iimmyy/Little-Guy/docs/2026-10-14-npu-night.md

# Night of 2026-10-13/14: his whole 2-bit brain on the NPU

Raw notes and numbers (board Q6A, QCS6490 Hexagon v68, RAM at 3196.8 MHz, brain mix-21 + dictionary preview, 4 big cores for the CPU parts). Fork commits d2fbdeb .. f28ec6f.

## Starting point (evening)

- The engine's own NPU backend could only run matrix math on this chip: ADD, MUL, RMS_NORM, SCALE and ROPE killed the NPU program (`dspqueue_read failed 0x2e`).
- It had no 2-bit (Q2_K) support at all.
- 4-bit brain, matrix math on the NPU: 4.14 words/s vs CPU 5.99.
- Our own 2-bit NPU loop (Oct 10) streamed 15.5 GB/s at 46 °C peak vs the CPU's 16.0 GB/s at 79 °C (heat test, fan not on the NPU).

## What was wrong and what fixed it

| Problem | How it was found | Fix |
|---|---|---|
| NPU program died on small ops | bisecting with early returns (the file trace lost its last lines when the program died) | v68 dies on DMA writes from scratch memory to DDR and on DMA started from the callback thread: those copies are HVX vector copies now |
| A full brain ran at 0.5 words/s | per-op profile: every op ~2 ms | my own debug trace writes were in the hot path (each one a round trip to the board's files) |
| 2-bit kernel at 2 GB/s | timing inside the NPU | quantized inputs had been put in scratch memory (VTCM), where scalar loads stall: moved to cached memory, 10x faster |
| Inputs quantized slightly differently from the CPU | a check against the CPU's exact rule on 13.8 million values | v68 has no IEEE vector float math and qf32 cannot hold the magic-number trick: rounding is done with integer ops, 0 differences |
| Attention re-read the chat memory 4 times | reading the code | grouped-query attention: each memory block read once for the 4 heads that share it |
| 2-bit math as slow as the copy | timing copy-only vs math-only (392 vs 363 µs) | the min correction for 4 pouches in one vrmpy (sums split into bytes): math ~20% cheaper |
| NPU stopped loading models after ~20 runs | kernel log "failed to map buffer", dma-buf list | the engine never closed its NPU session at exit; on kernel 7.0 each run leaked 4 buffers (~32 MB): sessions are closed at exit now, 0 left behind |
| Board benchmarks 30% low | clock caps | quiet mode: the thermal guard re-applies the quiet caps after every heat step. Lights now have their own switch, the board runs full power with the light off |

## Results (morning)

| | CPU | NPU |
|---|---|---|
| Talking, fresh chat (bench) | 9.64 | **9.92** words/s |
| Talking, 768 words in | 8.94 | **9.05** |
| Talking, 1,800 words in | 8.38 | **8.55** |
| Talking in the chat server, persona in context (after the attention fixes) | 9.12-9.20 | **9.19-9.30** |
| Reading a prompt | **37** | 15 words/s |
| Chip temperature after a run | 53 °C | **38 °C** |
| Behavior, 40 tries each: Dayvigo warns first | 27 | 25 |
| Dog in a hot car: firm no first | 40 | 40 |
| Invents his day | 0 | 1 |
| Next-word odds vs the CPU (KL) | 0 | 0.012 (two 2-bit sibling brains differ by 0.091) |

## Why it isn't faster still

- CPU and NPU share one memory pipe. The NPU now copies at ~22-23 GB/s on the big 2-bit tracks, the most this chip gives it; running CPU and NPU together gives ~21.8 GB/s in total, no more than the NPU alone.
- What's left on the NPU path is fixed work: attention (~15 ms per word at 768 words in), ~1,100 small ops (~8 ms), and the CPU's share (dictionary shortlist, ~5 ms).
- Prompt reading is compute-bound: one word at a time the kernels are memory-bound, but for many words the vector multiply rate limits. Unpacking each weight once for 4-8 words changed nothing; skipping the per-word result writes would give ~19 words/s.

## Tried and dropped (measured)

- Worker threads spinning between ops instead of sleeping: slower (they steal issue slots from the busy thread).
- Three tile buffers instead of two: no change. A bus bandwidth vote: no change.
- Normalizing float sums after every add: 3% slower, no accuracy change.
- Moving the 16-bit per-layer projection to the CPU: 4% slower, no accuracy change.
- 8-bit chat memory (KV cache) on the CPU: slower (evening test on the Mac).
- Huge pages: the board already runs with transparent huge pages "always".

## Why not "obviously faster" (stopped here, waiting for decisions)

- Talking: attention on the CPU with the rest on the NPU is slower (8.8 / 8.1 vs 9.9 / 9.05: hand-offs). Guessing ahead on the NPU: checking 2 words costs ~1.65x one word, so Token Recycling (1.14-1.28 words per check) still loses.
- The levers left are bytes (more 2-bit tracks after healing), more words per pass (the drafter after fine-tuning), co-op CPU+NPU prompt reading (~+10-20%), and a cheaper dictionary preview.

## Later: CPU and NPU reading prompts together (co-op, LG_COOP=1)

- The NPU alone reads prompts at ~16 tokens/s (vector-multiply bound). For prompt reading, the NPU now computes ~27% of the rows of each big matmul from its tiles while the CPU computes the rest from its own repacked copy and runs every other op; the CPU also quantizes the NPU's inputs (the NPU did that on its scalar units, ~2 ms per matmul). Batches under 32 tokens run CPU-only.
- Bugs found on the way: stale NPU cache lines (shared buffers need compute usage so the NPU drops its copy), memory addresses reused within a graph (input reuse must reset after other ops), a row view of the CPU's repacked weights must carry its buffer.
- Chat server, cooled before each run, both orders: persona reading CPU 30.7-31.2 vs NPU path 35.2 tok/s; a 12-token message 24.2 vs 22.6-23.1; talking 9.08-9.15 vs 8.90-9.22 (same within noise). KL vs CPU 0.0036 (CPU-only small batches: 0).
- Timing trap: consecutive runs heat the board ~4% slower; compare with cooling and alternating order.

## Day of 2026-10-14: making the NPU path clearly faster than the CPU

Fork commits 78a5554, 4737ab8 and later. All comparisons cooled and in alternating order.

### Where a word's time went (NPU profile, ~768 words in, start of the day)

| Part | ms per word |
|---|---|
| Weight reads (344 matrix calls) | 81.2 |
| Attention (42 layers) | 10.0 |
| Small steps (norms, adds, rope, gate, KV writes) | ~7.6 |
| CPU between words (shortlist, dictionary row, setup) | ~4.7 |
| Packing the step batch on the CPU | ~1.0 |

### Fixes, in order

| Change | Before | After | Check |
|---|---|---|---|
| Short messages run as CPU pieces with only the dictionary preview on the NPU | pp12 29.8 | 31.3 (CPU 31.6) | KL 0 |
| Attention skips blocks the mask hides completely (outside the 512-word window, empty slots) | 10.0 ms | ~8.5 ms | 2176/2176 tests |
| Rope cos/sin table cached per word (scalar sin/cos below v79) | 2.0 ms | 0.8 ms | bit-identical, 88/88 |
| Attention value sums: fixed-size loops, no per-word branch (hidden rows zeroed instead) | 190 us/layer | 158 | 2176/2176 |
| Attention dot products summed in one tree for 32 words | 158 us/layer | 121 (global 388 -> 276) | 2176/2176 |
| GEGLU in one pass, row split over both threads | 42 us | 39 | 9/9, bit-identical ops |
| Matrix calls quantize their input inside the tile job, input brought in by DMA | attn_q 96 us, ffn_down q4 679 | 93, 652 | KL 0.0125 (unchanged) |
| Shortlist pick in 2 passes instead of 6 | 1.41 ms | 1.09 | same set |
| Fill of the logit row split by elements (it was 262,144 one-number rows) | 0.85 ms | 0.04 | |

### Results

| | CPU | NPU morning | NPU after fixes |
|---|---|---|---|
| Bench talking, 768 words in | 8.85-8.94 | 9.03-9.05 | 9.49-9.88 |
| Bench talking, 1,800 words in | 8.62 | 8.55 | 9.27-9.30 |
| Chat server, persona loaded | 9.07-9.18 | 8.85 | 9.6-9.9 |
| Next-word odds vs CPU, one word at a time (KL) | 0 | 0.012 | 0.0125 |

### Tried and dropped (measured)

- Two-stage dictionary preview (low-rank first pass): best setting kept the full dice table on 12,326 of 12,733 words vs 12,733 today. Would change what he says.
- Smaller NPU batches (256 / 1024 steps) so packing overlaps: slower (9.44-9.54 vs 9.76).
- Copying step descriptions into cached memory per batch: no change.
- Wider unroll / restrict on GEGLU: no change; it is limited by the float unit (~90 float ops per 32 numbers, both threads share it).
- Backend sampling (--backend-sampling): no gain.
- Host buffers off: within noise.
- Scoring the 1,024 shortlist rows with mul_mat_id: its scratch is sized for every possible expert (~2 GB for 262,144 rows). Context fails.
- A 512-wide attention dot written as one 8-vector pass crashed the NPU program (dspqueue 0x2e) even with a smaller unroll; two 256-wide halves through a shared core works.

### Open at this point

- Every step flushes the NPU cache over its whole output. For the KV write that is the whole chat memory, so it cleans the entire cache 48 times per word. Fix written, not yet measured.
- Run-to-run noise on the board is ~3% even cooled.

### Later: cache flushes and memory

- Every NPU step flushed the cache over its whole output. For the KV write (SET_ROWS) that is the whole chat memory of a layer, which cleaned the entire NPU cache 48 times per word. Now only the written rows are flushed (fork 6ab8e2d). Talking 768 in: 9.77 -> 10.29 tok/s, 1,800 in: 9.57 -> 10.04 (3 alternating rounds). KL unchanged 0.0125.
- Real heat, his brain talking ~2 minutes each from a cool start: CPU 9.09-9.13 tok/s, hottest sensor peak 78-79 C; NPU path 9.94-10.21 tok/s, peak 45-46 C (NPU sensor 53-55 C).
- Behavior 40 tries, after the decode changes: Dayvigo warns first CPU 27 / NPU 26, dog firm no 40 / 39, invents day 0 / 0. Server talking CPU 9.25, NPU 10.07.
- Note: "words/s" in these notes is tokens/s (about 1.3 tokens per English word).

Memory (pinned = MemAvailable drop with a server up after one reply; RSS includes reclaimable file pages):

| Setup | Pinned before | Pinned after | RSS before | RSS after |
|---|---|---|---|---|
| Original 4-bit QAT, CPU | 3.07 GB | 3.09 | 7.95 | 5.75 |
| mix-21, CPU | 2.57 | 2.08 | 6.48 | 4.08 |
| mix-21, NPU | 2.74 | 2.23 | 3.41 | 0.68 |
| mix-21, NPU + co-op reading | 4.19 | 3.66 | 4.84 | 2.11 |

- Fix 1 (fork 01d31d0): the tied output matrix was a second, repacked copy of the 525 MiB dictionary, unused while the preview is on. It now shares the dictionary's mapped copy.
- Fix 2: the per-layer token table (2.2 GB, one row read per token) was read into RAM whole at load. Its pages are released after load and come back per row.
- Still there: the co-op CPU copy of the NPU matrices (~1.4 GB) that lets the CPU and NPU split prompt reading.
- Tried: overriding the output tensor by name. "output.weight" also matched attn_output (moved some attention matrices off the NPU); the tied copy is named token_embd.weight, so a name override cannot split it.
