iimmyy/Little-Guy/docs/MODEL_SELECTION.md

# Little Guy model selection (WIP)

I am treating [Gemma 4 E2B](https://huggingface.co/litert-community/gemma-4-E2B-it-litert-lm) as the working Q6A baseline, not a final choice. It runs on the board through LiteRT-LM and Adreno/OpenCL. My initial debug measurements, including their limits, are in [Gemma runtime validation](GEMMA_RUNTIME.md). I have not verified NPU execution, image input, or audio input on my Q6A.

## Candidates to test

| Candidate | Why I would test it | What remains unproven here |
| --- | --- | --- |
| [Gemma 4 E2B](https://ai.google.dev/gemma/docs/core/model_card_4) | Google lists text, image, and audio input; I already have a working Q6A text baseline. | End-to-end multimodal support in my Android package, sustained power/heat, and QCS6490 NPU compilation. |
| [Gemma 4 E4B](https://huggingface.co/litert-community/gemma-4-E4B-it-litert-lm) | Same model family and LiteRT-LM runtime, with a larger on-device model that may improve difficult interactions. | Whether the quality gain is worth its larger memory footprint and latency on my 12 GB board. |
| [Qwen3.5-2B](https://huggingface.co/Qwen/Qwen3.5-2B) | A different small instruction-tuned vision-language model, useful as an independent quality comparison. | An equivalent Android runtime, audio path, QCS6490 NPU compilation, and fair on-device speed comparison. I will not assume its model-card demos are a deployable Q6A package. |

I will not choose from parameter count or another device's benchmark. I need the same small test set for each candidate: short conversation, a long-history follow-up, a changing-place scenario, uncertainty about absent sensors, a scene description, an audio input, and a request for an unsafe physical action. I will save the exact prompts, outputs, model hashes, runtime/backend, and pass/fail notes. A model that invents observations or bypasses the separate motion safety gate fails even if its text benchmark is fast.

## E4B artifact and selection

I have prepared my Android app to select E2B or E4B without changing the conversation prompt, GPU backend, safety gate, or APK build. The selection is the one-line file `models/selected-model.txt` in the app's external files directory. With no selection file, the app still defaults to E2B. I use the tracked `config/model-e2b.txt` and `config/model-e4b.txt` files to avoid mistyping the choice. The debug terminal prints the active model ID and refuses to treat the development brain as a model benchmark. If I explicitly select a missing model or enter an unknown ID, it reports an error instead of silently switching models.

My E4B candidate is the generic, multimodal-capable [LiteRT-LM release](https://huggingface.co/litert-community/gemma-4-E4B-it-litert-lm/tree/main), not its smaller GPU-only variant. I pinned Hugging Face revision `2eee7ac325f20eb8c9ac1d0e972f7c84663062da`. The file `gemma-4-E4B-it.litertlm` is 3,659,530,240 bytes; I verified its local SHA-256 as `0b2a8980ce155fd97673d8e820b4d29d9c7d99b8fa6806f425d969b145bd52e0`. I keep this multi-gigabyte file under `.run/models/` locally and out of Git. Downloading and building the app do not yet prove the file loads or generates on my Q6A.

For the first Q6A trial I verified free space, copied the E4B file to `/sdcard/Android/data/com.littleguy.robot/files/models/gemma-4-E4B-it.litertlm`, checked its on-device SHA-256, pushed `config/model-e4b.txt` to `/sdcard/Android/data/com.littleguy.robot/files/models/selected-model.txt`, then restarted the service. I restored `config/model-e2b.txt` to that selector path after the failed load. Model selection is read when the service starts, not in the middle of a response.

This trial used Adreno/OpenCL. It was not NPU conversion, retraining, or a final model decision. A valid E2B-versus-E4B comparison still requires both models to generate on the Q6A under equivalent conditions.

## Physical Q6A E4B load attempt — 2026-09-27

I tested the pinned generic E4B artifact on my 12 GB Q6A with the current Android debug app. I verified the same SHA-256 on the Mac and on the board before selecting E4B. The E2B model file stayed in place, and I kept the thermal monitor running with automatic power-off enabled. The external fan was on for the warm E2B comparison and E4B load; the first post-install E2B cold smoke was without it. Earlier transfer temperatures near 47 C CPU and 42 C GPU were measured **without** the fan; after I turned it on, those readings fell to roughly 39 C and 35 C. I must not label the earlier readings as fan-cooled.

After installing the selector-capable app, I first checked E2B. A fan-cooled warm coffee-shop prompt reached first visible text in 2.386 s and completed in 3.087 s. LiteRT reported 67 prefill tokens at 33.9 tokens/s and seven decode tokens at 6.5 tokens/s. The answer was "I am ready to observe." That is grounded but thin, so it is not a quality pass merely because it was fast.

I then selected E4B and restarted the service. The debug receiver confirmed `MODEL e4b`, and LiteRT began delegating the E4B decode graph to OpenCL. Android's low-memory killer killed the app during model setup, before any generated text. Its log gave the reason as a breached memory watermark. This was not a thermal shutdown; a spot check during loading was about 31 C CPU and 27 C GPU. I did not obtain a stable E4B peak-memory measurement, first-text time, or answer. I therefore have **no E4B inference-speed or quality result** from this attempt.

I restored the selector to E2B and stopped the failed process. The first E2B reload was also killed during OpenCL setup by memory pressure, so a selector rollback alone did not immediately restore the running system. After one board reboot, E2B generated "Hello." again: 8.339 s to first visible text and 24.030 s total on the cold recovery request. Its next warm turn reached first visible text in 1.052 s and completed in 1.199 s. The active selector is E2B. I left the verified E4B file on the board for later investigation, but it is not active.

The conclusion is narrow: this **generic E4B artifact through this Android/LiteRT-LM OpenCL path** caused memory pressure during loading on my Q6A. It does not establish that every E4B quantization or backend is impossible on the board. I will not repeat the same load without a concrete memory hypothesis and a way to measure peak allocations. A controlled E2B-versus-E4B quality and latency comparison remains unperformed.

For every model that actually runs on my Q6A, I will measure first visible text, complete-response time, prefill/decode throughput, memory, temperature, and power under the same fan and prompt conditions. I will distinguish a fresh boot, an app-process restart, and a warm conversation. Model support for image or audio on paper is only a candidate capability until I send those modalities through the exact deployed runtime.

## NPU compilation gate

The QCS6490 targets Hexagon **v68** with SoC ID **35**. [Radxa's QAIRT guide](https://docs.radxa.com/en/dragon/q6a/app-dev/npu-dev/qairt-sdk) says a context binary is chip-specific, and its [conversion example](https://docs.radxa.com/en/dragon/q6a/app-dev/npu-dev/qairt-usage) demonstrates quantization and context-binary generation on an x86 Linux host for a smaller vision model. Those instructions do not establish that I can compile Gemma 4 or Qwen3.5 on this Mac, nor that a compiled artifact will run on this Android image.

**Update (2026-09-28):** Did that first check! I moved the board to Ubuntu, and Radxa's prebuilt Llama 3.2 1B ran on the Hexagon at about 400 tok/s reading prompts and 9 to 10 tok/s writing. So the NPU works on my board 😁. Details are in [Q6A_LINUX_BOOT.md](Q6A_LINUX_BOOT.md) and the Gemma plan is in [NPU_PORT.md](NPU_PORT.md). I'm on Linux now, so ignore the Android bit in the next sentence.

Before attempting a full LLM conversion, I will verify the NPU runtime with a known-good QCS6490 example, confirm the Android libraries/toolchain and model-export path, then try one chosen model. This is deployment compilation, not retraining. I will keep the working GPU build available as a fallback and require actual NPU delegation, correct output, and measured latency/power gains before calling the NPU route successful.
