iimmyy/Little-Guy/hardware/little-guy-v2/pcb/head/microphone-coordinates.csv

reference | location | logical_mic | pdm_net | xvf3800_pin | acoustic_x_mm | acoustic_y_mm | acoustic_z_mm | kicad_target_x_mm | kicad_target_y_mm
MK501 | front | 0 | PDM_DATA0 | 46 | 0.0 | 29.646532920888777 | 0.0 | 0.0 | -29.646532920888777
MK502 | back | 1 | PDM_DATA1 | 50 | 0.0 | -29.512234589533094 | 0.0 | 0.0 | 29.512234589533094
MK503 | left | 2 | PDM_DATA2 | 48 | -50.0 | -0.06714916567784036 | 0.0 | -50.0 | 0.06714916567784036
MK504 | right | 3 | PDM_DATA3 | 51 | 50.0 | -0.06714916567784036 | 0.0 | 50.0 | 0.06714916567784036
