iimmyy/Little-Guy/tools/ears/read-aloud/session-01.md

# Read-aloud session 01

Sixty short lines, about five minutes of reading. Each line gives his ears an exact answer (the script),
and each effect copy gives them a known difficulty.

## Recording (one take)

1. Record at 48 kHz, mono, in FL with nothing on the mixer track and nothing on the master (no limiter, no EQ).
2. Read every line in order in one take, in your normal voice. Leave about **2 seconds of silence** between lines.
   Don't say the line numbers.
3. Flubbed a line? Pause, read it again, and keep going. Write the line number down (for example "redo: 12, 30").
4. Export the take as `s01_dry.wav`.

## Effect copies (as many as you like)

Run the same take through effects and export each version as a separate file, full length, starting at the same
point as the dry take. Name each one with the effect and how much:

- `s01_reverb-heavy.wav`
- `s01_distortion-light.wav`
- `s01_beat-medium.wav` (a beat of yours underneath; the amount = how loud the beat is)
- Chains are fine: `s01_reverb-medium+bitcrush-light.wav`

Use light / medium / heavy for the amount, or a number if you prefer (`reverb-40`). The file name is the log, so
nothing else needs writing down. Mix it up: reverb, delay, distortion, bitcrush, telephone or lowpass, chorus,
pitch shift, autotune, a beat underneath, crowd noise, whatever your plugins have.

**One rule:** nothing that changes the length or timing of the take (time-stretch, speed-up, slowing down).
Pitch shift is fine as long as the length stays the same. My tool lines every copy up with the dry take and
cuts them all in the same places.

Drop the files plus your redo note in a folder and tell me where. Your voice stays private: these recordings never
go in git or anywhere public.

## The lines

1. Play me something chill while I cook.
2. Yeah yeah, whatever, I'll do it later.
3. We were just chilling at the crib all day.
4. Pull up whenever you're ready.
5. Do you actually like this beat or not?
6. Six thick sticks sat stacked beside the shed.
7. She sliced the bread before anyone was awake.
8. Wake me up at seven thirty tomorrow.
9. He dropped a chip and the dog grabbed it.
10. She sells fresh fish at the market on Fridays.
11. That brand of sneakers costs way too much.
12. I don't care what they say about it.
13. I had a really long shift at work today.
14. That movie didn't even scare me a little bit.
15. Lemme see that real quick.
16. I bumped my head on the kitchen shelf.
17. Turn the music down a little bit.
18. Bro, that's lowkey crazy.
19. The fish flicked its fin and swam away.
20. They fought over the last slice of cake.
21. The faucet hissed and spat before the water ran clear.
22. Are you ready to leave yet or not?
23. The ship left the harbor right at dawn.
24. Pour me a glass of cold water please.
25. Nah I'm good, I'm about to head out.
26. I laid the jacket on the chair by the door.
27. What did you get up to while I was gone?
28. I'm hungry, what should I make for dinner?
29. The ice on the pond is way too thin.
30. What were we talking about yesterday?
31. I'm going to bed now, good night.
32. These pants are way too long for me.
33. What song is this one called?
34. A sharp whistle cut through the quiet street.
35. He ate the whole pizza by himself last night.
36. The steak was still rare in the middle.
37. Two bands played at the park on Saturday.
38. Keep that between you and me, okay?
39. Take a small sip, the tea is still hot.
40. I think I left my keys in the car.
41. Don't stare at the sun for too long.
42. Teach me how to care for a kitten.
43. Can I have grapefruit juice with my sleeping pill?
44. I thought about it the whole drive home.
45. Hey little guy, I'm home.
46. Go ahead and start eating without me.
47. Grab the hose and water the garden for me.
48. Can you remind me to call my mom tomorrow?
49. I'm gonna grab food, you want anything?
50. The school bans phones during class now.
51. Did you hear that noise outside just now?
52. My parents are coming over on Sunday.
53. Sorry I'm late, the bus never showed up.
54. Turn the speaker up and let it blast.
55. That track goes so hard.
56. On God, I didn't even touch it.
57. Tell me something you learned today.
58. They can't find the remote anywhere in the house.
59. The job she sought went to someone else.
60. It is what it is, you feel me?
