iimmyy/Little-Guy/hardware/little-guy-v2/layout/layout-3d.png

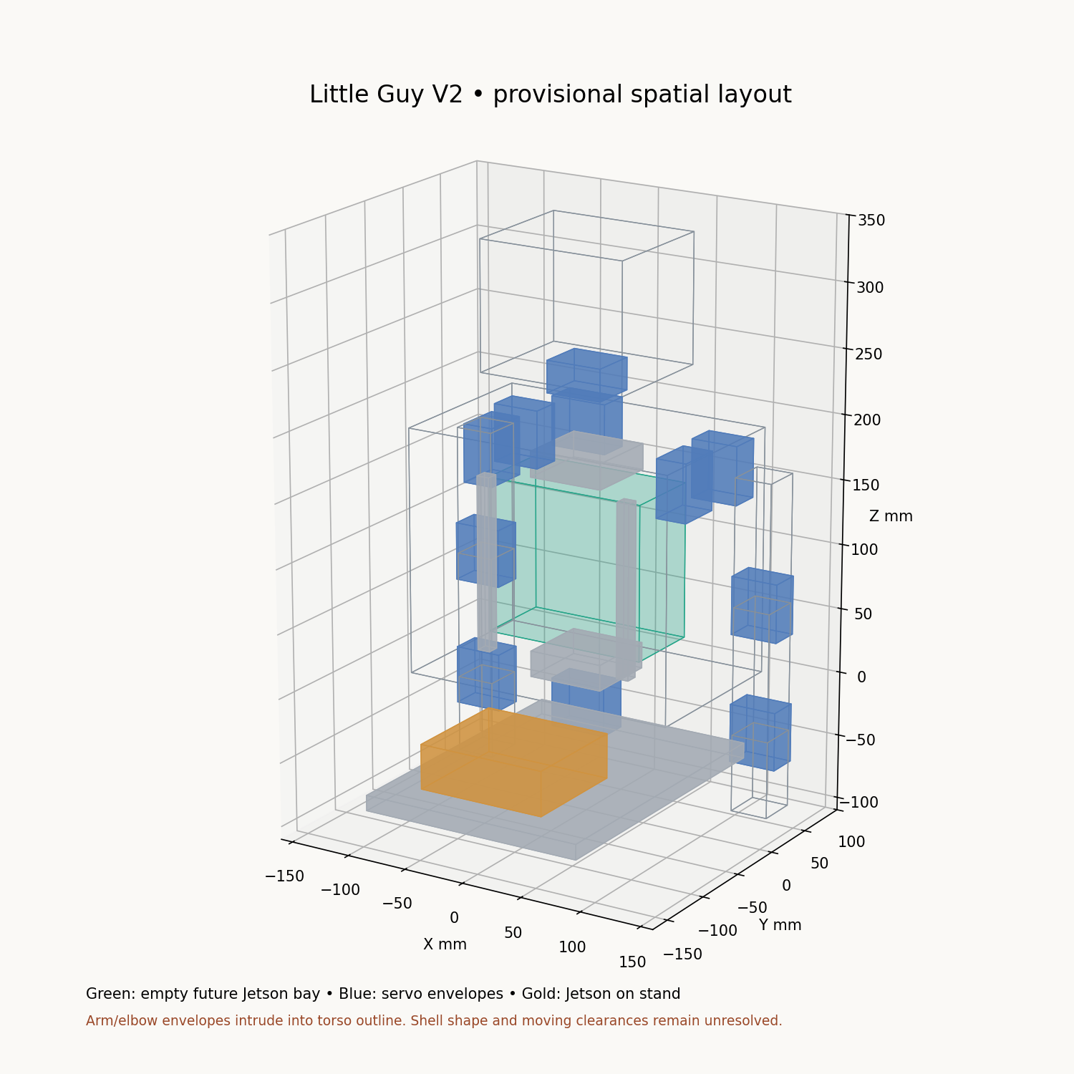
hardware/little-guy-v2/layout/layout-3d.png
