iimmyy/Little-Guy/hardware/little-guy-v2/layout/layout-review.png

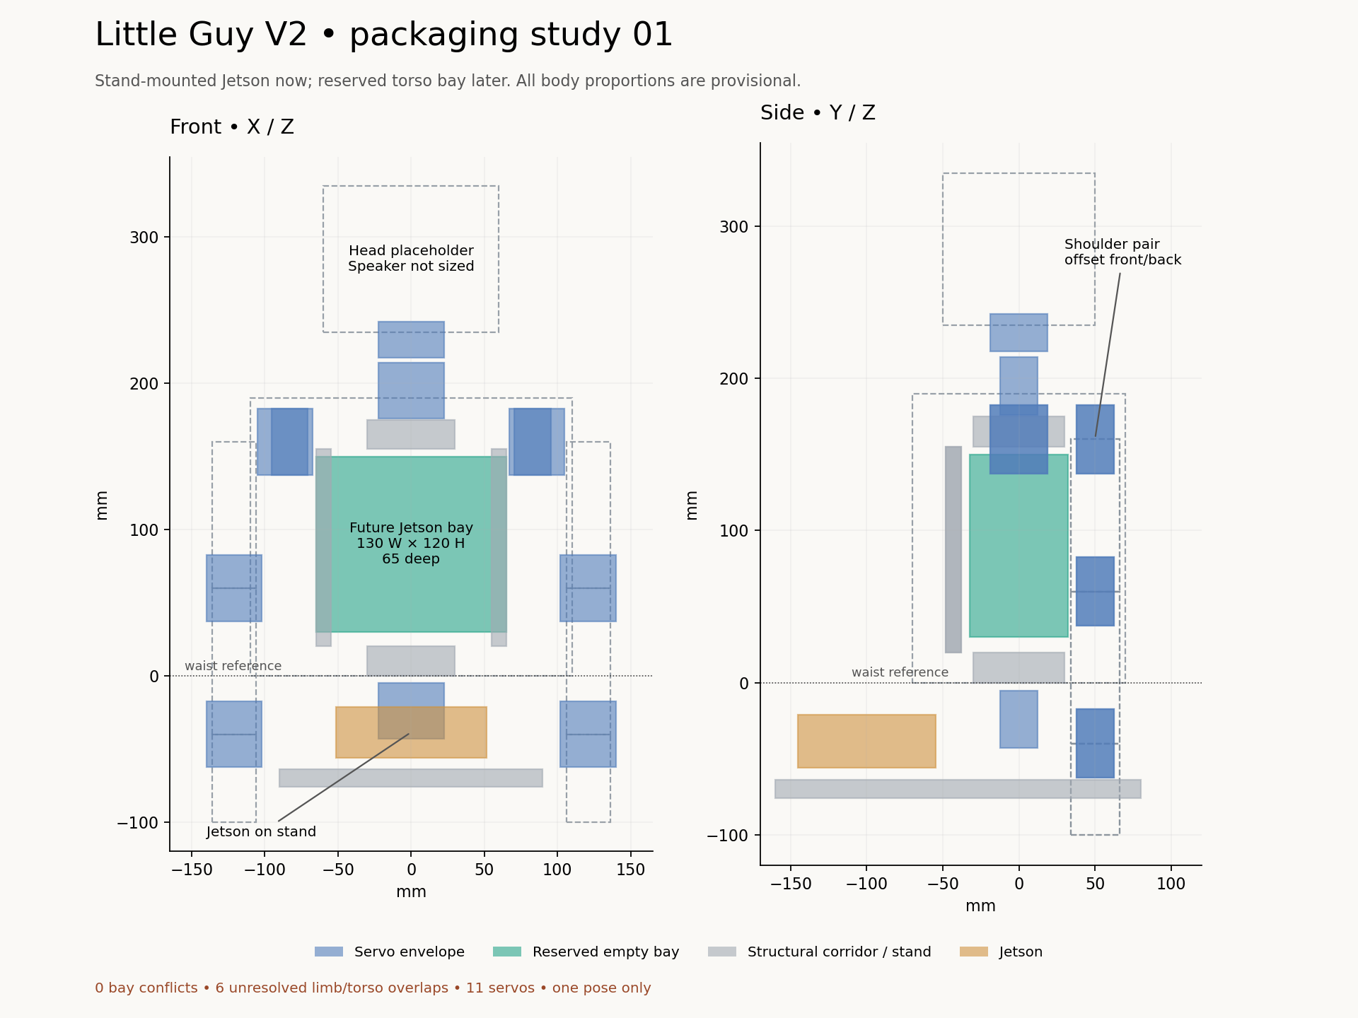
hardware/little-guy-v2/layout/layout-review.png
