iimmyy/Little-Guy/hardware/little-guy-v2/layout/shoulder/shoulder-poses.png

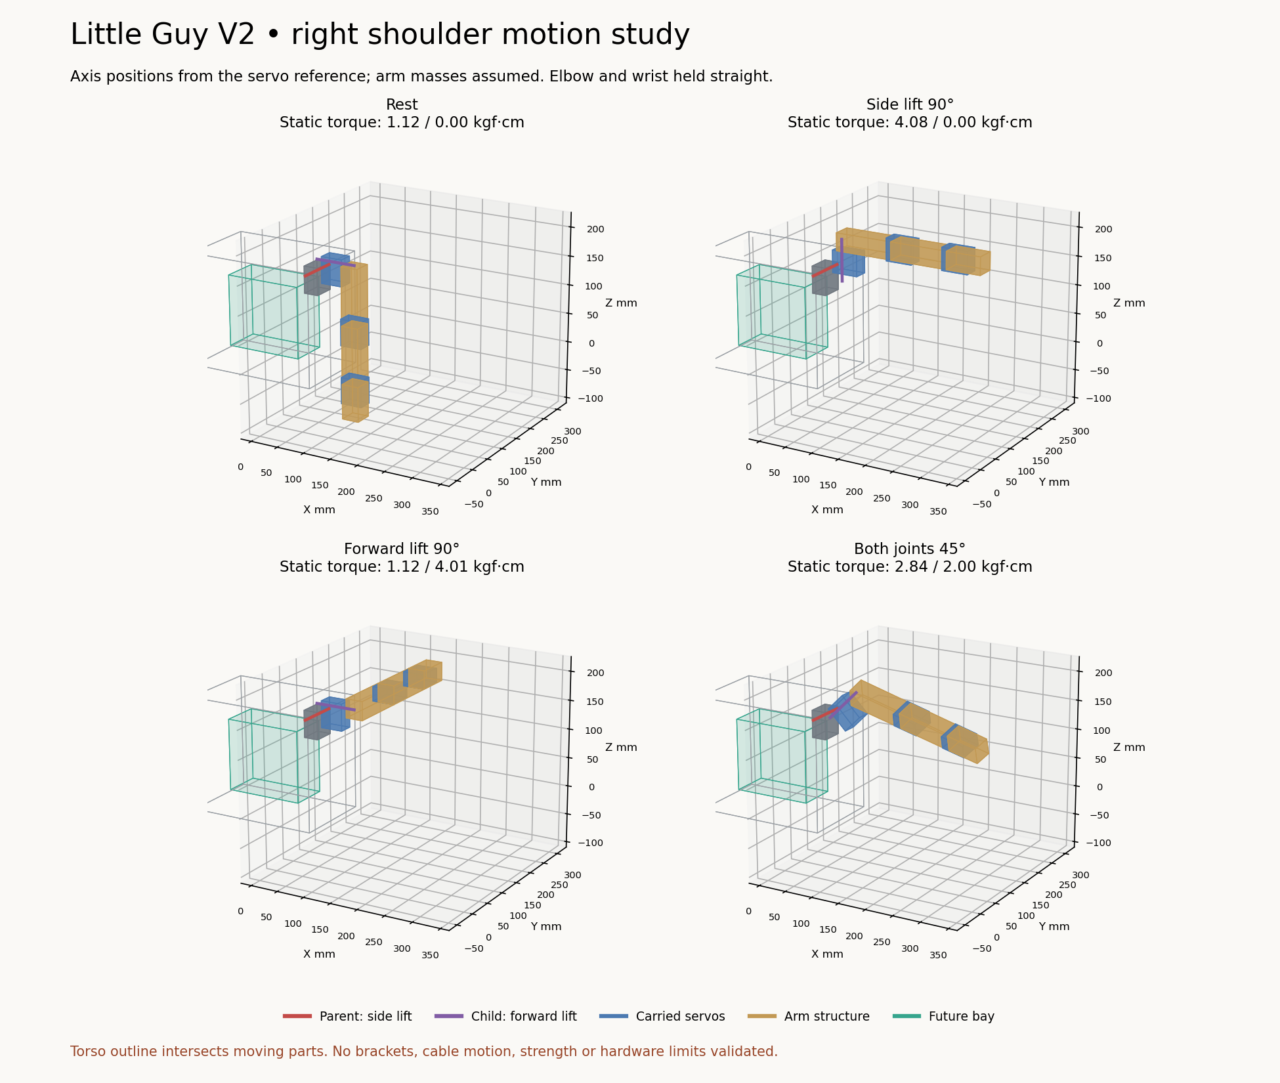
hardware/little-guy-v2/layout/shoulder/shoulder-poses.png
