iimmyy/Little-Guy/hardware/little-guy-v2/layout/stand/stand-sensitivity.png

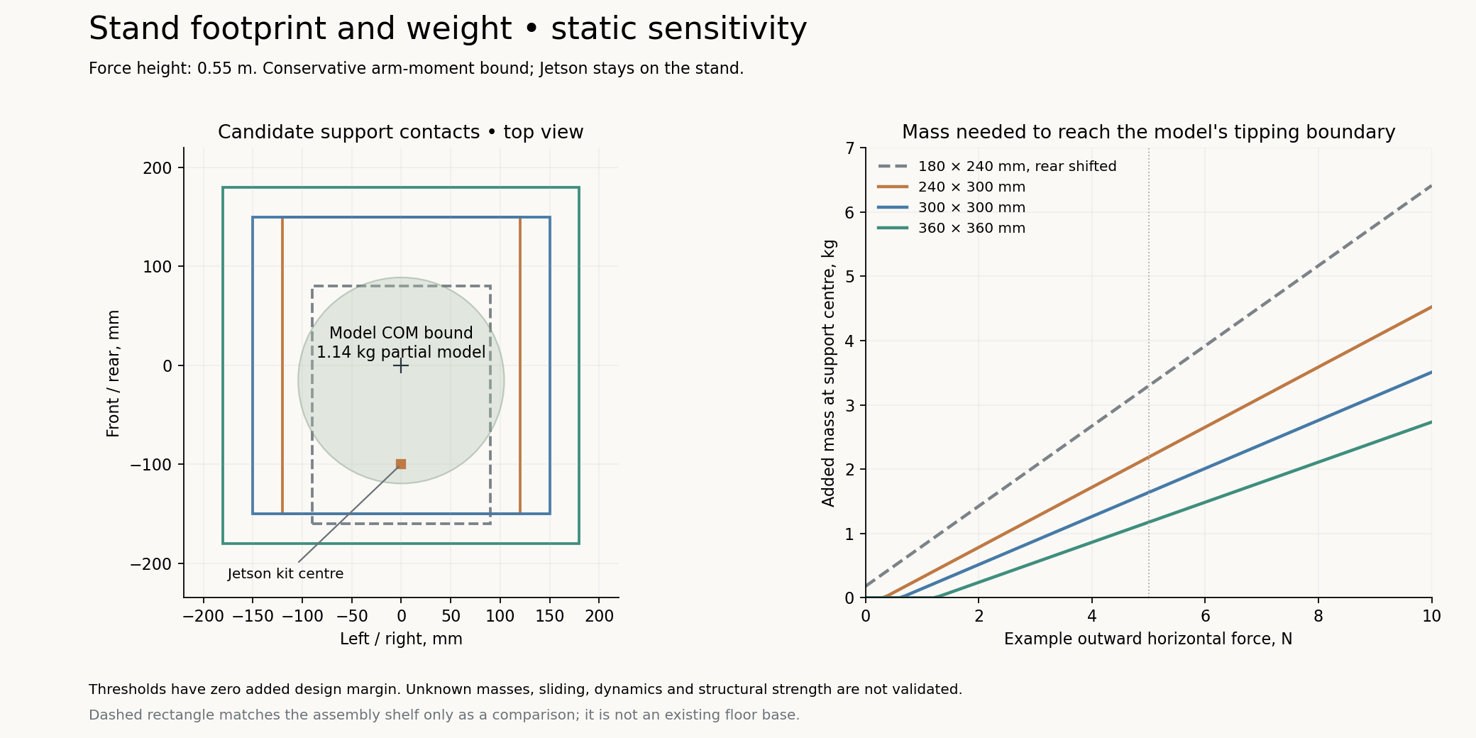
hardware/little-guy-v2/layout/stand/stand-sensitivity.png
