iimmyy/Little-Guy/hardware/little-guy-v2/power/harness-overview.png

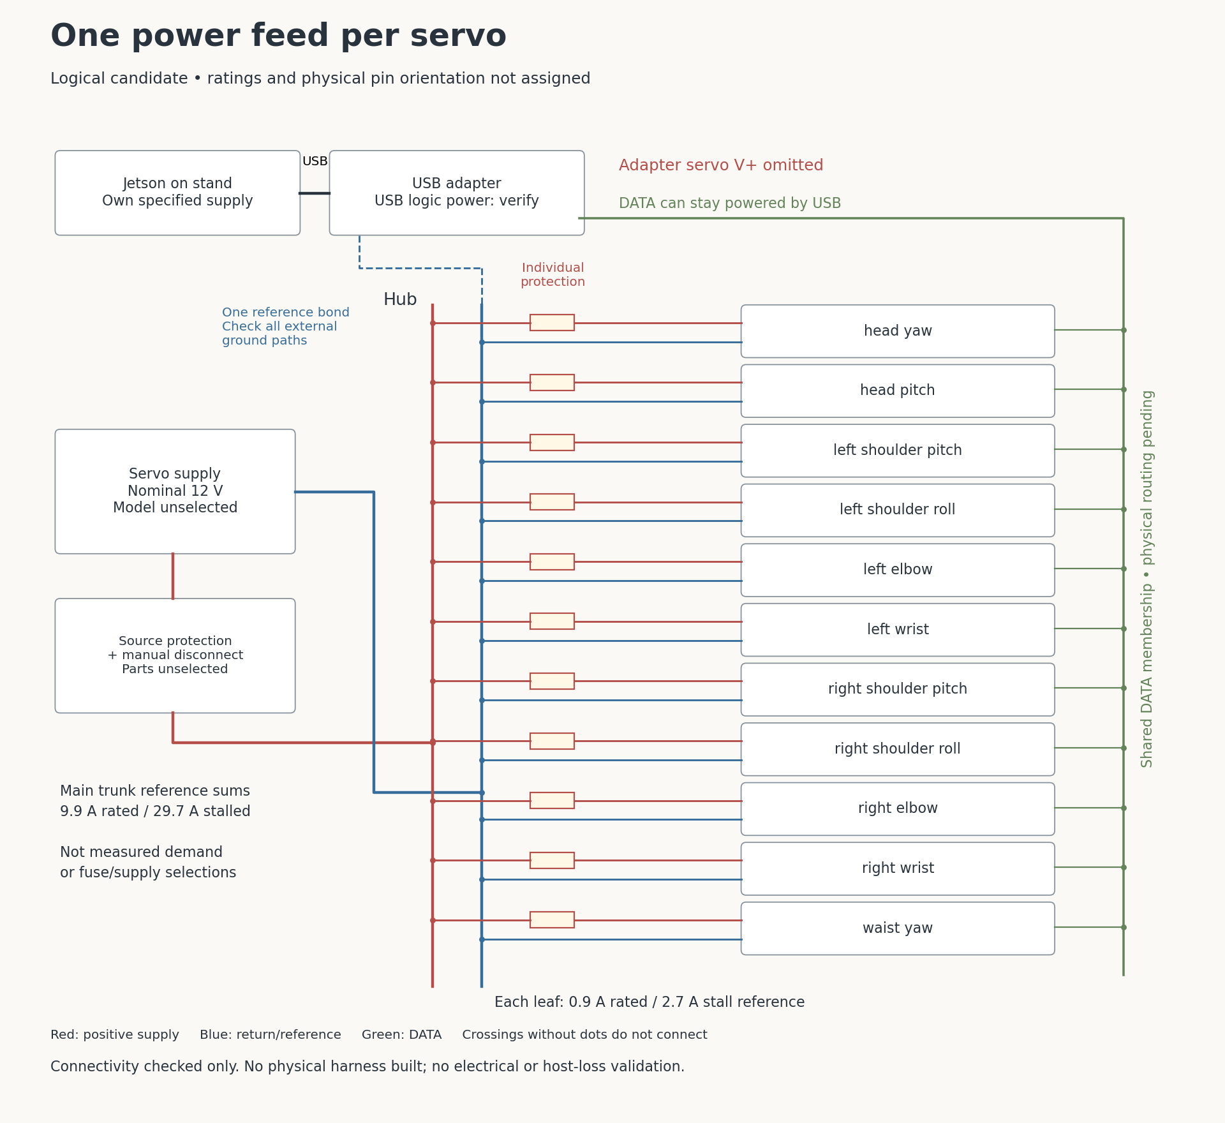
hardware/little-guy-v2/power/harness-overview.png
