iimmyy/Little-Guy/hardware/little-guy-v2/renders/v2-carry-handles.png

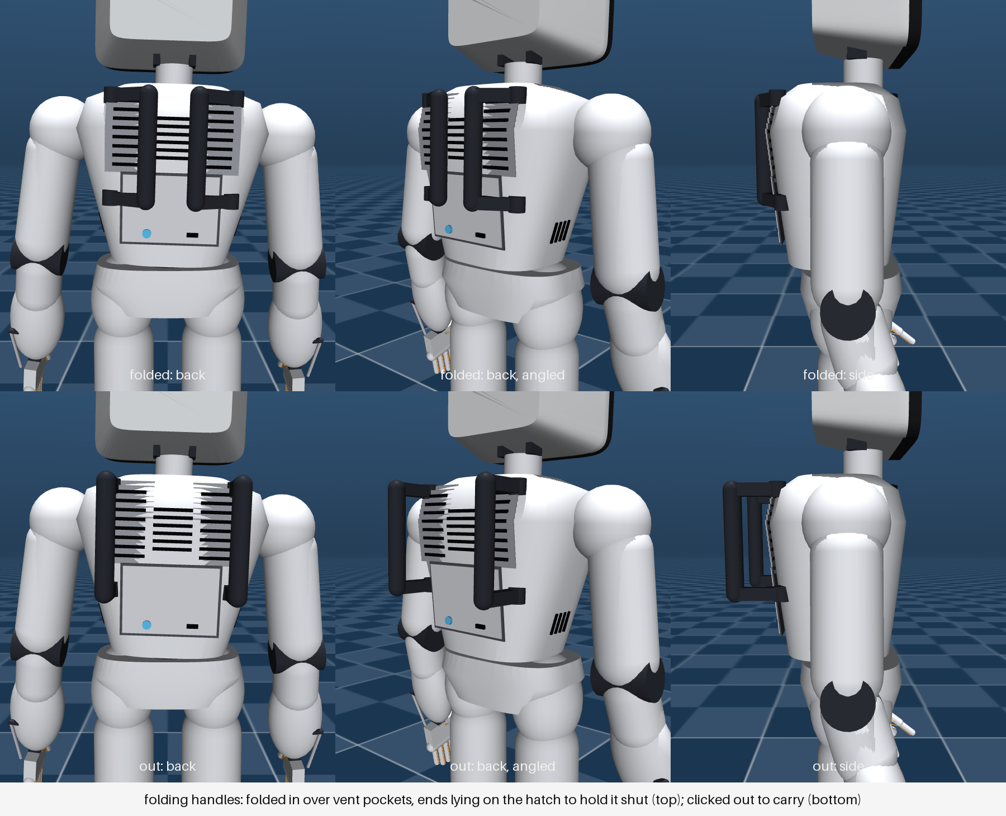
hardware/little-guy-v2/renders/v2-carry-handles.png
