iimmyy/Little-Guy/hardware/little-guy-v2/renders/v2-chest-insides.png

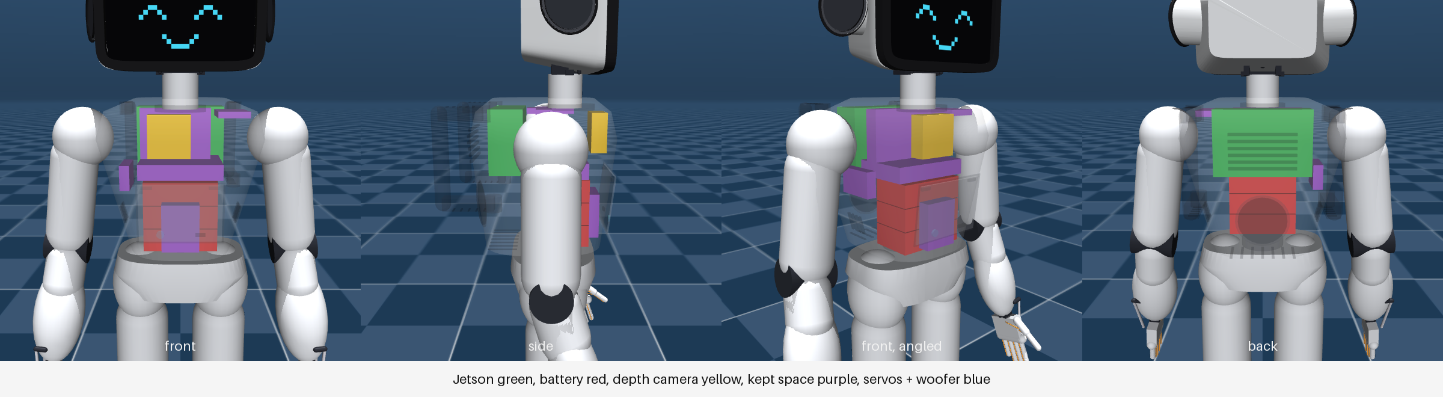
hardware/little-guy-v2/renders/v2-chest-insides.png
