iimmyy/Little-Guy/hardware/little-guy-v2/renders/v2-ear-rings-and-feet.png

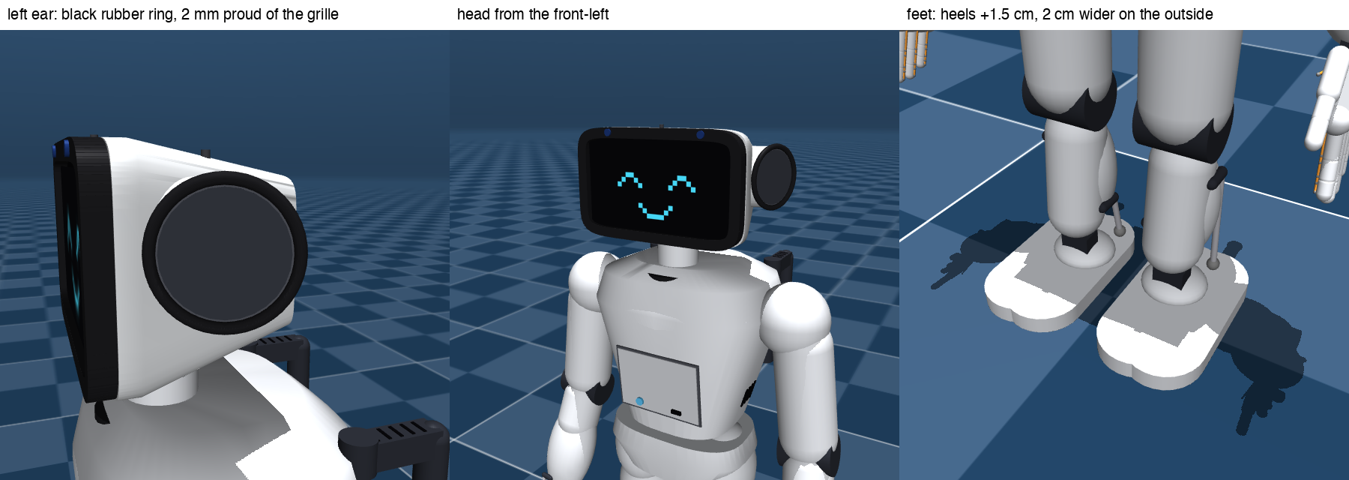
hardware/little-guy-v2/renders/v2-ear-rings-and-feet.png
