iimmyy/Little-Guy/hardware/little-guy-v2/renders/v2-full-body.png

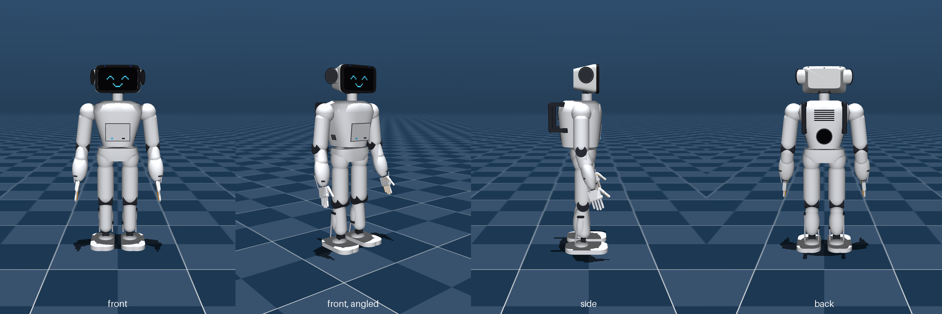
hardware/little-guy-v2/renders/v2-full-body.png
