iimmyy/Little-Guy/hardware/little-guy-v2/renders/v2-head-ears.png

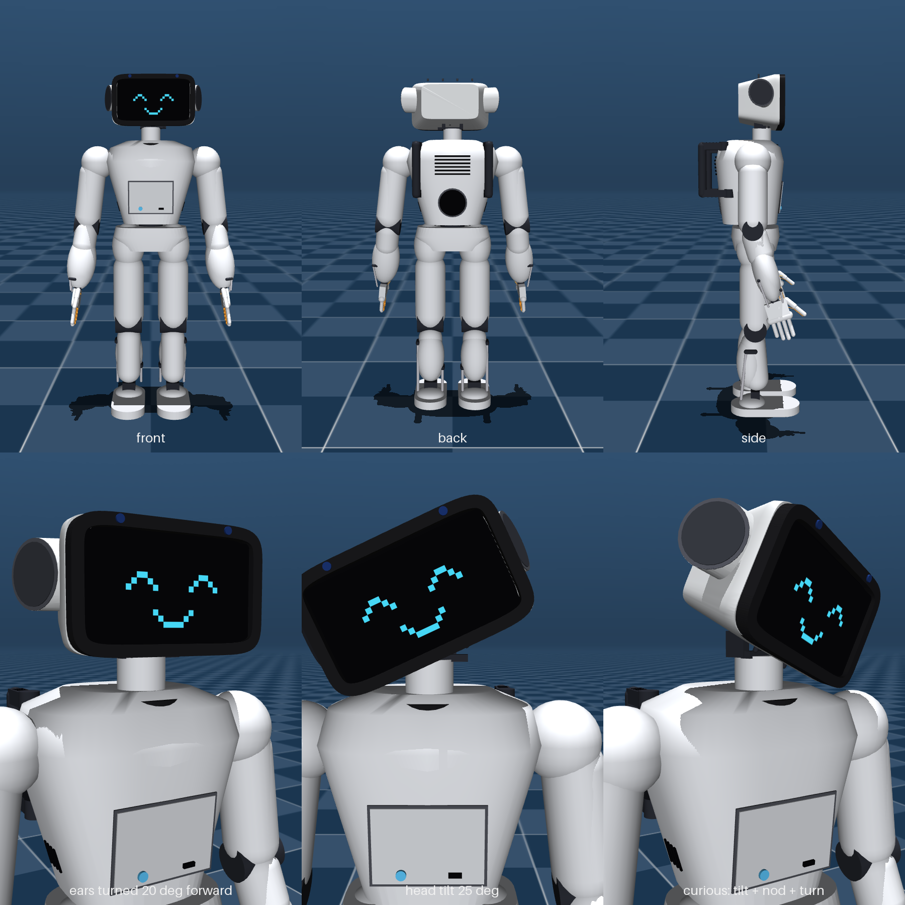
hardware/little-guy-v2/renders/v2-head-ears.png
