iimmyy/Little-Guy/hardware/little-guy-v2/renders/v2-head-xray.png

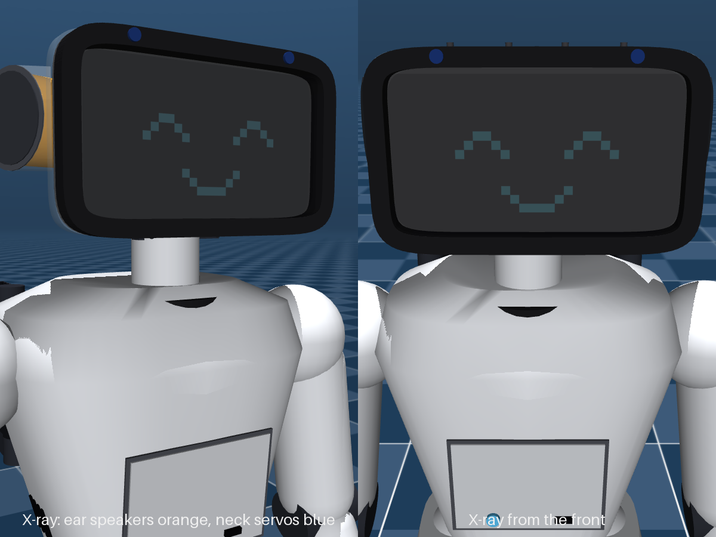
hardware/little-guy-v2/renders/v2-head-xray.png
