iimmyy/Little-Guy/hardware/little-guy-v2/renders/v2-pixel-faces.png

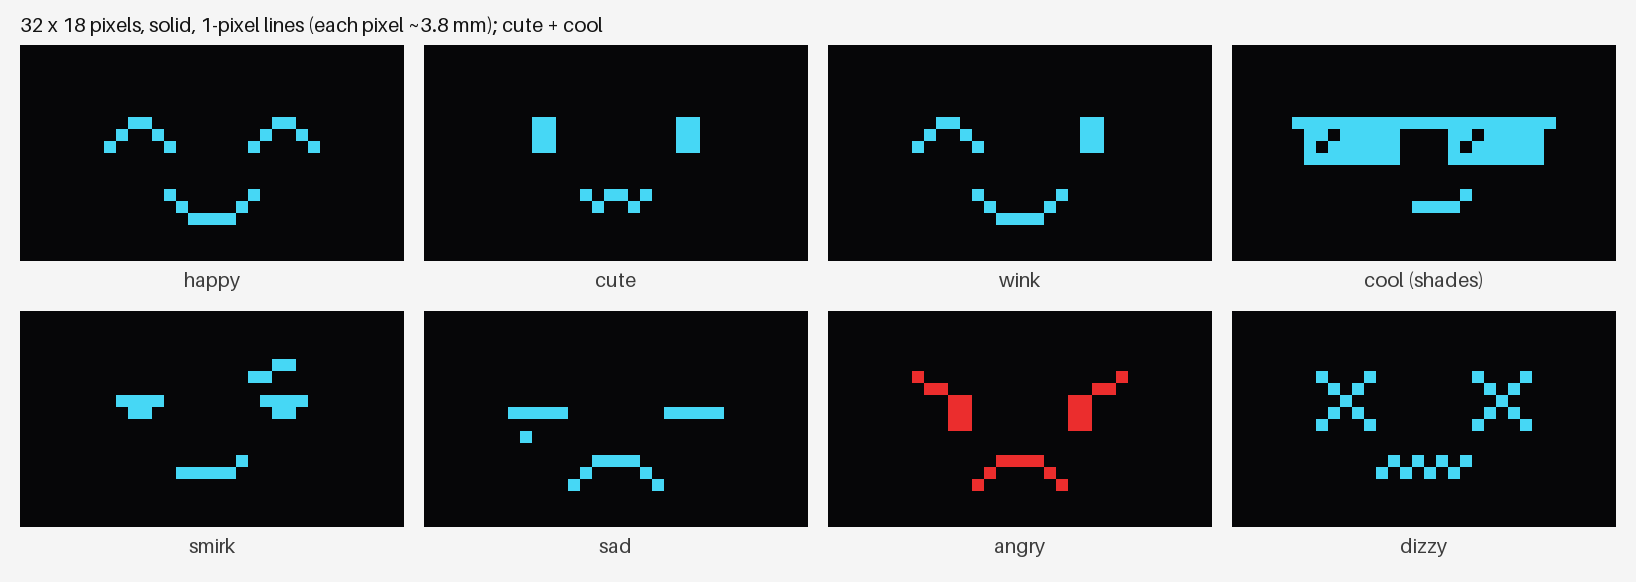
hardware/little-guy-v2/renders/v2-pixel-faces.png
