iimmyy/Little-Guy/hardware/little-guy-v2/renders/v2-vents-and-door.png

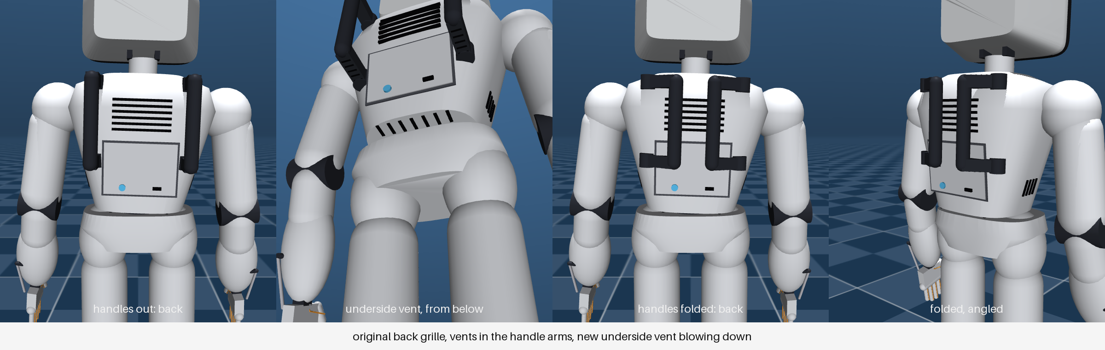
hardware/little-guy-v2/renders/v2-vents-and-door.png
