iimmyy/Little-Guy/hardware/little-guy-v2/layout/upper-body-layout.scad

// PROVISIONAL PACKAGING BLOCKS ONLY. Not printable mounts or a safe assembly.
// Generated by build_layout.py from parameters.json; dimensions mm.
show_references = true;
show_reserved_bay = true;
// future Jetson bay: 
if (show_reserved_bay) color([0.15294117647058825, 0.6470588235294118, 0.5411764705882353, 0.25]) translate([0, 0, 90]) cube([130, 65, 120], center=true);
// torso outer reference: No shell thickness allocated
if (show_references) color([0.5294117647058824, 0.5686274509803921, 0.6078431372549019, 0.13]) translate([0, 0, 95.0]) cube([220, 140, 190], center=true);
// head placeholder: Speaker dimensions unknown; no fit claim
if (show_references) color([0.5294117647058824, 0.5686274509803921, 0.6078431372549019, 0.13]) translate([0, 0, 285]) cube([120, 100, 100], center=true);
// waist servo: 
color([0.3176470588235294, 0.48627450980392156, 0.7294117647058823, 0.85]) translate([0, 0, -24]) cube([45.23, 24.73, 37.8], center=true);
// head yaw servo: 
color([0.3176470588235294, 0.48627450980392156, 0.7294117647058823, 0.85]) translate([0, 0, 195]) cube([45.23, 24.73, 37.8], center=true);
// head pitch servo: 
color([0.3176470588235294, 0.48627450980392156, 0.7294117647058823, 0.85]) translate([0, 0, 230]) cube([45.23, 37.8, 24.73], center=true);
// waist support corridor: 
color([0.6392156862745098, 0.6666666666666666, 0.7019607843137254, 0.85]) translate([0, 0, 10]) cube([60, 60, 20], center=true);
// neck support corridor: 
color([0.6392156862745098, 0.6666666666666666, 0.7019607843137254, 0.85]) translate([0, 0, 165]) cube([60, 60, 20], center=true);
// left proximal shoulder: 
color([0.3176470588235294, 0.48627450980392156, 0.7294117647058823, 0.85]) translate([-83, 0, 160]) cube([24.73, 37.8, 45.23], center=true);
// left distal shoulder: 
color([0.3176470588235294, 0.48627450980392156, 0.7294117647058823, 0.85]) translate([-86, 50, 160]) cube([37.8, 24.73, 45.23], center=true);
// left upper arm reference: No wall thickness, actuator pocket or swept motion model
if (show_references) color([0.5294117647058824, 0.5686274509803921, 0.6078431372549019, 0.13]) translate([-121, 50, 110.0]) cube([30, 32, 100], center=true);
// left elbow: 
color([0.3176470588235294, 0.48627450980392156, 0.7294117647058823, 0.85]) translate([-121, 50, 60]) cube([37.8, 24.73, 45.23], center=true);
// left forearm reference: No wall thickness, actuator pocket or swept motion model
if (show_references) color([0.5294117647058824, 0.5686274509803921, 0.6078431372549019, 0.13]) translate([-121, 50, 10.0]) cube([30, 32, 100], center=true);
// left wrist: 
color([0.3176470588235294, 0.48627450980392156, 0.7294117647058823, 0.85]) translate([-121, 50, -40]) cube([37.8, 24.73, 45.23], center=true);
// left hand reference: No wall thickness, actuator pocket or swept motion model
if (show_references) color([0.5294117647058824, 0.5686274509803921, 0.6078431372549019, 0.13]) translate([-121, 50, -70.0]) cube([30, 32, 60], center=true);
// left rear torso frame corridor: Proposed rear load path; leaves front access to bay; no strength calculation
color([0.6392156862745098, 0.6666666666666666, 0.7019607843137254, 0.85]) translate([-60, -43, 87.5]) cube([10, 10, 135], center=true);
// right proximal shoulder: 
color([0.3176470588235294, 0.48627450980392156, 0.7294117647058823, 0.85]) translate([83, 0, 160]) cube([24.73, 37.8, 45.23], center=true);
// right distal shoulder: 
color([0.3176470588235294, 0.48627450980392156, 0.7294117647058823, 0.85]) translate([86, 50, 160]) cube([37.8, 24.73, 45.23], center=true);
// right upper arm reference: No wall thickness, actuator pocket or swept motion model
if (show_references) color([0.5294117647058824, 0.5686274509803921, 0.6078431372549019, 0.13]) translate([121, 50, 110.0]) cube([30, 32, 100], center=true);
// right elbow: 
color([0.3176470588235294, 0.48627450980392156, 0.7294117647058823, 0.85]) translate([121, 50, 60]) cube([37.8, 24.73, 45.23], center=true);
// right forearm reference: No wall thickness, actuator pocket or swept motion model
if (show_references) color([0.5294117647058824, 0.5686274509803921, 0.6078431372549019, 0.13]) translate([121, 50, 10.0]) cube([30, 32, 100], center=true);
// right wrist: 
color([0.3176470588235294, 0.48627450980392156, 0.7294117647058823, 0.85]) translate([121, 50, -40]) cube([37.8, 24.73, 45.23], center=true);
// right hand reference: No wall thickness, actuator pocket or swept motion model
if (show_references) color([0.5294117647058824, 0.5686274509803921, 0.6078431372549019, 0.13]) translate([121, 50, -70.0]) cube([30, 32, 60], center=true);
// right rear torso frame corridor: Proposed rear load path; leaves front access to bay; no strength calculation
color([0.6392156862745098, 0.6666666666666666, 0.7019607843137254, 0.85]) translate([60, -43, 87.5]) cube([10, 10, 135], center=true);
// stand assembly platform: 
color([0.6392156862745098, 0.6666666666666666, 0.7019607843137254, 0.85]) translate([0, -40, -70]) cube([180, 240, 12], center=true);
// Jetson on stand: 
color([0.8156862745098039, 0.5764705882352941, 0.25098039215686274, 0.85]) translate([0, -100, -38.615]) cube([103, 90.5, 34.77], center=true);
