iimmyy/Little-Guy/hardware/alpha1s-v1.1/review/alpha1s-schematic-2026-10-18.pdf

1 | 2 | 3 | 4 | 5 | 6 | 7 | 8

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
Size: A3 | Rev: WIP-01 | F Date: 2026-10-17
KiCad E.D.A. 10.0.6 | Id: 1/5

## Title: Alpha 1S V1.1 - Original reconstruction

### File: alpha1s-original.kicad_sch

### Sheet: /

INCOMPLETE: no donor nets or physical geometry verified Recovered back resistors File: recovered-resistors-back.kicad_sch

Audio amplifier region

File: audio-amplifier-region.kicad_sch

Input switch region

File: input-switch-region.kicad_sch Recovered front resistors File: recovered-resistors-front.kicad_sch

IN 1 | GND 2
EN 3 | BP | 4 OUT | 5 U14
SGM2019-3.3 VBAT 1 PC13 2 | PC14 3 | PC15 4 | PD0 5 | PD1 6 | NRST 7 | PC0 8 | PC1 9 | PC2 10 PC3 11 | VSSA 12 | VDDA 13 | PA0 14 PA1 15 PA2 16 PA3 17 VSS 18 VDD 19 | PA4 20 PA5 21 PA6 22 PA7 23 PC4 24 PC5 25 | PB0 26 PB1 27 PB2 28 PB10 29 PB11 30 VDD 32 | PB12 33 PB13 34 PB14 35 PB15 36 PC6 37 PC7 38 PC8 39 PC9 40 | PA8 41 PA9 42 PA10 43 PA11 44 PA12 45 PA13 46 VDD 48 | PA14 49 PA15 50 PC10 51 PC11 52 PC12 53 PD2 54 | PB3 55 PB4 56 PB5 57 PB6 58 PB7 59 BOOT0 60 | PB8 61 PB9 62 VDD 64 U8
STM32F103RDT6

1OE 1
1A 2
2Y 3 | GND 4
2A | 5
1Y | 6
2OE | 7
VCC | 8 U9
SN74LVC2G125

1
2
3

# J8 Harness - mapping pending 1

2
3

J10 Harness - mapping pending

1
2
3
4
J2 BAT - mapping pending 1 | 2
3 | 4
5 | 6
7 | 8
9

J6

9 contacts, keyed | 1
| 2
| 3

# J7 Harness - mapping pending 1

2
3

J9 Harness - mapping pending C83 Unknown C81 Unknown C68 Unknown S

1

S

2

S

3 | G
4 | D

5 D

6 D

7 D

8 Q1

# IRF9310 (P-channel) SW 1 PVCC

2 AVCC

4
ACN 5
ACP 6 CMSRC 7

ACDRV 8

STAT 9

TS 10

TTC 11 | VREF 12

# ISET 13 CELL 14

SRN 15 SRP 16

ACSET 17 OVPSET 18 | BATDRV 19 REGN 20 BTST 21 PGND 22 AGND 25 U3 BQ24133 | C82 Unknown | D
1 | D
2 | G
3
| S
4 | D

5 D
6
| S

7 D

8 Q4 CSD17313Q2 D

1 | D
2 | G
3
| S
4 | D

5 D
6
| S

7 D

8 Q3 CSD17313Q2

S

1

S

2

S

3 | G
4 | D

5 D

6 D

7 D

8 Q2
IRF9310 (P-channel)

GND 1 BAT_IN 2

SW_BTN 3
LDO33_O 4
VDD_IO 5
LDO18_O 6 | WAKEUP 7 | PMULDO_O 8 | P04 9 | P15 10 | P12/SCL 11 | P13/SDA 12 | P17/CTS 13 | P05 14 | P00/RTS 15 | P20 | 16 P24 | 17
EAN | 18 RST_N | 19 RXD | 20
TXD | 21 P31 | 22 P32 | 23 P33 | 24 P34 | 25 P36 | 26 P37 | 27
LED1 | 28 GND | 29 BT_RF | 30 U10 BM77SPP03MC2
BCK 1 | WS 2 | DATA 3 | GND 4
VDD | | 5
VOL | 6 Cap | 7
VOR | 8 U4 MS6324G | U14: three connections traced from video. U13 and its capacitors moved to the audio sheet. Confirm physical pin-1 conventions before assigning footprints or nets.

WIP: eleven photo-traced nets, including expanded audio supply; circuit and board recovery incomplete. NOT FOR FABRICATION. U8: STM32F103RDT6 confirmed by direct donor reading, 2026-10-18. Connections and firmware remain unrecovered.

U3: BQ24133; TI Rev. D pin map, including AGND pad 25. U9/U13/U14: video markings and manufacturer pin maps verified. Cell setting, supply rails and remaining donor wiring untraced. J6: unpopulated; nine holes, position 10 absent. Pitch appears near 2 mm; drill size unmeasured. Intermediate pin sequence inferred; nets unknown. Y1 reads 8.000 MHz; package/pin configuration pending. J3 USB, SPK and LED await mapping. J2 and J7-J10: pin numbers shown here are temporary schematic numbering.

# ALPHA 1S V1.1 / 2015-01-04 - ORIGINAL BOARD RECONSTRUCTION

U10: exact 30-pin module variant. Pin names do not establish donor wiring.

P12/SCL, P13/SDA and P36 are marked Do Not Connect in the BM77 datasheet. Still to identify: U1, other discrete parts, remaining passives, antenna matching and connector variants. No invented wires, no no-connect flags used to hide unknown wiring. ERC warnings are expected at this stage.

U4/Q1/Q2: identities from direct donor readings, 2026-10-18. Q1 source pin3 to C68 traced from video; other local connections unverified. | C68 Unknown | Q1

IRF9310 (P-channel) S

| 1
| S

2

S

3 | G
4 | D

5 D

6 D

7 D

8

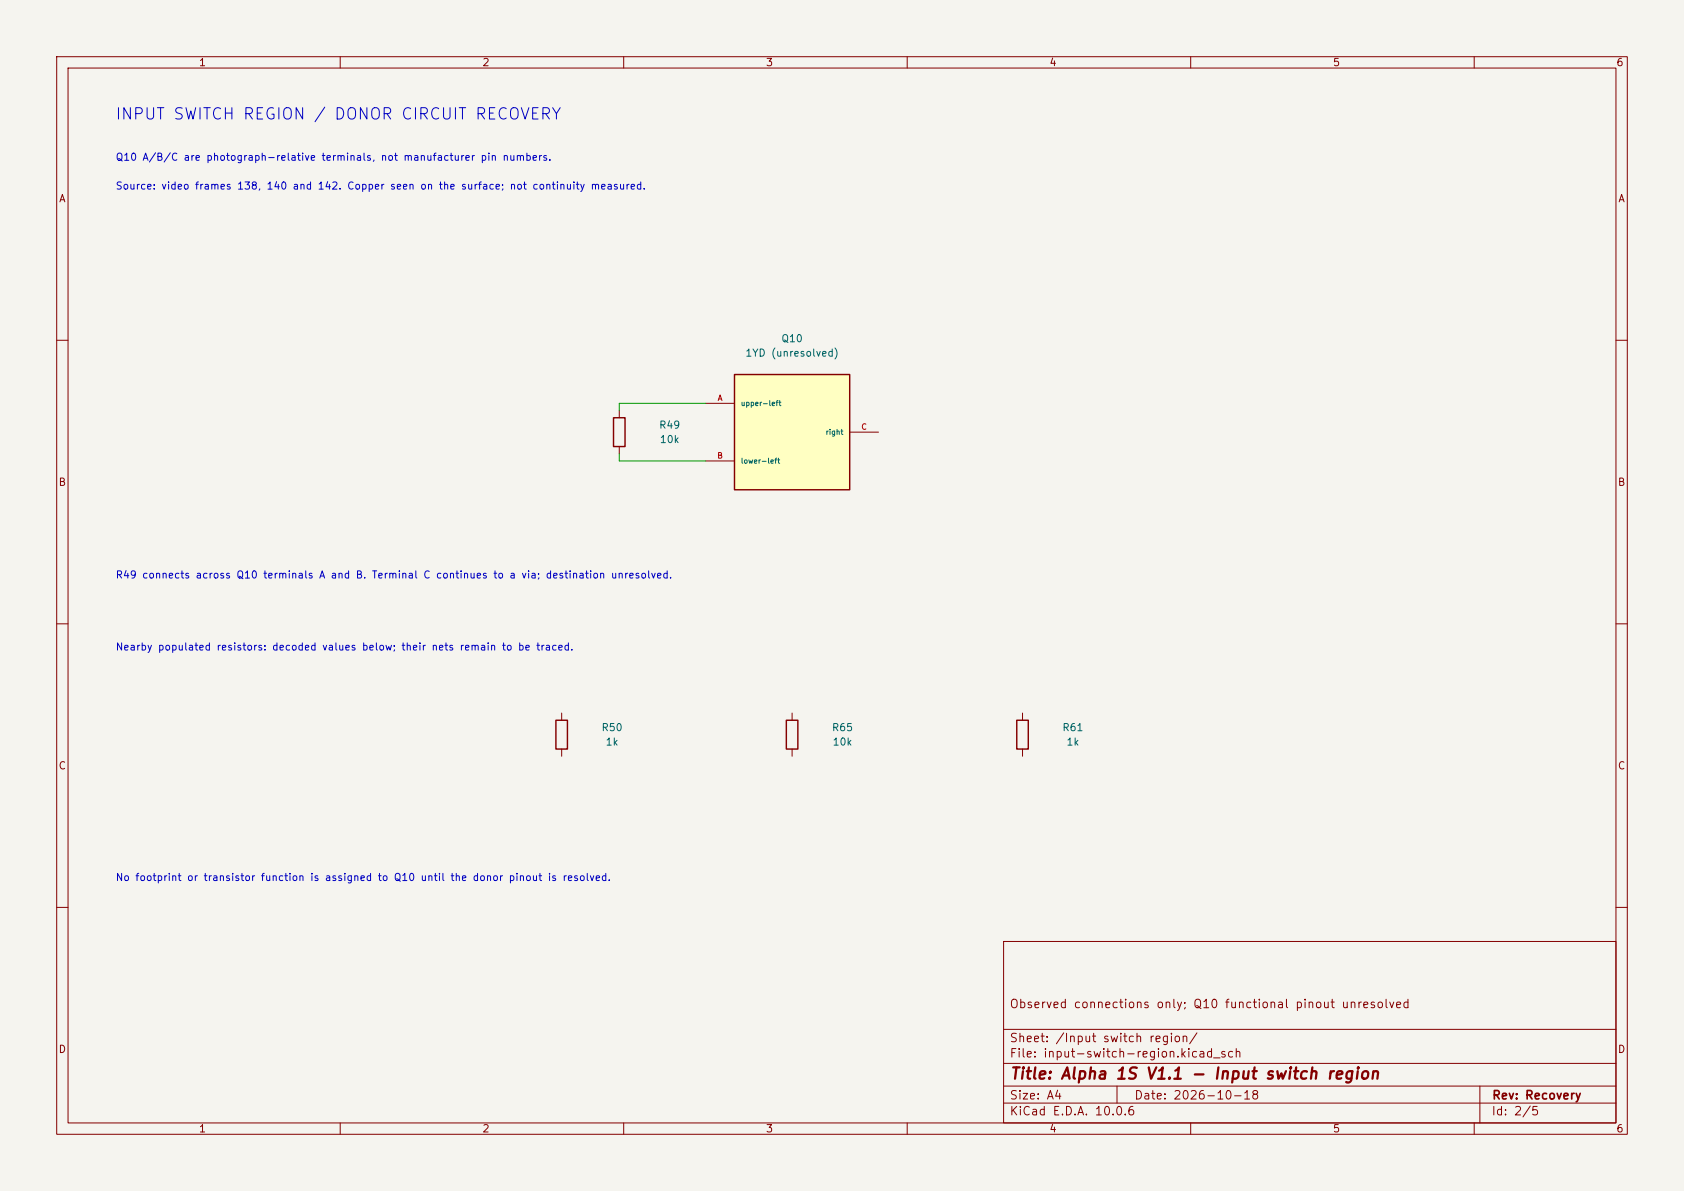
[picture p19: page 2]

INPUT SWITCH REGION / DONOR CIRCUIT RECOVERY

Source: video frames 138, 140 and 142. Copper seen on the surface; not continuity measured. Q10 A/B/C are photograph-relative terminals, not manufacturer pin numbers. Nearby populated resistors: decoded values below; their nets remain to be traced. R49 connects across Q10 terminals A and B. Terminal C continues to a via; destination unresolved. No footprint or transistor function is assigned to Q10 until the donor pinout is resolved.

Observed connections only; Q10 functional pinout unresolved

Sheet: /Input switch region/
File: input-switch-region.kicad_sch
Title: Alpha 1S V1.1 - Input switch region

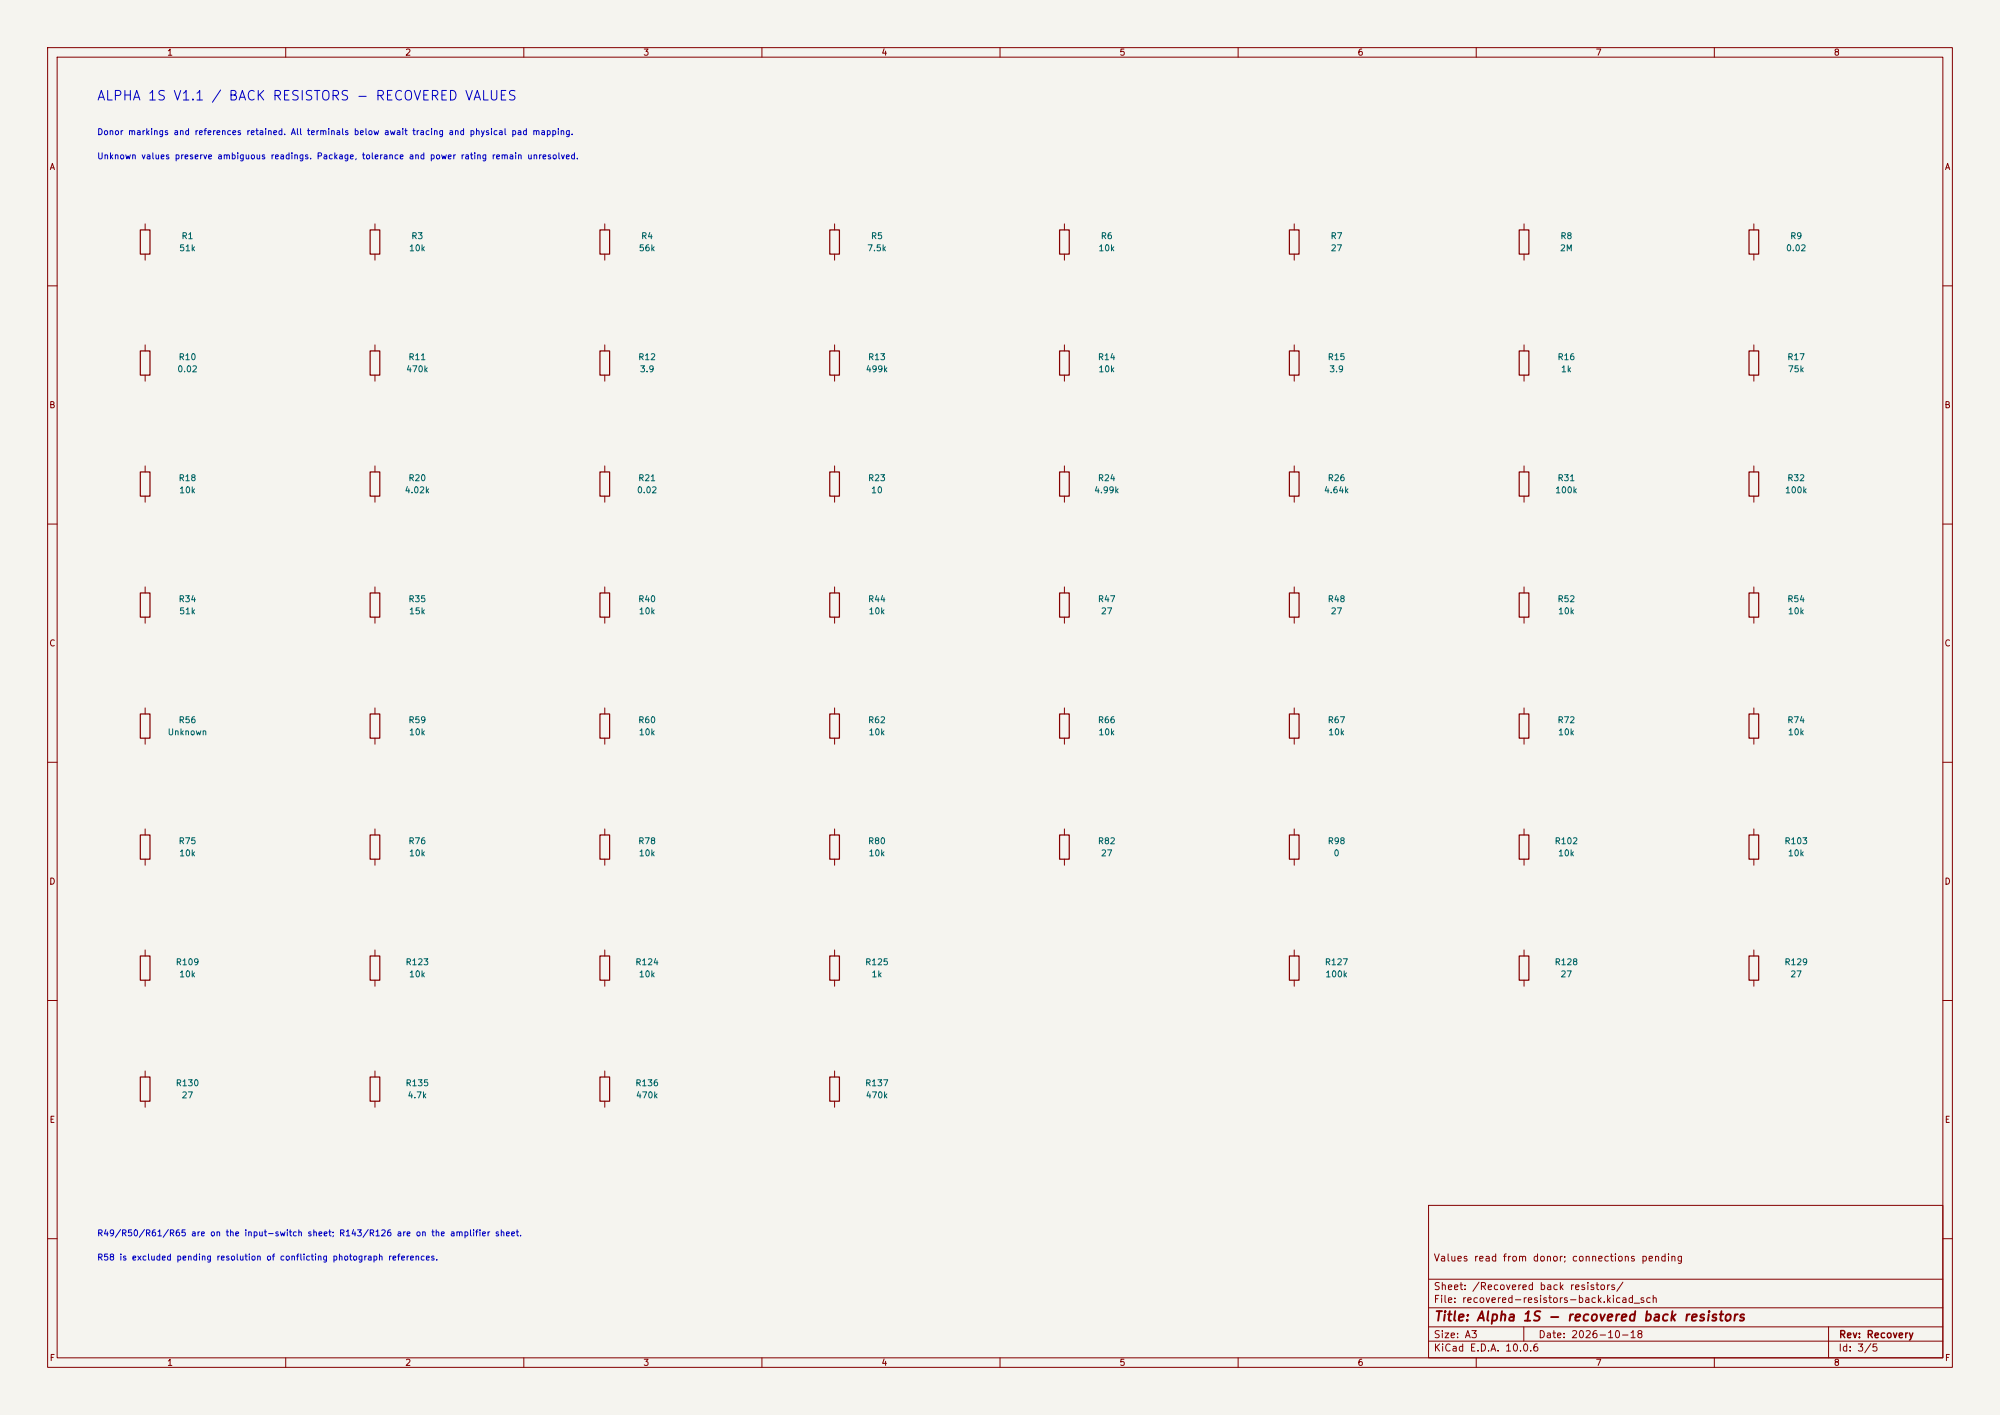
[picture p20: page 3]

Unknown values preserve ambiguous readings. Package, tolerance and power rating remain unresolved. ALPHA 1S V1.1 / BACK RESISTORS - RECOVERED VALUES

Donor markings and references retained. All terminals below await tracing and physical pad mapping.

R58 is excluded pending resolution of conflicting photograph references. R49/R50/R61/R65 are on the input-switch sheet; R143/R126 are on the amplifier sheet.

Values read from donor; connections pending

Sheet: /Recovered back resistors/
File: recovered-resistors-back.kicad_sch
Title: Alpha 1S - recovered back resistors

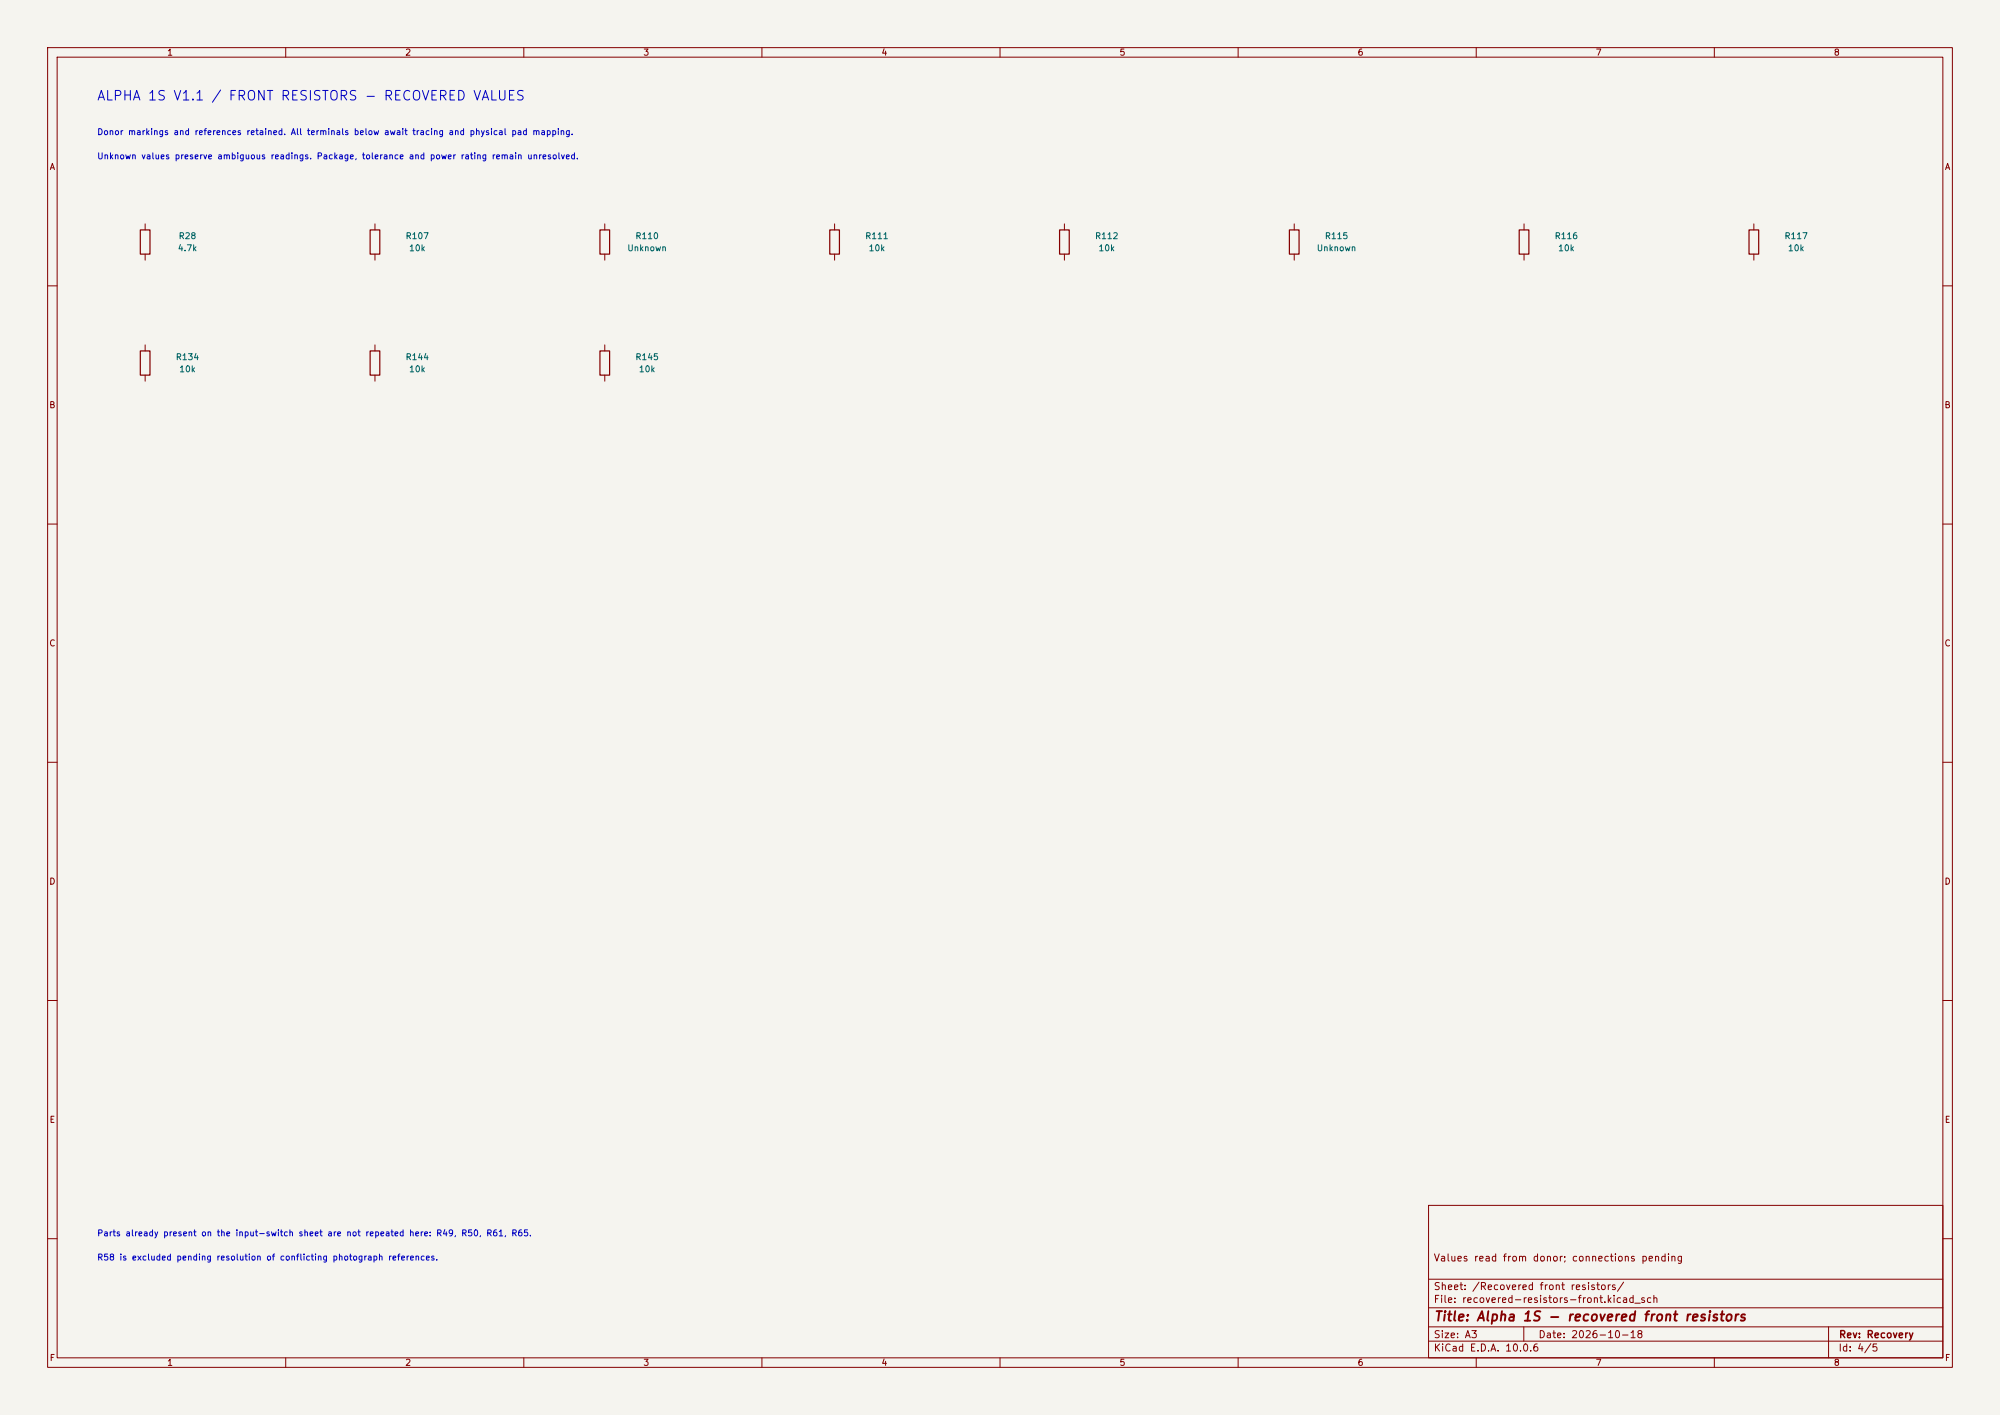
[picture p21: page 4]

10k ALPHA 1S V1.1 / FRONT RESISTORS - RECOVERED VALUES

Donor markings and references retained. All terminals below await tracing and physical pad mapping. Unknown values preserve ambiguous readings. Package, tolerance and power rating remain unresolved.

R58 is excluded pending resolution of conflicting photograph references. Parts already present on the input-switch sheet are not repeated here: R49, R50, R61, R65.

Values read from donor; connections pending

Sheet: /Recovered front resistors/
File: recovered-resistors-front.kicad_sch
Title: Alpha 1S - recovered front resistors

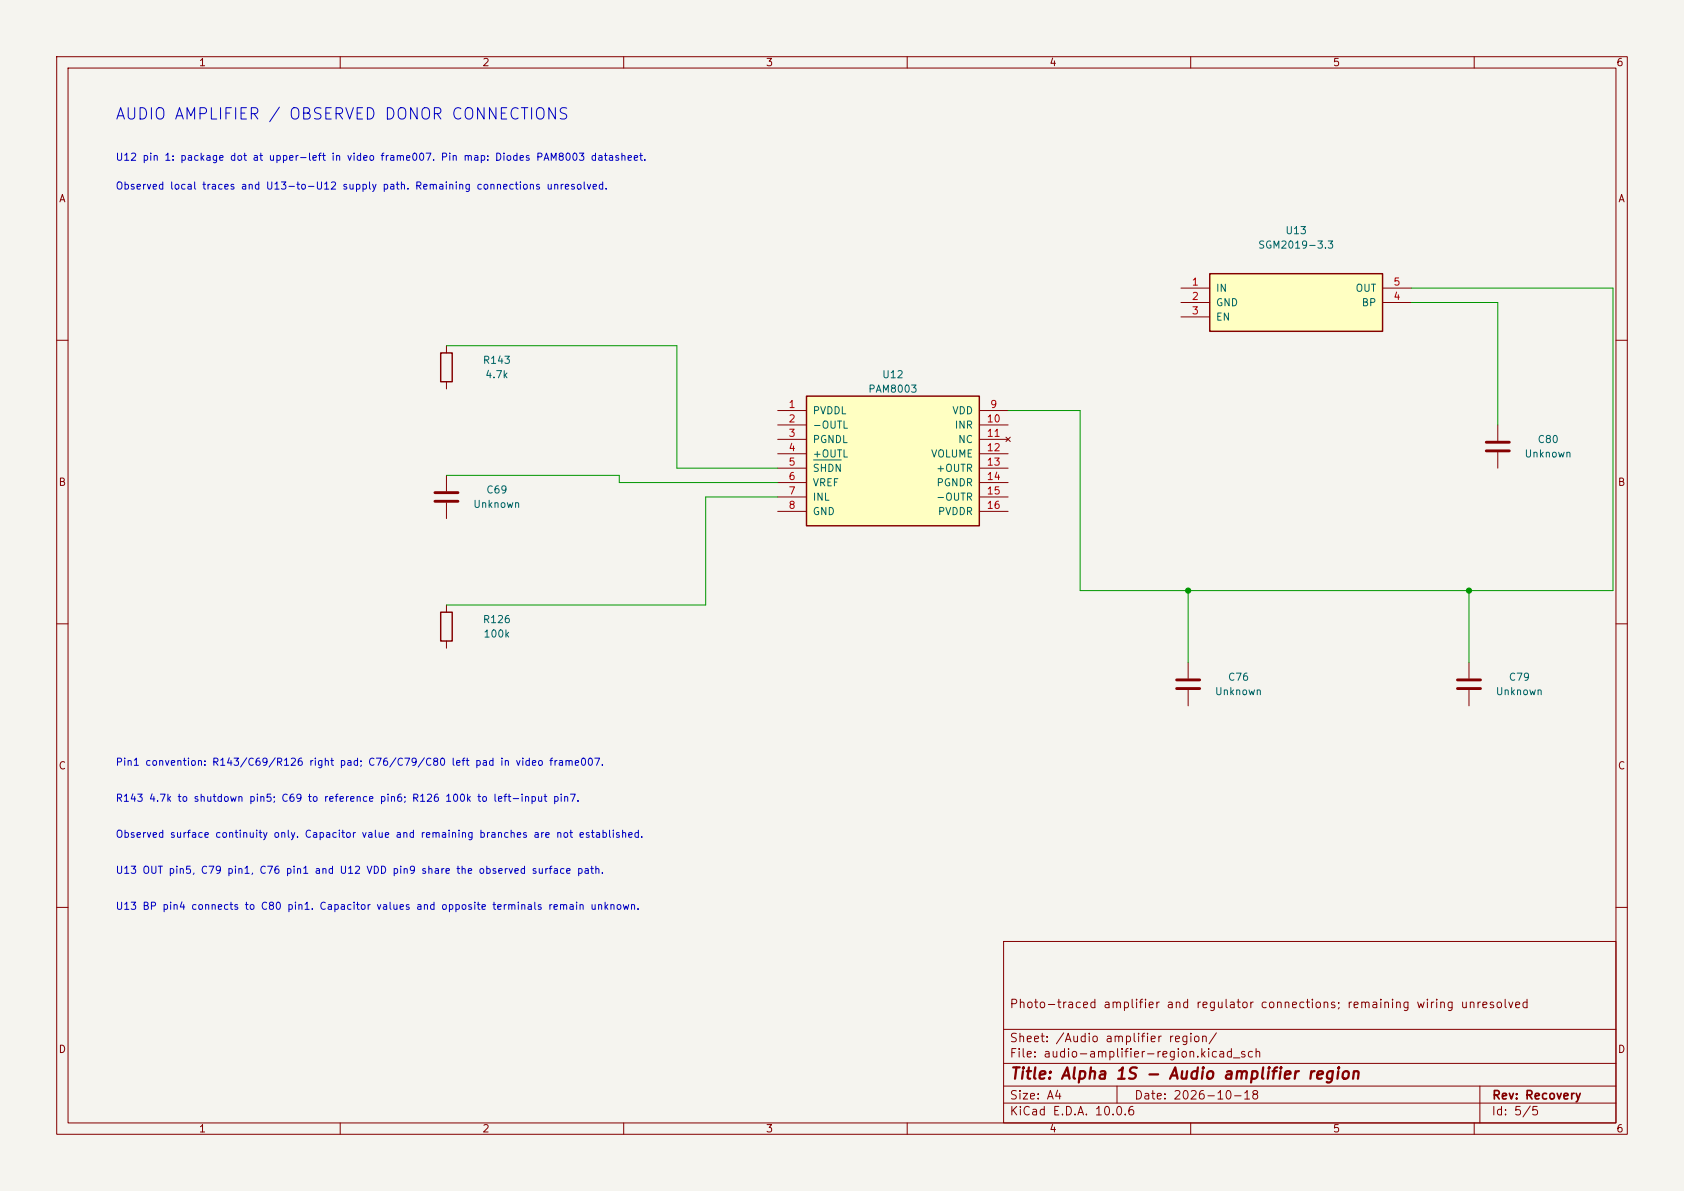
[picture p22: page 5]

AUDIO AMPLIFIER / OBSERVED DONOR CONNECTIONS

U12 pin 1: package dot at upper-left in video frame007. Pin map: Diodes PAM8003 datasheet. Observed local traces and U13-to-U12 supply path. Remaining connections unresolved. U13 BP pin4 connects to C80 pin1. Capacitor values and opposite terminals remain unknown.

SGM2019-3.3 Observed surface continuity only. Capacitor value and remaining branches are not established. R143 4.7k to shutdown pin5; C69 to reference pin6; R126 100k to left-input pin7. Pin1 convention: R143/C69/R126 right pad; C76/C79/C80 left pad in video frame007. U13 OUT pin5, C79 pin1, C76 pin1 and U12 VDD pin9 share the observed surface path.

Photo-traced amplifier and regulator connections; remaining wiring unresolved

Sheet: /Audio amplifier region/
File: audio-amplifier-region.kicad_sch
Title: Alpha 1S - Audio amplifier region
