iimmyy/Little-Guy/hardware/alpha1s-v1.1/alpha1s-original.kicad_sch

## KiCad design hardware/alpha1s-v1.1/alpha1s-original.kicad_sch (2026-11-07)

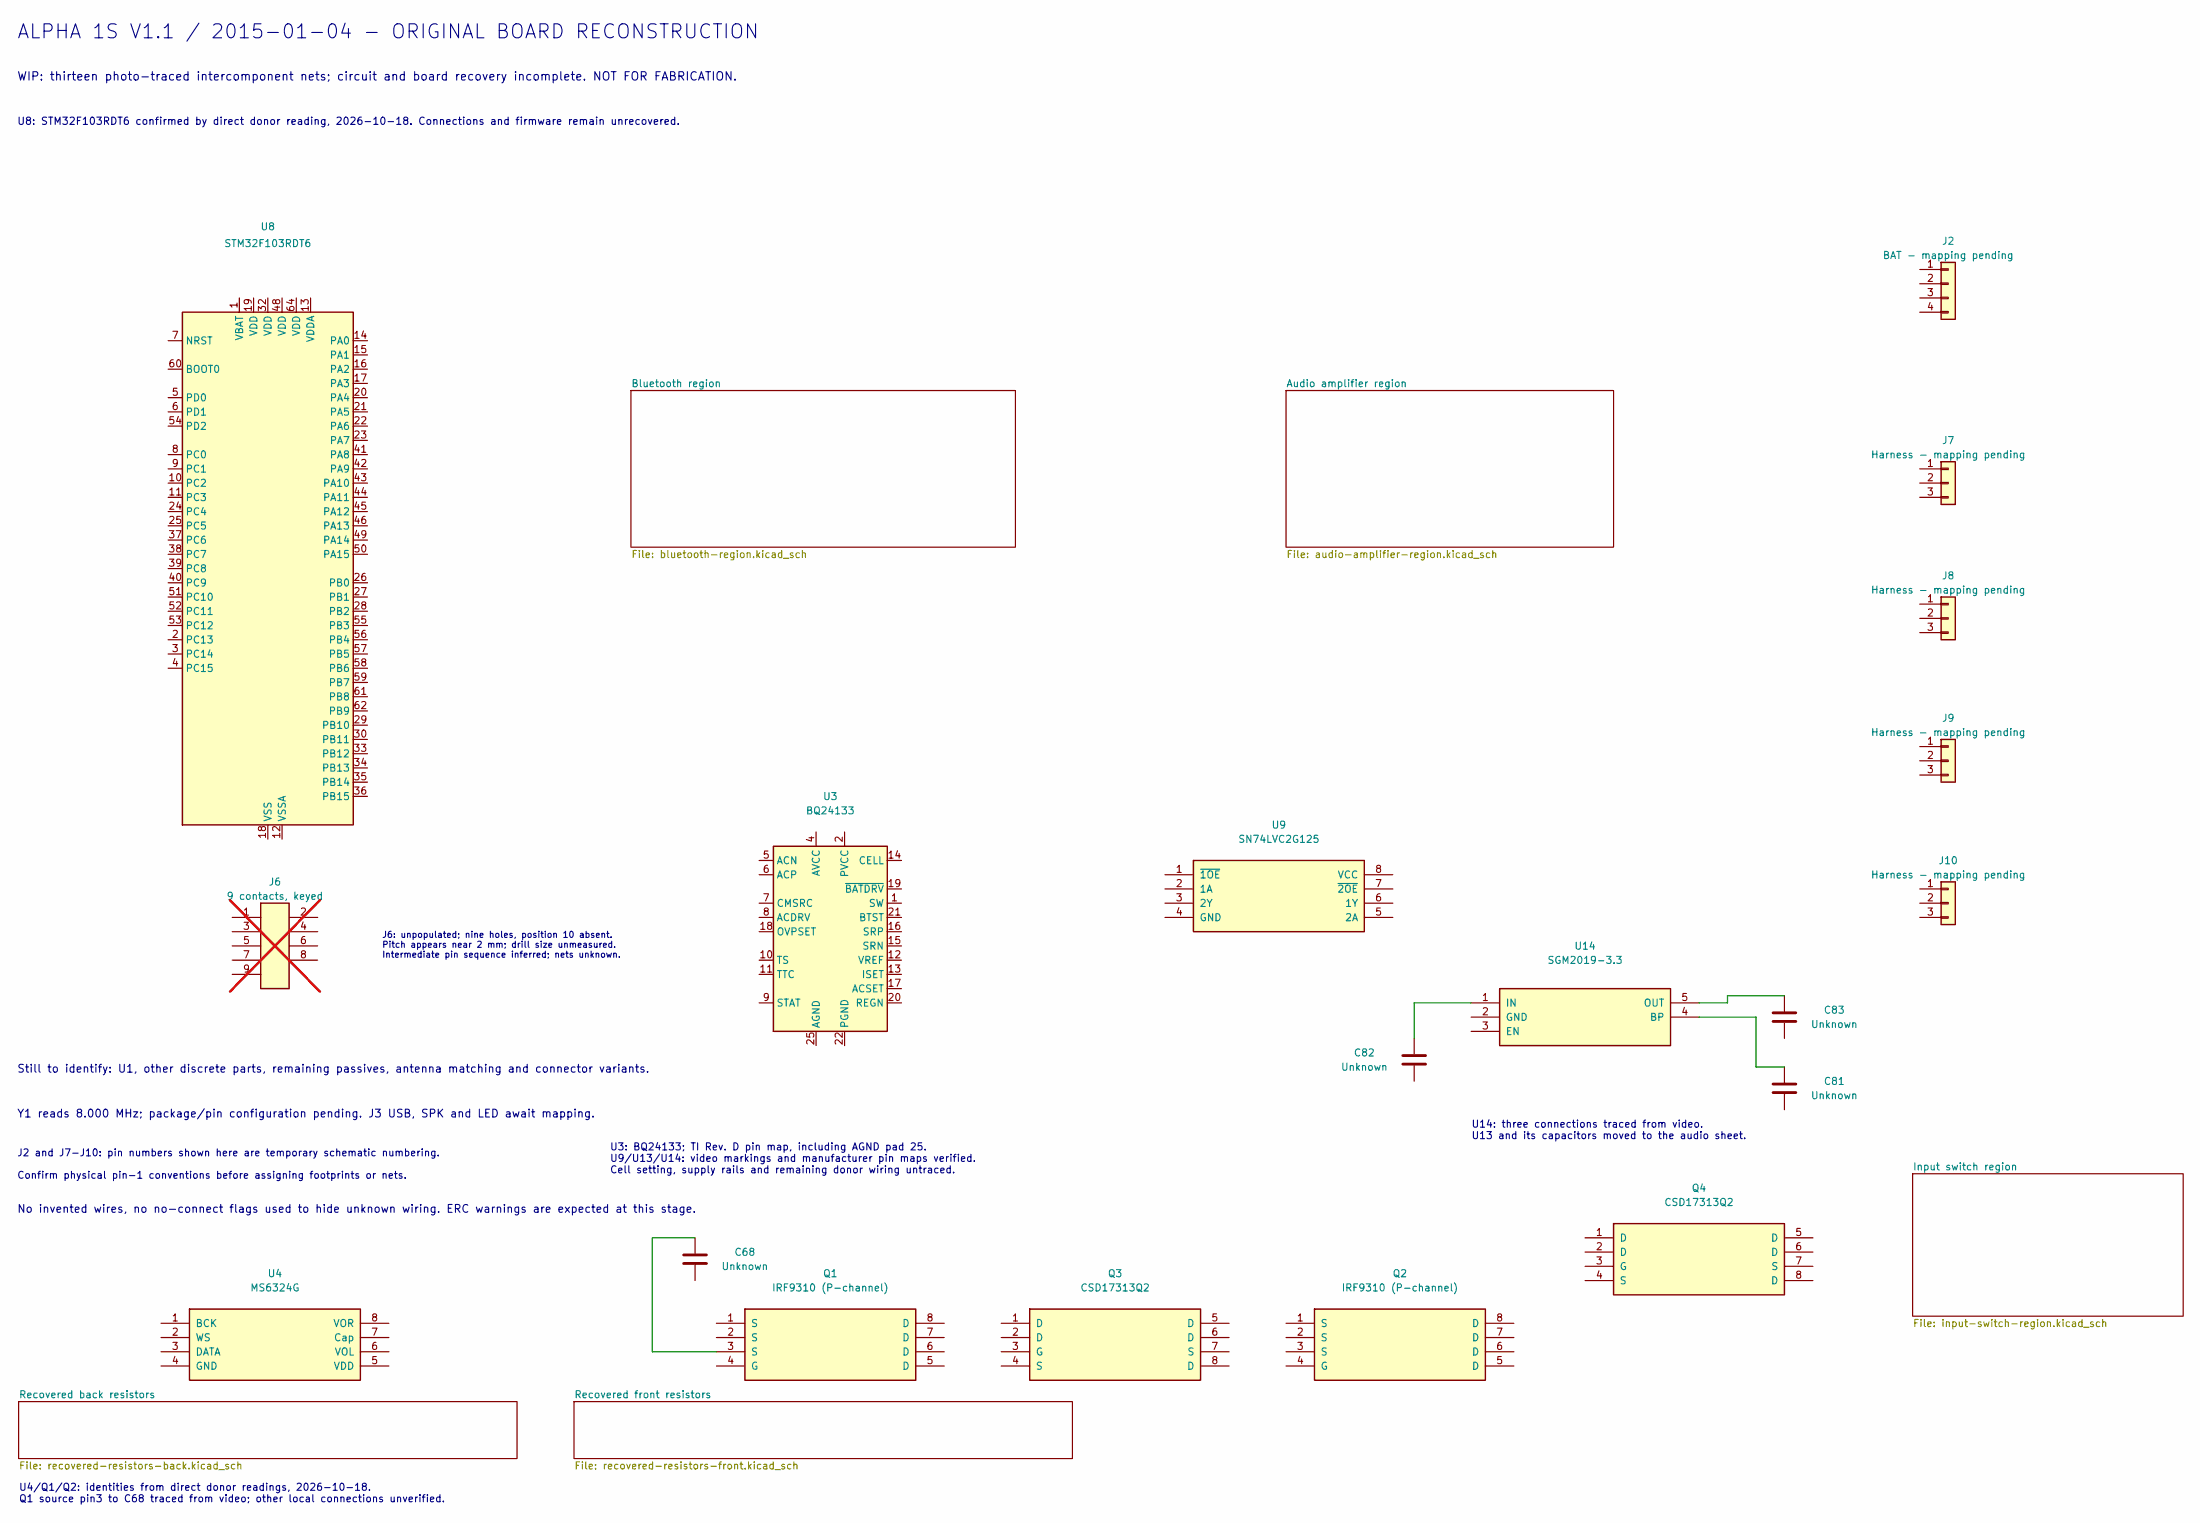
[picture p28: schematic alpha1s-original.kicad_sch]

Parts:
C68, C81, C82, C83: Unknown
J2: BAT - mapping pending
J6: 9 contacts, keyed; not fitted
J7, J8, J9, J10: Harness - mapping pending
Q1, Q2: IRF9310 (P-channel); IRF9310_SO8_Manufacturer_Recommended
Q3, Q4: CSD17313Q2
U3: BQ24133
U4: MS6324G; MS6324G_SOIC8_KiCad_Reference
U8: STM32F103RDT6; STM32_LQFP64_KiCad_Reference
U9: SN74LVC2G125; SN74LVC2G125_DCU8_Manufacturer_Land_Example
U14: SGM2019-3.3; SGM2019_SOT23_5_Manufacturer_Recommended

Connections:
unnamed: C68.1, Q1.3 (S)
unnamed: C81.1, U14.4 (BP)
unnamed: C82.1, U14.1 (IN)
unnamed: C83.1, U14.5 (OUT)
unnamed: U3.1 (SW), U3.24 (SW)
unnamed: U3.2 (PVCC), U3.3 (PVCC)
unnamed: U3.22 (PGND), U3.23 (PGND)
unnamed: U8.18 (VSS), U8.31 (VSS), U8.47 (VSS), U8.63 (VSS)

Notes on the sheet:
Still to identify: U1, other discrete parts, remaining passives, antenna matching and connector variants.
J2 and J7-J10: pin numbers shown here are temporary schematic numbering.
U14: three connections traced from video. U13 and its capacitors moved to the audio sheet.
WIP: thirteen photo-traced intercomponent nets; circuit and board recovery incomplete. NOT FOR FABRICATION.
U8: STM32F103RDT6 confirmed by direct donor reading, 2026-10-18. Connections and firmware remain unrecovered.
U4/Q1/Q2: identities from direct donor readings, 2026-10-18. Q1 source pin3 to C68 traced from video; other local connections unverified.
U3: BQ24133; TI Rev. D pin map, including AGND pad 25. U9/U13/U14: video markings and manufacturer pin maps verified. Cell setting, supply rails and remaining donor wiring untraced.
Y1 reads 8.000 MHz; package/pin configuration pending. J3 USB, SPK and LED await mapping.
No invented wires, no no-connect flags used to hide unknown wiring. ERC warnings are expected at this stage.
ALPHA 1S V1.1 / 2015-01-04 - ORIGINAL BOARD RECONSTRUCTION
Confirm physical pin-1 conventions before assigning footprints or nets.
J6: unpopulated; nine holes, position 10 absent. Pitch appears near 2 mm; drill size unmeasured. Intermediate pin sequence inferred; nets unknown.
