iimmyy/Little-Guy/hardware/alpha1s-v1.1/audio-amplifier-region.kicad_sch

## KiCad design hardware/alpha1s-v1.1/audio-amplifier-region.kicad_sch (2026-11-07)

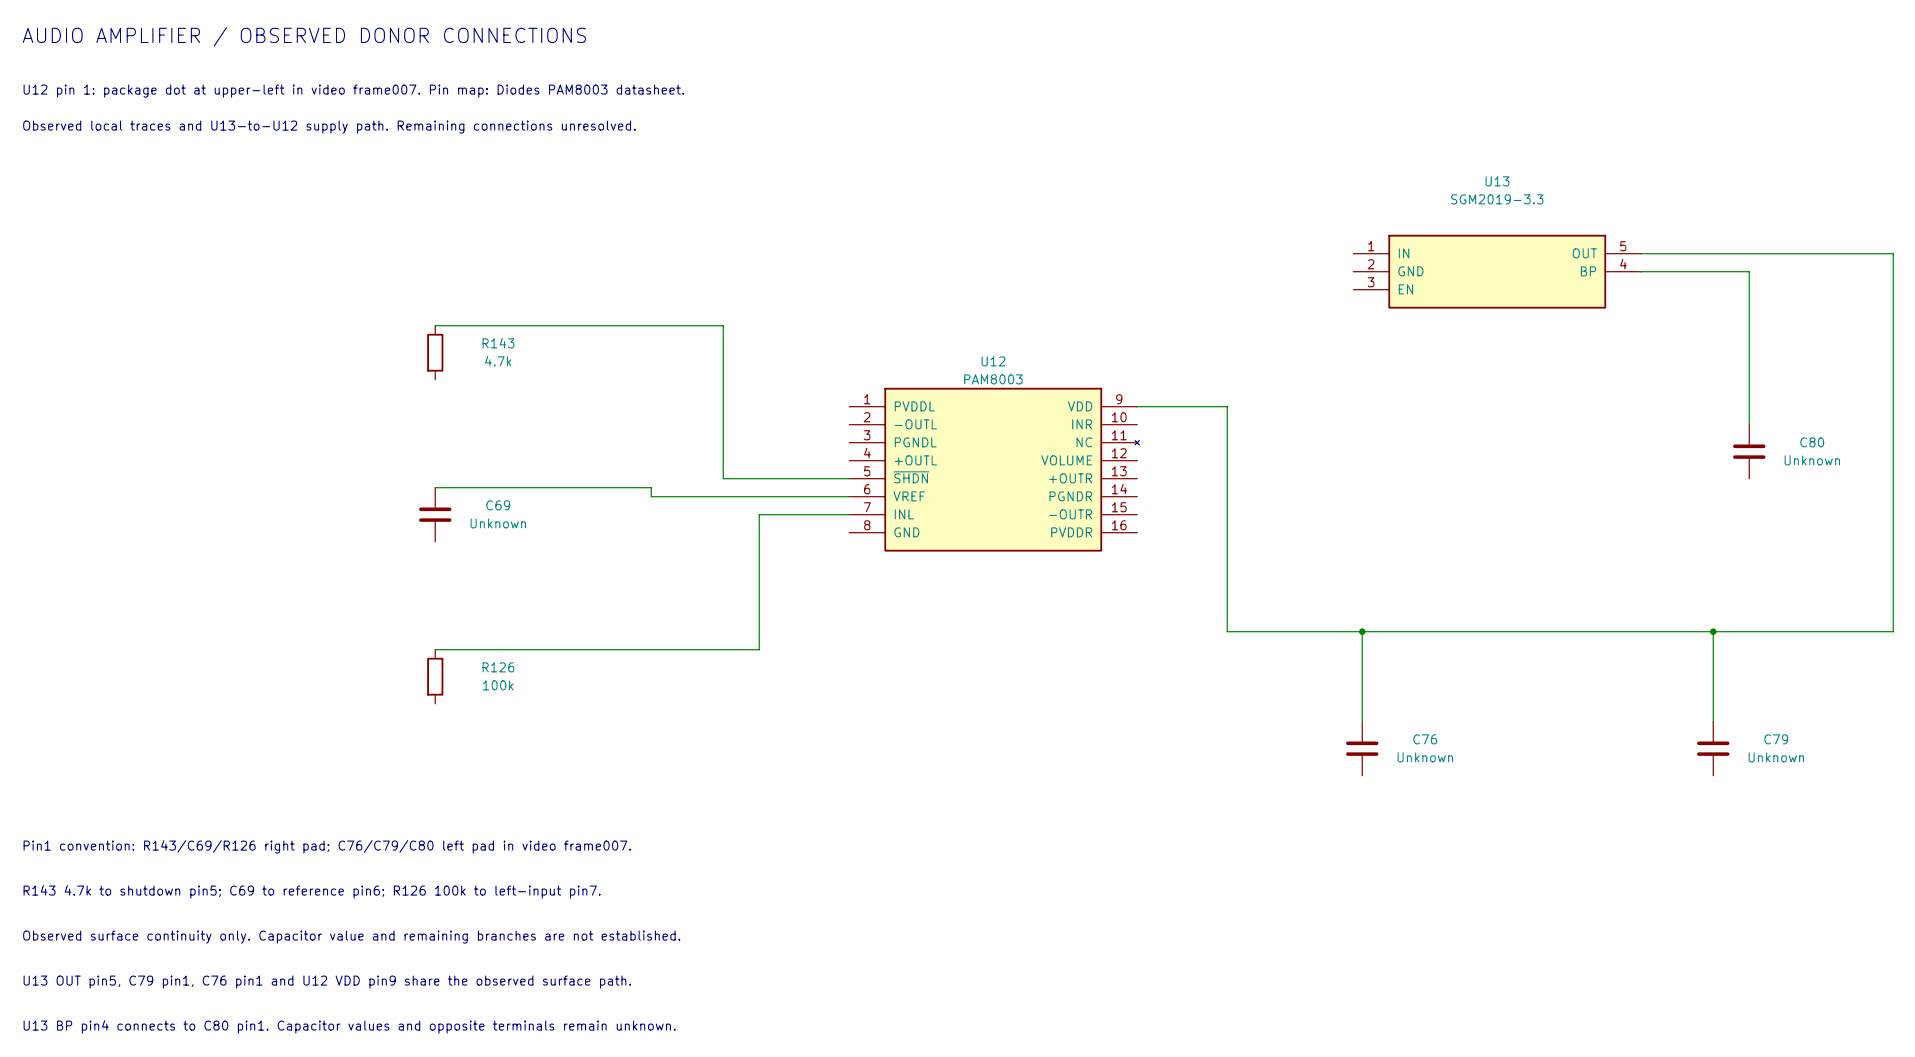
[picture p29: schematic audio-amplifier-region.kicad_sch]

Parts:
C69, C76, C79, C80: Unknown
R126: 100k
R143: 4.7k
U12: PAM8003; PAM8003_SO16_Manufacturer_Recommended
U13: SGM2019-3.3; SGM2019_SOT23_5_Manufacturer_Recommended

Connections:
unnamed: C69.1, U12.6 (VREF)
unnamed: C76.1, C79.1, U12.9 (VDD), U13.5 (OUT)
unnamed: C80.1, U13.4 (BP)
unnamed: R126.1, U12.7 (INL)
unnamed: R143.1, U12.5 (~SHDN)

Notes on the sheet:
Pin1 convention: R143/C69/R126 right pad; C76/C79/C80 left pad in video frame007.
U13 BP pin4 connects to C80 pin1. Capacitor values and opposite terminals remain unknown.
Observed surface continuity only. Capacitor value and remaining branches are not established.
U12 pin 1: package dot at upper-left in video frame007. Pin map: Diodes PAM8003 datasheet.
R143 4.7k to shutdown pin5; C69 to reference pin6; R126 100k to left-input pin7.
Observed local traces and U13-to-U12 supply path. Remaining connections unresolved.
U13 OUT pin5, C79 pin1, C76 pin1 and U12 VDD pin9 share the observed surface path.
AUDIO AMPLIFIER / OBSERVED DONOR CONNECTIONS
