iimmyy/Little-Guy/hardware/alpha1s-v1.1/bluetooth-region.kicad_sch

## KiCad design hardware/alpha1s-v1.1/bluetooth-region.kicad_sch (2026-11-07)

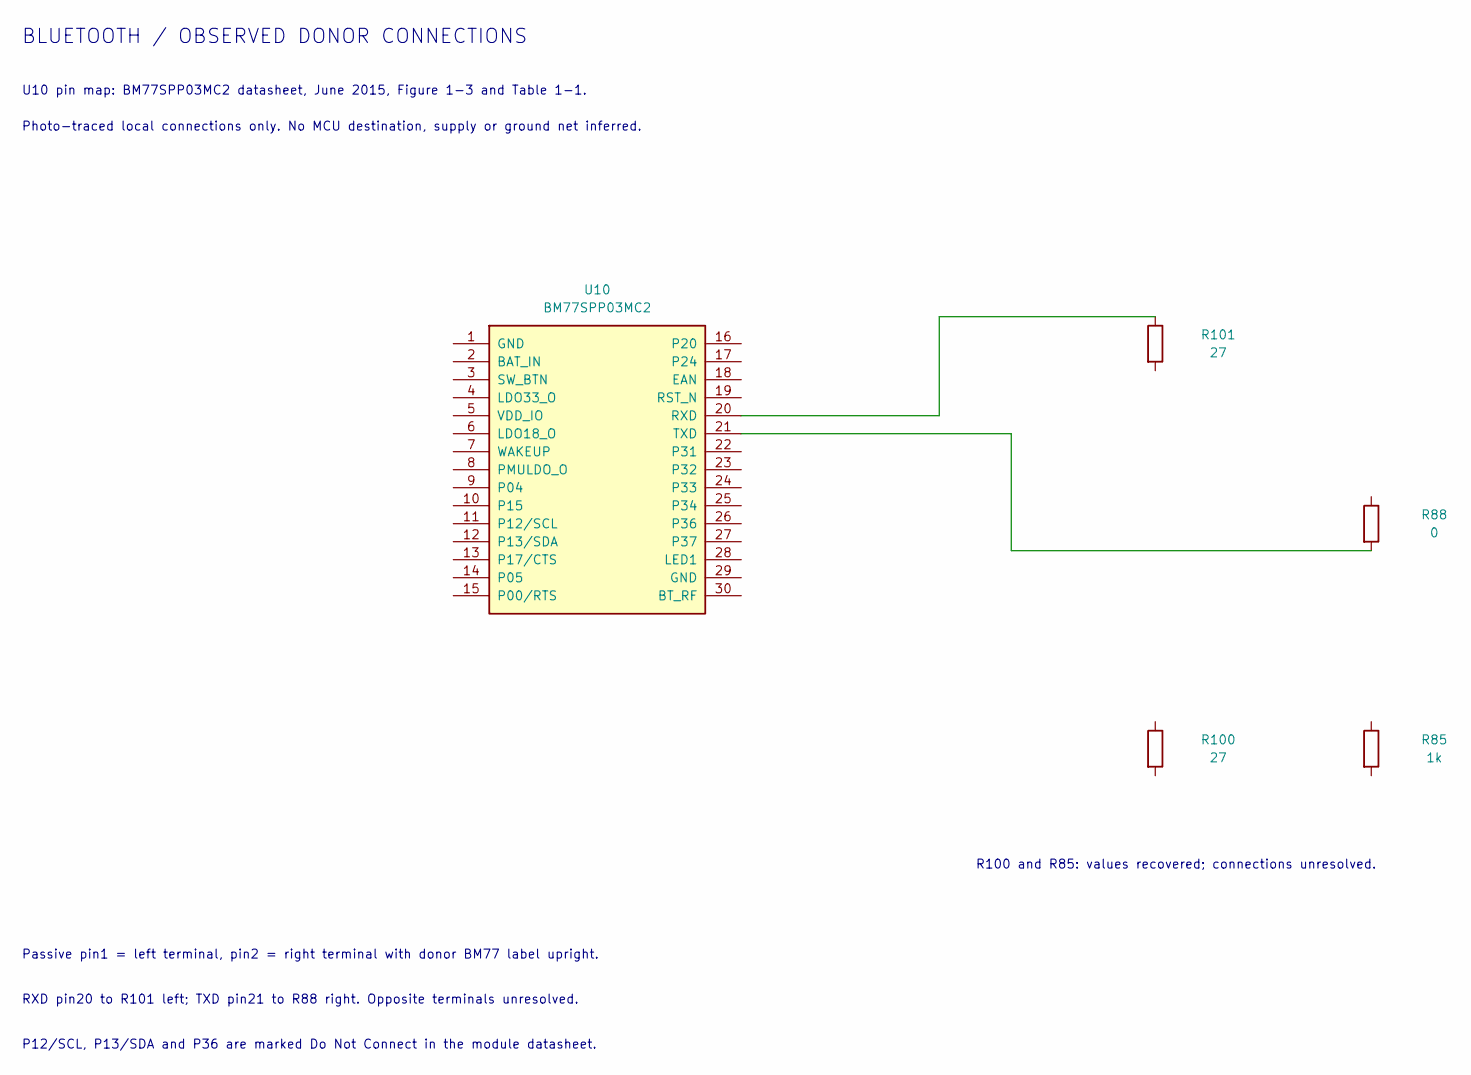
[picture p30: schematic bluetooth-region.kicad_sch]

Parts:
R85: 1k
R88: 0
R100, R101: 27
U10: BM77SPP03MC2; BM77SPP03MC2_Manufacturer_Recommended

Connections:
unnamed: R88.2, U10.21 (TXD)
unnamed: R101.1, U10.20 (RXD)

Notes on the sheet:
BLUETOOTH / OBSERVED DONOR CONNECTIONS
U10 pin map: BM77SPP03MC2 datasheet, June 2015, Figure 1-3 and Table 1-1.
Photo-traced local connections only. No MCU destination, supply or ground net inferred.
R100 and R85: values recovered; connections unresolved.
Passive pin1 = left terminal, pin2 = right terminal with donor BM77 label upright.
RXD pin20 to R101 left; TXD pin21 to R88 right. Opposite terminals unresolved.
P12/SCL, P13/SDA and P36 are marked Do Not Connect in the module datasheet.
