iimmyy/Little-Guy/hardware/alpha1s-v1.1/input-switch-region.kicad_sch

## KiCad design hardware/alpha1s-v1.1/input-switch-region.kicad_sch (2026-11-07)

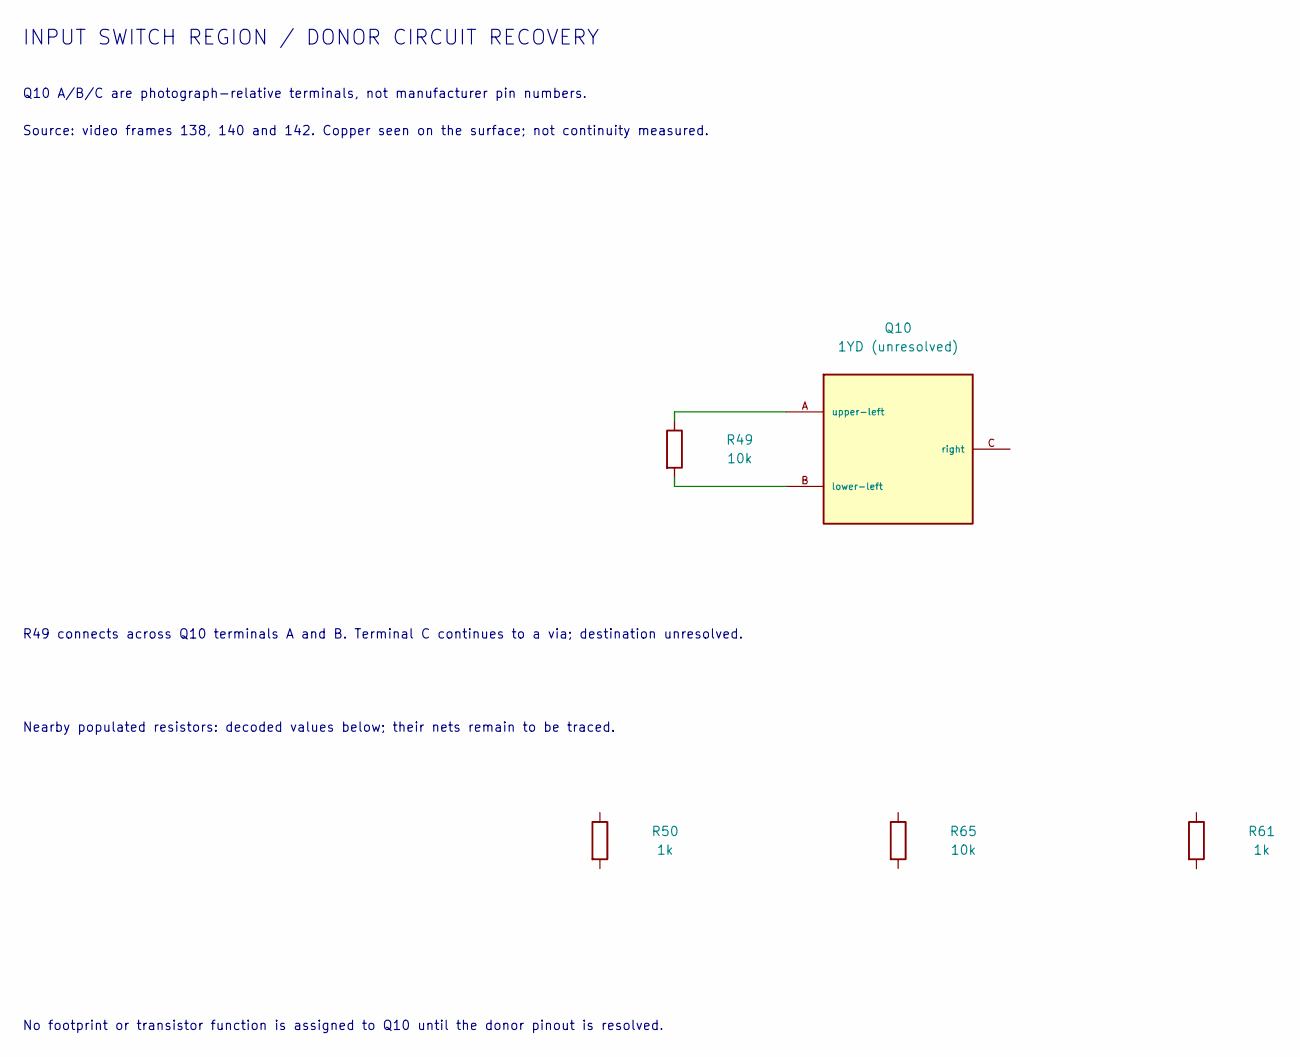
[picture p31: schematic input-switch-region.kicad_sch]

Parts:
Q10: 1YD (unresolved)
R49, R65: 10k
R50, R61: 1k

Connections:
unnamed: Q10.A (upper-left), R49.1
unnamed: Q10.B (lower-left), R49.2

Notes on the sheet:
Nearby populated resistors: decoded values below; their nets remain to be traced.
INPUT SWITCH REGION / DONOR CIRCUIT RECOVERY
R49 connects across Q10 terminals A and B. Terminal C continues to a via; destination unresolved.
Source: video frames 138, 140 and 142. Copper seen on the surface; not continuity measured.
Q10 A/B/C are photograph-relative terminals, not manufacturer pin numbers.
No footprint or transistor function is assigned to Q10 until the donor pinout is resolved.
