iimmyy/Little-Guy/hardware/alpha1s-v1.1/recovered-resistors-back.kicad_sch

## KiCad design hardware/alpha1s-v1.1/recovered-resistors-back.kicad_sch (2026-11-07)

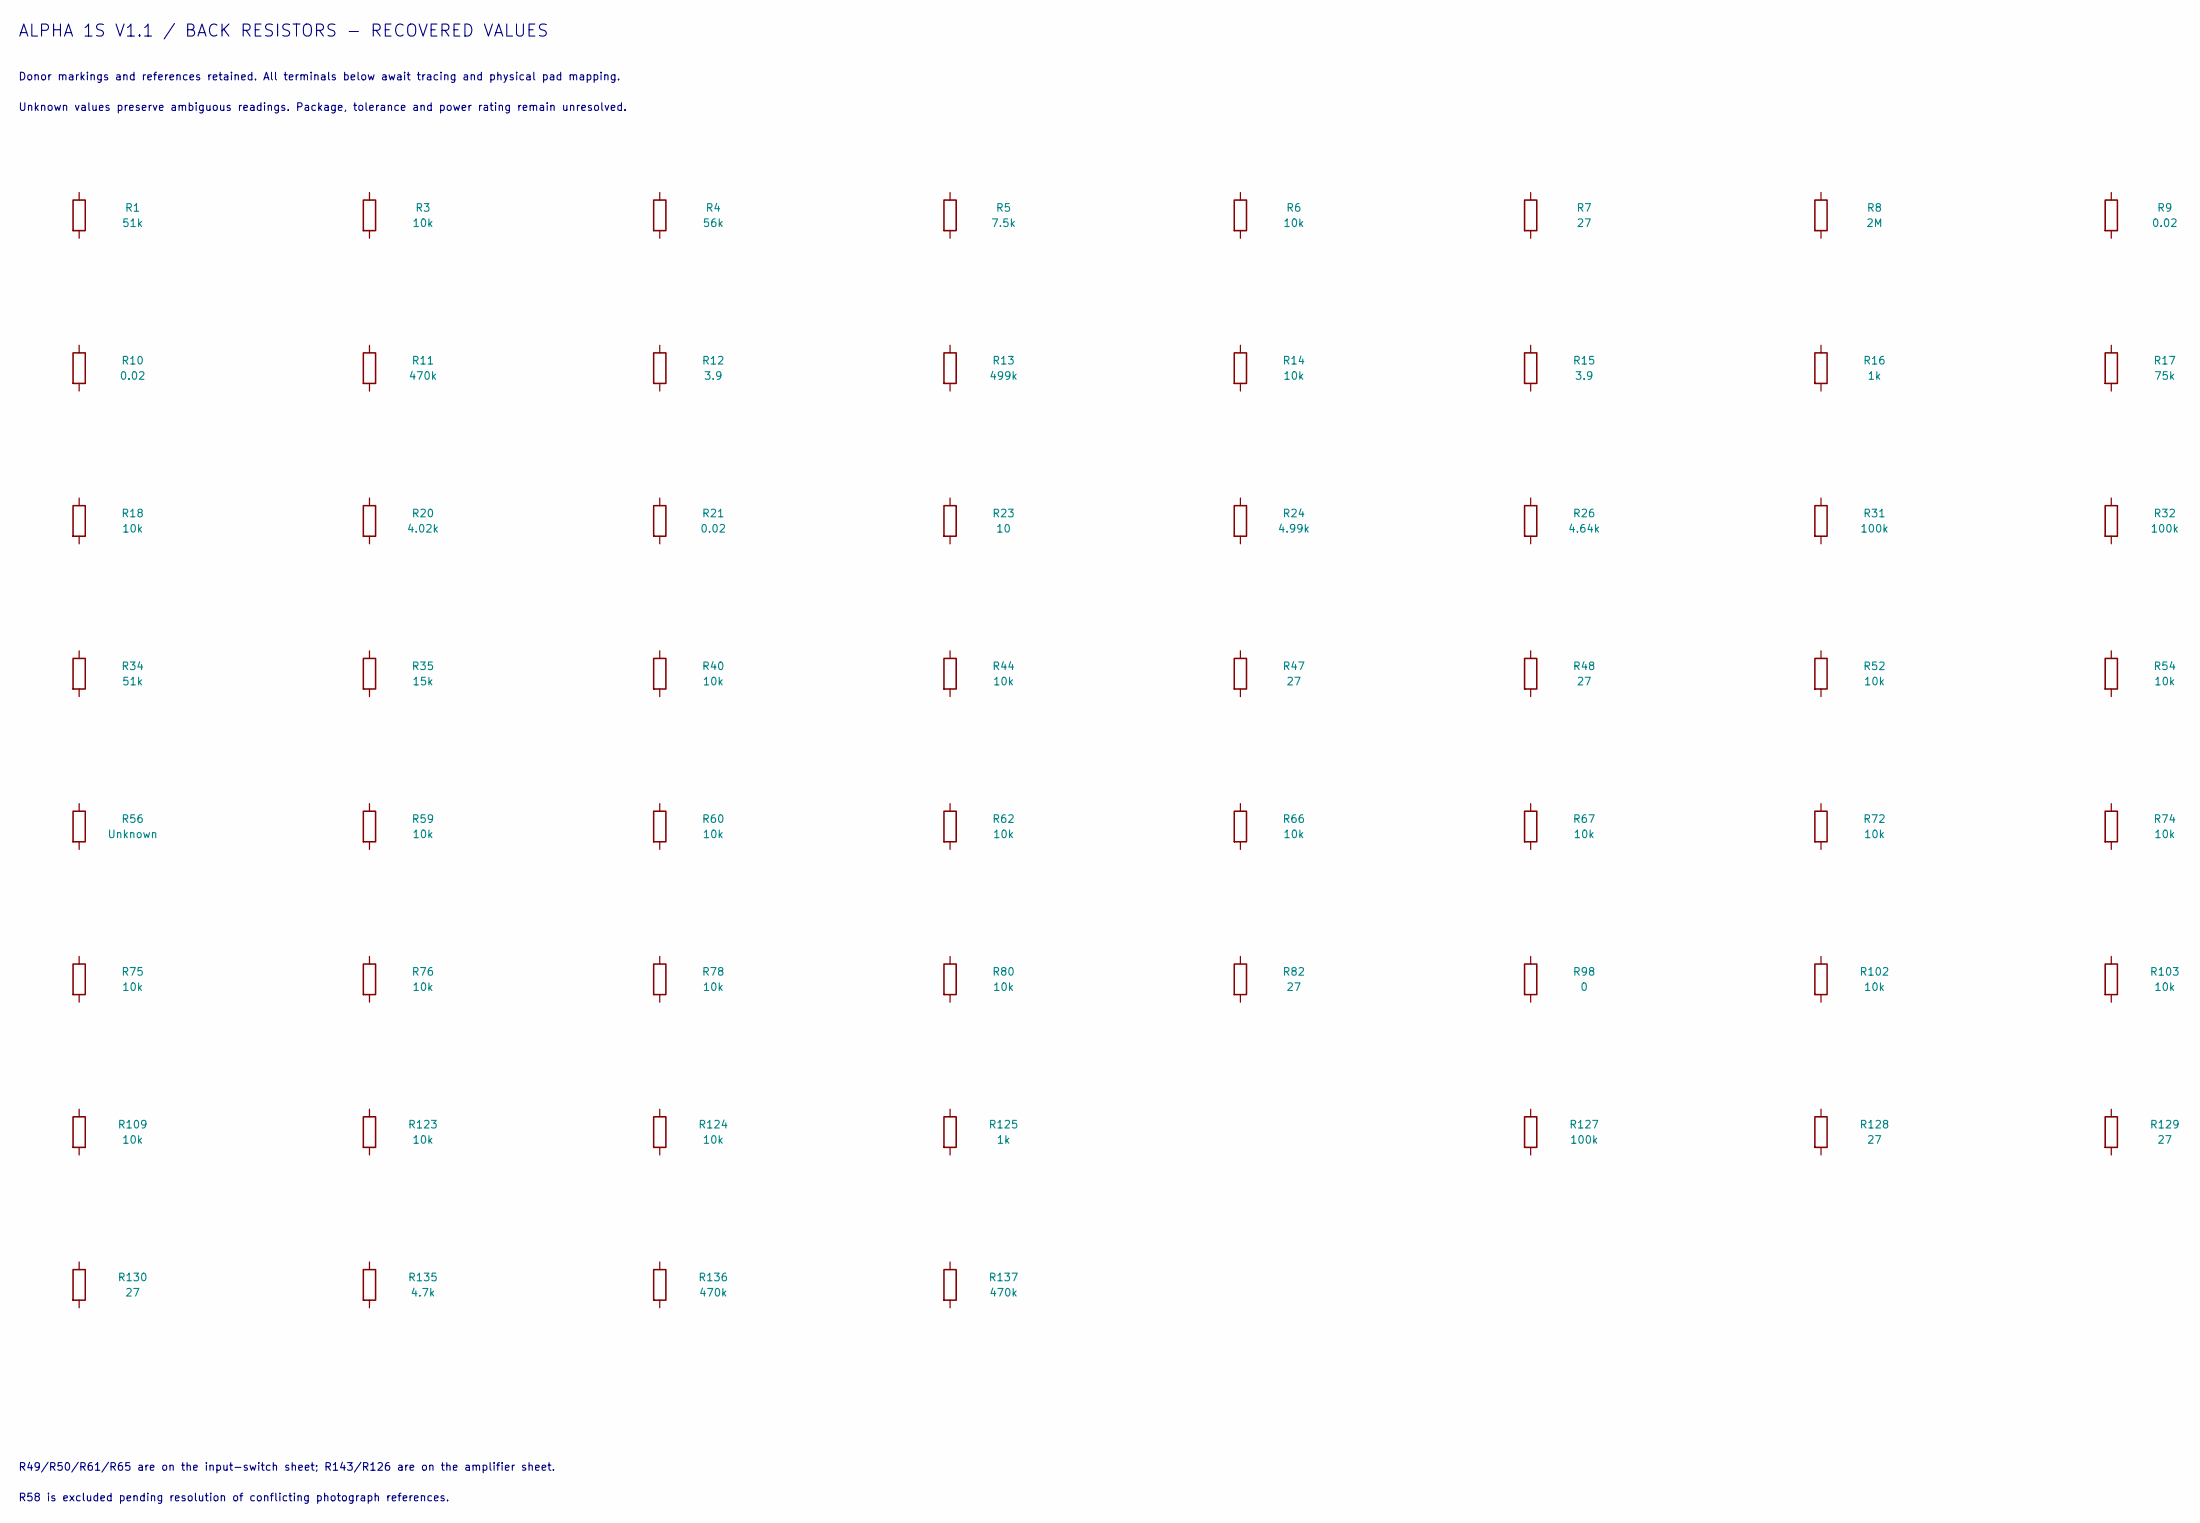
[picture p32: schematic recovered-resistors-back.kicad_sch]

Parts:
R1, R34: 51k
R3, R6, R14, R18, R40, R44, R52, R54, R59, R60, R62, R66, R67, R72, R74, R75, R76, R78, R80, R102, R103, R109, R123, R124: 10k
R4: 56k
R5: 7.5k
R7, R47, R48, R82, R128, R129, R130: 27
R8: 2M
R9, R10, R21: 0.02
R11, R136, R137: 470k
R12, R15: 3.9
R13: 499k
R16, R125: 1k
R17: 75k
R20: 4.02k
R23: 10
R24: 4.99k
R26: 4.64k
R31, R32, R127: 100k
R35: 15k
R56: Unknown
R98: 0
R135: 4.7k

Notes on the sheet:
Unknown values preserve ambiguous readings. Package, tolerance and power rating remain unresolved.
Donor markings and references retained. All terminals below await tracing and physical pad mapping.
R49/R50/R61/R65 are on the input-switch sheet; R143/R126 are on the amplifier sheet.
ALPHA 1S V1.1 / BACK RESISTORS - RECOVERED VALUES
R58 is excluded pending resolution of conflicting photograph references.
