iimmyy/Little-Guy/hardware/alpha1s-v1.1/recovered-resistors-front.kicad_sch

## KiCad design hardware/alpha1s-v1.1/recovered-resistors-front.kicad_sch (2026-11-07)

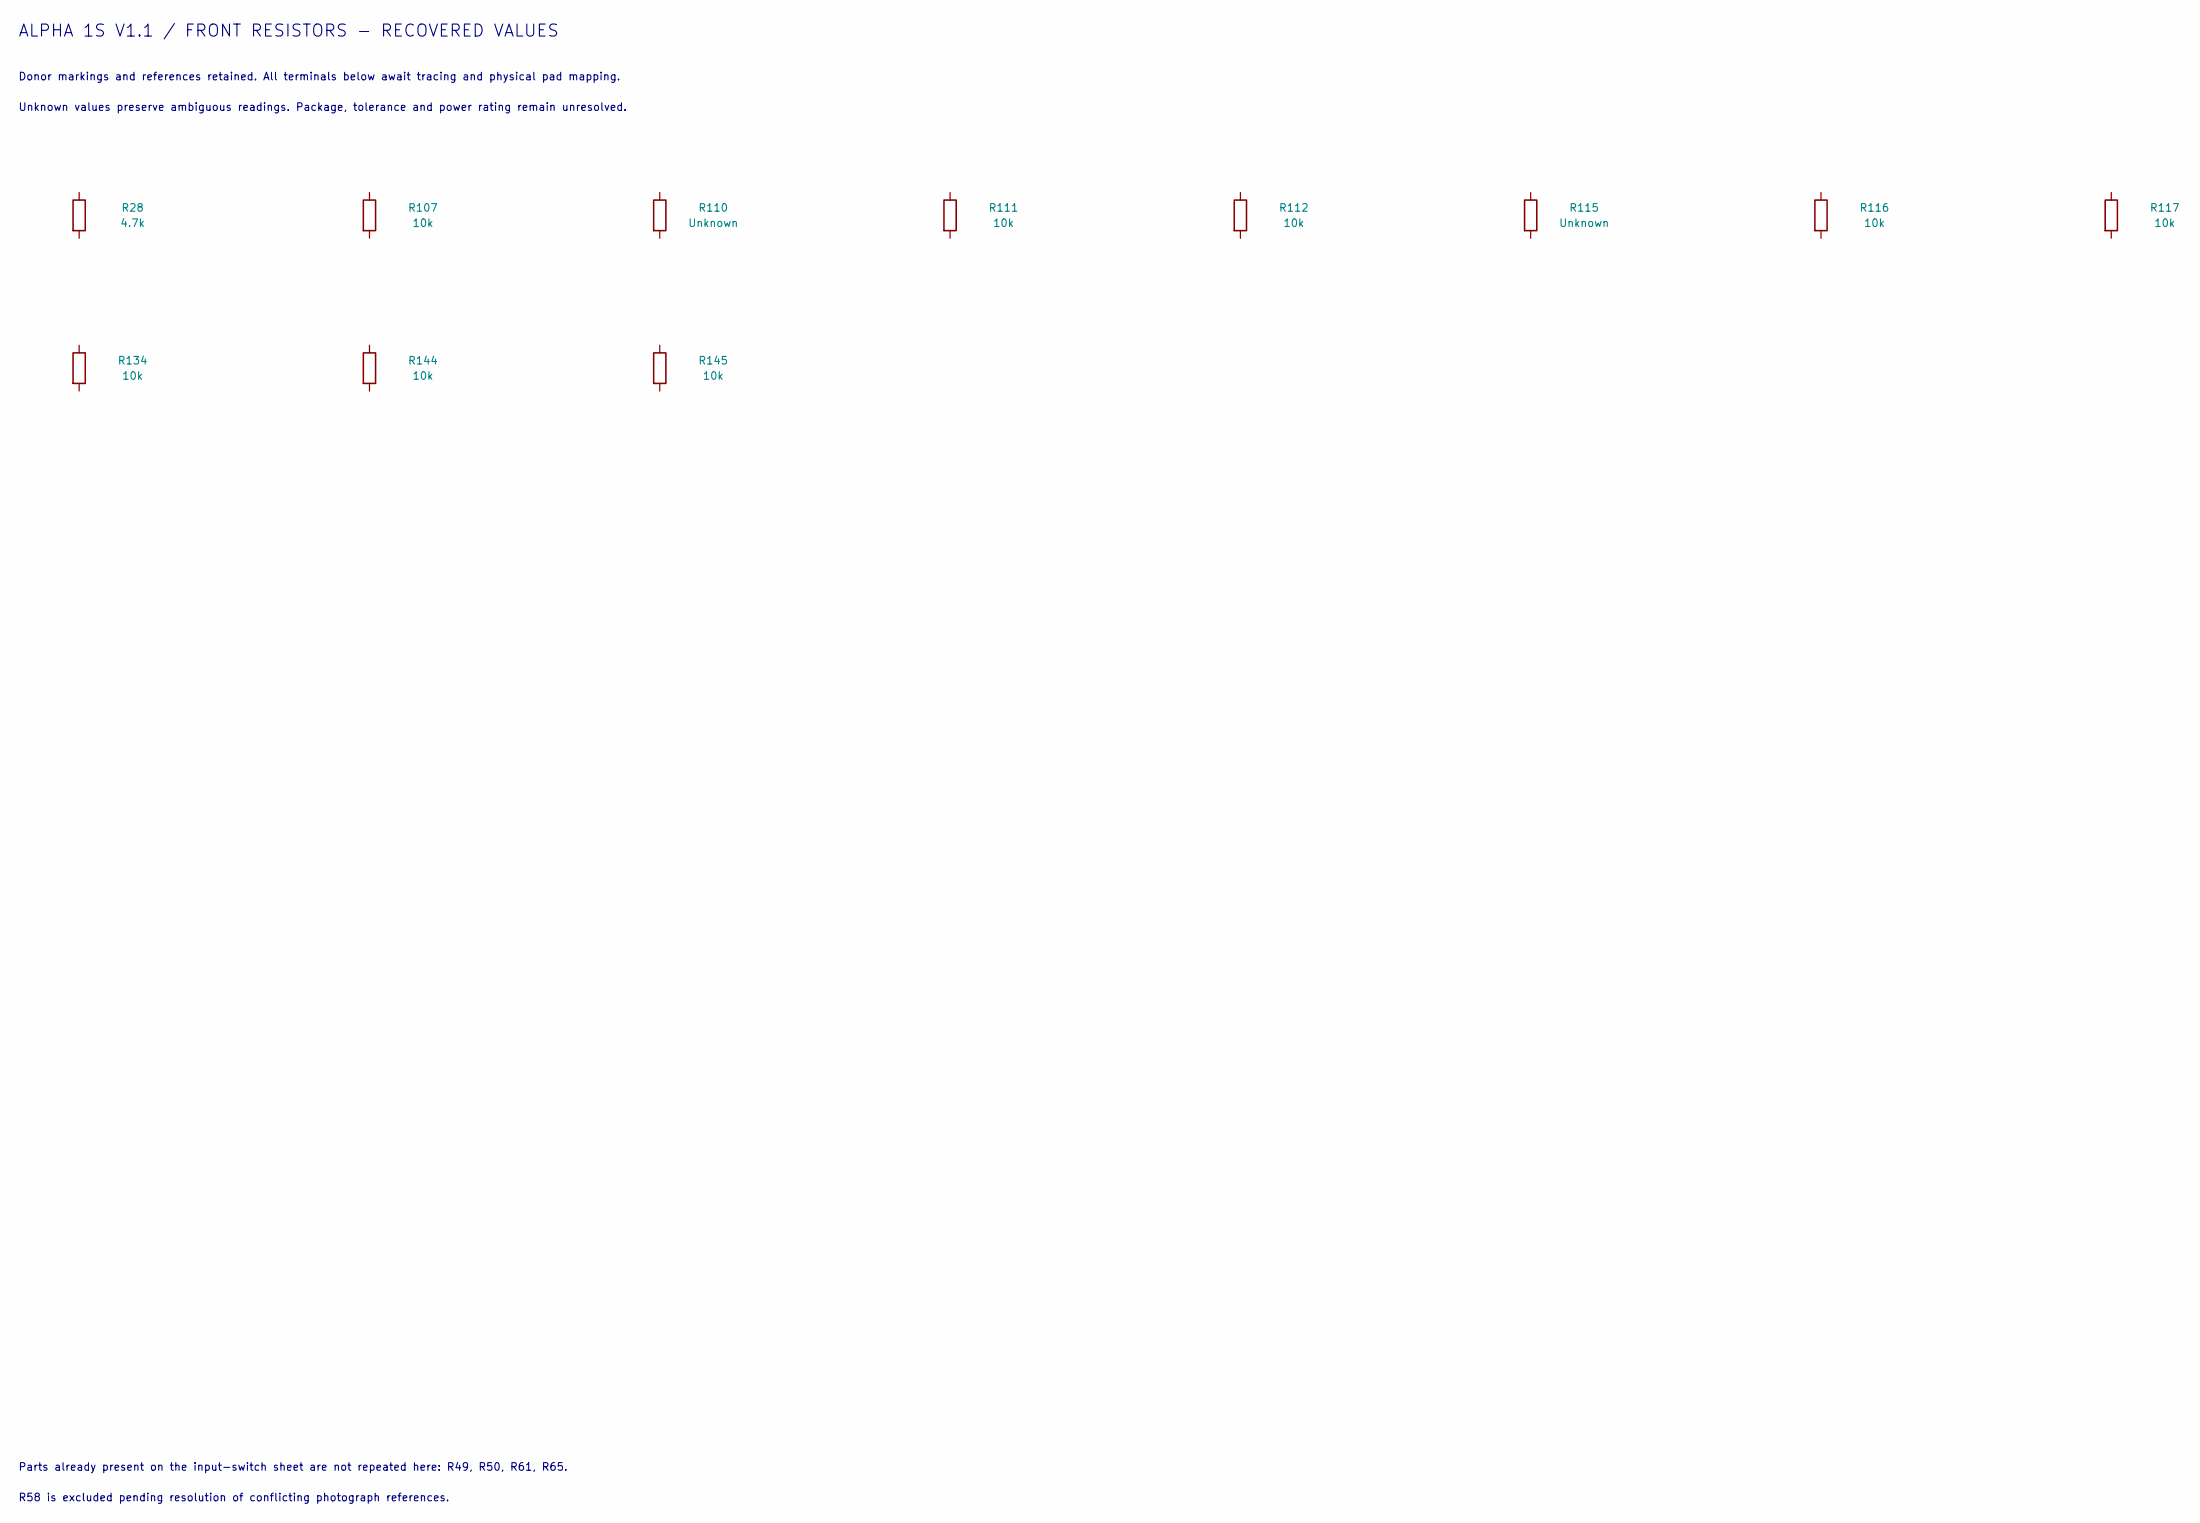
[picture p33: schematic recovered-resistors-front.kicad_sch]

Parts:
R28: 4.7k
R107, R111, R112, R116, R117, R134, R144, R145: 10k
R110, R115: Unknown

Notes on the sheet:
Parts already present on the input-switch sheet are not repeated here: R49, R50, R61, R65.
Unknown values preserve ambiguous readings. Package, tolerance and power rating remain unresolved.
Donor markings and references retained. All terminals below await tracing and physical pad mapping.
R58 is excluded pending resolution of conflicting photograph references.
ALPHA 1S V1.1 / FRONT RESISTORS - RECOVERED VALUES
