iimmyy/Little-Guy/hardware/little-guy-v2/pcb/foot/01-foot-interface.kicad_sch

## KiCad design hardware/little-guy-v2/pcb/foot/01-foot-interface.kicad_sch (2026-11-07)

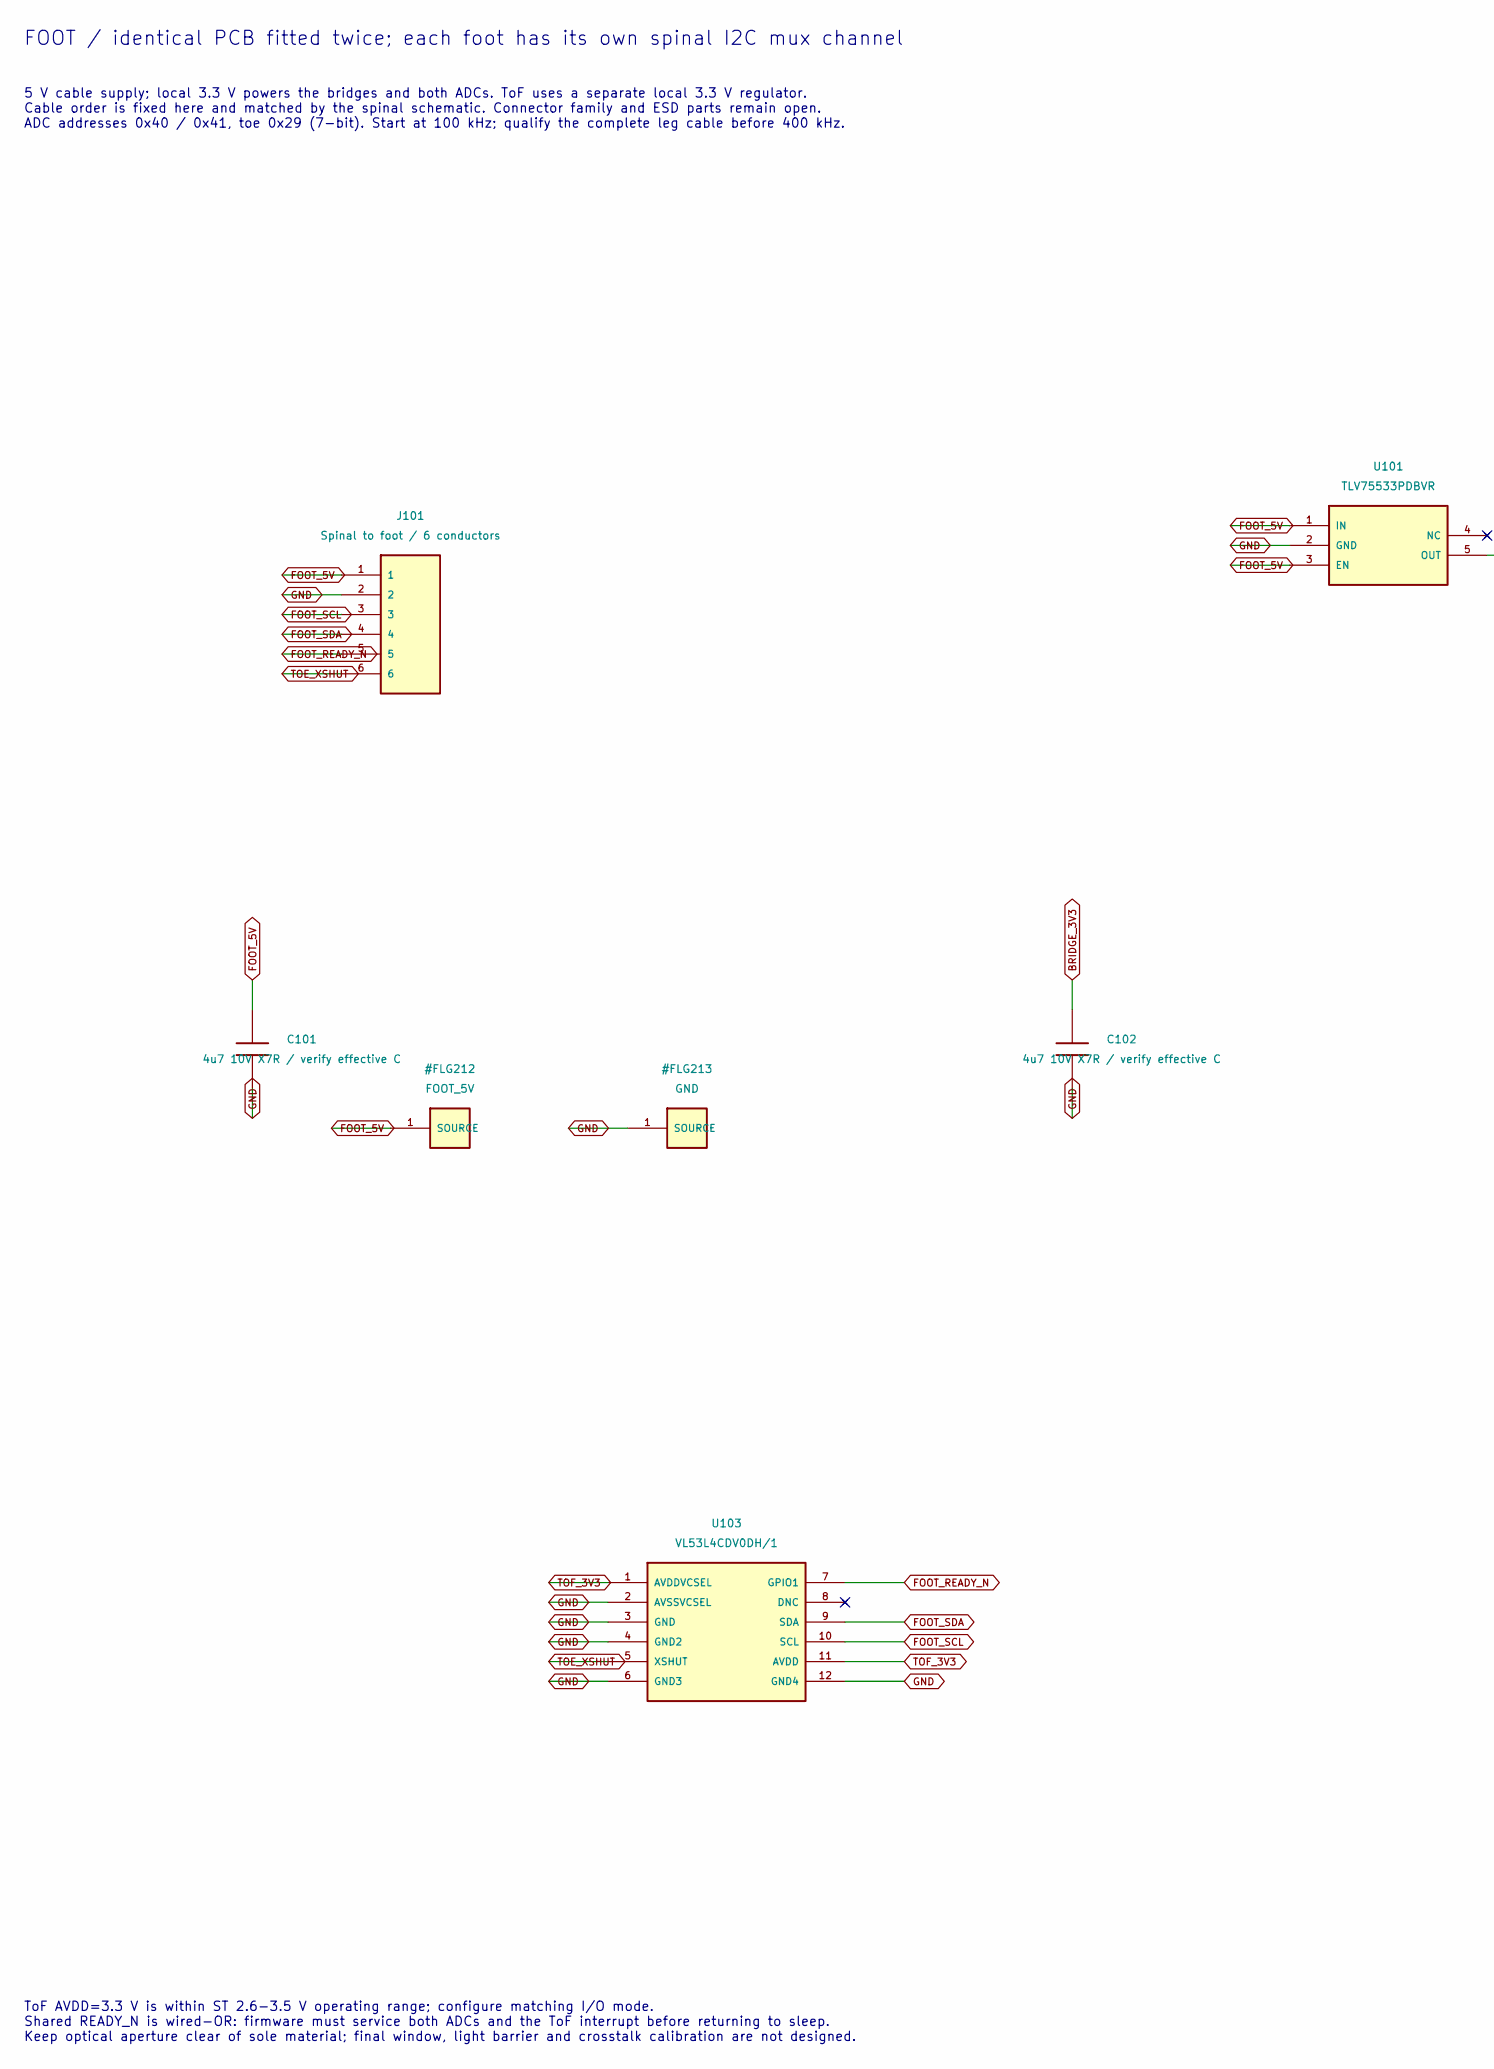
[picture p34: schematic 01-foot-interface.kicad_sch, part in row 1, column 1]

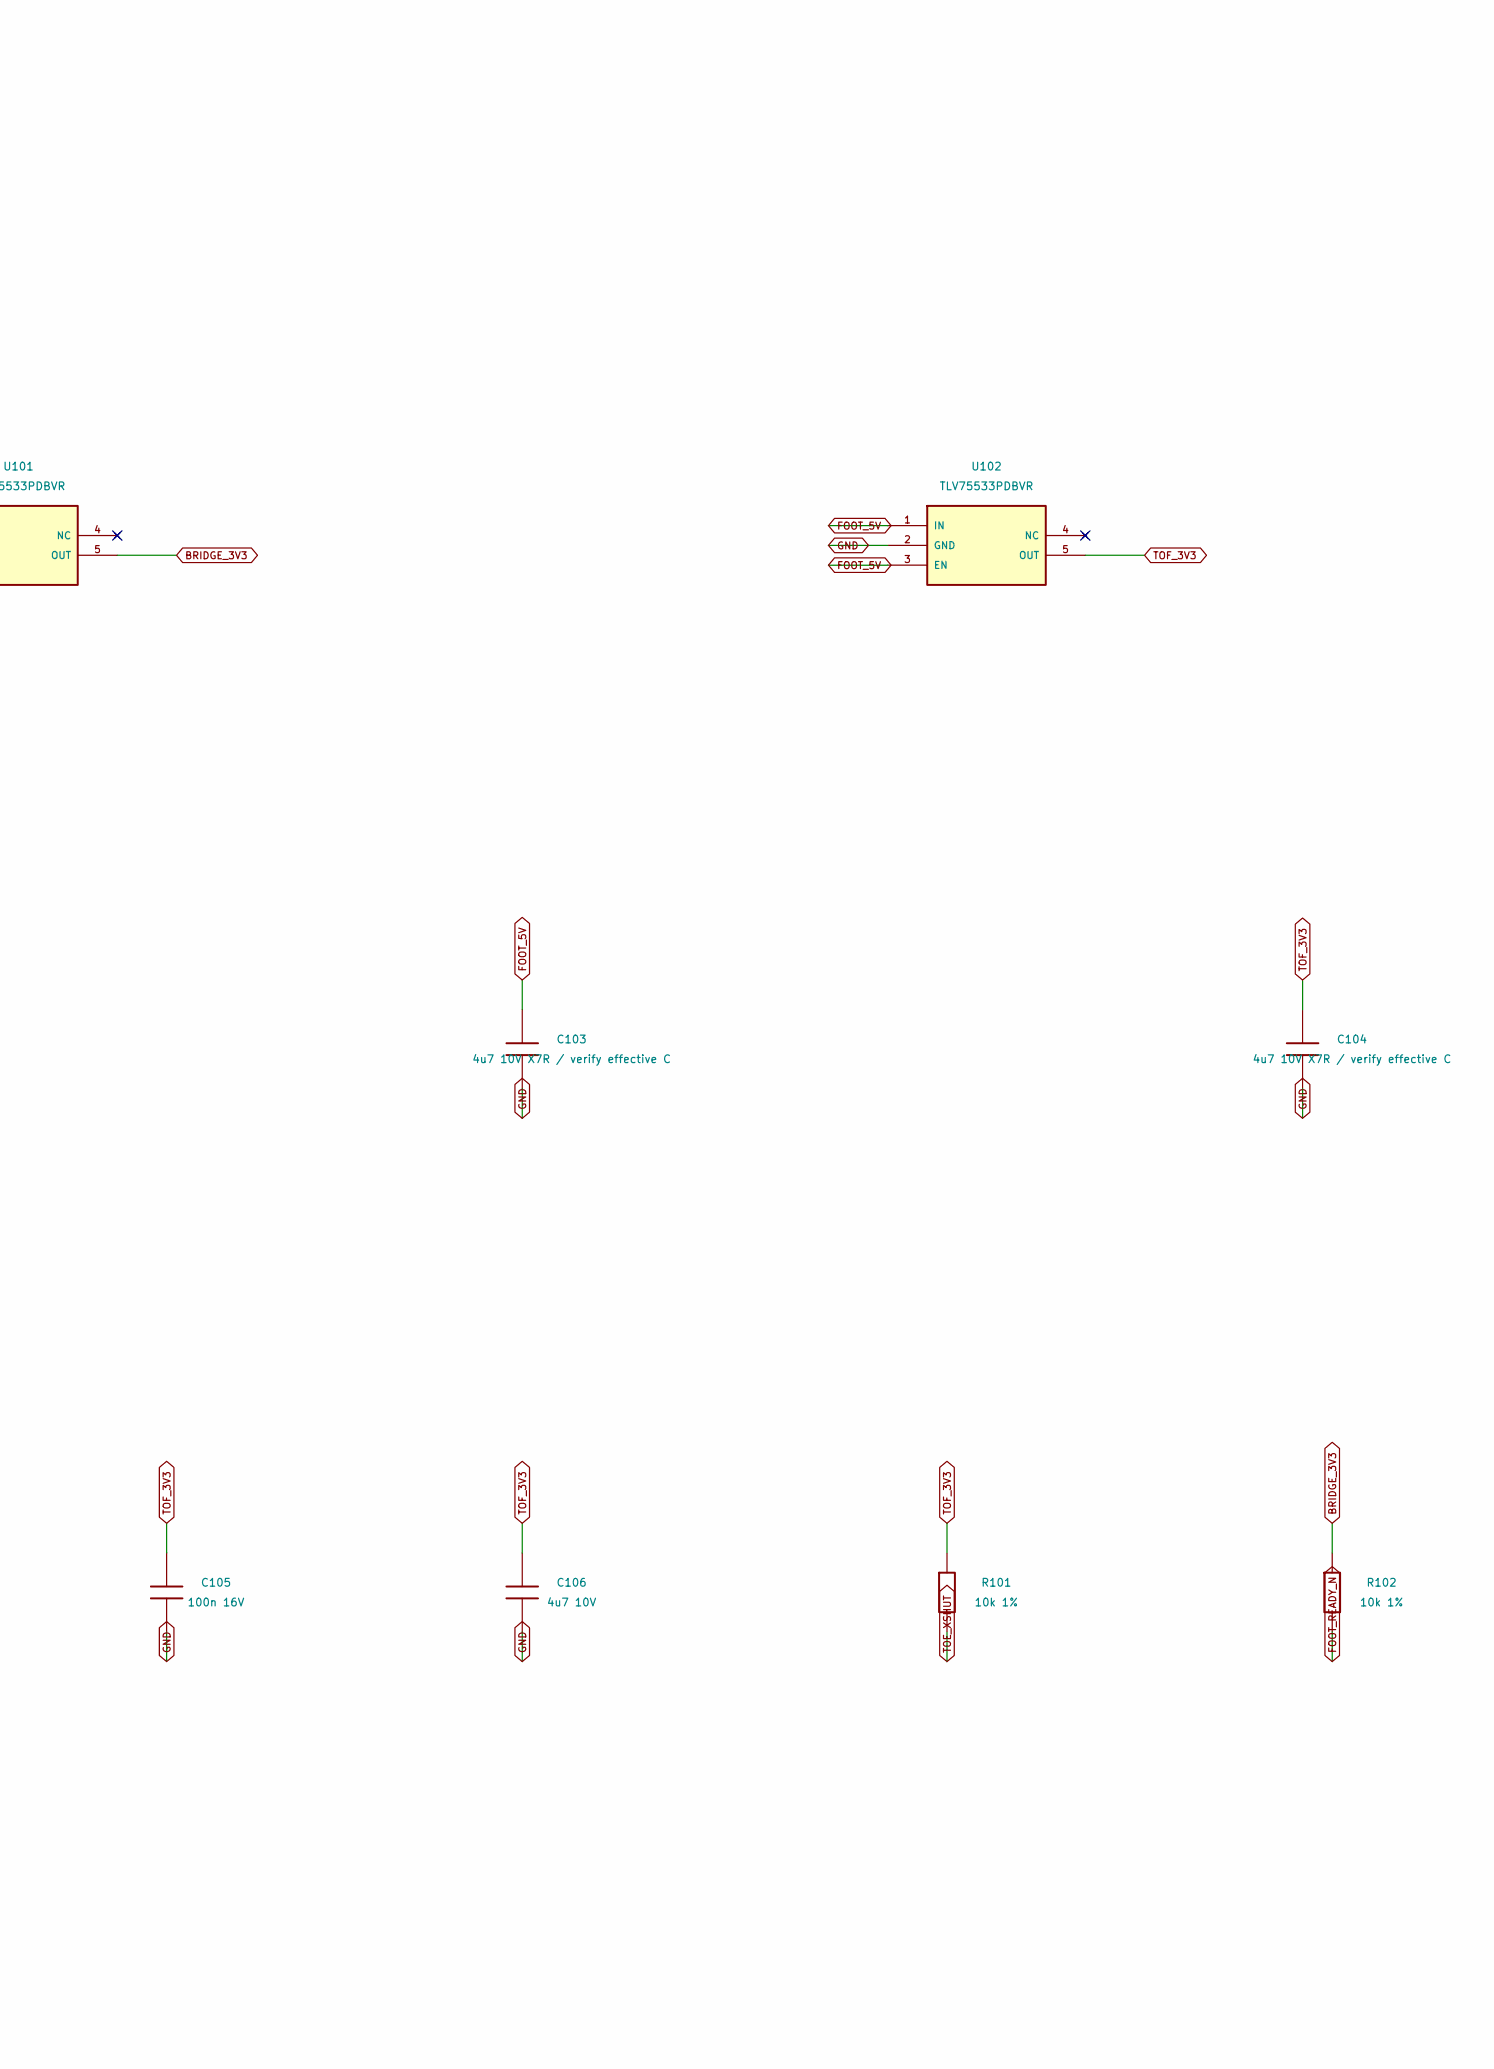
[picture p35: schematic 01-foot-interface.kicad_sch, part in row 1, column 2]

Parts:
C101, C102, C103, C104: 4u7 10V X7R / verify effective C; C_0603_1608Metric
C105: 100n 16V; C_0603_1608Metric
C106: 4u7 10V; C_0603_1608Metric
J101: Spinal to foot / 6 conductors
R101, R102: 10k 1%; R_0603_1608Metric
U101, U102: TLV75533PDBVR; SOT-23-5; MPN TLV75533PDBVR
U103: VL53L4CDV0DH/1; MPN VL53L4CDV0DH/1

Connections:
BRIDGE_3V3: C102.1, R102.1, U101.5 (OUT)
FOOT_5V: C101.1, C103.1, J101.1, U101.1 (IN), U101.3 (EN), U102.1 (IN), U102.3 (EN)
FOOT_READY_N: J101.5, R102.2, U103.7 (GPIO1)
FOOT_SCL: J101.3, U103.10 (SCL)
FOOT_SDA: J101.4, U103.9 (SDA)
GND: C101.2, C102.2, C103.2, C104.2, C105.2, C106.2, J101.2, U101.2 (GND), U102.2 (GND), U103.2 (AVSSVCSEL), U103.3 (GND), U103.4 (GND2), U103.6 (GND3), U103.12 (GND4)
TOE_XSHUT: J101.6, R101.2, U103.5 (XSHUT)
TOF_3V3: C104.1, C105.1, C106.1, R101.1, U102.5 (OUT), U103.1 (AVDDVCSEL), U103.11 (AVDD)

Notes on the sheet:
FOOT / identical PCB fitted twice; each foot has its own spinal I2C mux channel
5 V cable supply; local 3.3 V powers the bridges and both ADCs. ToF uses a separate local 3.3 V regulator. Cable order is fixed here and matched by the spinal schematic. Connector family and ESD parts remain open. ADC addresses 0x40 / 0x41, toe 0x29 (7-bit). Start at 100 kHz; qualify the complete l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
ToF AVDD=3.3 V is within ST 2.6-3.5 V operating range; configure matching I/O mode. Shared READY_N is wired-OR: firmware must service both ADCs and the ToF interrupt before returning to sleep. Keep optical aperture clear of sole material; final window, light barrier and crosstalk calibration are no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
