iimmyy/Little-Guy/hardware/little-guy-v2/pcb/foot/02-bridges-1.kicad_sch

## KiCad design hardware/little-guy-v2/pcb/foot/02-bridges-1.kicad_sch (2026-11-07)

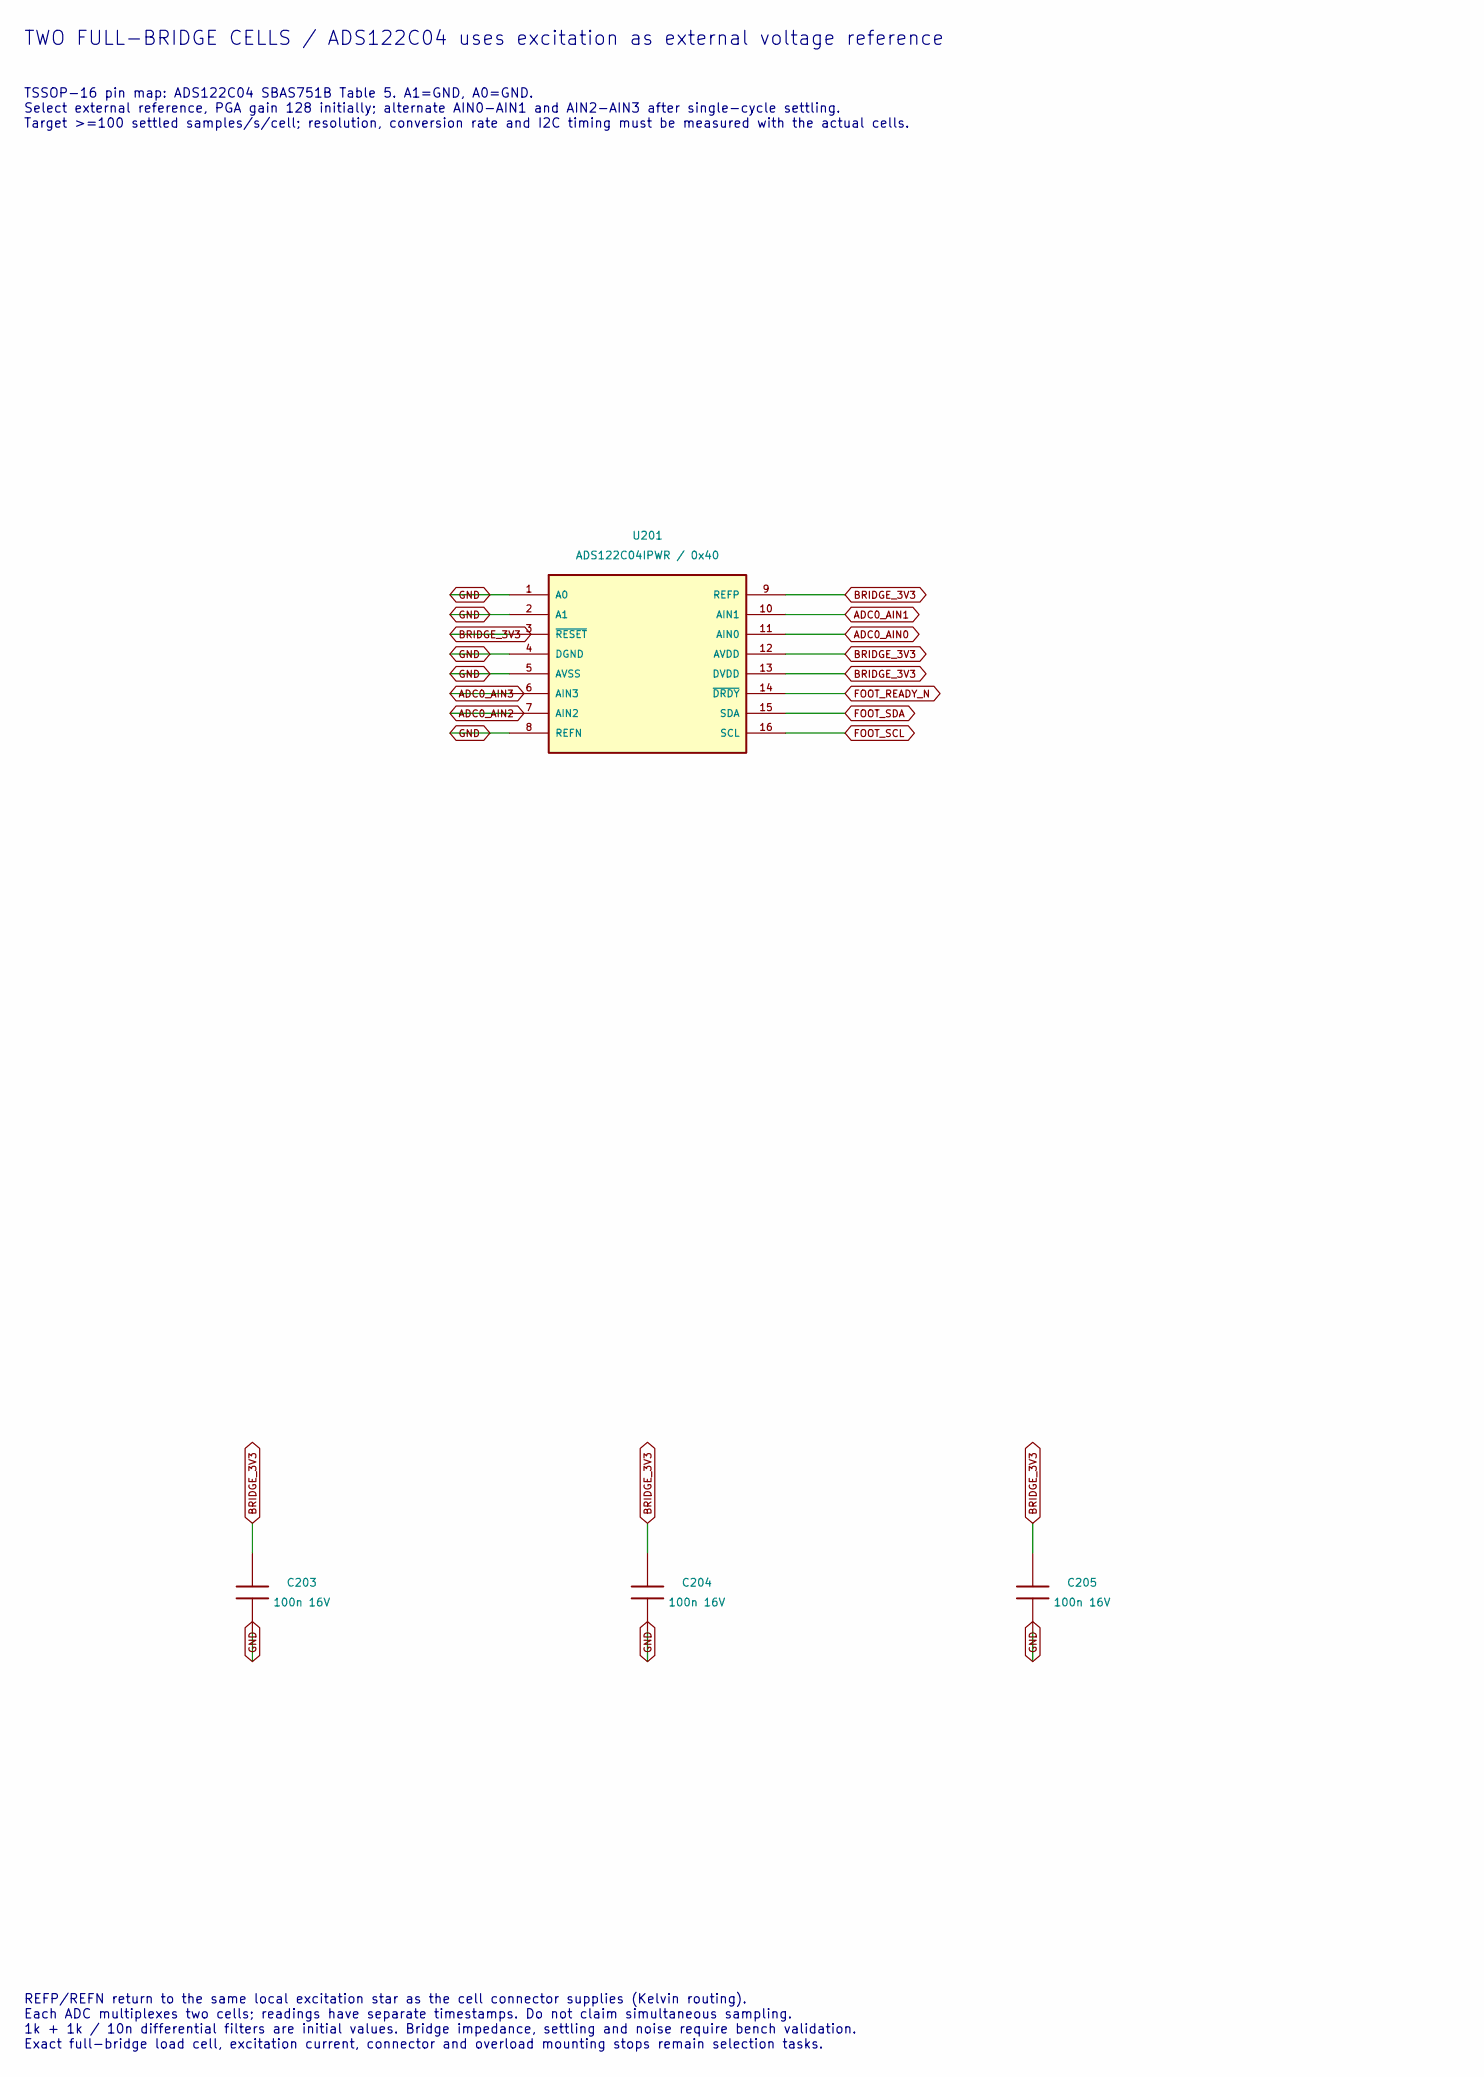
[picture p36: schematic 02-bridges-1.kicad_sch, part in row 1, column 1]

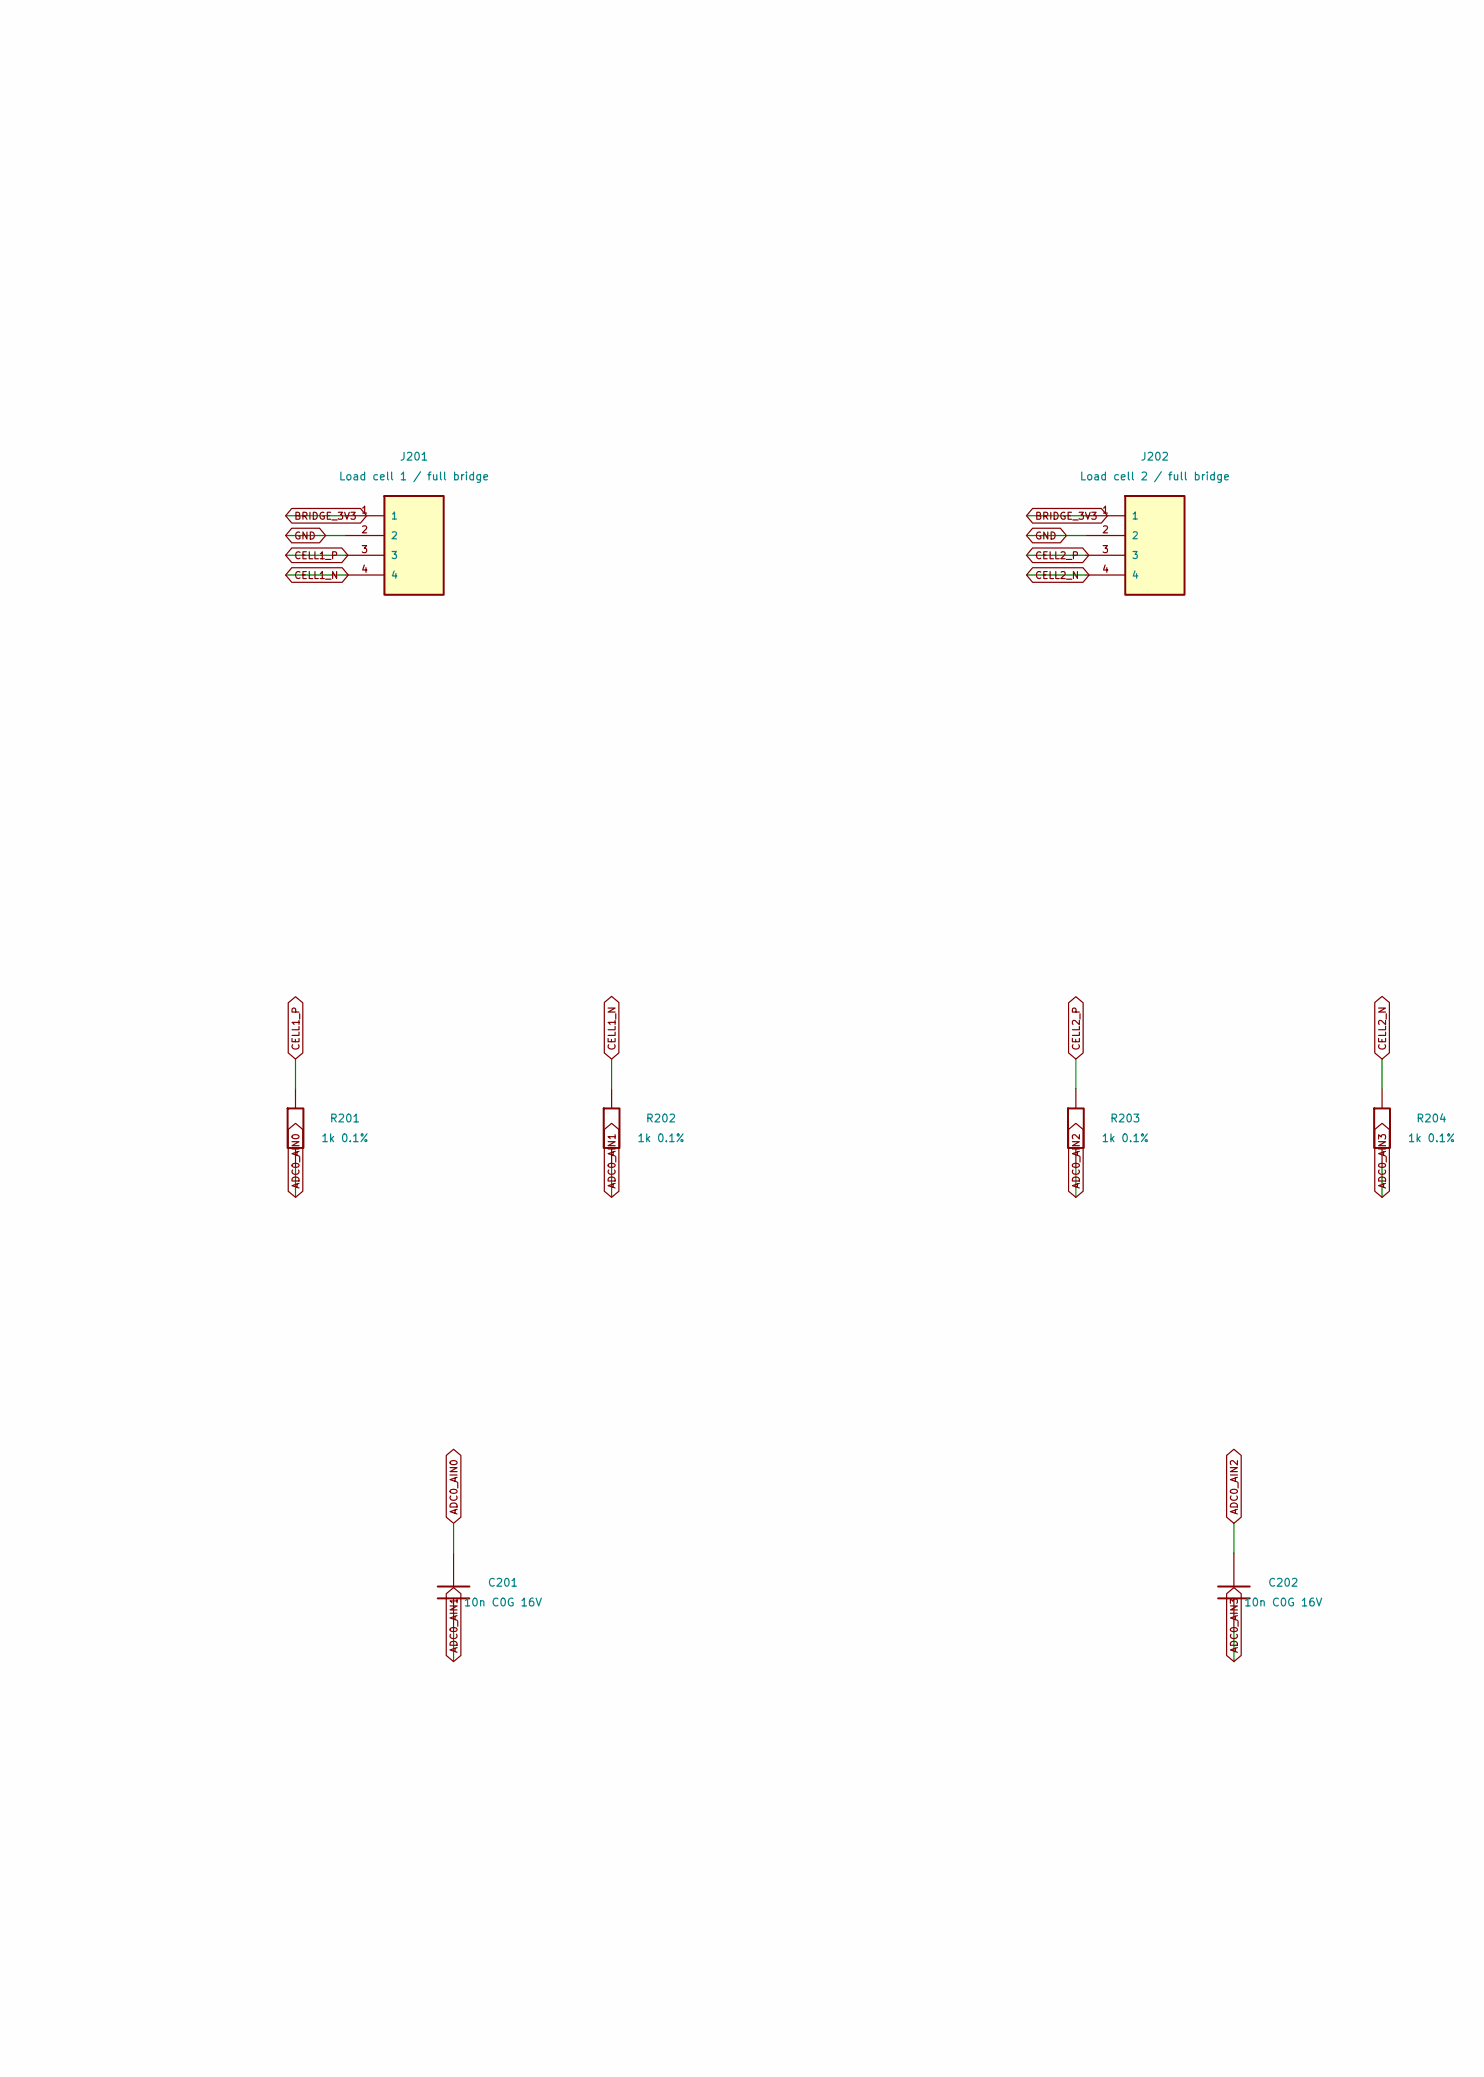
[picture p37: schematic 02-bridges-1.kicad_sch, part in row 1, column 2]

Parts:
C201, C202: 10n C0G 16V; C_0603_1608Metric
C203, C204, C205: 100n 16V; C_0603_1608Metric
J201: Load cell 1 / full bridge
J202: Load cell 2 / full bridge
R201, R202, R203, R204: 1k 0.1%; R_0603_1608Metric
U201: ADS122C04IPWR / 0x40; TSSOP-16_4.4x5mm_P0.65mm; MPN ADS122C04IPWR

Connections:
ADC0_AIN0: C201.1, R201.2, U201.11 (AIN0)
ADC0_AIN1: C201.2, R202.2, U201.10 (AIN1)
ADC0_AIN2: C202.1, R203.2, U201.7 (AIN2)
ADC0_AIN3: C202.2, R204.2, U201.6 (AIN3)
BRIDGE_3V3: C203.1, C204.1, C205.1, J201.1, J202.1, U201.3 (~RESET), U201.9 (REFP), U201.12 (AVDD), U201.13 (DVDD)
CELL1_N: J201.4, R202.1
CELL1_P: J201.3, R201.1
CELL2_N: J202.4, R204.1
CELL2_P: J202.3, R203.1
FOOT_READY_N: U201.14 (~DRDY)
FOOT_SCL: U201.16 (SCL)
FOOT_SDA: U201.15 (SDA)
GND: C203.2, C204.2, C205.2, J201.2, J202.2, U201.1 (A0), U201.2 (A1), U201.4 (DGND), U201.5 (AVSS), U201.8 (REFN)

Notes on the sheet:
TWO FULL-BRIDGE CELLS / ADS122C04 uses excitation as external voltage reference
TSSOP-16 pin map: ADS122C04 SBAS751B Table 5. A1=GND, A0=GND. Select external reference, PGA gain 128 initially; alternate AIN0-AIN1 and AIN2-AIN3 after single-cycle settling. Target >=100 settled samples/s/cell; resolution, conversion rate and I2C timing must be measured with the actual cells.
REFP/REFN return to the same local excitation star as the cell connector supplies (Kelvin routing). Each ADC multiplexes two cells; readings have separate timestamps. Do not claim simultaneous sampling. 1k + 1k / 10n differential filters are initial values. Bridge impedance, settling and noise requ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
