iimmyy/Little-Guy/hardware/little-guy-v2/pcb/foot/03-bridges-2.kicad_sch

## KiCad design hardware/little-guy-v2/pcb/foot/03-bridges-2.kicad_sch (2026-11-07)

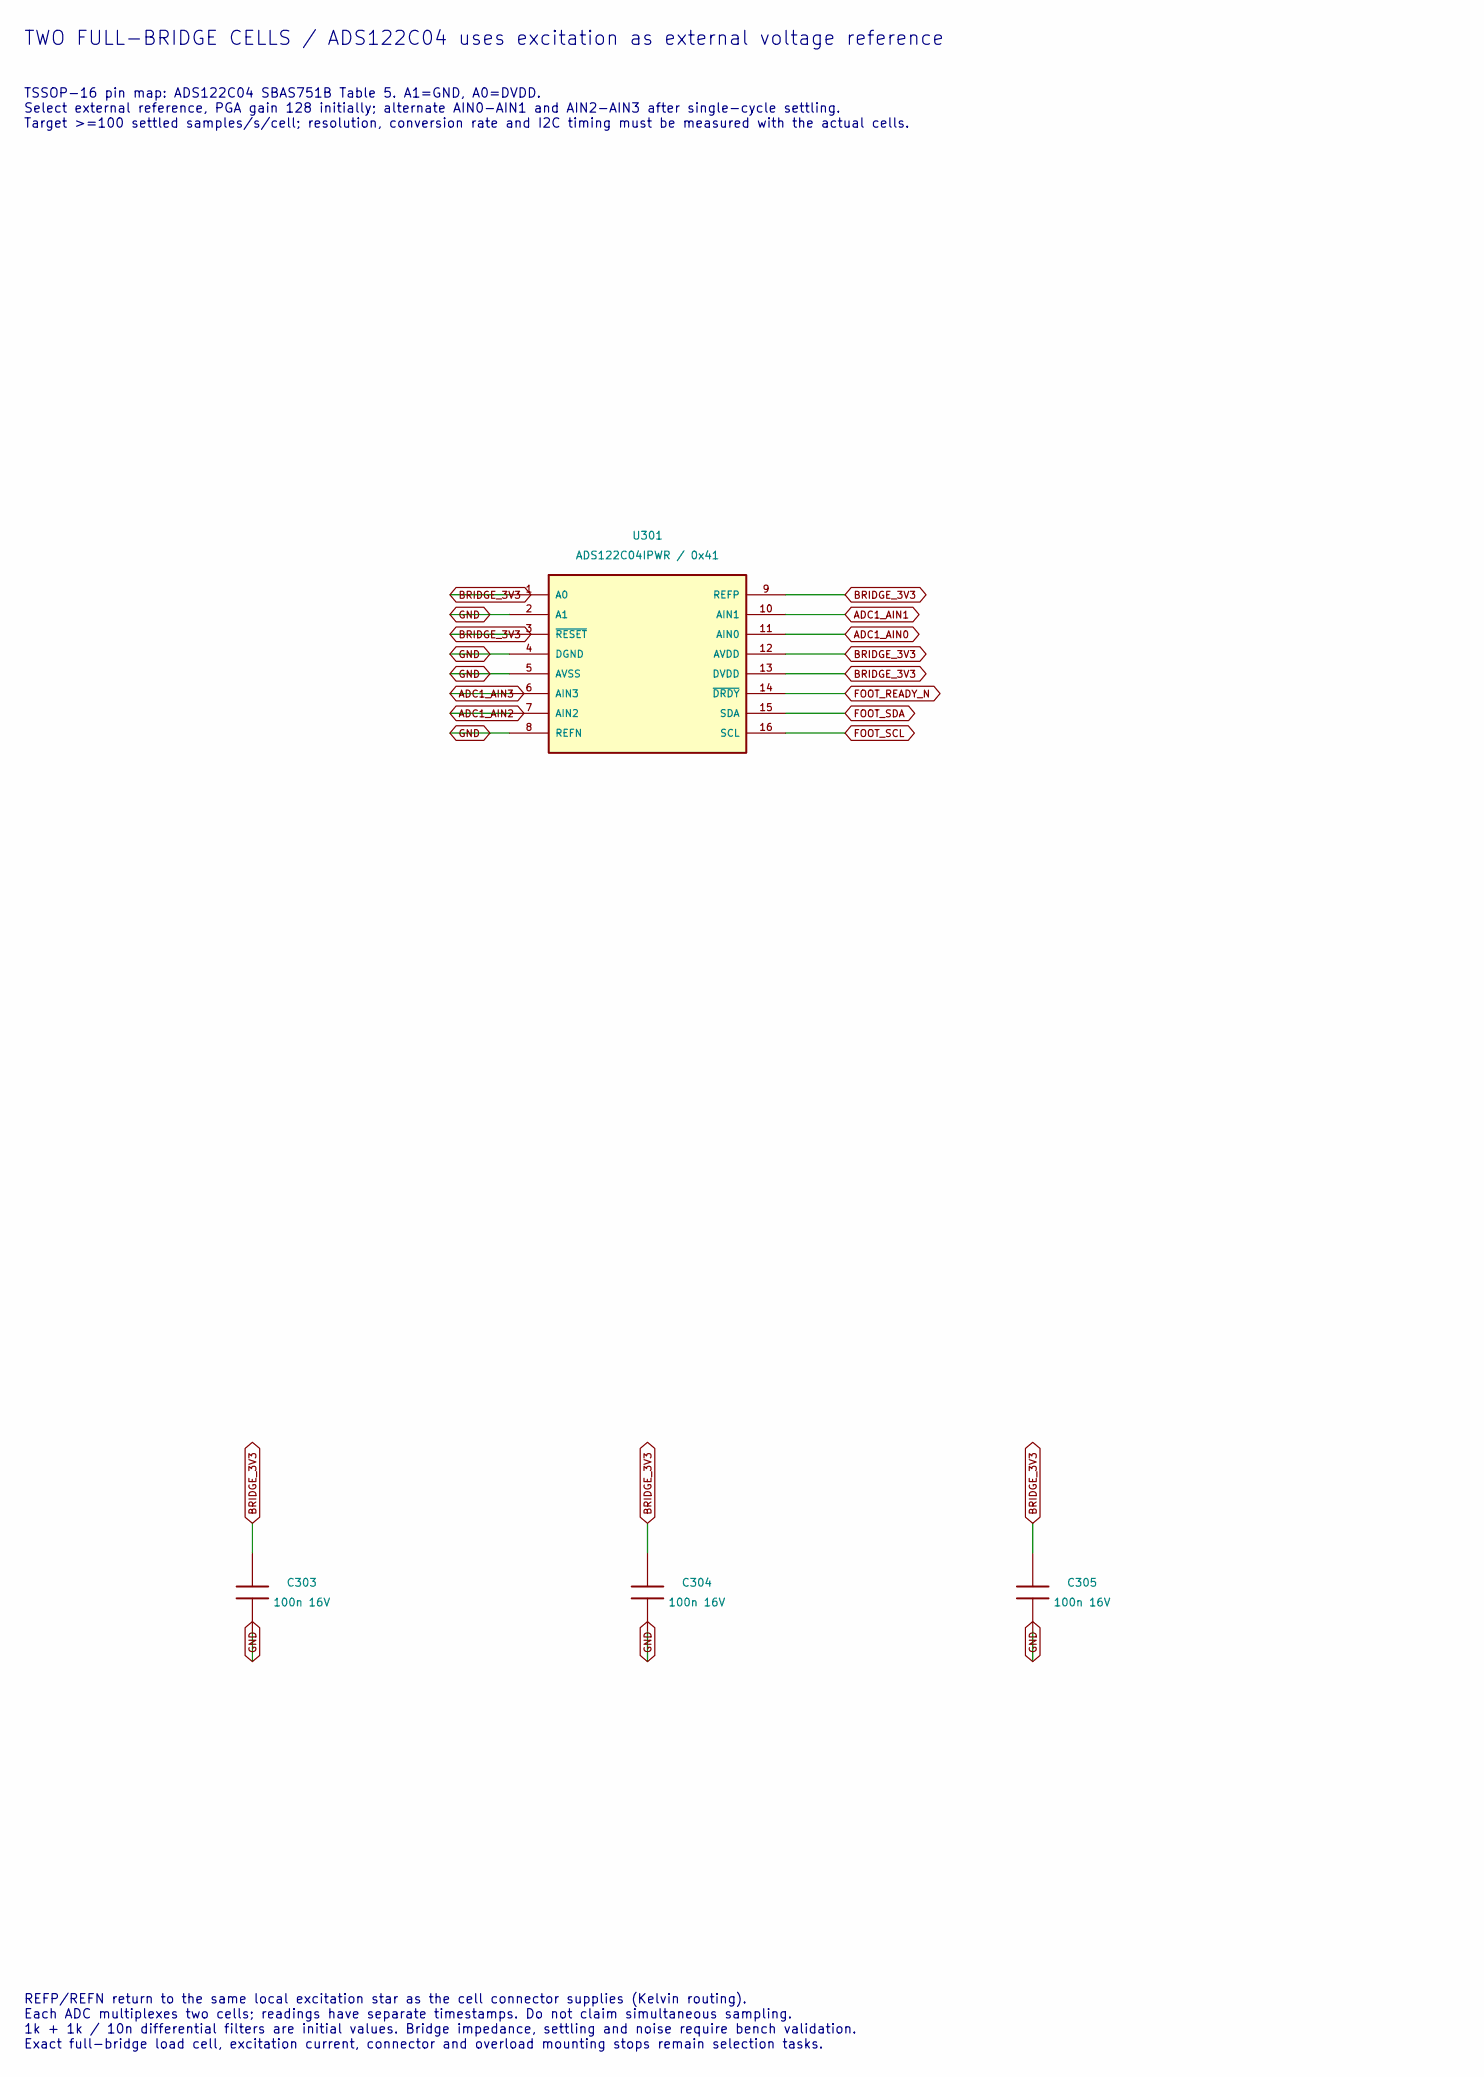
[picture p38: schematic 03-bridges-2.kicad_sch, part in row 1, column 1]

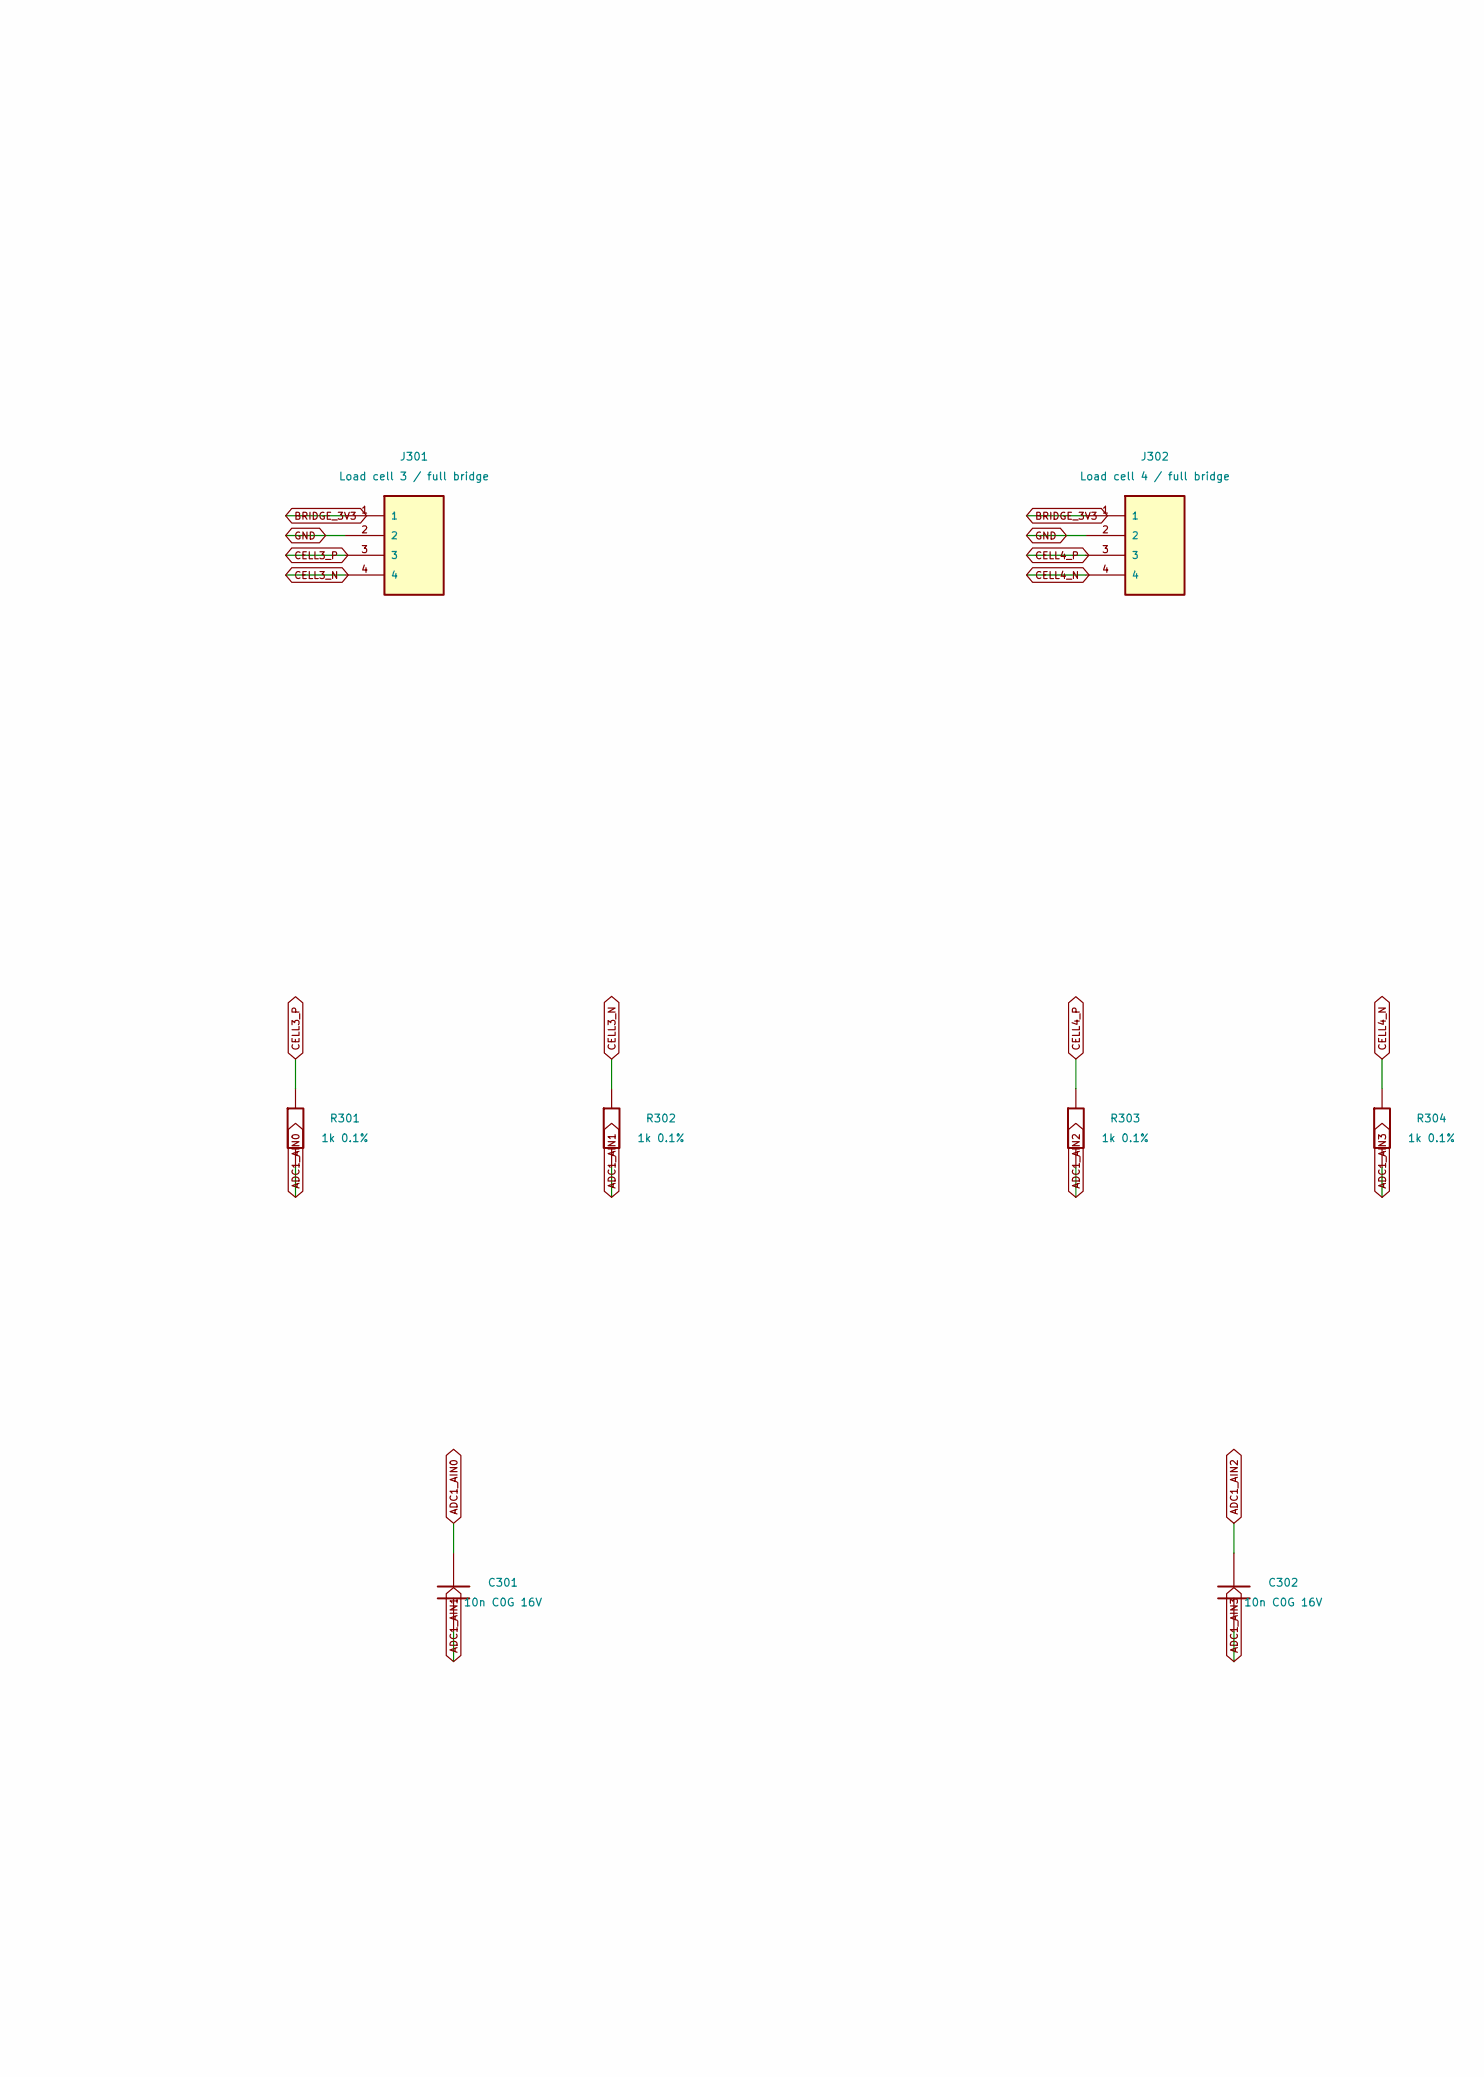
[picture p39: schematic 03-bridges-2.kicad_sch, part in row 1, column 2]

Parts:
C301, C302: 10n C0G 16V; C_0603_1608Metric
C303, C304, C305: 100n 16V; C_0603_1608Metric
J301: Load cell 3 / full bridge
J302: Load cell 4 / full bridge
R301, R302, R303, R304: 1k 0.1%; R_0603_1608Metric
U301: ADS122C04IPWR / 0x41; TSSOP-16_4.4x5mm_P0.65mm; MPN ADS122C04IPWR

Connections:
ADC1_AIN0: C301.1, R301.2, U301.11 (AIN0)
ADC1_AIN1: C301.2, R302.2, U301.10 (AIN1)
ADC1_AIN2: C302.1, R303.2, U301.7 (AIN2)
ADC1_AIN3: C302.2, R304.2, U301.6 (AIN3)
BRIDGE_3V3: C303.1, C304.1, C305.1, J301.1, J302.1, U301.1 (A0), U301.3 (~RESET), U301.9 (REFP), U301.12 (AVDD), U301.13 (DVDD)
CELL3_N: J301.4, R302.1
CELL3_P: J301.3, R301.1
CELL4_N: J302.4, R304.1
CELL4_P: J302.3, R303.1
FOOT_READY_N: U301.14 (~DRDY)
FOOT_SCL: U301.16 (SCL)
FOOT_SDA: U301.15 (SDA)
GND: C303.2, C304.2, C305.2, J301.2, J302.2, U301.2 (A1), U301.4 (DGND), U301.5 (AVSS), U301.8 (REFN)

Notes on the sheet:
TWO FULL-BRIDGE CELLS / ADS122C04 uses excitation as external voltage reference
TSSOP-16 pin map: ADS122C04 SBAS751B Table 5. A1=GND, A0=DVDD. Select external reference, PGA gain 128 initially; alternate AIN0-AIN1 and AIN2-AIN3 after single-cycle settling. Target >=100 settled samples/s/cell; resolution, conversion rate and I2C timing must be measured with the actual cells.
REFP/REFN return to the same local excitation star as the cell connector supplies (Kelvin routing). Each ADC multiplexes two cells; readings have separate timestamps. Do not claim simultaneous sampling. 1k + 1k / 10n differential filters are initial values. Bridge impedance, settling and noise requ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
