iimmyy/Little-Guy/hardware/little-guy-v2/pcb/head/01-voice-processor.kicad_sch

## KiCad design hardware/little-guy-v2/pcb/head/01-voice-processor.kicad_sch (2026-11-07)

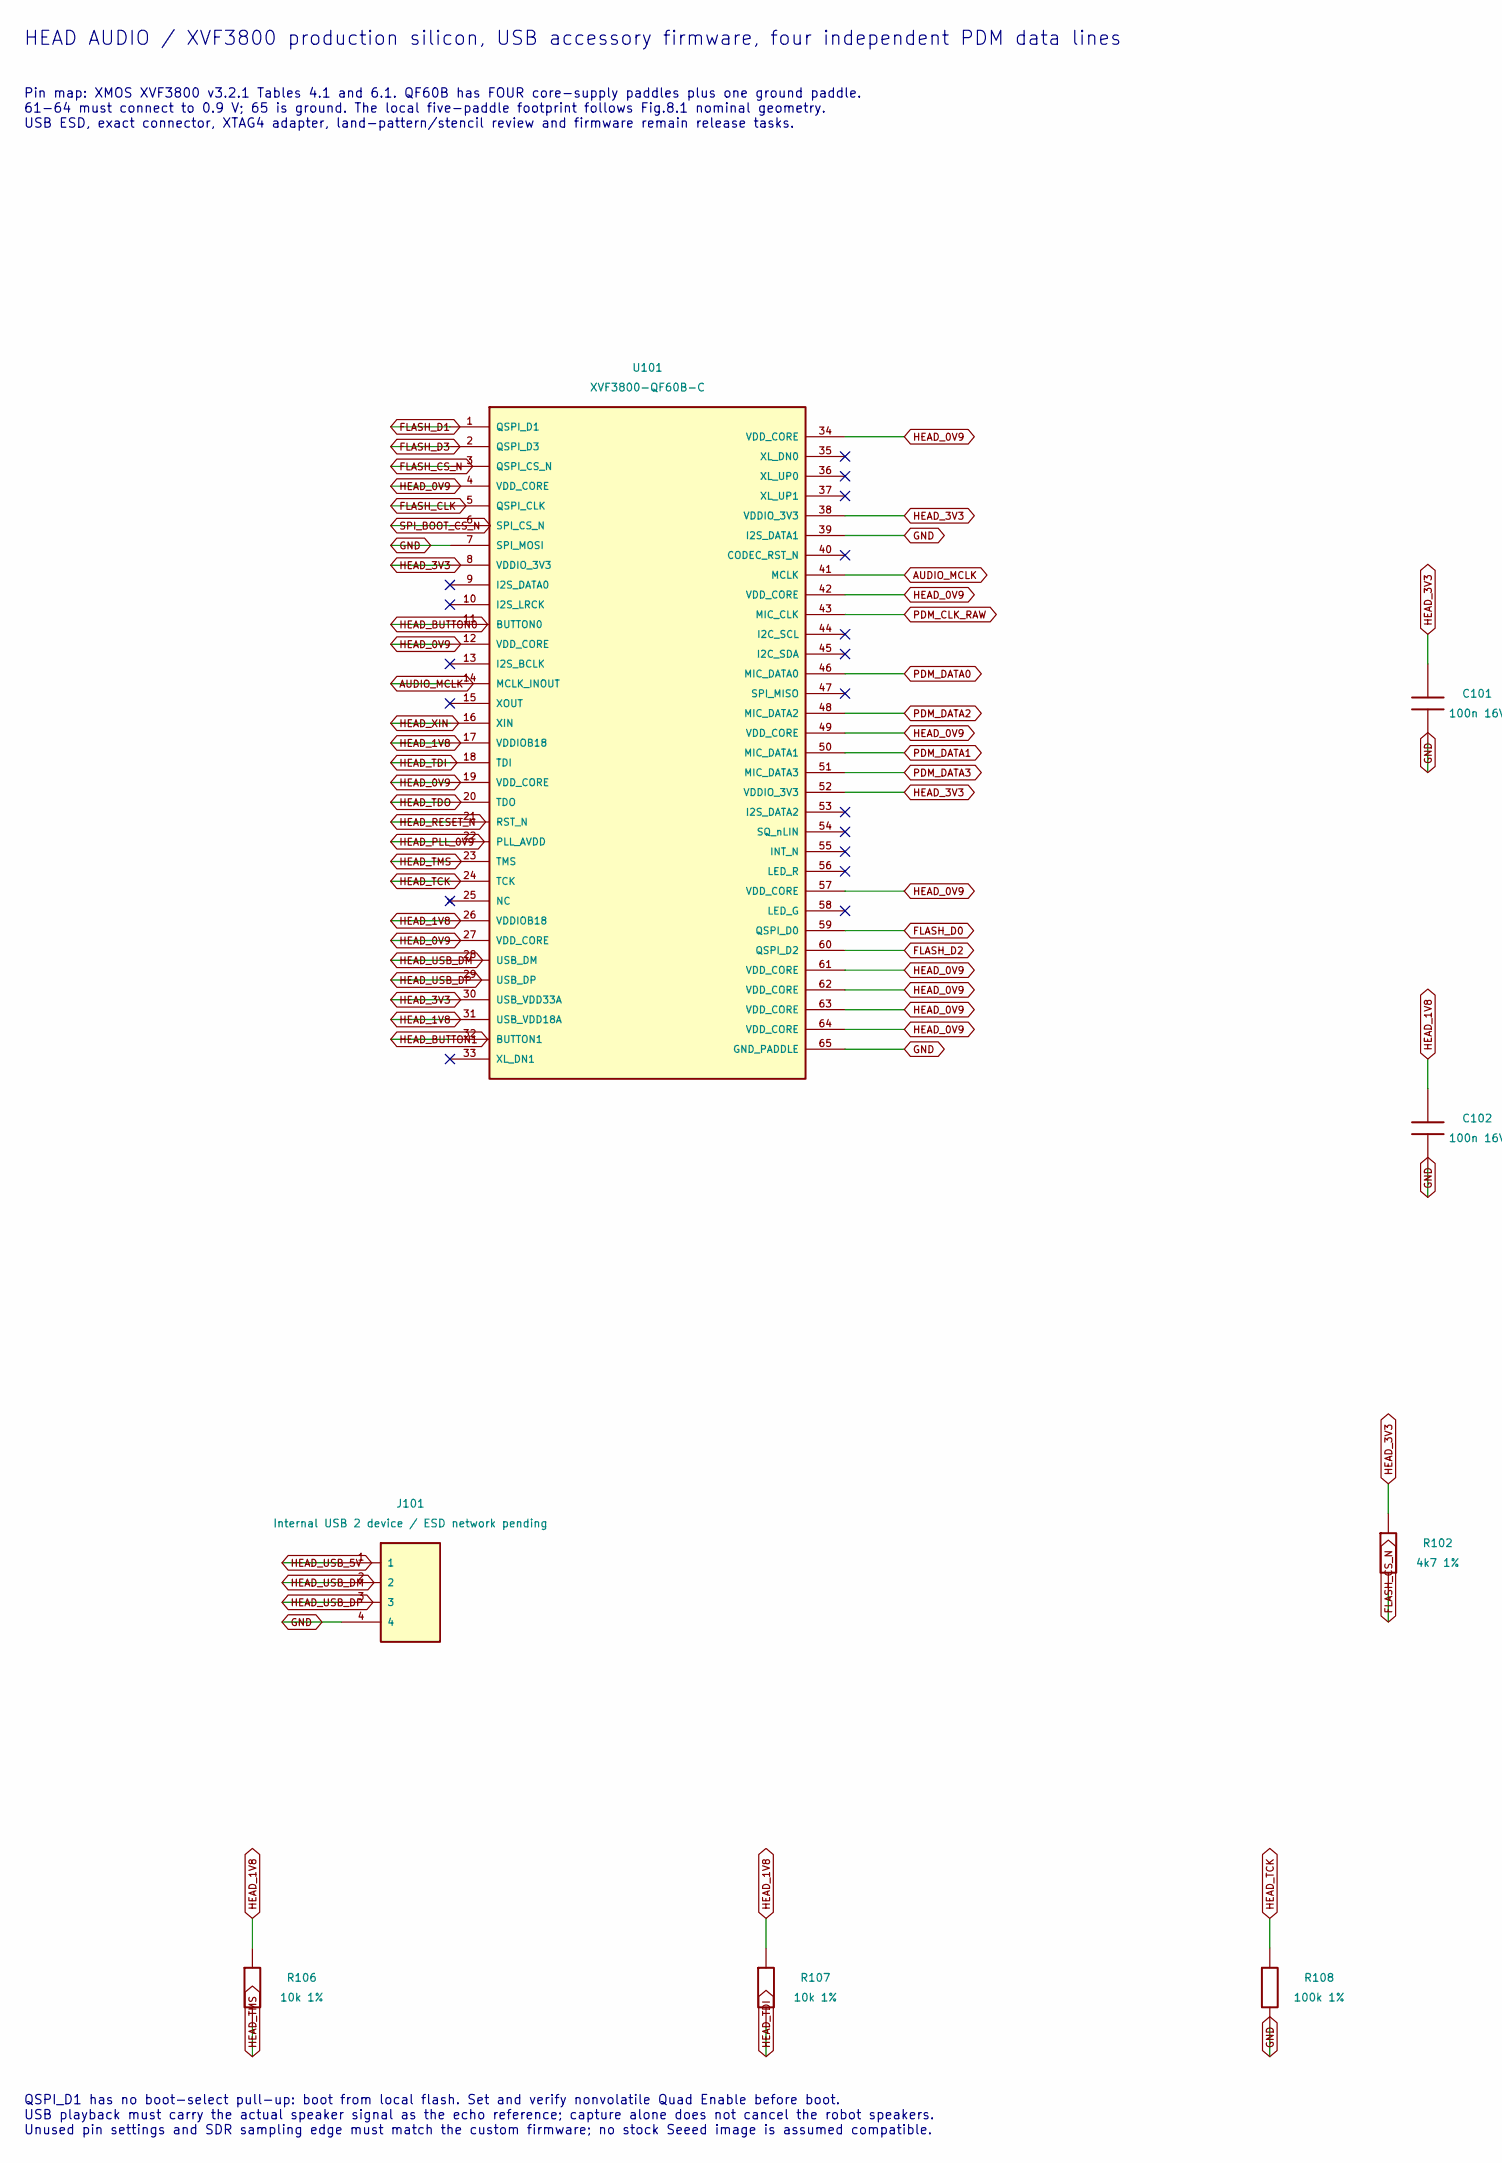
[picture p40: schematic 01-voice-processor.kicad_sch, part in row 1, column 1]

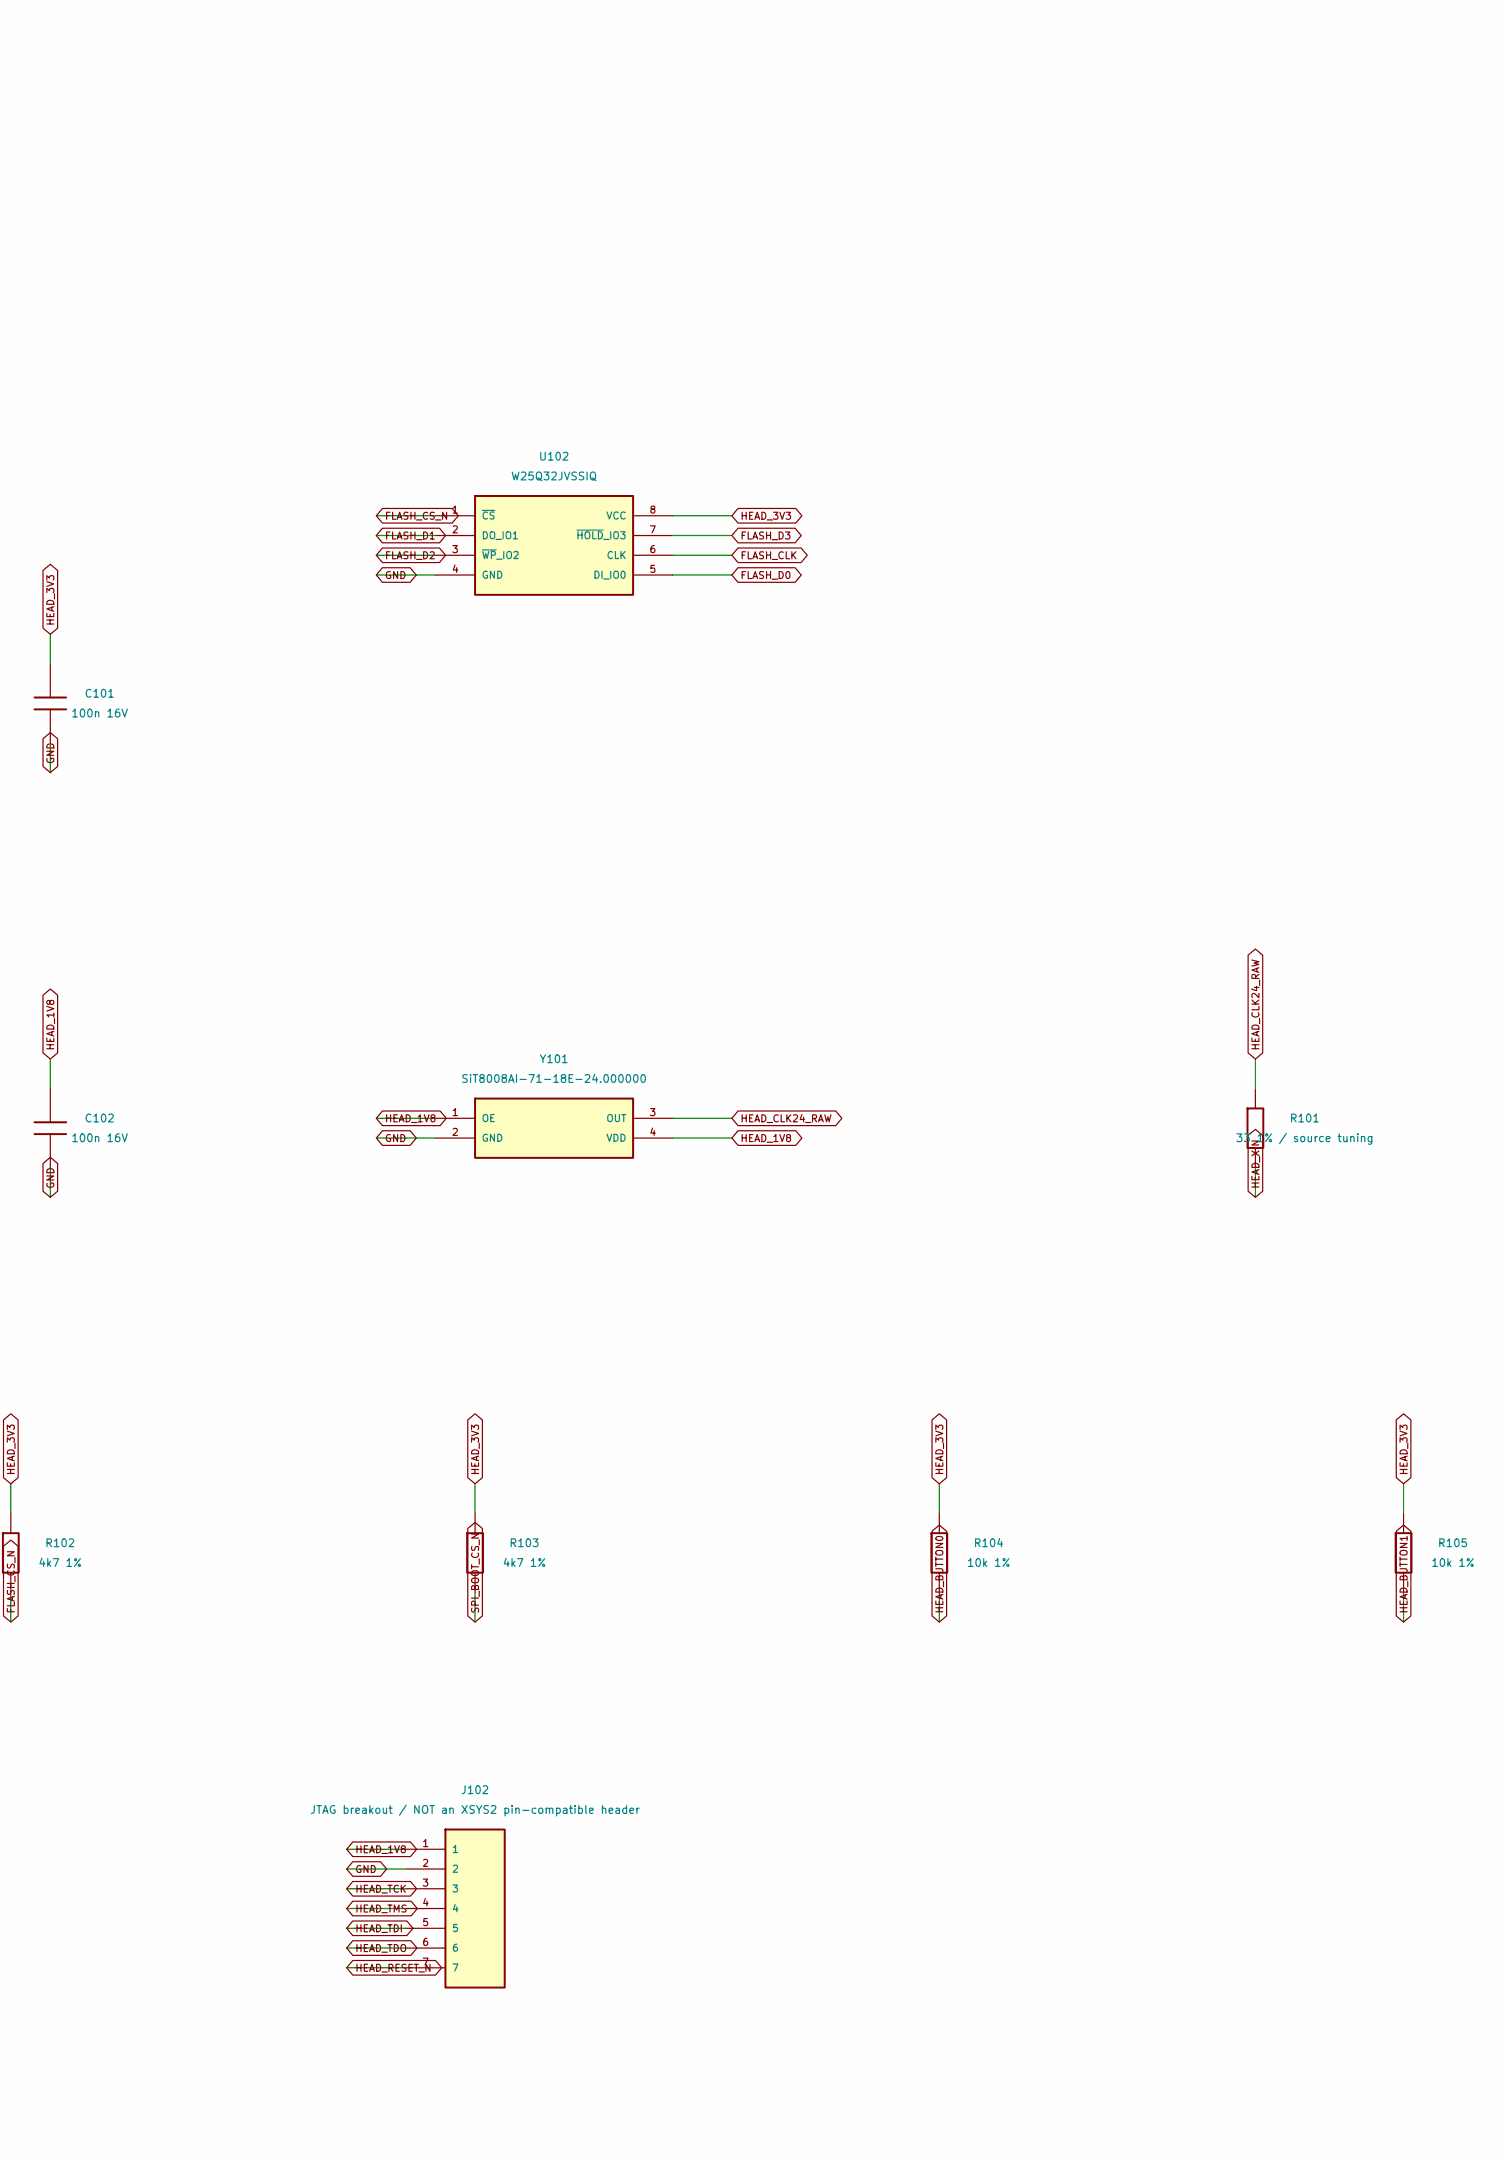
[picture p41: schematic 01-voice-processor.kicad_sch, part in row 1, column 2]

Parts:
C101, C102: 100n 16V; C_0603_1608Metric
J101: Internal USB 2 device / ESD network pending
J102: JTAG breakout / NOT an XSYS2 pin-compatible header
R101: 33 1% / source tuning; R_0603_1608Metric
R102, R103: 4k7 1%; R_0603_1608Metric
R104, R105, R106, R107: 10k 1%; R_0603_1608Metric
R108: 100k 1%; R_0603_1608Metric
U101: XVF3800-QF60B-C; XMOS_QF60B_7x7mm_P0.4mm_5Paddle; MPN XVF3800-QF60B-C
U102: W25Q32JVSSIQ; SOIC-8_5.3x5.3mm_P1.27mm; MPN W25Q32JVSSIQ
Y101: SiT8008AI-71-18E-24.000000; MPN SiT8008AI-71-18E-24.000000

Connections:
AUDIO_MCLK: U101.14 (MCLK_INOUT), U101.41 (MCLK)
FLASH_CLK: U101.5 (QSPI_CLK), U102.6 (CLK)
FLASH_CS_N: R102.2, U101.3 (QSPI_CS_N), U102.1 (~CS)
FLASH_D0: U101.59 (QSPI_D0), U102.5 (DI_IO0)
FLASH_D1: U101.1 (QSPI_D1), U102.2 (DO_IO1)
FLASH_D2: U101.60 (QSPI_D2), U102.3 (~WP_IO2)
FLASH_D3: U101.2 (QSPI_D3), U102.7 (~HOLD_IO3)
GND: C101.2, C102.2, J101.4, J102.2, R108.2, U101.7 (SPI_MOSI), U101.39 (I2S_DATA1), U101.65 (GND_PADDLE), U102.4 (GND), Y101.2 (GND)
HEAD_0V9: U101.4 (VDD_CORE), U101.12 (VDD_CORE), U101.19 (VDD_CORE), U101.27 (VDD_CORE), U101.34 (VDD_CORE), U101.42 (VDD_CORE), U101.49 (VDD_CORE), U101.57 (VDD_CORE), U101.61 (VDD_CORE), U101.62 (VDD_CORE), U101.63 (VDD_CORE), U101.64 (VDD_CORE)
HEAD_1V8: C102.1, J102.1, R106.1, R107.1, U101.17 (VDDIOB18), U101.26 (VDDIOB18), U101.31 (USB_VDD18A), Y101.1 (OE), Y101.4 (VDD)
HEAD_3V3: C101.1, R102.1, R103.1, R104.1, R105.1, U101.8 (VDDIO_3V3), U101.30 (USB_VDD33A), U101.38 (VDDIO_3V3), U101.52 (VDDIO_3V3), U102.8 (VCC)
HEAD_BUTTON0: R104.2, U101.11 (BUTTON0)
HEAD_BUTTON1: R105.2, U101.32 (BUTTON1)
HEAD_CLK24_RAW: R101.1, Y101.3 (OUT)
HEAD_PLL_0V9: U101.22 (PLL_AVDD)
HEAD_RESET_N: J102.7, U101.21 (RST_N)
HEAD_TCK: J102.3, R108.1, U101.24 (TCK)
HEAD_TDI: J102.5, R107.2, U101.18 (TDI)
HEAD_TDO: J102.6, U101.20 (TDO)
HEAD_TMS: J102.4, R106.2, U101.23 (TMS)
HEAD_USB_5V: J101.1
HEAD_USB_DM: J101.2, U101.28 (USB_DM)
HEAD_USB_DP: J101.3, U101.29 (USB_DP)
HEAD_XIN: R101.2, U101.16 (XIN)
PDM_CLK_RAW: U101.43 (MIC_CLK)
PDM_DATA0: U101.46 (MIC_DATA0)
PDM_DATA1: U101.50 (MIC_DATA1)
PDM_DATA2: U101.48 (MIC_DATA2)
PDM_DATA3: U101.51 (MIC_DATA3)
SPI_BOOT_CS_N: R103.2, U101.6 (SPI_CS_N)

Notes on the sheet:
HEAD AUDIO / XVF3800 production silicon, USB accessory firmware, four independent PDM data lines
Pin map: XMOS XVF3800 v3.2.1 Tables 4.1 and 6.1. QF60B has FOUR core-supply paddles plus one ground paddle. 61-64 must connect to 0.9 V; 65 is ground. The local five-paddle footprint follows Fig.8.1 nominal geometry. USB ESD, exact connector, XTAG4 adapter, land-pattern/stencil review and firmware 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
QSPI_D1 has no boot-select pull-up: boot from local flash. Set and verify nonvolatile Quad Enable before boot. USB playback must carry the actual speaker signal as the echo reference; capture alone does not cancel the robot speakers. Unused pin settings and SDR sampling edge must match the custom f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
