iimmyy/Little-Guy/hardware/little-guy-v2/pcb/head/02-supplies.kicad_sch

## KiCad design hardware/little-guy-v2/pcb/head/02-supplies.kicad_sch (2026-11-07)

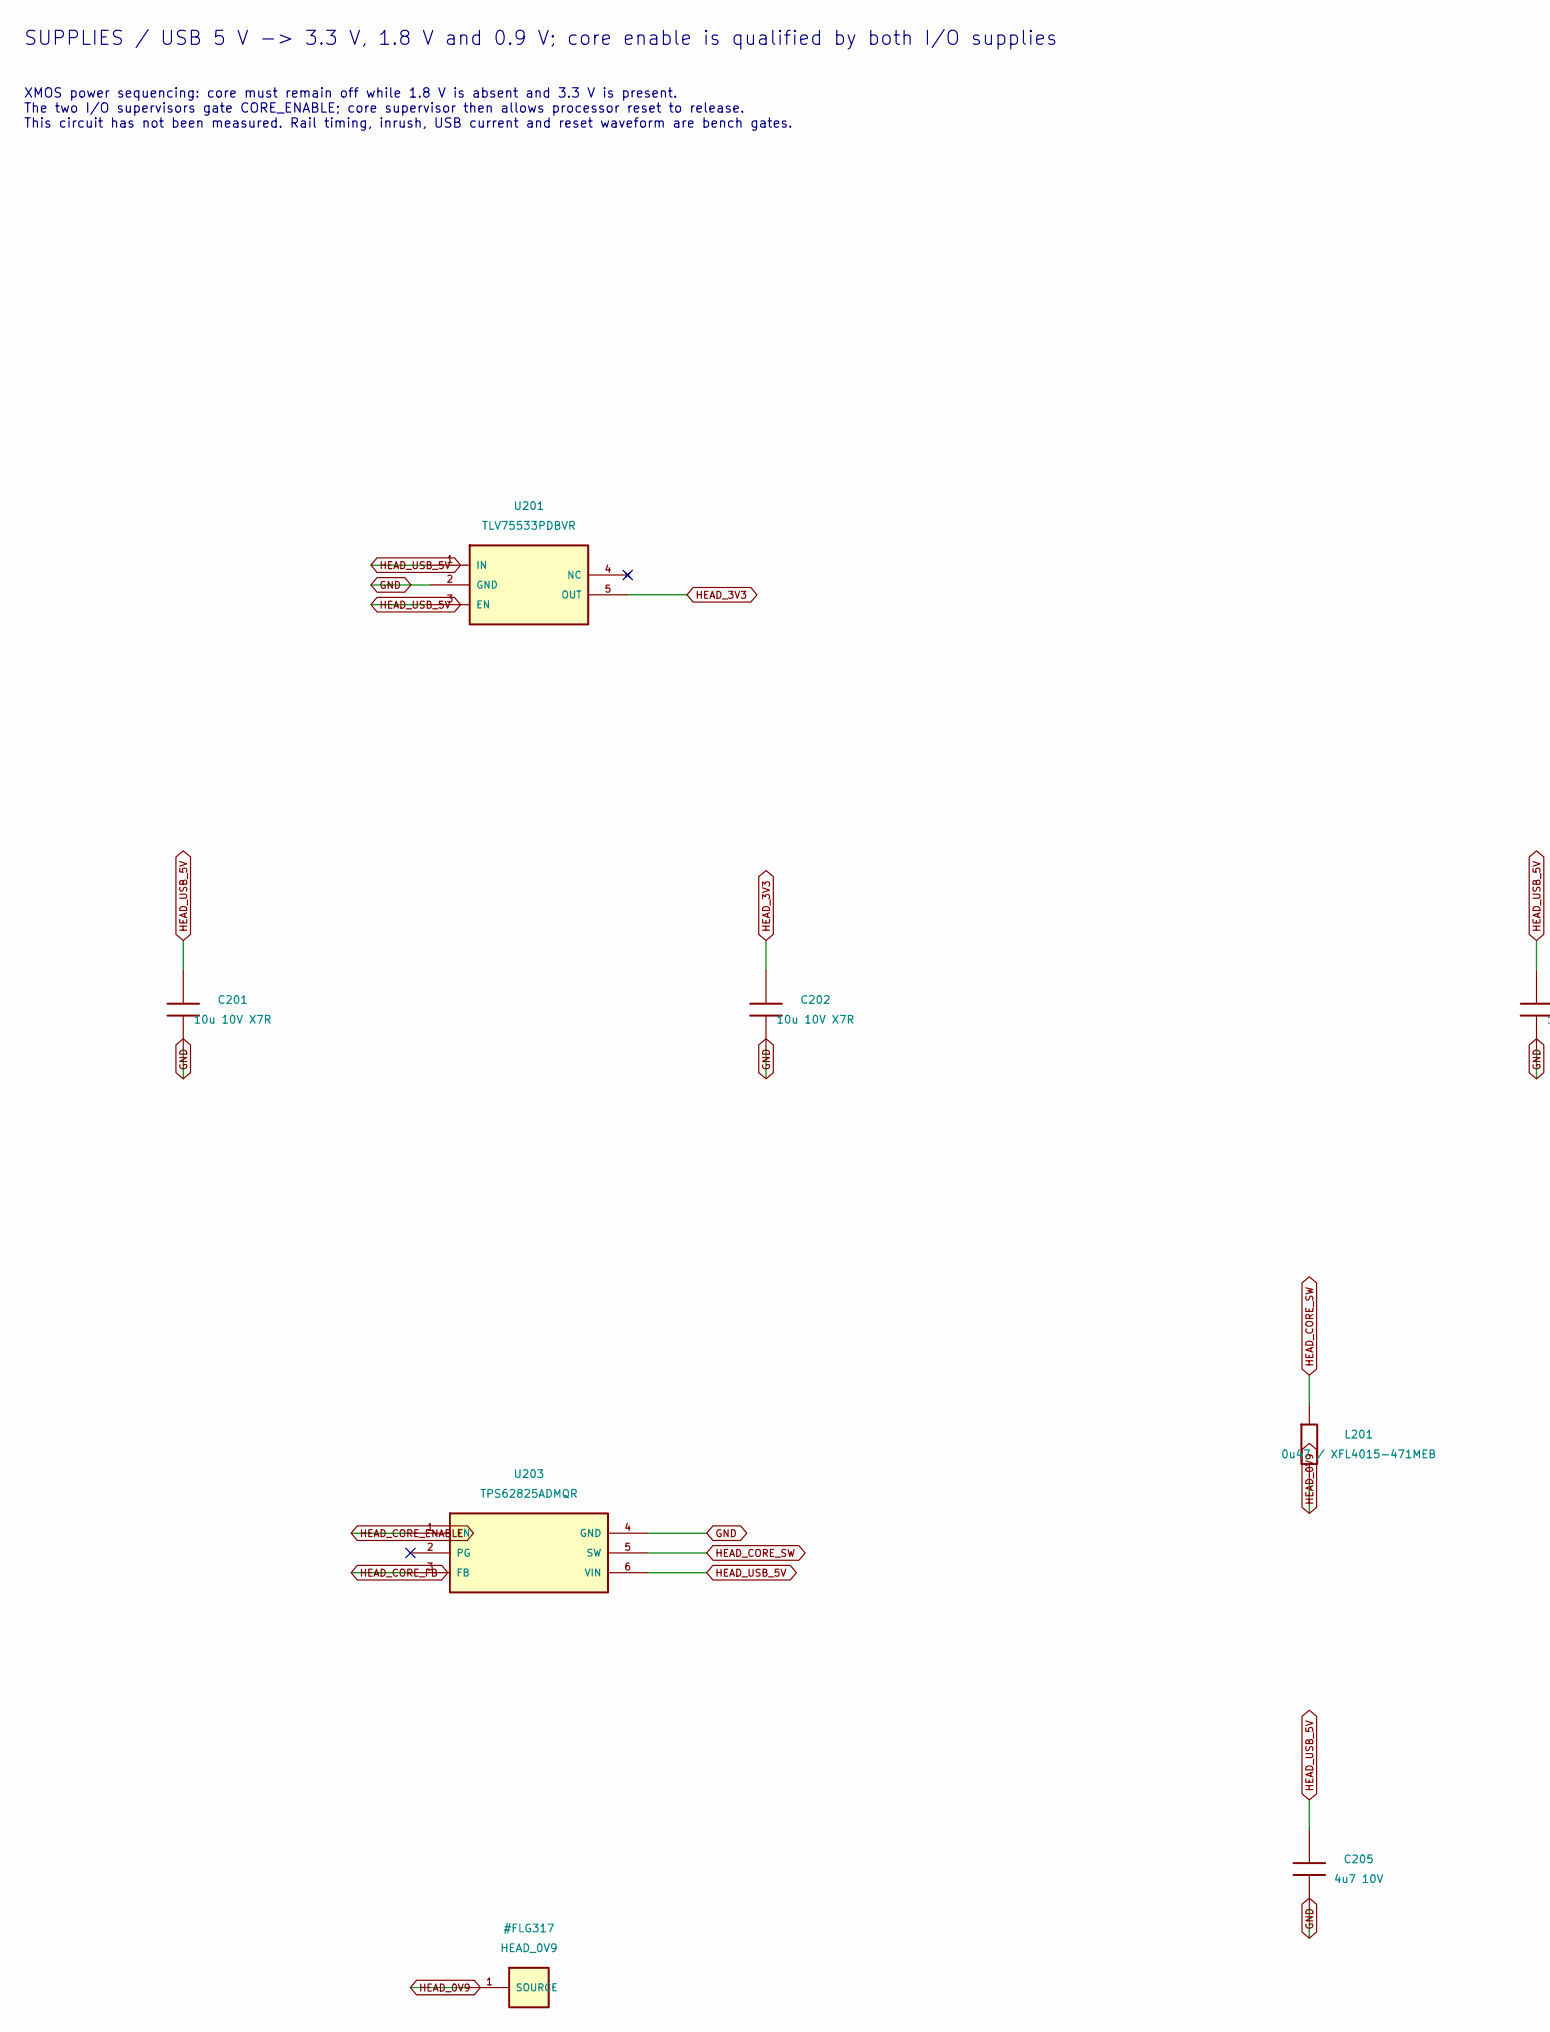
[picture p42: schematic 02-supplies.kicad_sch, part in row 1, column 1]

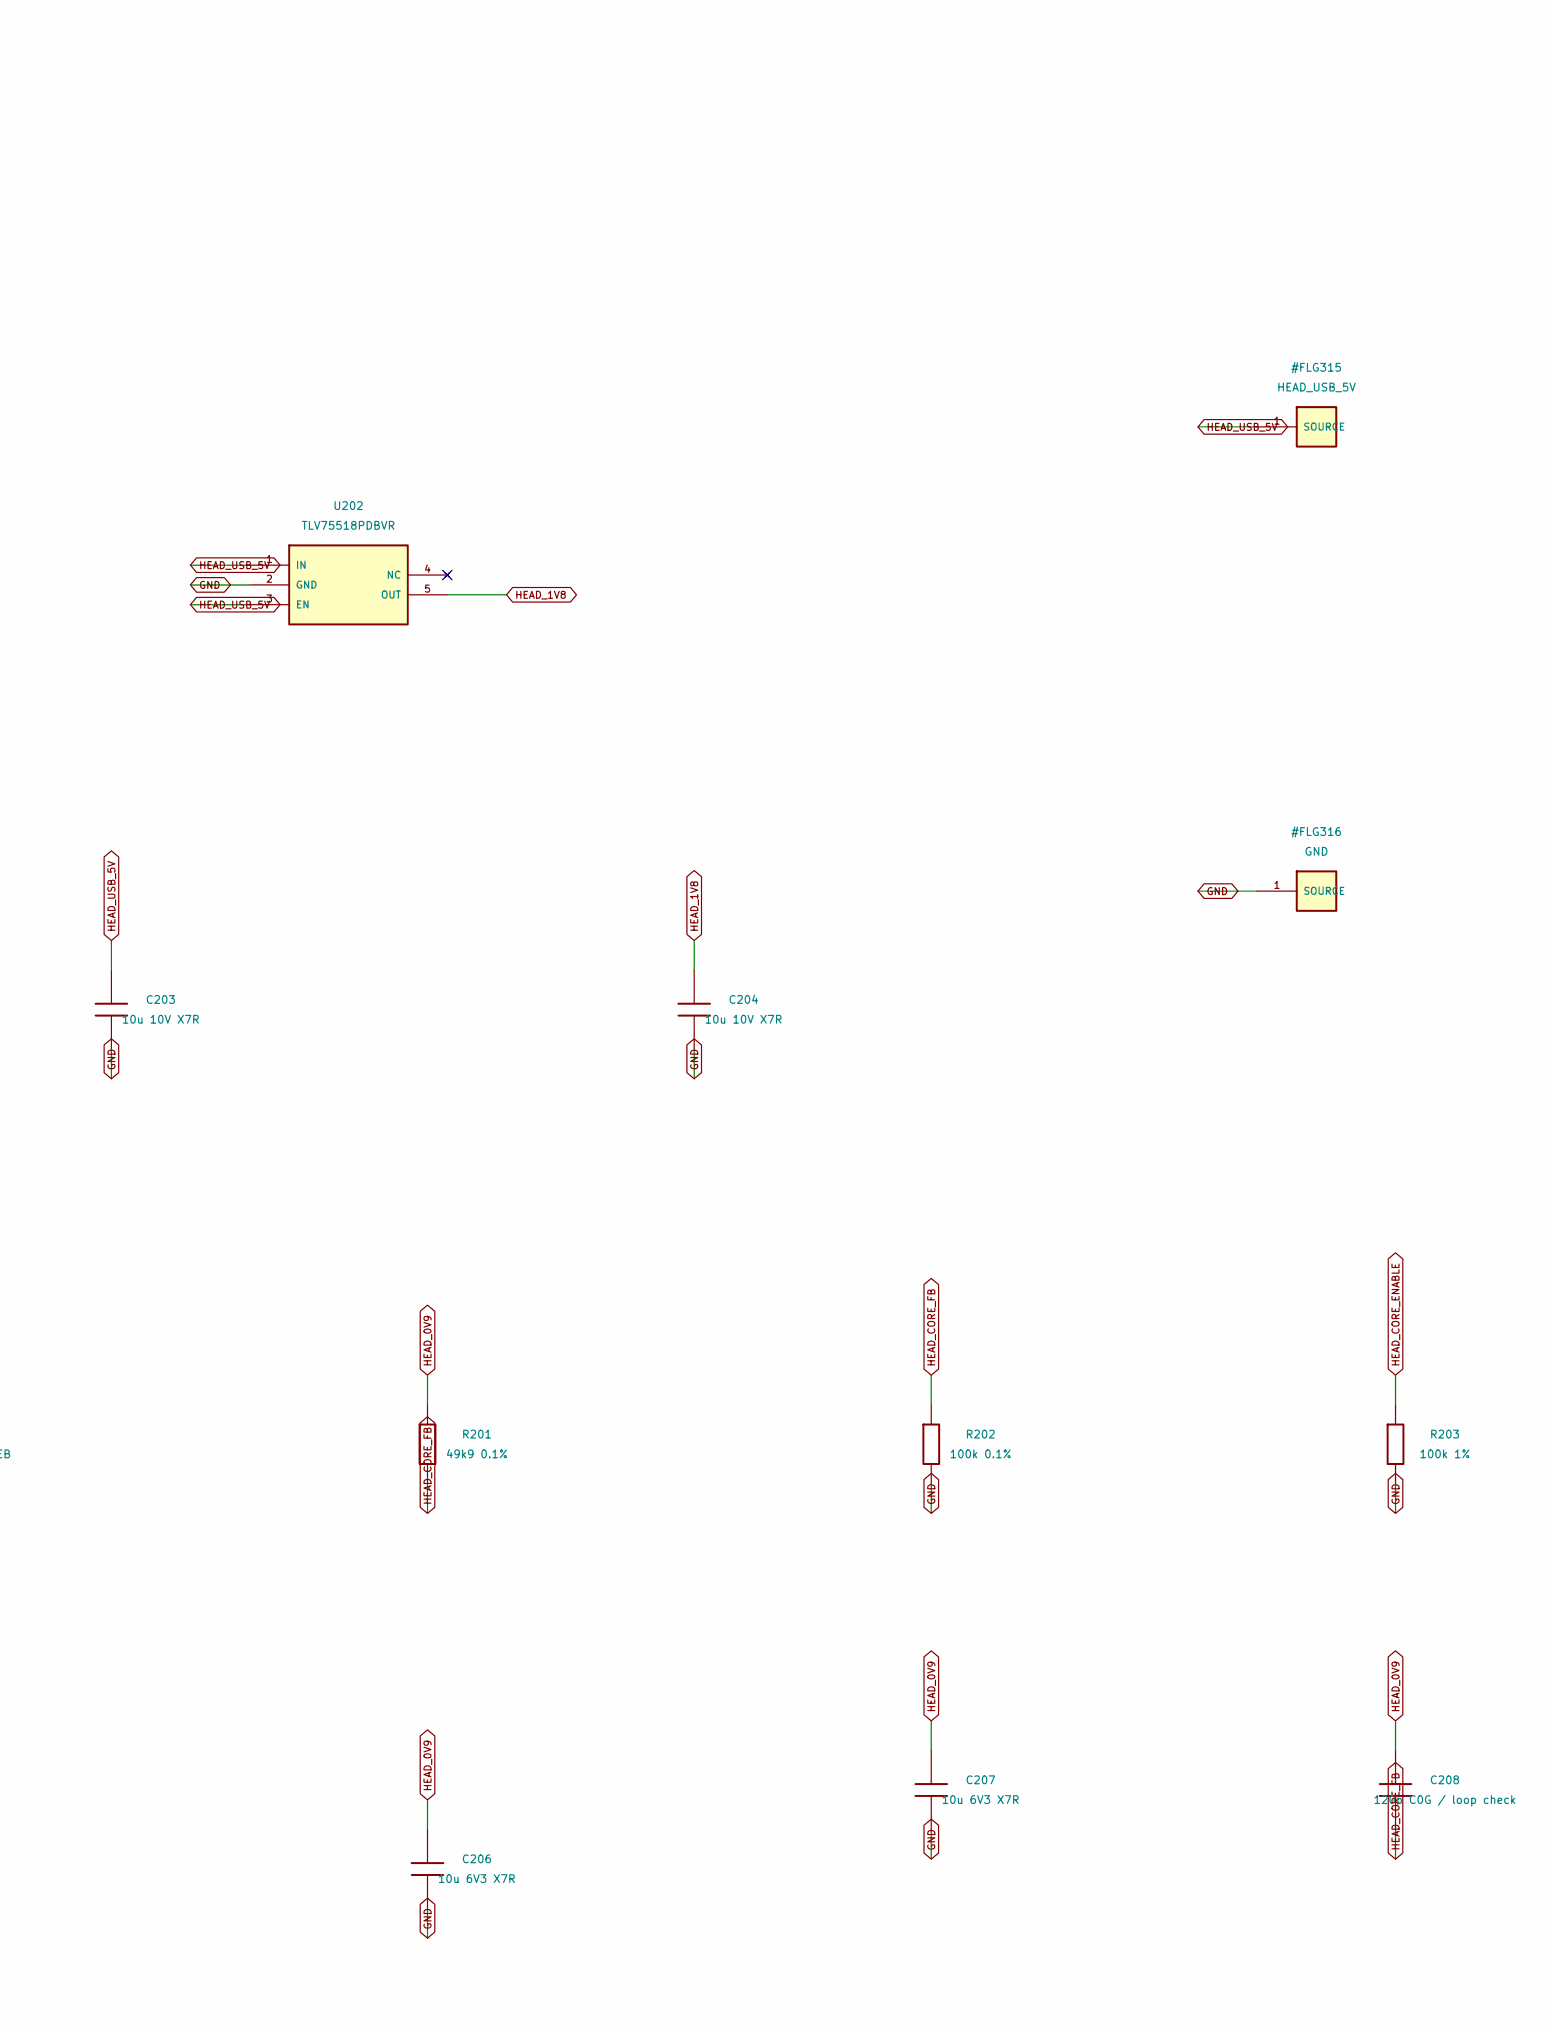
[picture p43: schematic 02-supplies.kicad_sch, part in row 1, column 2]

Parts:
C201, C202, C203, C204: 10u 10V X7R; C_0603_1608Metric
C205: 4u7 10V; C_0603_1608Metric
C206, C207: 10u 6V3 X7R; C_0603_1608Metric
C208: 120p C0G / loop check; C_0603_1608Metric
L201: 0u47 / XFL4015-471MEB; MPN XFL4015-471MEB
R201: 49k9 0.1%; R_0603_1608Metric
R202: 100k 0.1%; R_0603_1608Metric
R203: 100k 1%; R_0603_1608Metric
U201: TLV75533PDBVR; SOT-23-5; MPN TLV75533PDBVR
U202: TLV75518PDBVR; SOT-23-5; MPN TLV75518PDBVR
U203: TPS62825ADMQR; MPN TPS62825ADMQR

Connections:
GND: C201.2, C202.2, C203.2, C204.2, C205.2, C206.2, C207.2, R202.2, R203.2, U201.2 (GND), U202.2 (GND), U203.4 (GND)
HEAD_0V9: C206.1, C207.1, C208.1, L201.2, R201.1
HEAD_1V8: C204.1, U202.5 (OUT)
HEAD_3V3: C202.1, U201.5 (OUT)
HEAD_CORE_ENABLE: R203.1, U203.1 (EN)
HEAD_CORE_FB: C208.2, R201.2, R202.1, U203.3 (FB)
HEAD_CORE_SW: L201.1, U203.5 (SW)
HEAD_USB_5V: C201.1, C203.1, C205.1, U201.1 (IN), U201.3 (EN), U202.1 (IN), U202.3 (EN), U203.6 (VIN)

Notes on the sheet:
SUPPLIES / USB 5 V -> 3.3 V, 1.8 V and 0.9 V; core enable is qualified by both I/O supplies
XMOS power sequencing: core must remain off while 1.8 V is absent and 3.3 V is present. The two I/O supervisors gate CORE_ENABLE; core supervisor then allows processor reset to release. This circuit has not been measured. Rail timing, inrush, USB current and reset waveform are bench gates.
