iimmyy/Little-Guy/hardware/little-guy-v2/pcb/head/03-power-supervision.kicad_sch

## KiCad design hardware/little-guy-v2/pcb/head/03-power-supervision.kicad_sch (2026-11-07)

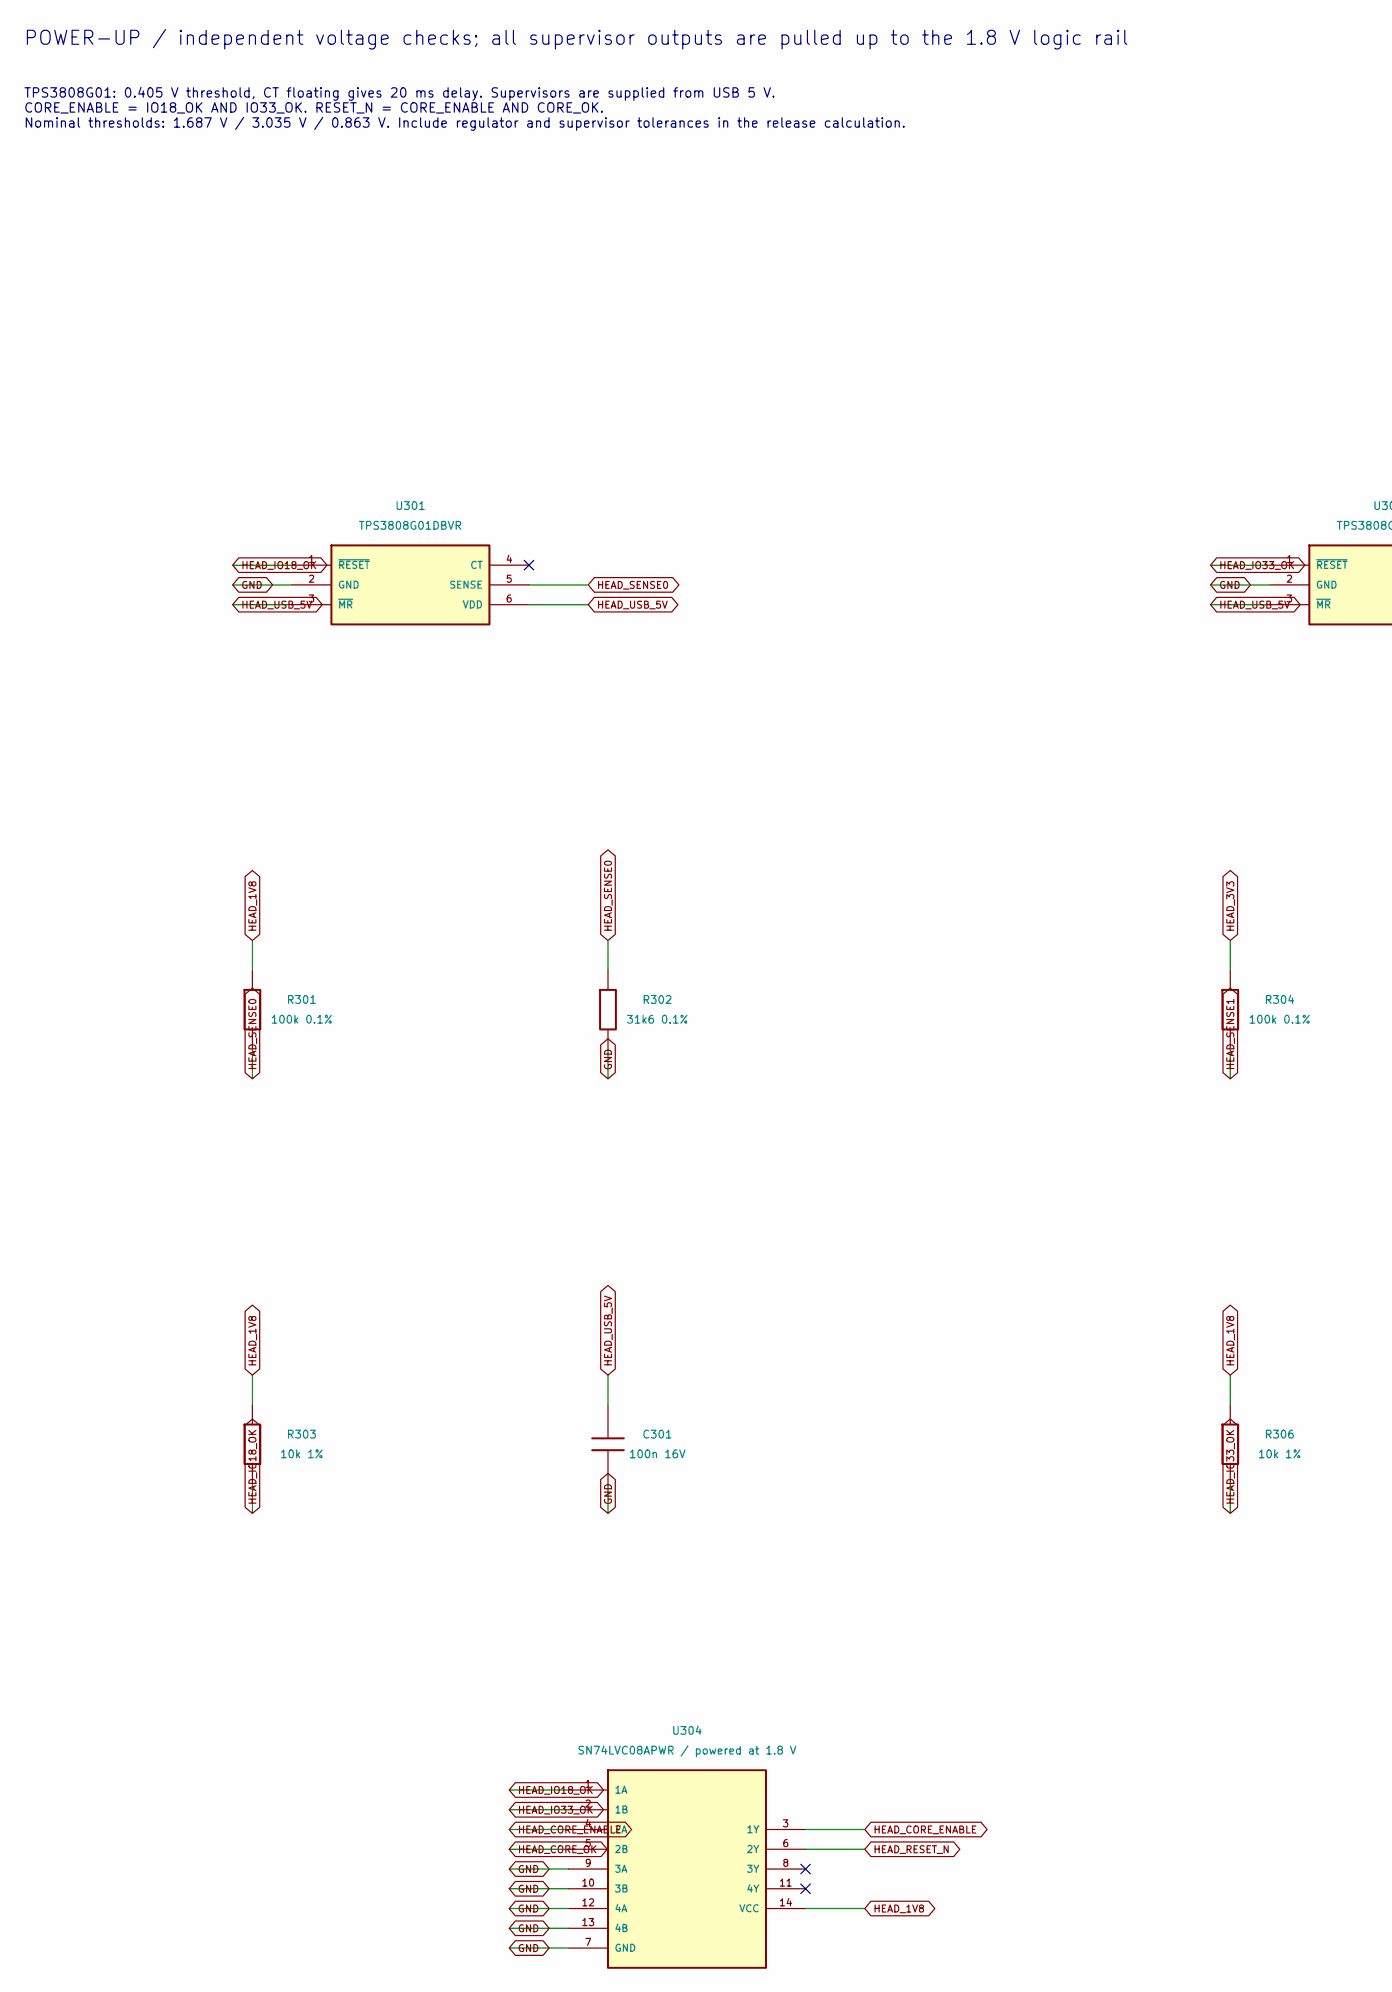
[picture p44: schematic 03-power-supervision.kicad_sch, part in row 1, column 1]

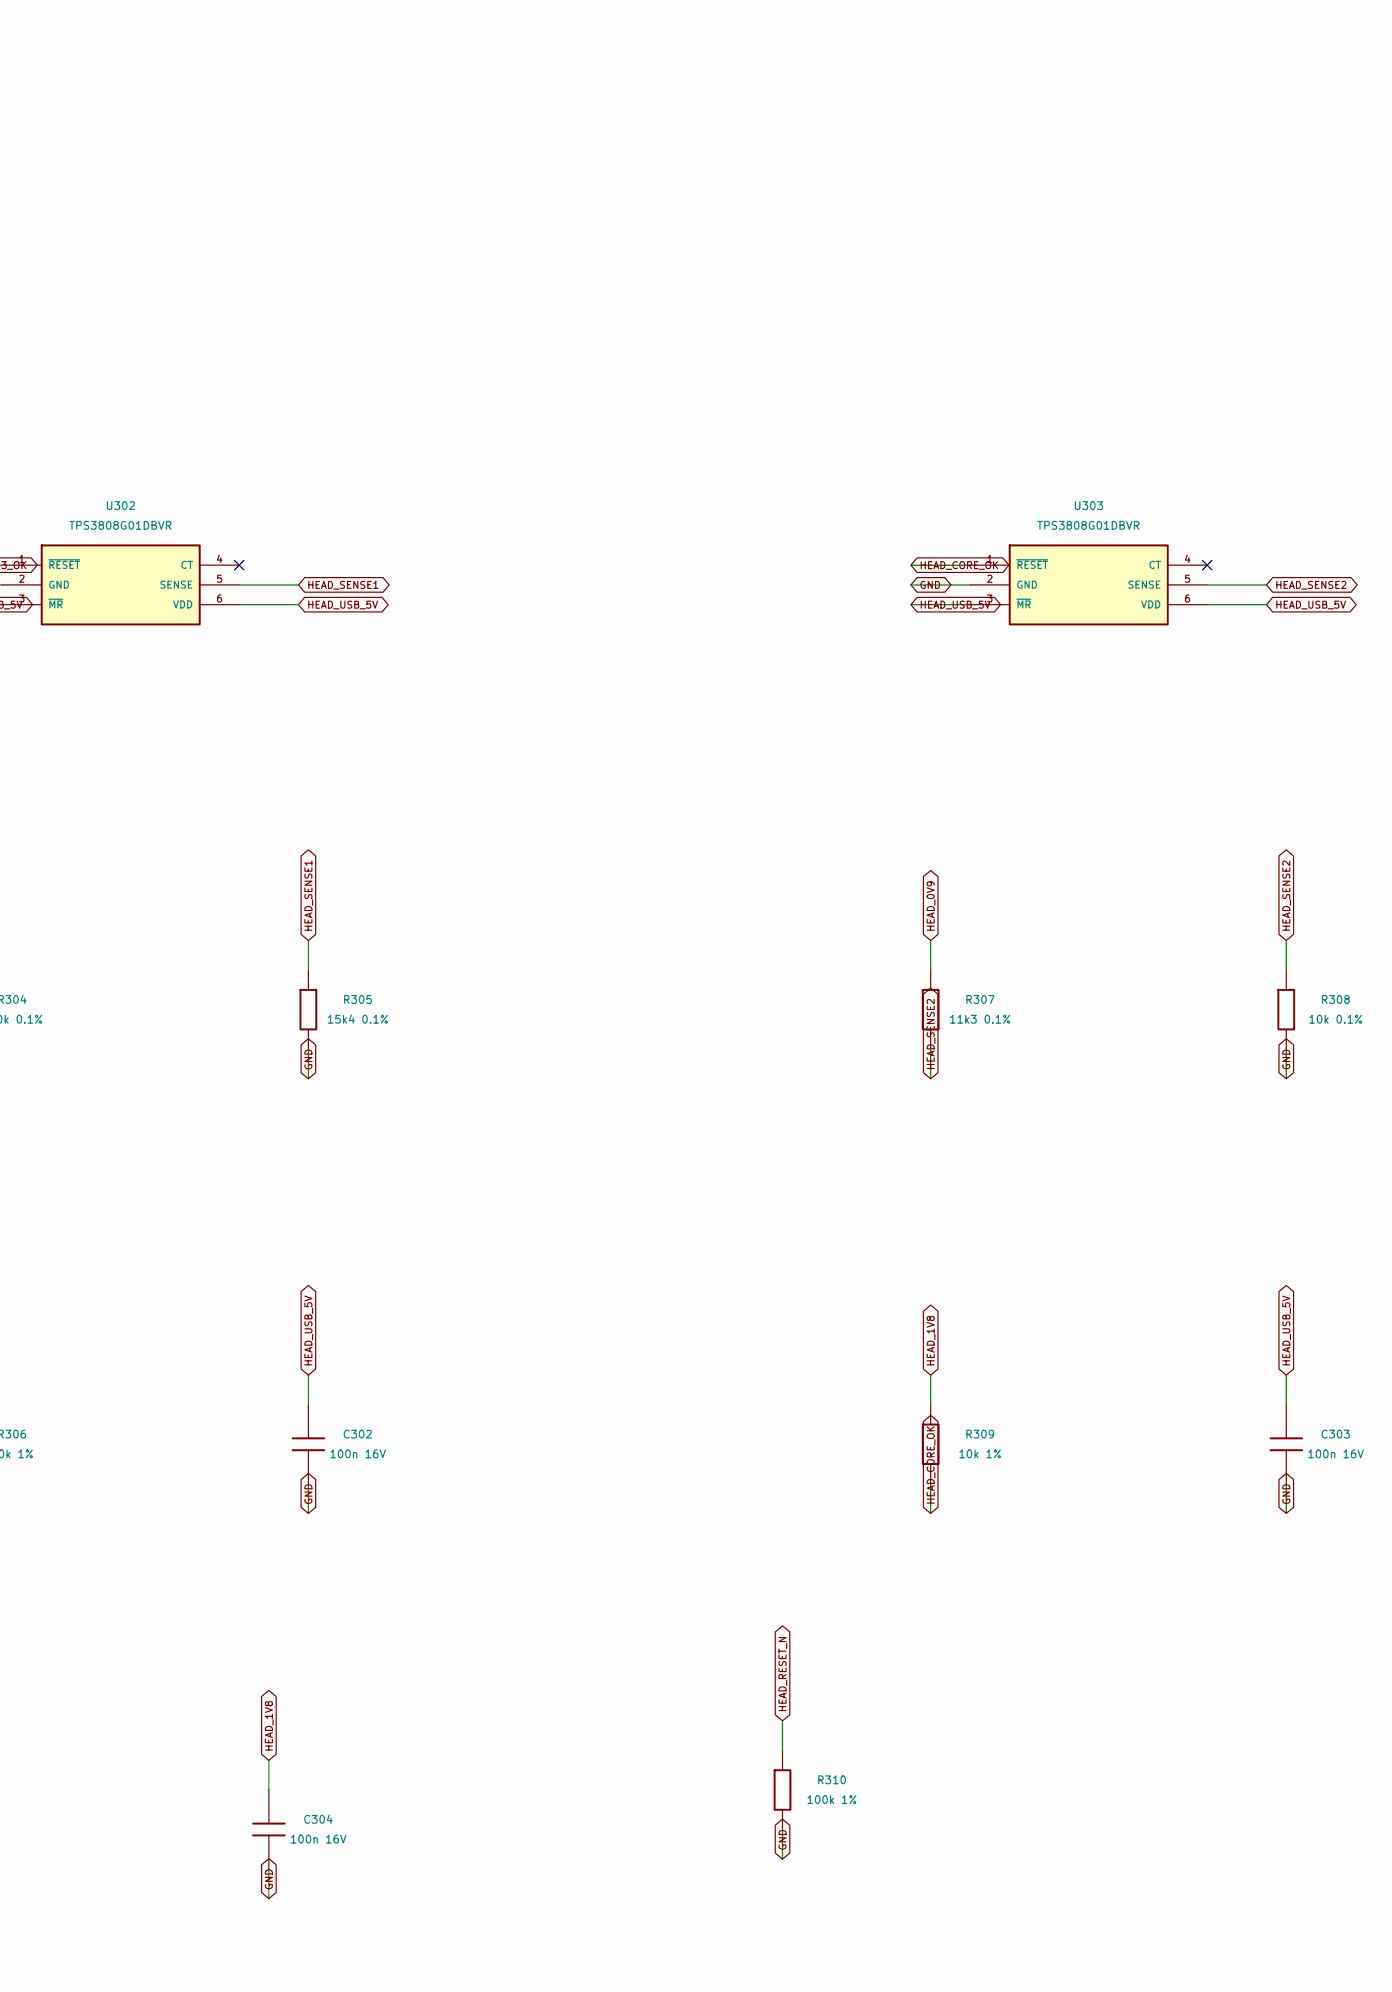
[picture p45: schematic 03-power-supervision.kicad_sch, part in row 1, column 2]

Parts:
C301, C302, C303, C304: 100n 16V; C_0603_1608Metric
R301, R304: 100k 0.1%; R_0603_1608Metric
R302: 31k6 0.1%; R_0603_1608Metric
R303, R306, R309: 10k 1%; R_0603_1608Metric
R305: 15k4 0.1%; R_0603_1608Metric
R307: 11k3 0.1%; R_0603_1608Metric
R308: 10k 0.1%; R_0603_1608Metric
R310: 100k 1%; R_0603_1608Metric
U301, U302, U303: TPS3808G01DBVR; SOT-23-6; MPN TPS3808G01DBVR
U304: SN74LVC08APWR / powered at 1.8 V; TSSOP-14_4.4x5mm_P0.65mm; MPN SN74LVC08APWR

Connections:
GND: C301.2, C302.2, C303.2, C304.2, R302.2, R305.2, R308.2, R310.2, U301.2 (GND), U302.2 (GND), U303.2 (GND), U304.7 (GND), U304.9 (3A), U304.10 (3B), U304.12 (4A), U304.13 (4B)
HEAD_0V9: R307.1
HEAD_1V8: C304.1, R301.1, R303.1, R306.1, R309.1, U304.14 (VCC)
HEAD_3V3: R304.1
HEAD_CORE_ENABLE: U304.3 (1Y), U304.4 (2A)
HEAD_CORE_OK: R309.2, U303.1 (~RESET), U304.5 (2B)
HEAD_IO18_OK: R303.2, U301.1 (~RESET), U304.1 (1A)
HEAD_IO33_OK: R306.2, U302.1 (~RESET), U304.2 (1B)
HEAD_RESET_N: R310.1, U304.6 (2Y)
HEAD_SENSE0: R301.2, R302.1, U301.5 (SENSE)
HEAD_SENSE1: R304.2, R305.1, U302.5 (SENSE)
HEAD_SENSE2: R307.2, R308.1, U303.5 (SENSE)
HEAD_USB_5V: C301.1, C302.1, C303.1, U301.3 (~MR), U301.6 (VDD), U302.3 (~MR), U302.6 (VDD), U303.3 (~MR), U303.6 (VDD)

Notes on the sheet:
POWER-UP / independent voltage checks; all supervisor outputs are pulled up to the 1.8 V logic rail
TPS3808G01: 0.405 V threshold, CT floating gives 20 ms delay. Supervisors are supplied from USB 5 V. CORE_ENABLE = IO18_OK AND IO33_OK. RESET_N = CORE_ENABLE AND CORE_OK. Nominal thresholds: 1.687 V / 3.035 V / 0.863 V. Include regulator and supervisor tolerances in the release calculation.
