iimmyy/Little-Guy/hardware/little-guy-v2/pcb/head/04-decoupling.kicad_sch

## KiCad design hardware/little-guy-v2/pcb/head/04-decoupling.kicad_sch (2026-11-07)

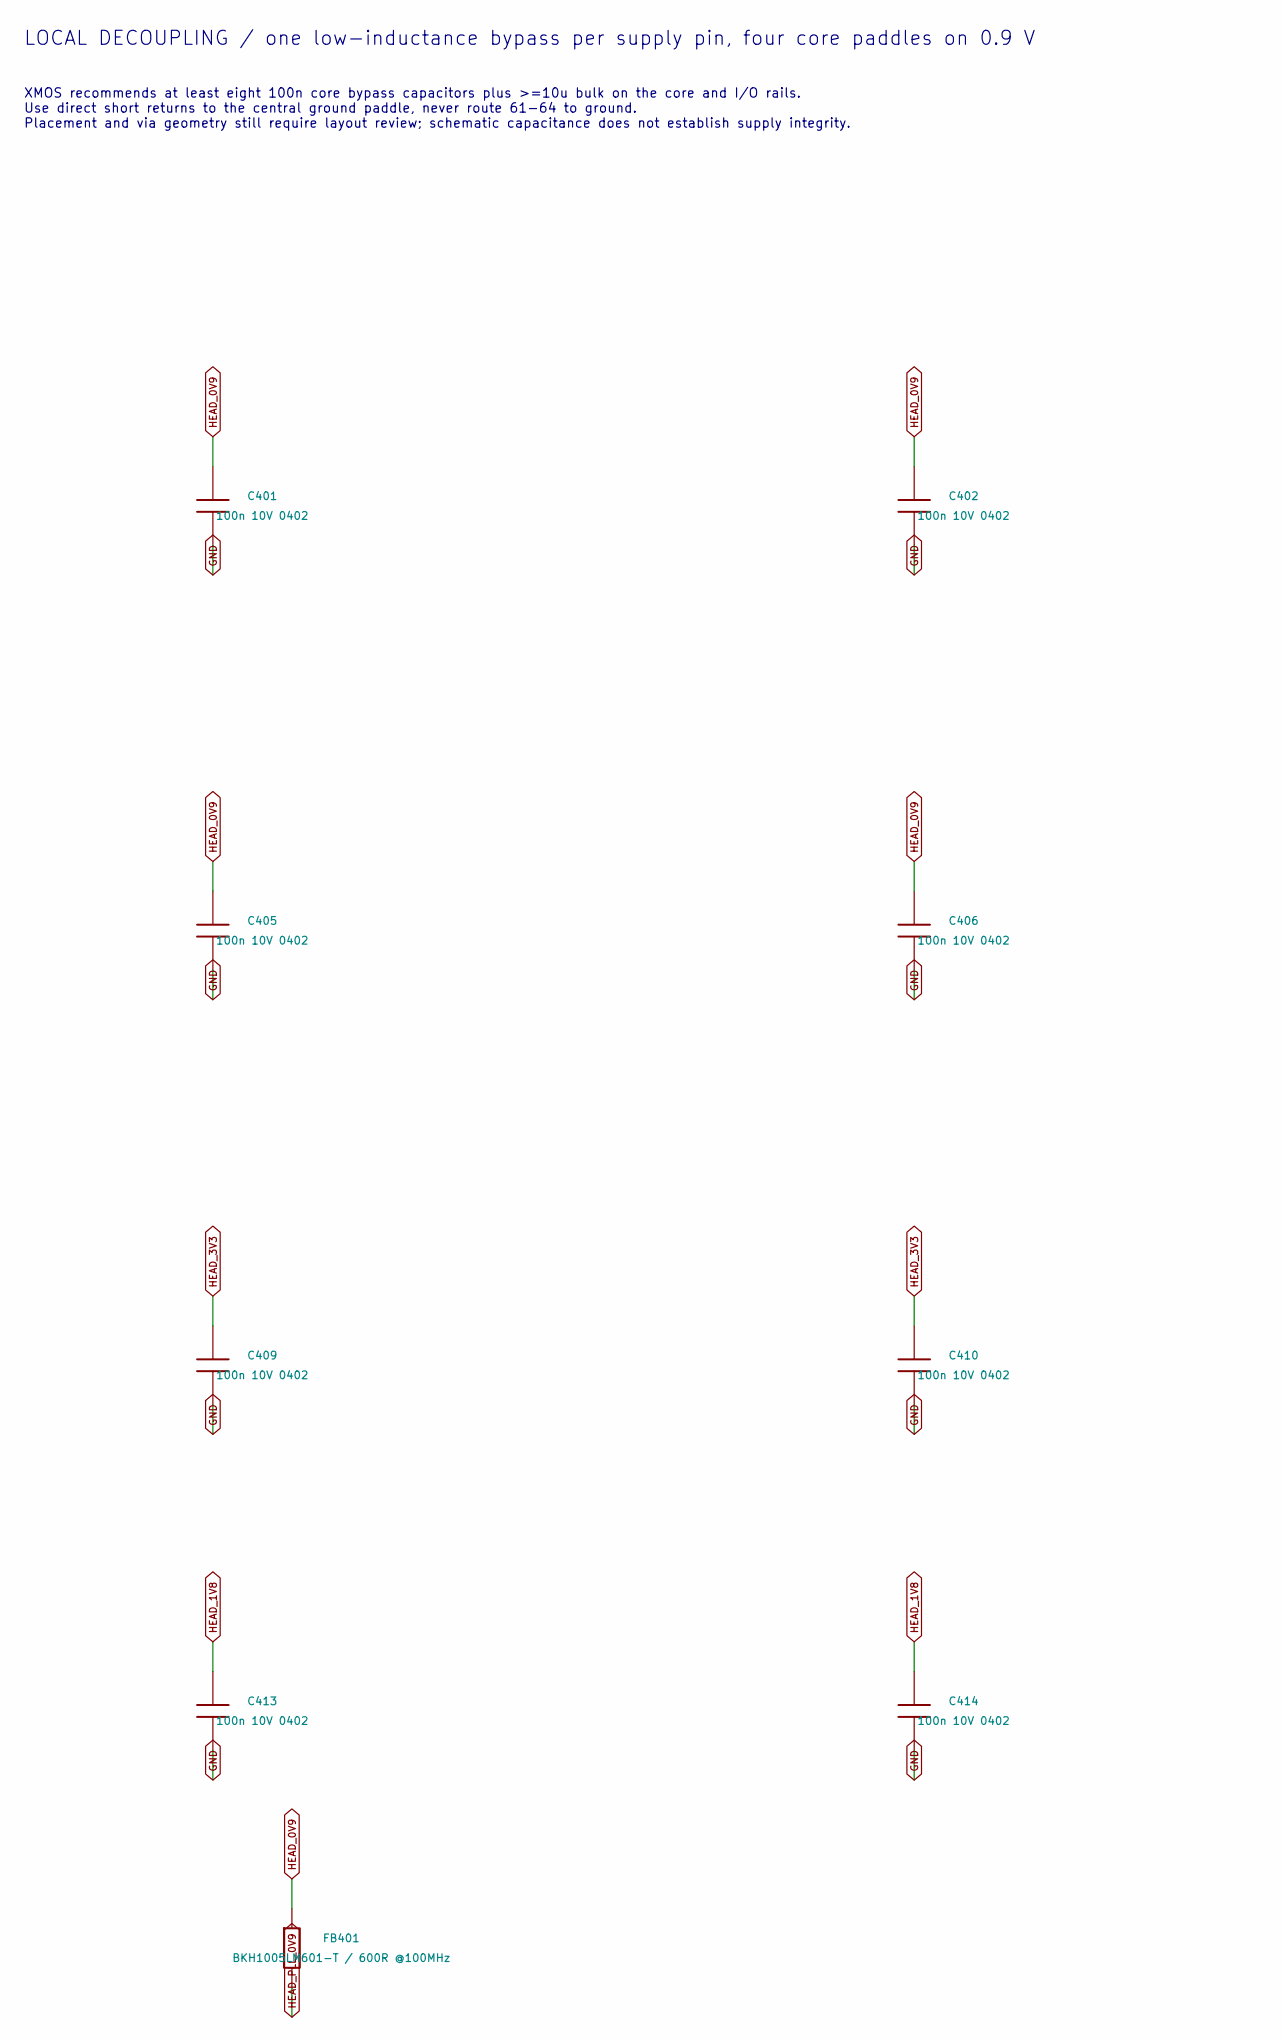
[picture p46: schematic 04-decoupling.kicad_sch, part in row 1, column 1]

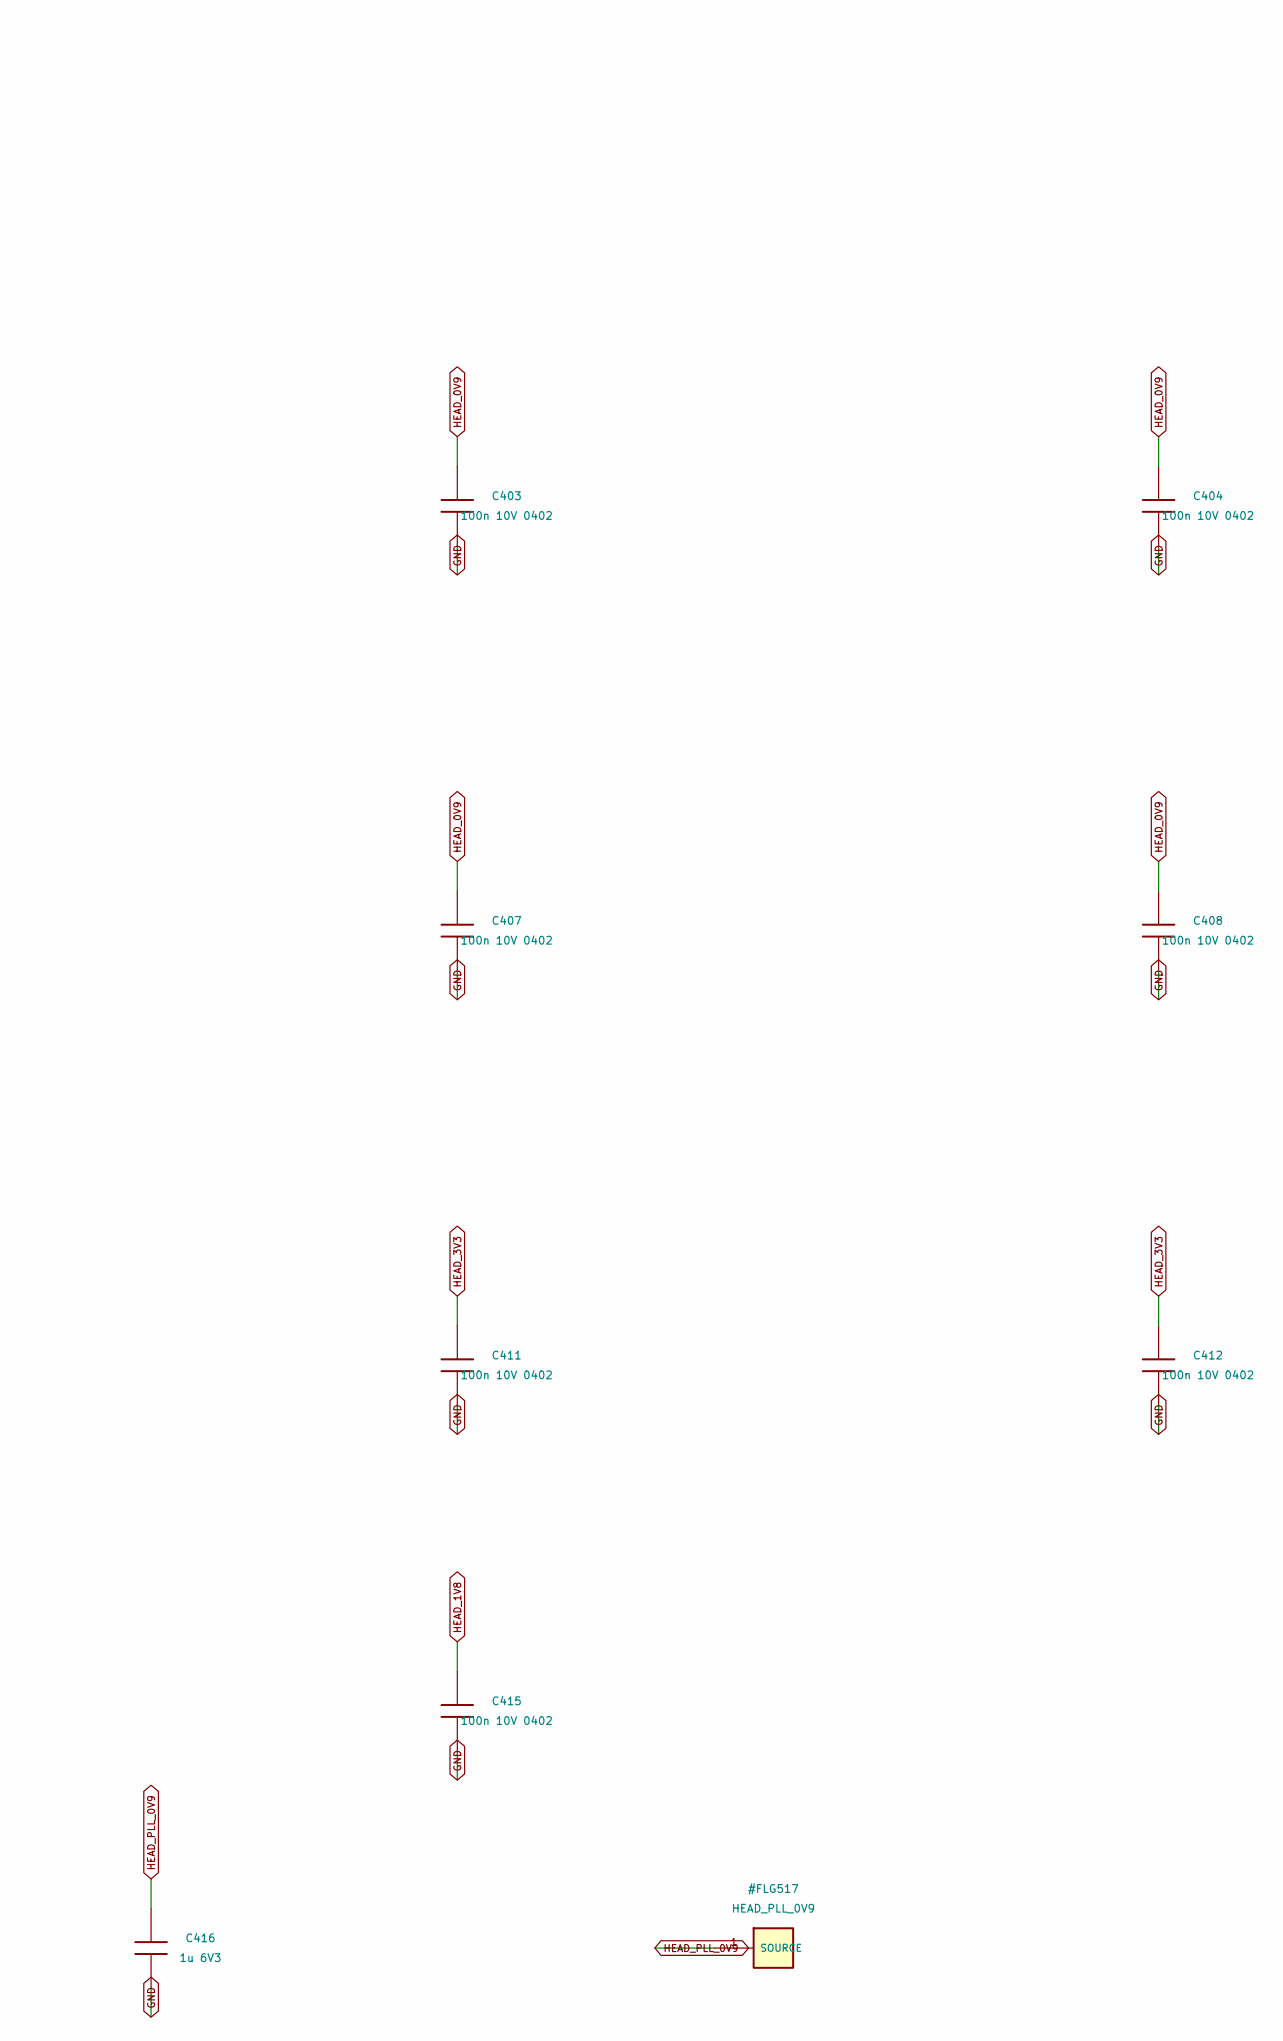
[picture p47: schematic 04-decoupling.kicad_sch, part in row 1, column 2]

Parts:
C401, C402, C403, C404, C405, C406, C407, C408, C409, C410, C411, C412, C413, C414, C415: 100n 10V 0402; C_0603_1608Metric
C416: 1u 6V3; C_0603_1608Metric
FB401: BKH1005LM601-T / 600R @100MHz; MPN BKH1005LM601-T

Connections:
GND: C401.2, C402.2, C403.2, C404.2, C405.2, C406.2, C407.2, C408.2, C409.2, C410.2, C411.2, C412.2, C413.2, C414.2, C415.2, C416.2
HEAD_0V9: C401.1, C402.1, C403.1, C404.1, C405.1, C406.1, C407.1, C408.1, FB401.1
HEAD_1V8: C413.1, C414.1, C415.1
HEAD_3V3: C409.1, C410.1, C411.1, C412.1
HEAD_PLL_0V9: C416.1, FB401.2

Notes on the sheet:
LOCAL DECOUPLING / one low-inductance bypass per supply pin, four core paddles on 0.9 V
XMOS recommends at least eight 100n core bypass capacitors plus >=10u bulk on the core and I/O rails. Use direct short returns to the central ground paddle, never route 61-64 to ground. Placement and via geometry still require layout review; schematic capacitance does not establish supply integrity.
