iimmyy/Little-Guy/hardware/little-guy-v2/pcb/head/05-microphones.kicad_sch

## KiCad design hardware/little-guy-v2/pcb/head/05-microphones.kicad_sch (2026-11-07)

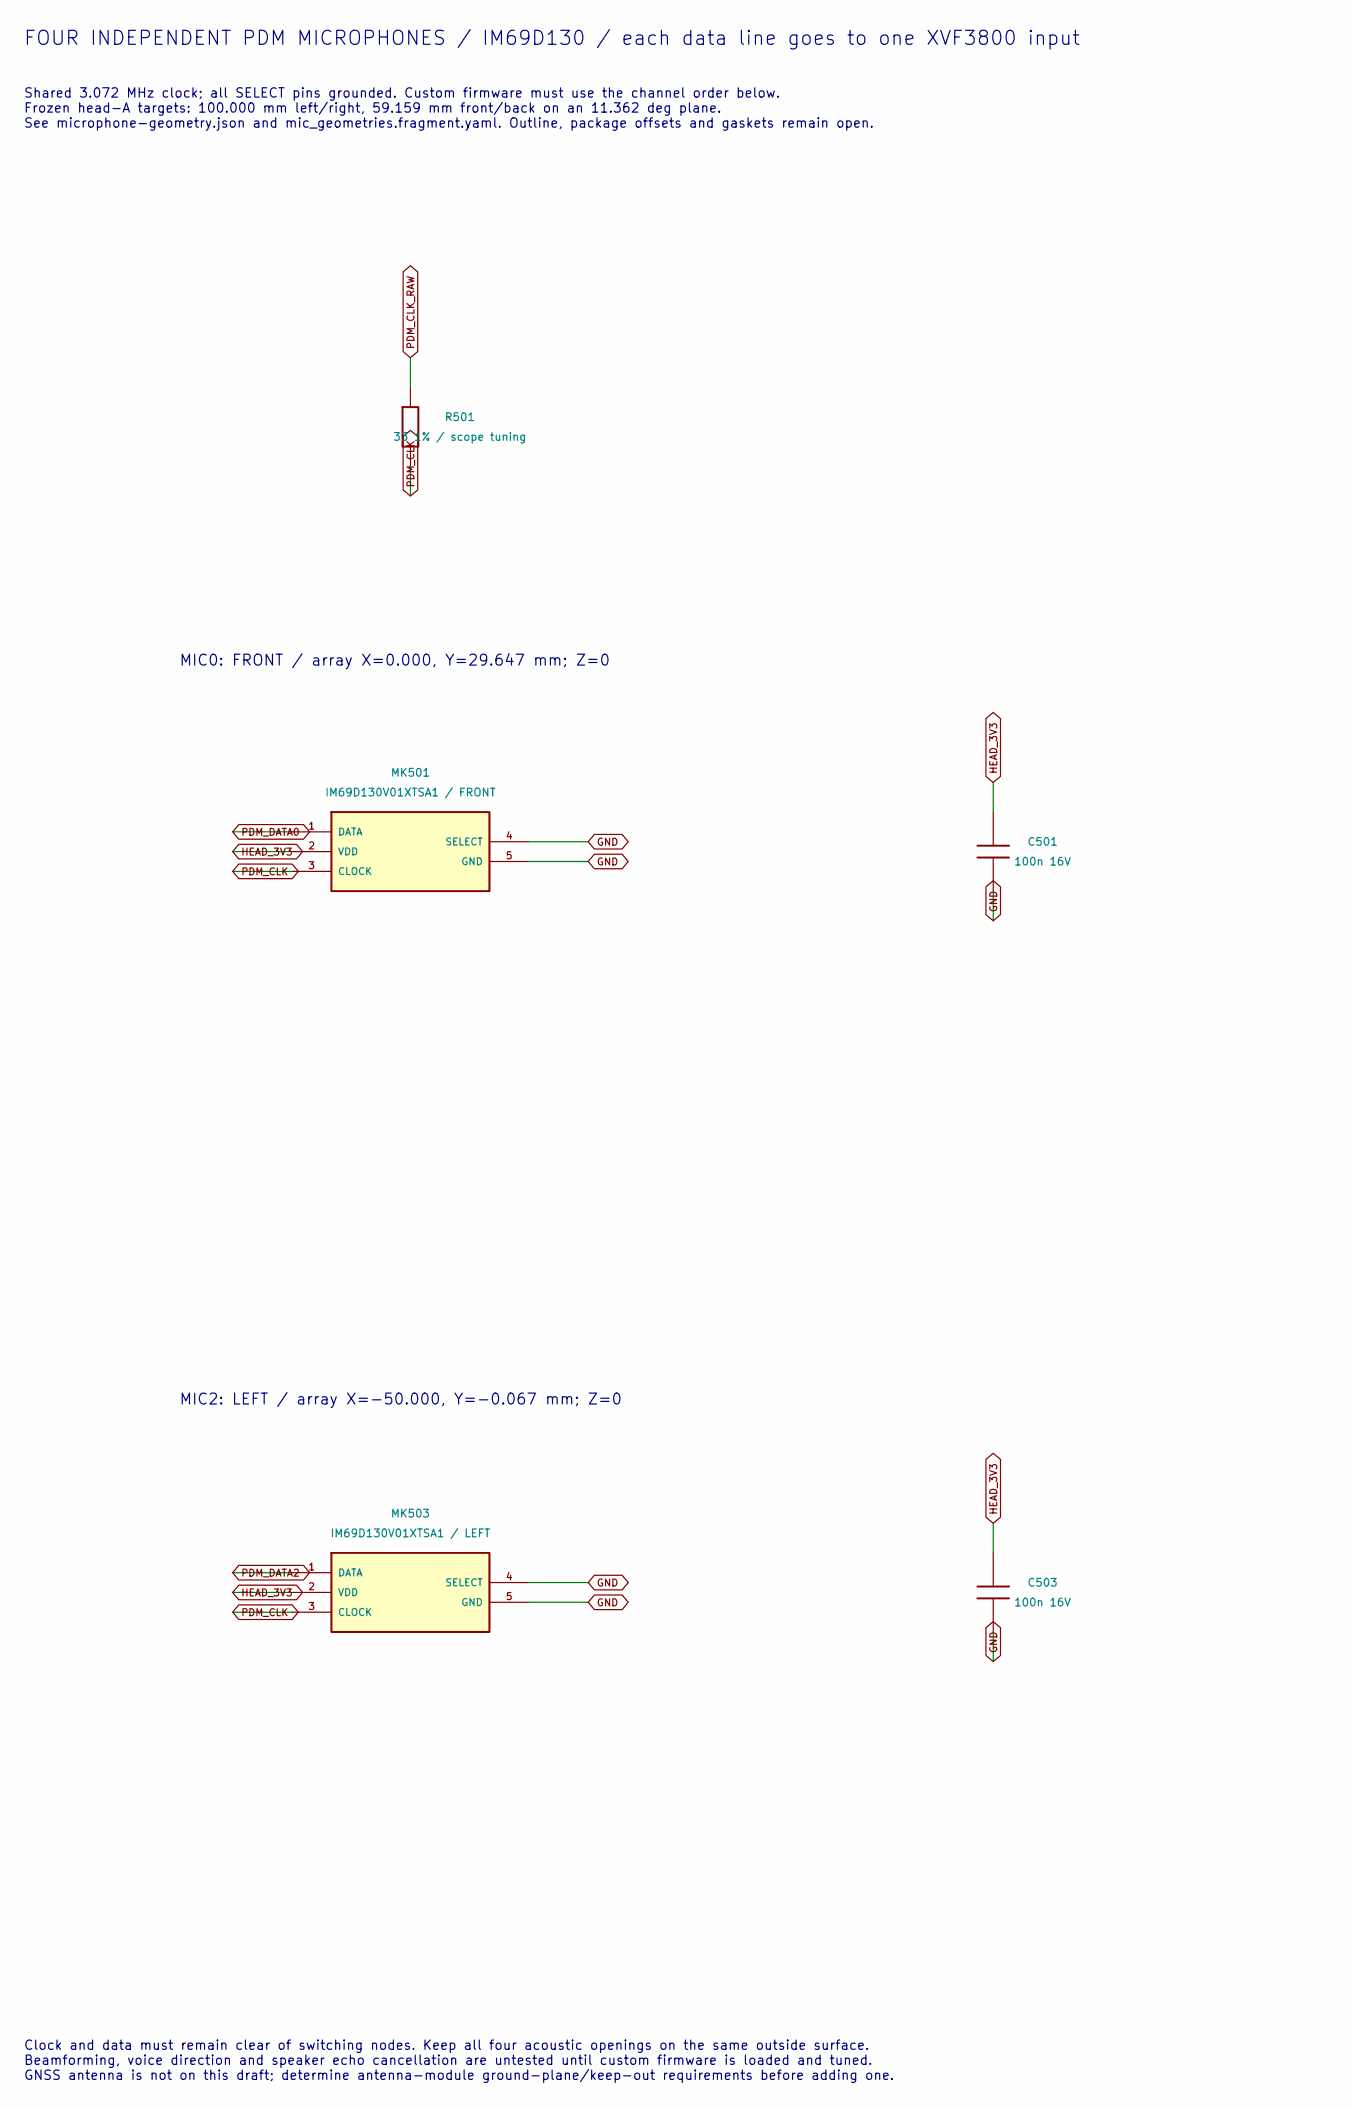
[picture p48: schematic 05-microphones.kicad_sch, part in row 1, column 1]

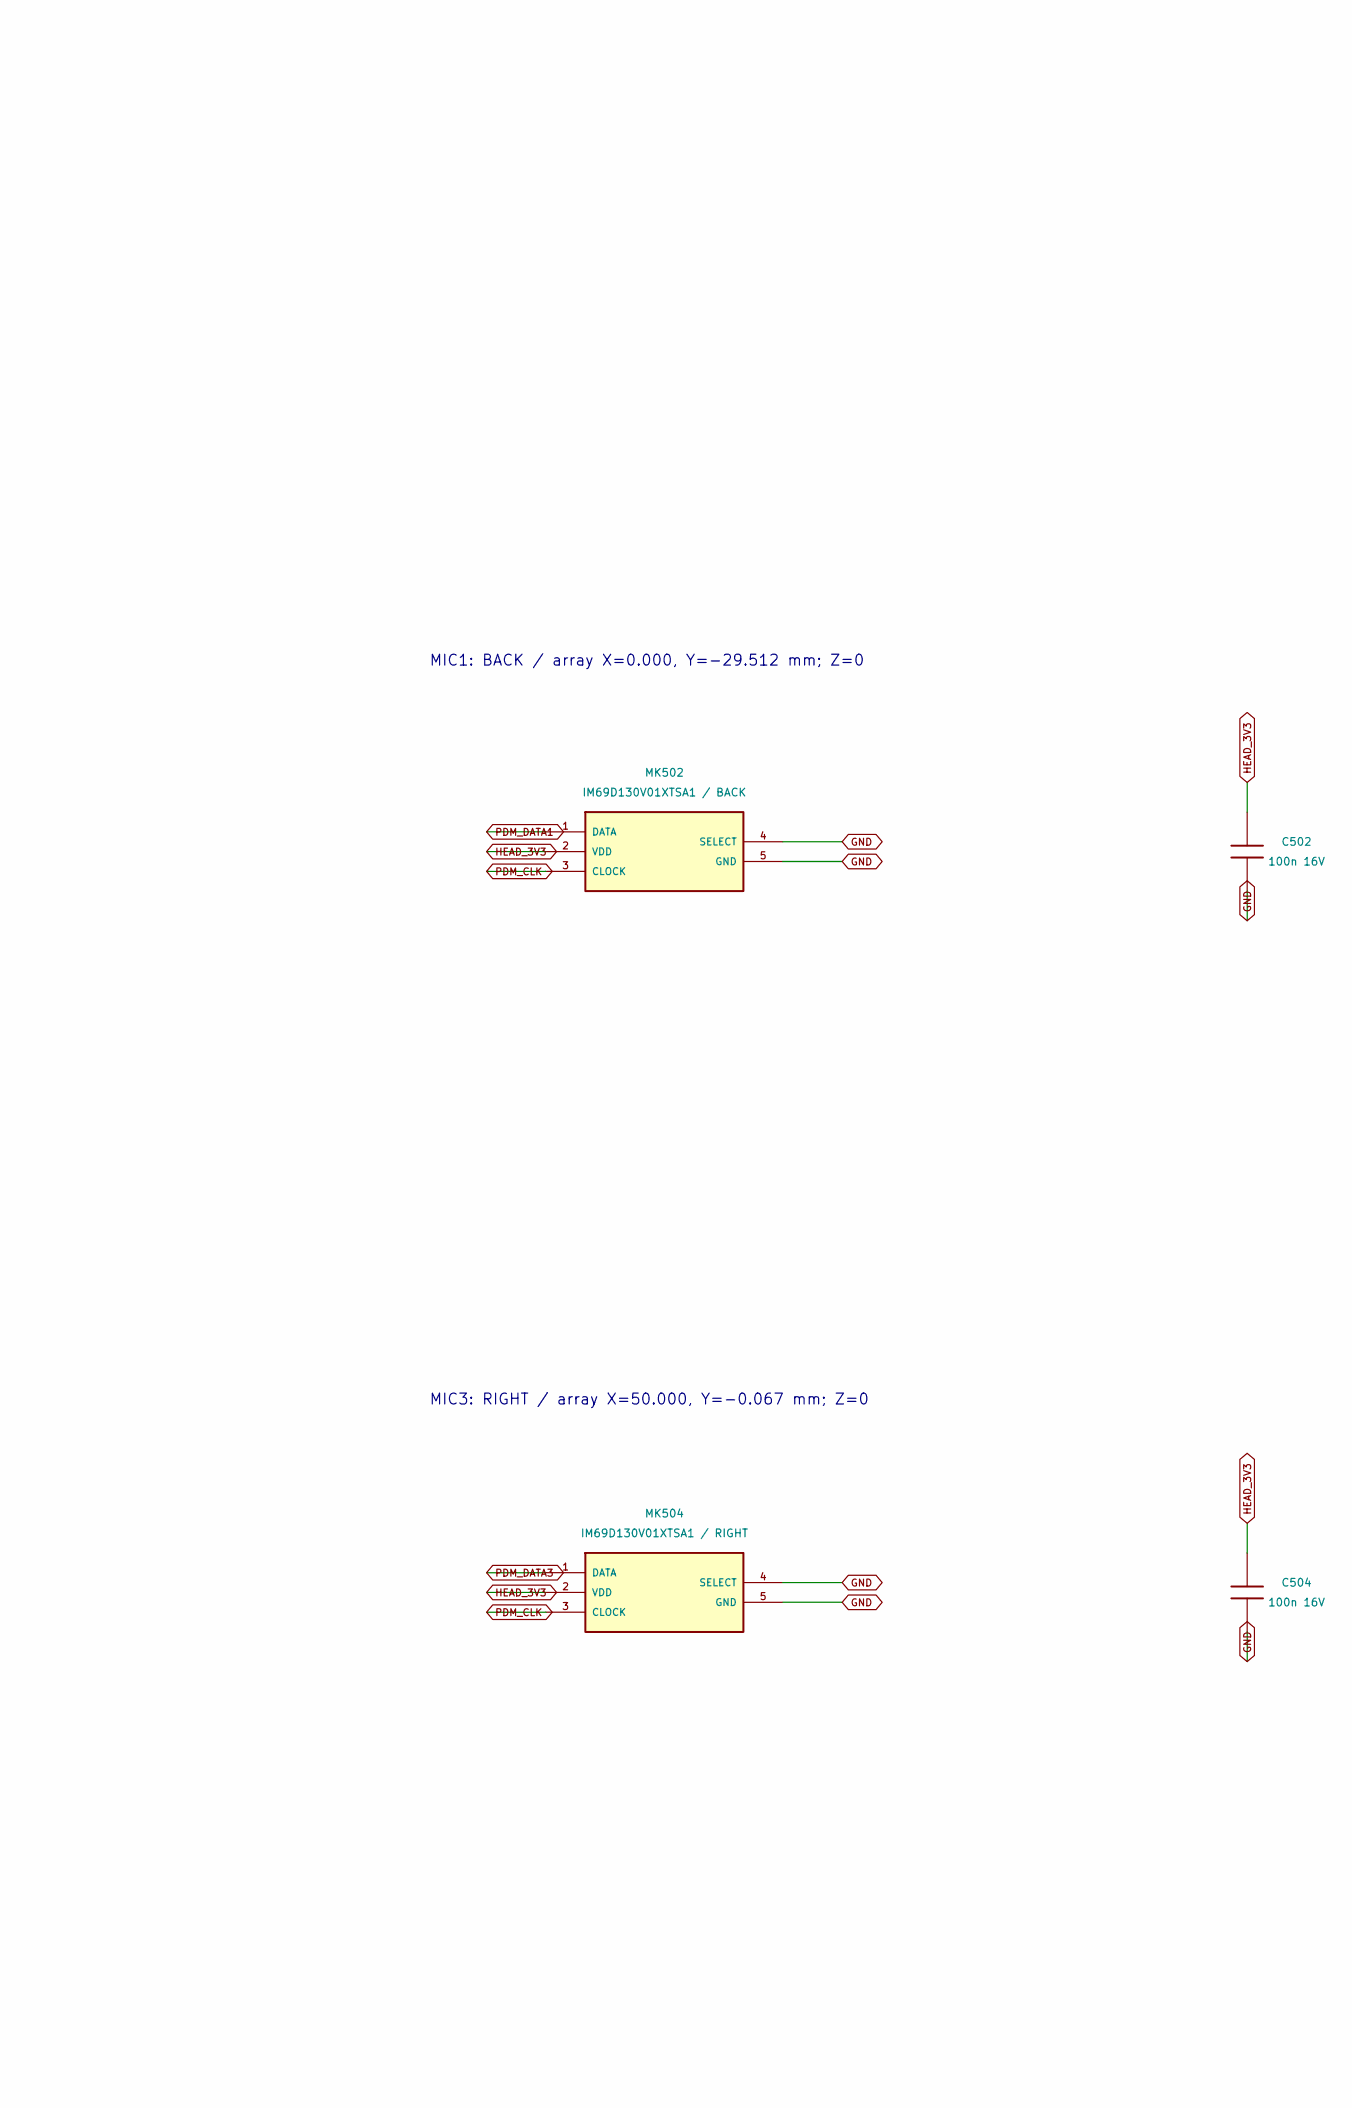
[picture p49: schematic 05-microphones.kicad_sch, part in row 1, column 2]

Parts:
C501, C502, C503, C504: 100n 16V; C_0603_1608Metric
MK501: IM69D130V01XTSA1 / FRONT; MPN IM69D130V01XTSA1
MK502: IM69D130V01XTSA1 / BACK; MPN IM69D130V01XTSA1
MK503: IM69D130V01XTSA1 / LEFT; MPN IM69D130V01XTSA1
MK504: IM69D130V01XTSA1 / RIGHT; MPN IM69D130V01XTSA1
R501: 33 1% / scope tuning; R_0603_1608Metric

Connections:
GND: C501.2, C502.2, C503.2, C504.2, MK501.4 (SELECT), MK501.5 (GND), MK502.4 (SELECT), MK502.5 (GND), MK503.4 (SELECT), MK503.5 (GND), MK504.4 (SELECT), MK504.5 (GND)
HEAD_3V3: C501.1, C502.1, C503.1, C504.1, MK501.2 (VDD), MK502.2 (VDD), MK503.2 (VDD), MK504.2 (VDD)
PDM_CLK: MK501.3 (CLOCK), MK502.3 (CLOCK), MK503.3 (CLOCK), MK504.3 (CLOCK), R501.2
PDM_CLK_RAW: R501.1
PDM_DATA0: MK501.1 (DATA)
PDM_DATA1: MK502.1 (DATA)
PDM_DATA2: MK503.1 (DATA)
PDM_DATA3: MK504.1 (DATA)

Notes on the sheet:
FOUR INDEPENDENT PDM MICROPHONES / IM69D130 / each data line goes to one XVF3800 input
Shared 3.072 MHz clock; all SELECT pins grounded. Custom firmware must use the channel order below. Frozen head-A targets: 100.000 mm left/right, 59.159 mm front/back on an 11.362 deg plane. See microphone-geometry.json and mic_geometries.fragment.yaml. Outline, package offsets and gaskets remain o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
MIC0: FRONT / array X=0.000, Y=29.647 mm; Z=0
MIC1: BACK / array X=0.000, Y=-29.512 mm; Z=0
MIC2: LEFT / array X=-50.000, Y=-0.067 mm; Z=0
MIC3: RIGHT / array X=50.000, Y=-0.067 mm; Z=0
Clock and data must remain clear of switching nodes. Keep all four acoustic openings on the same outside surface. Beamforming, voice direction and speaker echo cancellation are untested until custom firmware is loaded and tuned. GNSS antenna is not on this draft; determine antenna-module ground-pla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
