iimmyy/Little-Guy/hardware/little-guy-v2/pcb/power/01-usb-pd.kicad_sch

## KiCad design hardware/little-guy-v2/pcb/power/01-usb-pd.kicad_sch (2026-11-07)

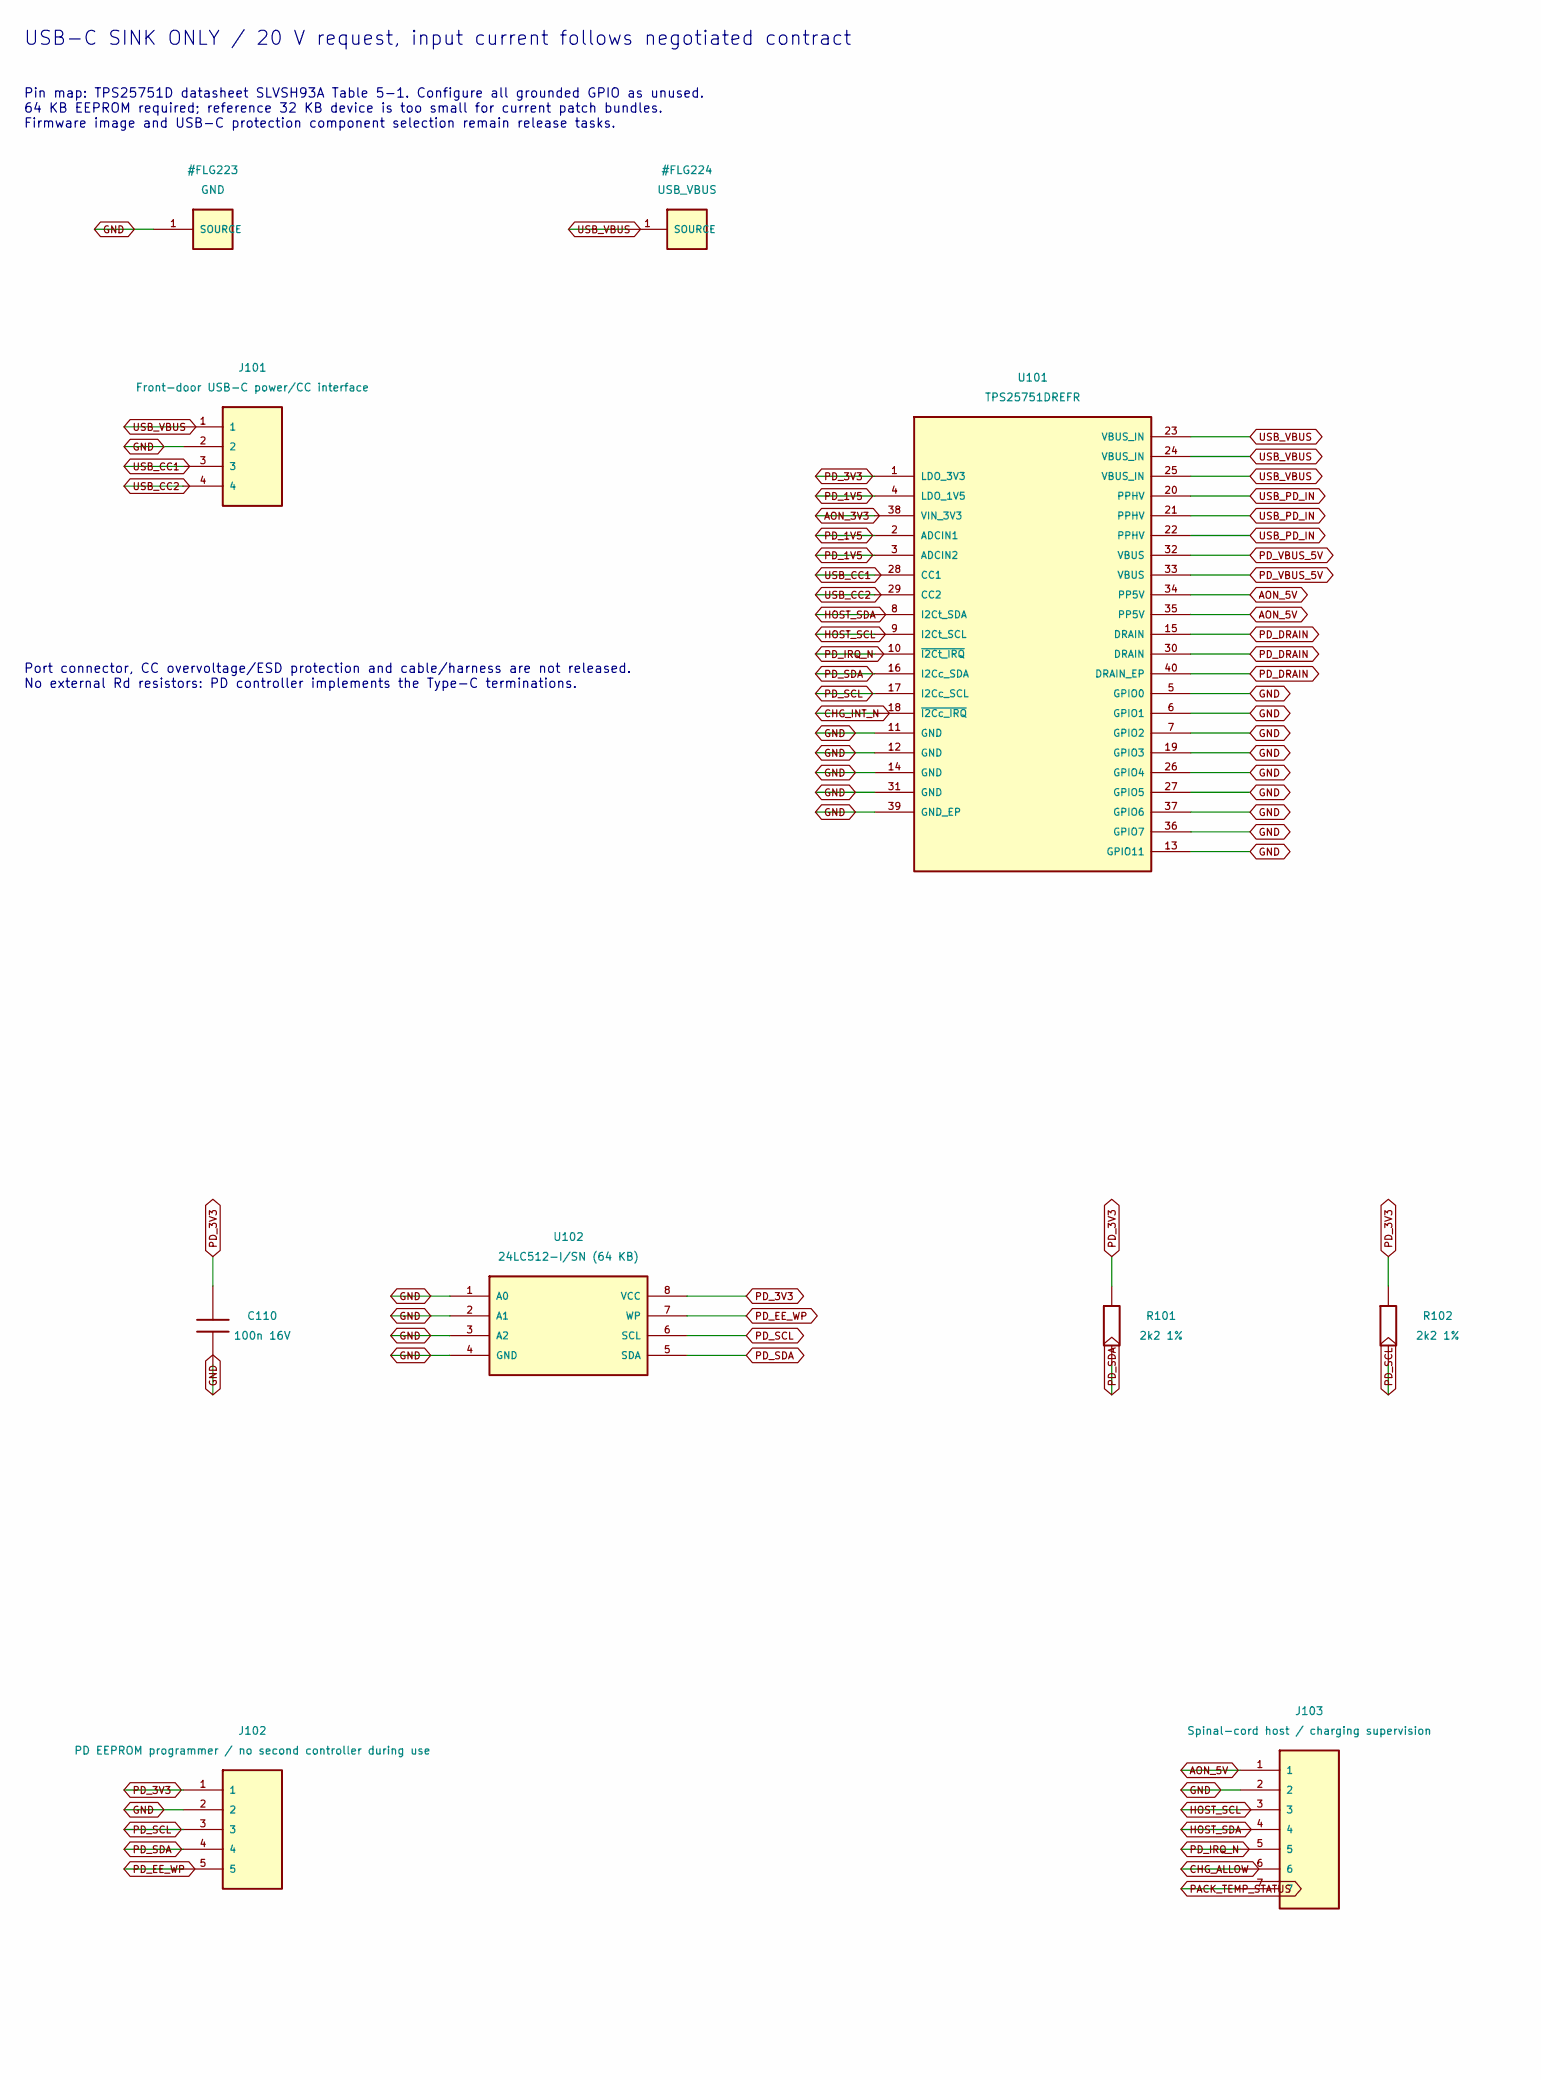
[picture p50: schematic 01-usb-pd.kicad_sch, part in row 1, column 1]

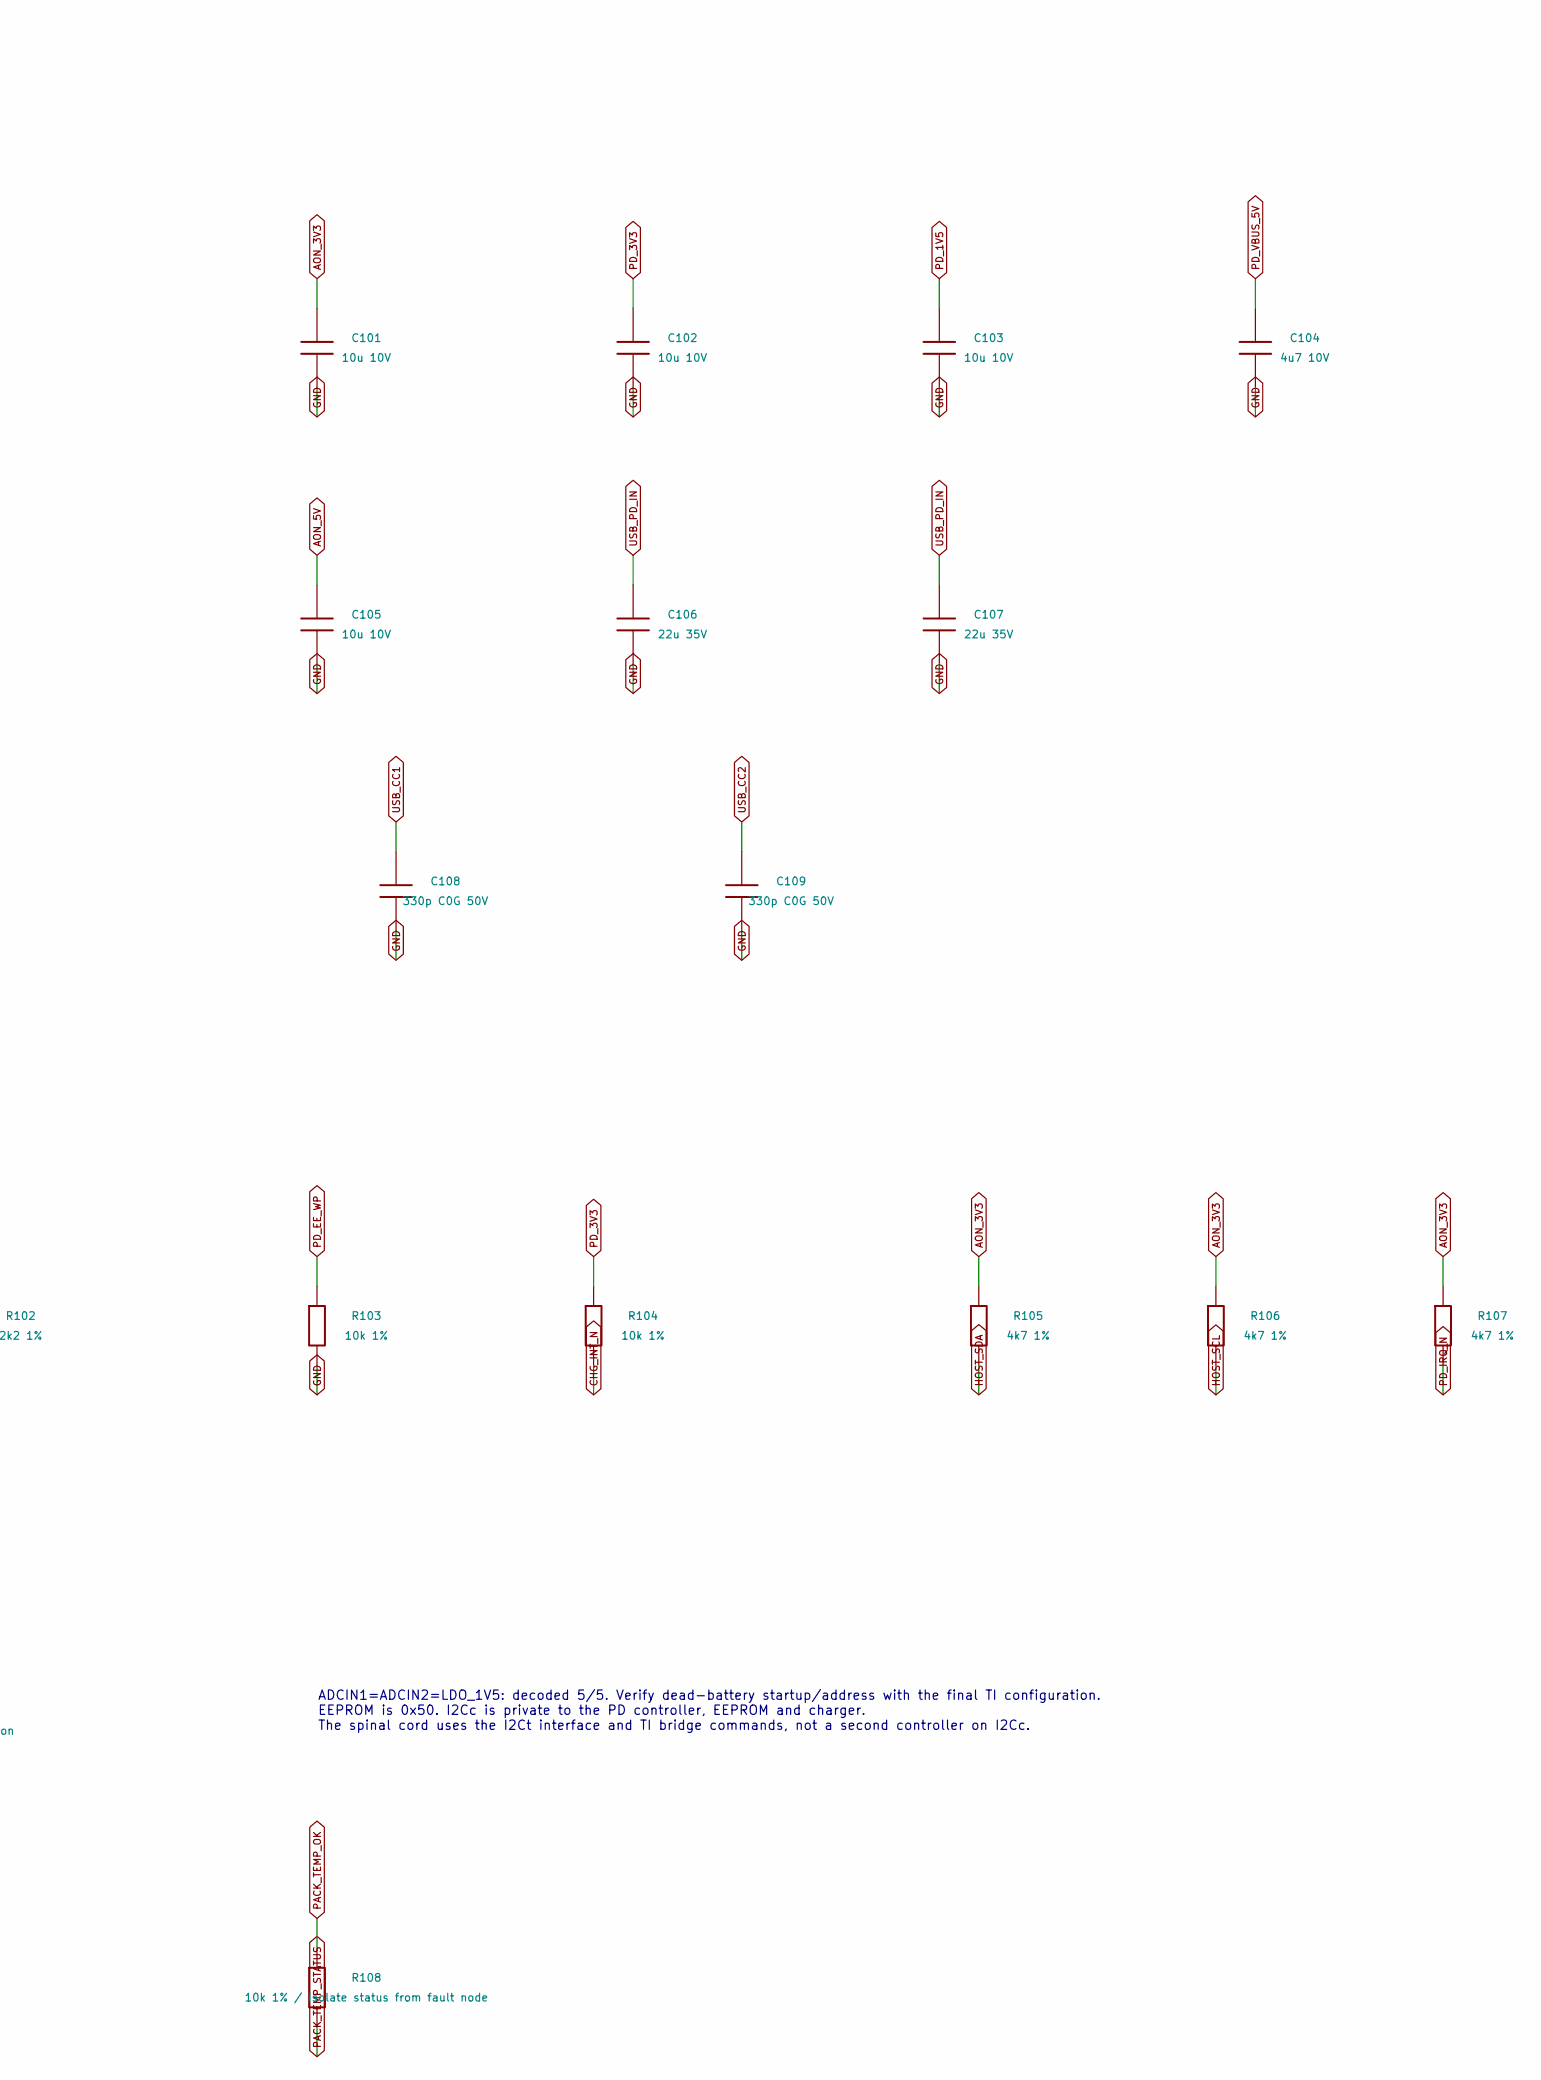
[picture p51: schematic 01-usb-pd.kicad_sch, part in row 1, column 2]

Parts:
C101, C102, C103, C105: 10u 10V; C_1206_3216Metric
C104: 4u7 10V; C_1206_3216Metric
C106, C107: 22u 35V; C_1206_3216Metric
C108, C109: 330p C0G 50V; C_0603_1608Metric
C110: 100n 16V; C_0603_1608Metric
J101: Front-door USB-C power/CC interface
J102: PD EEPROM programmer / no second controller durin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
J103: Spinal-cord host / charging supervision
R101, R102: 2k2 1%; R_0603_1608Metric
R103, R104: 10k 1%; R_0603_1608Metric
R105, R106, R107: 4k7 1%; R_0603_1608Metric
R108: 10k 1% / isolate status from fault node; R_0603_1608Metric
U101: TPS25751DREFR; MPN TPS25751DREFR
U102: 24LC512-I/SN (64 KB); SOIC-8_3.9x4.9mm_P1.27mm; MPN 24LC512-I/SN

Connections:
AON_3V3: C101.1, R105.1, R106.1, R107.1, U101.38 (VIN_3V3)
AON_5V: C105.1, J103.1, U101.34 (PP5V), U101.35 (PP5V)
CHG_ALLOW: J103.6
CHG_INT_N: R104.2, U101.18 (~I2Cc_IRQ)
GND: C101.2, C102.2, C103.2, C104.2, C105.2, C106.2, C107.2, C108.2, C109.2, C110.2, J101.2, J102.2, J103.2, R103.2, U101.5 (GPIO0), U101.6 (GPIO1), U101.7 (GPIO2), U101.11 (GND), U101.12 (GND), U101.13 (GPIO11), U101.14 (GND), U101.19 (GPIO3), U101.26 (GPIO4), U101.27 (GPIO5), U101.31 (GND), U101.36 (GPIO7), U101.37 (GPIO6), U101.39 (GND_EP), U102.1 (A0), U102.2 (A1), U102.3 (A2), U102.4 (GND)
HOST_SCL: J103.3, R106.2, U101.9 (I2Ct_SCL)
HOST_SDA: J103.4, R105.2, U101.8 (I2Ct_SDA)
PACK_TEMP_OK: R108.1
PACK_TEMP_STATUS: J103.7, R108.2
PD_1V5: C103.1, U101.2 (ADCIN1), U101.3 (ADCIN2), U101.4 (LDO_1V5)
PD_3V3: C102.1, C110.1, J102.1, R101.1, R102.1, R104.1, U101.1 (LDO_3V3), U102.8 (VCC)
PD_DRAIN: U101.15 (DRAIN), U101.30 (DRAIN), U101.40 (DRAIN_EP)
PD_EE_WP: J102.5, R103.1, U102.7 (WP)
PD_IRQ_N: J103.5, R107.2, U101.10 (~I2Ct_IRQ)
PD_SCL: J102.3, R102.2, U101.17 (I2Cc_SCL), U102.6 (SCL)
PD_SDA: J102.4, R101.2, U101.16 (I2Cc_SDA), U102.5 (SDA)
PD_VBUS_5V: C104.1, U101.32 (VBUS), U101.33 (VBUS)
USB_CC1: C108.1, J101.3, U101.28 (CC1)
USB_CC2: C109.1, J101.4, U101.29 (CC2)
USB_PD_IN: C106.1, C107.1, U101.20 (PPHV), U101.21 (PPHV), U101.22 (PPHV)
USB_VBUS: J101.1, U101.23 (VBUS_IN), U101.24 (VBUS_IN), U101.25 (VBUS_IN)

Notes on the sheet:
USB-C SINK ONLY / 20 V request, input current follows negotiated contract
Pin map: TPS25751D datasheet SLVSH93A Table 5-1. Configure all grounded GPIO as unused. 64 KB EEPROM required; reference 32 KB device is too small for current patch bundles. Firmware image and USB-C protection component selection remain release tasks.
Port connector, CC overvoltage/ESD protection and cable/harness are not released. No external Rd resistors: PD controller implements the Type-C terminations.
ADCIN1=ADCIN2=LDO_1V5: decoded 5/5. Verify dead-battery startup/address with the final TI configuration. EEPROM is 0x50. I2Cc is private to the PD controller, EEPROM and charger. The spinal cord uses the I2Ct interface and TI bridge commands, not a second controller on I2Cc.
