iimmyy/Little-Guy/hardware/little-guy-v2/pcb/power/02-charger.kicad_sch

## KiCad design hardware/little-guy-v2/pcb/power/02-charger.kicad_sch (2026-11-07)

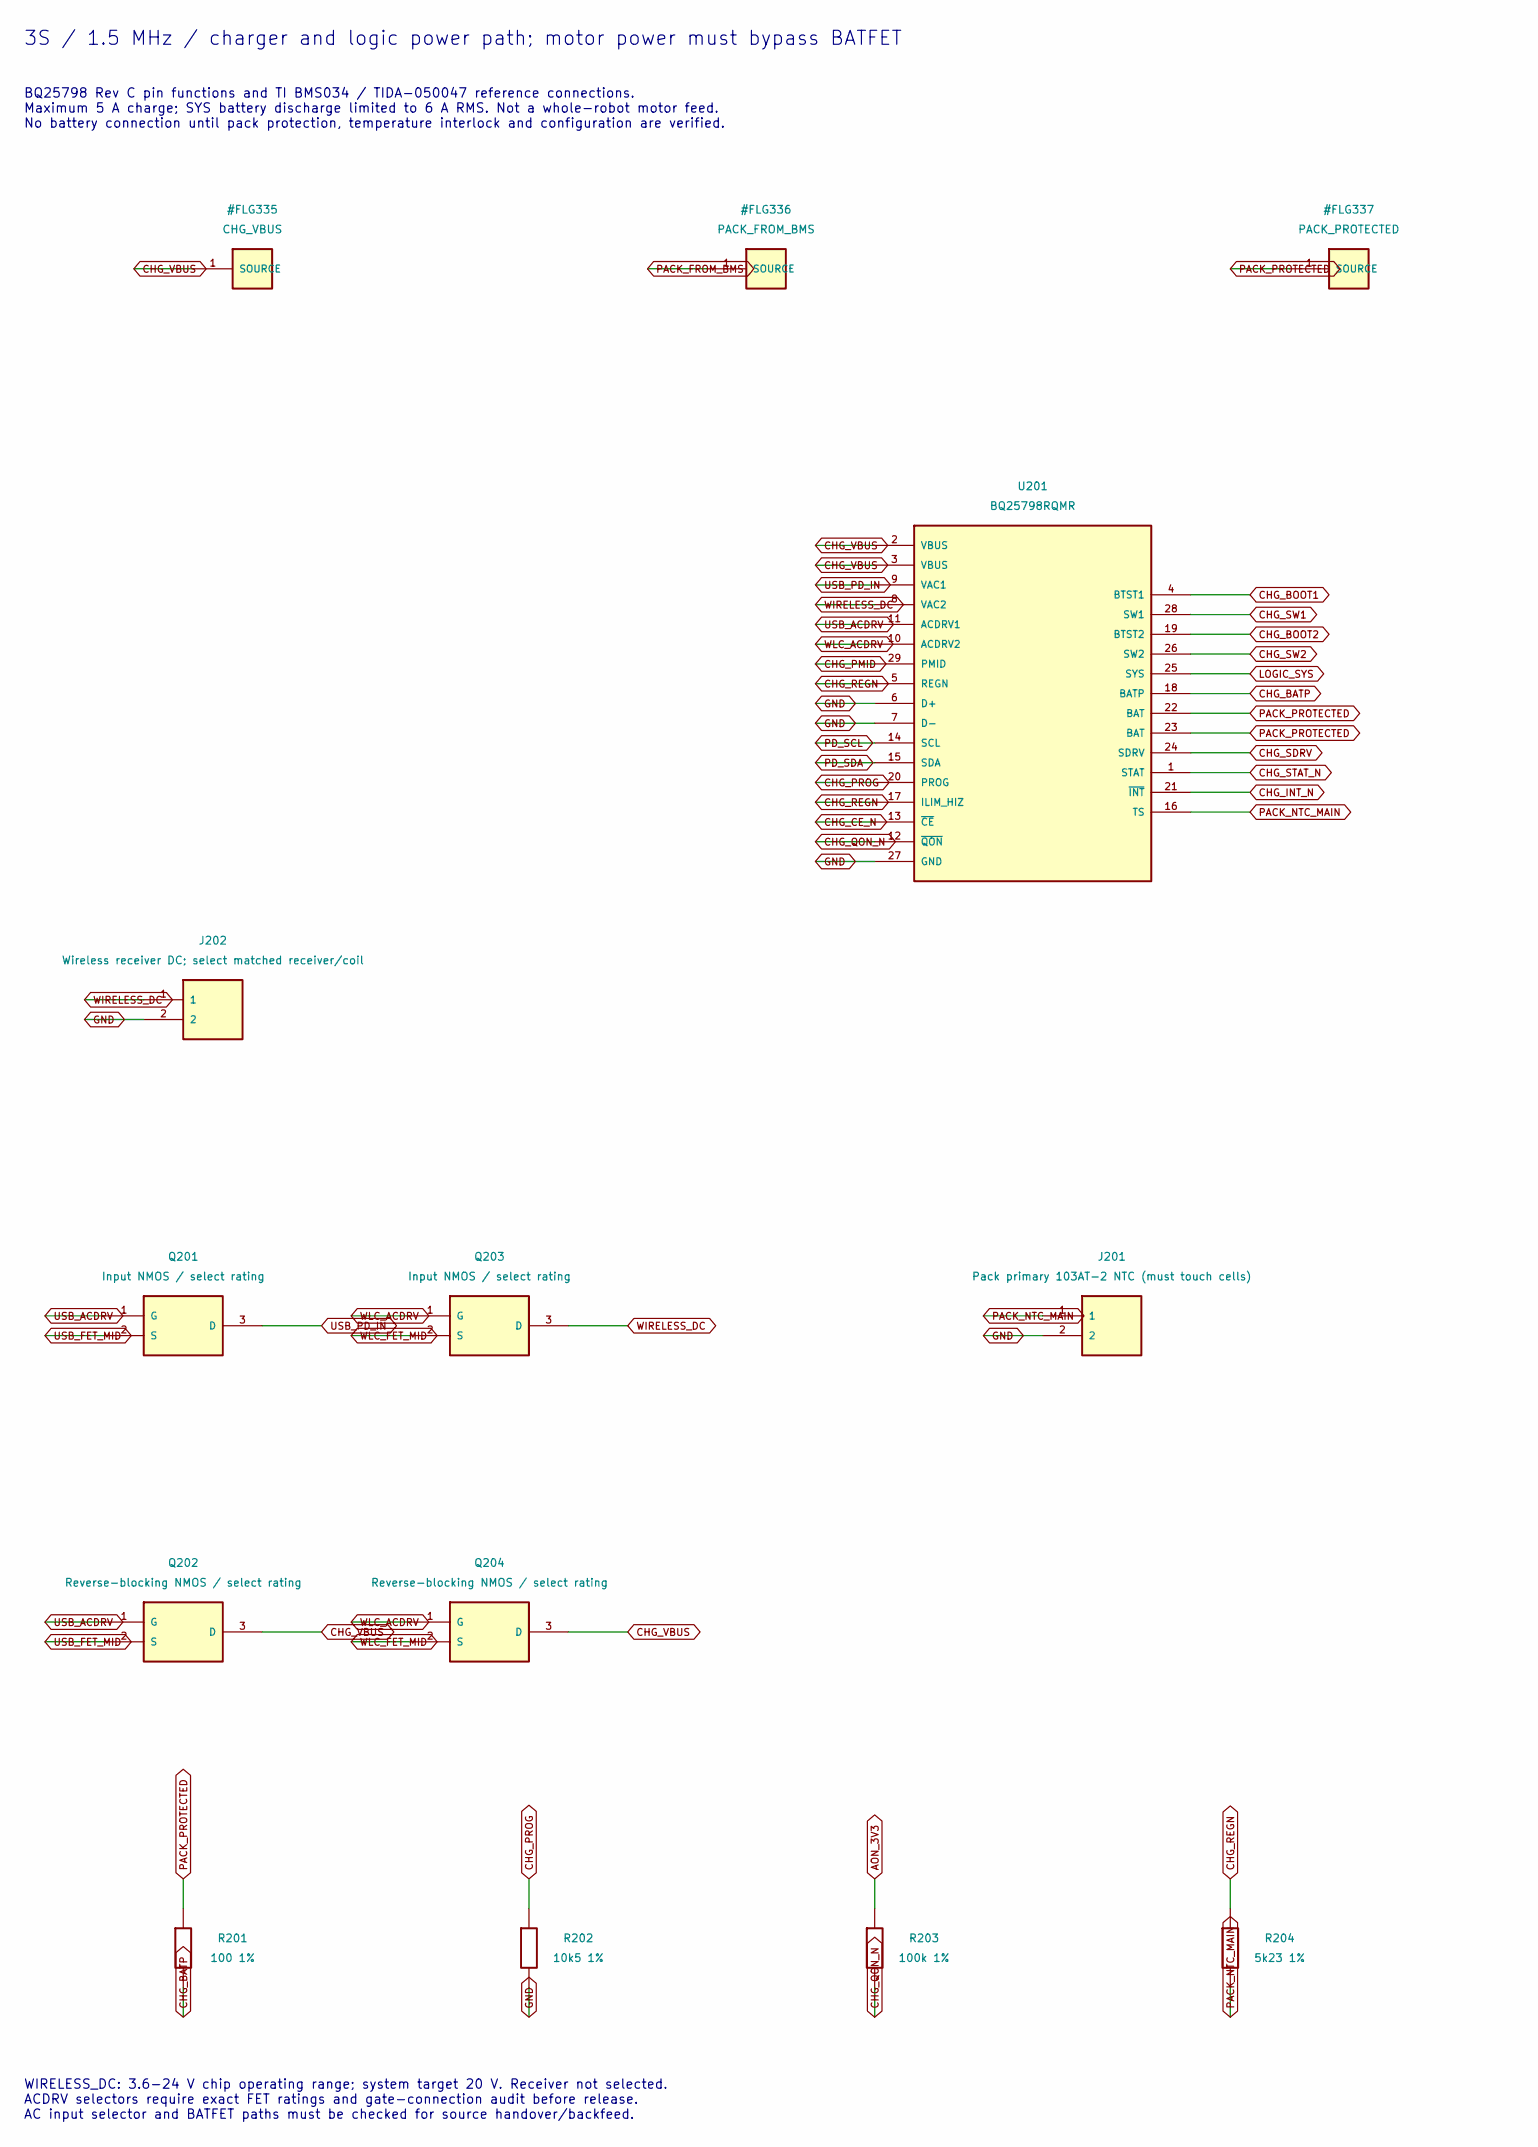
[picture p52: schematic 02-charger.kicad_sch, part in row 1, column 1]

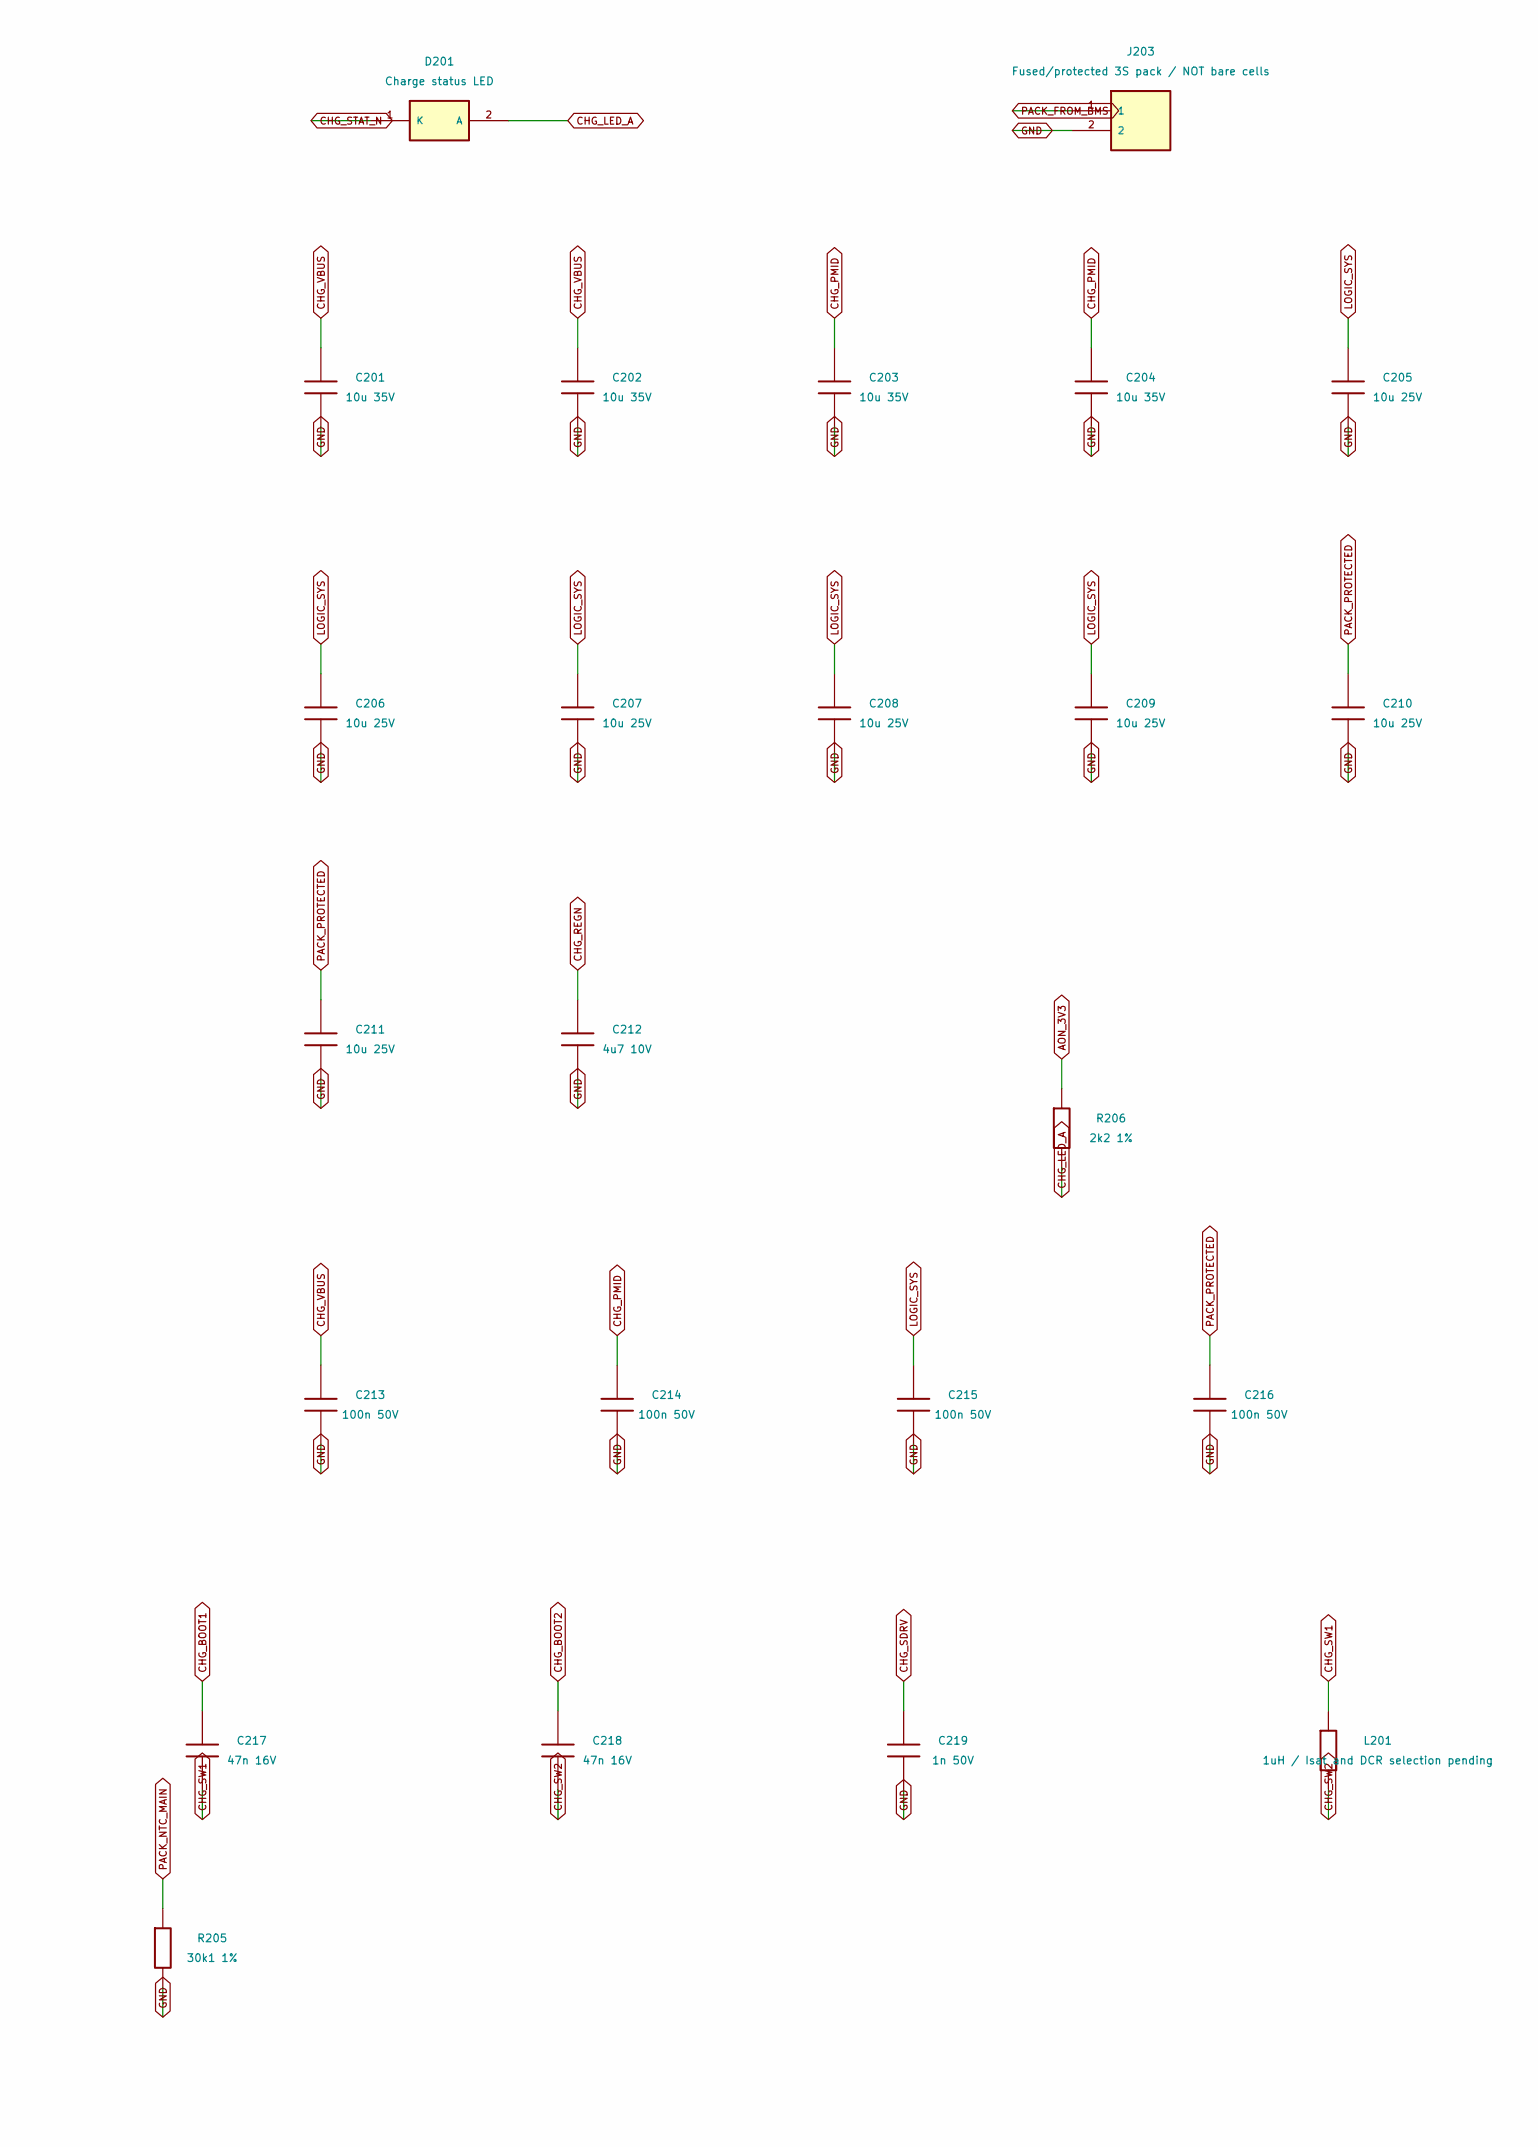
[picture p53: schematic 02-charger.kicad_sch, part in row 1, column 2]

Parts:
C201, C202, C203, C204: 10u 35V; C_1206_3216Metric
C205, C206, C207, C208, C209, C210, C211: 10u 25V; C_1206_3216Metric
C212: 4u7 10V; C_1206_3216Metric
C213, C214, C215, C216: 100n 50V; C_0603_1608Metric
C217, C218: 47n 16V; C_0603_1608Metric
C219: 1n 50V; C_0603_1608Metric
D201: Charge status LED
J201: Pack primary 103AT-2 NTC (must touch cells)
J202: Wireless receiver DC; select matched receiver/coil
J203: Fused/protected 3S pack / NOT bare cells
L201: 1uH / Isat and DCR selection pending
Q201, Q203: Input NMOS / select rating
Q202, Q204: Reverse-blocking NMOS / select rating
R201: 100 1%; R_0603_1608Metric
R202: 10k5 1%; R_0603_1608Metric
R203: 100k 1%; R_0603_1608Metric
R204: 5k23 1%; R_0603_1608Metric
R205: 30k1 1%; R_0603_1608Metric
R206: 2k2 1%; R_0603_1608Metric
U201: BQ25798RQMR; MPN BQ25798RQMR

Connections:
AON_3V3: R203.1, R206.1
CHG_BATP: R201.2, U201.18 (BATP)
CHG_BOOT1: C217.1, U201.4 (BTST1)
CHG_BOOT2: C218.1, U201.19 (BTST2)
CHG_CE_N: U201.13 (~CE)
CHG_INT_N: U201.21 (~INT)
CHG_LED_A: D201.2 (A), R206.2
CHG_PMID: C203.1, C204.1, C214.1, U201.29 (PMID)
CHG_PROG: R202.1, U201.20 (PROG)
CHG_QON_N: R203.2, U201.12 (~QON)
CHG_REGN: C212.1, R204.1, U201.5 (REGN), U201.17 (ILIM_HIZ)
CHG_SDRV: C219.1, U201.24 (SDRV)
CHG_STAT_N: D201.1 (K), U201.1 (STAT)
CHG_SW1: C217.2, L201.1, U201.28 (SW1)
CHG_SW2: C218.2, L201.2, U201.26 (SW2)
CHG_VBUS: C201.1, C202.1, C213.1, Q202.3 (D), Q204.3 (D), U201.2 (VBUS), U201.3 (VBUS)
GND: C201.2, C202.2, C203.2, C204.2, C205.2, C206.2, C207.2, C208.2, C209.2, C210.2, C211.2, C212.2, C213.2, C214.2, C215.2, C216.2, C219.2, J201.2, J202.2, J203.2, R202.2, R205.2, U201.6 (D+), U201.7 (D-), U201.27 (GND)
LOGIC_SYS: C205.1, C206.1, C207.1, C208.1, C209.1, C215.1, U201.25 (SYS)
PACK_FROM_BMS: J203.1
PACK_NTC_MAIN: J201.1, R204.2, R205.1, U201.16 (TS)
PACK_PROTECTED: C210.1, C211.1, C216.1, R201.1, U201.22 (BAT), U201.23 (BAT)
PD_SCL: U201.14 (SCL)
PD_SDA: U201.15 (SDA)
USB_ACDRV: Q201.1 (G), Q202.1 (G), U201.11 (ACDRV1)
USB_FET_MID: Q201.2 (S), Q202.2 (S)
USB_PD_IN: Q201.3 (D), U201.9 (VAC1)
WIRELESS_DC: J202.1, Q203.3 (D), U201.8 (VAC2)
WLC_ACDRV: Q203.1 (G), Q204.1 (G), U201.10 (ACDRV2)
WLC_FET_MID: Q203.2 (S), Q204.2 (S)

Notes on the sheet:
3S / 1.5 MHz / charger and logic power path; motor power must bypass BATFET
BQ25798 Rev C pin functions and TI BMS034 / TIDA-050047 reference connections. Maximum 5 A charge; SYS battery discharge limited to 6 A RMS. Not a whole-robot motor feed. No battery connection until pack protection, temperature interlock and configuration are verified.
WIRELESS_DC: 3.6-24 V chip operating range; system target 20 V. Receiver not selected. ACDRV selectors require exact FET ratings and gate-connection audit before release. AC input selector and BATFET paths must be checked for source handover/backfeed.
