iimmyy/Little-Guy/hardware/little-guy-v2/pcb/power/03-housekeeping.kicad_sch

## KiCad design hardware/little-guy-v2/pcb/power/03-housekeeping.kicad_sch (2026-11-07)

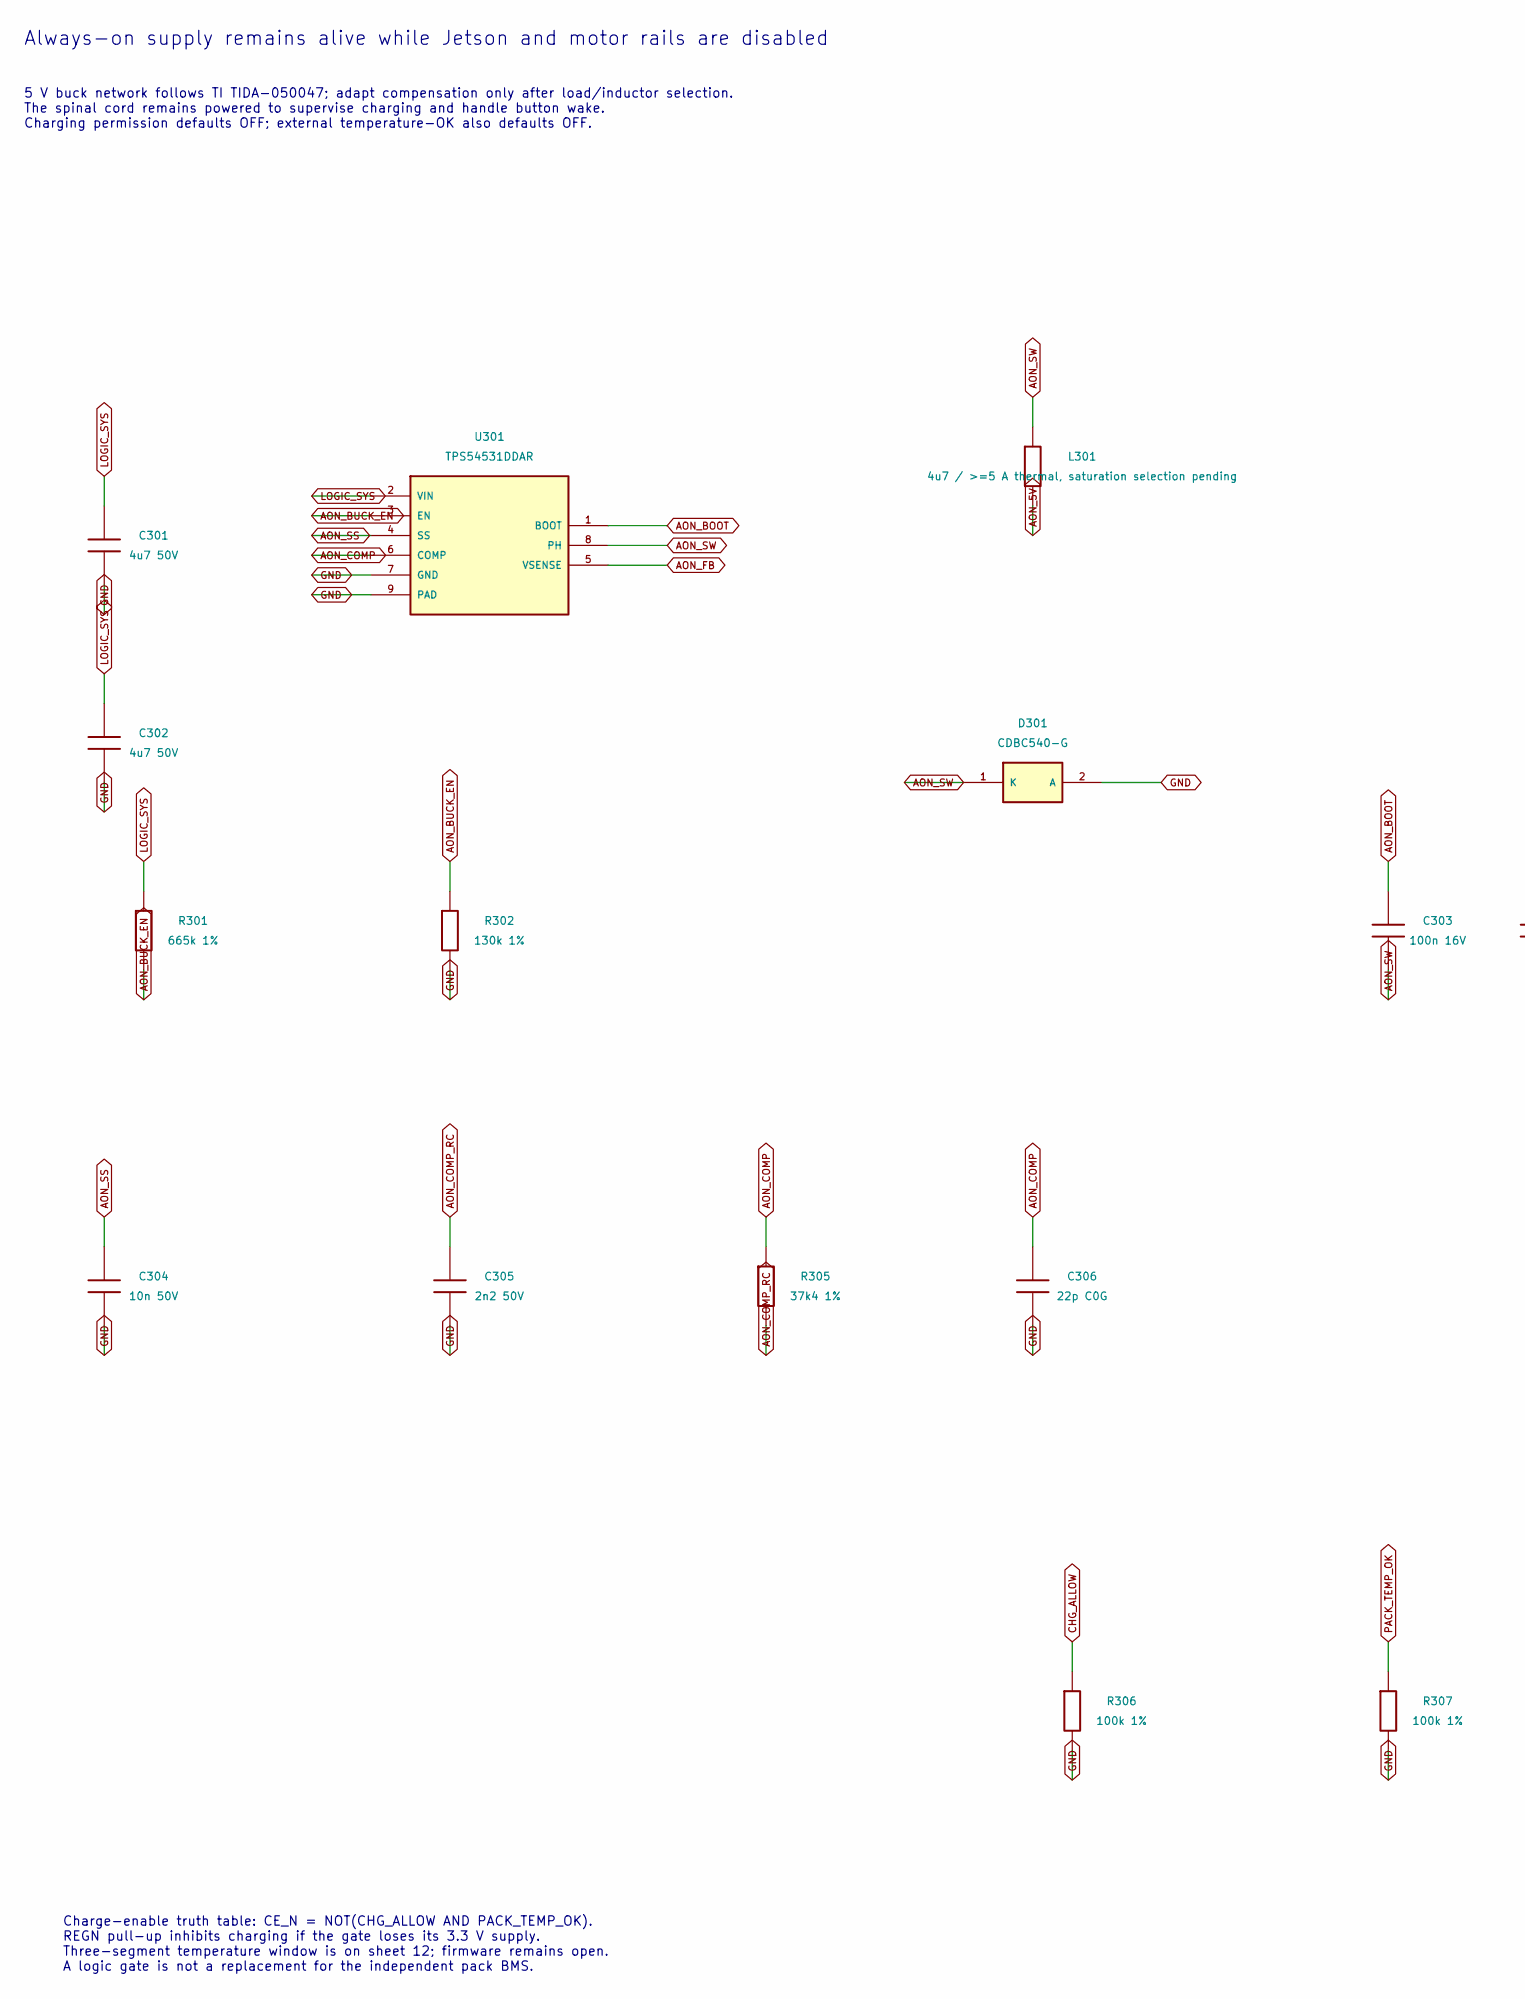
[picture p54: schematic 03-housekeeping.kicad_sch, part in row 1, column 1]

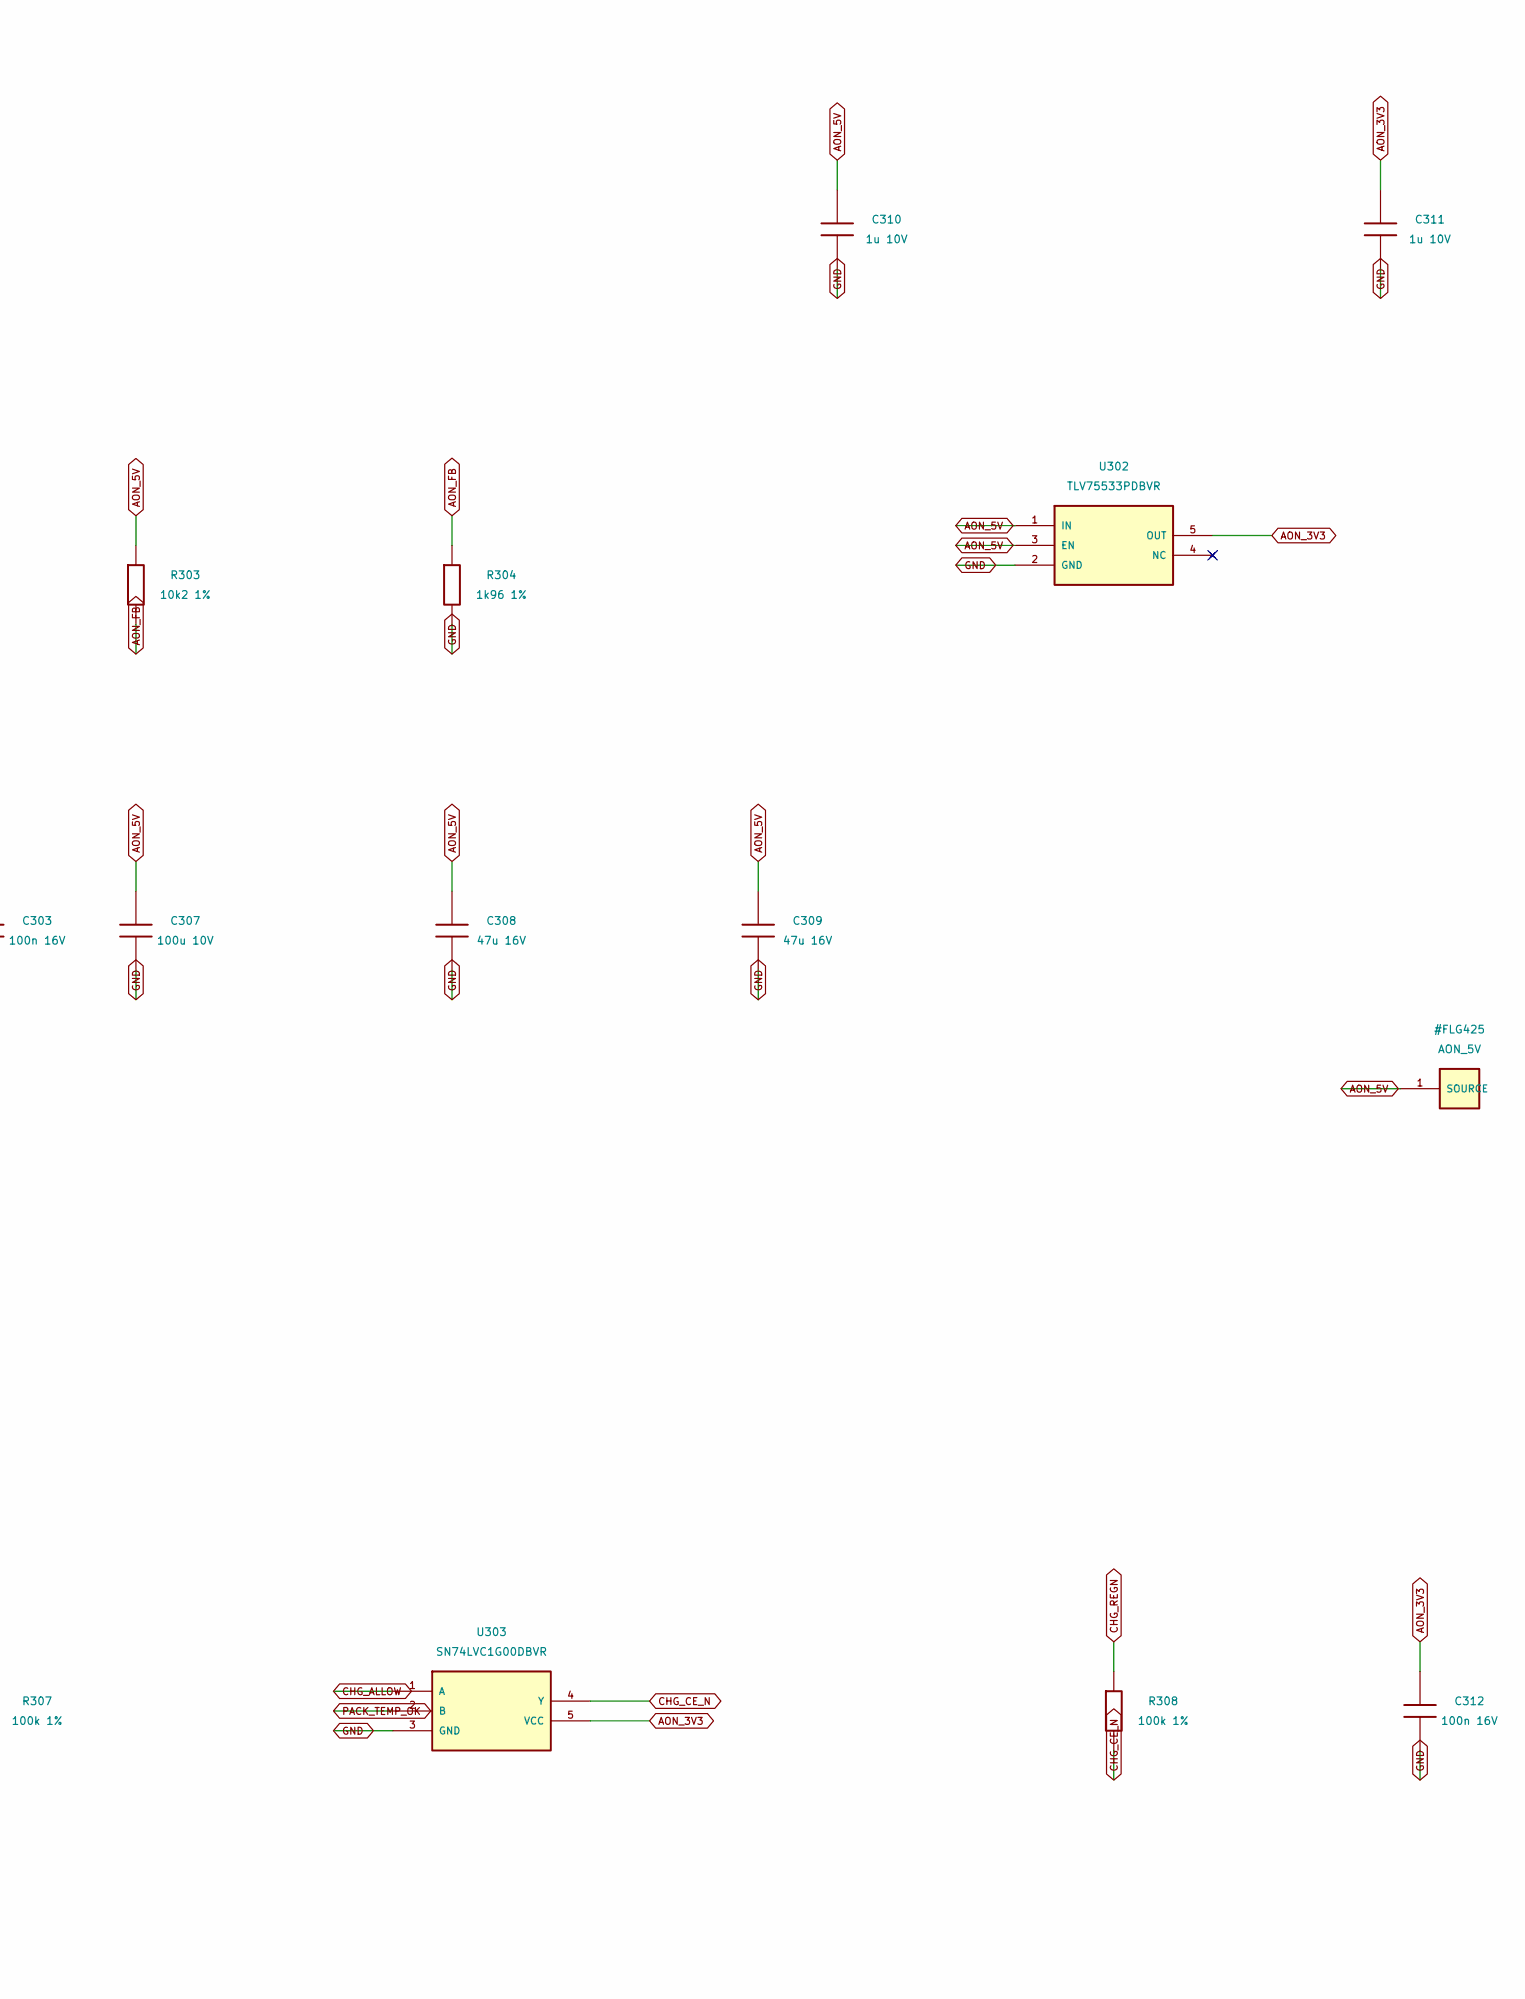
[picture p55: schematic 03-housekeeping.kicad_sch, part in row 1, column 2]

Parts:
C301, C302: 4u7 50V; C_1206_3216Metric
C303, C312: 100n 16V; C_0603_1608Metric
C304: 10n 50V; C_0603_1608Metric
C305: 2n2 50V; C_0603_1608Metric
C306: 22p C0G; C_0603_1608Metric
C307: 100u 10V; C_1206_3216Metric
C308, C309: 47u 16V; C_1206_3216Metric
C310, C311: 1u 10V; C_0603_1608Metric
D301: CDBC540-G; D_SMC; MPN CDBC540-G
L301: 4u7 / >=5 A thermal, saturation selection pending
R301: 665k 1%; R_0603_1608Metric
R302: 130k 1%; R_0603_1608Metric
R303: 10k2 1%; R_0603_1608Metric
R304: 1k96 1%; R_0603_1608Metric
R305: 37k4 1%; R_0603_1608Metric
R306, R307, R308: 100k 1%; R_0603_1608Metric
U301: TPS54531DDAR; SOIC-8-1EP_3.9x4.9mm_P1.27mm_EP2.29x3mm; MPN TPS54531DDAR
U302: TLV75533PDBVR; SOT-23-5; MPN TLV75533PDBVR
U303: SN74LVC1G00DBVR; SOT-23-5; MPN SN74LVC1G00DBVR

Connections:
AON_3V3: C311.1, C312.1, U302.5 (OUT), U303.5 (VCC)
AON_5V: C307.1, C308.1, C309.1, C310.1, L301.2, R303.1, U302.1 (IN), U302.3 (EN)
AON_BOOT: C303.1, U301.1 (BOOT)
AON_BUCK_EN: R301.2, R302.1, U301.3 (EN)
AON_COMP: C306.1, R305.1, U301.6 (COMP)
AON_COMP_RC: C305.1, R305.2
AON_FB: R303.2, R304.1, U301.5 (VSENSE)
AON_SS: C304.1, U301.4 (SS)
AON_SW: C303.2, D301.1 (K), L301.1, U301.8 (PH)
CHG_ALLOW: R306.1, U303.1 (A)
CHG_CE_N: R308.2, U303.4 (Y)
CHG_REGN: R308.1
GND: C301.2, C302.2, C304.2, C305.2, C306.2, C307.2, C308.2, C309.2, C310.2, C311.2, C312.2, D301.2 (A), R302.2, R304.2, R306.2, R307.2, U301.7 (GND), U301.9 (PAD), U302.2 (GND), U303.3 (GND)
LOGIC_SYS: C301.1, C302.1, R301.1, U301.2 (VIN)
PACK_TEMP_OK: R307.1, U303.2 (B)

Notes on the sheet:
Always-on supply remains alive while Jetson and motor rails are disabled
5 V buck network follows TI TIDA-050047; adapt compensation only after load/inductor selection. The spinal cord remains powered to supervise charging and handle button wake. Charging permission defaults OFF; external temperature-OK also defaults OFF.
Charge-enable truth table: CE_N = NOT(CHG_ALLOW AND PACK_TEMP_OK). REGN pull-up inhibits charging if the gate loses its 3.3 V supply. Three-segment temperature window is on sheet 12; firmware remains open. A logic gate is not a replacement for the independent pack BMS.
