iimmyy/Little-Guy/hardware/little-guy-v2/pcb/power/04-motor-controller.kicad_sch

## KiCad design hardware/little-guy-v2/pcb/power/04-motor-controller.kicad_sch (2026-11-07)

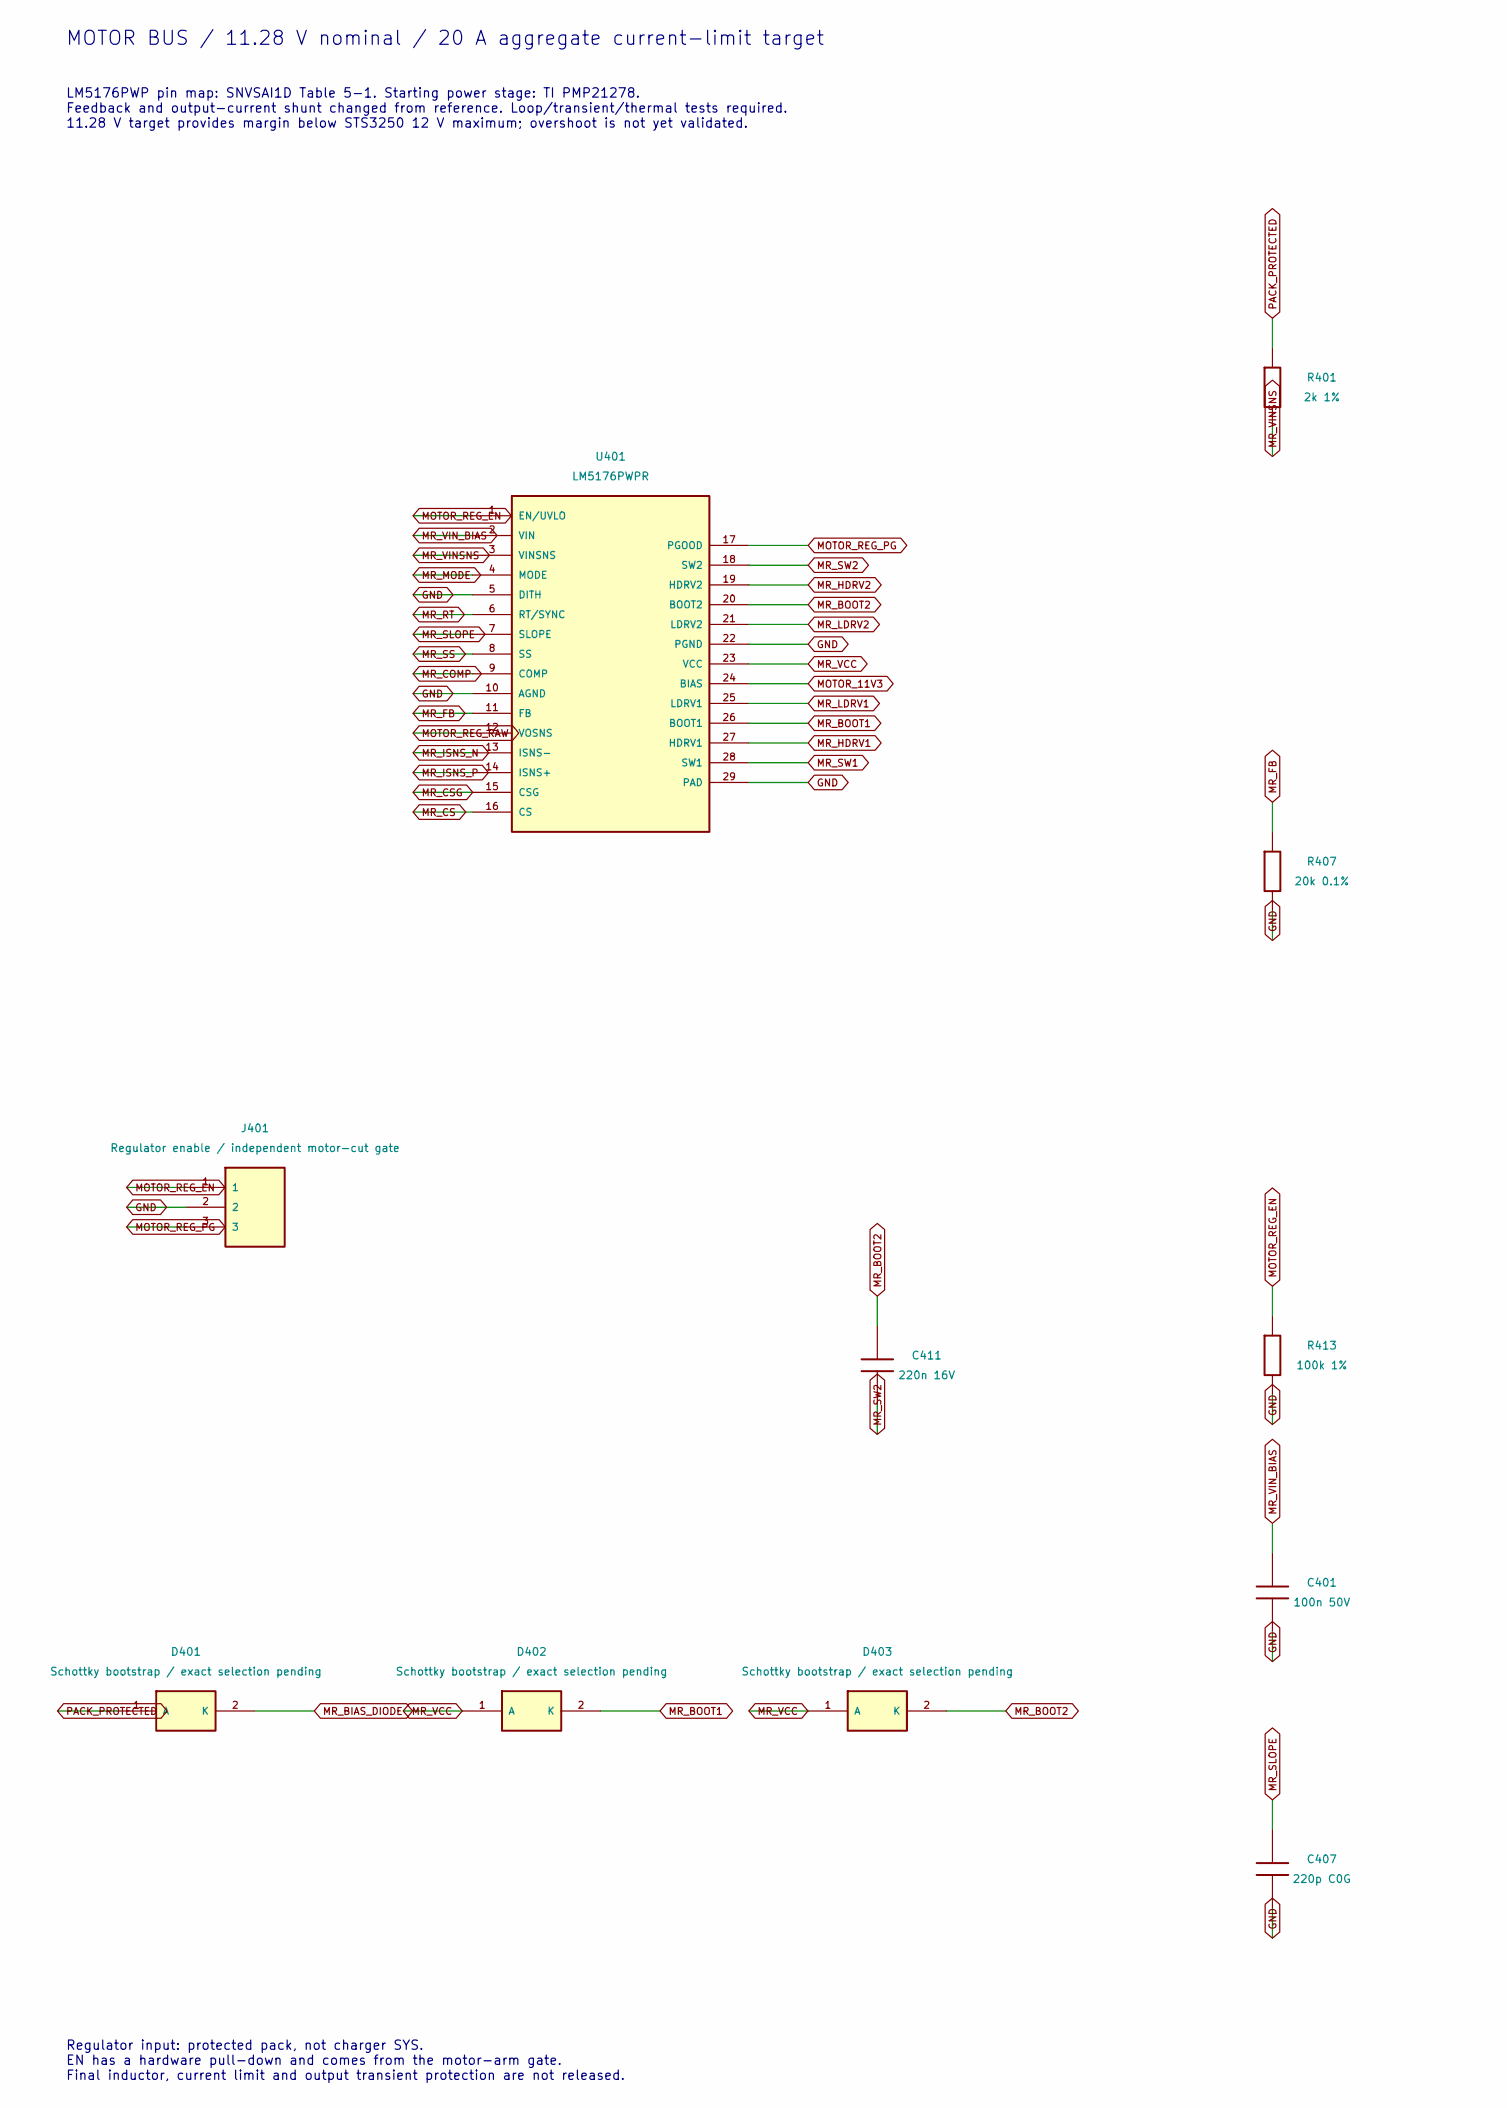
[picture p56: schematic 04-motor-controller.kicad_sch, part in row 1, column 1]

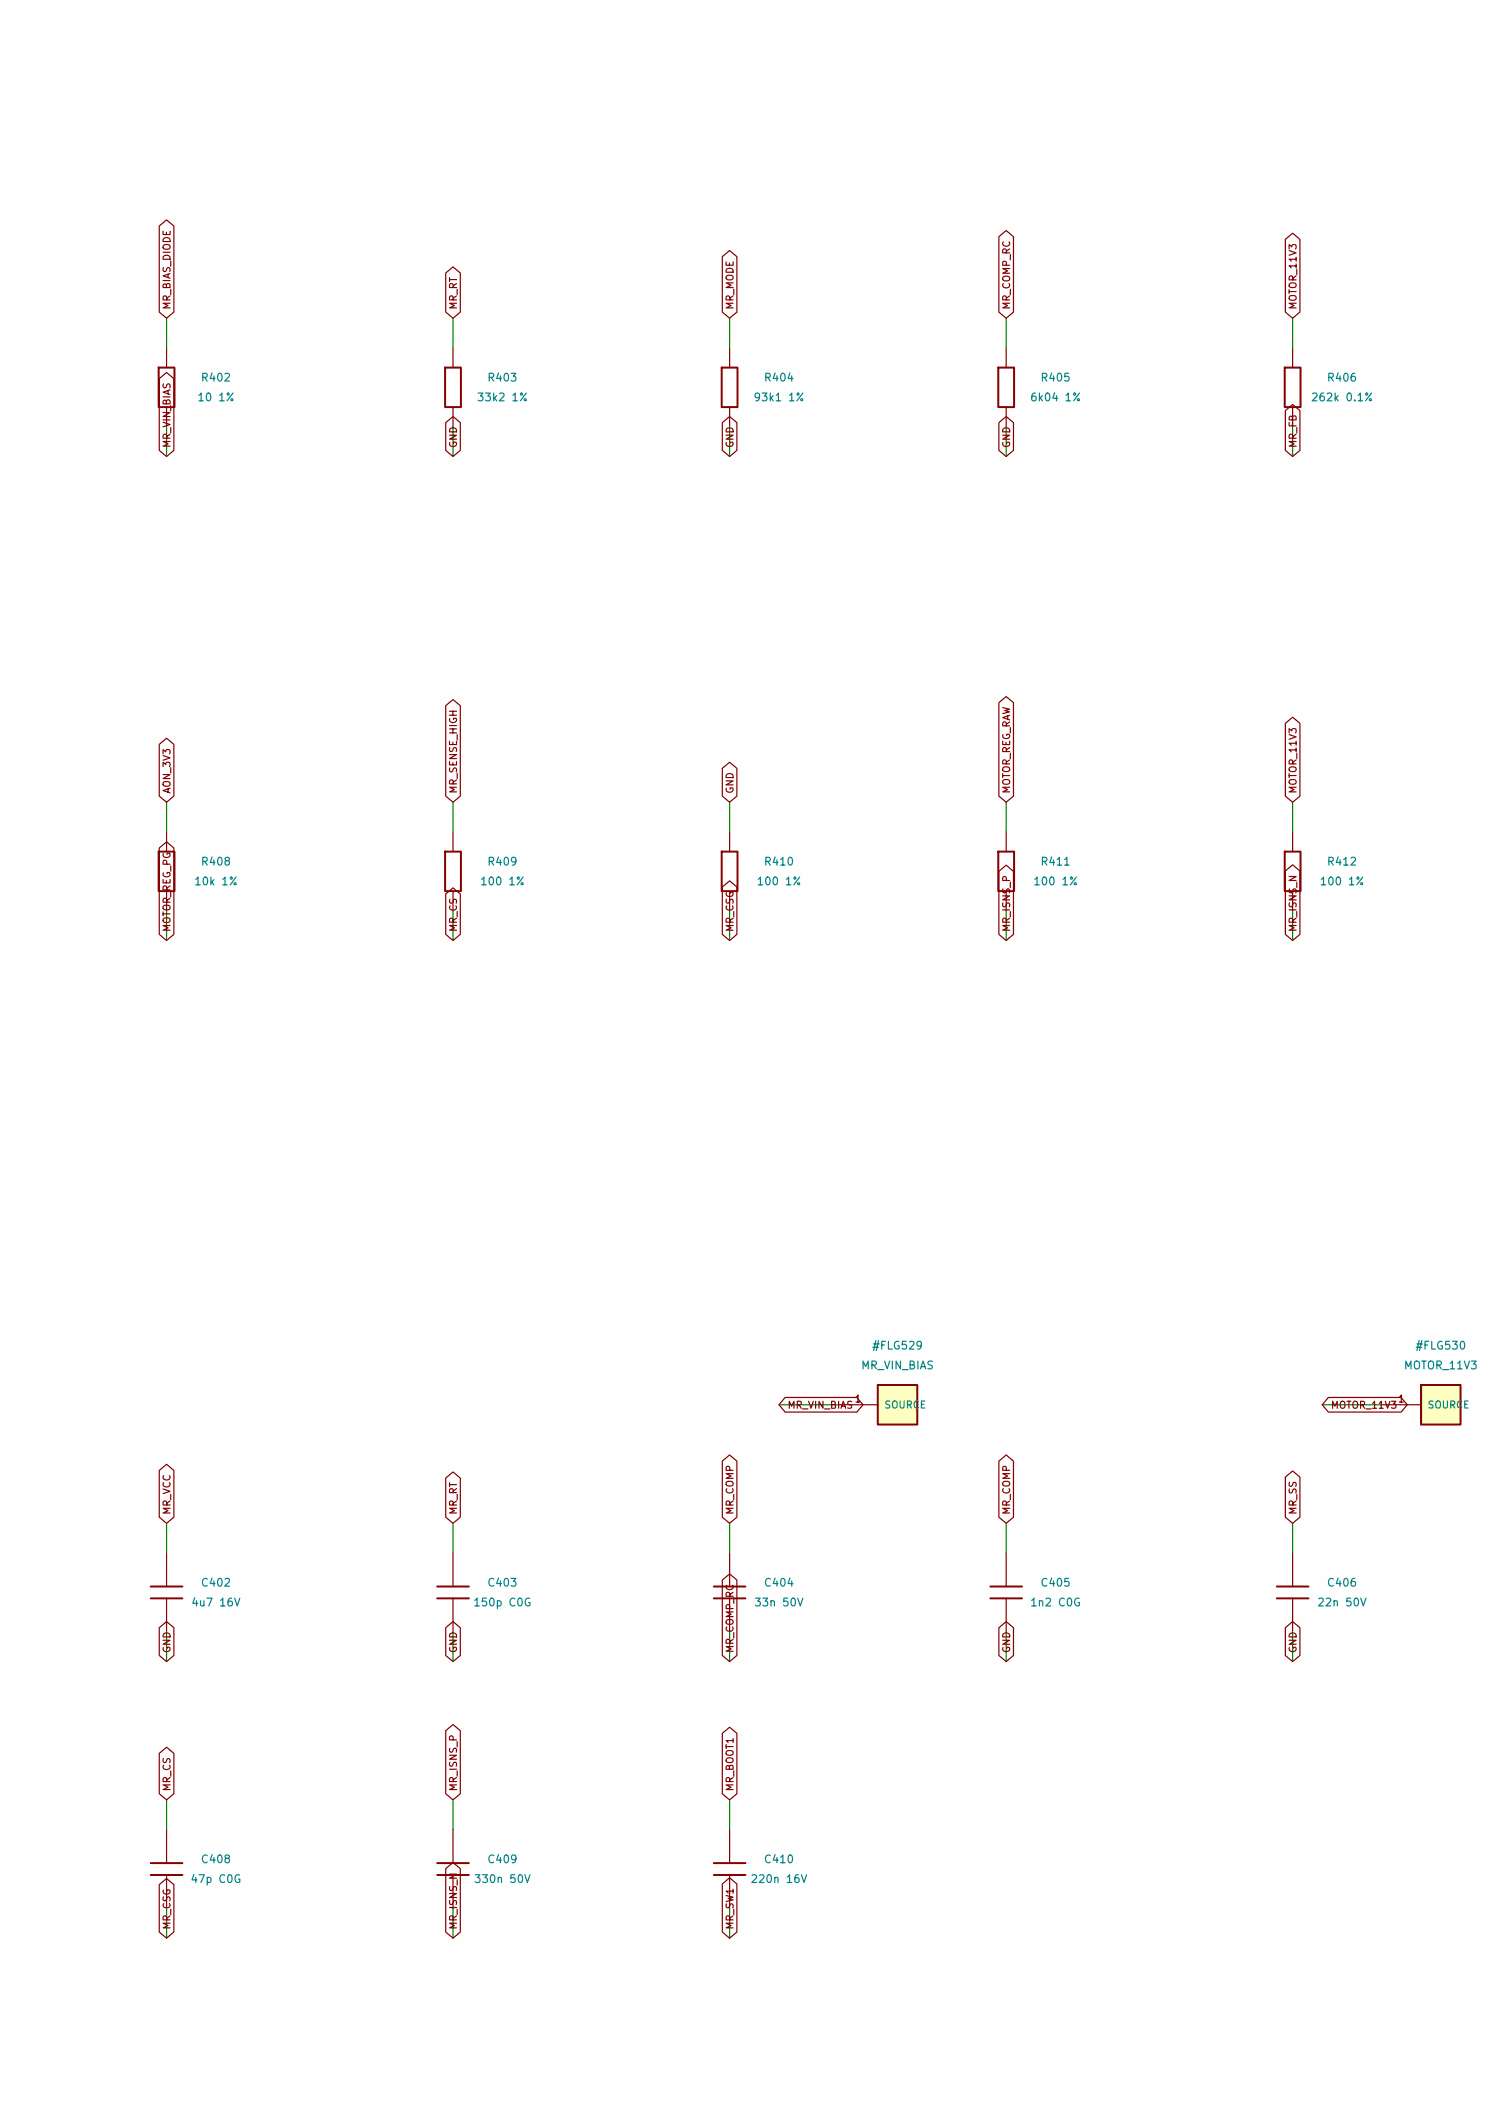
[picture p57: schematic 04-motor-controller.kicad_sch, part in row 1, column 2]

Parts:
C401: 100n 50V; C_0603_1608Metric
C402: 4u7 16V; C_0603_1608Metric
C403: 150p C0G; C_0603_1608Metric
C404: 33n 50V; C_0603_1608Metric
C405: 1n2 C0G; C_0603_1608Metric
C406: 22n 50V; C_0603_1608Metric
C407: 220p C0G; C_0603_1608Metric
C408: 47p C0G; C_0603_1608Metric
C409: 330n 50V; C_0603_1608Metric
C410, C411: 220n 16V; C_0603_1608Metric
D401, D402, D403: Schottky bootstrap / exact selection pending
J401: Regulator enable / independent motor-cut gate
R401: 2k 1%; R_0603_1608Metric
R402: 10 1%; R_0603_1608Metric
R403: 33k2 1%; R_0603_1608Metric
R404: 93k1 1%; R_0603_1608Metric
R405: 6k04 1%; R_0603_1608Metric
R406: 262k 0.1%; R_0603_1608Metric
R407: 20k 0.1%; R_0603_1608Metric
R408: 10k 1%; R_0603_1608Metric
R409, R410, R411, R412: 100 1%; R_0603_1608Metric
R413: 100k 1%; R_0603_1608Metric
U401: LM5176PWPR; MPN LM5176PWPR

Connections:
AON_3V3: R408.1
GND: C401.2, C402.2, C403.2, C405.2, C406.2, C407.2, J401.2, R403.2, R404.2, R405.2, R407.2, R410.1, R413.2, U401.5 (DITH), U401.10 (AGND), U401.22 (PGND), U401.29 (PAD)
MOTOR_11V3: R406.1, R412.1, U401.24 (BIAS)
MOTOR_REG_EN: J401.1, R413.1, U401.1 (EN/UVLO)
MOTOR_REG_PG: J401.3, R408.2, U401.17 (PGOOD)
MOTOR_REG_RAW: R411.1, U401.12 (VOSNS)
MR_BIAS_DIODE: D401.2 (K), R402.1
MR_BOOT1: C410.1, D402.2 (K), U401.26 (BOOT1)
MR_BOOT2: C411.1, D403.2 (K), U401.20 (BOOT2)
MR_COMP: C404.1, C405.1, U401.9 (COMP)
MR_COMP_RC: C404.2, R405.1
MR_CS: C408.1, R409.2, U401.16 (CS)
MR_CSG: C408.2, R410.2, U401.15 (CSG)
MR_FB: R406.2, R407.1, U401.11 (FB)
MR_HDRV1: U401.27 (HDRV1)
MR_HDRV2: U401.19 (HDRV2)
MR_ISNS_N: C409.2, R412.2, U401.13 (ISNS-)
MR_ISNS_P: C409.1, R411.2, U401.14 (ISNS+)
MR_LDRV1: U401.25 (LDRV1)
MR_LDRV2: U401.21 (LDRV2)
MR_MODE: R404.1, U401.4 (MODE)
MR_RT: C403.1, R403.1, U401.6 (RT/SYNC)
MR_SENSE_HIGH: R409.1
MR_SLOPE: C407.1, U401.7 (SLOPE)
MR_SS: C406.1, U401.8 (SS)
MR_SW1: C410.2, U401.28 (SW1)
MR_SW2: C411.2, U401.18 (SW2)
MR_VCC: C402.1, D402.1 (A), D403.1 (A), U401.23 (VCC)
MR_VINSNS: R401.2, U401.3 (VINSNS)
MR_VIN_BIAS: C401.1, R402.2, U401.2 (VIN)
PACK_PROTECTED: D401.1 (A), R401.1

Notes on the sheet:
MOTOR BUS / 11.28 V nominal / 20 A aggregate current-limit target
LM5176PWP pin map: SNVSAI1D Table 5-1. Starting power stage: TI PMP21278. Feedback and output-current shunt changed from reference. Loop/transient/thermal tests required. 11.28 V target provides margin below STS3250 12 V maximum; overshoot is not yet validated.
Regulator input: protected pack, not charger SYS. EN has a hardware pull-down and comes from the motor-arm gate. Final inductor, current limit and output transient protection are not released.
