iimmyy/Little-Guy/hardware/little-guy-v2/pcb/power/05-motor-bridge.kicad_sch

## KiCad design hardware/little-guy-v2/pcb/power/05-motor-bridge.kicad_sch (2026-11-07)

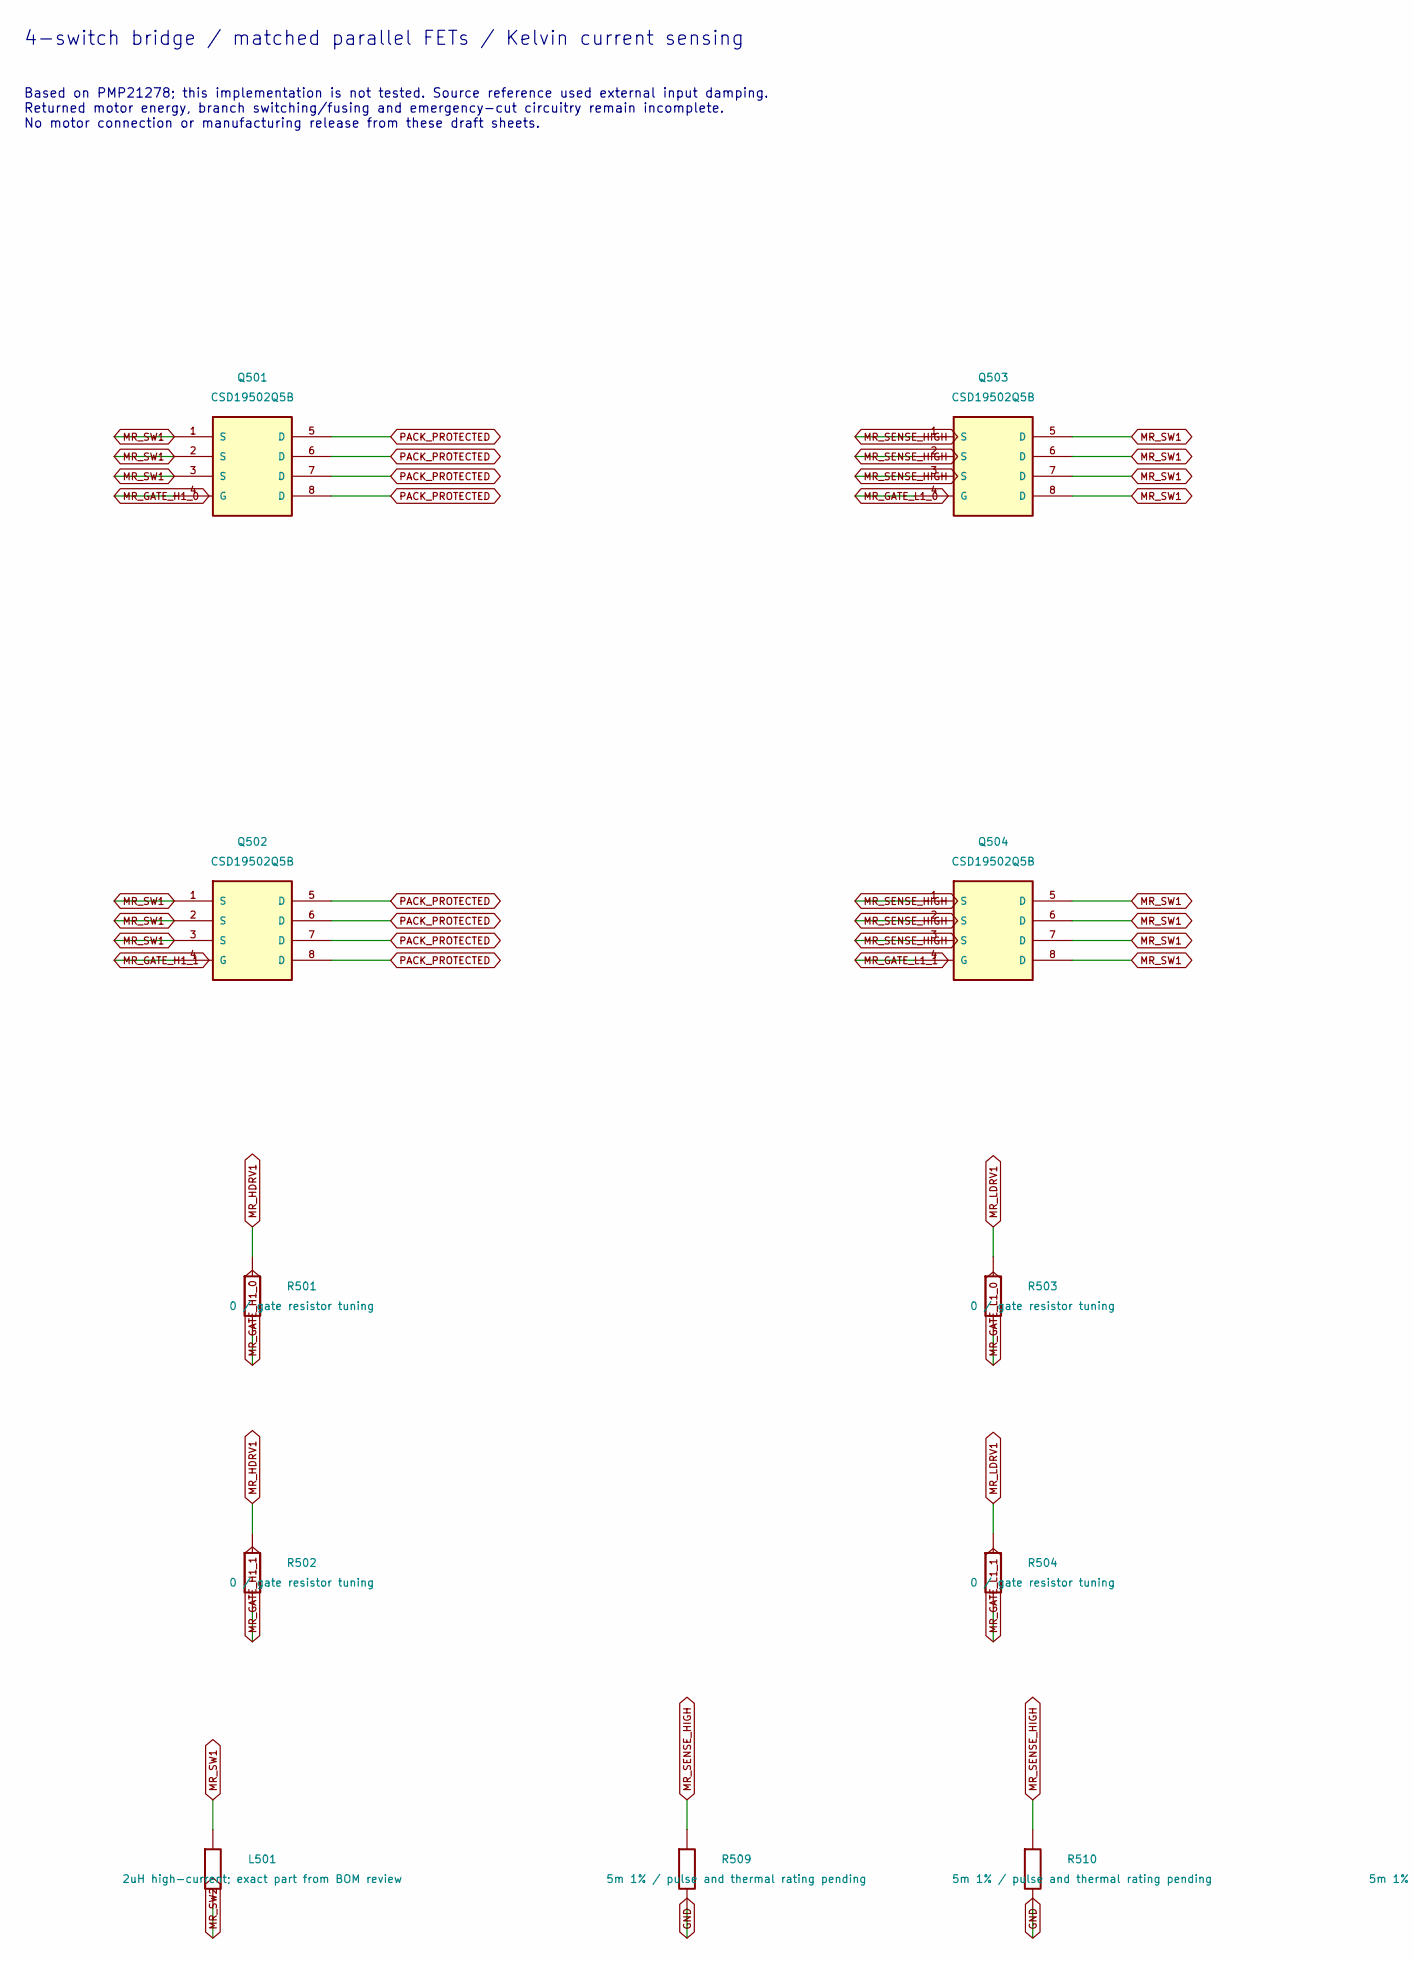
[picture p58: schematic 05-motor-bridge.kicad_sch, part in row 1, column 1]

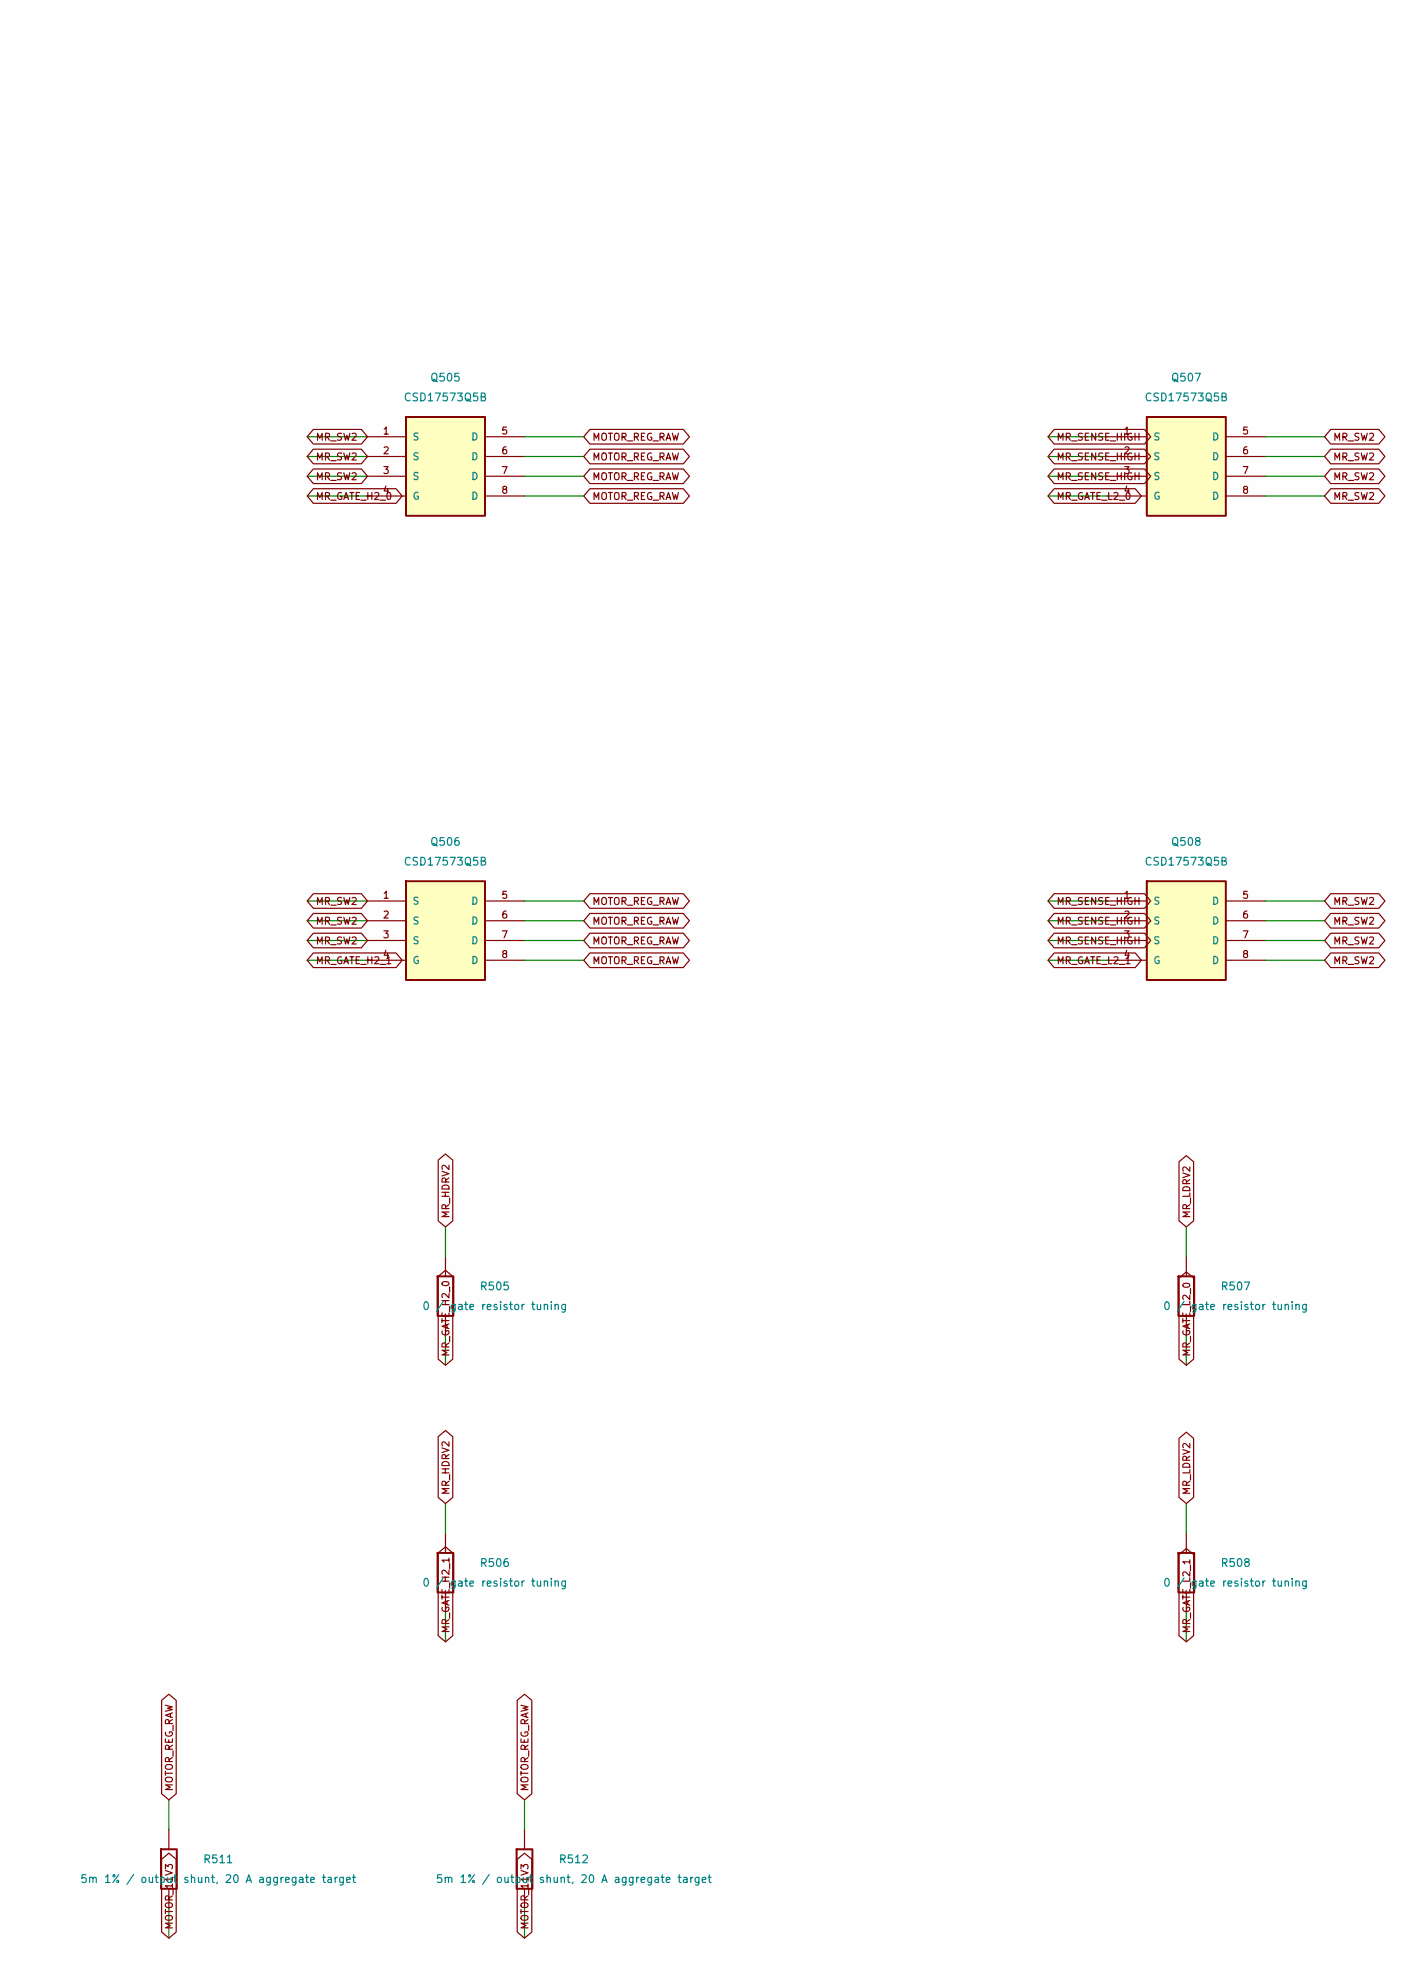
[picture p59: schematic 05-motor-bridge.kicad_sch, part in row 1, column 2]

Parts:
L501: 2uH high-current; exact part from BOM review
Q501, Q502, Q503, Q504: CSD19502Q5B; MPN CSD19502Q5B
Q505, Q506, Q507, Q508: CSD17573Q5B; MPN CSD17573Q5B
R501, R502, R503, R504, R505, R506, R507, R508: 0 / gate resistor tuning; R_0603_1608Metric
R509, R510: 5m 1% / pulse and thermal rating pending; R_2512_6332Metric
R511, R512: 5m 1% / output shunt, 20 A aggregate target; R_2512_6332Metric

Connections:
GND: R509.2, R510.2
MOTOR_11V3: R511.2, R512.2
MOTOR_REG_RAW: Q505.5 (D), Q505.6 (D), Q505.7 (D), Q505.8 (D), Q506.5 (D), Q506.6 (D), Q506.7 (D), Q506.8 (D), R511.1, R512.1
MR_GATE_H1_0: Q501.4 (G), R501.2
MR_GATE_H1_1: Q502.4 (G), R502.2
MR_GATE_H2_0: Q505.4 (G), R505.2
MR_GATE_H2_1: Q506.4 (G), R506.2
MR_GATE_L1_0: Q503.4 (G), R503.2
MR_GATE_L1_1: Q504.4 (G), R504.2
MR_GATE_L2_0: Q507.4 (G), R507.2
MR_GATE_L2_1: Q508.4 (G), R508.2
MR_HDRV1: R501.1, R502.1
MR_HDRV2: R505.1, R506.1
MR_LDRV1: R503.1, R504.1
MR_LDRV2: R507.1, R508.1
MR_SENSE_HIGH: Q503.1 (S), Q503.2 (S), Q503.3 (S), Q504.1 (S), Q504.2 (S), Q504.3 (S), Q507.1 (S), Q507.2 (S), Q507.3 (S), Q508.1 (S), Q508.2 (S), Q508.3 (S), R509.1, R510.1
MR_SW1: L501.1, Q501.1 (S), Q501.2 (S), Q501.3 (S), Q502.1 (S), Q502.2 (S), Q502.3 (S), Q503.5 (D), Q503.6 (D), Q503.7 (D), Q503.8 (D), Q504.5 (D), Q504.6 (D), Q504.7 (D), Q504.8 (D)
MR_SW2: L501.2, Q505.1 (S), Q505.2 (S), Q505.3 (S), Q506.1 (S), Q506.2 (S), Q506.3 (S), Q507.5 (D), Q507.6 (D), Q507.7 (D), Q507.8 (D), Q508.5 (D), Q508.6 (D), Q508.7 (D), Q508.8 (D)
PACK_PROTECTED: Q501.5 (D), Q501.6 (D), Q501.7 (D), Q501.8 (D), Q502.5 (D), Q502.6 (D), Q502.7 (D), Q502.8 (D)

Notes on the sheet:
4-switch bridge / matched parallel FETs / Kelvin current sensing
Based on PMP21278; this implementation is not tested. Source reference used external input damping. Returned motor energy, branch switching/fusing and emergency-cut circuitry remain incomplete. No motor connection or manufacturing release from these draft sheets.
