iimmyy/Little-Guy/hardware/little-guy-v2/pcb/power/06-motor-capacitors.kicad_sch

## KiCad design hardware/little-guy-v2/pcb/power/06-motor-capacitors.kicad_sch (2026-11-07)

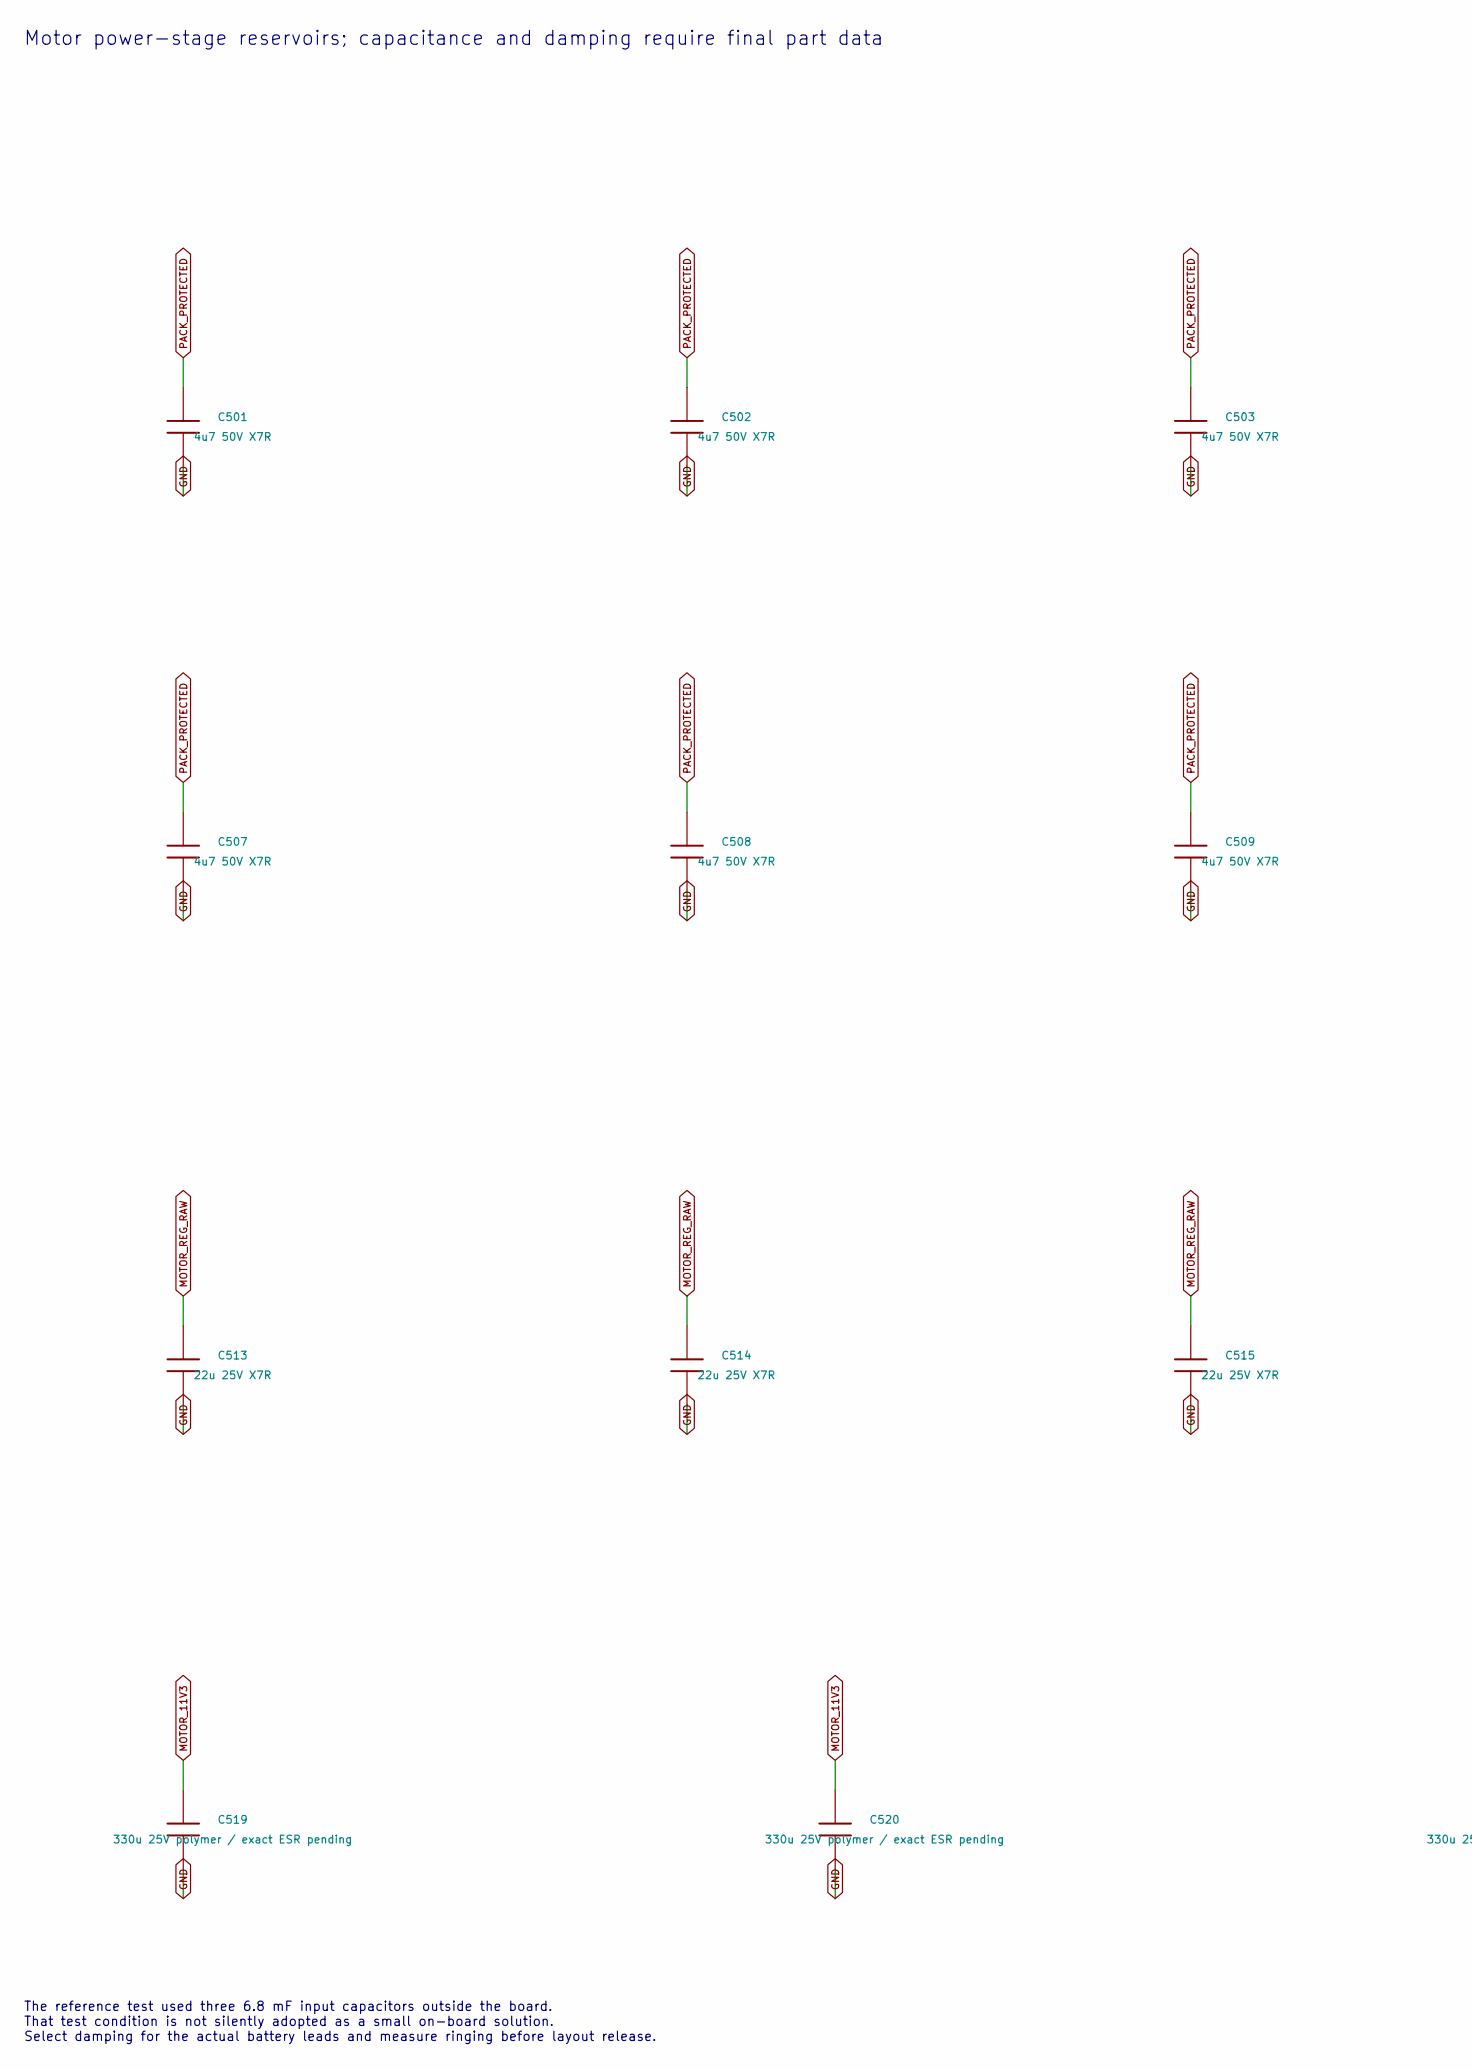
[picture p60: schematic 06-motor-capacitors.kicad_sch, part in row 1, column 1]

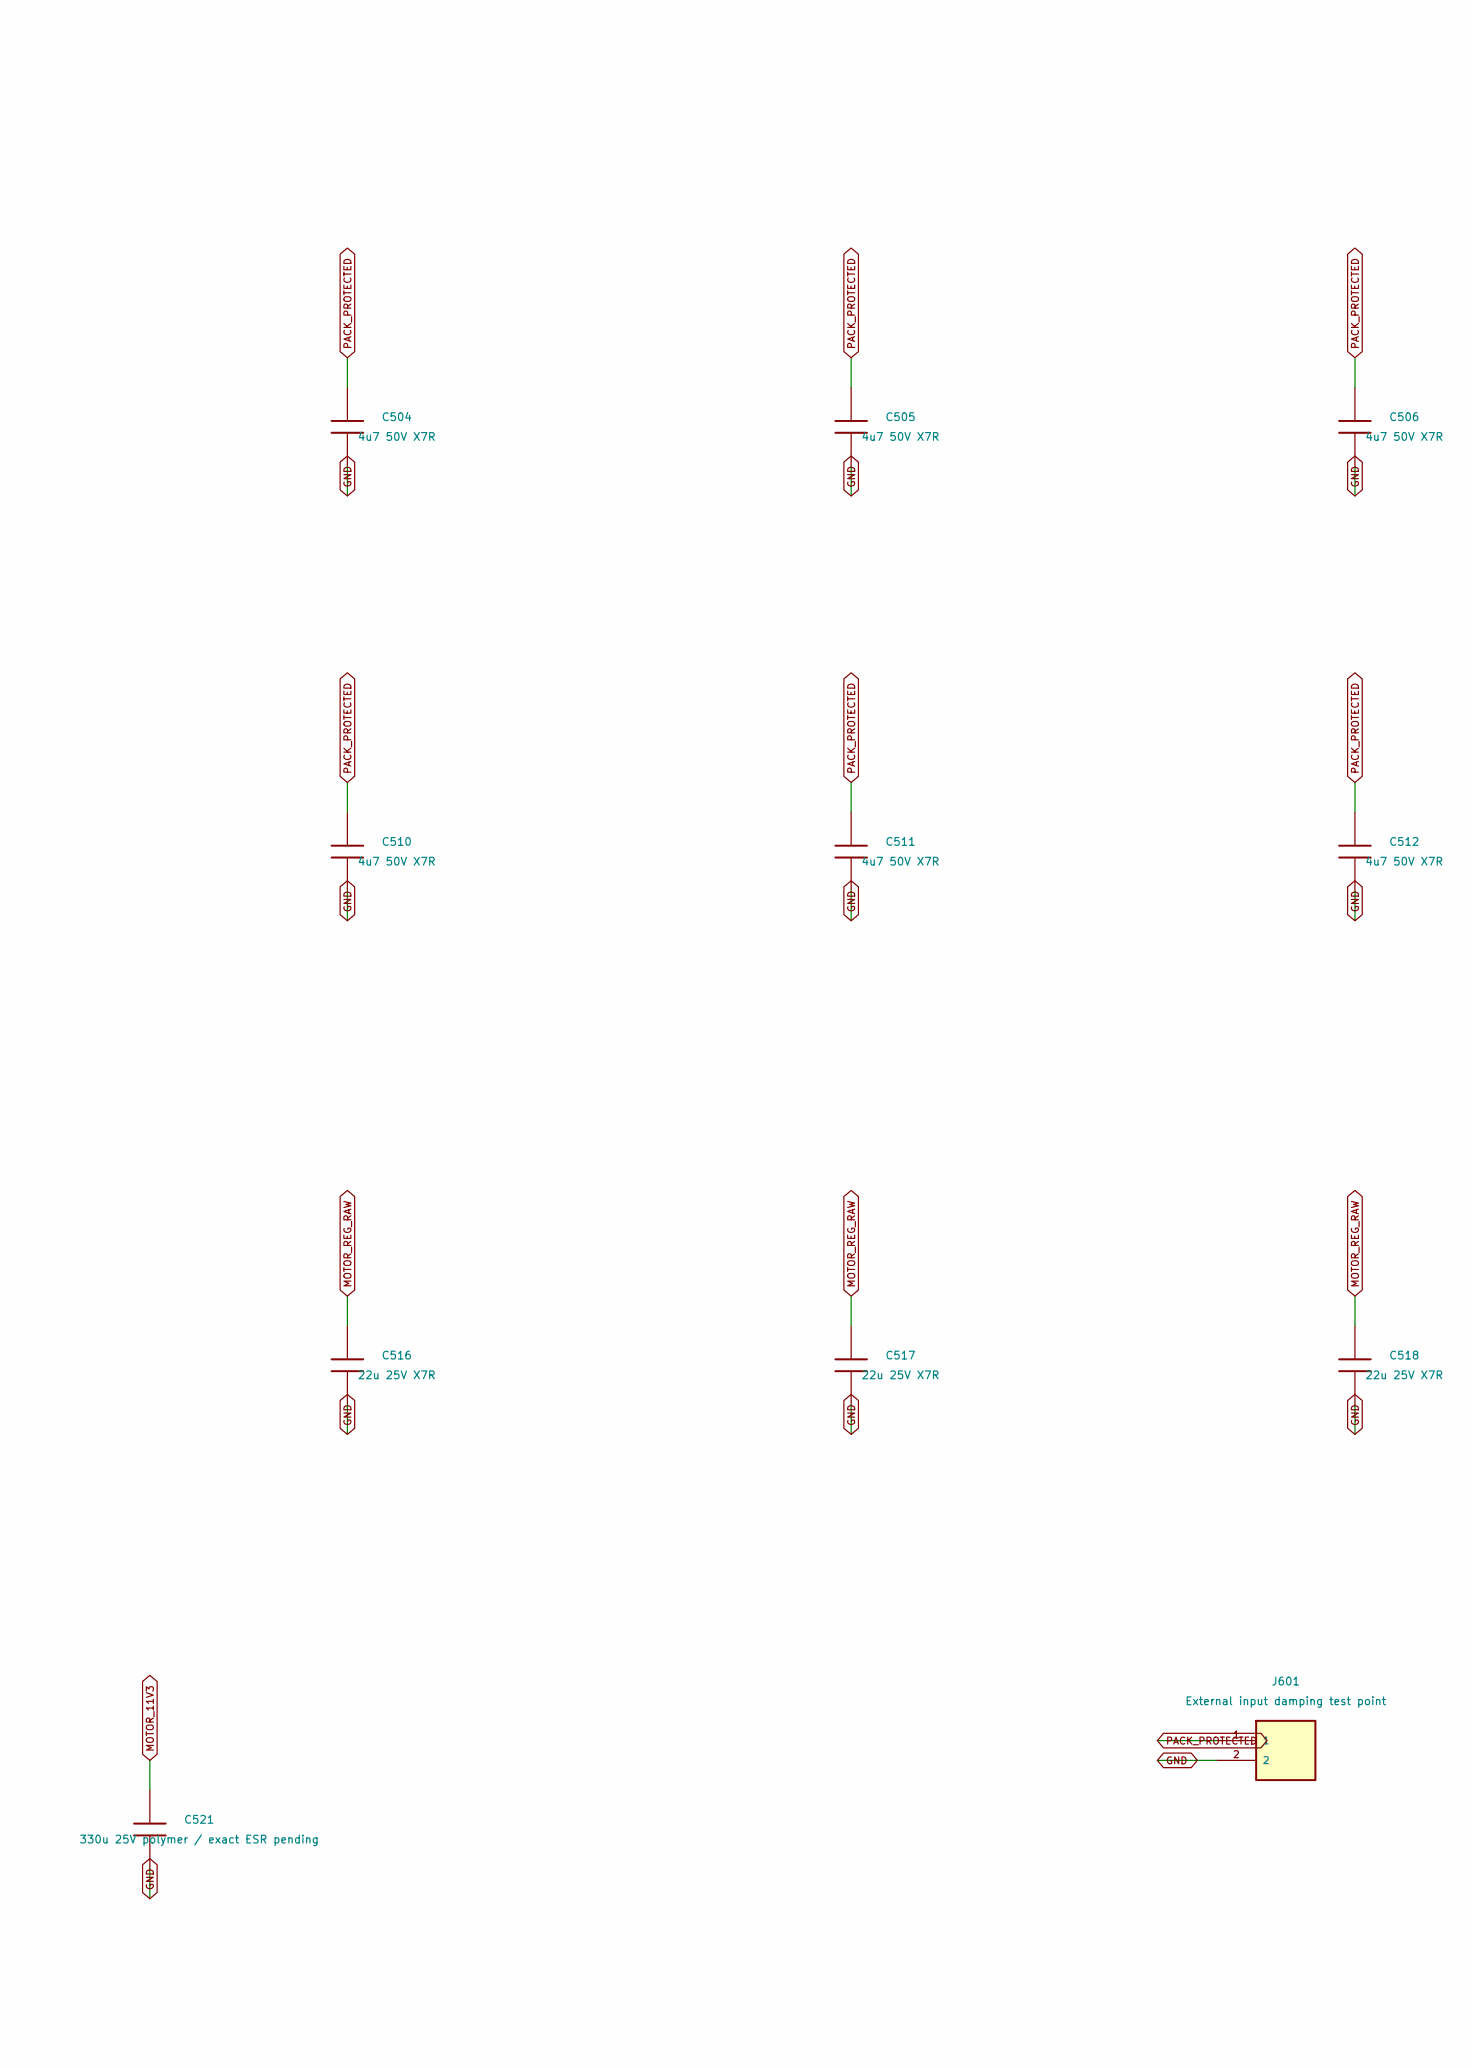
[picture p61: schematic 06-motor-capacitors.kicad_sch, part in row 1, column 2]

Parts:
C501, C502, C503, C504, C505, C506, C507, C508, C509, C510, C511, C512: 4u7 50V X7R; C_1206_3216Metric
C513, C514, C515, C516, C517, C518: 22u 25V X7R; C_1206_3216Metric
C519, C520, C521: 330u 25V polymer / exact ESR pending; C_1206_3216Metric
J601: External input damping test point

Connections:
GND: C501.2, C502.2, C503.2, C504.2, C505.2, C506.2, C507.2, C508.2, C509.2, C510.2, C511.2, C512.2, C513.2, C514.2, C515.2, C516.2, C517.2, C518.2, C519.2, C520.2, C521.2, J601.2
MOTOR_11V3: C519.1, C520.1, C521.1
MOTOR_REG_RAW: C513.1, C514.1, C515.1, C516.1, C517.1, C518.1
PACK_PROTECTED: C501.1, C502.1, C503.1, C504.1, C505.1, C506.1, C507.1, C508.1, C509.1, C510.1, C511.1, C512.1, J601.1

Notes on the sheet:
Motor power-stage reservoirs; capacitance and damping require final part data
The reference test used three 6.8 mF input capacitors outside the board. That test condition is not silently adopted as a small on-board solution. Select damping for the actual battery leads and measure ringing before layout release.
