iimmyy/Little-Guy/hardware/little-guy-v2/pcb/power/07-jetson-feed.kicad_sch

## KiCad design hardware/little-guy-v2/pcb/power/07-jetson-feed.kicad_sch (2026-11-07)

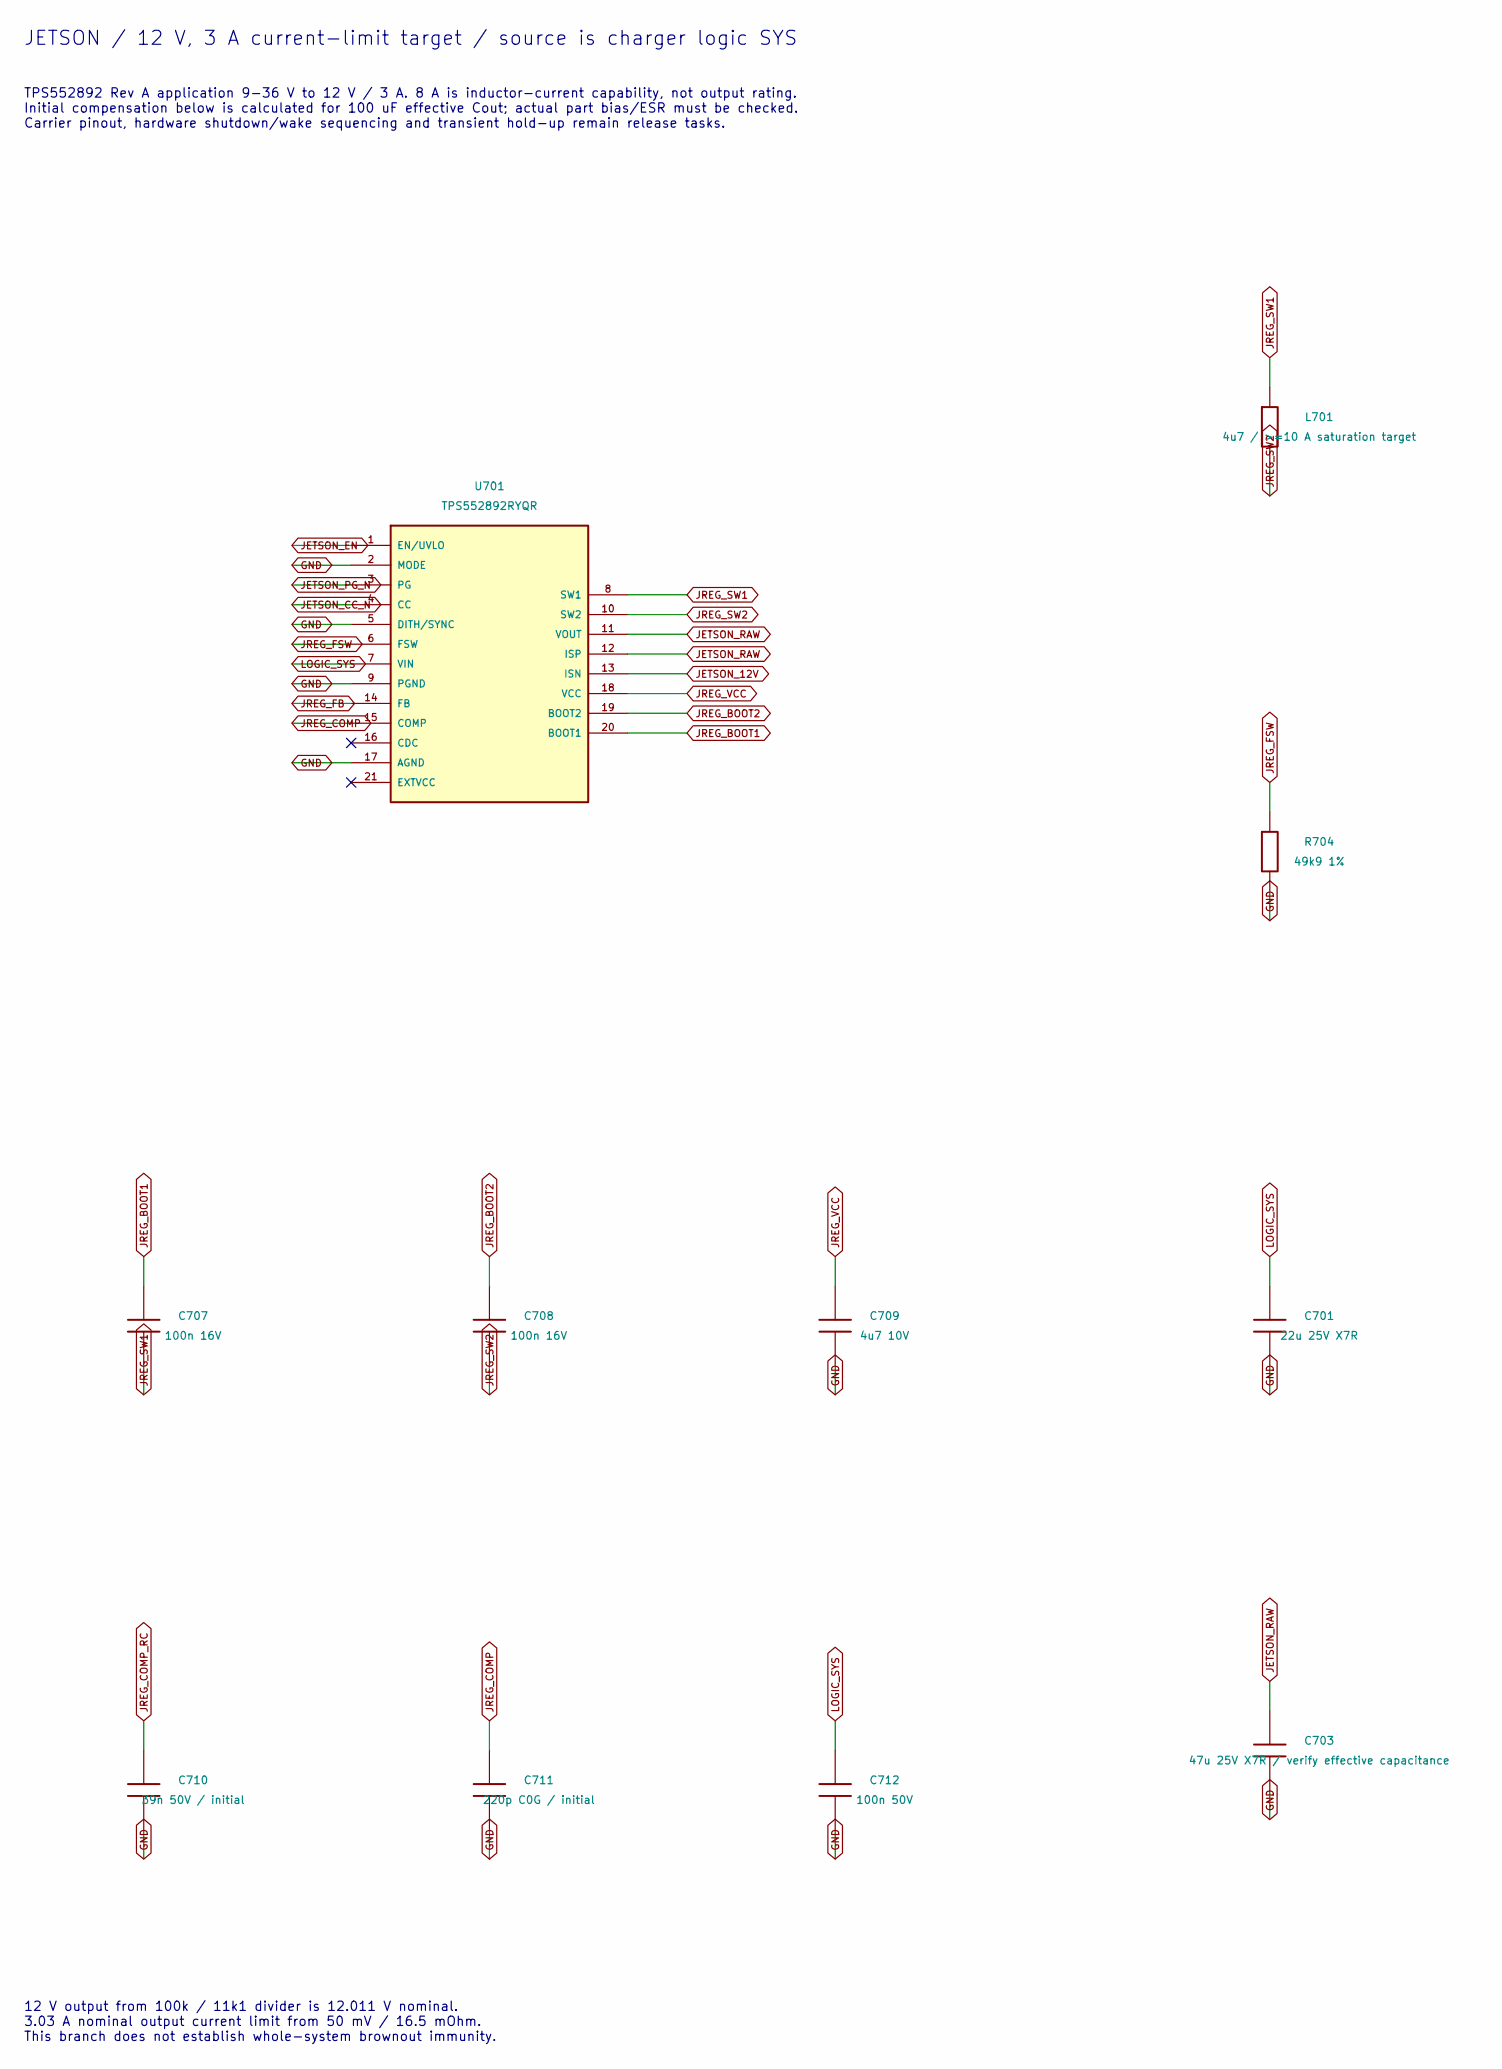
[picture p62: schematic 07-jetson-feed.kicad_sch, part in row 1, column 1]

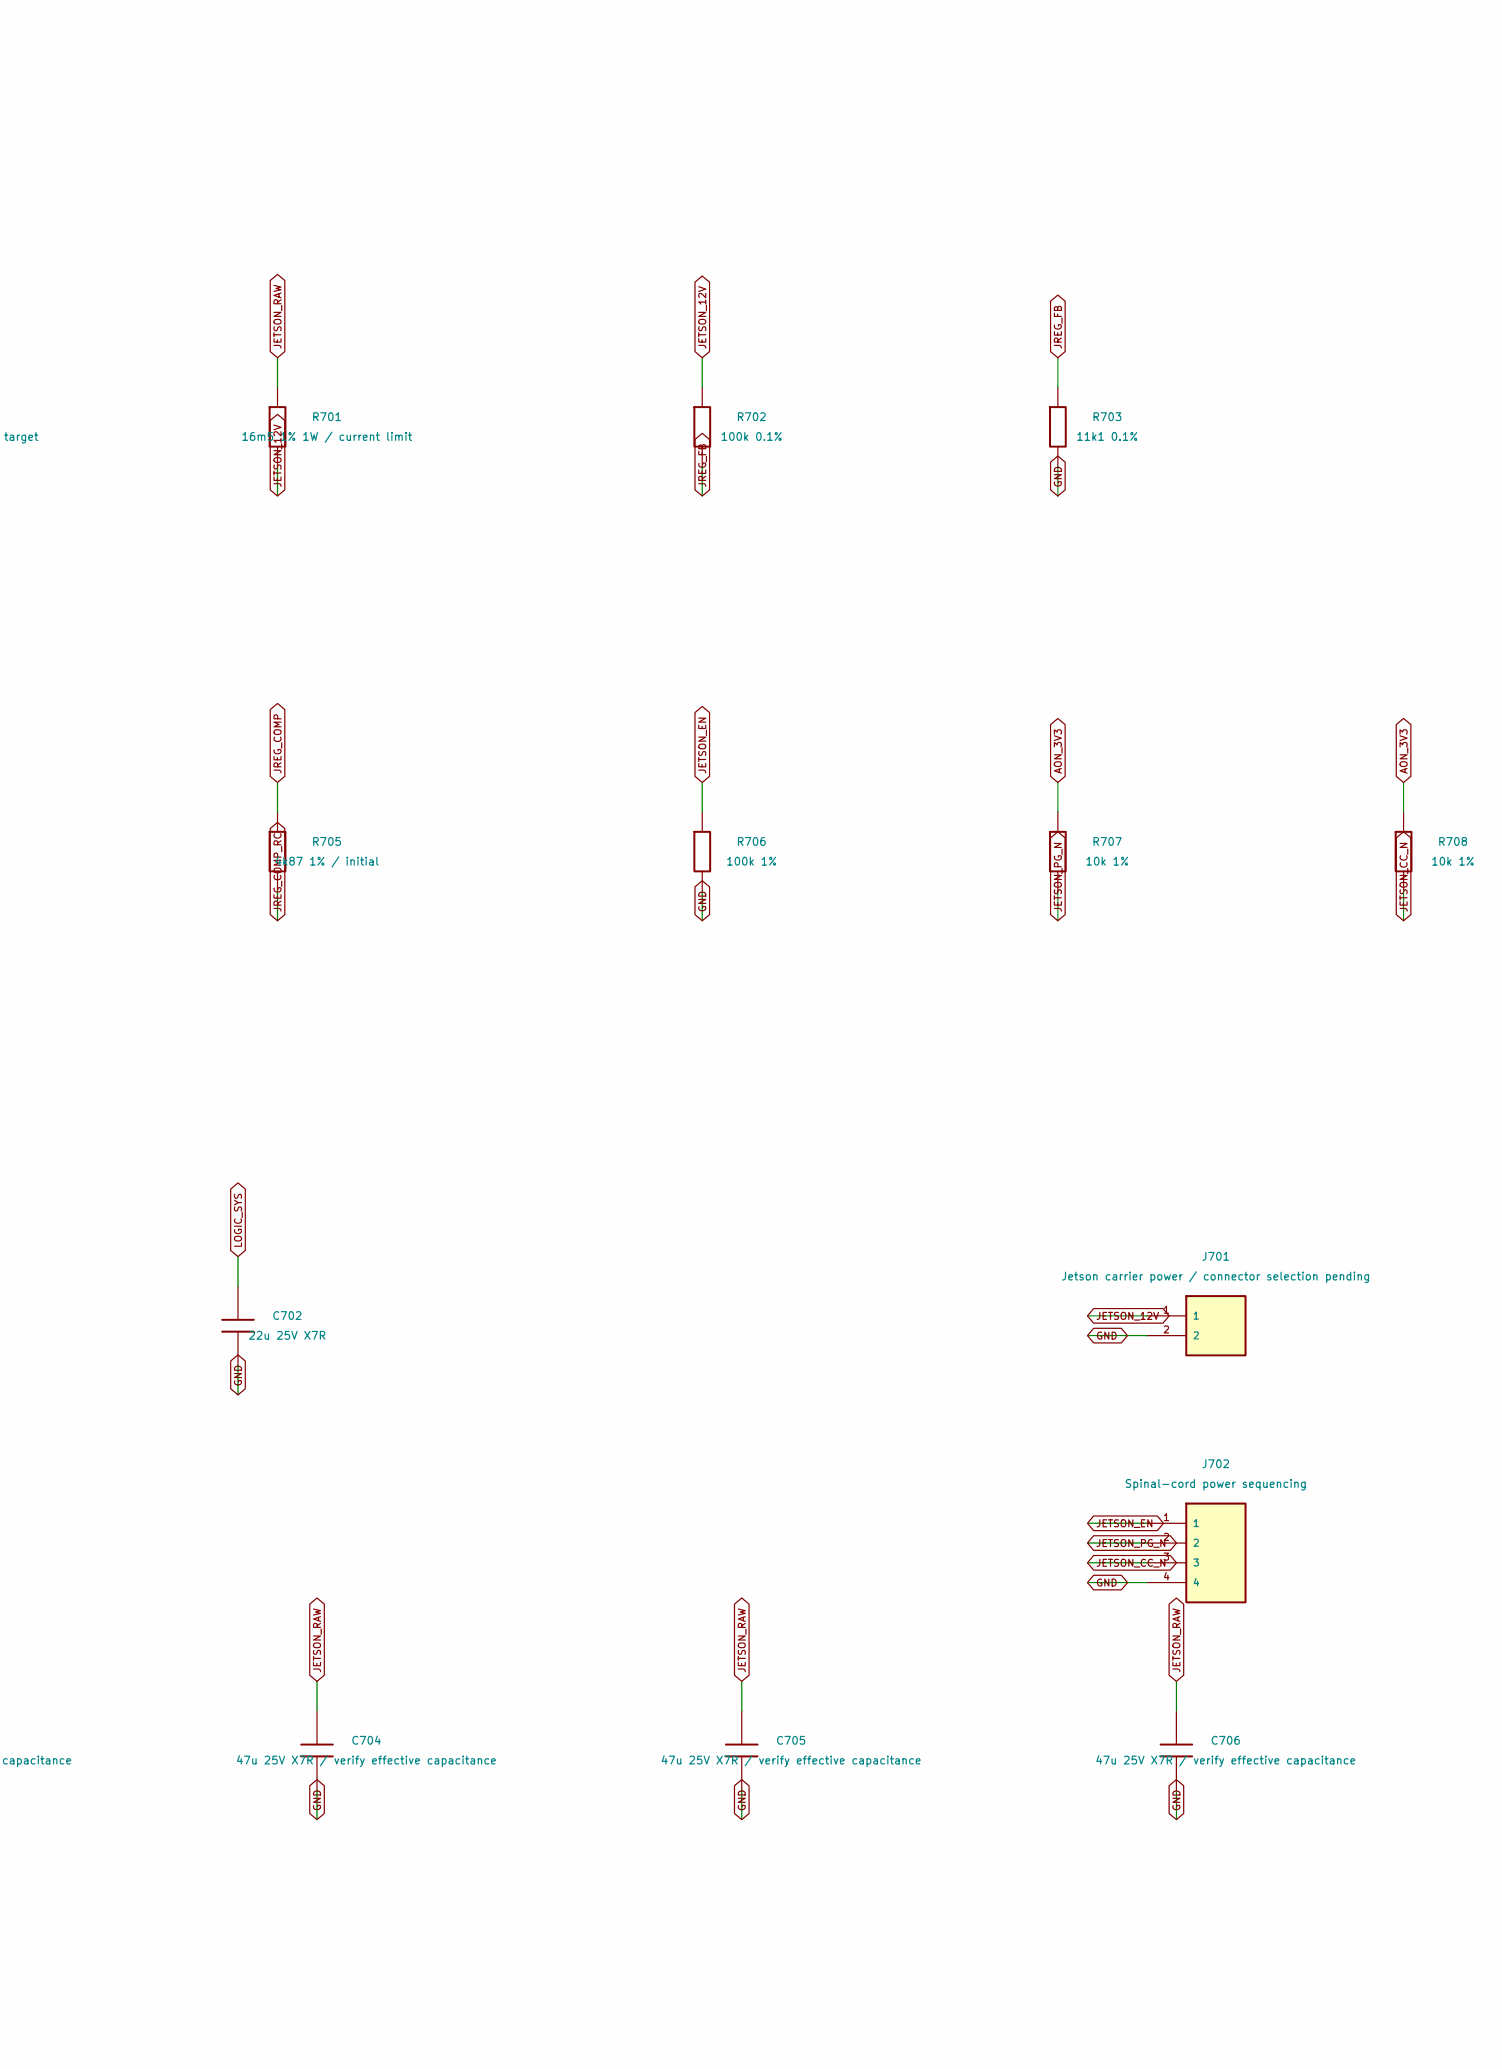
[picture p63: schematic 07-jetson-feed.kicad_sch, part in row 1, column 2]

Parts:
C701, C702: 22u 25V X7R; C_1206_3216Metric
C703, C704, C705, C706: 47u 25V X7R / verify effective capacitance; C_1206_3216Metric
C707, C708: 100n 16V; C_0603_1608Metric
C709: 4u7 10V; C_0603_1608Metric
C710: 39n 50V / initial; C_0603_1608Metric
C711: 220p C0G / initial; C_0603_1608Metric
C712: 100n 50V; C_0603_1608Metric
J701: Jetson carrier power / connector selection pending
J702: Spinal-cord power sequencing
L701: 4u7 / >=10 A saturation target
R701: 16m5 1% 1W / current limit; R_2512_6332Metric
R702: 100k 0.1%; R_0603_1608Metric
R703: 11k1 0.1%; R_0603_1608Metric
R704: 49k9 1%; R_0603_1608Metric
R705: 4k87 1% / initial; R_0603_1608Metric
R706: 100k 1%; R_0603_1608Metric
R707, R708: 10k 1%; R_0603_1608Metric
U701: TPS552892RYQR; MPN TPS552892RYQR

Connections:
AON_3V3: R707.1, R708.1
GND: C701.2, C702.2, C703.2, C704.2, C705.2, C706.2, C709.2, C710.2, C711.2, C712.2, J701.2, J702.4, R703.2, R704.2, R706.2, U701.2 (MODE), U701.5 (DITH/SYNC), U701.9 (PGND), U701.17 (AGND)
JETSON_12V: J701.1, R701.2, R702.1, U701.13 (ISN)
JETSON_CC_N: J702.3, R708.2, U701.4 (CC)
JETSON_EN: J702.1, R706.1, U701.1 (EN/UVLO)
JETSON_PG_N: J702.2, R707.2, U701.3 (PG)
JETSON_RAW: C703.1, C704.1, C705.1, C706.1, R701.1, U701.11 (VOUT), U701.12 (ISP)
JREG_BOOT1: C707.1, U701.20 (BOOT1)
JREG_BOOT2: C708.1, U701.19 (BOOT2)
JREG_COMP: C711.1, R705.1, U701.15 (COMP)
JREG_COMP_RC: C710.1, R705.2
JREG_FB: R702.2, R703.1, U701.14 (FB)
JREG_FSW: R704.1, U701.6 (FSW)
JREG_SW1: C707.2, L701.1, U701.8 (SW1)
JREG_SW2: C708.2, L701.2, U701.10 (SW2)
JREG_VCC: C709.1, U701.18 (VCC)
LOGIC_SYS: C701.1, C702.1, C712.1, U701.7 (VIN)

Notes on the sheet:
JETSON / 12 V, 3 A current-limit target / source is charger logic SYS
TPS552892 Rev A application 9-36 V to 12 V / 3 A. 8 A is inductor-current capability, not output rating. Initial compensation below is calculated for 100 uF effective Cout; actual part bias/ESR must be checked. Carrier pinout, hardware shutdown/wake sequencing and transient hold-up remain release t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
12 V output from 100k / 11k1 divider is 12.011 V nominal. 3.03 A nominal output current limit from 50 mV / 16.5 mOhm. This branch does not establish whole-system brownout immunity.
