iimmyy/Little-Guy/hardware/little-guy-v2/pcb/power/08-hand-left.kicad_sch

## KiCad design hardware/little-guy-v2/pcb/power/08-hand-left.kicad_sch (2026-11-07)

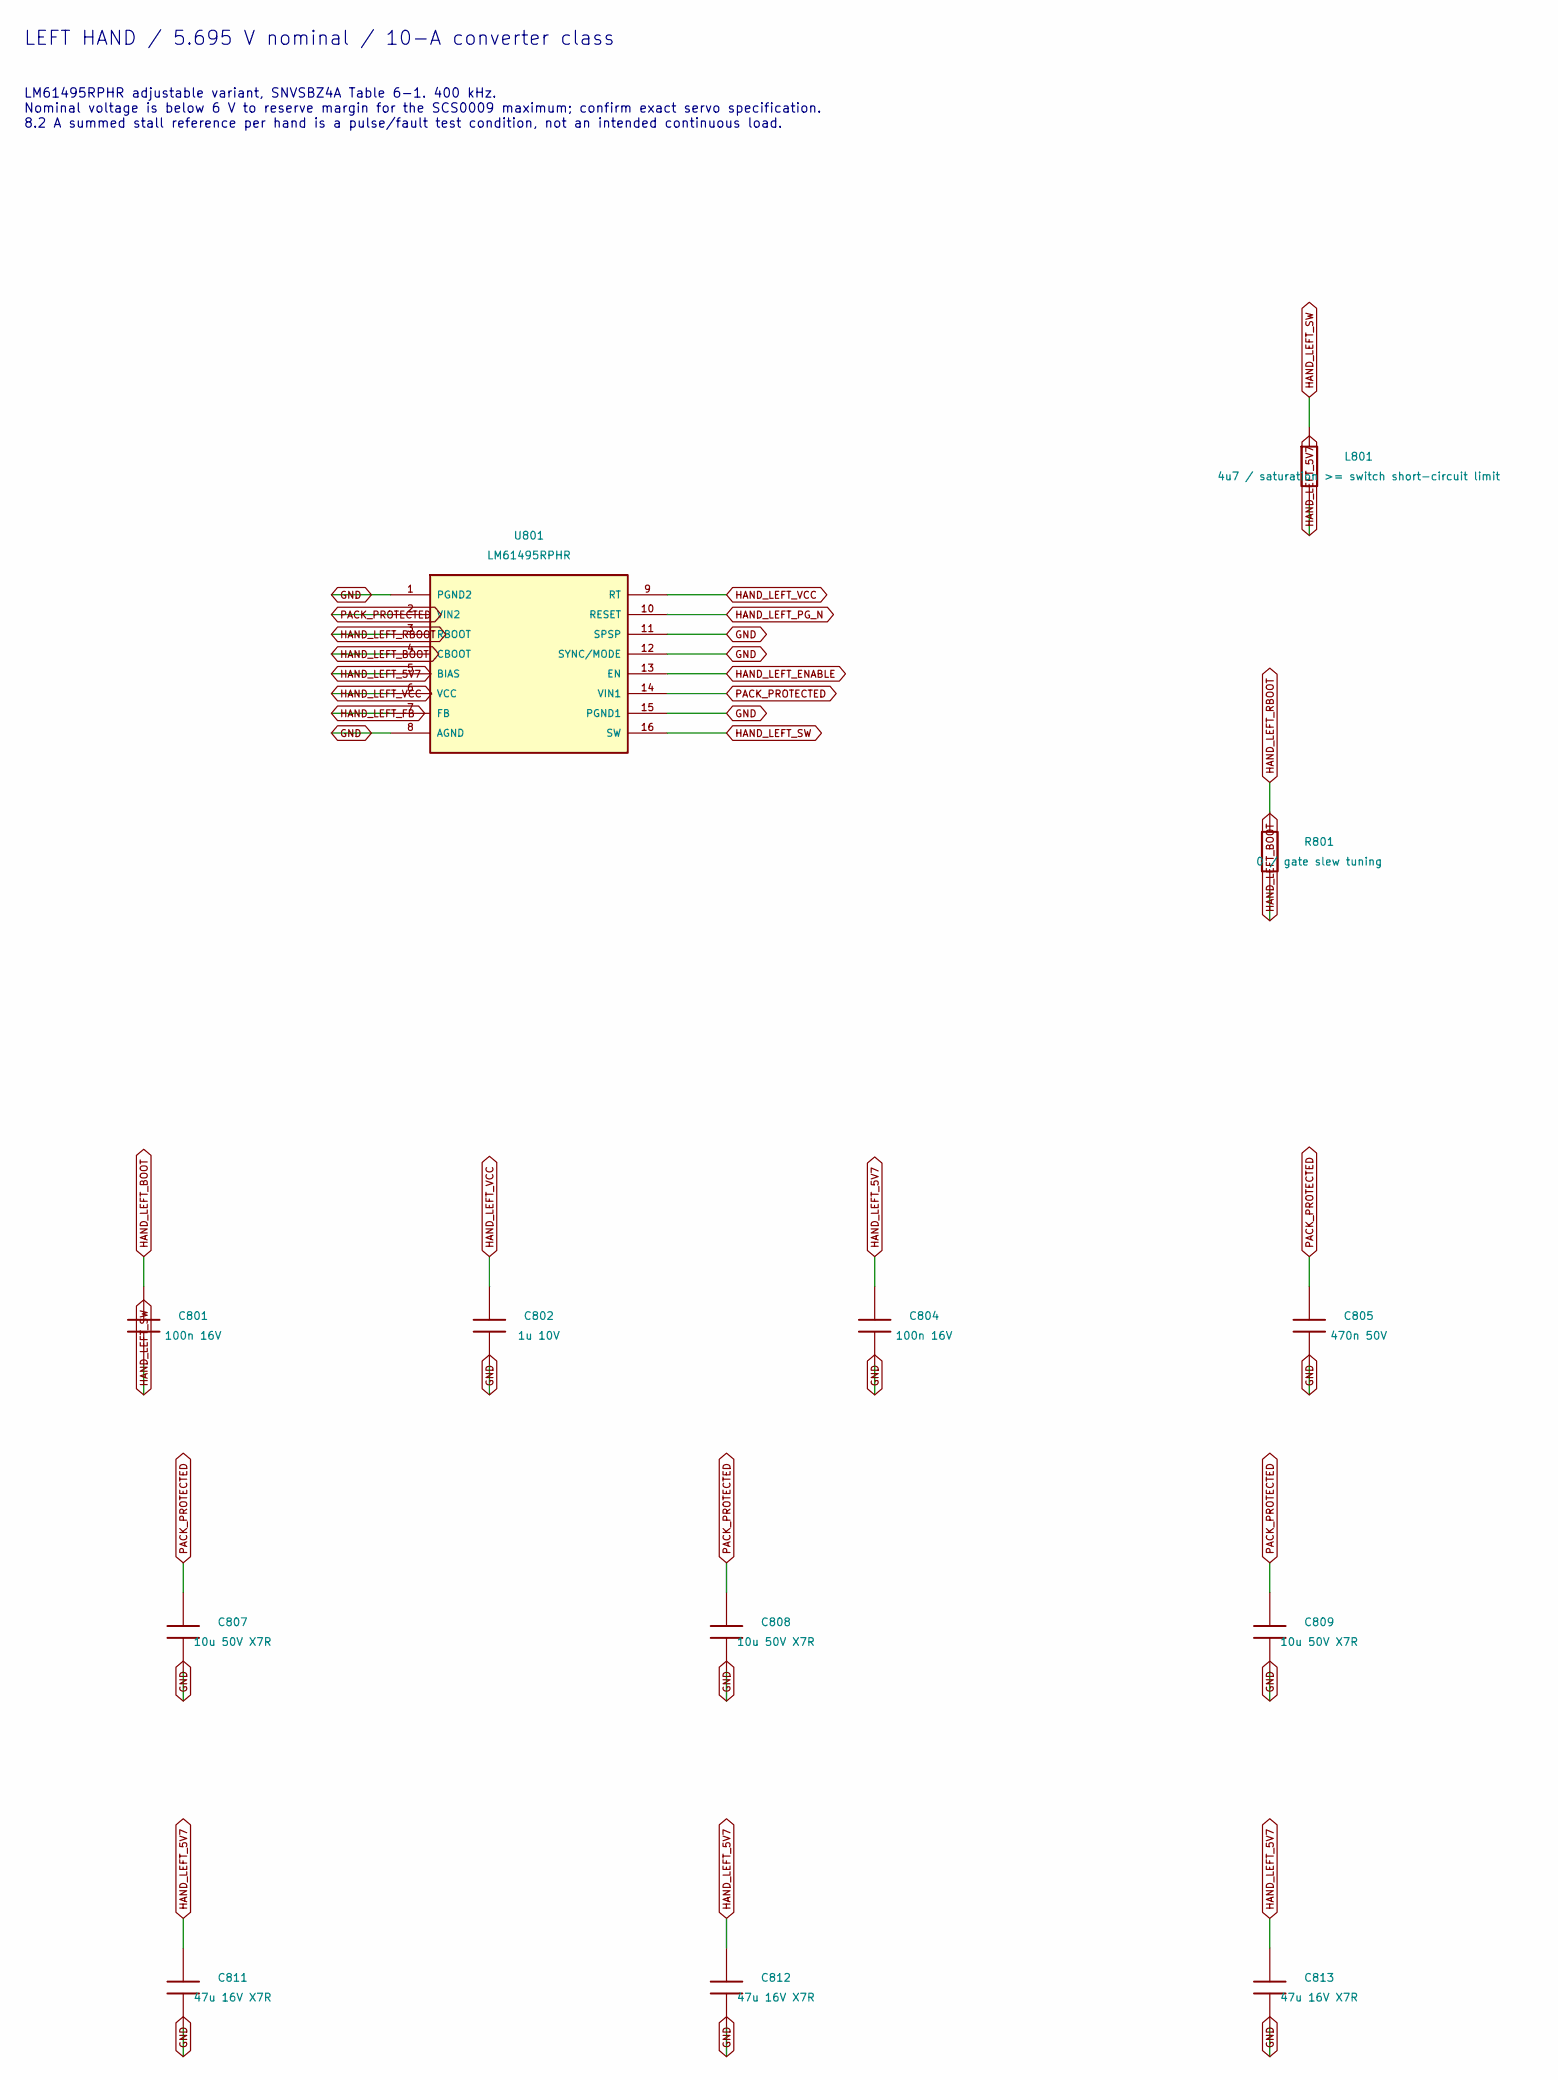
[picture p64: schematic 08-hand-left.kicad_sch, part in row 1, column 1]

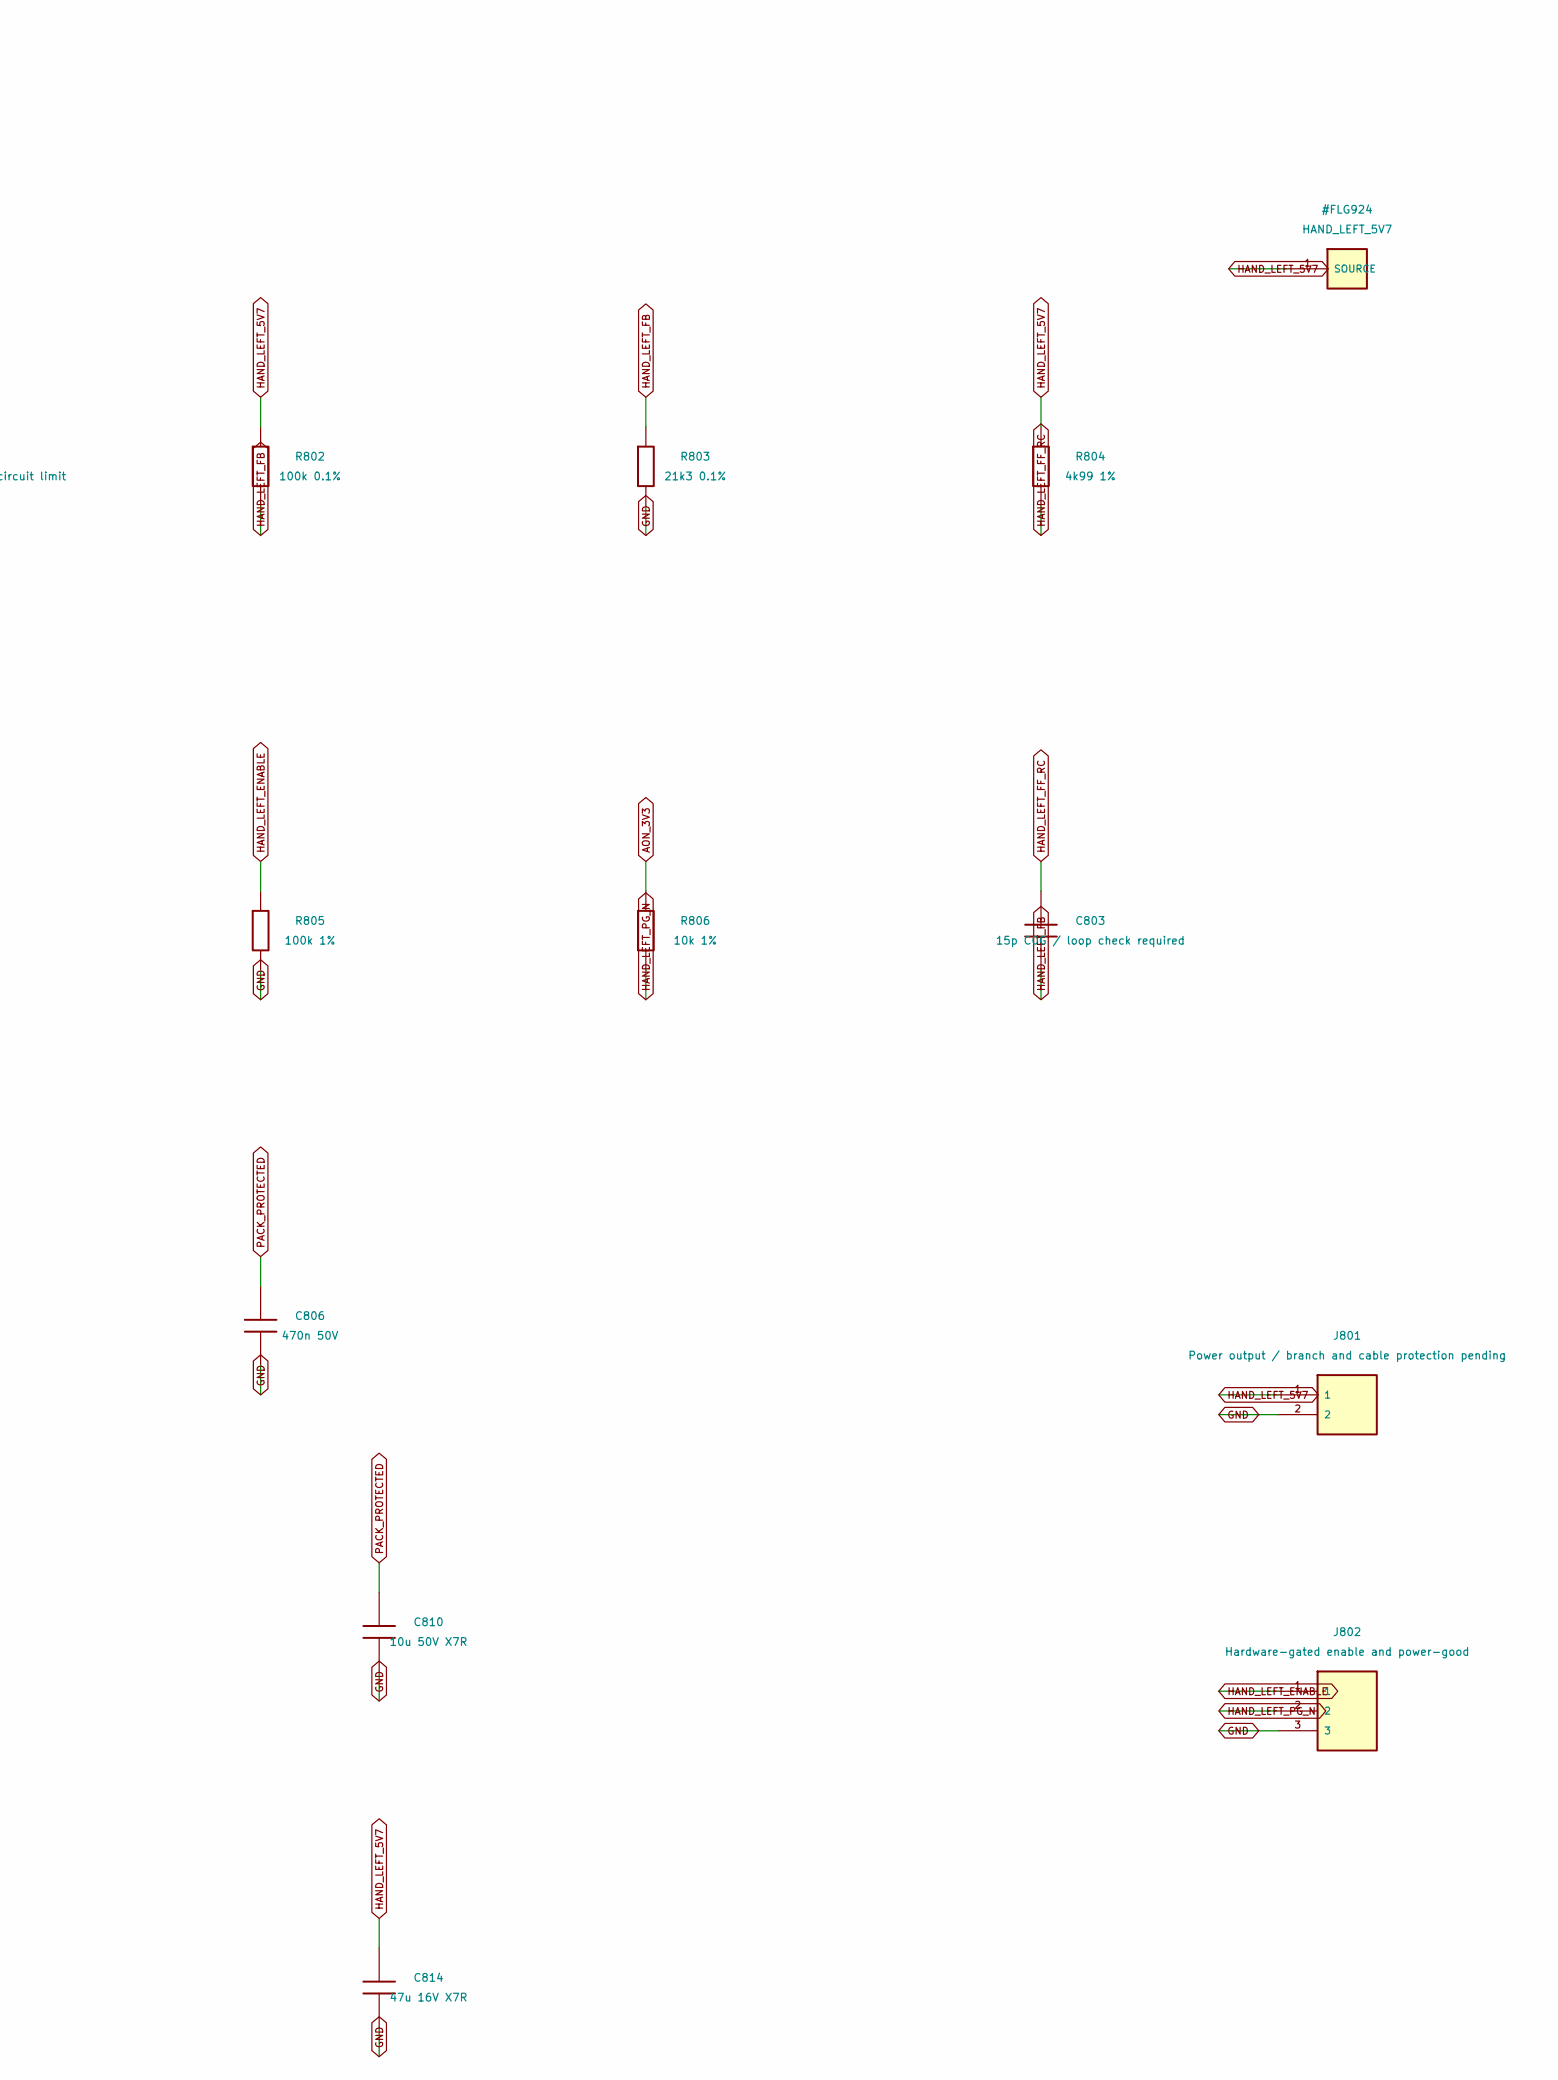
[picture p65: schematic 08-hand-left.kicad_sch, part in row 1, column 2]

Parts:
C801, C804: 100n 16V; C_0603_1608Metric
C802: 1u 10V; C_0603_1608Metric
C803: 15p C0G / loop check required; C_0603_1608Metric
C805, C806: 470n 50V; C_0603_1608Metric
C807, C808, C809, C810: 10u 50V X7R; C_1206_3216Metric
C811, C812, C813, C814: 47u 16V X7R; C_1206_3216Metric
J801: Power output / branch and cable protection pending
J802: Hardware-gated enable and power-good
L801: 4u7 / saturation >= switch short-circuit limit
R801: 0 / gate slew tuning; R_0603_1608Metric
R802: 100k 0.1%; R_0603_1608Metric
R803: 21k3 0.1%; R_0603_1608Metric
R804: 4k99 1%; R_0603_1608Metric
R805: 100k 1%; R_0603_1608Metric
R806: 10k 1%; R_0603_1608Metric
U801: LM61495RPHR; MPN LM61495RPHR

Connections:
AON_3V3: R806.1
GND: C802.2, C804.2, C805.2, C806.2, C807.2, C808.2, C809.2, C810.2, C811.2, C812.2, C813.2, C814.2, J801.2, J802.3, R803.2, R805.2, U801.1 (PGND2), U801.8 (AGND), U801.11 (SPSP), U801.12 (SYNC/MODE), U801.15 (PGND1)
HAND_LEFT_5V7: C804.1, C811.1, C812.1, C813.1, C814.1, J801.1, L801.2, R802.1, R804.1, U801.5 (BIAS)
HAND_LEFT_BOOT: C801.1, R801.2, U801.4 (CBOOT)
HAND_LEFT_ENABLE: J802.1, R805.1, U801.13 (EN)
HAND_LEFT_FB: C803.2, R802.2, R803.1, U801.7 (FB)
HAND_LEFT_FF_RC: C803.1, R804.2
HAND_LEFT_PG_N: J802.2, R806.2, U801.10 (RESET)
HAND_LEFT_RBOOT: R801.1, U801.3 (RBOOT)
HAND_LEFT_SW: C801.2, L801.1, U801.16 (SW)
HAND_LEFT_VCC: C802.1, U801.6 (VCC), U801.9 (RT)
PACK_PROTECTED: C805.1, C806.1, C807.1, C808.1, C809.1, C810.1, U801.2 (VIN2), U801.14 (VIN1)

Notes on the sheet:
LEFT HAND / 5.695 V nominal / 10-A converter class
LM61495RPHR adjustable variant, SNVSBZ4A Table 6-1. 400 kHz. Nominal voltage is below 6 V to reserve margin for the SCS0009 maximum; confirm exact servo specification. 8.2 A summed stall reference per hand is a pulse/fault test condition, not an intended continuous load.
