iimmyy/Little-Guy/hardware/little-guy-v2/pcb/power/09-hand-right.kicad_sch

## KiCad design hardware/little-guy-v2/pcb/power/09-hand-right.kicad_sch (2026-11-07)

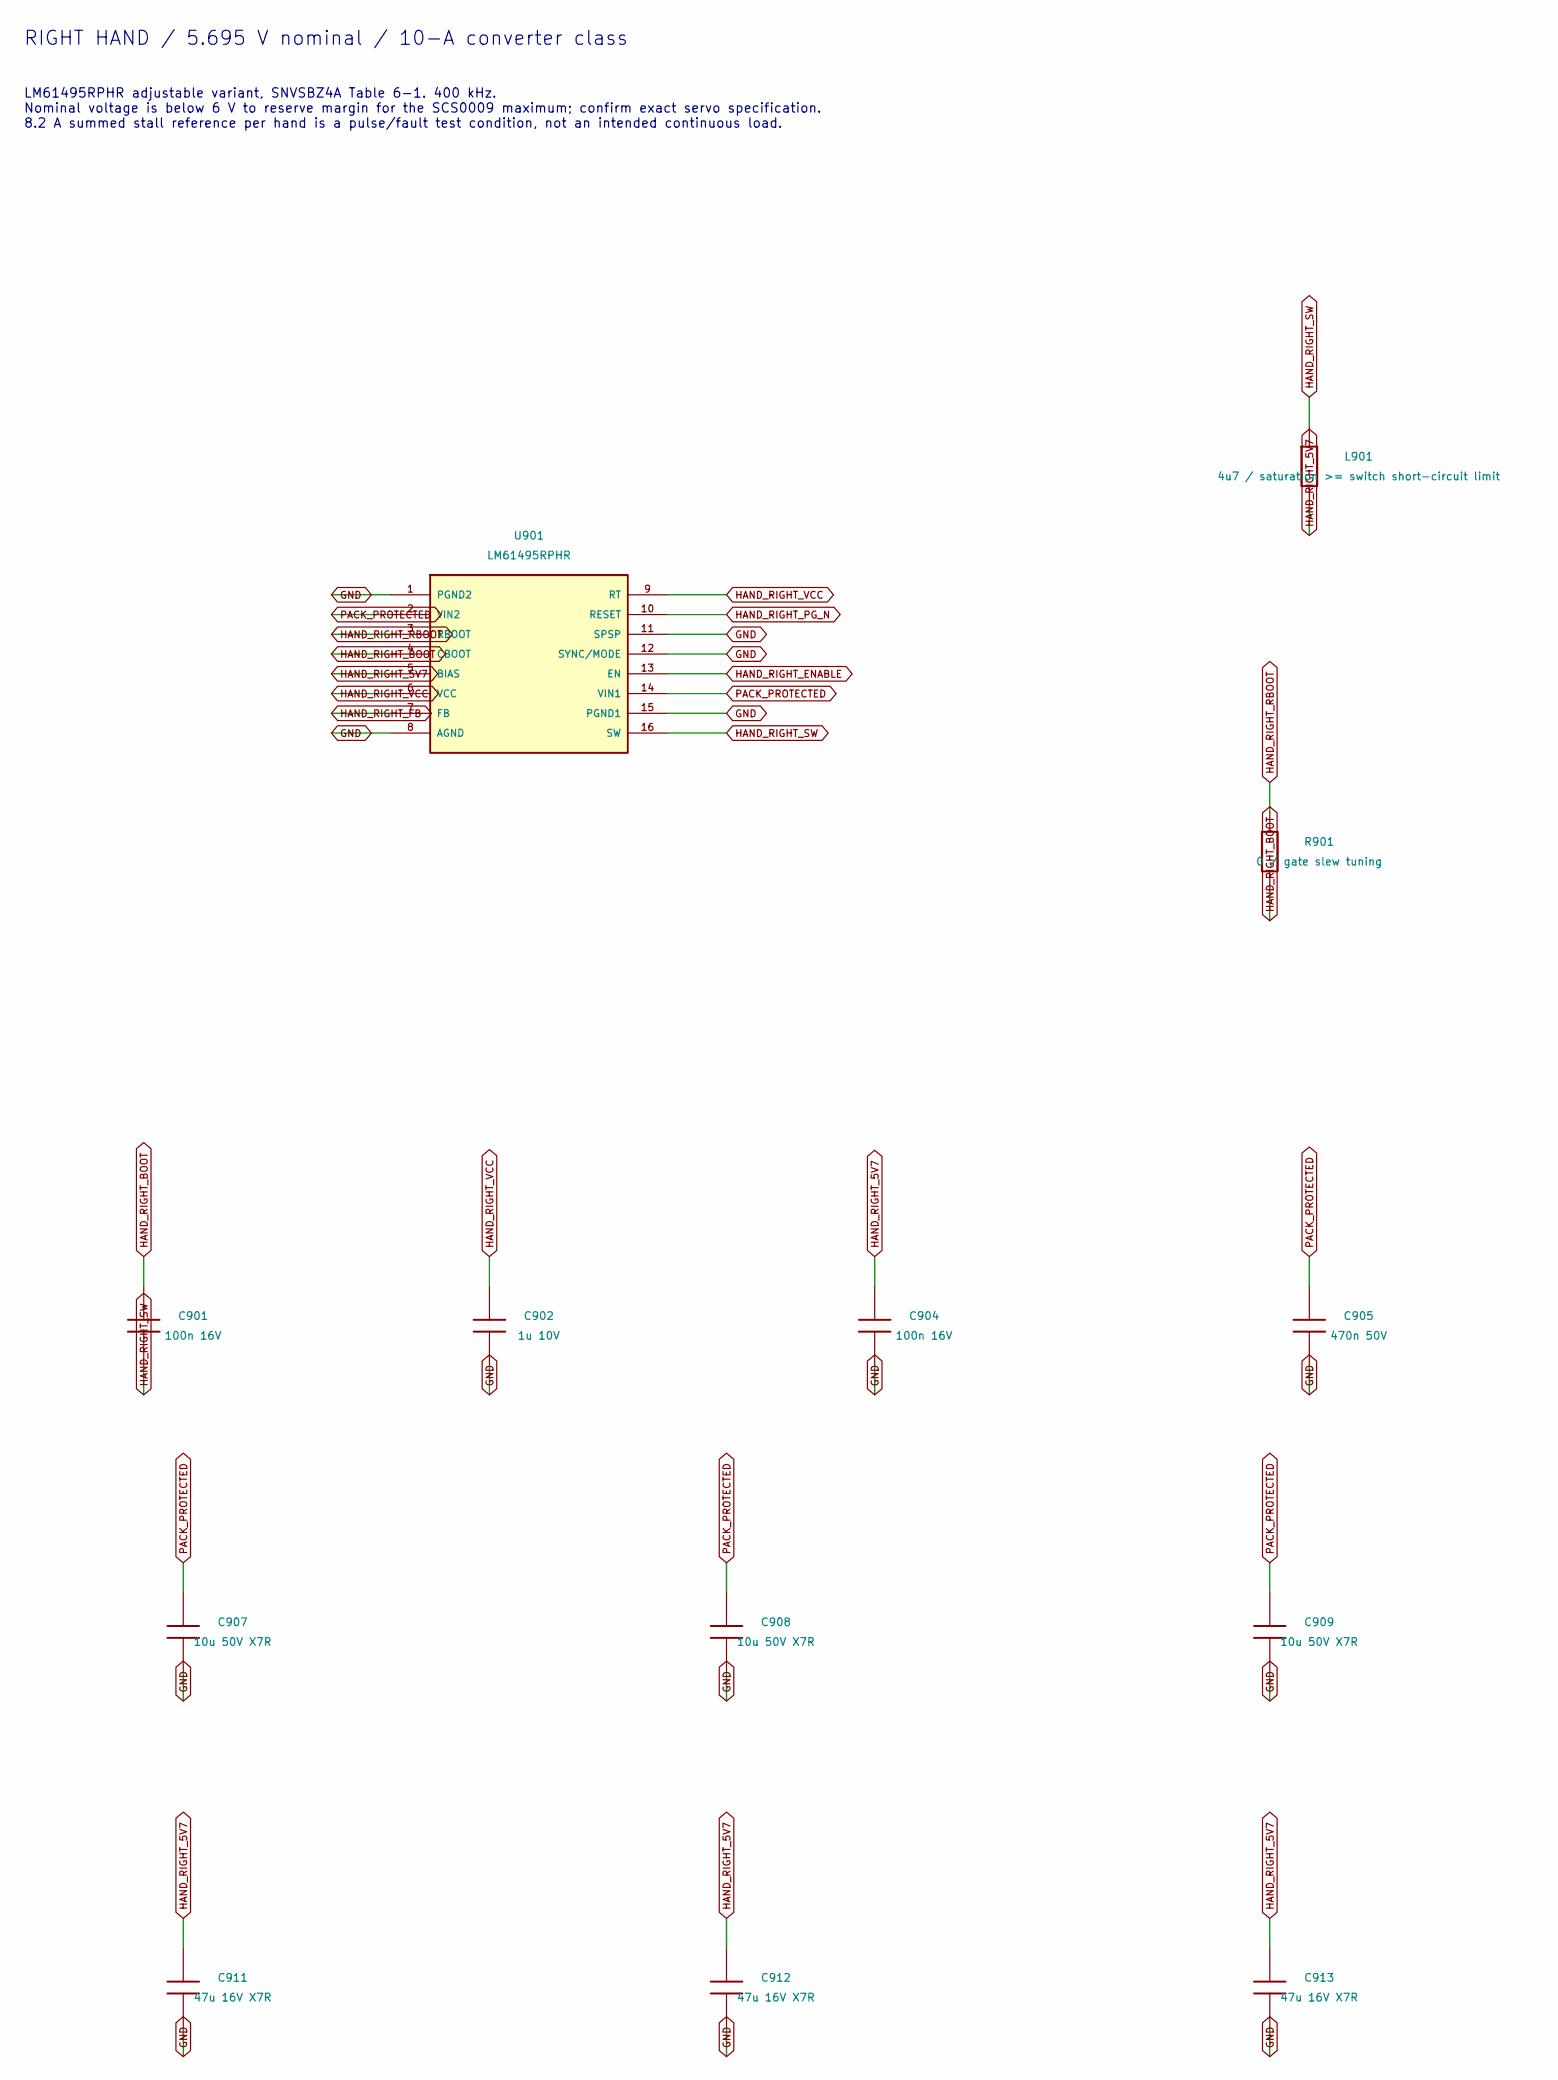
[picture p66: schematic 09-hand-right.kicad_sch, part in row 1, column 1]

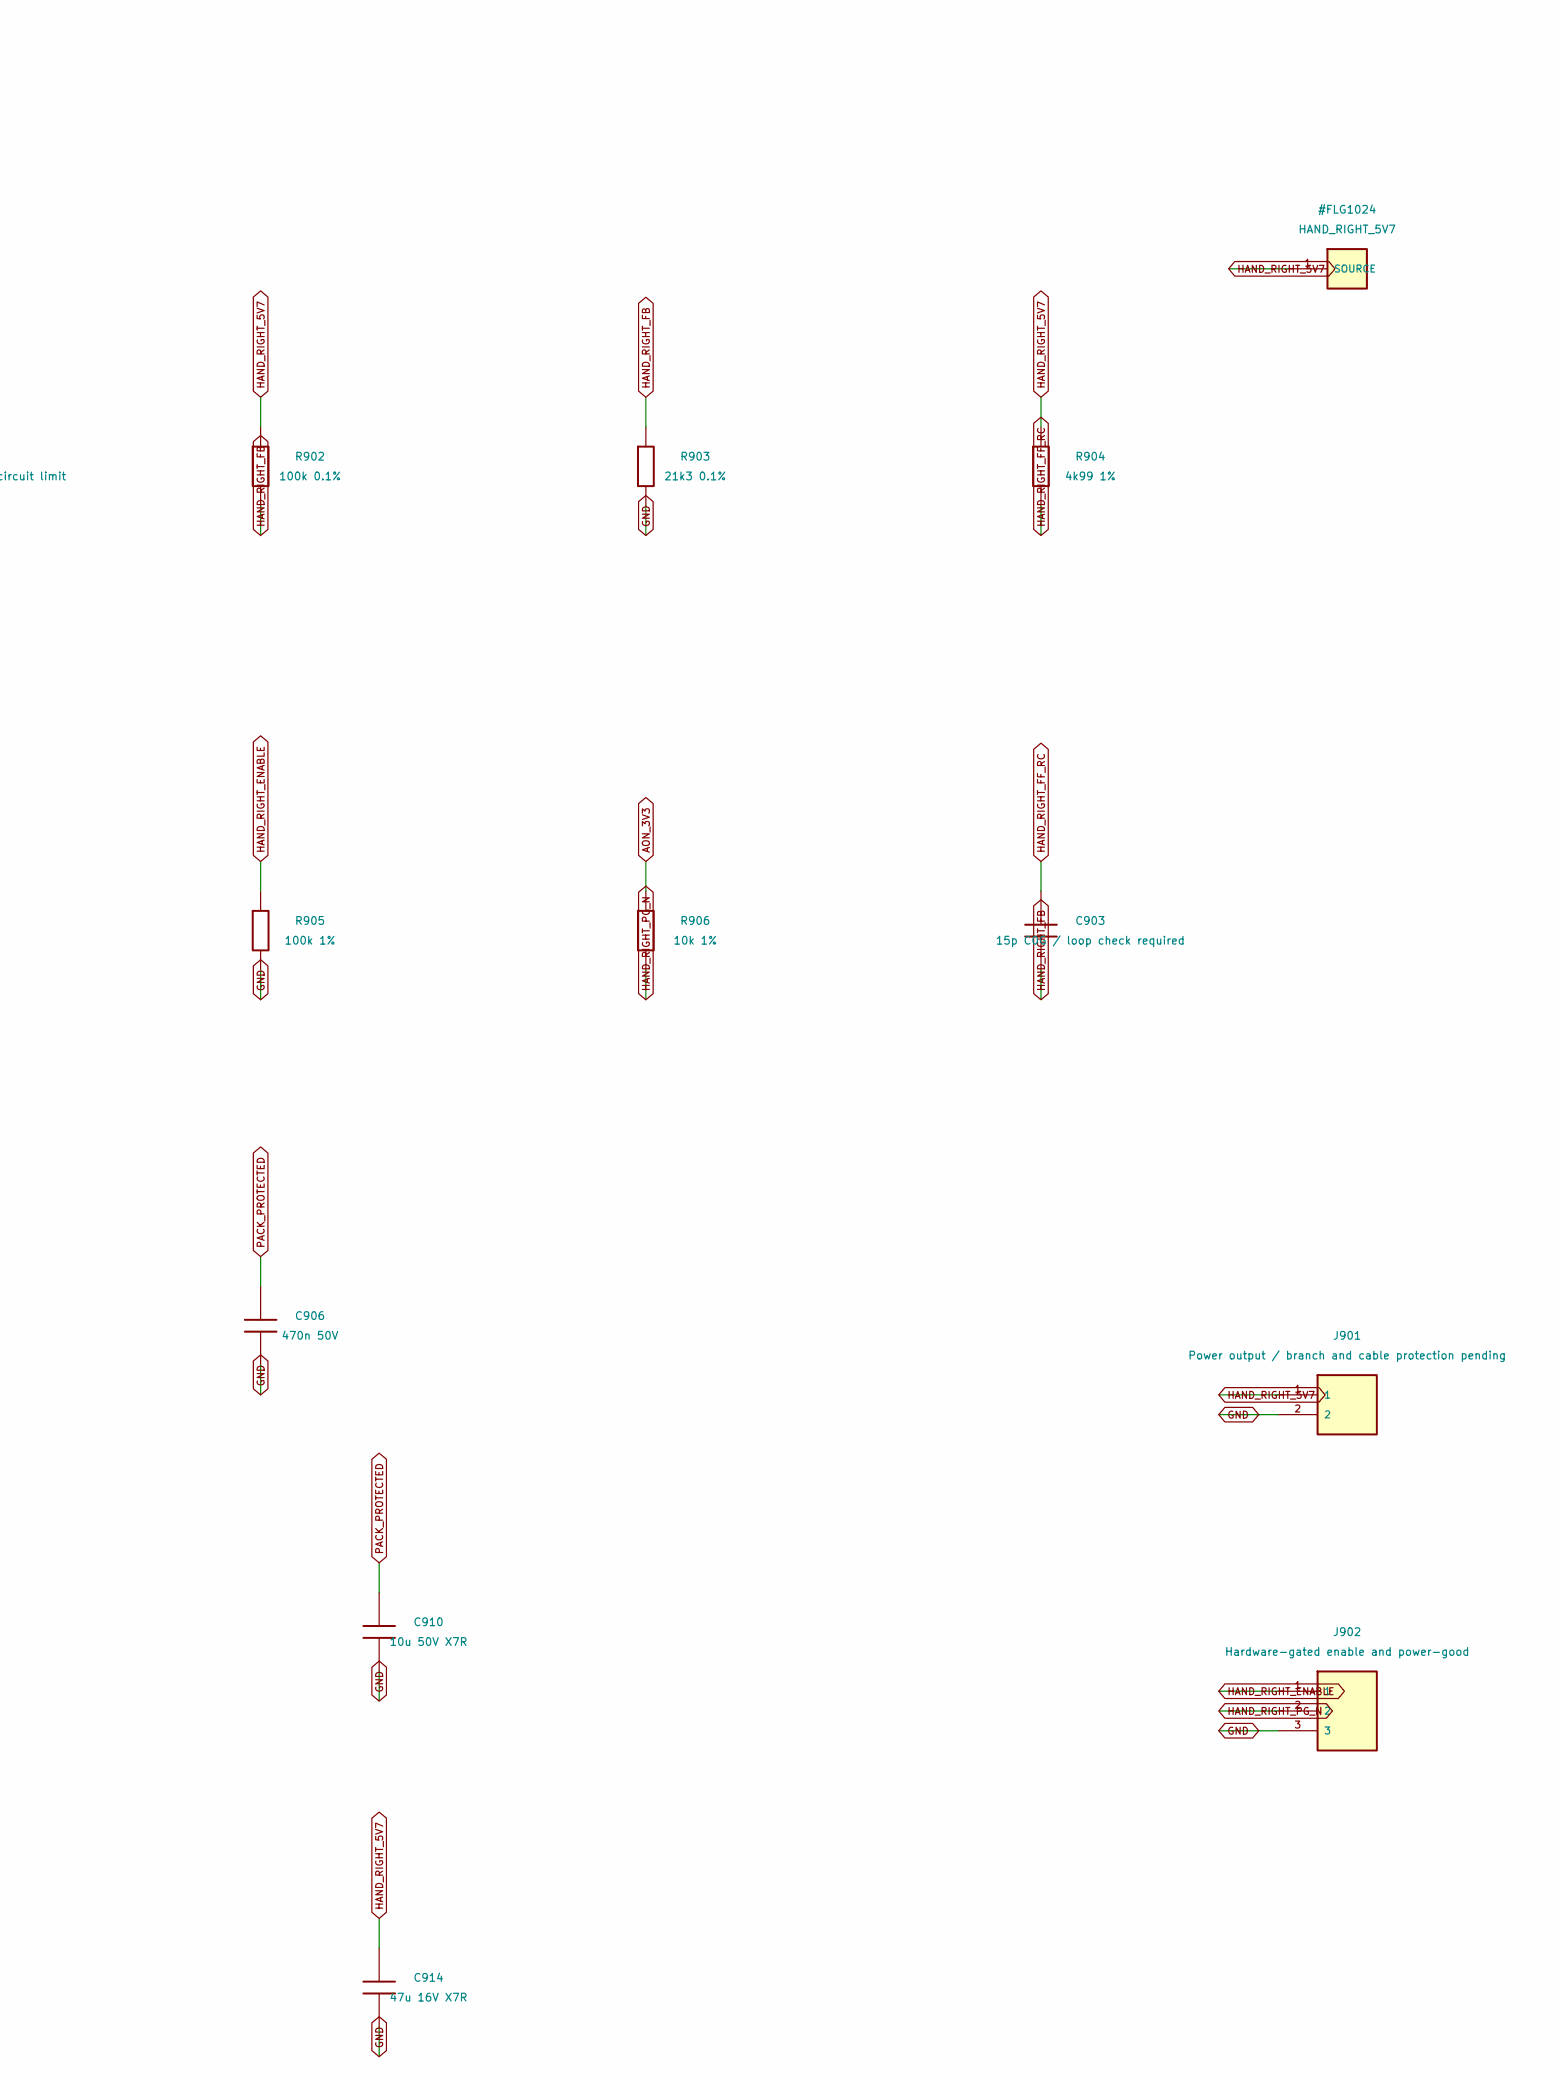
[picture p67: schematic 09-hand-right.kicad_sch, part in row 1, column 2]

Parts:
C901, C904: 100n 16V; C_0603_1608Metric
C902: 1u 10V; C_0603_1608Metric
C903: 15p C0G / loop check required; C_0603_1608Metric
C905, C906: 470n 50V; C_0603_1608Metric
C907, C908, C909, C910: 10u 50V X7R; C_1206_3216Metric
C911, C912, C913, C914: 47u 16V X7R; C_1206_3216Metric
J901: Power output / branch and cable protection pending
J902: Hardware-gated enable and power-good
L901: 4u7 / saturation >= switch short-circuit limit
R901: 0 / gate slew tuning; R_0603_1608Metric
R902: 100k 0.1%; R_0603_1608Metric
R903: 21k3 0.1%; R_0603_1608Metric
R904: 4k99 1%; R_0603_1608Metric
R905: 100k 1%; R_0603_1608Metric
R906: 10k 1%; R_0603_1608Metric
U901: LM61495RPHR; MPN LM61495RPHR

Connections:
AON_3V3: R906.1
GND: C902.2, C904.2, C905.2, C906.2, C907.2, C908.2, C909.2, C910.2, C911.2, C912.2, C913.2, C914.2, J901.2, J902.3, R903.2, R905.2, U901.1 (PGND2), U901.8 (AGND), U901.11 (SPSP), U901.12 (SYNC/MODE), U901.15 (PGND1)
HAND_RIGHT_5V7: C904.1, C911.1, C912.1, C913.1, C914.1, J901.1, L901.2, R902.1, R904.1, U901.5 (BIAS)
HAND_RIGHT_BOOT: C901.1, R901.2, U901.4 (CBOOT)
HAND_RIGHT_ENABLE: J902.1, R905.1, U901.13 (EN)
HAND_RIGHT_FB: C903.2, R902.2, R903.1, U901.7 (FB)
HAND_RIGHT_FF_RC: C903.1, R904.2
HAND_RIGHT_PG_N: J902.2, R906.2, U901.10 (RESET)
HAND_RIGHT_RBOOT: R901.1, U901.3 (RBOOT)
HAND_RIGHT_SW: C901.2, L901.1, U901.16 (SW)
HAND_RIGHT_VCC: C902.1, U901.6 (VCC), U901.9 (RT)
PACK_PROTECTED: C905.1, C906.1, C907.1, C908.1, C909.1, C910.1, U901.2 (VIN2), U901.14 (VIN1)

Notes on the sheet:
RIGHT HAND / 5.695 V nominal / 10-A converter class
LM61495RPHR adjustable variant, SNVSBZ4A Table 6-1. 400 kHz. Nominal voltage is below 6 V to reserve margin for the SCS0009 maximum; confirm exact servo specification. 8.2 A summed stall reference per hand is a pulse/fault test condition, not an intended continuous load.
