iimmyy/Little-Guy/hardware/little-guy-v2/pcb/power/10-motor-cut.kicad_sch

## KiCad design hardware/little-guy-v2/pcb/power/10-motor-cut.kicad_sch (2026-11-07)

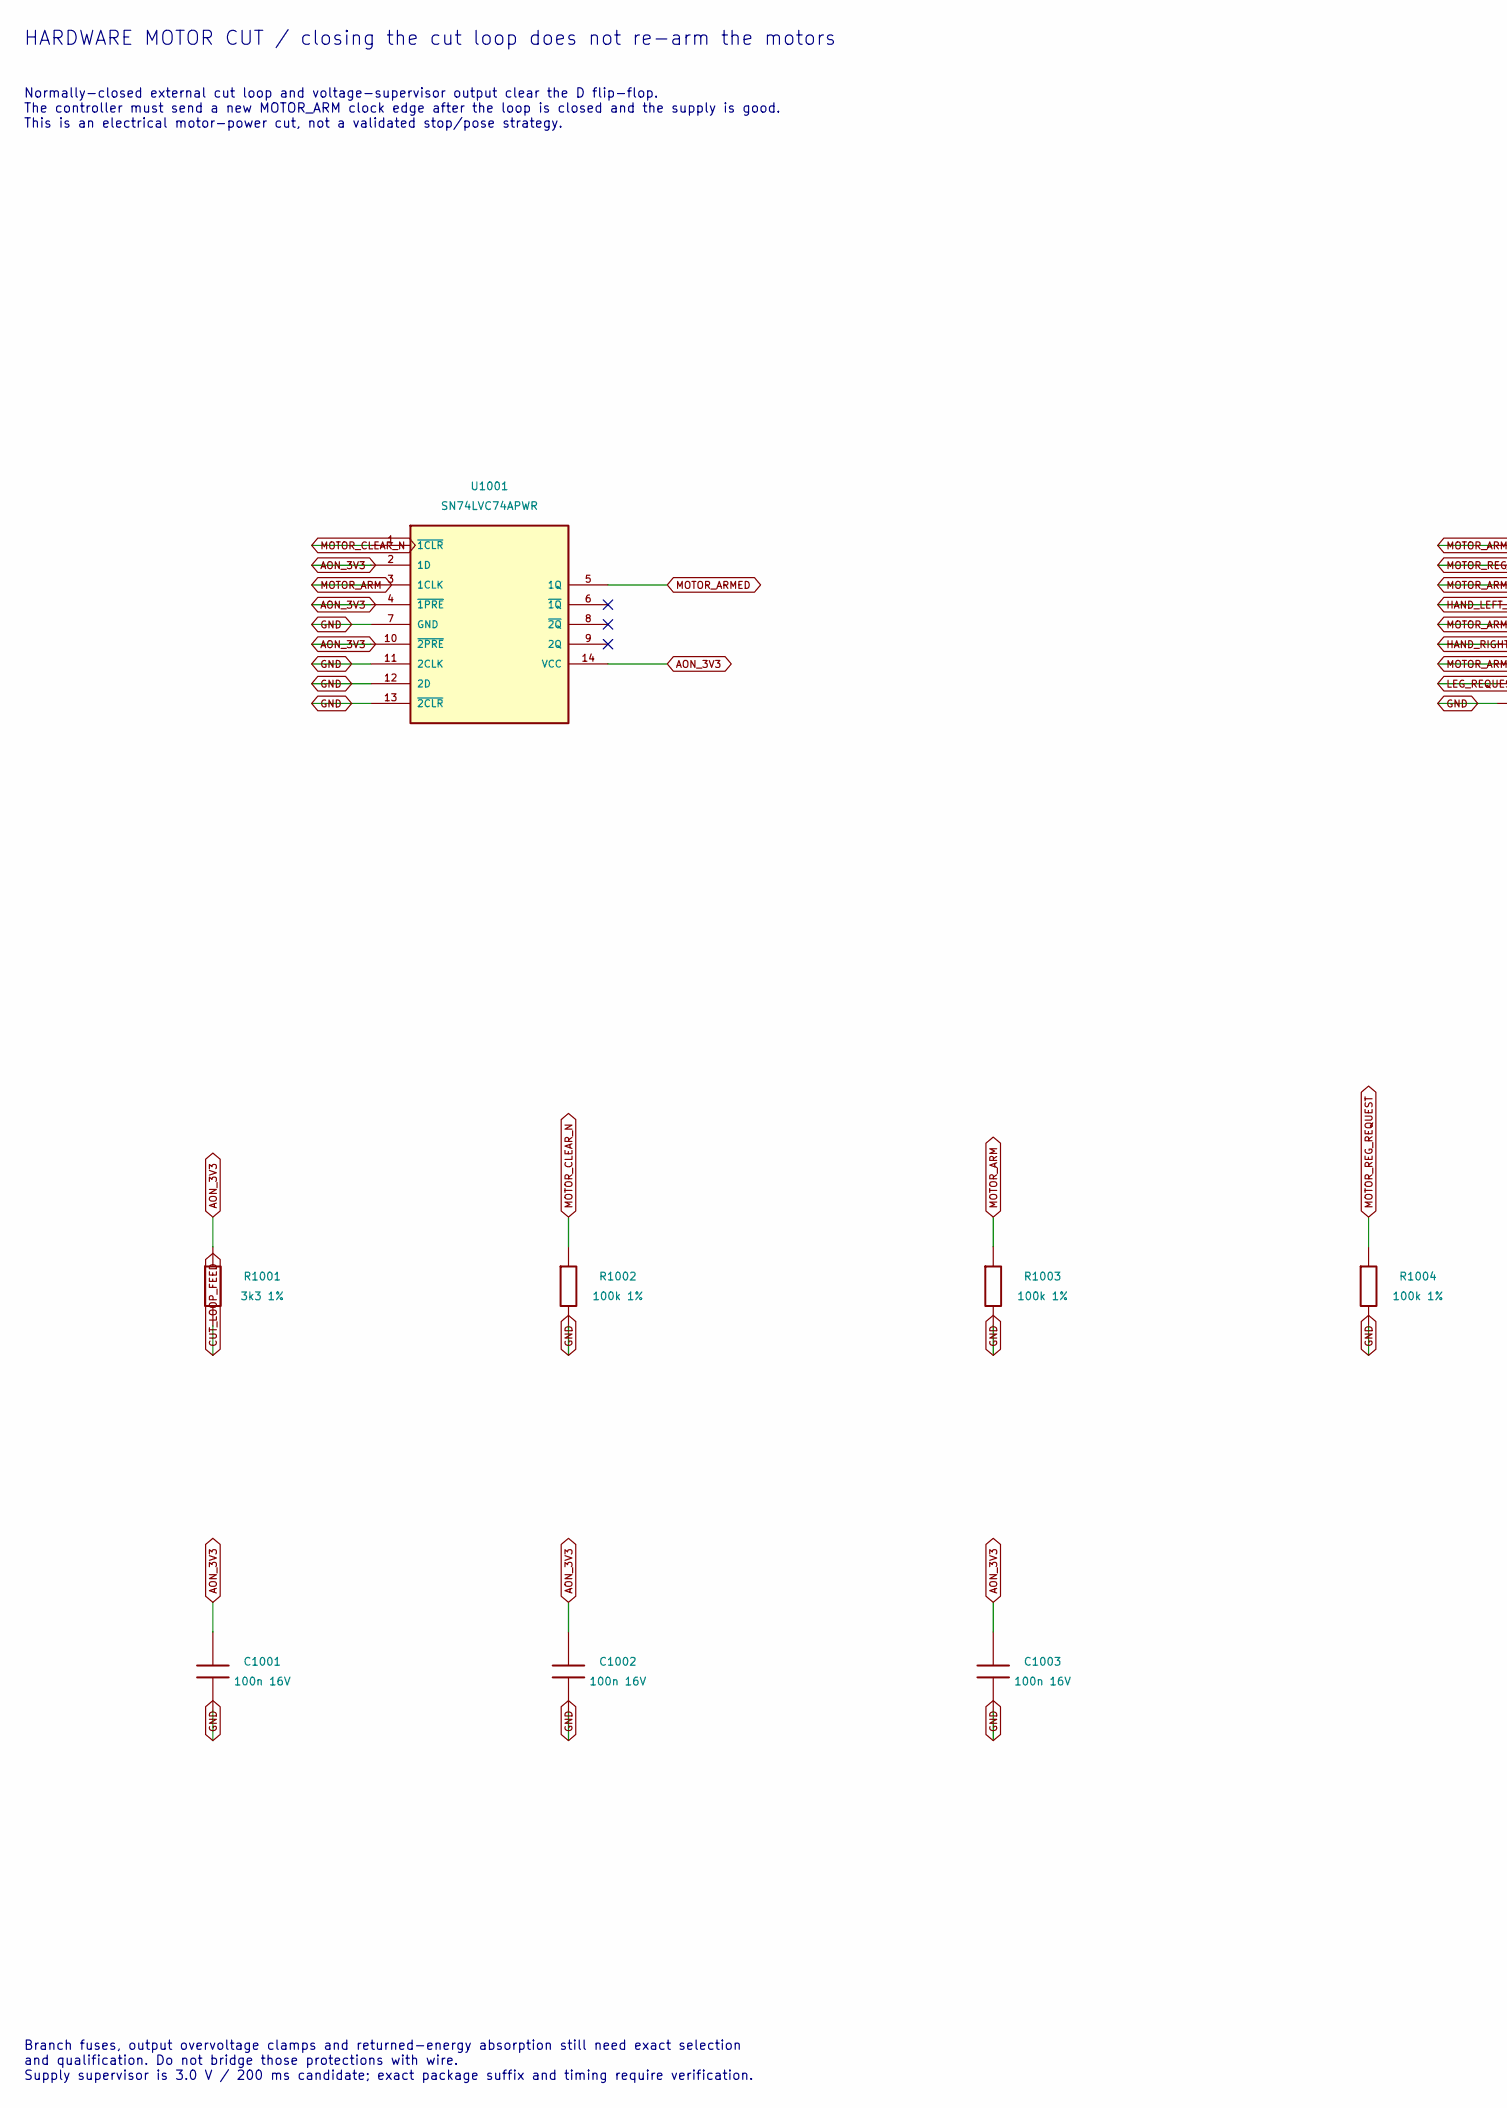
[picture p68: schematic 10-motor-cut.kicad_sch, part in row 1, column 1]

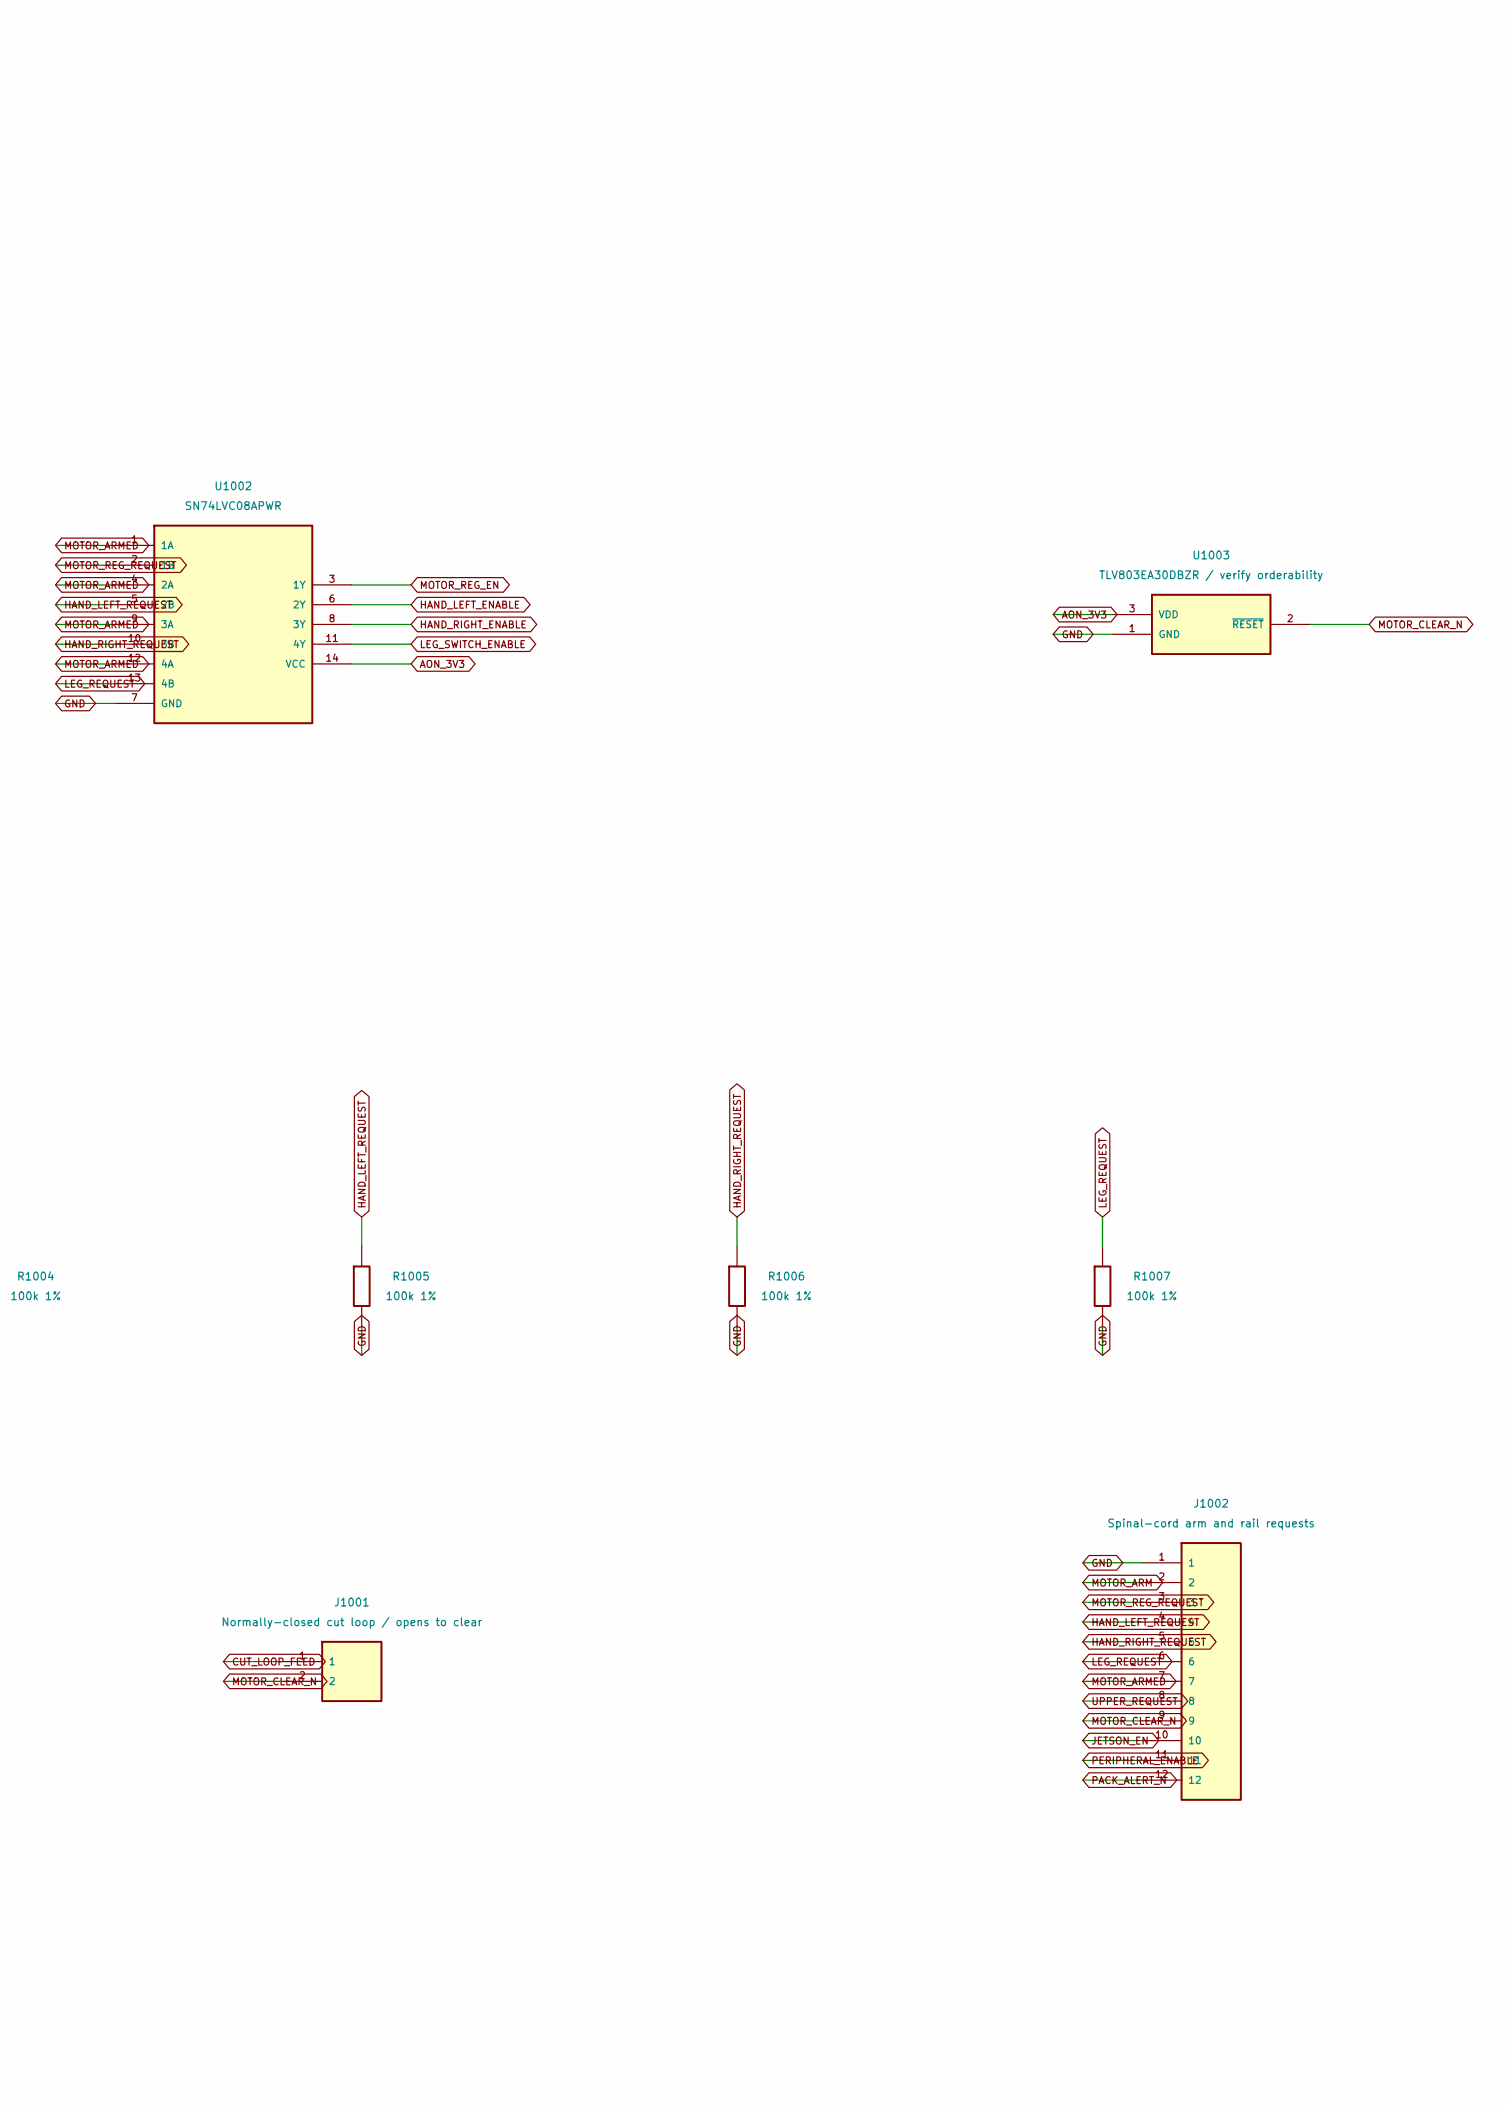
[picture p69: schematic 10-motor-cut.kicad_sch, part in row 1, column 2]

Parts:
C1001, C1002, C1003: 100n 16V; C_0603_1608Metric
J1001: Normally-closed cut loop / opens to clear
J1002: Spinal-cord arm and rail requests
R1001: 3k3 1%; R_0603_1608Metric
R1002, R1003, R1004, R1005, R1006, R1007: 100k 1%; R_0603_1608Metric
U1001: SN74LVC74APWR; TSSOP-14_4.4x5mm_P0.65mm; MPN SN74LVC74APWR
U1002: SN74LVC08APWR; TSSOP-14_4.4x5mm_P0.65mm; MPN SN74LVC08APWR
U1003: TLV803EA30DBZR / verify orderability; SOT-23; MPN TLV803EA30DBZR

Connections:
AON_3V3: C1001.1, C1002.1, C1003.1, R1001.1, U1001.2 (1D), U1001.4 (~1PRE), U1001.10 (~2PRE), U1001.14 (VCC), U1002.14 (VCC), U1003.3 (VDD)
CUT_LOOP_FEED: J1001.1, R1001.2
GND: C1001.2, C1002.2, C1003.2, J1002.1, R1002.2, R1003.2, R1004.2, R1005.2, R1006.2, R1007.2, U1001.7 (GND), U1001.11 (2CLK), U1001.12 (2D), U1001.13 (~2CLR), U1002.7 (GND), U1003.1 (GND)
HAND_LEFT_ENABLE: U1002.6 (2Y)
HAND_LEFT_REQUEST: J1002.4, R1005.1, U1002.5 (2B)
HAND_RIGHT_ENABLE: U1002.8 (3Y)
HAND_RIGHT_REQUEST: J1002.5, R1006.1, U1002.10 (3B)
JETSON_EN: J1002.10
LEG_REQUEST: J1002.6, R1007.1, U1002.13 (4B)
LEG_SWITCH_ENABLE: U1002.11 (4Y)
MOTOR_ARM: J1002.2, R1003.1, U1001.3 (1CLK)
MOTOR_ARMED: J1002.7, U1001.5 (1Q), U1002.1 (1A), U1002.4 (2A), U1002.9 (3A), U1002.12 (4A)
MOTOR_CLEAR_N: J1001.2, J1002.9, R1002.1, U1001.1 (~1CLR), U1003.2 (~RESET)
MOTOR_REG_EN: U1002.3 (1Y)
MOTOR_REG_REQUEST: J1002.3, R1004.1, U1002.2 (1B)
PACK_ALERT_N: J1002.12
PERIPHERAL_ENABLE: J1002.11
UPPER_REQUEST: J1002.8

Notes on the sheet:
HARDWARE MOTOR CUT / closing the cut loop does not re-arm the motors
Normally-closed external cut loop and voltage-supervisor output clear the D flip-flop. The controller must send a new MOTOR_ARM clock edge after the loop is closed and the supply is good. This is an electrical motor-power cut, not a validated stop/pose strategy.
Branch fuses, output overvoltage clamps and returned-energy absorption still need exact selection and qualification. Do not bridge those protections with wire. Supply supervisor is 3.0 V / 200 ms candidate; exact package suffix and timing require verification.
