iimmyy/Little-Guy/hardware/little-guy-v2/pcb/power/11-pack-meter.kicad_sch

## KiCad design hardware/little-guy-v2/pcb/power/11-pack-meter.kicad_sch (2026-11-07)

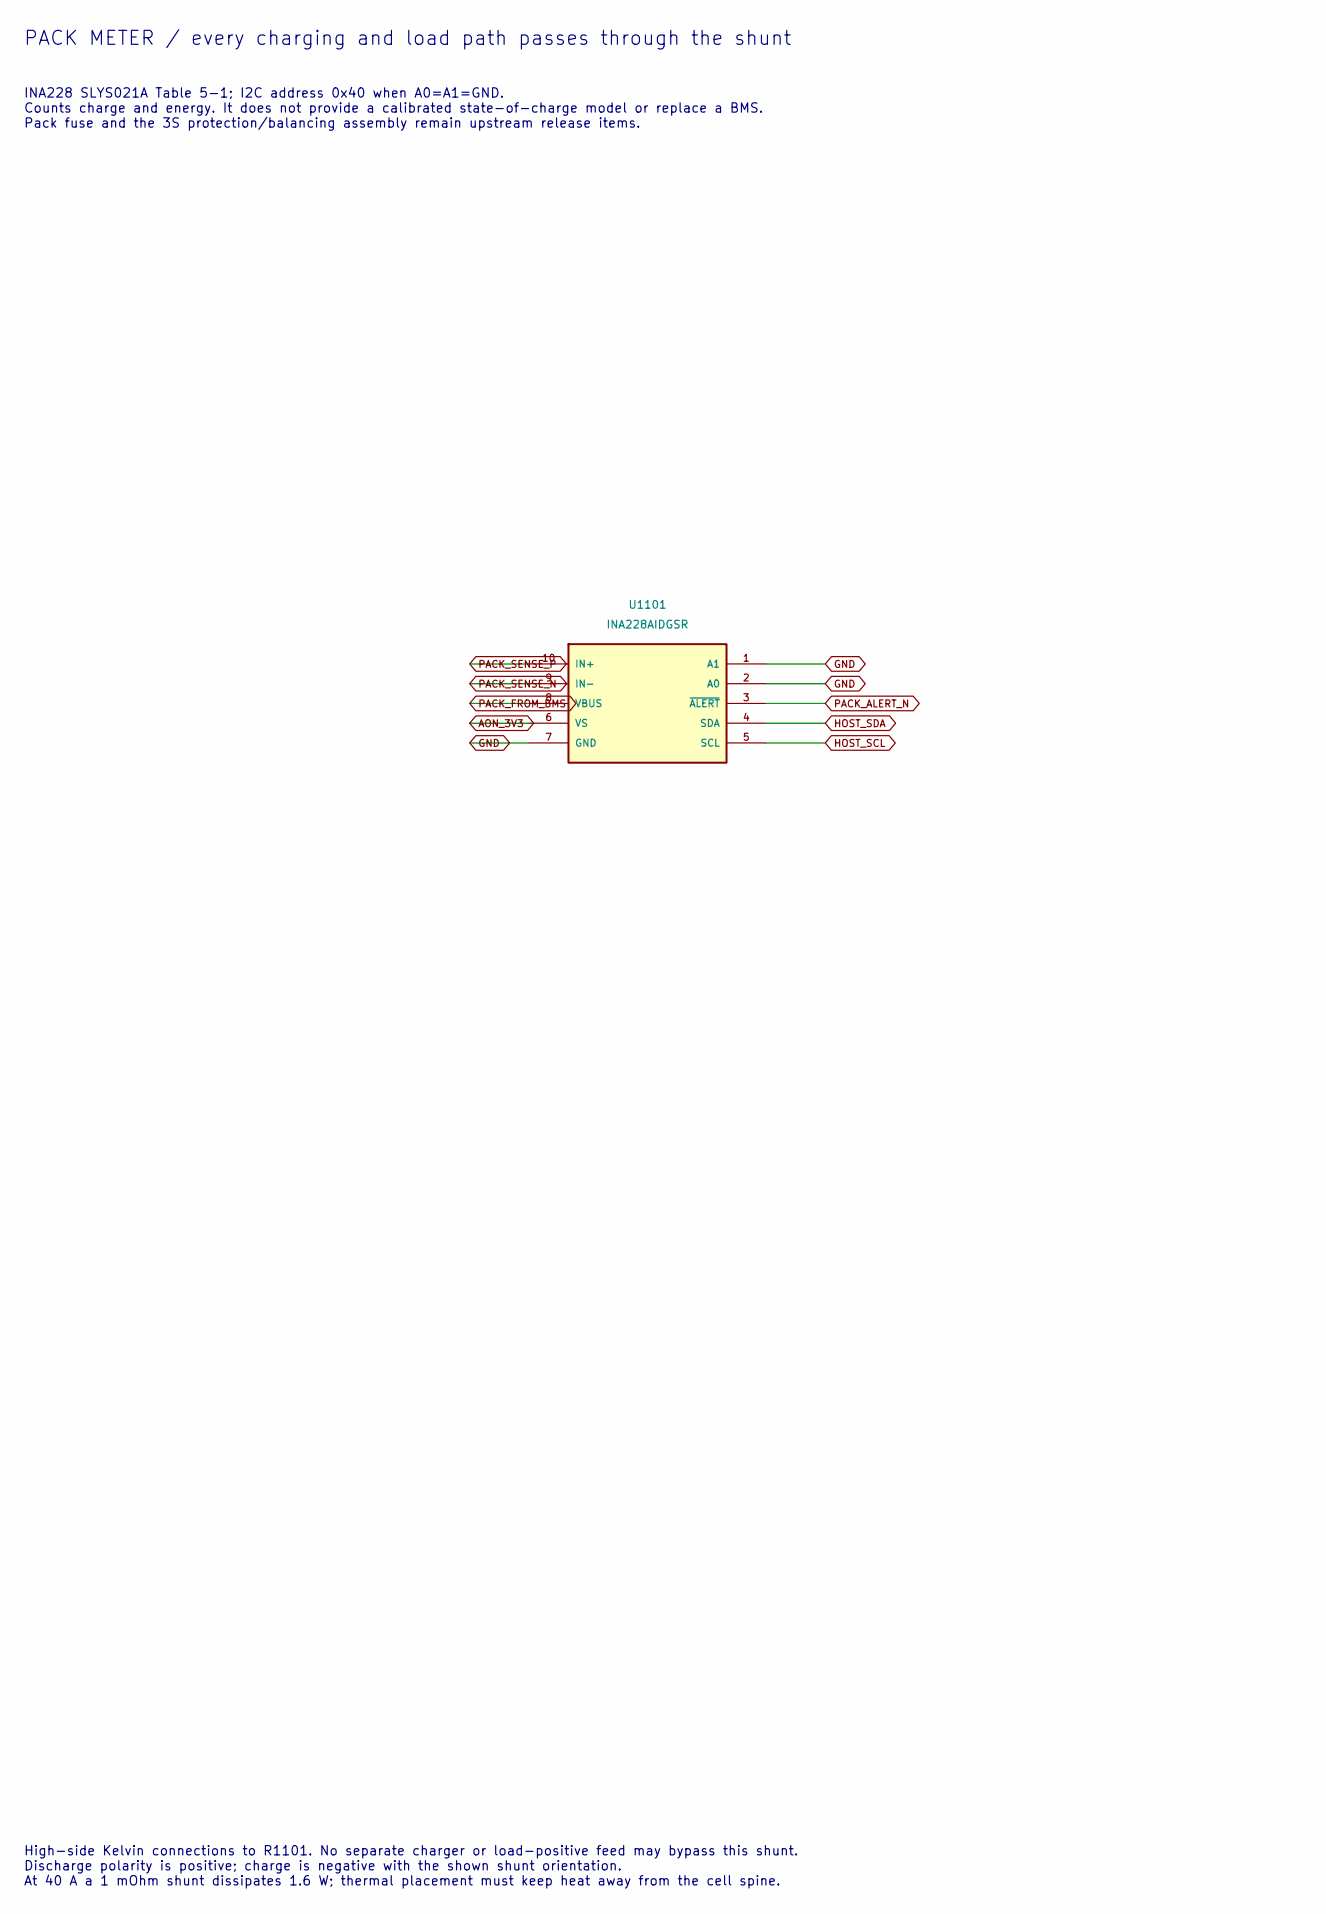
[picture p70: schematic 11-pack-meter.kicad_sch, part in row 1, column 1]

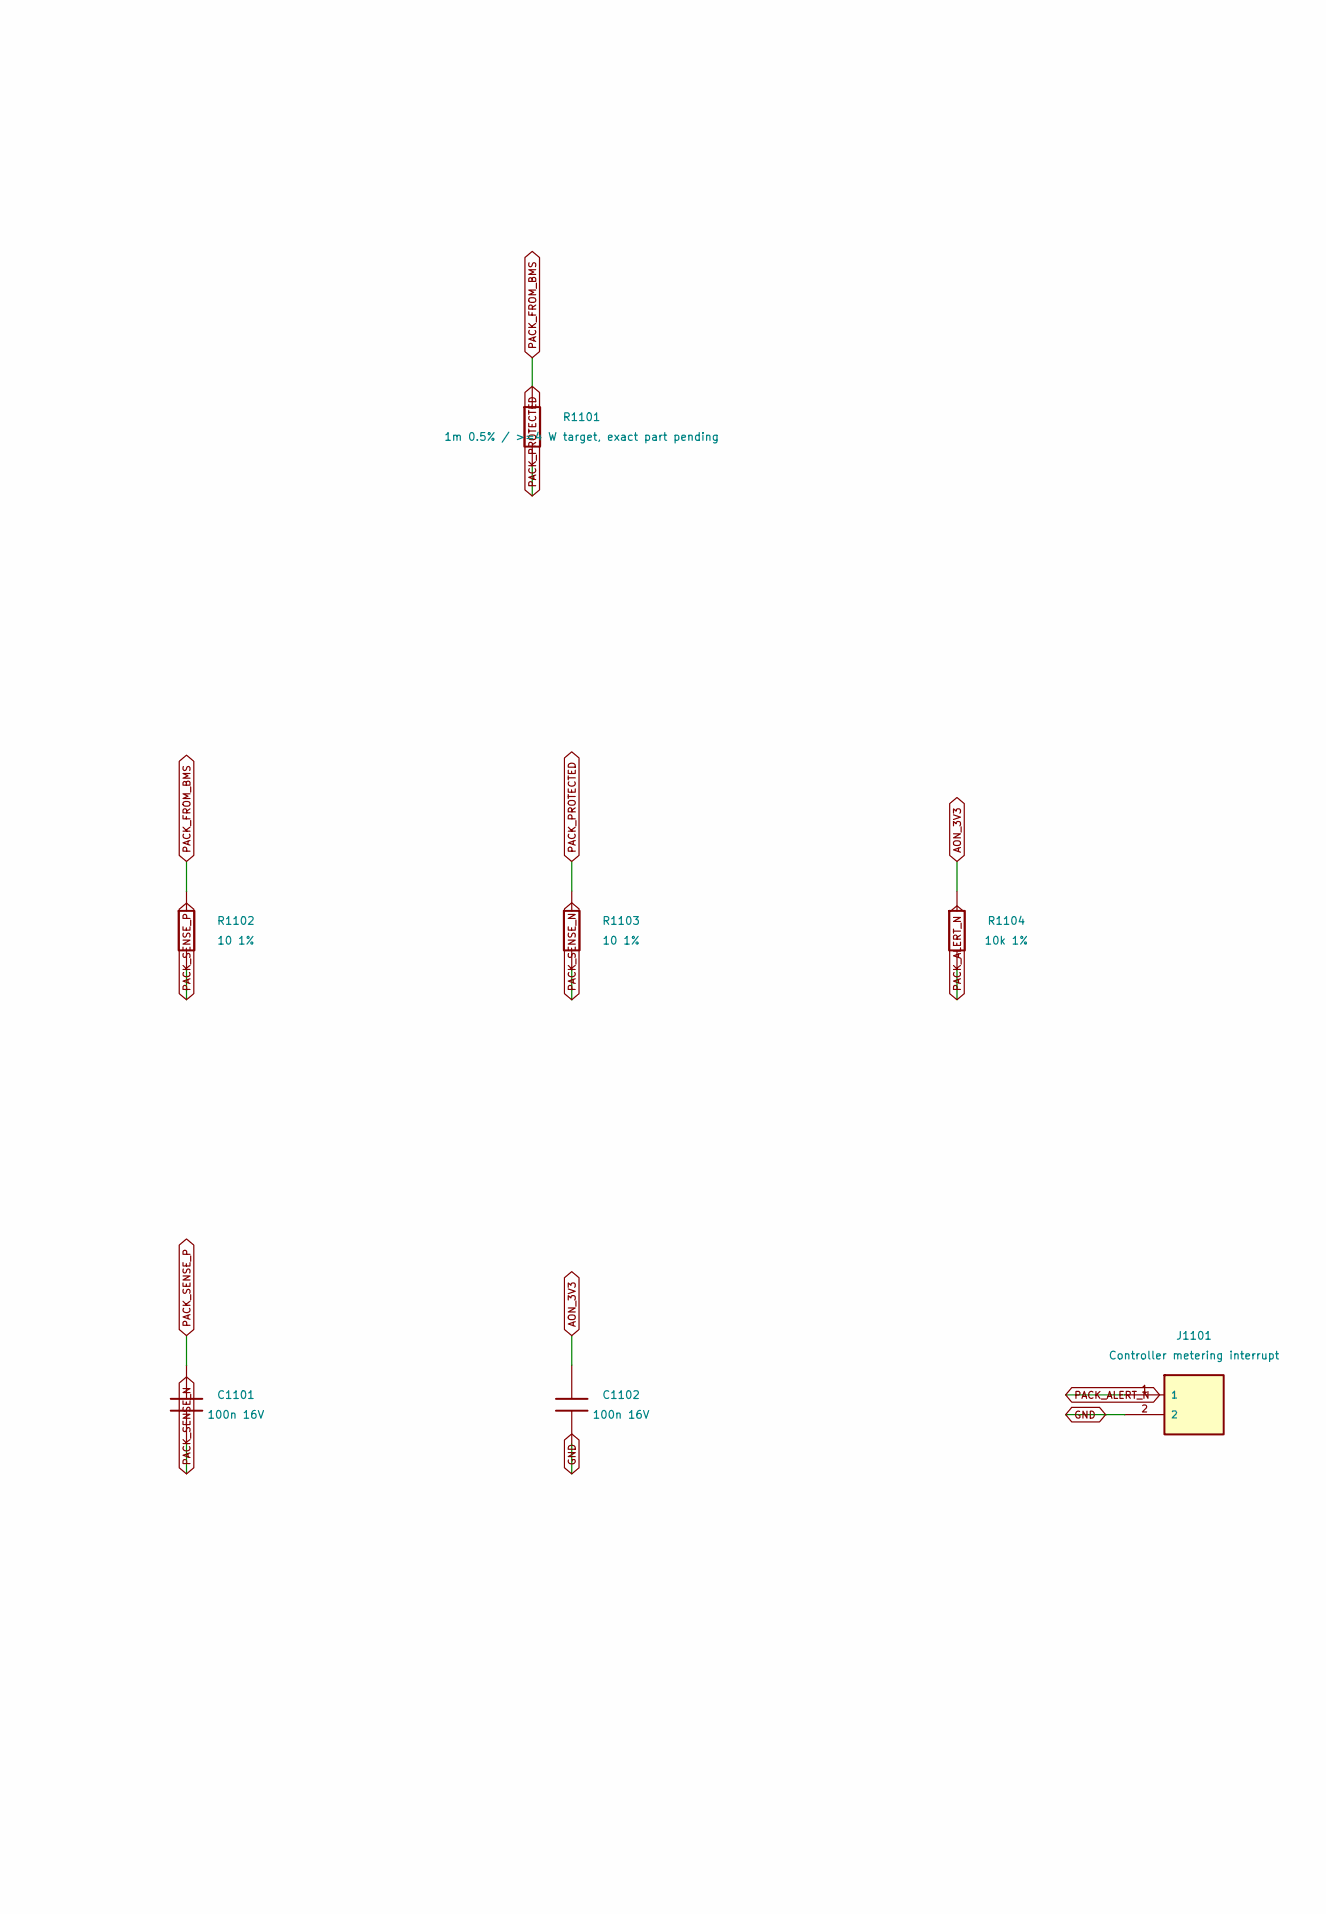
[picture p71: schematic 11-pack-meter.kicad_sch, part in row 1, column 2]

Parts:
C1101, C1102: 100n 16V; C_0603_1608Metric
J1101: Controller metering interrupt
R1101: 1m 0.5% / >=4 W target, exact part pending
R1102, R1103: 10 1%; R_0603_1608Metric
R1104: 10k 1%; R_0603_1608Metric
U1101: INA228AIDGSR; MSOP-10_3x3mm_P0.5mm; MPN INA228AIDGSR

Connections:
AON_3V3: C1102.1, R1104.1, U1101.6 (VS)
GND: C1102.2, J1101.2, U1101.1 (A1), U1101.2 (A0), U1101.7 (GND)
HOST_SCL: U1101.5 (SCL)
HOST_SDA: U1101.4 (SDA)
PACK_ALERT_N: J1101.1, R1104.2, U1101.3 (~ALERT)
PACK_FROM_BMS: R1101.1, R1102.1, U1101.8 (VBUS)
PACK_PROTECTED: R1101.2, R1103.1
PACK_SENSE_N: C1101.2, R1103.2, U1101.9 (IN-)
PACK_SENSE_P: C1101.1, R1102.2, U1101.10 (IN+)

Notes on the sheet:
PACK METER / every charging and load path passes through the shunt
INA228 SLYS021A Table 5-1; I2C address 0x40 when A0=A1=GND. Counts charge and energy. It does not provide a calibrated state-of-charge model or replace a BMS. Pack fuse and the 3S protection/balancing assembly remain upstream release items.
High-side Kelvin connections to R1101. No separate charger or load-positive feed may bypass this shunt. Discharge polarity is positive; charge is negative with the shown shunt orientation. At 40 A a 1 mOhm shunt dissipates 1.6 W; thermal placement must keep heat away from the cell spine.
