iimmyy/Little-Guy/hardware/little-guy-v2/pcb/power/12-pack-temperature.kicad_sch

## KiCad design hardware/little-guy-v2/pcb/power/12-pack-temperature.kicad_sch (2026-11-07)

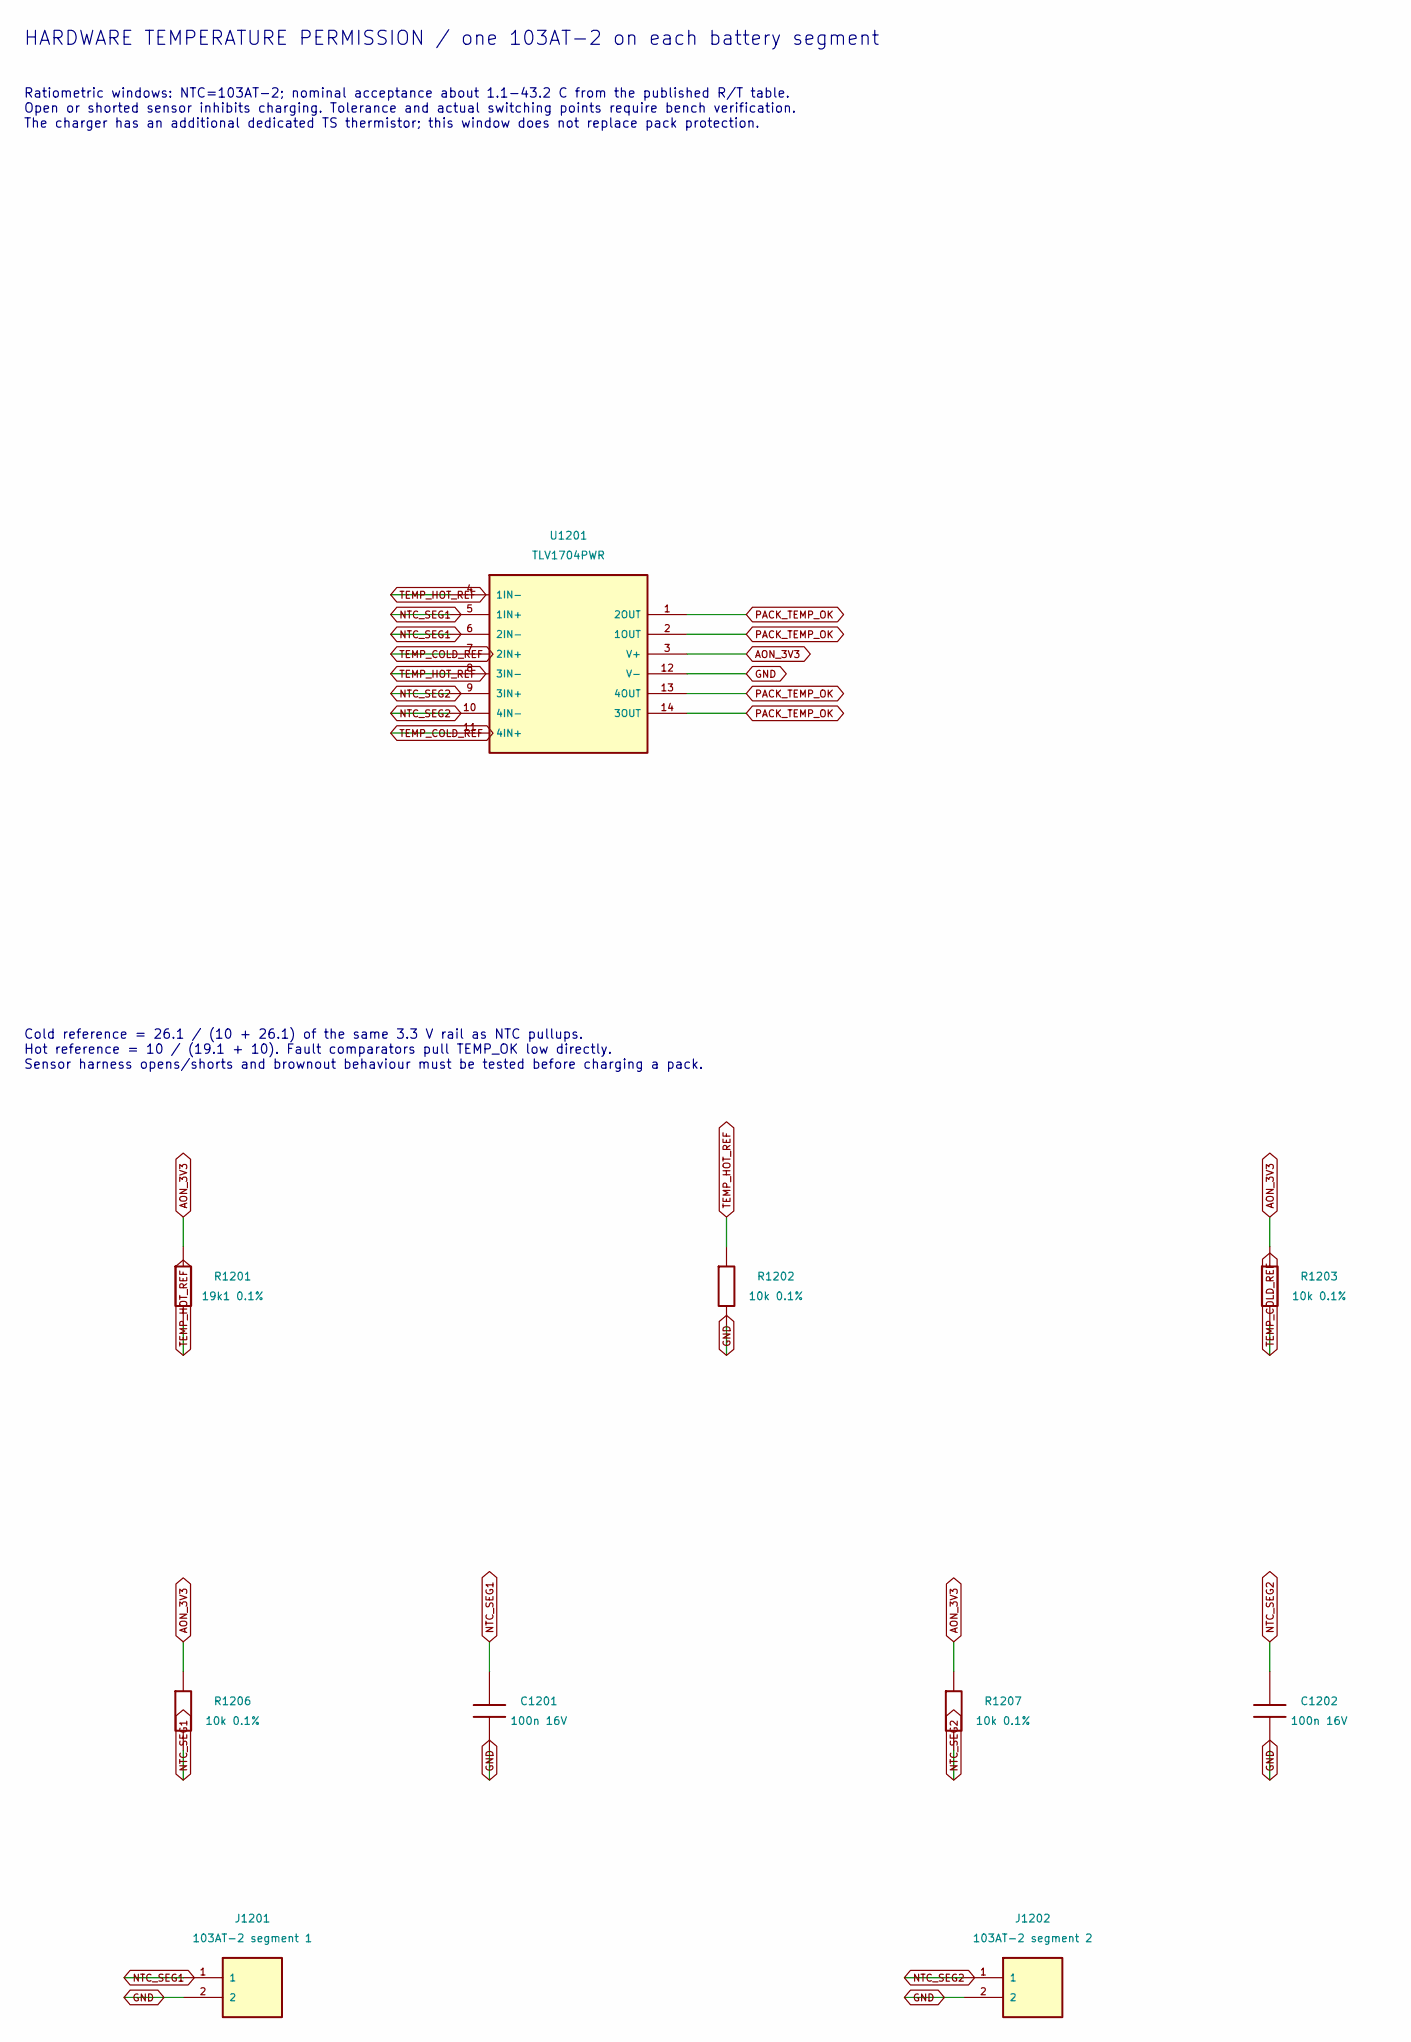
[picture p72: schematic 12-pack-temperature.kicad_sch, part in row 1, column 1]

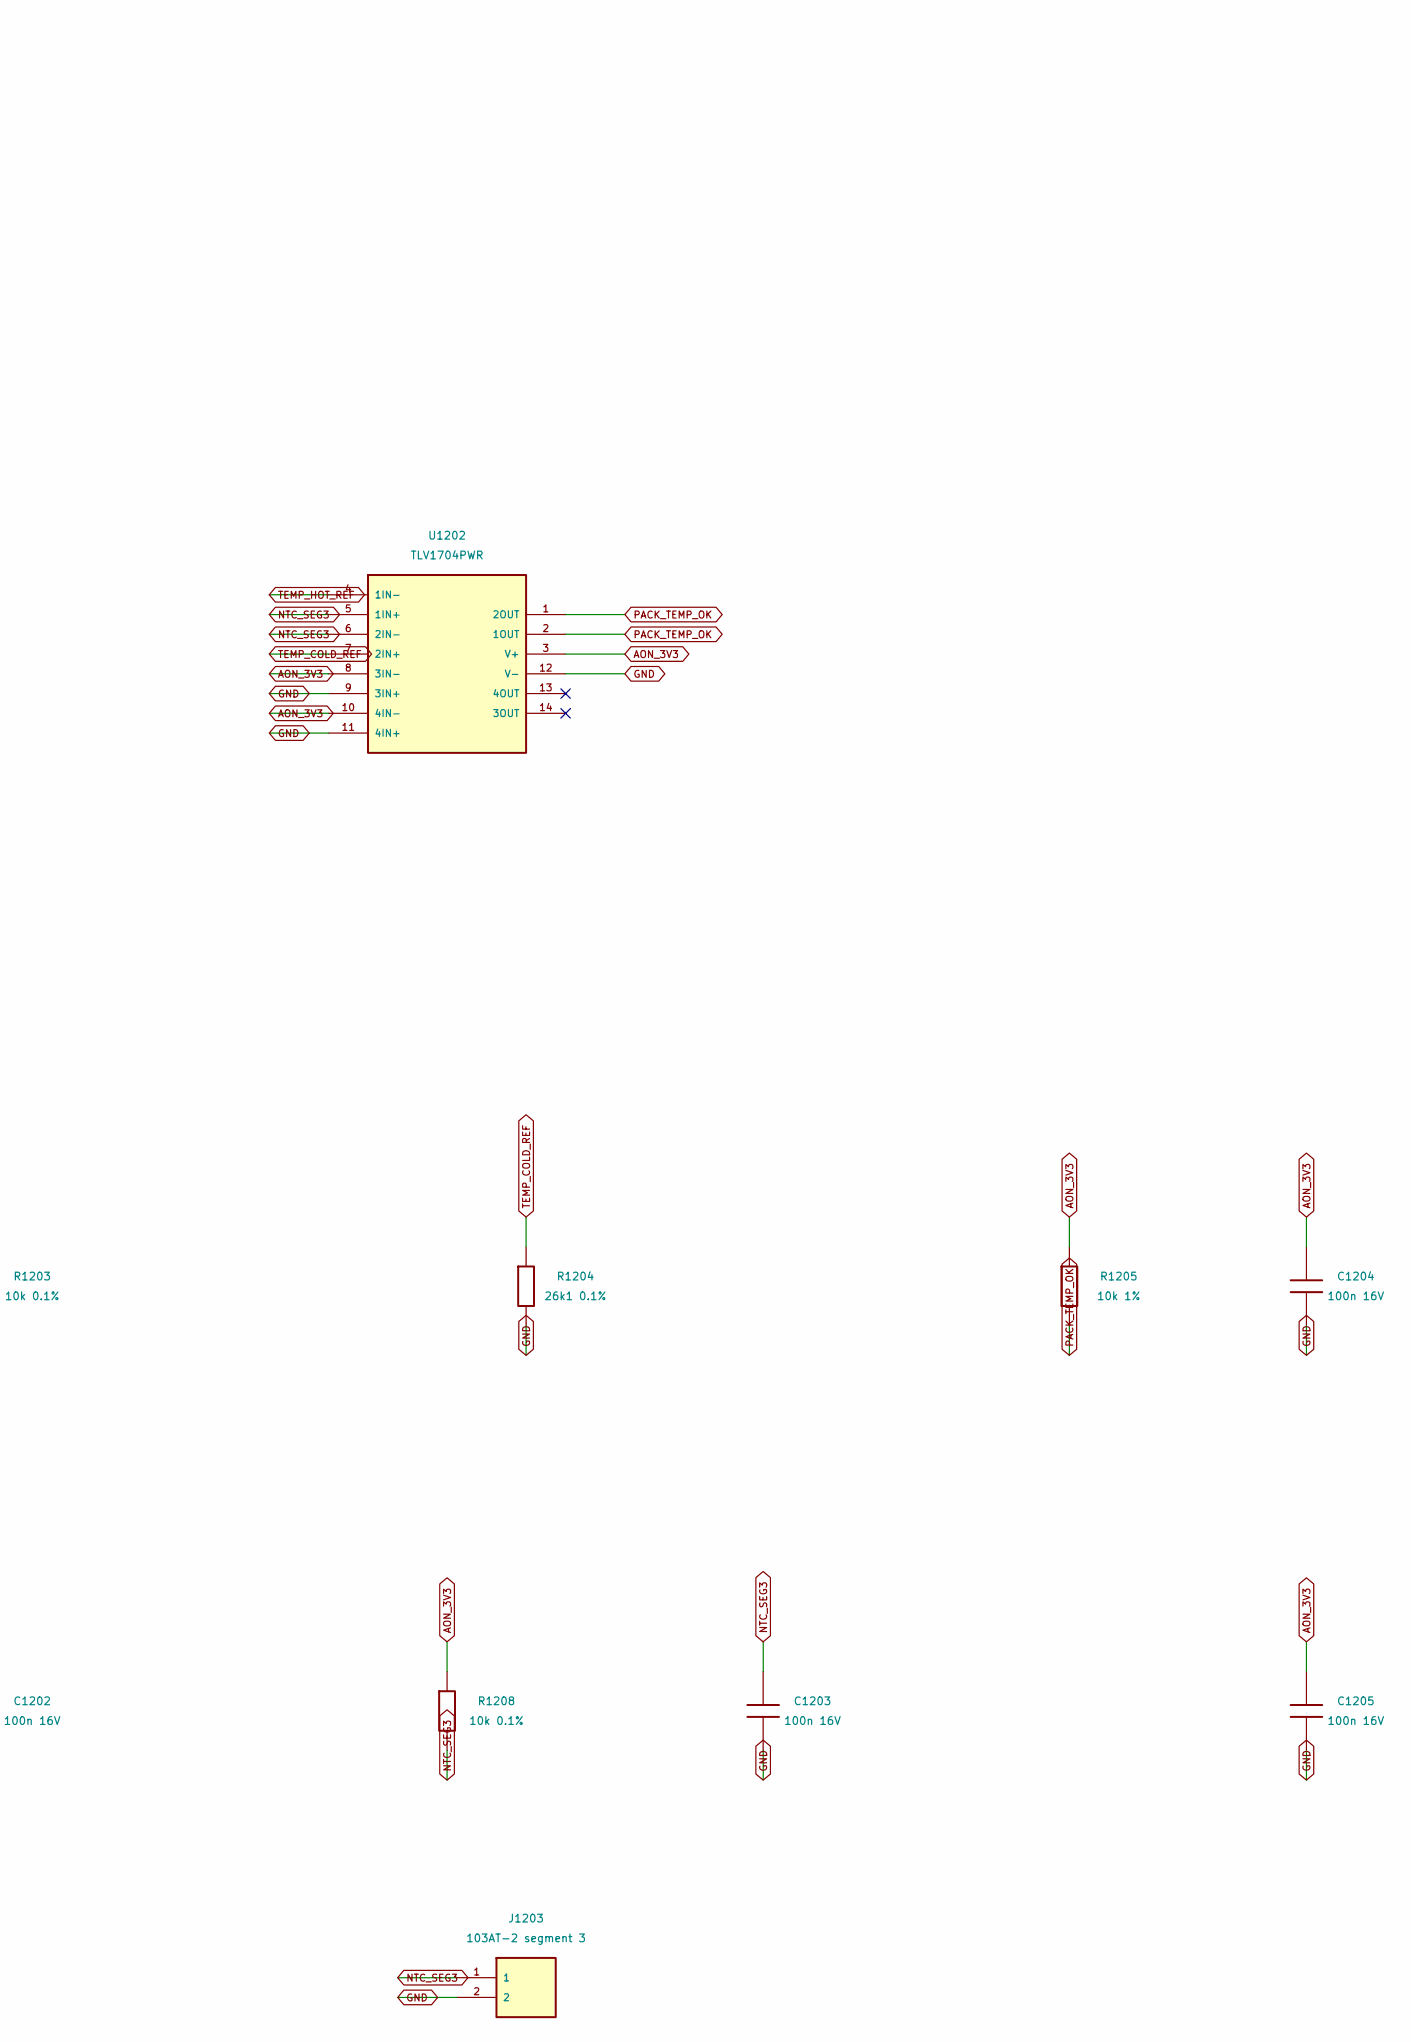
[picture p73: schematic 12-pack-temperature.kicad_sch, part in row 1, column 2]

Parts:
C1201, C1202, C1203, C1204, C1205: 100n 16V; C_0603_1608Metric
J1201: 103AT-2 segment 1
J1202: 103AT-2 segment 2
J1203: 103AT-2 segment 3
R1201: 19k1 0.1%; R_0603_1608Metric
R1202, R1203, R1206, R1207, R1208: 10k 0.1%; R_0603_1608Metric
R1204: 26k1 0.1%; R_0603_1608Metric
R1205: 10k 1%; R_0603_1608Metric
U1201, U1202: TLV1704PWR; TSSOP-14_4.4x5mm_P0.65mm; MPN TLV1704PWR

Connections:
AON_3V3: C1204.1, C1205.1, R1201.1, R1203.1, R1205.1, R1206.1, R1207.1, R1208.1, U1201.3 (V+), U1202.3 (V+), U1202.8 (3IN-), U1202.10 (4IN-)
GND: C1201.2, C1202.2, C1203.2, C1204.2, C1205.2, J1201.2, J1202.2, J1203.2, R1202.2, R1204.2, U1201.12 (V-), U1202.9 (3IN+), U1202.11 (4IN+), U1202.12 (V-)
NTC_SEG1: C1201.1, J1201.1, R1206.2, U1201.5 (1IN+), U1201.6 (2IN-)
NTC_SEG2: C1202.1, J1202.1, R1207.2, U1201.9 (3IN+), U1201.10 (4IN-)
NTC_SEG3: C1203.1, J1203.1, R1208.2, U1202.5 (1IN+), U1202.6 (2IN-)
PACK_TEMP_OK: R1205.2, U1201.1 (2OUT), U1201.2 (1OUT), U1201.13 (4OUT), U1201.14 (3OUT), U1202.1 (2OUT), U1202.2 (1OUT)
TEMP_COLD_REF: R1203.2, R1204.1, U1201.7 (2IN+), U1201.11 (4IN+), U1202.7 (2IN+)
TEMP_HOT_REF: R1201.2, R1202.1, U1201.4 (1IN-), U1201.8 (3IN-), U1202.4 (1IN-)

Notes on the sheet:
HARDWARE TEMPERATURE PERMISSION / one 103AT-2 on each battery segment
Ratiometric windows: NTC=103AT-2; nominal acceptance about 1.1-43.2 C from the published R/T table. Open or shorted sensor inhibits charging. Tolerance and actual switching points require bench verification. The charger has an additional dedicated TS thermistor; this window does not replace pack pr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
Cold reference = 26.1 / (10 + 26.1) of the same 3.3 V rail as NTC pullups. Hot reference = 10 / (19.1 + 10). Fault comparators pull TEMP_OK low directly. Sensor harness opens/shorts and brownout behaviour must be tested before charging a pack.
