iimmyy/Little-Guy/hardware/little-guy-v2/pcb/power/13-motor-branches.kicad_sch

## KiCad design hardware/little-guy-v2/pcb/power/13-motor-branches.kicad_sch (2026-11-07)

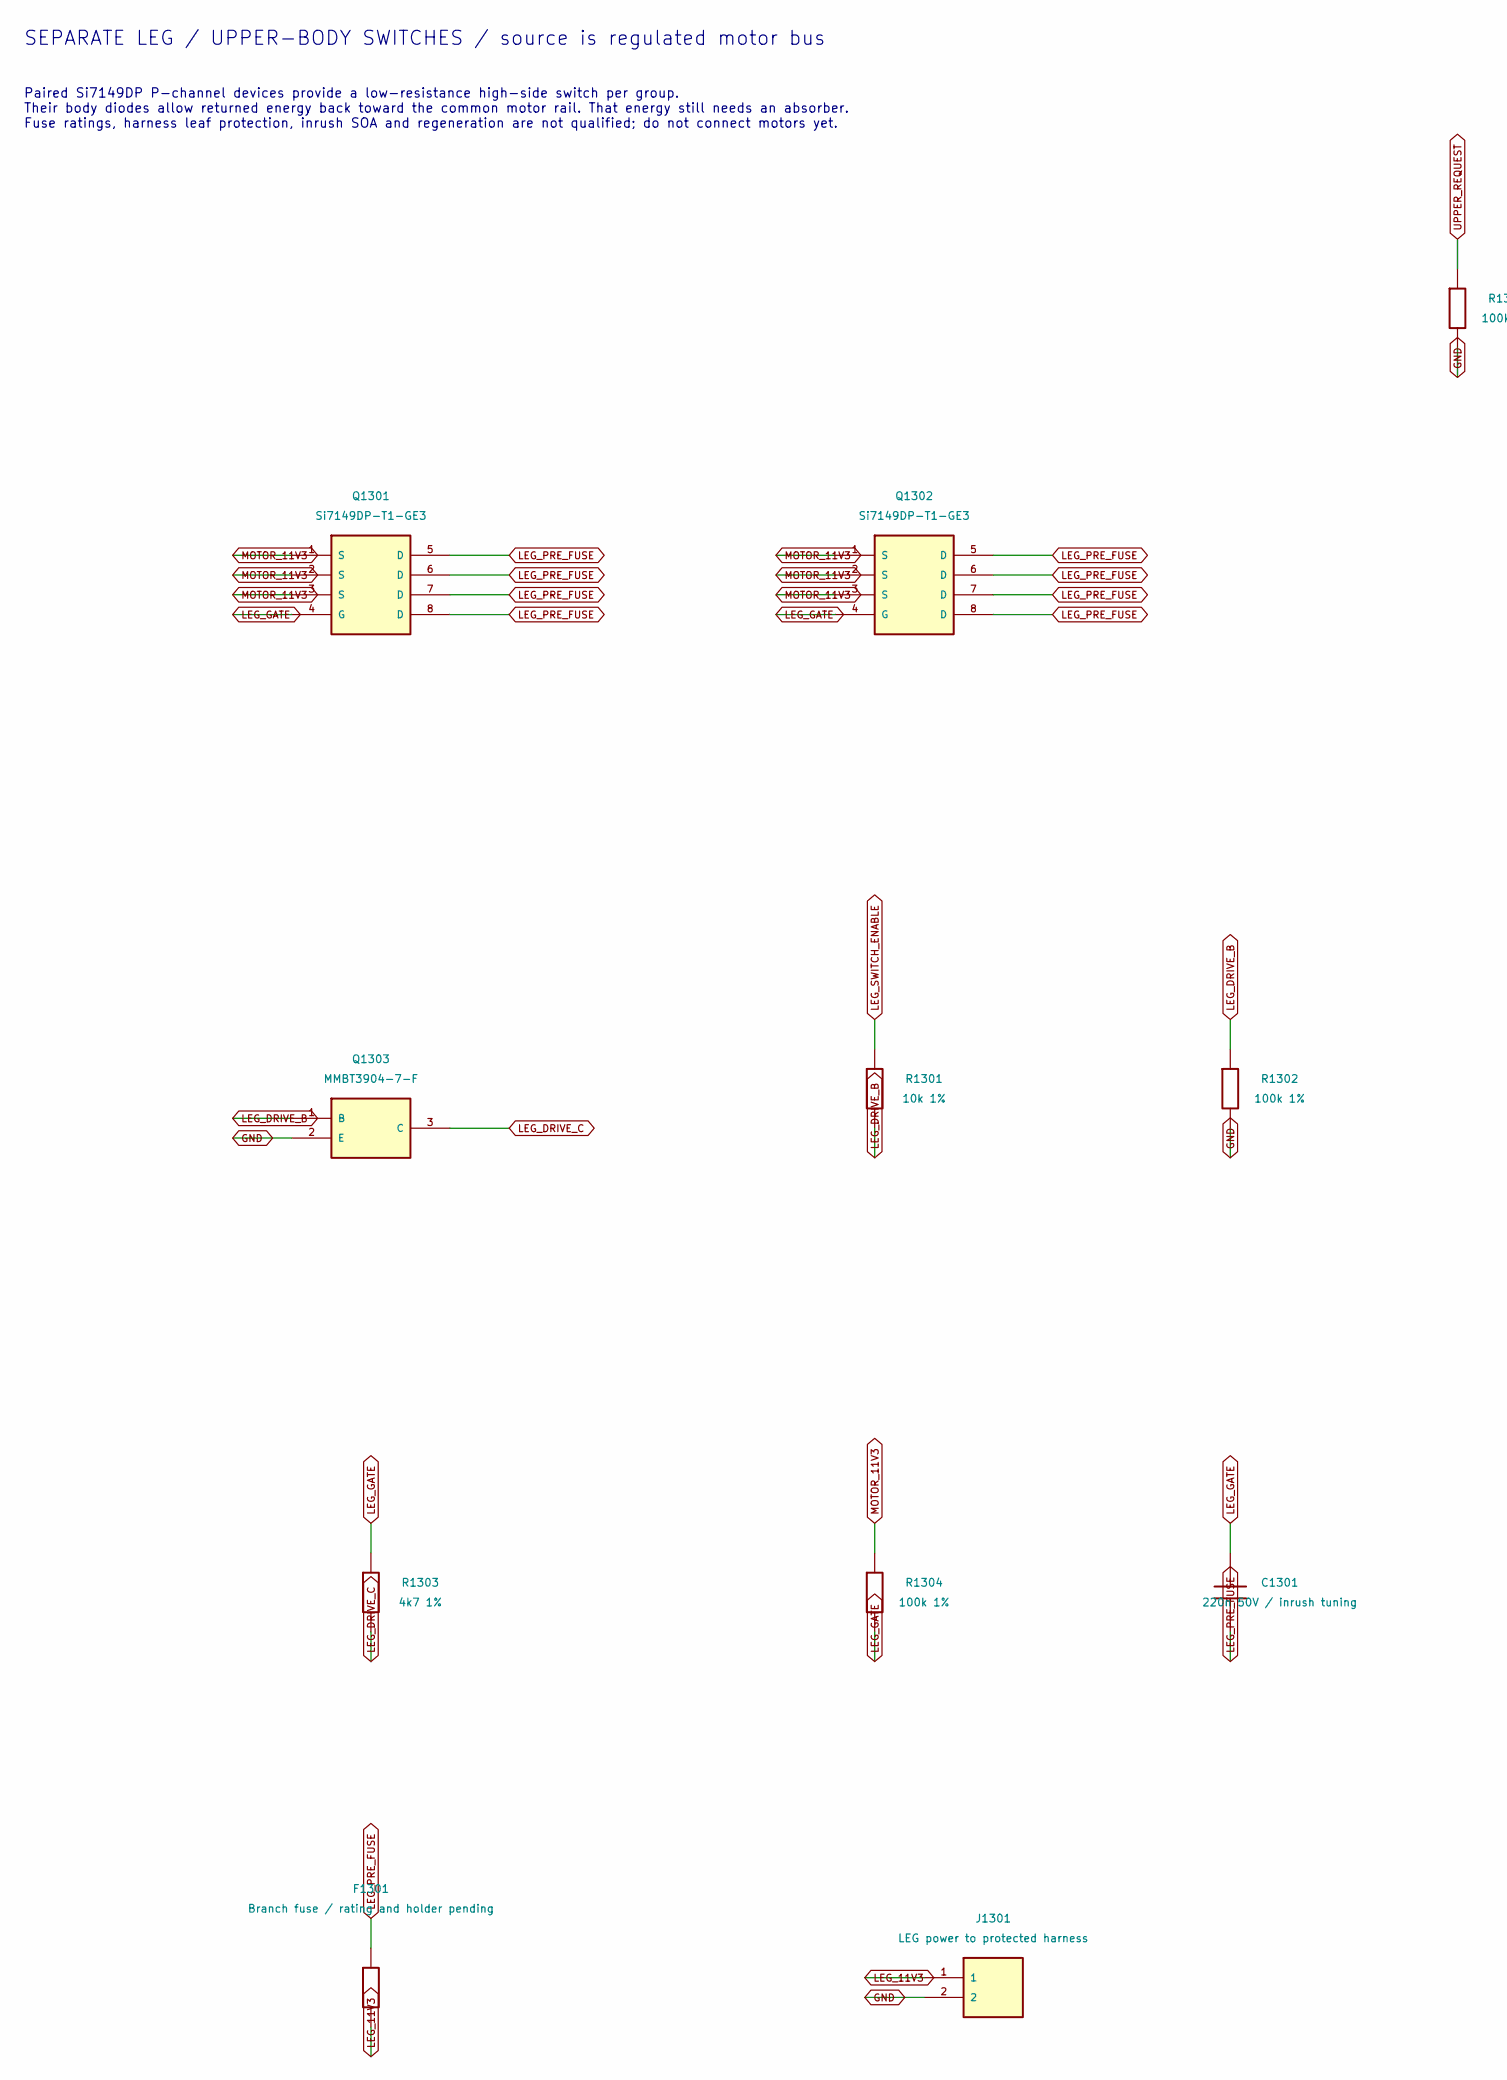
[picture p74: schematic 13-motor-branches.kicad_sch, part in row 1, column 1]

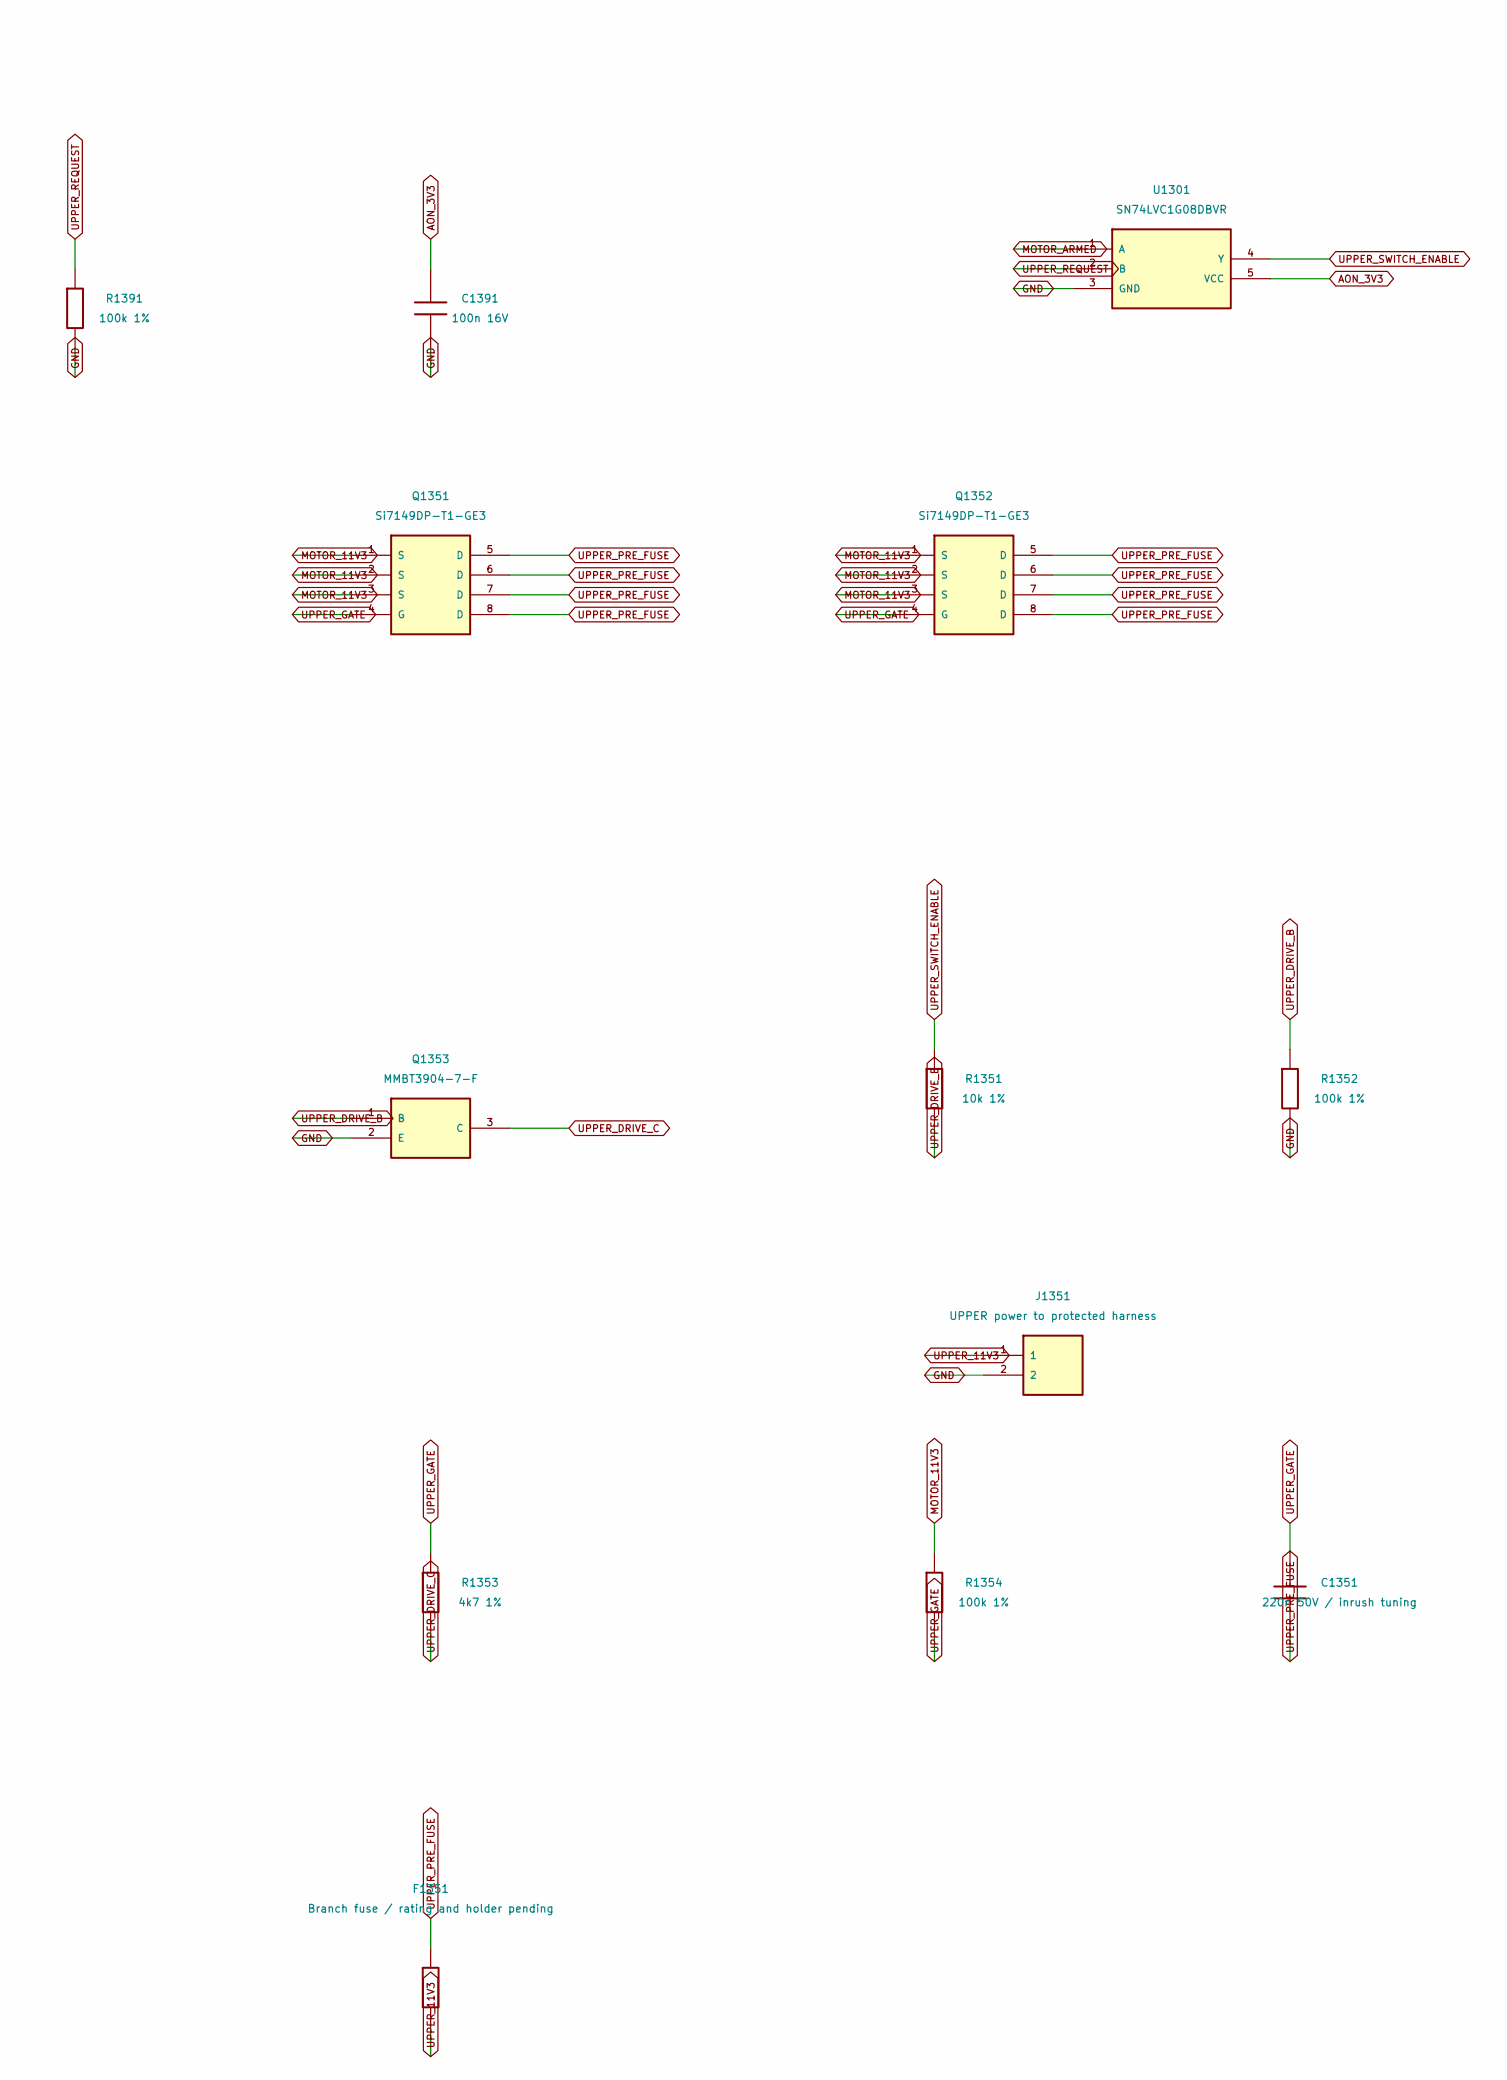
[picture p75: schematic 13-motor-branches.kicad_sch, part in row 1, column 2]

Parts:
C1301, C1351: 220n 50V / inrush tuning; C_0603_1608Metric
C1391: 100n 16V; C_0603_1608Metric
F1301, F1351: Branch fuse / rating and holder pending
J1301: LEG power to protected harness
J1351: UPPER power to protected harness
Q1301, Q1302, Q1351, Q1352: Si7149DP-T1-GE3; MPN SI7149DP-T1-GE3
Q1303, Q1353: MMBT3904-7-F; SOT-23; MPN MMBT3904-7-F
R1301, R1351: 10k 1%; R_0603_1608Metric
R1302, R1304, R1352, R1354, R1391: 100k 1%; R_0603_1608Metric
R1303, R1353: 4k7 1%; R_0603_1608Metric
U1301: SN74LVC1G08DBVR; SOT-23-5; MPN SN74LVC1G08DBVR

Connections:
AON_3V3: C1391.1, U1301.5 (VCC)
GND: C1391.2, J1301.2, J1351.2, Q1303.2 (E), Q1353.2 (E), R1302.2, R1352.2, R1391.2, U1301.3 (GND)
LEG_11V3: F1301.2, J1301.1
LEG_DRIVE_B: Q1303.1 (B), R1301.2, R1302.1
LEG_DRIVE_C: Q1303.3 (C), R1303.2
LEG_GATE: C1301.1, Q1301.4 (G), Q1302.4 (G), R1303.1, R1304.2
LEG_PRE_FUSE: C1301.2, F1301.1, Q1301.5 (D), Q1301.6 (D), Q1301.7 (D), Q1301.8 (D), Q1302.5 (D), Q1302.6 (D), Q1302.7 (D), Q1302.8 (D)
LEG_SWITCH_ENABLE: R1301.1
MOTOR_11V3: Q1301.1 (S), Q1301.2 (S), Q1301.3 (S), Q1302.1 (S), Q1302.2 (S), Q1302.3 (S), Q1351.1 (S), Q1351.2 (S), Q1351.3 (S), Q1352.1 (S), Q1352.2 (S), Q1352.3 (S), R1304.1, R1354.1
MOTOR_ARMED: U1301.1 (A)
UPPER_11V3: F1351.2, J1351.1
UPPER_DRIVE_B: Q1353.1 (B), R1351.2, R1352.1
UPPER_DRIVE_C: Q1353.3 (C), R1353.2
UPPER_GATE: C1351.1, Q1351.4 (G), Q1352.4 (G), R1353.1, R1354.2
UPPER_PRE_FUSE: C1351.2, F1351.1, Q1351.5 (D), Q1351.6 (D), Q1351.7 (D), Q1351.8 (D), Q1352.5 (D), Q1352.6 (D), Q1352.7 (D), Q1352.8 (D)
UPPER_REQUEST: R1391.1, U1301.2 (B)
UPPER_SWITCH_ENABLE: R1351.1, U1301.4 (Y)

Notes on the sheet:
SEPARATE LEG / UPPER-BODY SWITCHES / source is regulated motor bus
Paired Si7149DP P-channel devices provide a low-resistance high-side switch per group. Their body diodes allow returned energy back toward the common motor rail. That energy still needs an absorber. Fuse ratings, harness leaf protection, inrush SOA and regeneration are not qualified; do not connect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
