iimmyy/Little-Guy/hardware/little-guy-v2/pcb/power/14-hand-peripheral.kicad_sch

## KiCad design hardware/little-guy-v2/pcb/power/14-hand-peripheral.kicad_sch (2026-11-07)

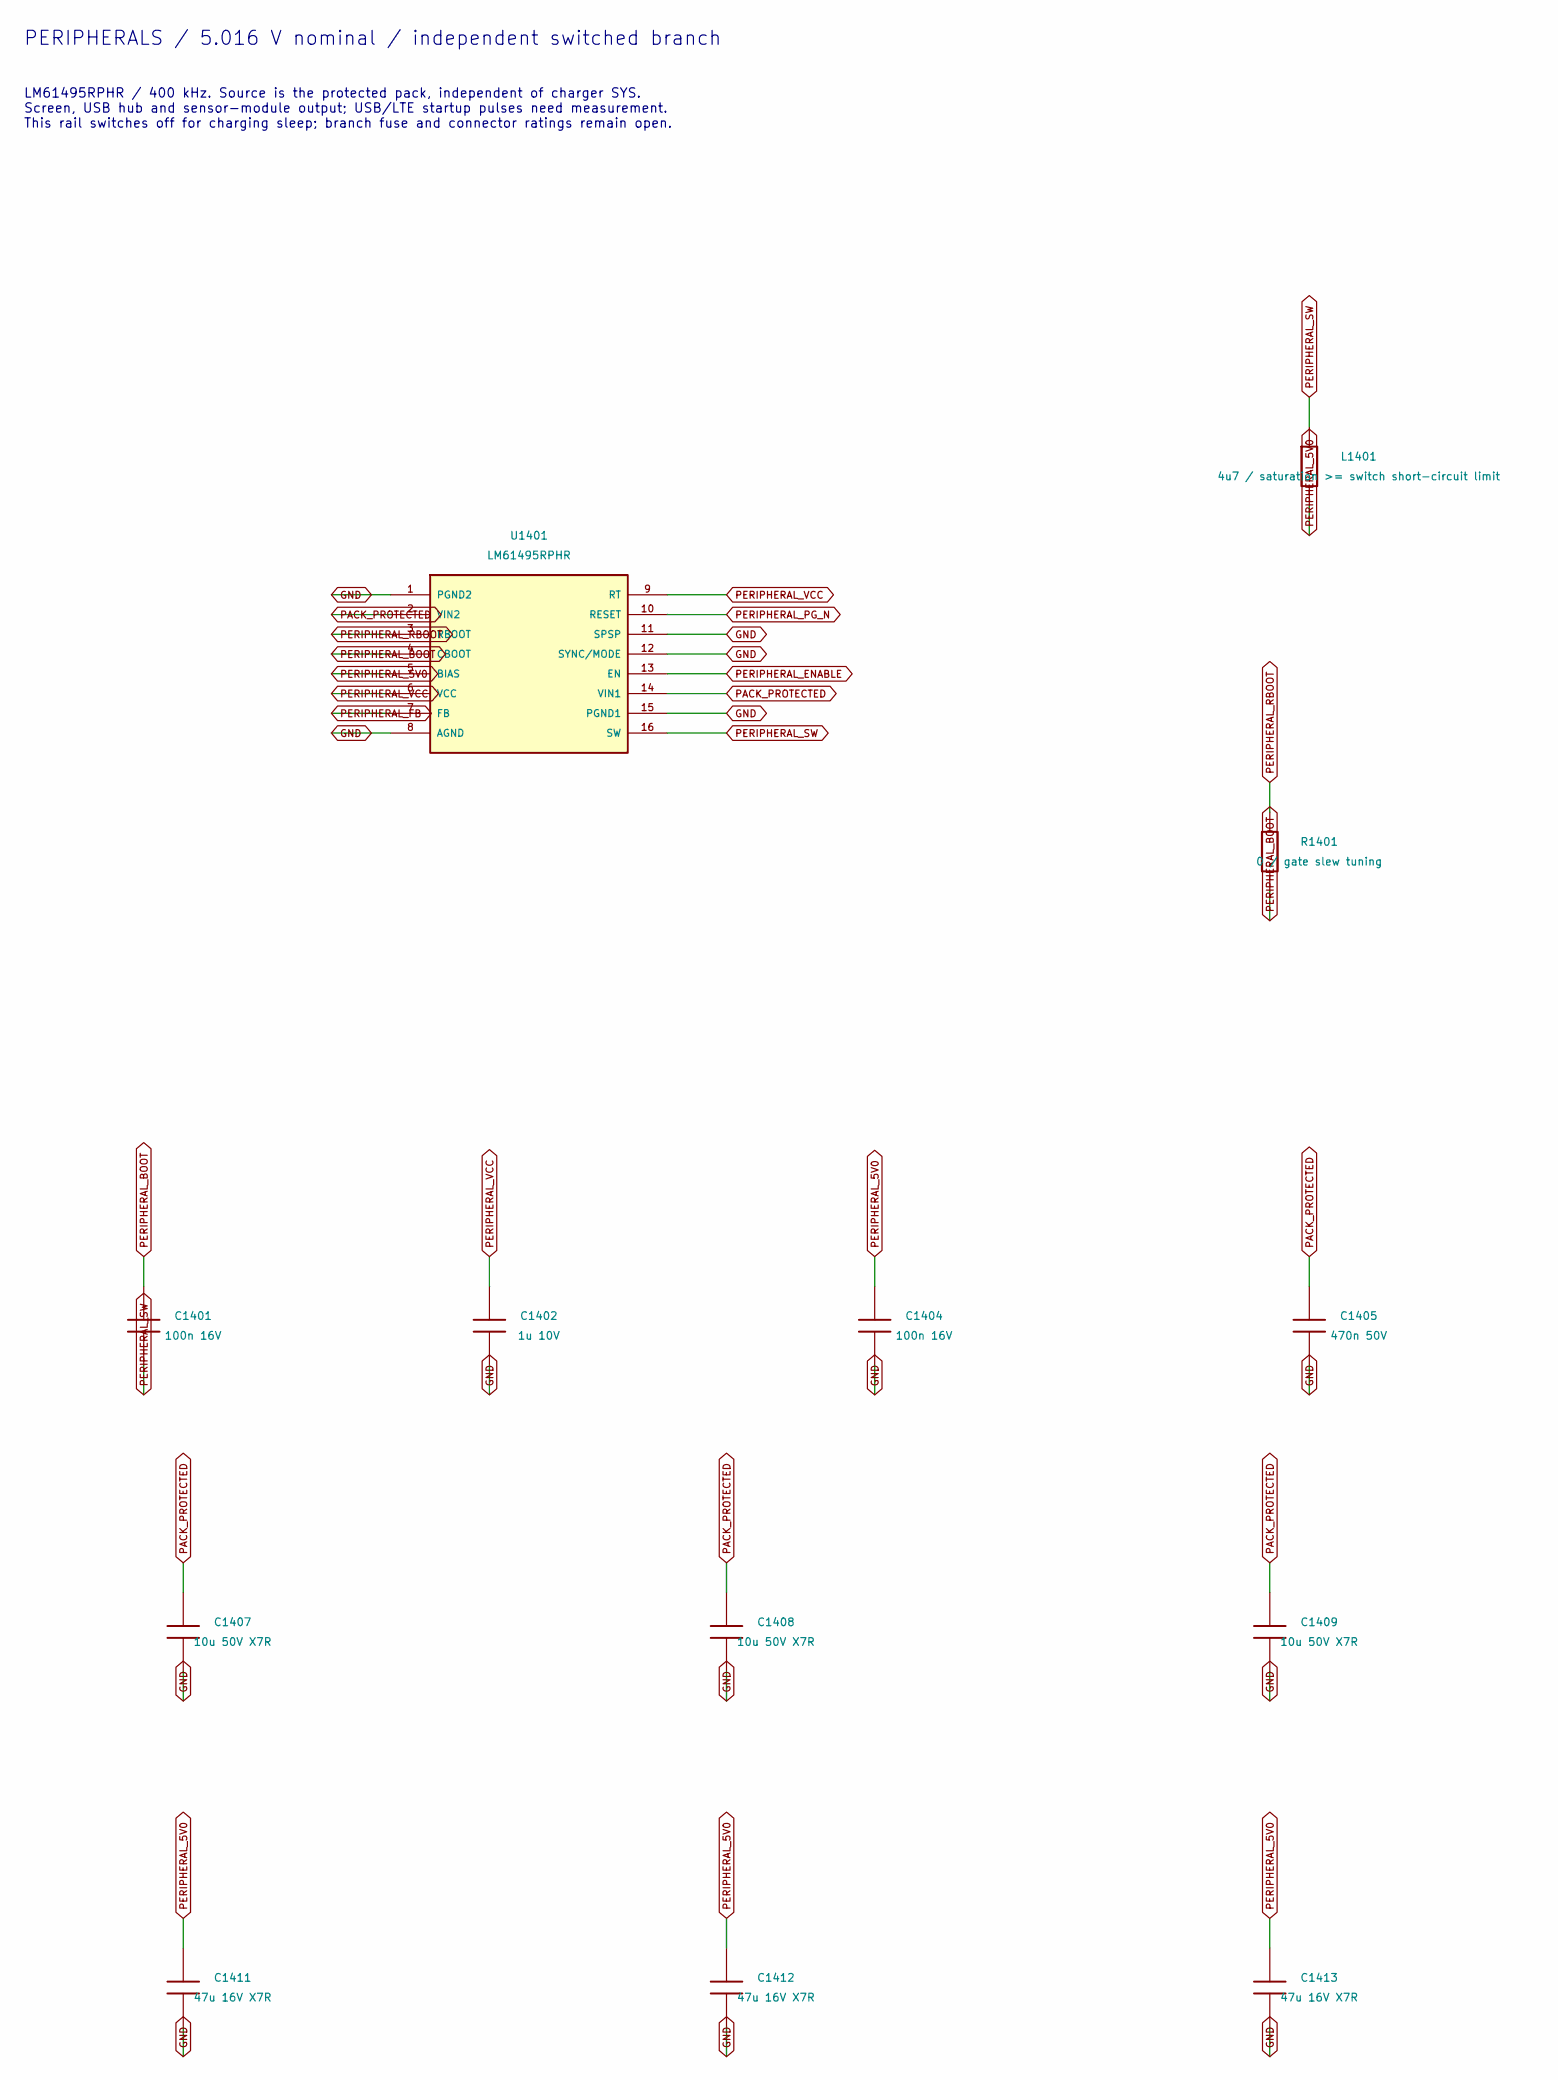
[picture p76: schematic 14-hand-peripheral.kicad_sch, part in row 1, column 1]

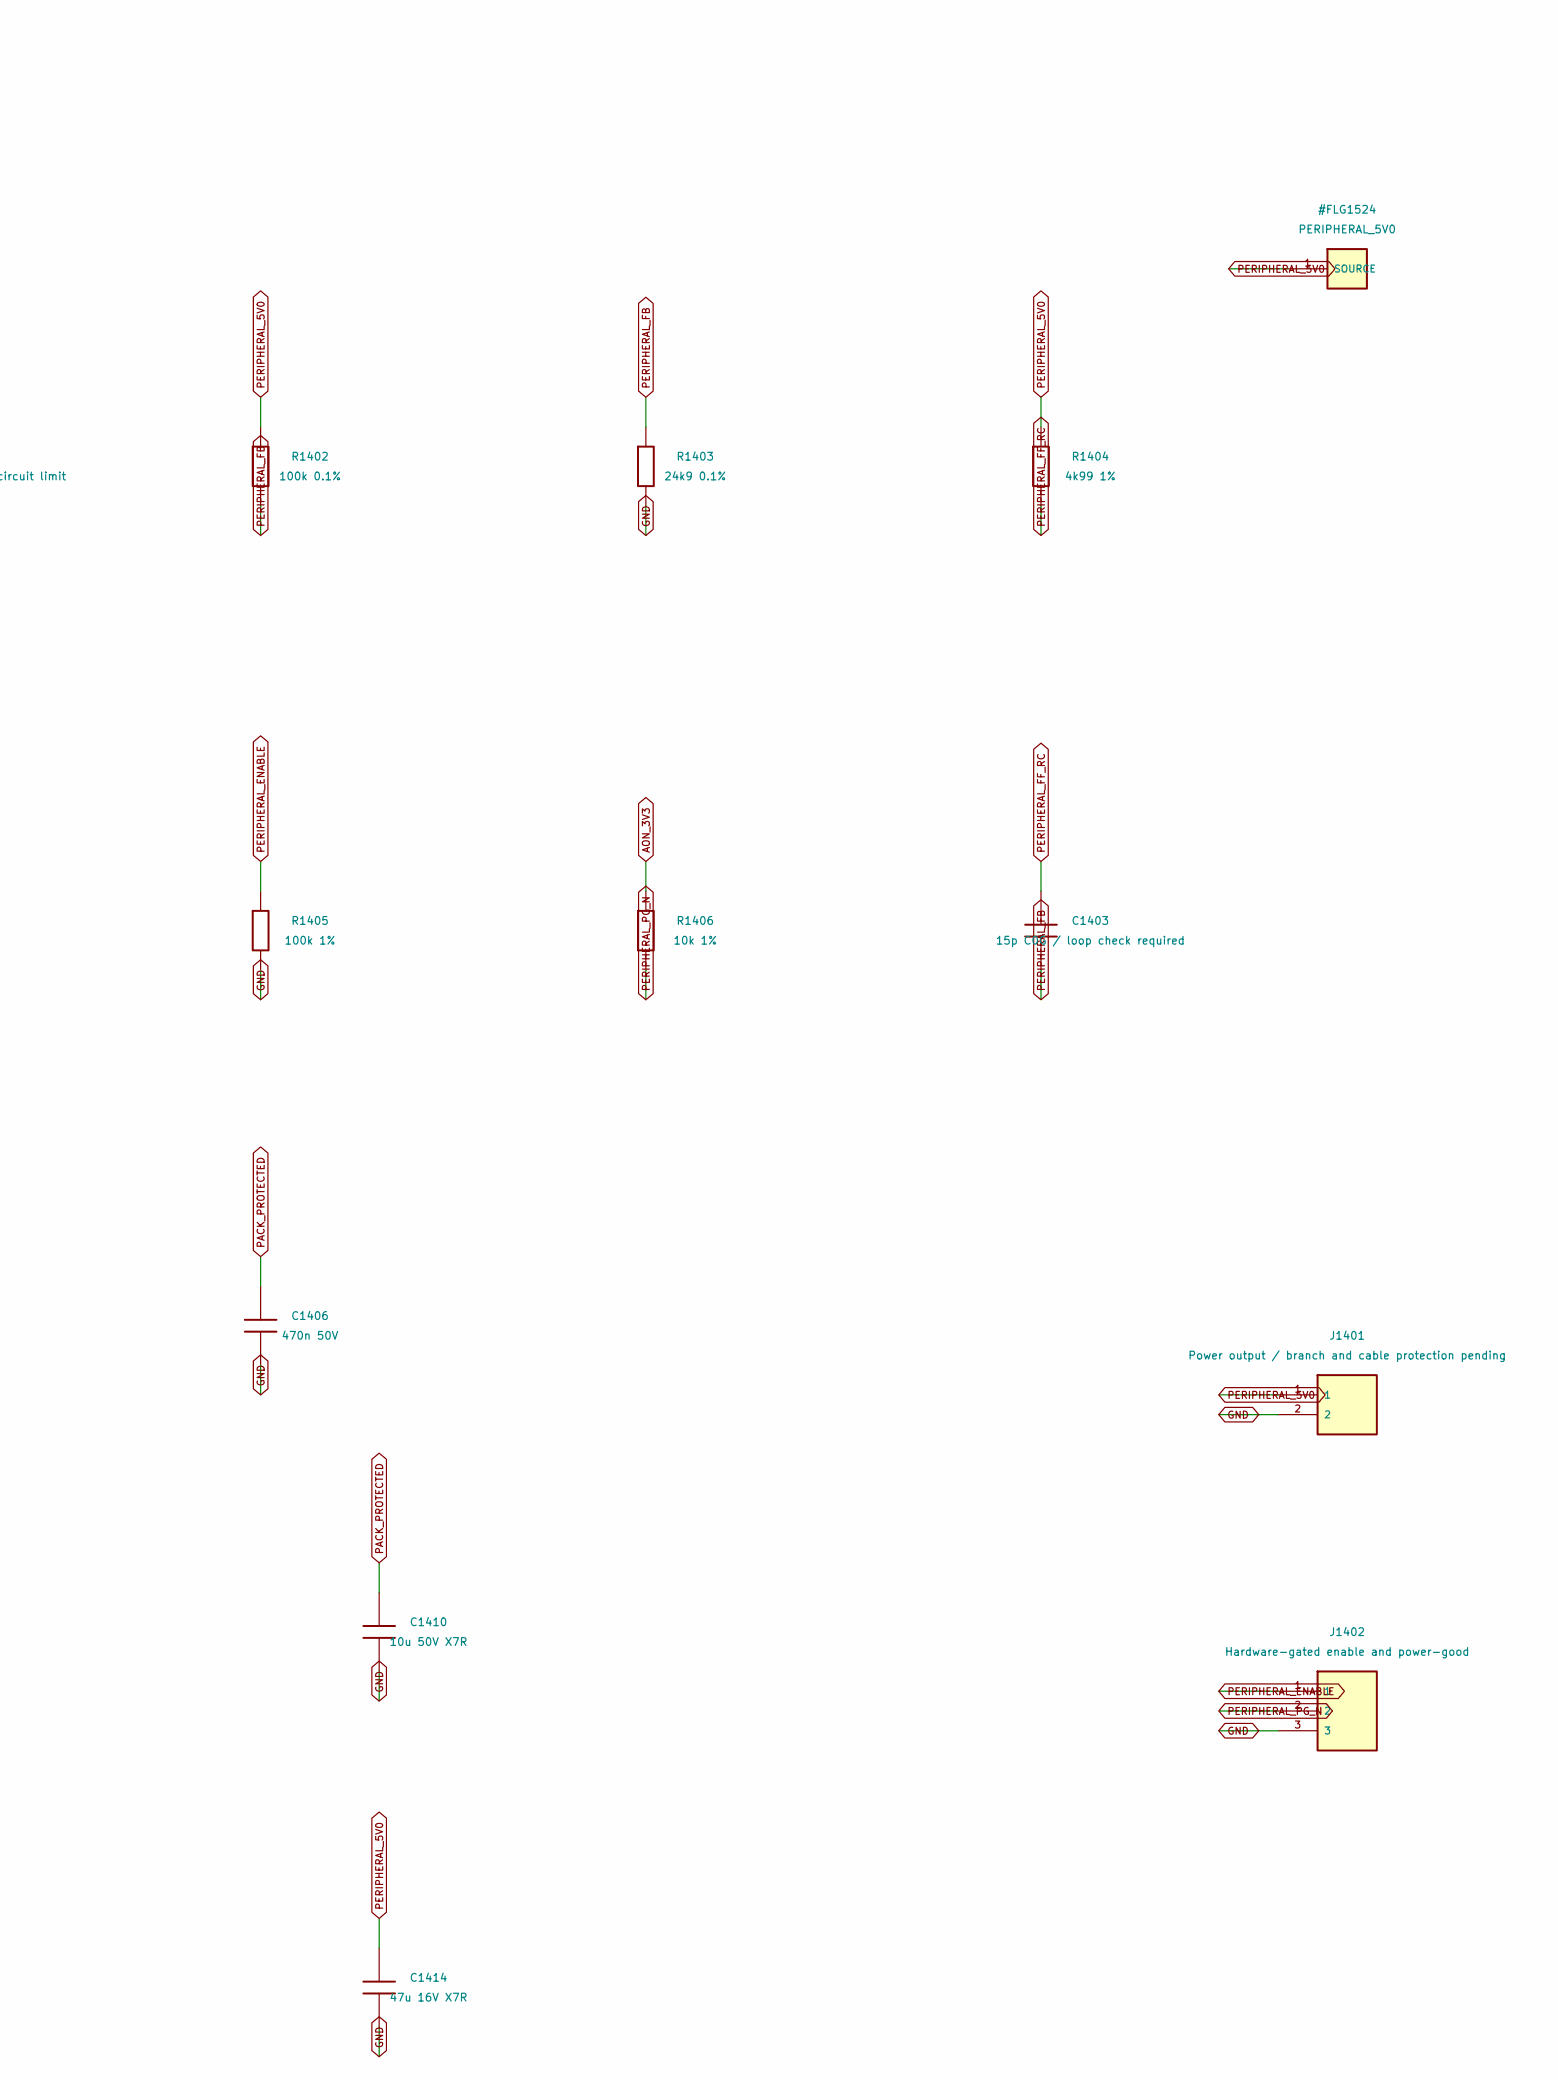
[picture p77: schematic 14-hand-peripheral.kicad_sch, part in row 1, column 2]

Parts:
C1401, C1404: 100n 16V; C_0603_1608Metric
C1402: 1u 10V; C_0603_1608Metric
C1403: 15p C0G / loop check required; C_0603_1608Metric
C1405, C1406: 470n 50V; C_0603_1608Metric
C1407, C1408, C1409, C1410: 10u 50V X7R; C_1206_3216Metric
C1411, C1412, C1413, C1414: 47u 16V X7R; C_1206_3216Metric
J1401: Power output / branch and cable protection pending
J1402: Hardware-gated enable and power-good
L1401: 4u7 / saturation >= switch short-circuit limit
R1401: 0 / gate slew tuning; R_0603_1608Metric
R1402: 100k 0.1%; R_0603_1608Metric
R1403: 24k9 0.1%; R_0603_1608Metric
R1404: 4k99 1%; R_0603_1608Metric
R1405: 100k 1%; R_0603_1608Metric
R1406: 10k 1%; R_0603_1608Metric
U1401: LM61495RPHR; MPN LM61495RPHR

Connections:
AON_3V3: R1406.1
GND: C1402.2, C1404.2, C1405.2, C1406.2, C1407.2, C1408.2, C1409.2, C1410.2, C1411.2, C1412.2, C1413.2, C1414.2, J1401.2, J1402.3, R1403.2, R1405.2, U1401.1 (PGND2), U1401.8 (AGND), U1401.11 (SPSP), U1401.12 (SYNC/MODE), U1401.15 (PGND1)
PACK_PROTECTED: C1405.1, C1406.1, C1407.1, C1408.1, C1409.1, C1410.1, U1401.2 (VIN2), U1401.14 (VIN1)
PERIPHERAL_5V0: C1404.1, C1411.1, C1412.1, C1413.1, C1414.1, J1401.1, L1401.2, R1402.1, R1404.1, U1401.5 (BIAS)
PERIPHERAL_BOOT: C1401.1, R1401.2, U1401.4 (CBOOT)
PERIPHERAL_ENABLE: J1402.1, R1405.1, U1401.13 (EN)
PERIPHERAL_FB: C1403.2, R1402.2, R1403.1, U1401.7 (FB)
PERIPHERAL_FF_RC: C1403.1, R1404.2
PERIPHERAL_PG_N: J1402.2, R1406.2, U1401.10 (RESET)
PERIPHERAL_RBOOT: R1401.1, U1401.3 (RBOOT)
PERIPHERAL_SW: C1401.2, L1401.1, U1401.16 (SW)
PERIPHERAL_VCC: C1402.1, U1401.6 (VCC), U1401.9 (RT)

Notes on the sheet:
PERIPHERALS / 5.016 V nominal / independent switched branch
LM61495RPHR / 400 kHz. Source is the protected pack, independent of charger SYS. Screen, USB hub and sensor-module output; USB/LTE startup pulses need measurement. This rail switches off for charging sleep; branch fuse and connector ratings remain open.
