iimmyy/Little-Guy/hardware/little-guy-v2/pcb/spinal/01-controller.kicad_sch

## KiCad design hardware/little-guy-v2/pcb/spinal/01-controller.kicad_sch (2026-11-07)

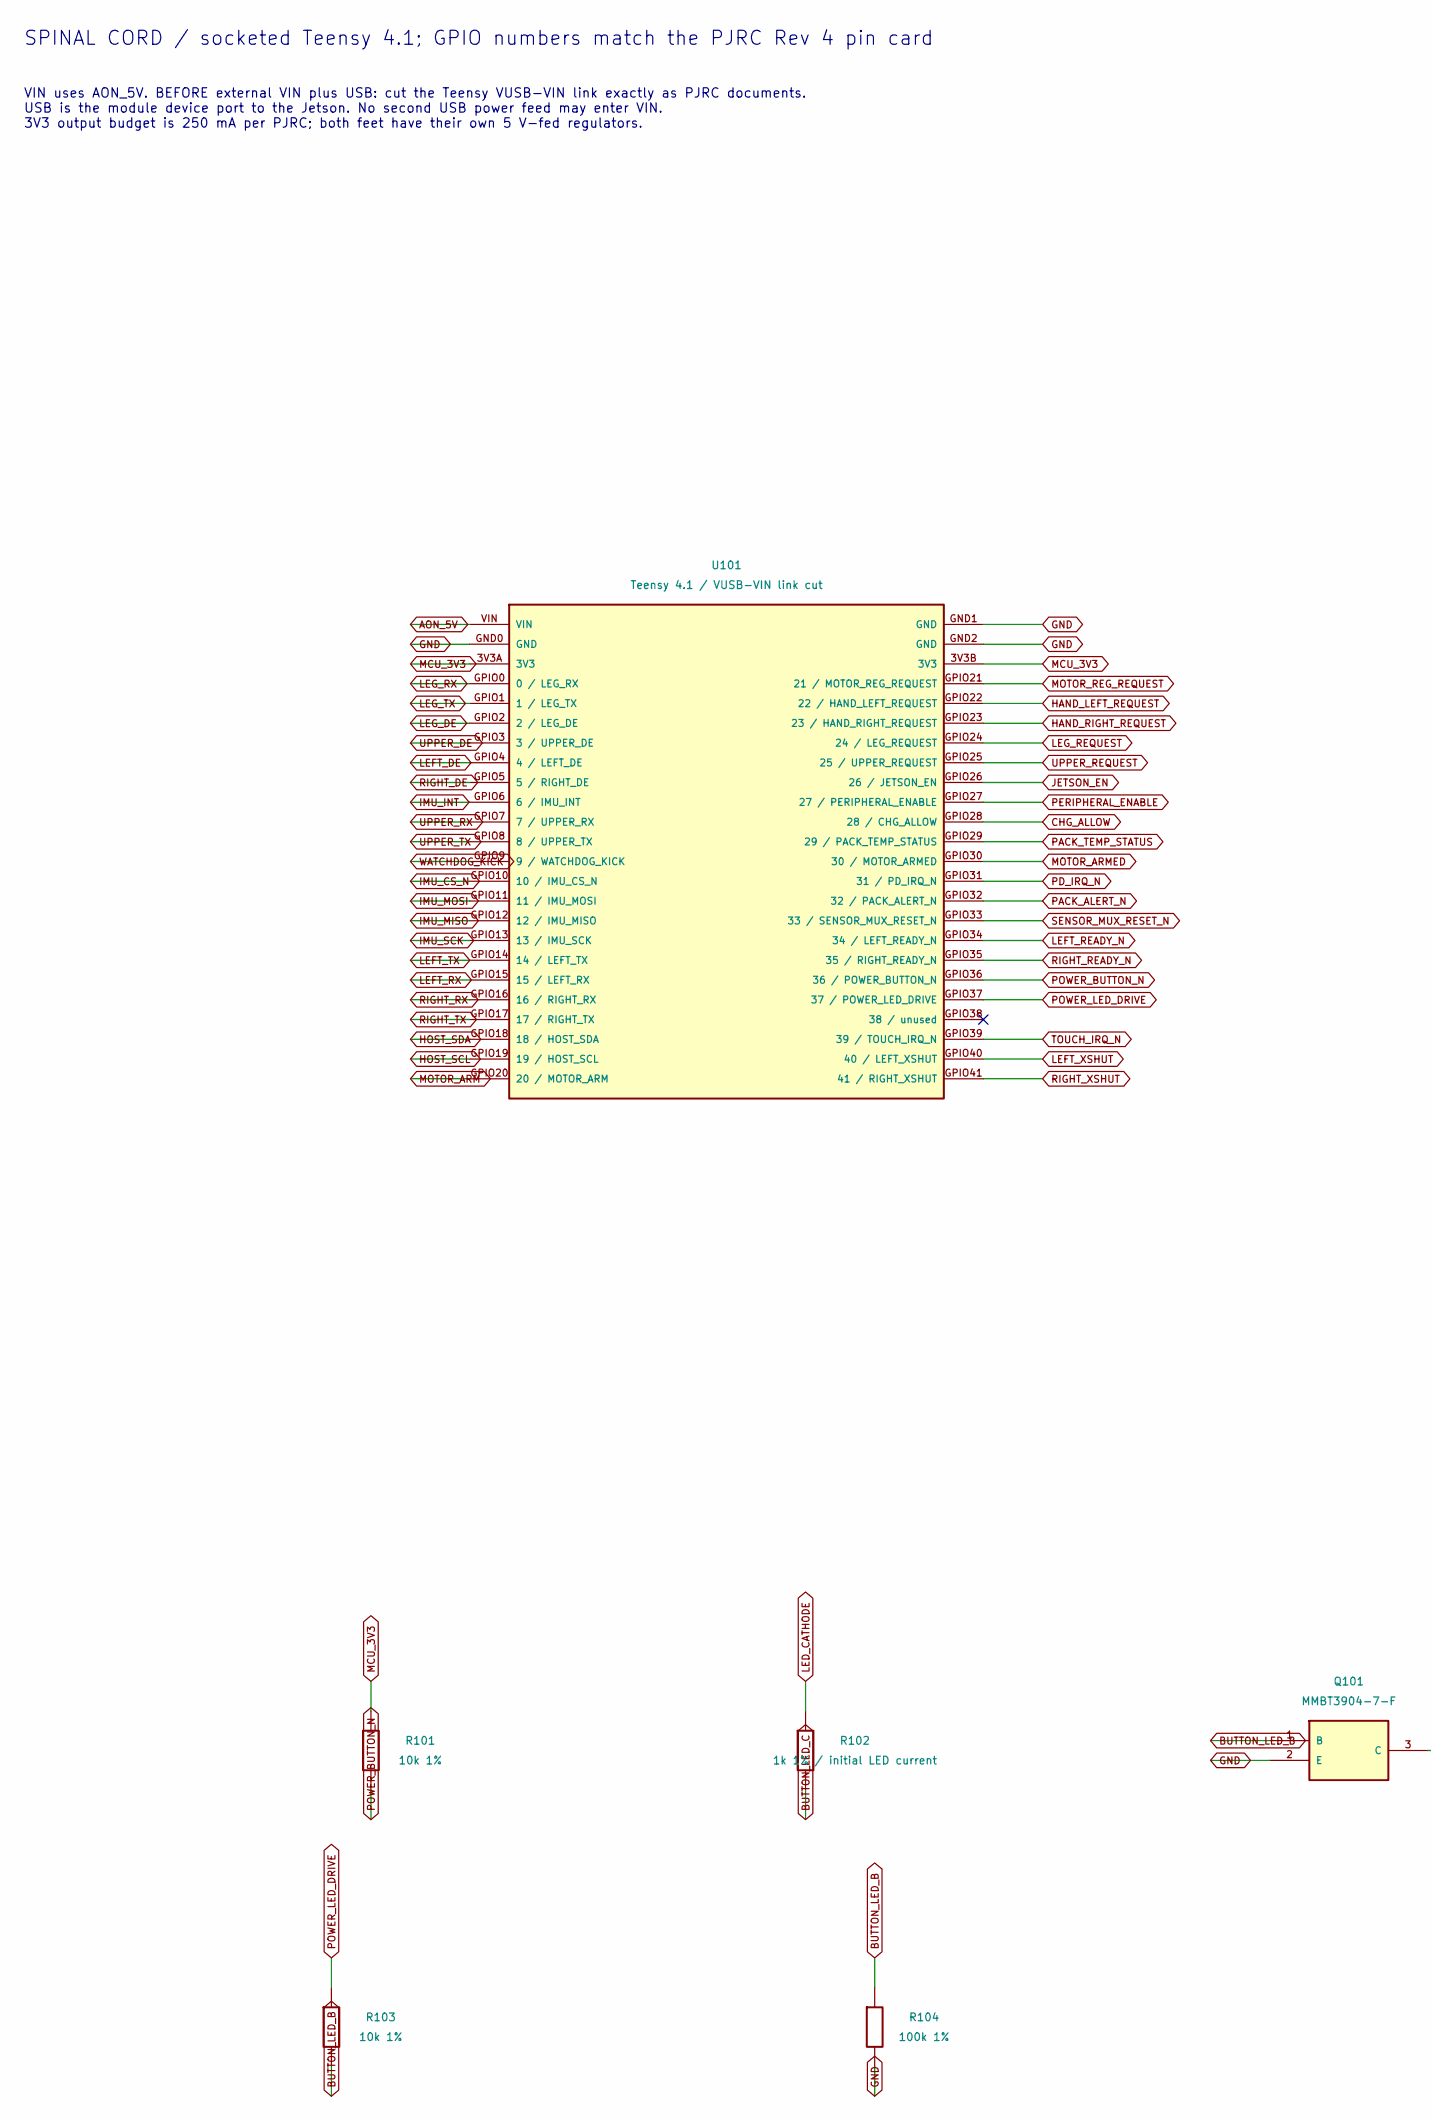
[picture p78: schematic 01-controller.kicad_sch, part in row 1, column 1]

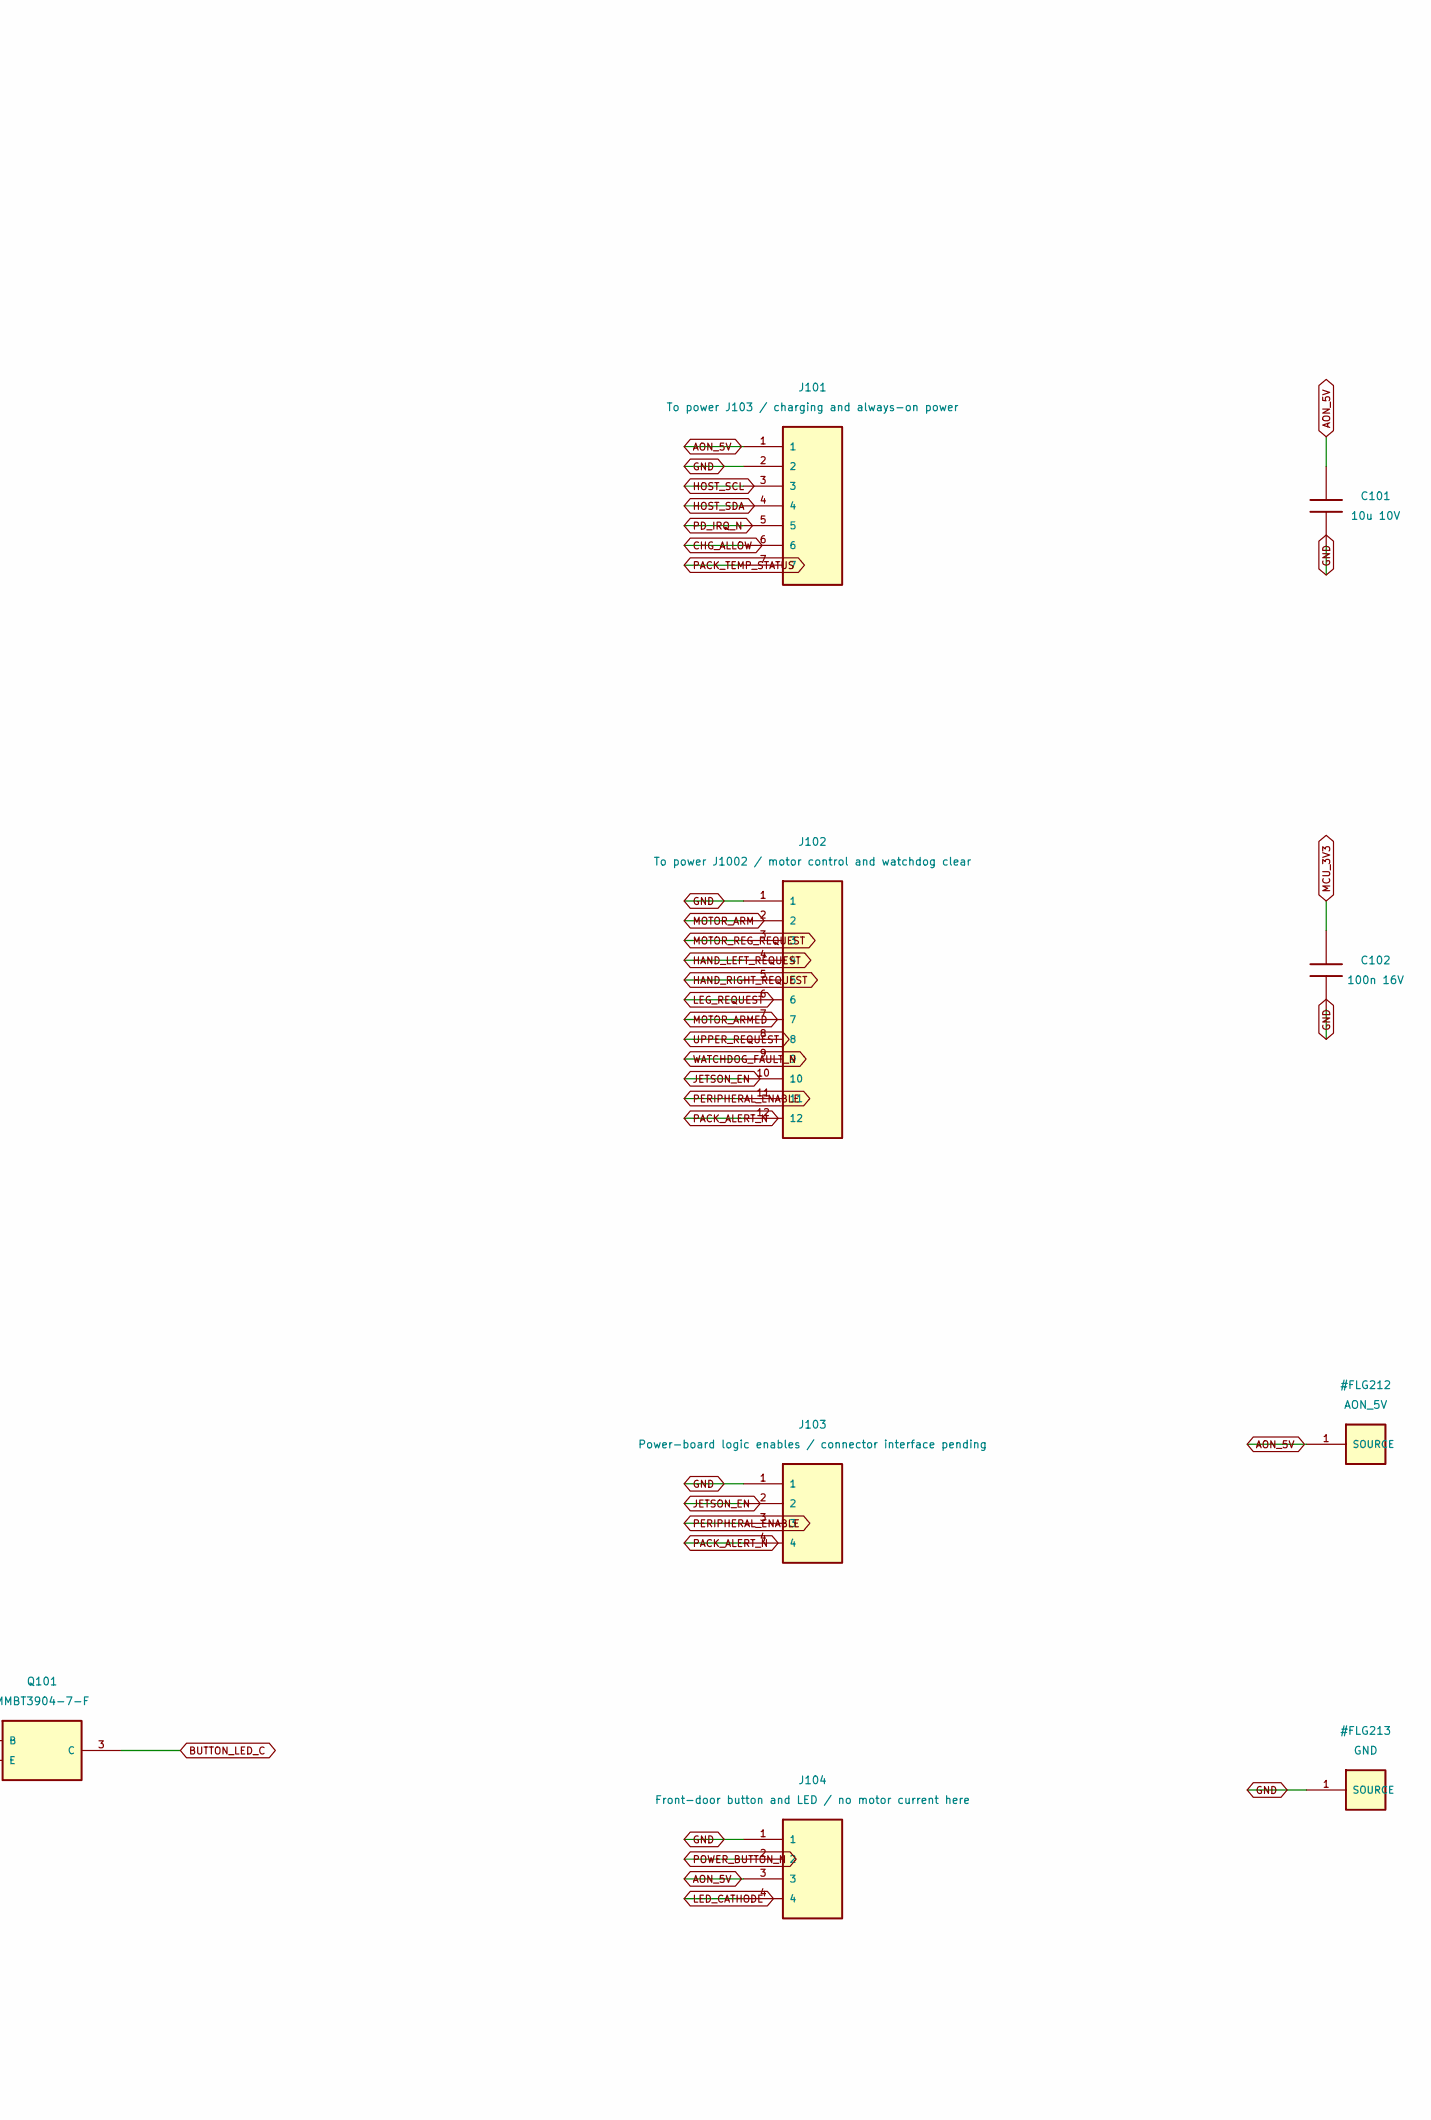
[picture p79: schematic 01-controller.kicad_sch, part in row 1, column 2]

Parts:
C101: 10u 10V; C_0603_1608Metric
C102: 100n 16V; C_0603_1608Metric
J101: To power J103 / charging and always-on power
J102: To power J1002 / motor control and watchdog clear
J103: Power-board logic enables / connector interface p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
J104: Front-door button and LED / no motor current here
Q101: MMBT3904-7-F; SOT-23; MPN MMBT3904-7-F
R101, R103: 10k 1%; R_0603_1608Metric
R102: 1k 1% / initial LED current; R_0603_1608Metric
R104: 100k 1%; R_0603_1608Metric
U101: Teensy 4.1 / VUSB-VIN link cut; Teensy41_Socket_GPIO_ID; MPN TEENSY41

Connections:
AON_5V: C101.1, J101.1, J104.3, U101.VIN
BUTTON_LED_B: Q101.1 (B), R103.2, R104.1
BUTTON_LED_C: Q101.3 (C), R102.2
CHG_ALLOW: J101.6, U101.GPIO28 (28 / CHG_ALLOW)
GND: C101.2, C102.2, J101.2, J102.1, J103.1, J104.1, Q101.2 (E), R104.2, U101.GND0 (GND), U101.GND1 (GND), U101.GND2 (GND)
HAND_LEFT_REQUEST: J102.4, U101.GPIO22 (22 / HAND_LEFT_REQUEST)
HAND_RIGHT_REQUEST: J102.5, U101.GPIO23 (23 / HAND_RIGHT_REQUEST)
HOST_SCL: J101.3, U101.GPIO19 (19 / HOST_SCL)
HOST_SDA: J101.4, U101.GPIO18 (18 / HOST_SDA)
IMU_CS_N: U101.GPIO10 (10 / IMU_CS_N)
IMU_INT: U101.GPIO6 (6 / IMU_INT)
IMU_MISO: U101.GPIO12 (12 / IMU_MISO)
IMU_MOSI: U101.GPIO11 (11 / IMU_MOSI)
IMU_SCK: U101.GPIO13 (13 / IMU_SCK)
JETSON_EN: J102.10, J103.2, U101.GPIO26 (26 / JETSON_EN)
LED_CATHODE: J104.4, R102.1
LEFT_DE: U101.GPIO4 (4 / LEFT_DE)
LEFT_READY_N: U101.GPIO34 (34 / LEFT_READY_N)
LEFT_RX: U101.GPIO15 (15 / LEFT_RX)
LEFT_TX: U101.GPIO14 (14 / LEFT_TX)
LEFT_XSHUT: U101.GPIO40 (40 / LEFT_XSHUT)
LEG_DE: U101.GPIO2 (2 / LEG_DE)
LEG_REQUEST: J102.6, U101.GPIO24 (24 / LEG_REQUEST)
LEG_RX: U101.GPIO0 (0 / LEG_RX)
LEG_TX: U101.GPIO1 (1 / LEG_TX)
MCU_3V3: C102.1, R101.1, U101.3V3A (3V3), U101.3V3B (3V3)
MOTOR_ARM: J102.2, U101.GPIO20 (20 / MOTOR_ARM)
MOTOR_ARMED: J102.7, U101.GPIO30 (30 / MOTOR_ARMED)
MOTOR_REG_REQUEST: J102.3, U101.GPIO21 (21 / MOTOR_REG_REQUEST)
PACK_ALERT_N: J102.12, J103.4, U101.GPIO32 (32 / PACK_ALERT_N)
PACK_TEMP_STATUS: J101.7, U101.GPIO29 (29 / PACK_TEMP_STATUS)
PD_IRQ_N: J101.5, U101.GPIO31 (31 / PD_IRQ_N)
PERIPHERAL_ENABLE: J102.11, J103.3, U101.GPIO27 (27 / PERIPHERAL_ENABLE)
POWER_BUTTON_N: J104.2, R101.2, U101.GPIO36 (36 / POWER_BUTTON_N)
POWER_LED_DRIVE: R103.1, U101.GPIO37 (37 / POWER_LED_DRIVE)
RIGHT_DE: U101.GPIO5 (5 / RIGHT_DE)
RIGHT_READY_N: U101.GPIO35 (35 / RIGHT_READY_N)
RIGHT_RX: U101.GPIO16 (16 / RIGHT_RX)
RIGHT_TX: U101.GPIO17 (17 / RIGHT_TX)
RIGHT_XSHUT: U101.GPIO41 (41 / RIGHT_XSHUT)
SENSOR_MUX_RESET_N: U101.GPIO33 (33 / SENSOR_MUX_RESET_N)
TOUCH_IRQ_N: U101.GPIO39 (39 / TOUCH_IRQ_N)
UPPER_DE: U101.GPIO3 (3 / UPPER_DE)
UPPER_REQUEST: J102.8, U101.GPIO25 (25 / UPPER_REQUEST)
UPPER_RX: U101.GPIO7 (7 / UPPER_RX)
UPPER_TX: U101.GPIO8 (8 / UPPER_TX)
WATCHDOG_FAULT_N: J102.9
WATCHDOG_KICK: U101.GPIO9 (9 / WATCHDOG_KICK)

Notes on the sheet:
SPINAL CORD / socketed Teensy 4.1; GPIO numbers match the PJRC Rev 4 pin card
VIN uses AON_5V. BEFORE external VIN plus USB: cut the Teensy VUSB-VIN link exactly as PJRC documents. USB is the module device port to the Jetson. No second USB power feed may enter VIN. 3V3 output budget is 250 mA per PJRC; both feet have their own 5 V-fed regulators.
