iimmyy/Little-Guy/hardware/little-guy-v2/pcb/spinal/02-servo-buses-1.kicad_sch

## KiCad design hardware/little-guy-v2/pcb/spinal/02-servo-buses-1.kicad_sch (2026-11-07)

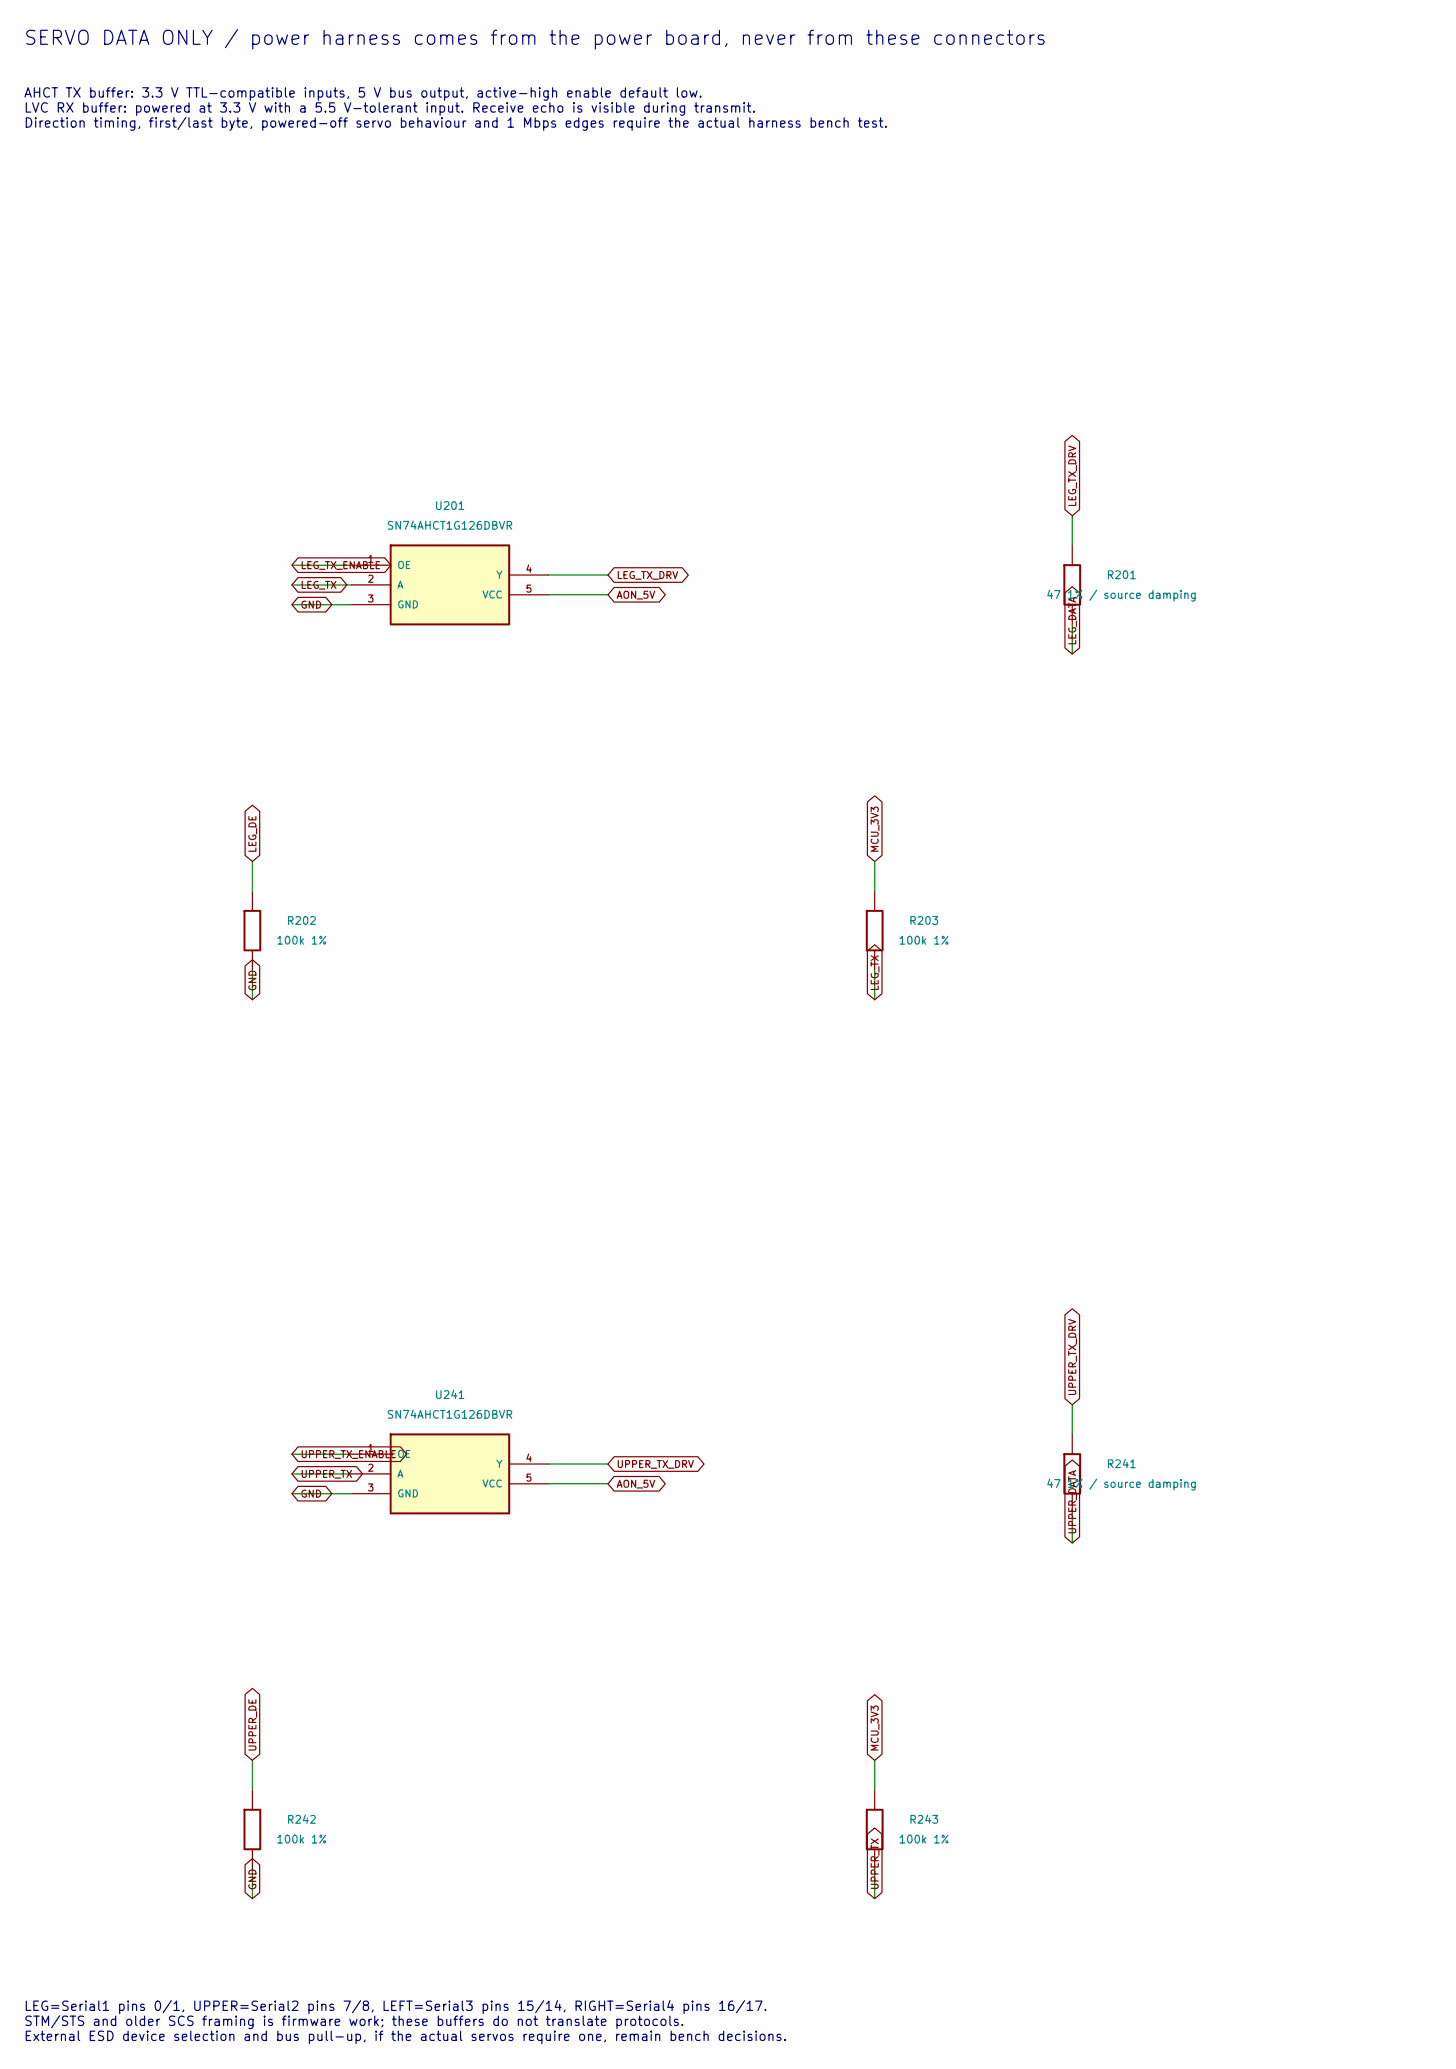
[picture p80: schematic 02-servo-buses-1.kicad_sch, part in row 1, column 1]

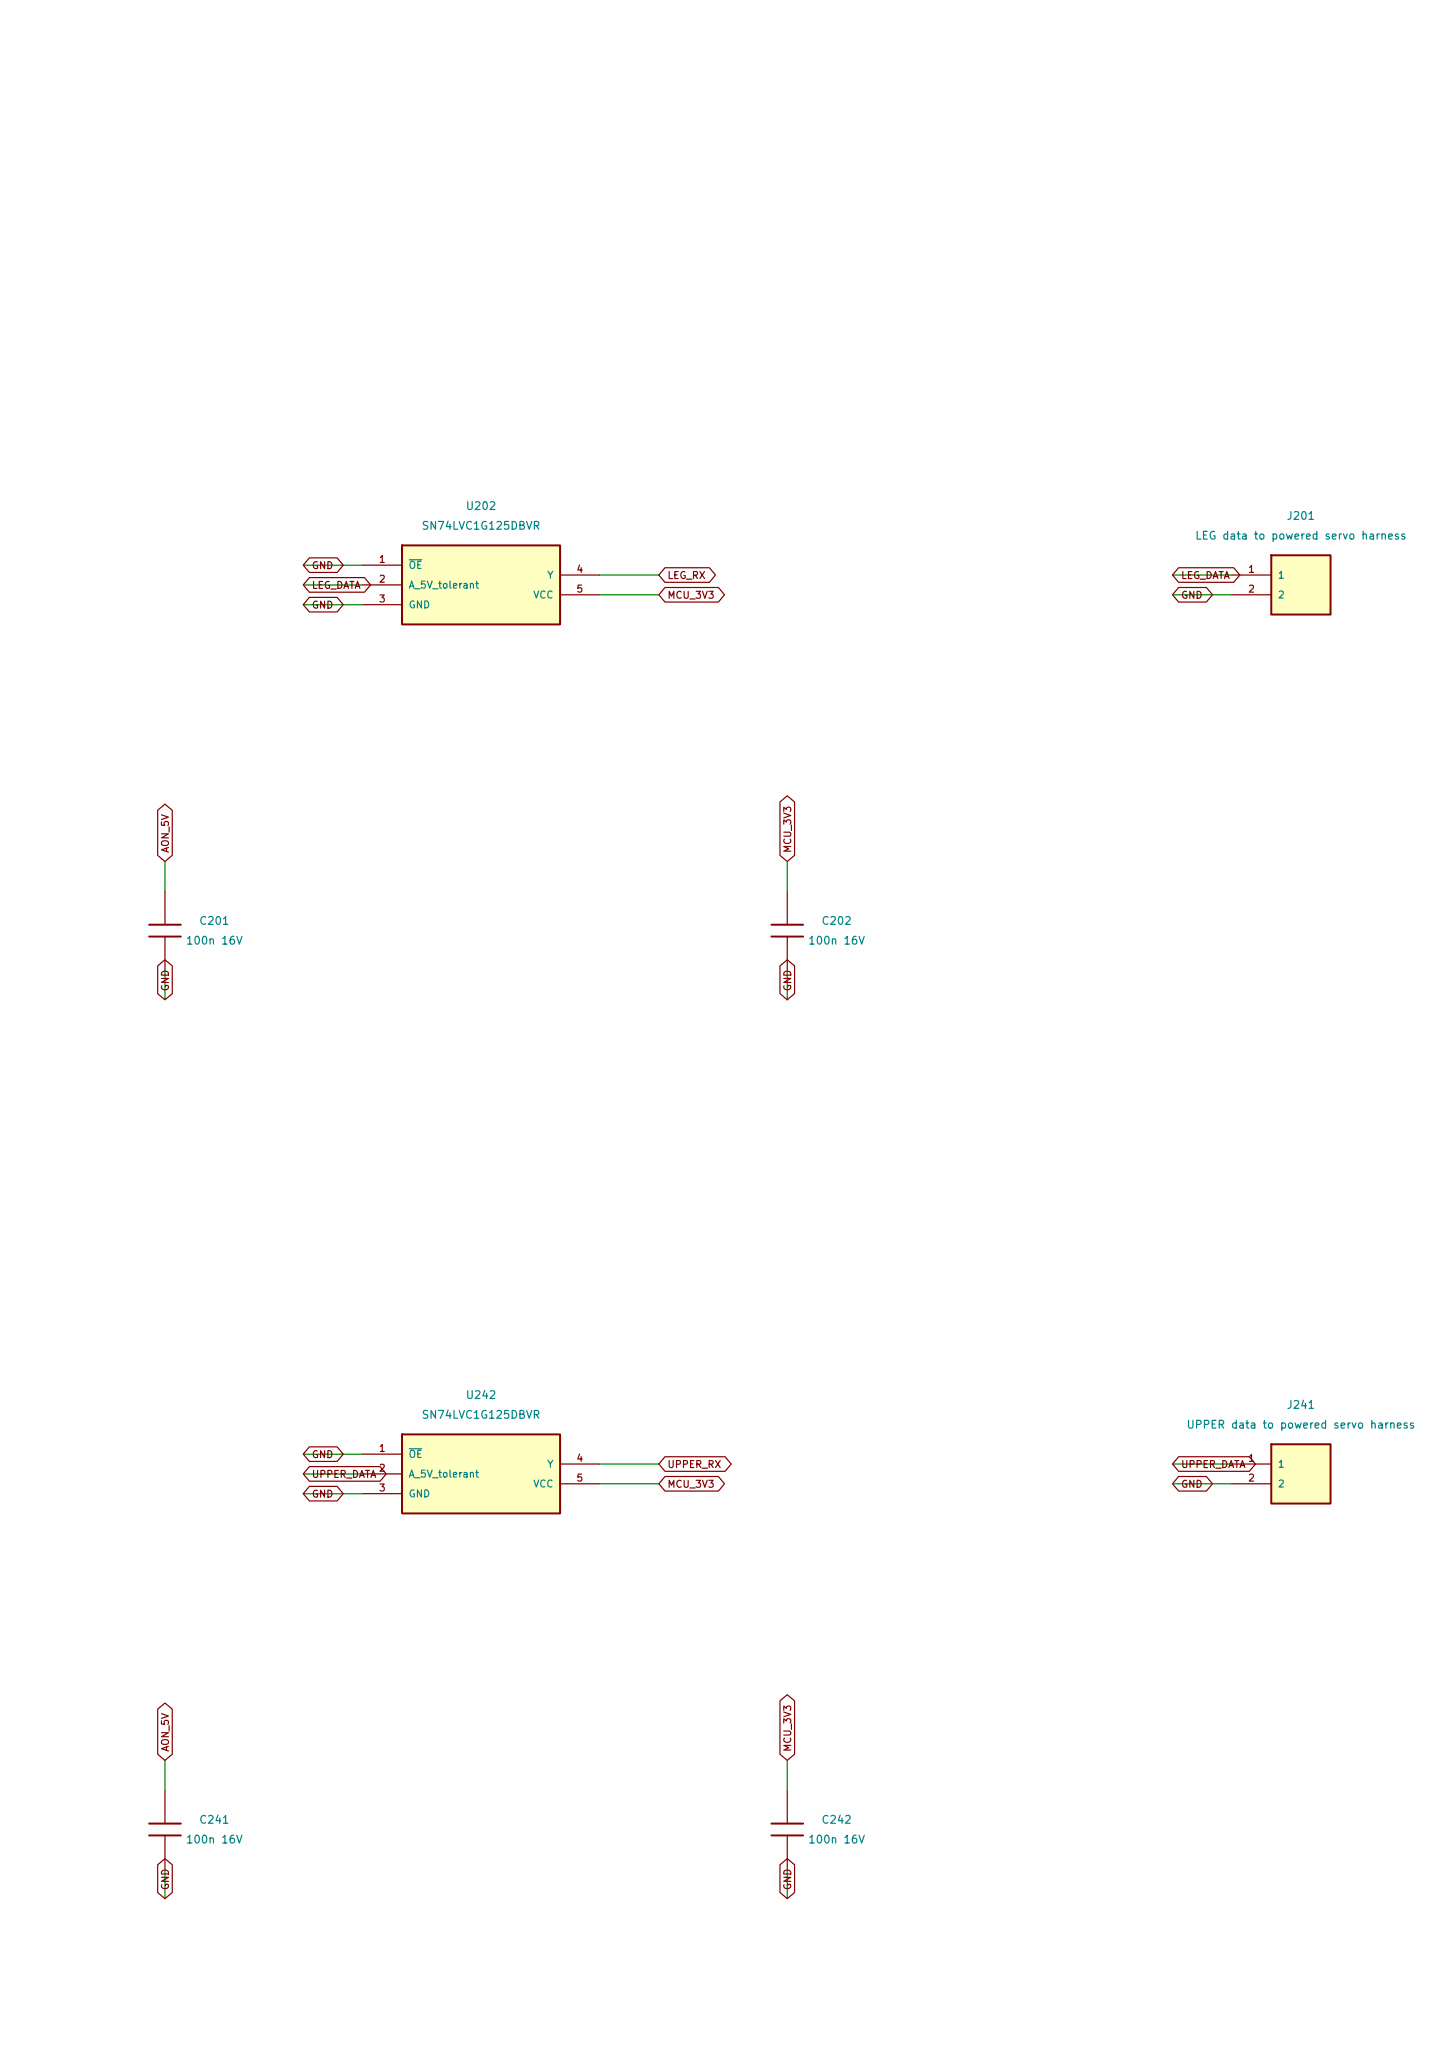
[picture p81: schematic 02-servo-buses-1.kicad_sch, part in row 1, column 2]

Parts:
C201, C202, C241, C242: 100n 16V; C_0603_1608Metric
J201: LEG data to powered servo harness
J241: UPPER data to powered servo harness
R201, R241: 47 1% / source damping; R_0603_1608Metric
R202, R203, R242, R243: 100k 1%; R_0603_1608Metric
U201, U241: SN74AHCT1G126DBVR; SOT-23-5; MPN SN74AHCT1G126DBVR
U202, U242: SN74LVC1G125DBVR; SOT-23-5; MPN SN74LVC1G125DBVR

Connections:
AON_5V: C201.1, C241.1, U201.5 (VCC), U241.5 (VCC)
GND: C201.2, C202.2, C241.2, C242.2, J201.2, J241.2, R202.2, R242.2, U201.3 (GND), U202.1 (~OE), U202.3 (GND), U241.3 (GND), U242.1 (~OE), U242.3 (GND)
LEG_DATA: J201.1, R201.2, U202.2 (A_5V_tolerant)
LEG_DE: R202.1
LEG_RX: U202.4 (Y)
LEG_TX: R203.2, U201.2 (A)
LEG_TX_DRV: R201.1, U201.4 (Y)
LEG_TX_ENABLE: U201.1 (OE)
MCU_3V3: C202.1, C242.1, R203.1, R243.1, U202.5 (VCC), U242.5 (VCC)
UPPER_DATA: J241.1, R241.2, U242.2 (A_5V_tolerant)
UPPER_DE: R242.1
UPPER_RX: U242.4 (Y)
UPPER_TX: R243.2, U241.2 (A)
UPPER_TX_DRV: R241.1, U241.4 (Y)
UPPER_TX_ENABLE: U241.1 (OE)

Notes on the sheet:
SERVO DATA ONLY / power harness comes from the power board, never from these connectors
AHCT TX buffer: 3.3 V TTL-compatible inputs, 5 V bus output, active-high enable default low. LVC RX buffer: powered at 3.3 V with a 5.5 V-tolerant input. Receive echo is visible during transmit. Direction timing, first/last byte, powered-off servo behaviour and 1 Mbps edges require the actual harne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
LEG=Serial1 pins 0/1, UPPER=Serial2 pins 7/8, LEFT=Serial3 pins 15/14, RIGHT=Serial4 pins 16/17. STM/STS and older SCS framing is firmware work; these buffers do not translate protocols. External ESD device selection and bus pull-up, if the actual servos require one, remain bench decisions.
