iimmyy/Little-Guy/hardware/little-guy-v2/pcb/spinal/03-servo-buses-2.kicad_sch

## KiCad design hardware/little-guy-v2/pcb/spinal/03-servo-buses-2.kicad_sch (2026-11-07)

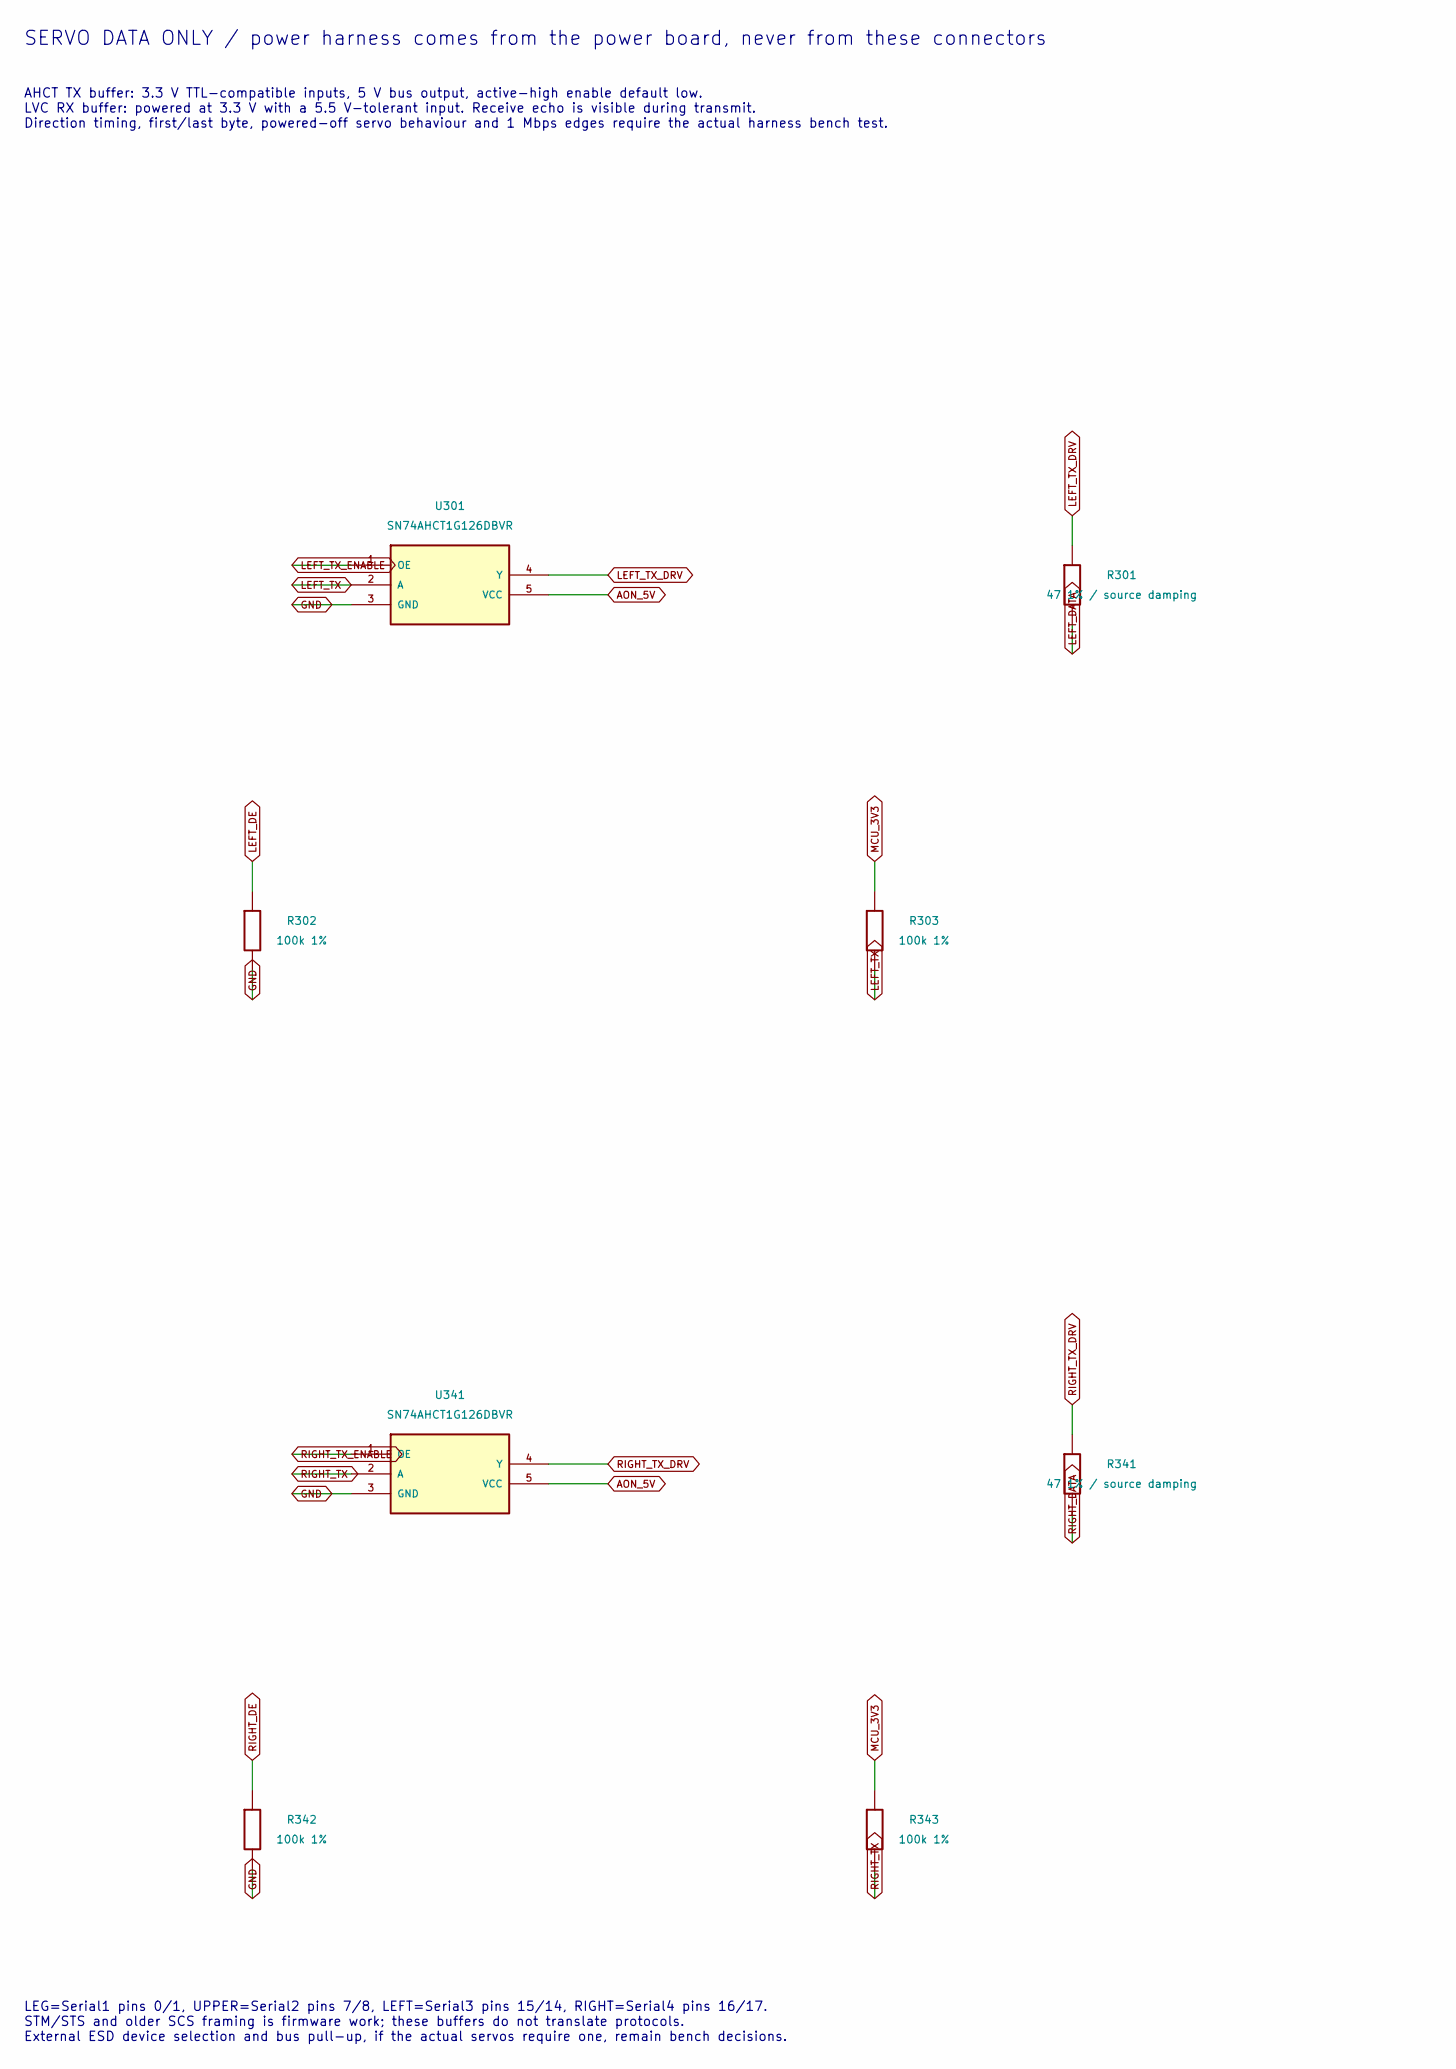
[picture p82: schematic 03-servo-buses-2.kicad_sch, part in row 1, column 1]

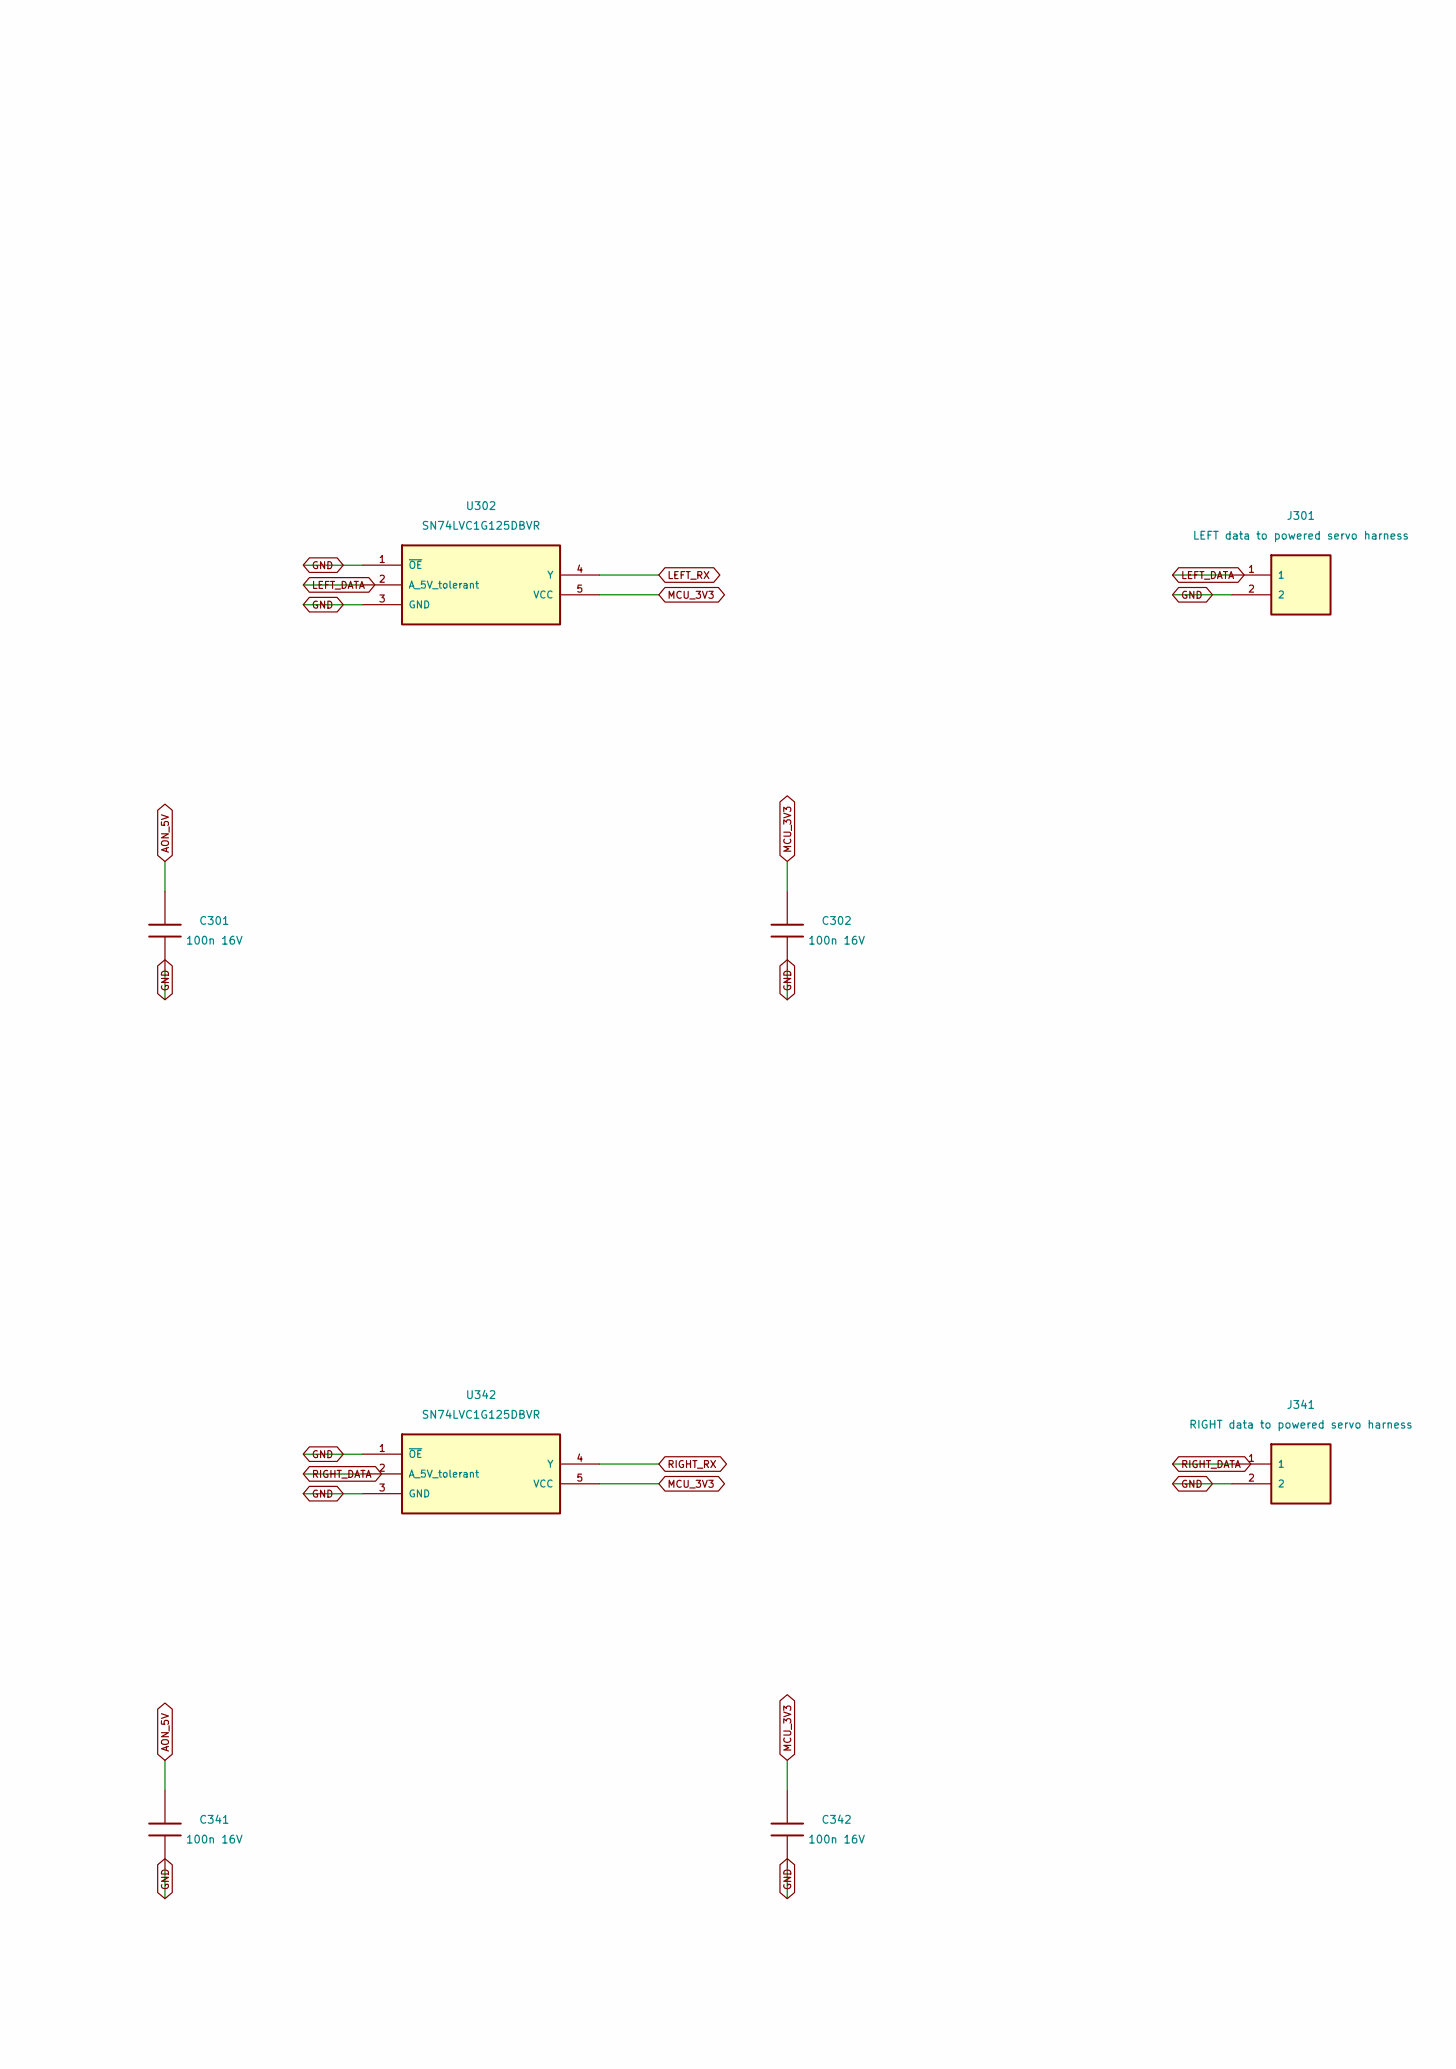
[picture p83: schematic 03-servo-buses-2.kicad_sch, part in row 1, column 2]

Parts:
C301, C302, C341, C342: 100n 16V; C_0603_1608Metric
J301: LEFT data to powered servo harness
J341: RIGHT data to powered servo harness
R301, R341: 47 1% / source damping; R_0603_1608Metric
R302, R303, R342, R343: 100k 1%; R_0603_1608Metric
U301, U341: SN74AHCT1G126DBVR; SOT-23-5; MPN SN74AHCT1G126DBVR
U302, U342: SN74LVC1G125DBVR; SOT-23-5; MPN SN74LVC1G125DBVR

Connections:
AON_5V: C301.1, C341.1, U301.5 (VCC), U341.5 (VCC)
GND: C301.2, C302.2, C341.2, C342.2, J301.2, J341.2, R302.2, R342.2, U301.3 (GND), U302.1 (~OE), U302.3 (GND), U341.3 (GND), U342.1 (~OE), U342.3 (GND)
LEFT_DATA: J301.1, R301.2, U302.2 (A_5V_tolerant)
LEFT_DE: R302.1
LEFT_RX: U302.4 (Y)
LEFT_TX: R303.2, U301.2 (A)
LEFT_TX_DRV: R301.1, U301.4 (Y)
LEFT_TX_ENABLE: U301.1 (OE)
MCU_3V3: C302.1, C342.1, R303.1, R343.1, U302.5 (VCC), U342.5 (VCC)
RIGHT_DATA: J341.1, R341.2, U342.2 (A_5V_tolerant)
RIGHT_DE: R342.1
RIGHT_RX: U342.4 (Y)
RIGHT_TX: R343.2, U341.2 (A)
RIGHT_TX_DRV: R341.1, U341.4 (Y)
RIGHT_TX_ENABLE: U341.1 (OE)

Notes on the sheet:
SERVO DATA ONLY / power harness comes from the power board, never from these connectors
AHCT TX buffer: 3.3 V TTL-compatible inputs, 5 V bus output, active-high enable default low. LVC RX buffer: powered at 3.3 V with a 5.5 V-tolerant input. Receive echo is visible during transmit. Direction timing, first/last byte, powered-off servo behaviour and 1 Mbps edges require the actual harne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
LEG=Serial1 pins 0/1, UPPER=Serial2 pins 7/8, LEFT=Serial3 pins 15/14, RIGHT=Serial4 pins 16/17. STM/STS and older SCS framing is firmware work; these buffers do not translate protocols. External ESD device selection and bus pull-up, if the actual servos require one, remain bench decisions.
