iimmyy/Little-Guy/hardware/little-guy-v2/pcb/spinal/04-sensor-buses.kicad_sch

## KiCad design hardware/little-guy-v2/pcb/spinal/04-sensor-buses.kicad_sch (2026-11-07)

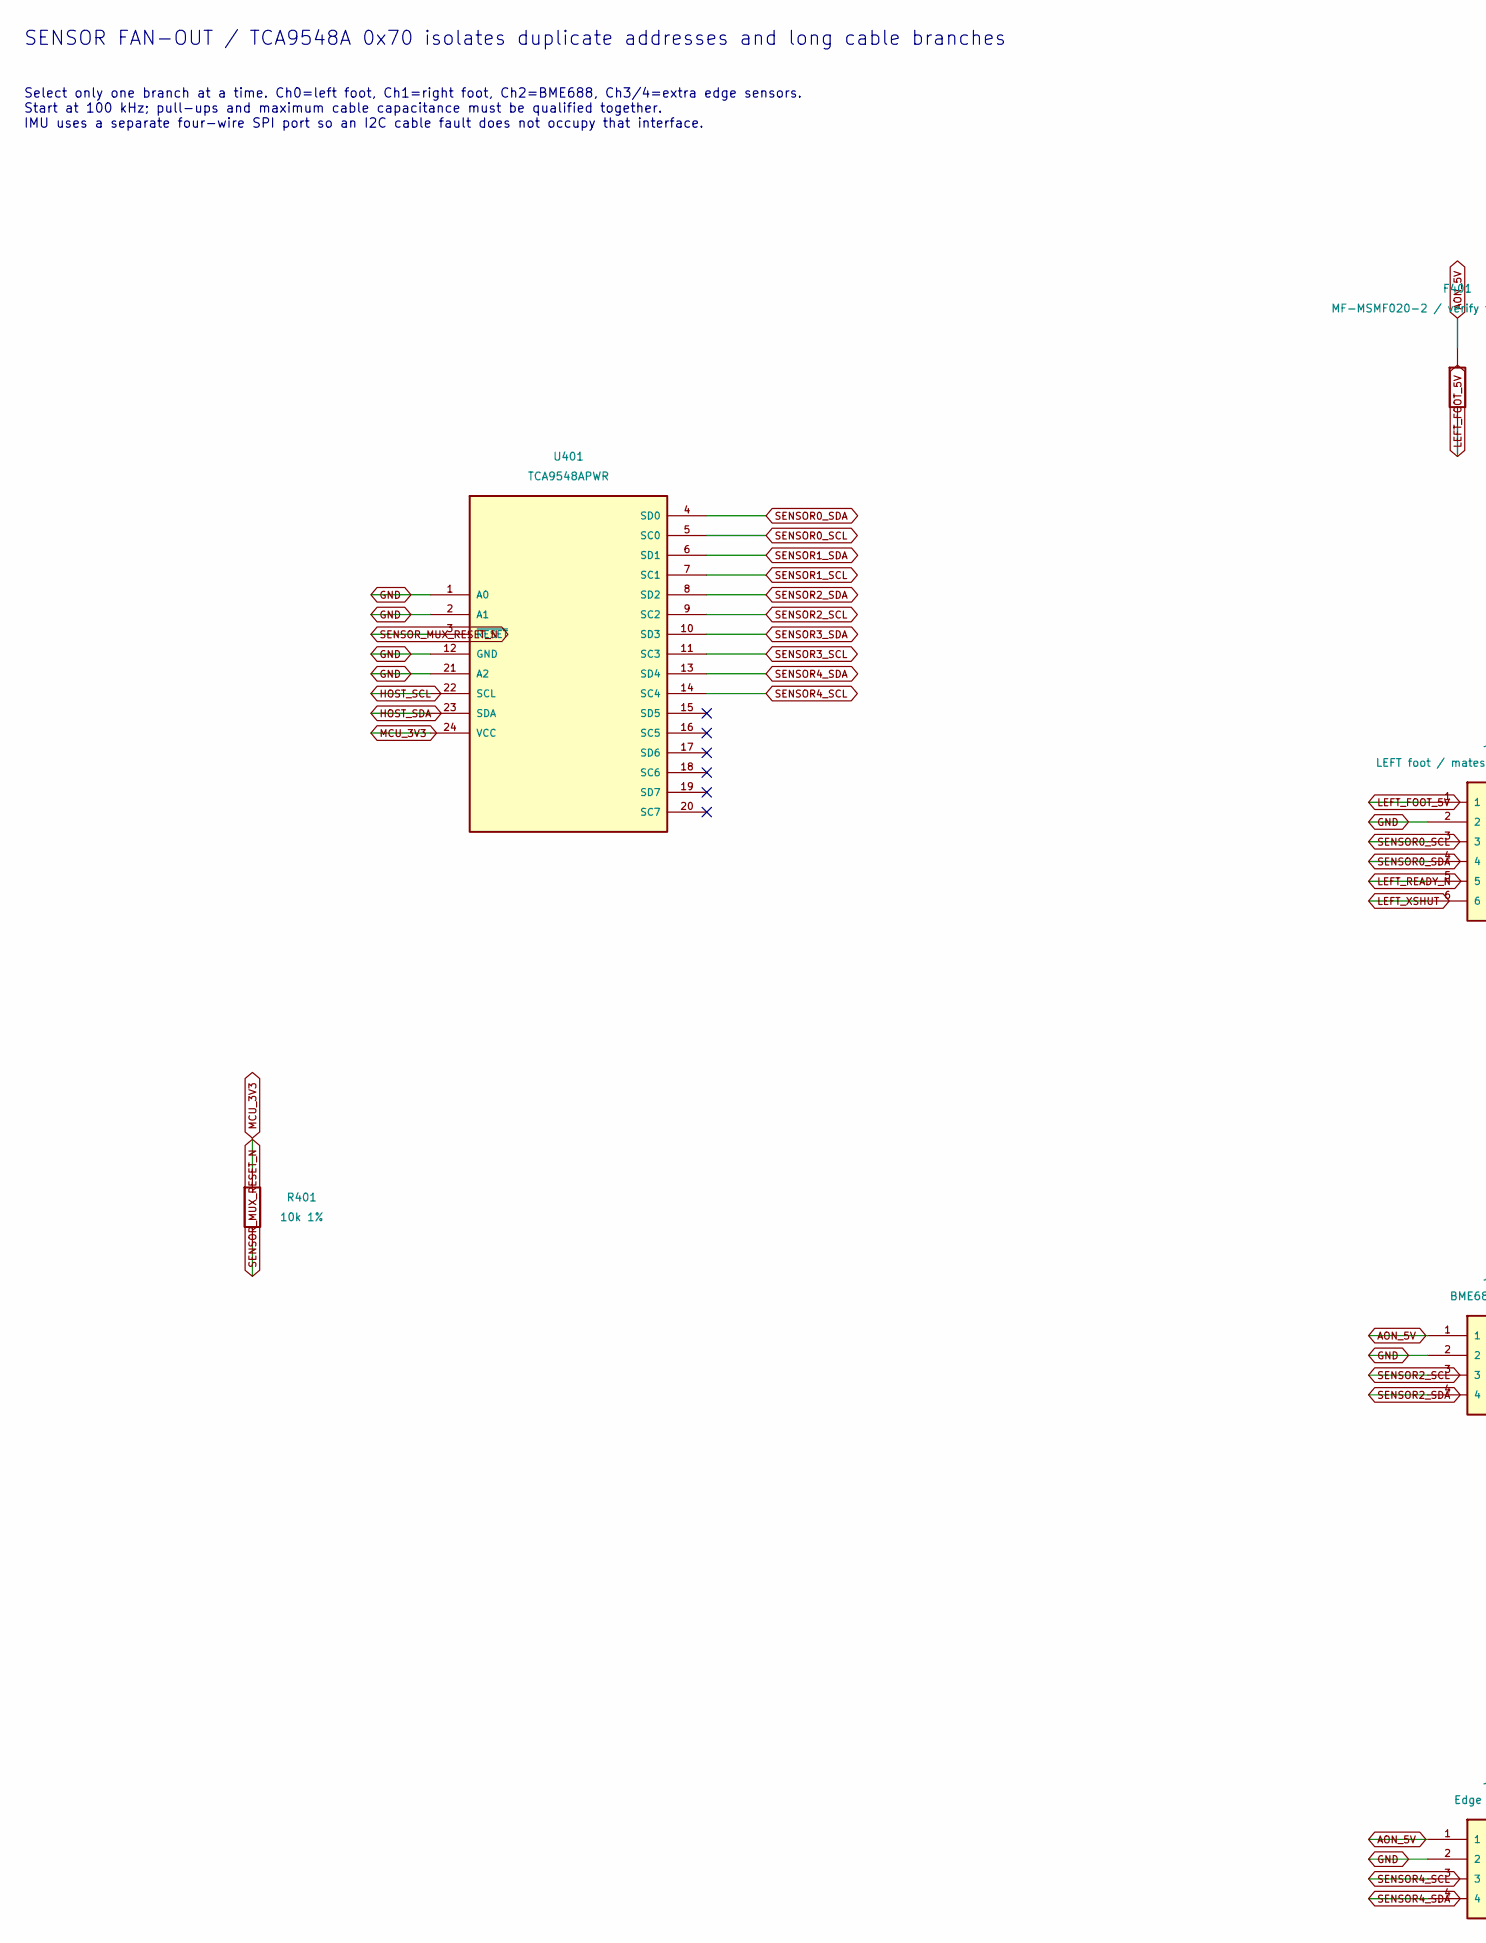
[picture p84: schematic 04-sensor-buses.kicad_sch, part in row 1, column 1]

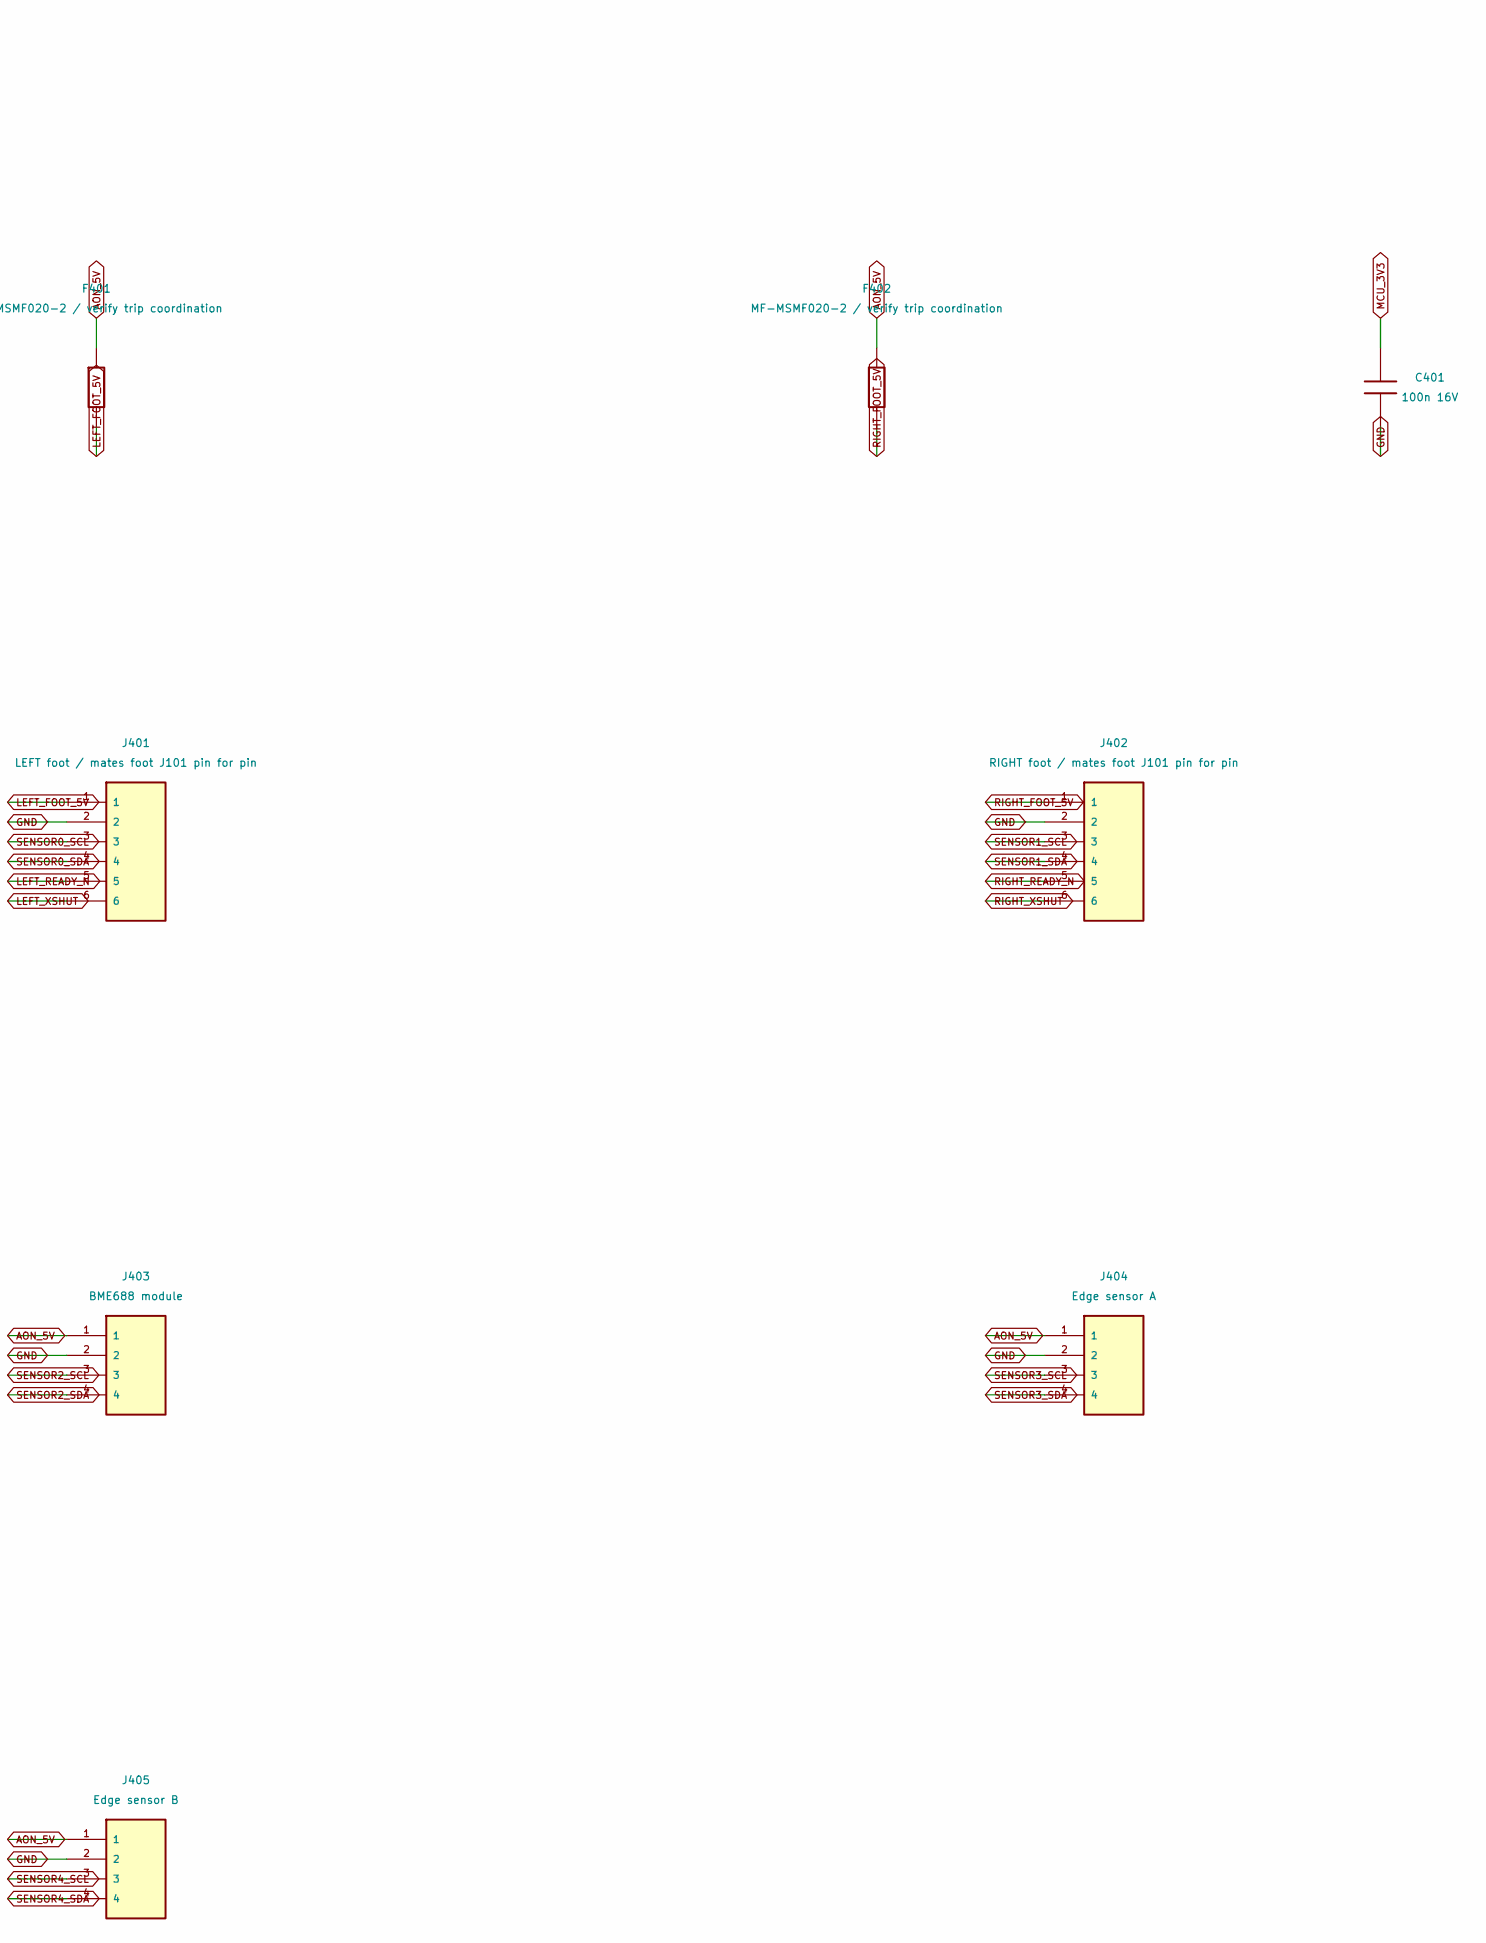
[picture p85: schematic 04-sensor-buses.kicad_sch, part in row 1, column 2]

Parts:
C401: 100n 16V; C_0603_1608Metric
F401, F402: MF-MSMF020-2 / verify trip coordination; Fuse_1812_4532Metric; MPN MF-MSMF020-2
J401: LEFT foot / mates foot J101 pin for pin
J402: RIGHT foot / mates foot J101 pin for pin
J403: BME688 module
J404: Edge sensor A
J405: Edge sensor B
R401: 10k 1%; R_0603_1608Metric
U401: TCA9548APWR; TSSOP-24_4.4x7.8mm_P0.65mm; MPN TCA9548APWR

Connections:
AON_5V: F401.1, F402.1, J403.1, J404.1, J405.1
GND: C401.2, J401.2, J402.2, J403.2, J404.2, J405.2, U401.1 (A0), U401.2 (A1), U401.12 (GND), U401.21 (A2)
HOST_SCL: U401.22 (SCL)
HOST_SDA: U401.23 (SDA)
LEFT_FOOT_5V: F401.2, J401.1
LEFT_READY_N: J401.5
LEFT_XSHUT: J401.6
MCU_3V3: C401.1, R401.1, U401.24 (VCC)
RIGHT_FOOT_5V: F402.2, J402.1
RIGHT_READY_N: J402.5
RIGHT_XSHUT: J402.6
SENSOR0_SCL: J401.3, U401.5 (SC0)
SENSOR0_SDA: J401.4, U401.4 (SD0)
SENSOR1_SCL: J402.3, U401.7 (SC1)
SENSOR1_SDA: J402.4, U401.6 (SD1)
SENSOR2_SCL: J403.3, U401.9 (SC2)
SENSOR2_SDA: J403.4, U401.8 (SD2)
SENSOR3_SCL: J404.3, U401.11 (SC3)
SENSOR3_SDA: J404.4, U401.10 (SD3)
SENSOR4_SCL: J405.3, U401.14 (SC4)
SENSOR4_SDA: J405.4, U401.13 (SD4)
SENSOR_MUX_RESET_N: R401.2, U401.3 (~RESET)

Notes on the sheet:
SENSOR FAN-OUT / TCA9548A 0x70 isolates duplicate addresses and long cable branches
Select only one branch at a time. Ch0=left foot, Ch1=right foot, Ch2=BME688, Ch3/4=extra edge sensors. Start at 100 kHz; pull-ups and maximum cable capacitance must be qualified together. IMU uses a separate four-wire SPI port so an I2C cable fault does not occupy that interface.
