iimmyy/Little-Guy/hardware/little-guy-v2/pcb/spinal/05-imu-watchdog.kicad_sch

## KiCad design hardware/little-guy-v2/pcb/spinal/05-imu-watchdog.kicad_sch (2026-11-07)

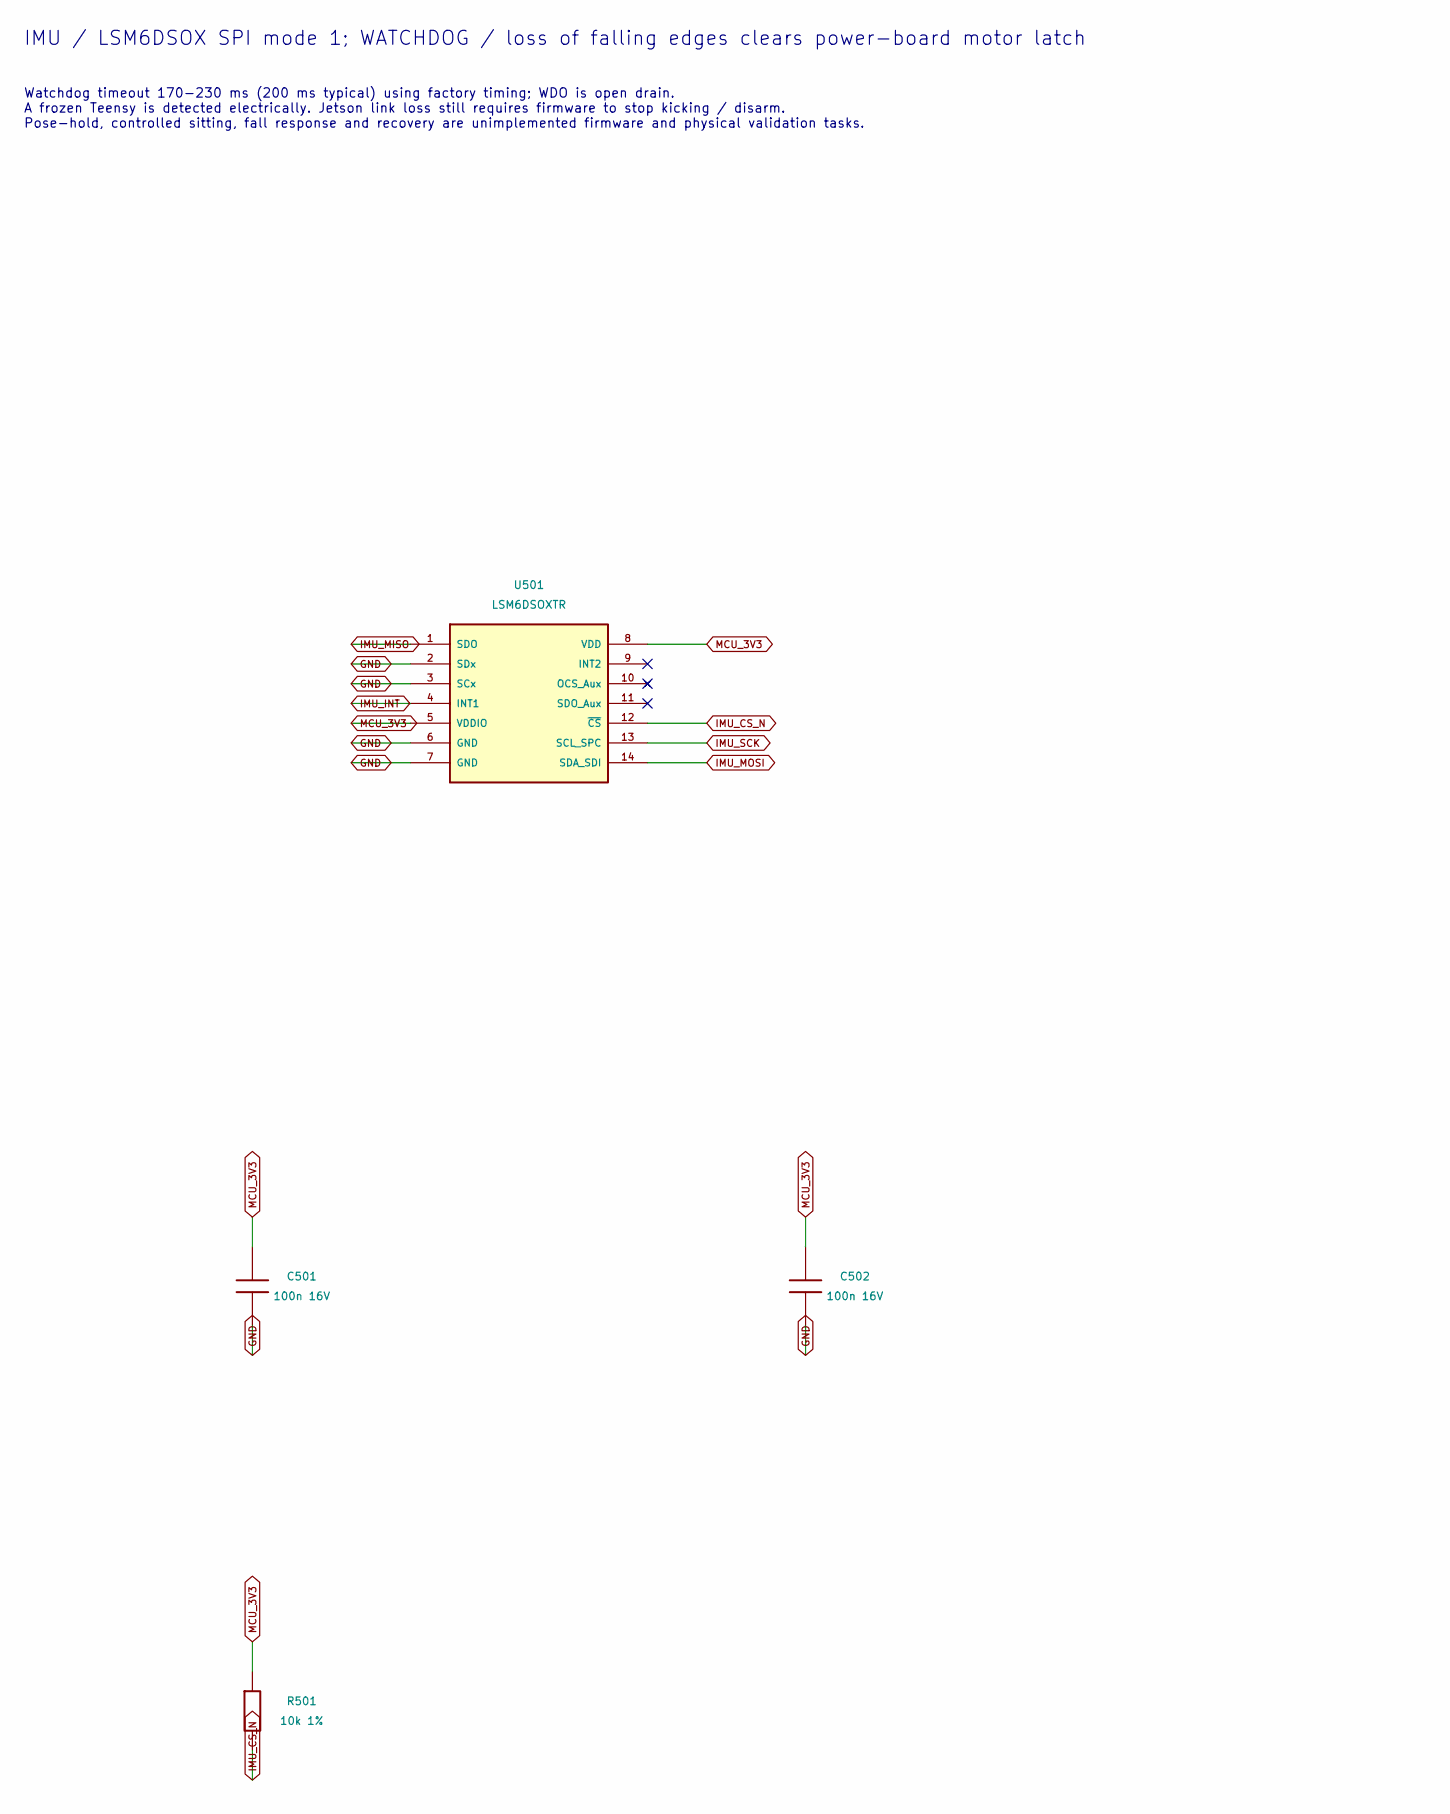
[picture p86: schematic 05-imu-watchdog.kicad_sch, part in row 1, column 1]

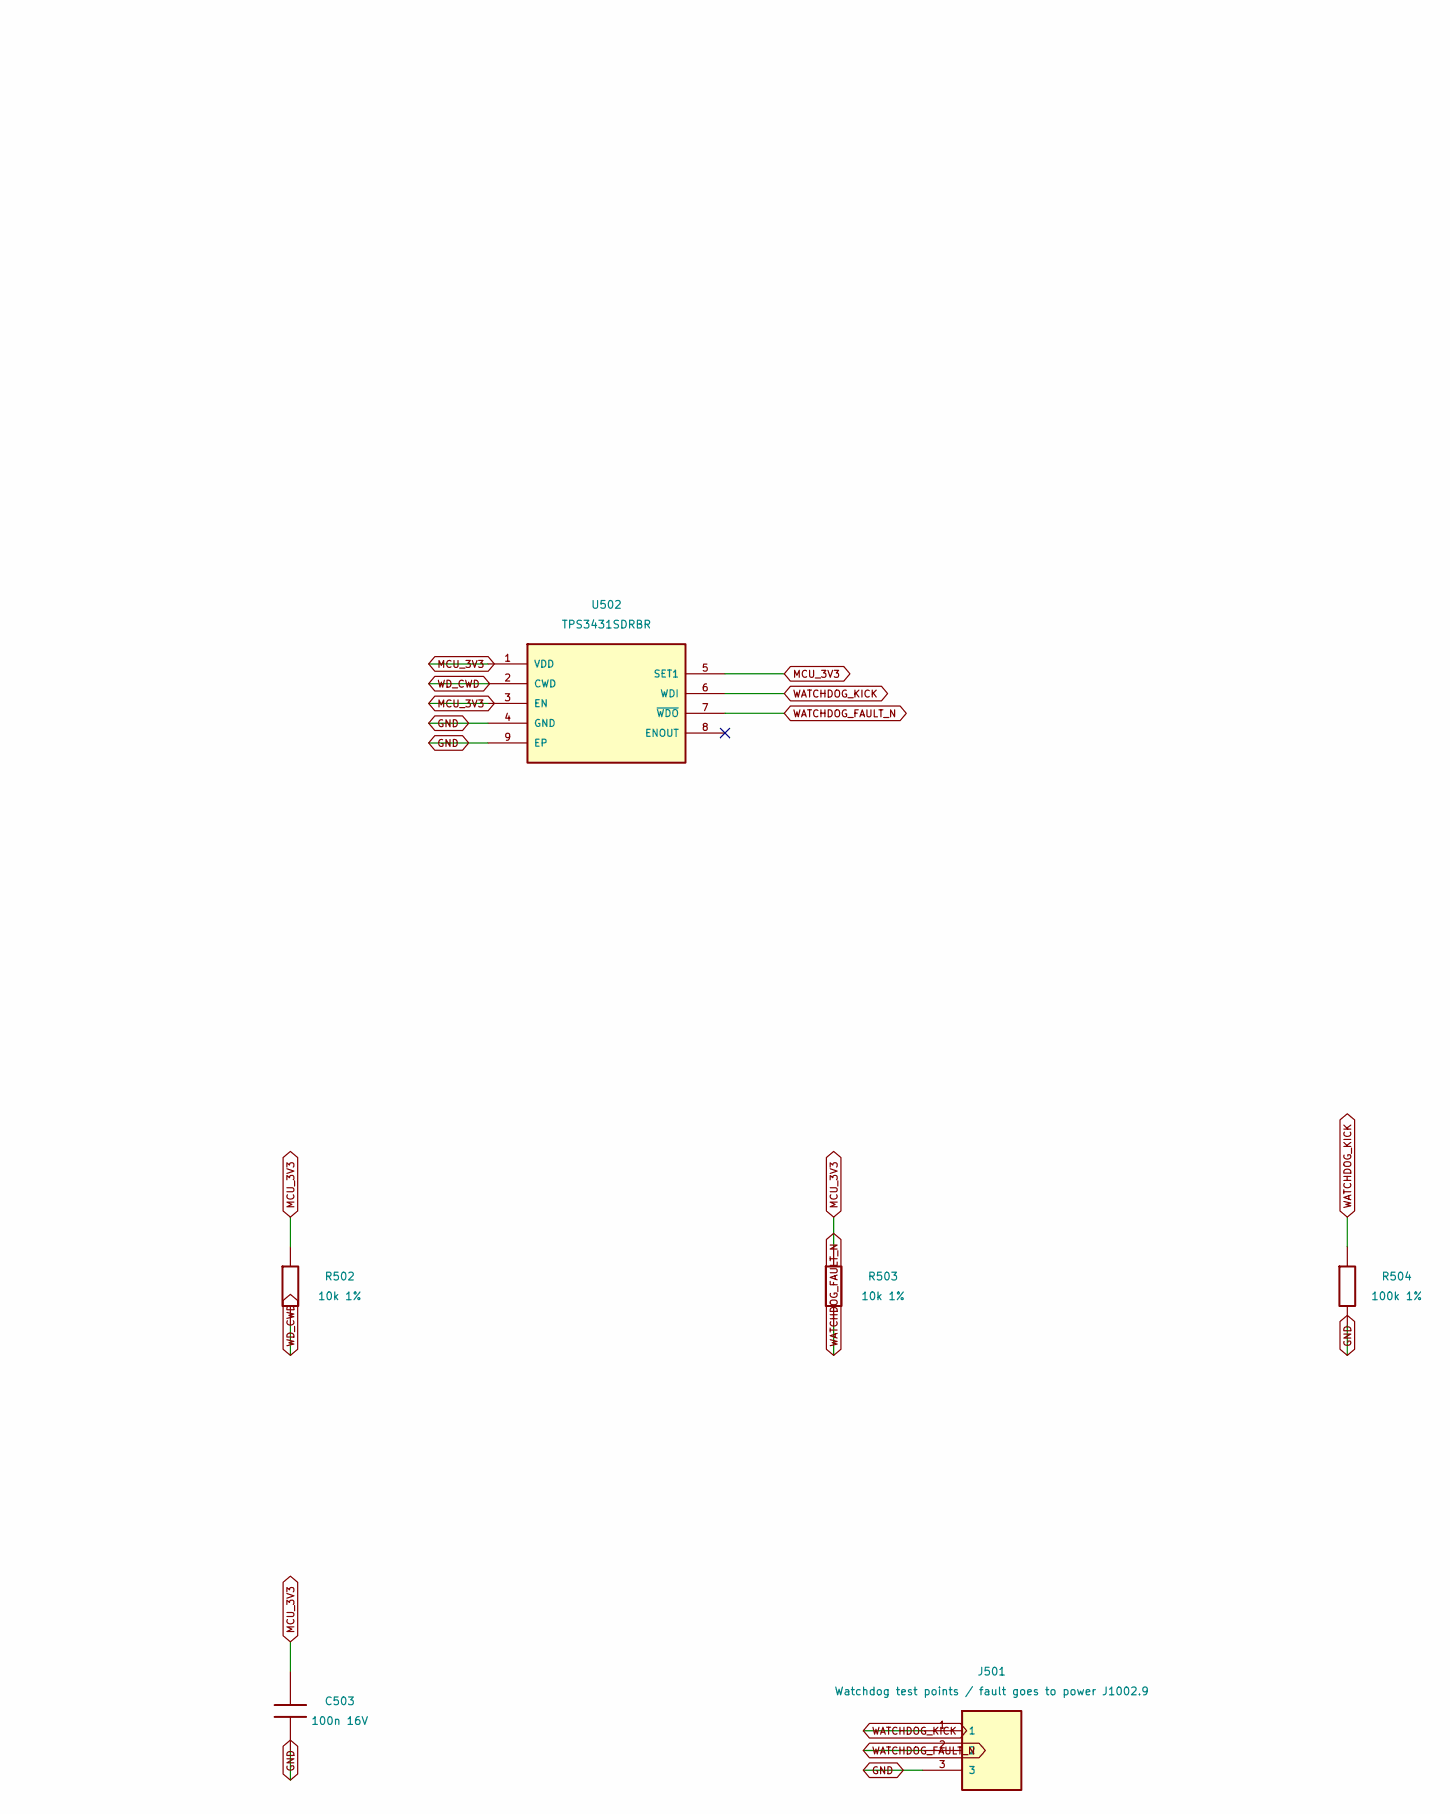
[picture p87: schematic 05-imu-watchdog.kicad_sch, part in row 1, column 2]

Parts:
C501, C502, C503: 100n 16V; C_0603_1608Metric
J501: Watchdog test points / fault goes to power J1002.9
R501, R502, R503: 10k 1%; R_0603_1608Metric
R504: 100k 1%; R_0603_1608Metric
U501: LSM6DSOXTR; MPN LSM6DSOXTR
U502: TPS3431SDRBR; MPN TPS3431SDRBR

Connections:
GND: C501.2, C502.2, C503.2, J501.3, R504.2, U501.2 (SDx), U501.3 (SCx), U501.6 (GND), U501.7 (GND), U502.4 (GND), U502.9 (EP)
IMU_CS_N: R501.2, U501.12 (~CS)
IMU_INT: U501.4 (INT1)
IMU_MISO: U501.1 (SDO)
IMU_MOSI: U501.14 (SDA_SDI)
IMU_SCK: U501.13 (SCL_SPC)
MCU_3V3: C501.1, C502.1, C503.1, R501.1, R502.1, R503.1, U501.5 (VDDIO), U501.8 (VDD), U502.1 (VDD), U502.3 (EN), U502.5 (SET1)
WATCHDOG_FAULT_N: J501.2, R503.2, U502.7 (~WDO)
WATCHDOG_KICK: J501.1, R504.1, U502.6 (WDI)
WD_CWD: R502.2, U502.2 (CWD)

Notes on the sheet:
IMU / LSM6DSOX SPI mode 1; WATCHDOG / loss of falling edges clears power-board motor latch
Watchdog timeout 170-230 ms (200 ms typical) using factory timing; WDO is open drain. A frozen Teensy is detected electrically. Jetson link loss still requires firmware to stop kicking / disarm. Pose-hold, controlled sitting, fall response and recovery are unimplemented firmware and physical valida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
