iimmyy/Little-Guy/hardware/little-guy-v2/pcb/spinal/06-touch-1.kicad_sch

## KiCad design hardware/little-guy-v2/pcb/spinal/06-touch-1.kicad_sch (2026-11-07)

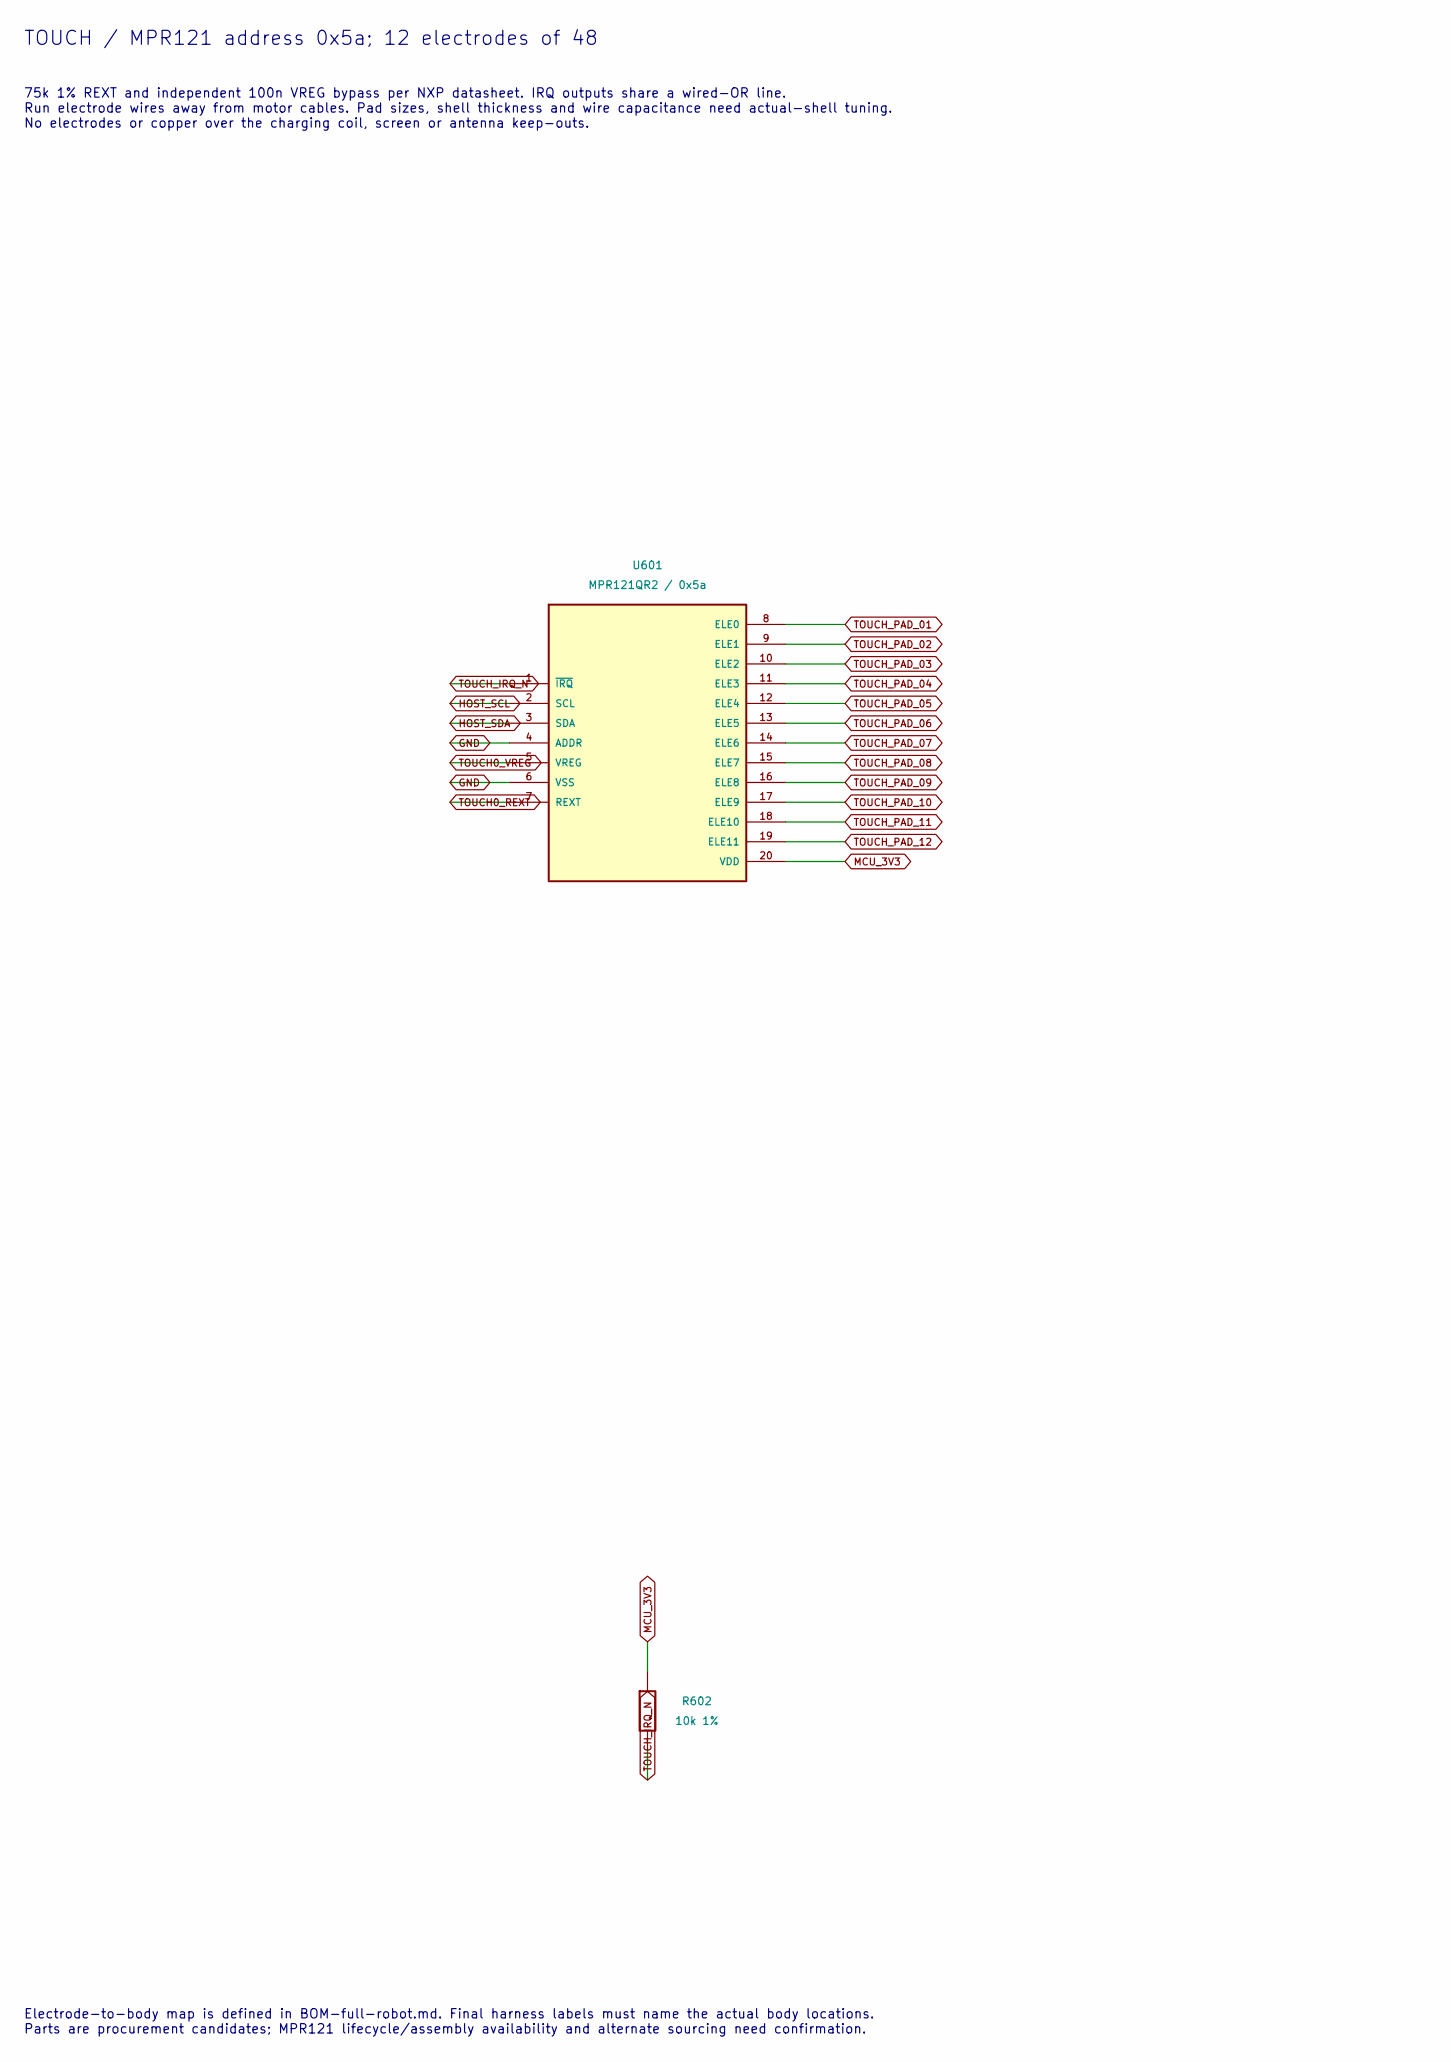
[picture p88: schematic 06-touch-1.kicad_sch, part in row 1, column 1]

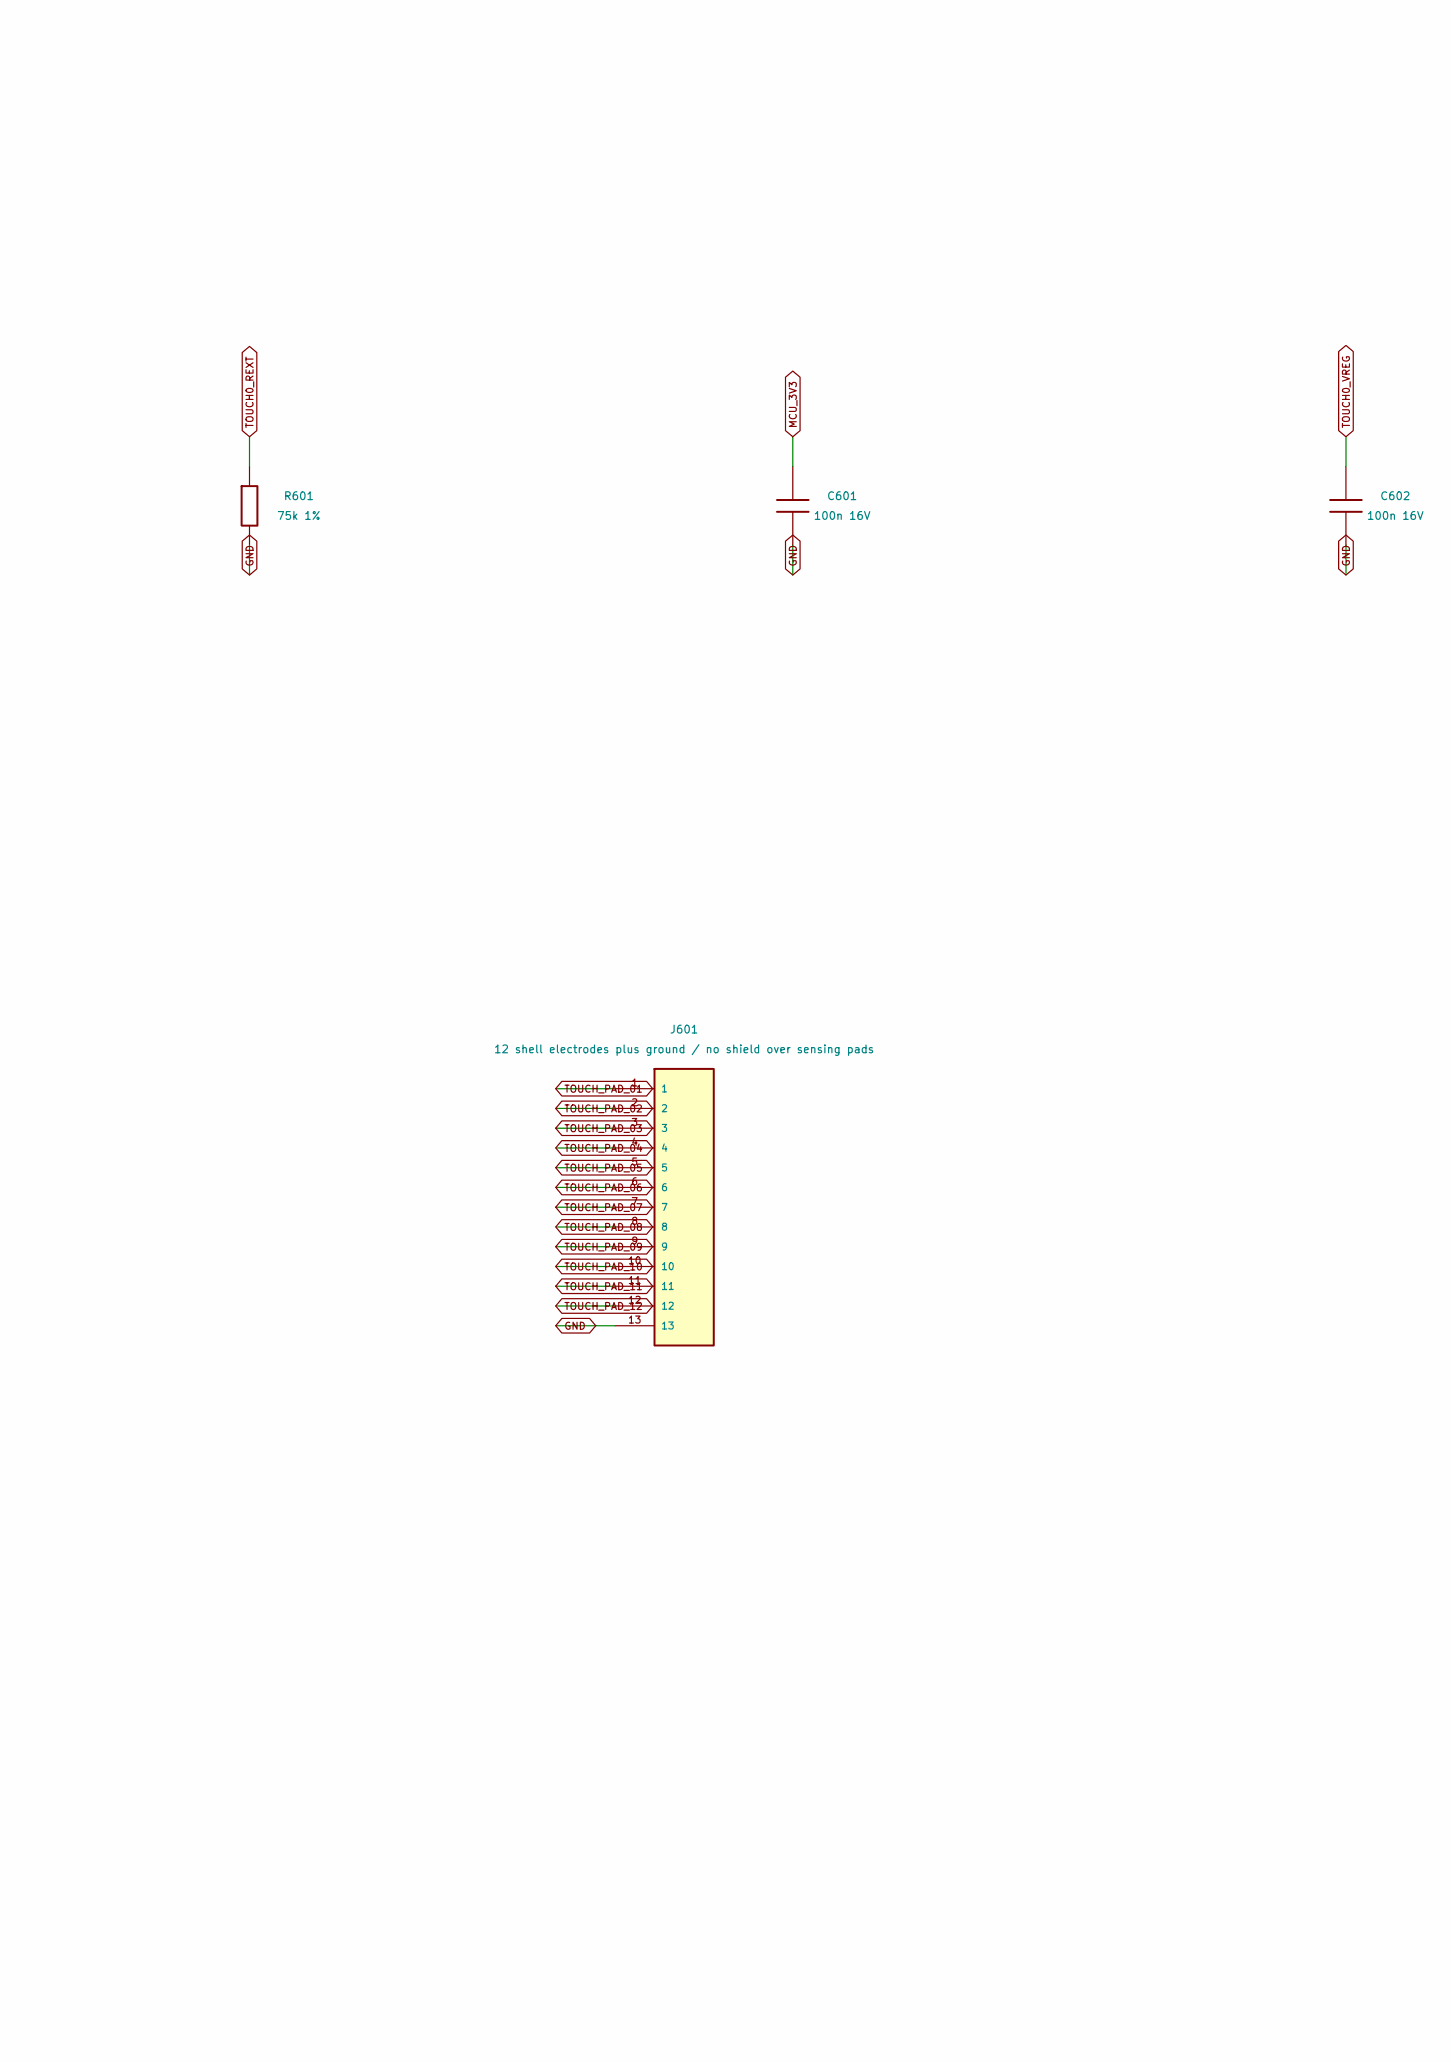
[picture p89: schematic 06-touch-1.kicad_sch, part in row 1, column 2]

Parts:
C601, C602: 100n 16V; C_0603_1608Metric
J601: 12 shell electrodes plus ground / no shield over 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
R601: 75k 1%; R_0603_1608Metric
R602: 10k 1%; R_0603_1608Metric
U601: MPR121QR2 / 0x5a; UQFN-20_3x3mm_P0.4mm; MPN MPR121QR2

Connections:
GND: C601.2, C602.2, J601.13, R601.2, U601.4 (ADDR), U601.6 (VSS)
HOST_SCL: U601.2 (SCL)
HOST_SDA: U601.3 (SDA)
MCU_3V3: C601.1, R602.1, U601.20 (VDD)
TOUCH0_REXT: R601.1, U601.7 (REXT)
TOUCH0_VREG: C602.1, U601.5 (VREG)
TOUCH_IRQ_N: R602.2, U601.1 (~IRQ)
TOUCH_PAD_01: J601.1, U601.8 (ELE0)
TOUCH_PAD_02: J601.2, U601.9 (ELE1)
TOUCH_PAD_03: J601.3, U601.10 (ELE2)
TOUCH_PAD_04: J601.4, U601.11 (ELE3)
TOUCH_PAD_05: J601.5, U601.12 (ELE4)
TOUCH_PAD_06: J601.6, U601.13 (ELE5)
TOUCH_PAD_07: J601.7, U601.14 (ELE6)
TOUCH_PAD_08: J601.8, U601.15 (ELE7)
TOUCH_PAD_09: J601.9, U601.16 (ELE8)
TOUCH_PAD_10: J601.10, U601.17 (ELE9)
TOUCH_PAD_11: J601.11, U601.18 (ELE10)
TOUCH_PAD_12: J601.12, U601.19 (ELE11)

Notes on the sheet:
TOUCH / MPR121 address 0x5a; 12 electrodes of 48
75k 1% REXT and independent 100n VREG bypass per NXP datasheet. IRQ outputs share a wired-OR line. Run electrode wires away from motor cables. Pad sizes, shell thickness and wire capacitance need actual-shell tuning. No electrodes or copper over the charging coil, screen or antenna keep-outs.
Electrode-to-body map is defined in BOM-full-robot.md. Final harness labels must name the actual body locations. Parts are procurement candidates; MPR121 lifecycle/assembly availability and alternate sourcing need confirmation.
