iimmyy/Little-Guy/hardware/little-guy-v2/pcb/spinal/07-touch-2.kicad_sch

## KiCad design hardware/little-guy-v2/pcb/spinal/07-touch-2.kicad_sch (2026-11-07)

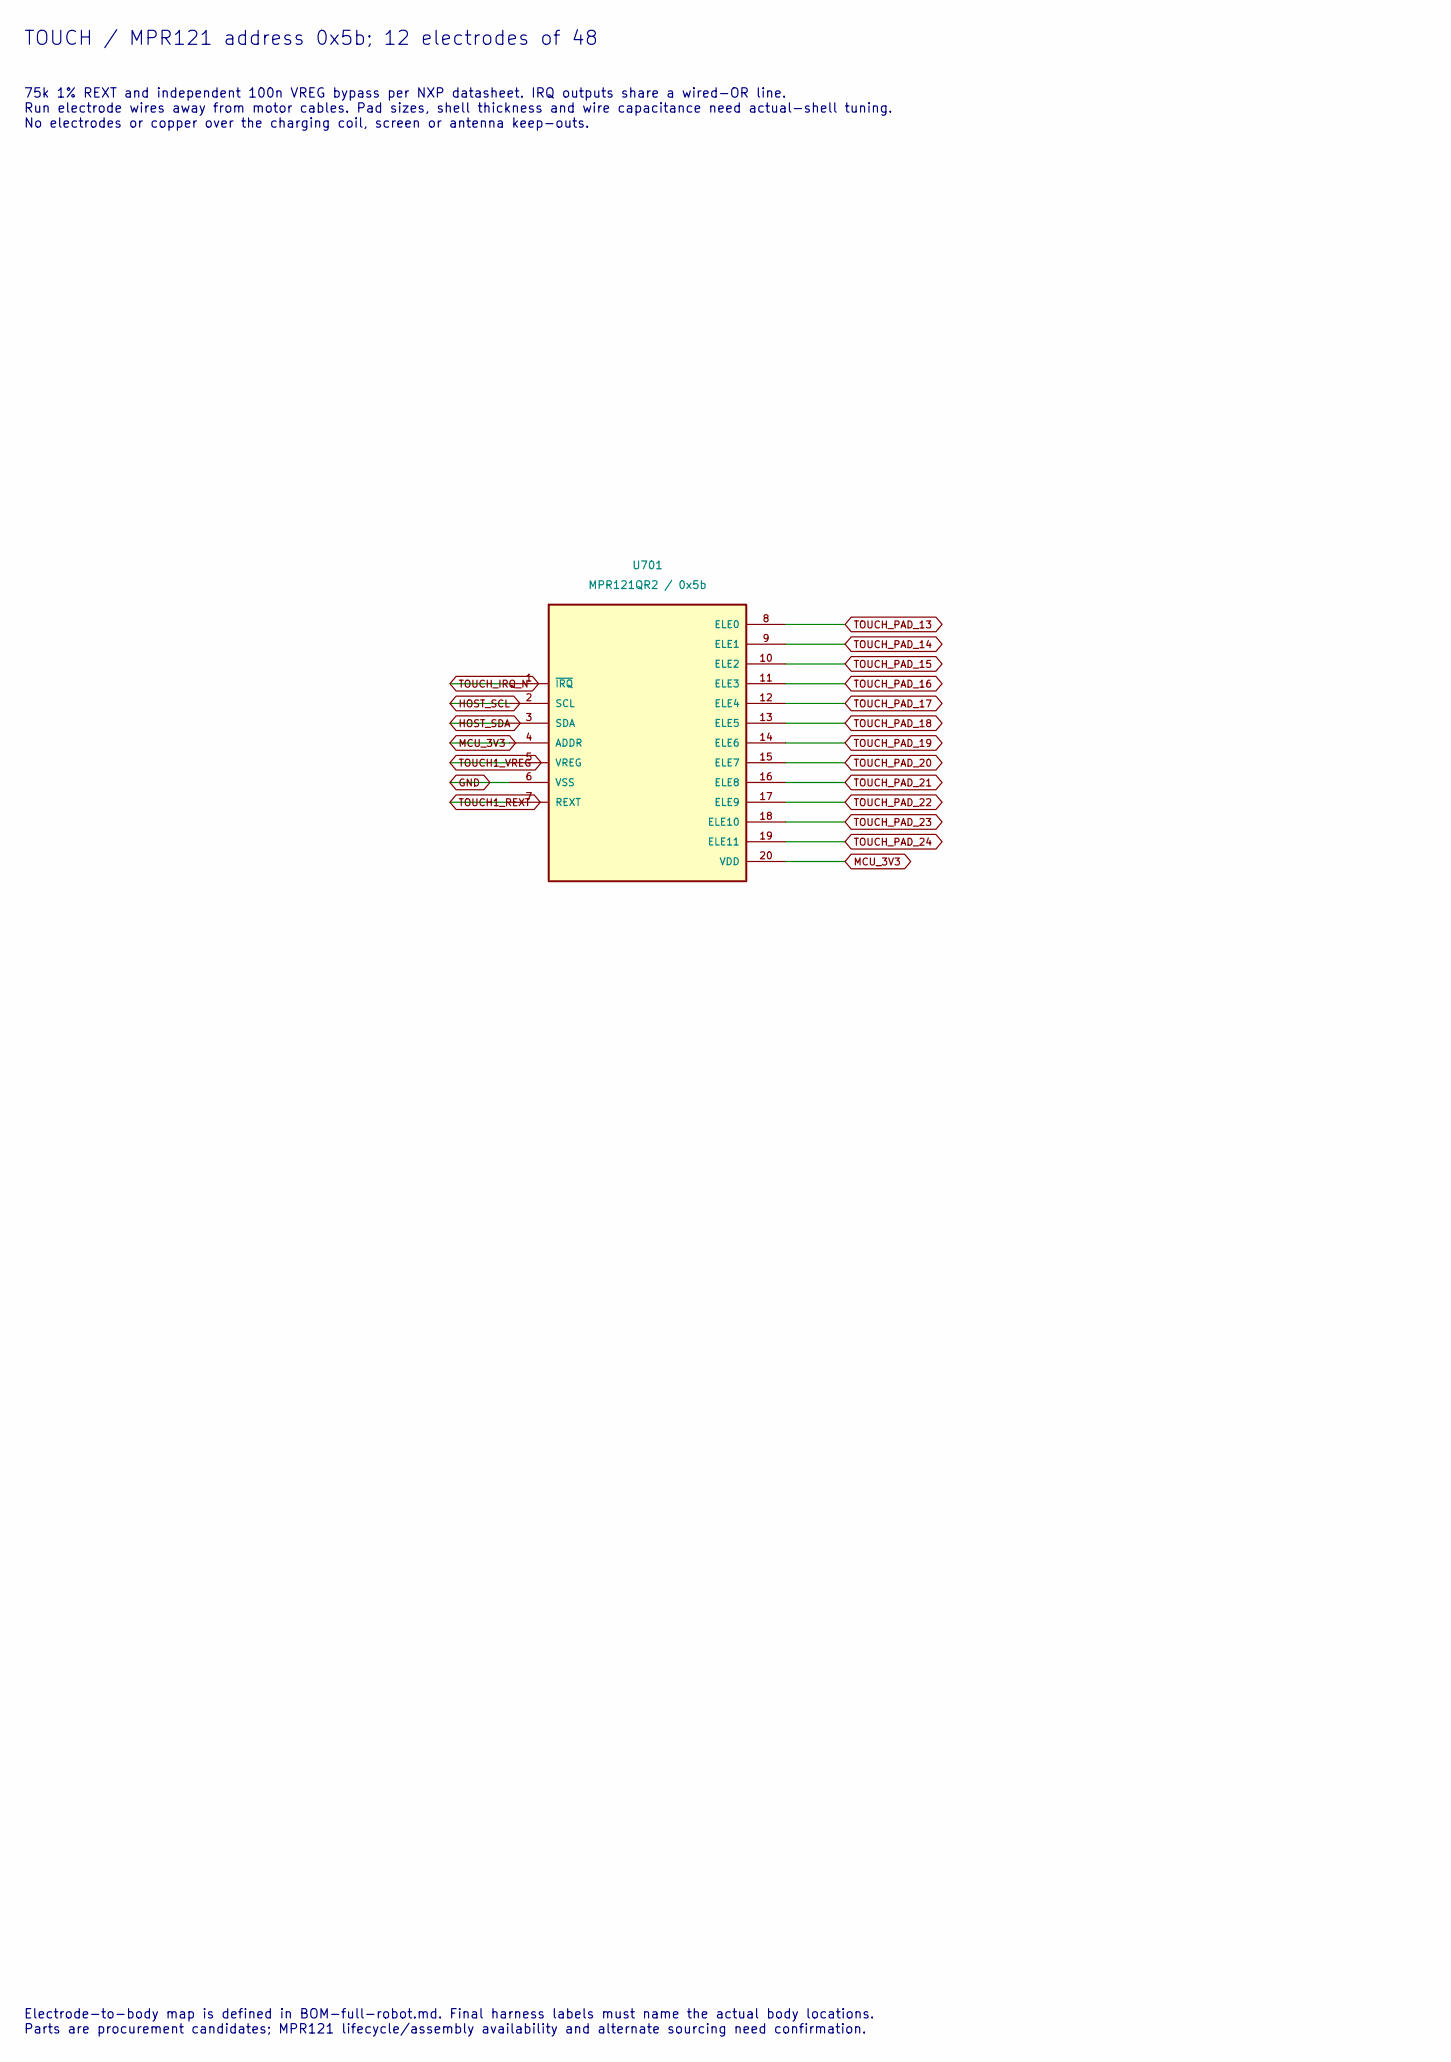
[picture p90: schematic 07-touch-2.kicad_sch, part in row 1, column 1]

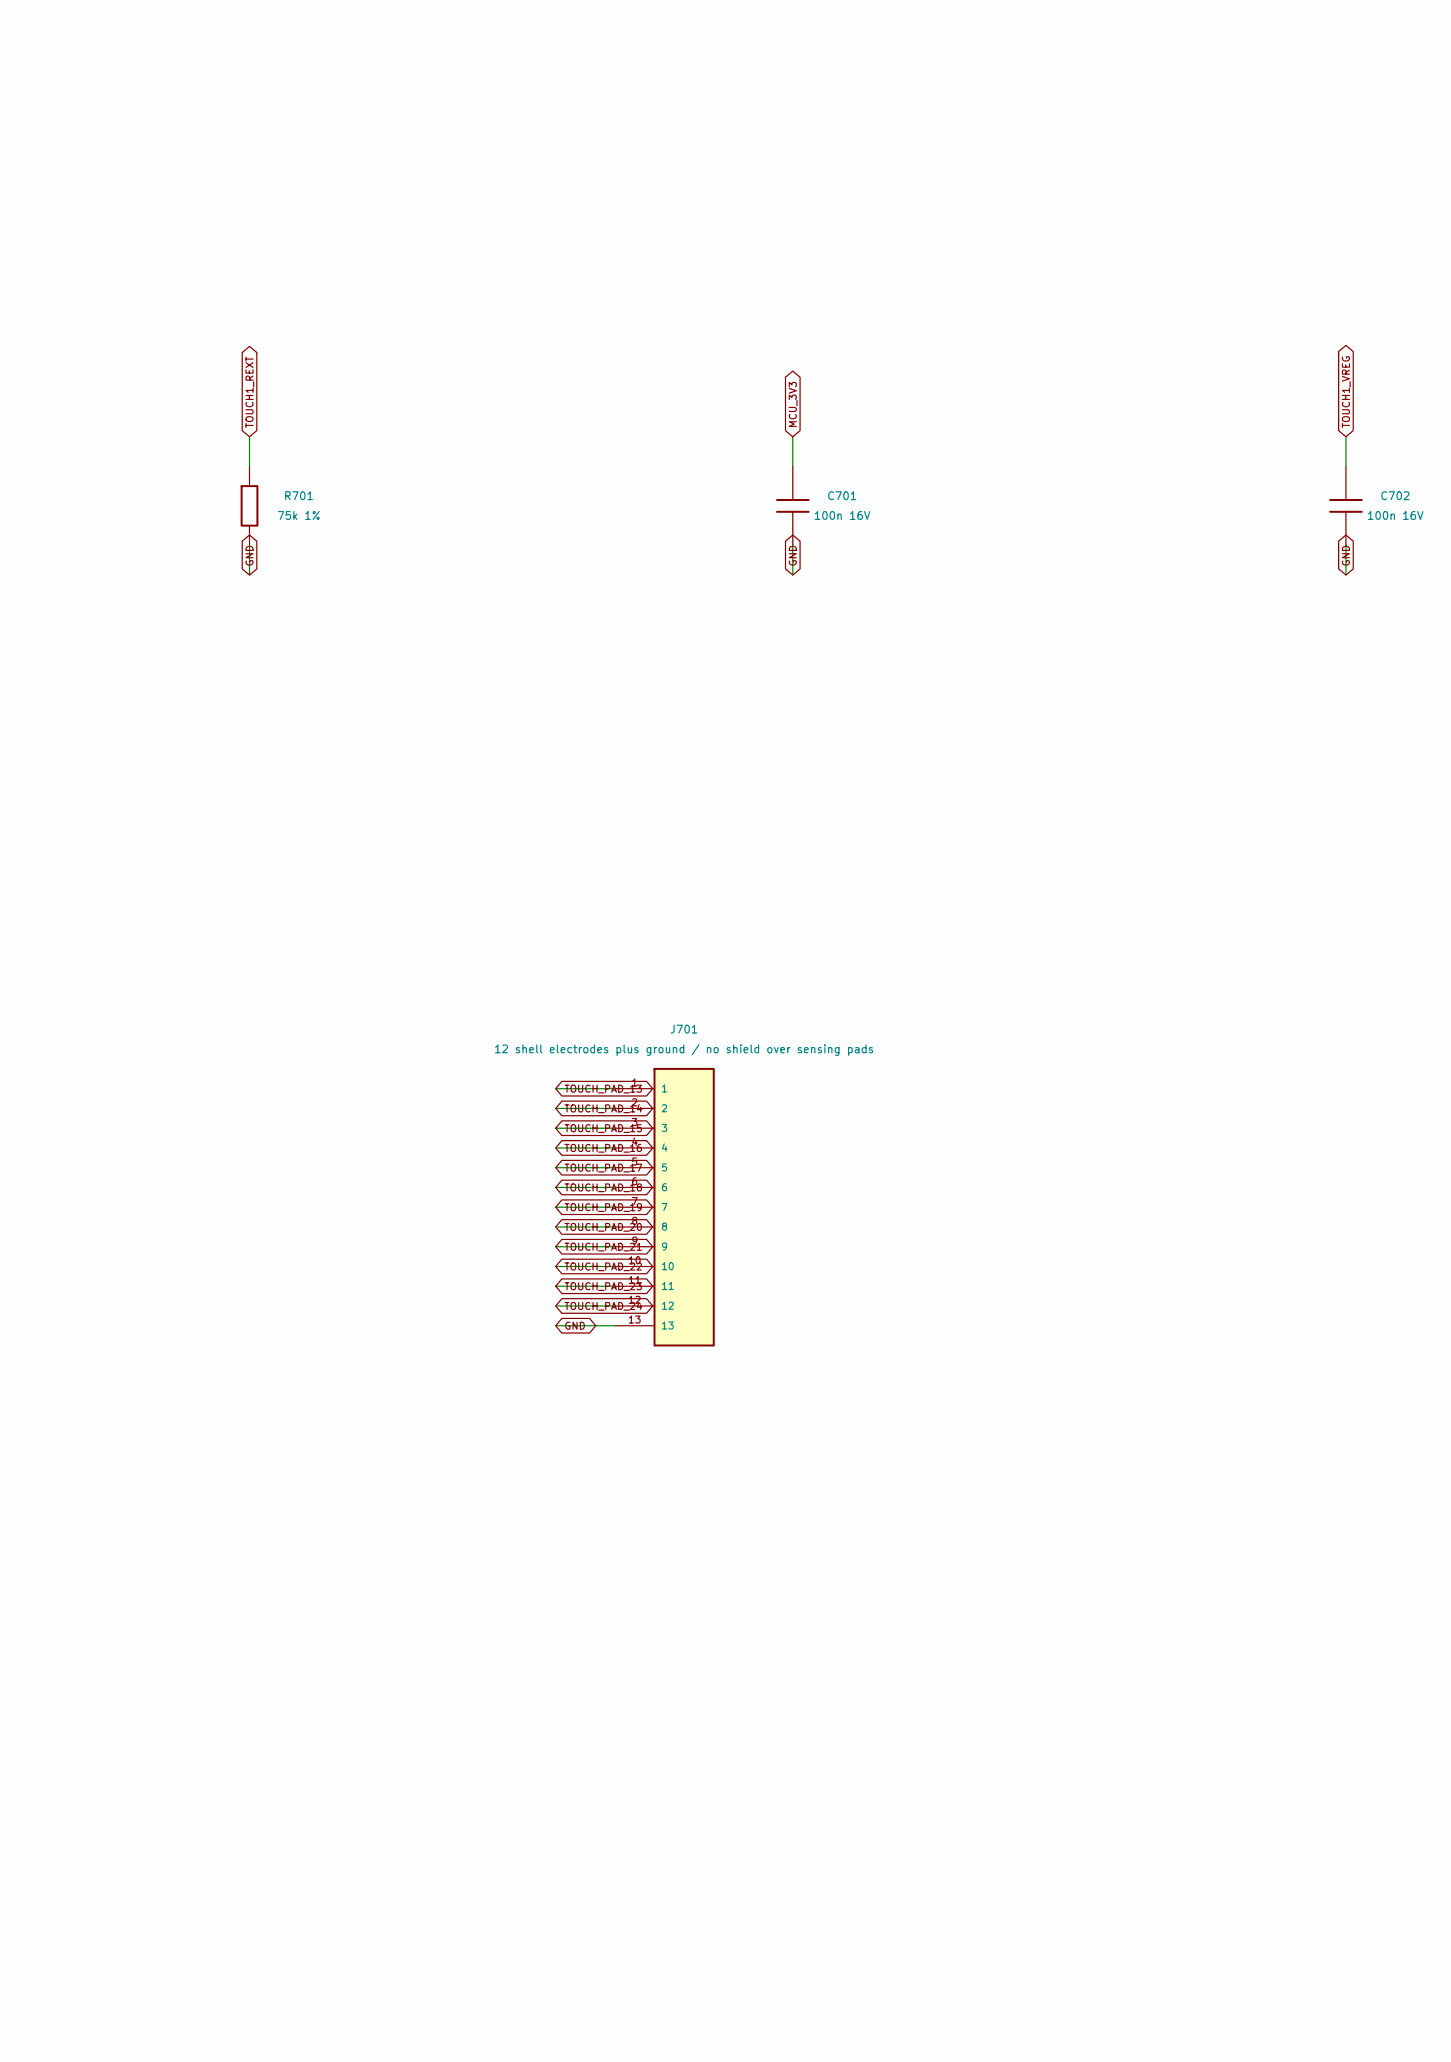
[picture p91: schematic 07-touch-2.kicad_sch, part in row 1, column 2]

Parts:
C701, C702: 100n 16V; C_0603_1608Metric
J701: 12 shell electrodes plus ground / no shield over 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
R701: 75k 1%; R_0603_1608Metric
U701: MPR121QR2 / 0x5b; UQFN-20_3x3mm_P0.4mm; MPN MPR121QR2

Connections:
GND: C701.2, C702.2, J701.13, R701.2, U701.6 (VSS)
HOST_SCL: U701.2 (SCL)
HOST_SDA: U701.3 (SDA)
MCU_3V3: C701.1, U701.4 (ADDR), U701.20 (VDD)
TOUCH1_REXT: R701.1, U701.7 (REXT)
TOUCH1_VREG: C702.1, U701.5 (VREG)
TOUCH_IRQ_N: U701.1 (~IRQ)
TOUCH_PAD_13: J701.1, U701.8 (ELE0)
TOUCH_PAD_14: J701.2, U701.9 (ELE1)
TOUCH_PAD_15: J701.3, U701.10 (ELE2)
TOUCH_PAD_16: J701.4, U701.11 (ELE3)
TOUCH_PAD_17: J701.5, U701.12 (ELE4)
TOUCH_PAD_18: J701.6, U701.13 (ELE5)
TOUCH_PAD_19: J701.7, U701.14 (ELE6)
TOUCH_PAD_20: J701.8, U701.15 (ELE7)
TOUCH_PAD_21: J701.9, U701.16 (ELE8)
TOUCH_PAD_22: J701.10, U701.17 (ELE9)
TOUCH_PAD_23: J701.11, U701.18 (ELE10)
TOUCH_PAD_24: J701.12, U701.19 (ELE11)

Notes on the sheet:
TOUCH / MPR121 address 0x5b; 12 electrodes of 48
75k 1% REXT and independent 100n VREG bypass per NXP datasheet. IRQ outputs share a wired-OR line. Run electrode wires away from motor cables. Pad sizes, shell thickness and wire capacitance need actual-shell tuning. No electrodes or copper over the charging coil, screen or antenna keep-outs.
Electrode-to-body map is defined in BOM-full-robot.md. Final harness labels must name the actual body locations. Parts are procurement candidates; MPR121 lifecycle/assembly availability and alternate sourcing need confirmation.
