iimmyy/Little-Guy/hardware/little-guy-v2/pcb/spinal/08-touch-3.kicad_sch

## KiCad design hardware/little-guy-v2/pcb/spinal/08-touch-3.kicad_sch (2026-11-07)

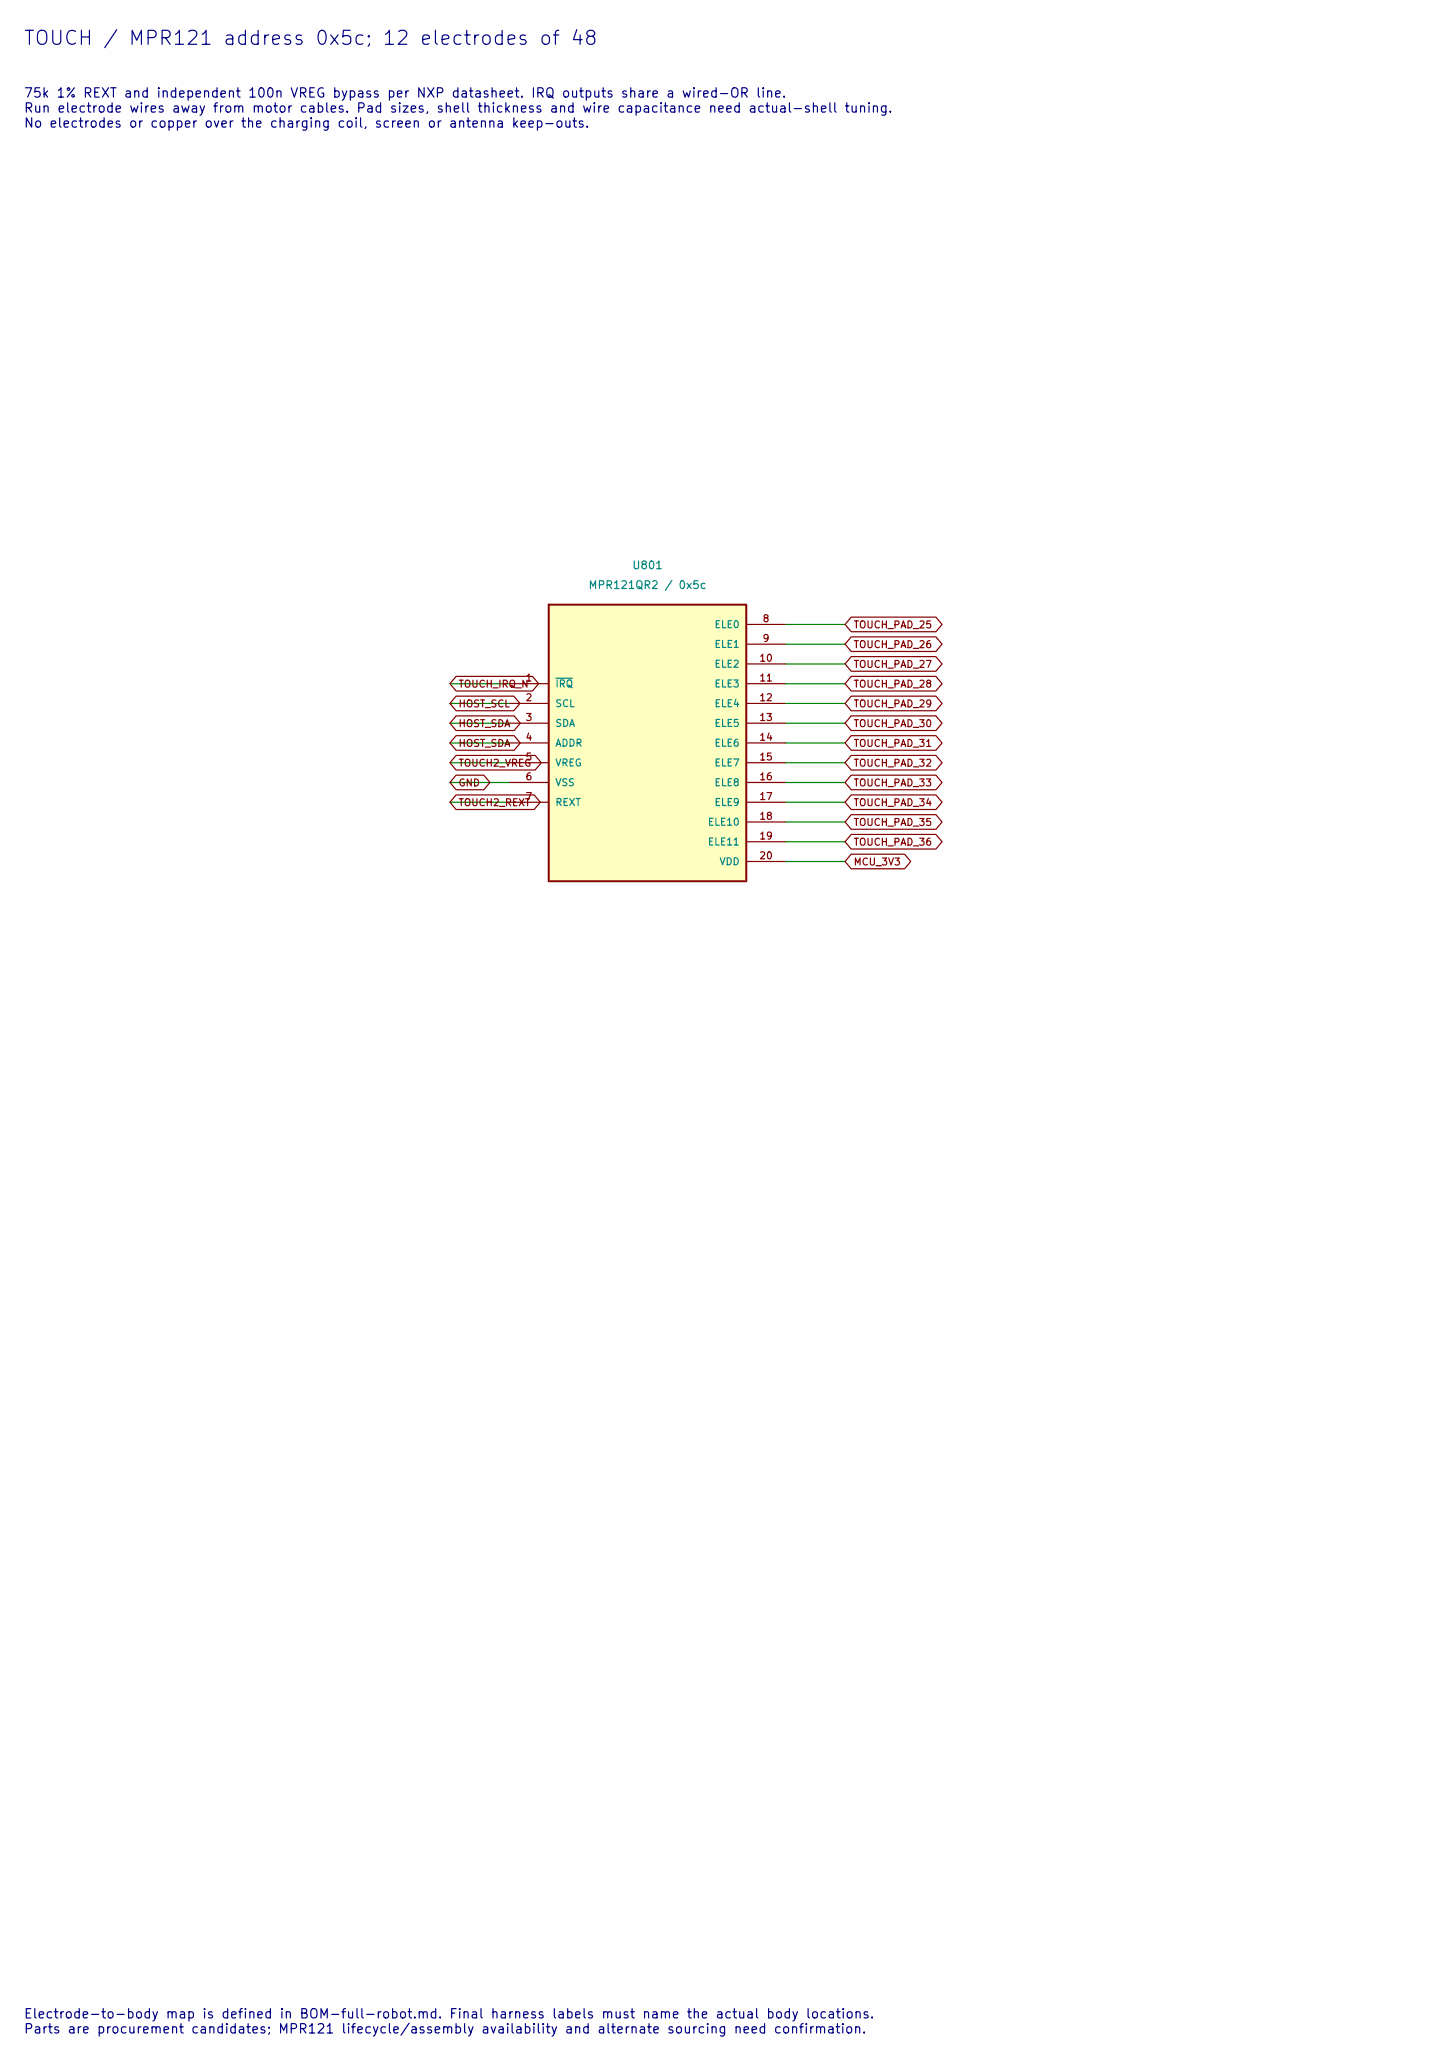
[picture p92: schematic 08-touch-3.kicad_sch, part in row 1, column 1]

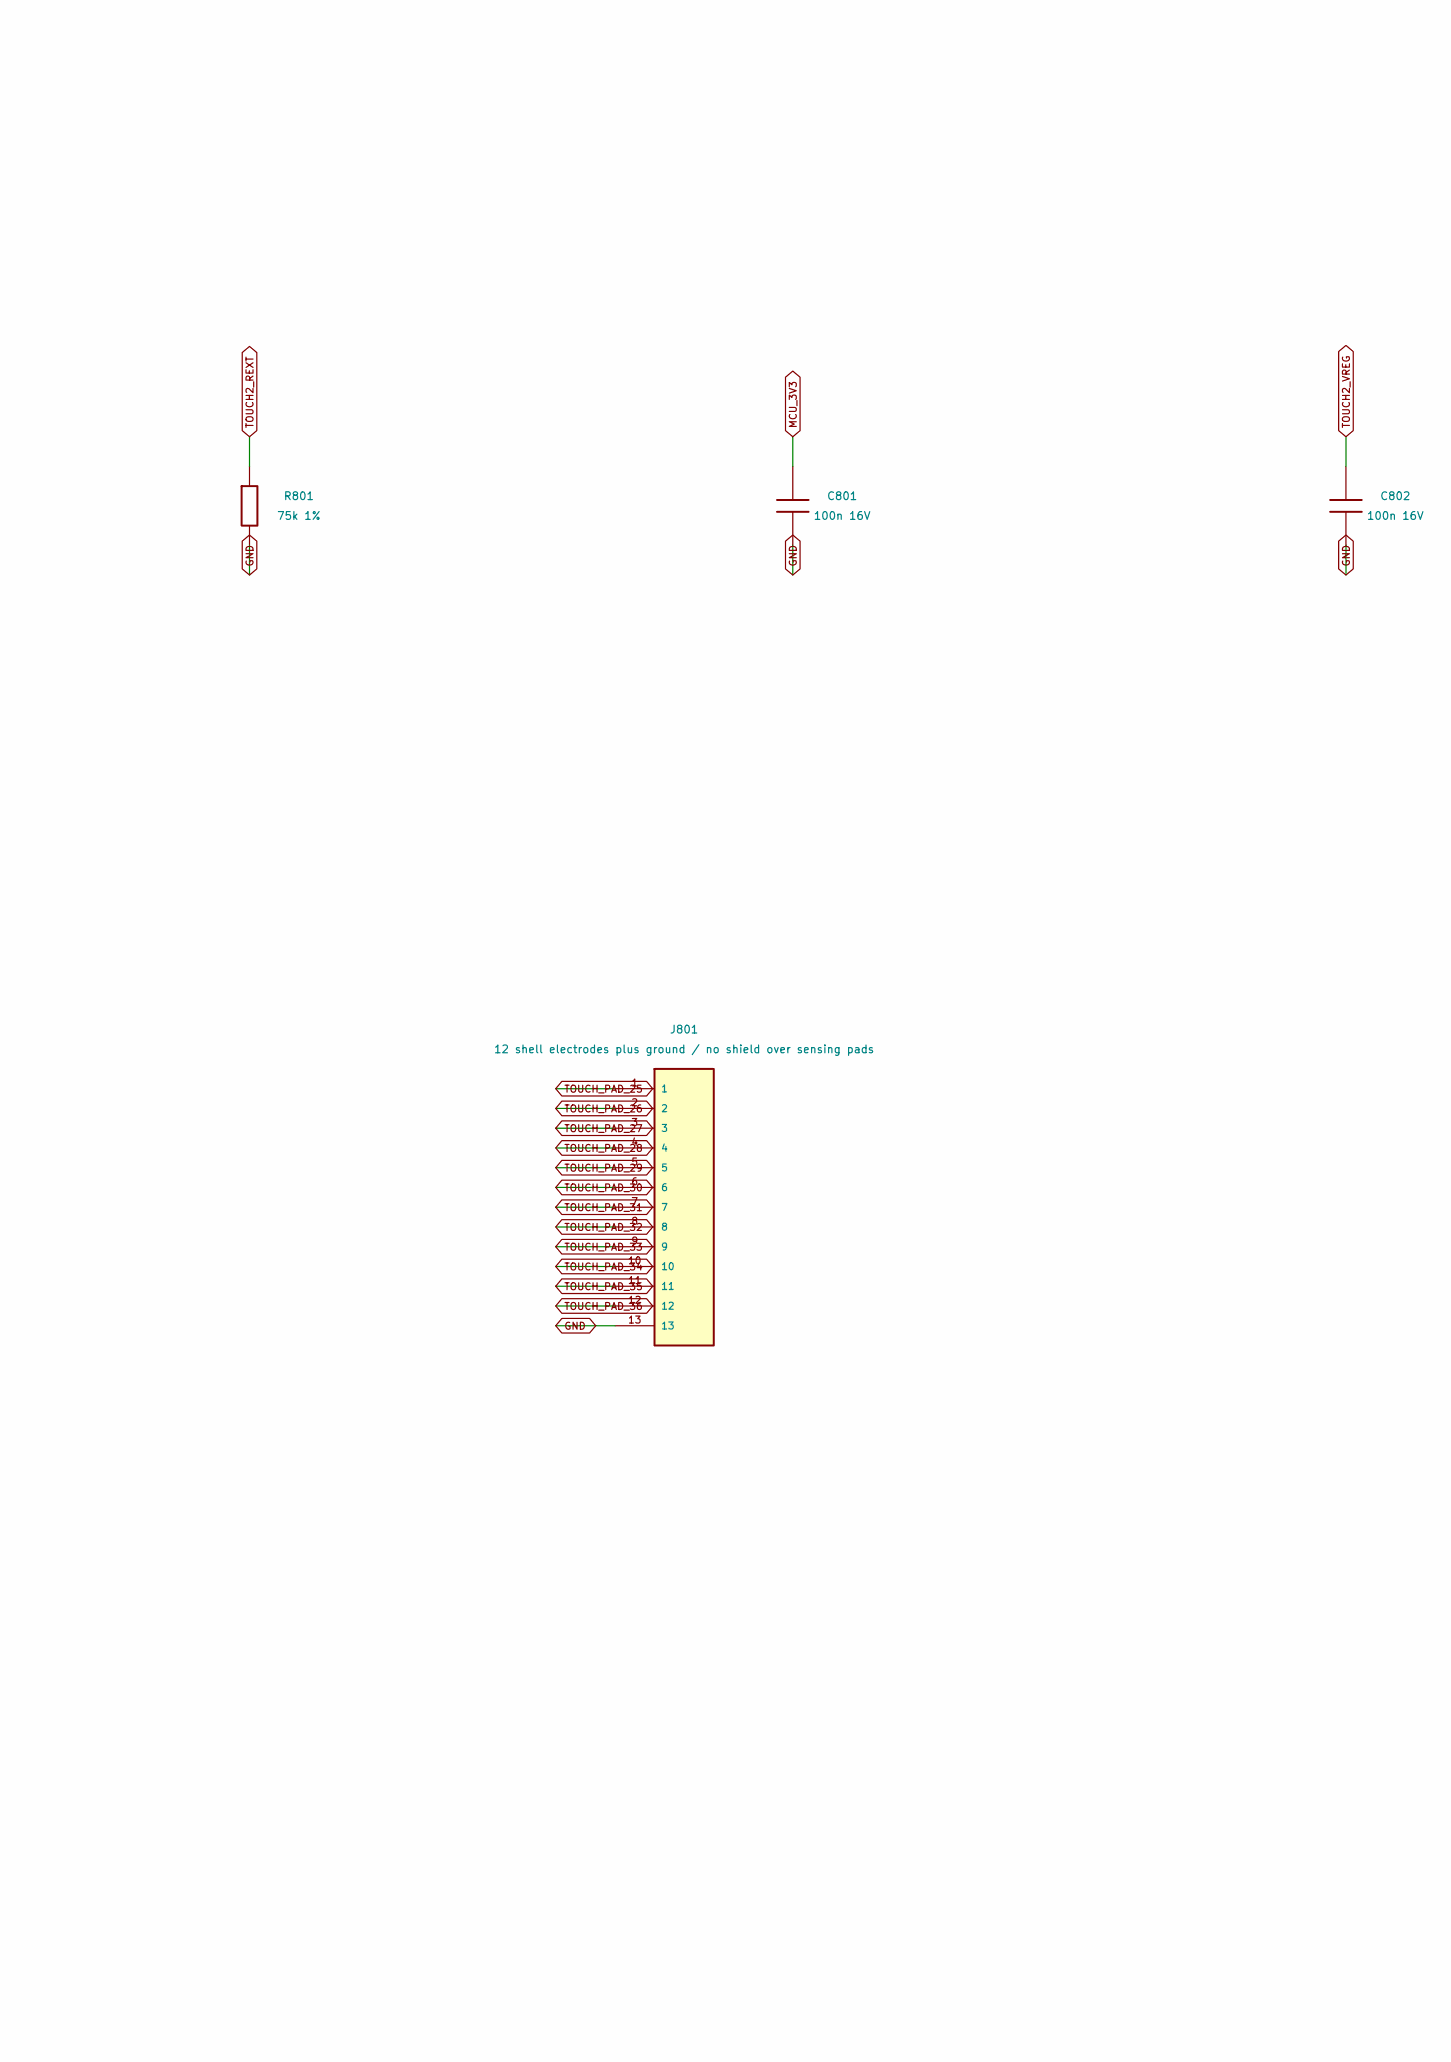
[picture p93: schematic 08-touch-3.kicad_sch, part in row 1, column 2]

Parts:
C801, C802: 100n 16V; C_0603_1608Metric
J801: 12 shell electrodes plus ground / no shield over 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
R801: 75k 1%; R_0603_1608Metric
U801: MPR121QR2 / 0x5c; UQFN-20_3x3mm_P0.4mm; MPN MPR121QR2

Connections:
GND: C801.2, C802.2, J801.13, R801.2, U801.6 (VSS)
HOST_SCL: U801.2 (SCL)
HOST_SDA: U801.3 (SDA), U801.4 (ADDR)
MCU_3V3: C801.1, U801.20 (VDD)
TOUCH2_REXT: R801.1, U801.7 (REXT)
TOUCH2_VREG: C802.1, U801.5 (VREG)
TOUCH_IRQ_N: U801.1 (~IRQ)
TOUCH_PAD_25: J801.1, U801.8 (ELE0)
TOUCH_PAD_26: J801.2, U801.9 (ELE1)
TOUCH_PAD_27: J801.3, U801.10 (ELE2)
TOUCH_PAD_28: J801.4, U801.11 (ELE3)
TOUCH_PAD_29: J801.5, U801.12 (ELE4)
TOUCH_PAD_30: J801.6, U801.13 (ELE5)
TOUCH_PAD_31: J801.7, U801.14 (ELE6)
TOUCH_PAD_32: J801.8, U801.15 (ELE7)
TOUCH_PAD_33: J801.9, U801.16 (ELE8)
TOUCH_PAD_34: J801.10, U801.17 (ELE9)
TOUCH_PAD_35: J801.11, U801.18 (ELE10)
TOUCH_PAD_36: J801.12, U801.19 (ELE11)

Notes on the sheet:
TOUCH / MPR121 address 0x5c; 12 electrodes of 48
75k 1% REXT and independent 100n VREG bypass per NXP datasheet. IRQ outputs share a wired-OR line. Run electrode wires away from motor cables. Pad sizes, shell thickness and wire capacitance need actual-shell tuning. No electrodes or copper over the charging coil, screen or antenna keep-outs.
Electrode-to-body map is defined in BOM-full-robot.md. Final harness labels must name the actual body locations. Parts are procurement candidates; MPR121 lifecycle/assembly availability and alternate sourcing need confirmation.
