iimmyy/Little-Guy/hardware/little-guy-v2/pcb/spinal/09-touch-4.kicad_sch

## KiCad design hardware/little-guy-v2/pcb/spinal/09-touch-4.kicad_sch (2026-11-07)

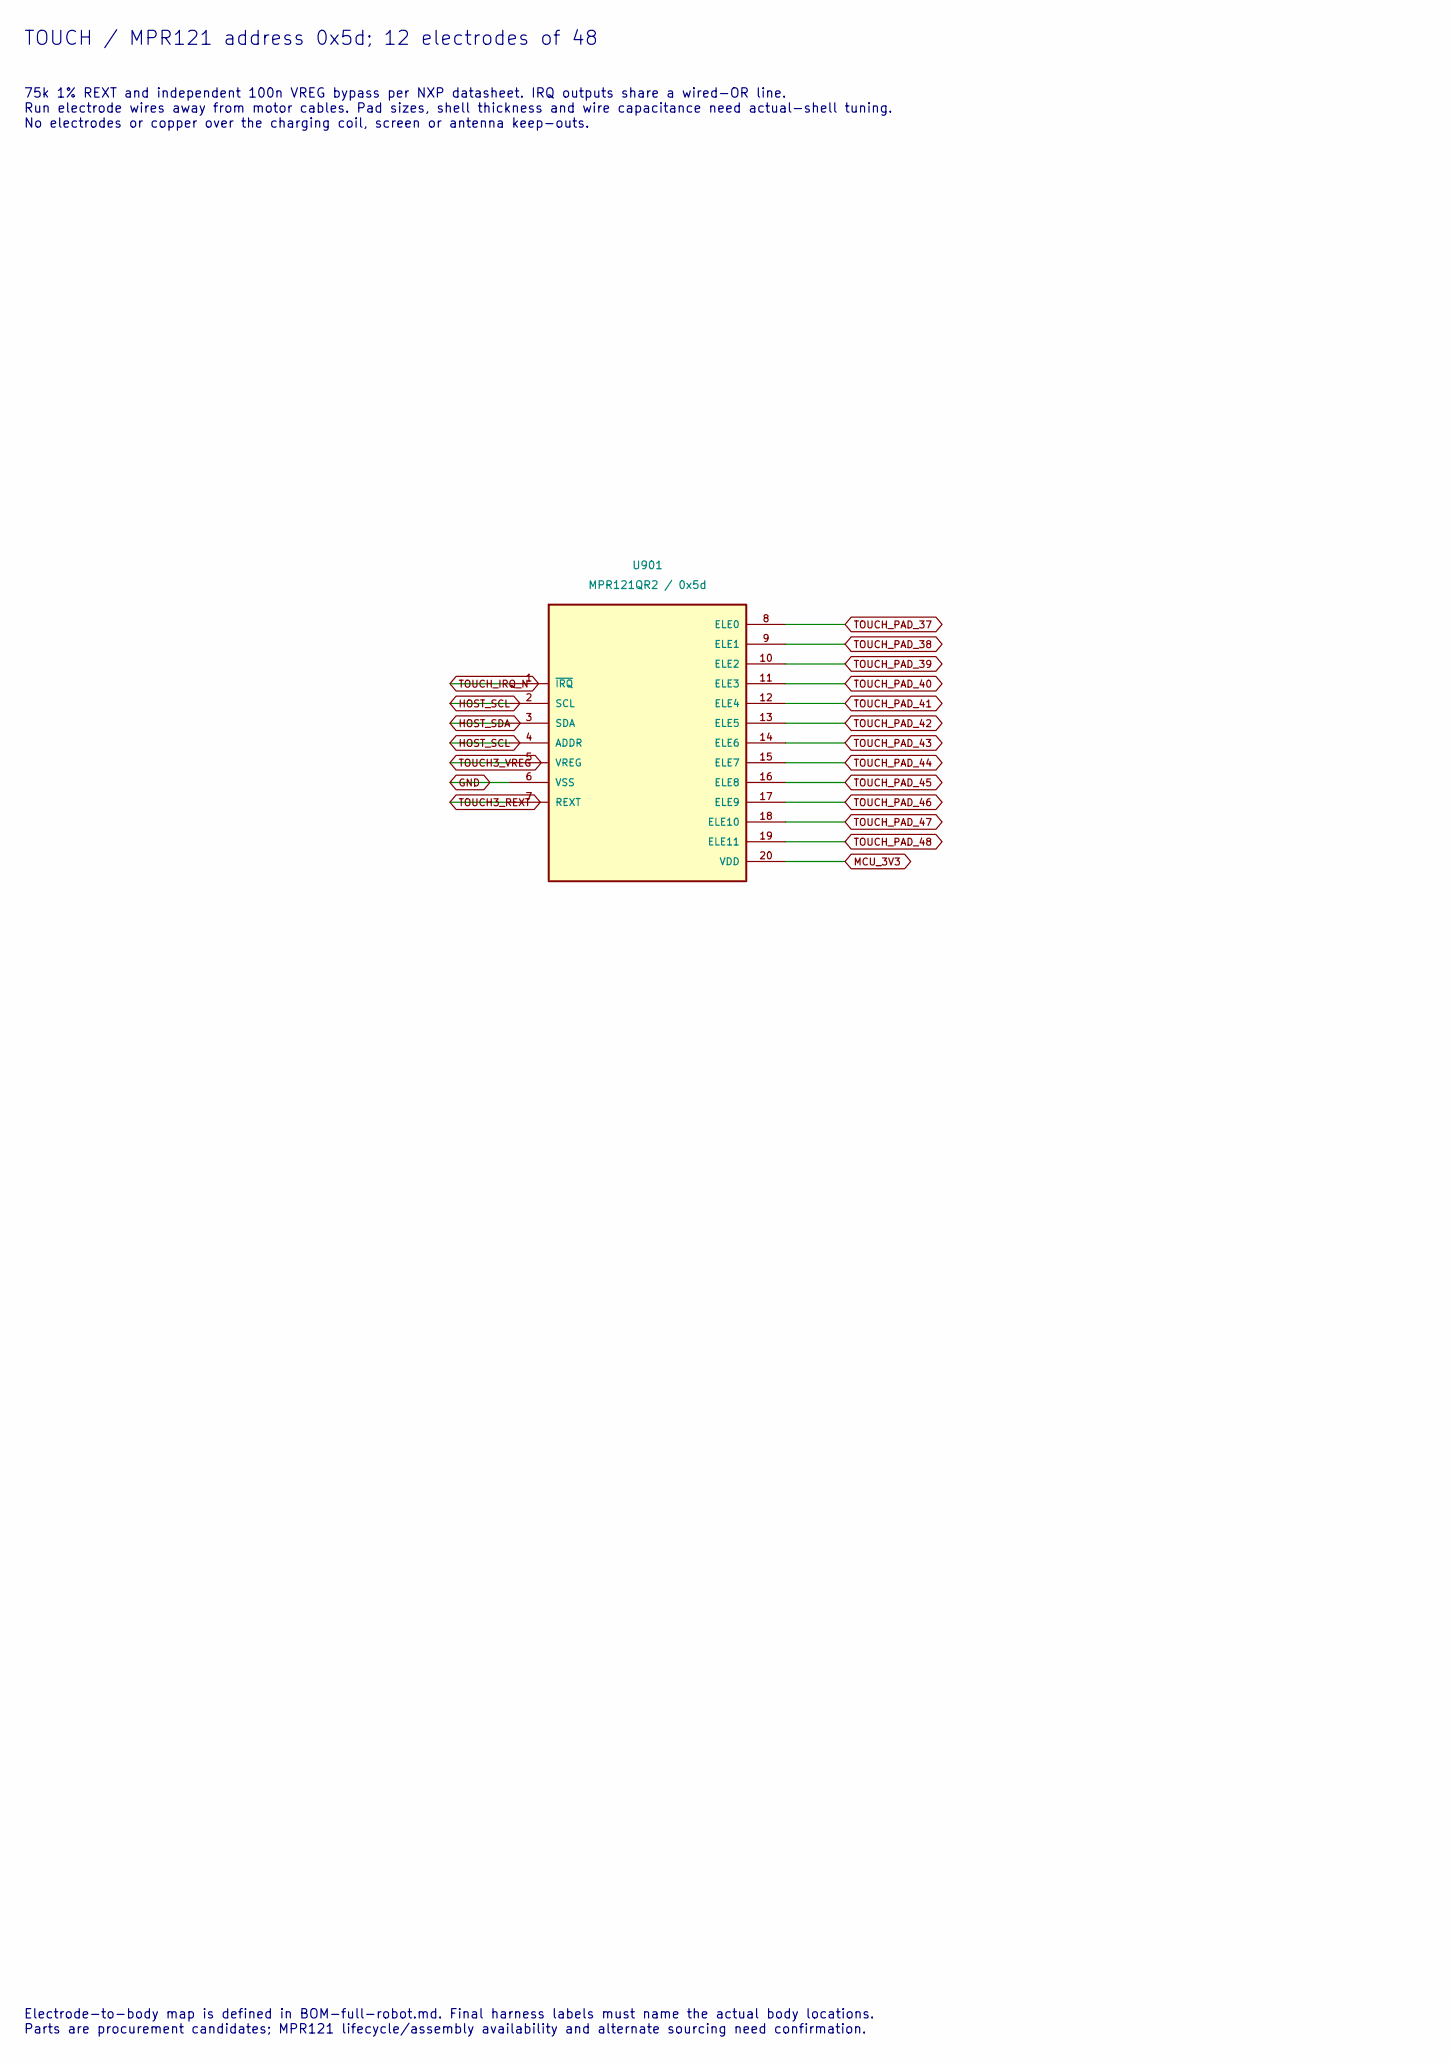
[picture p94: schematic 09-touch-4.kicad_sch, part in row 1, column 1]

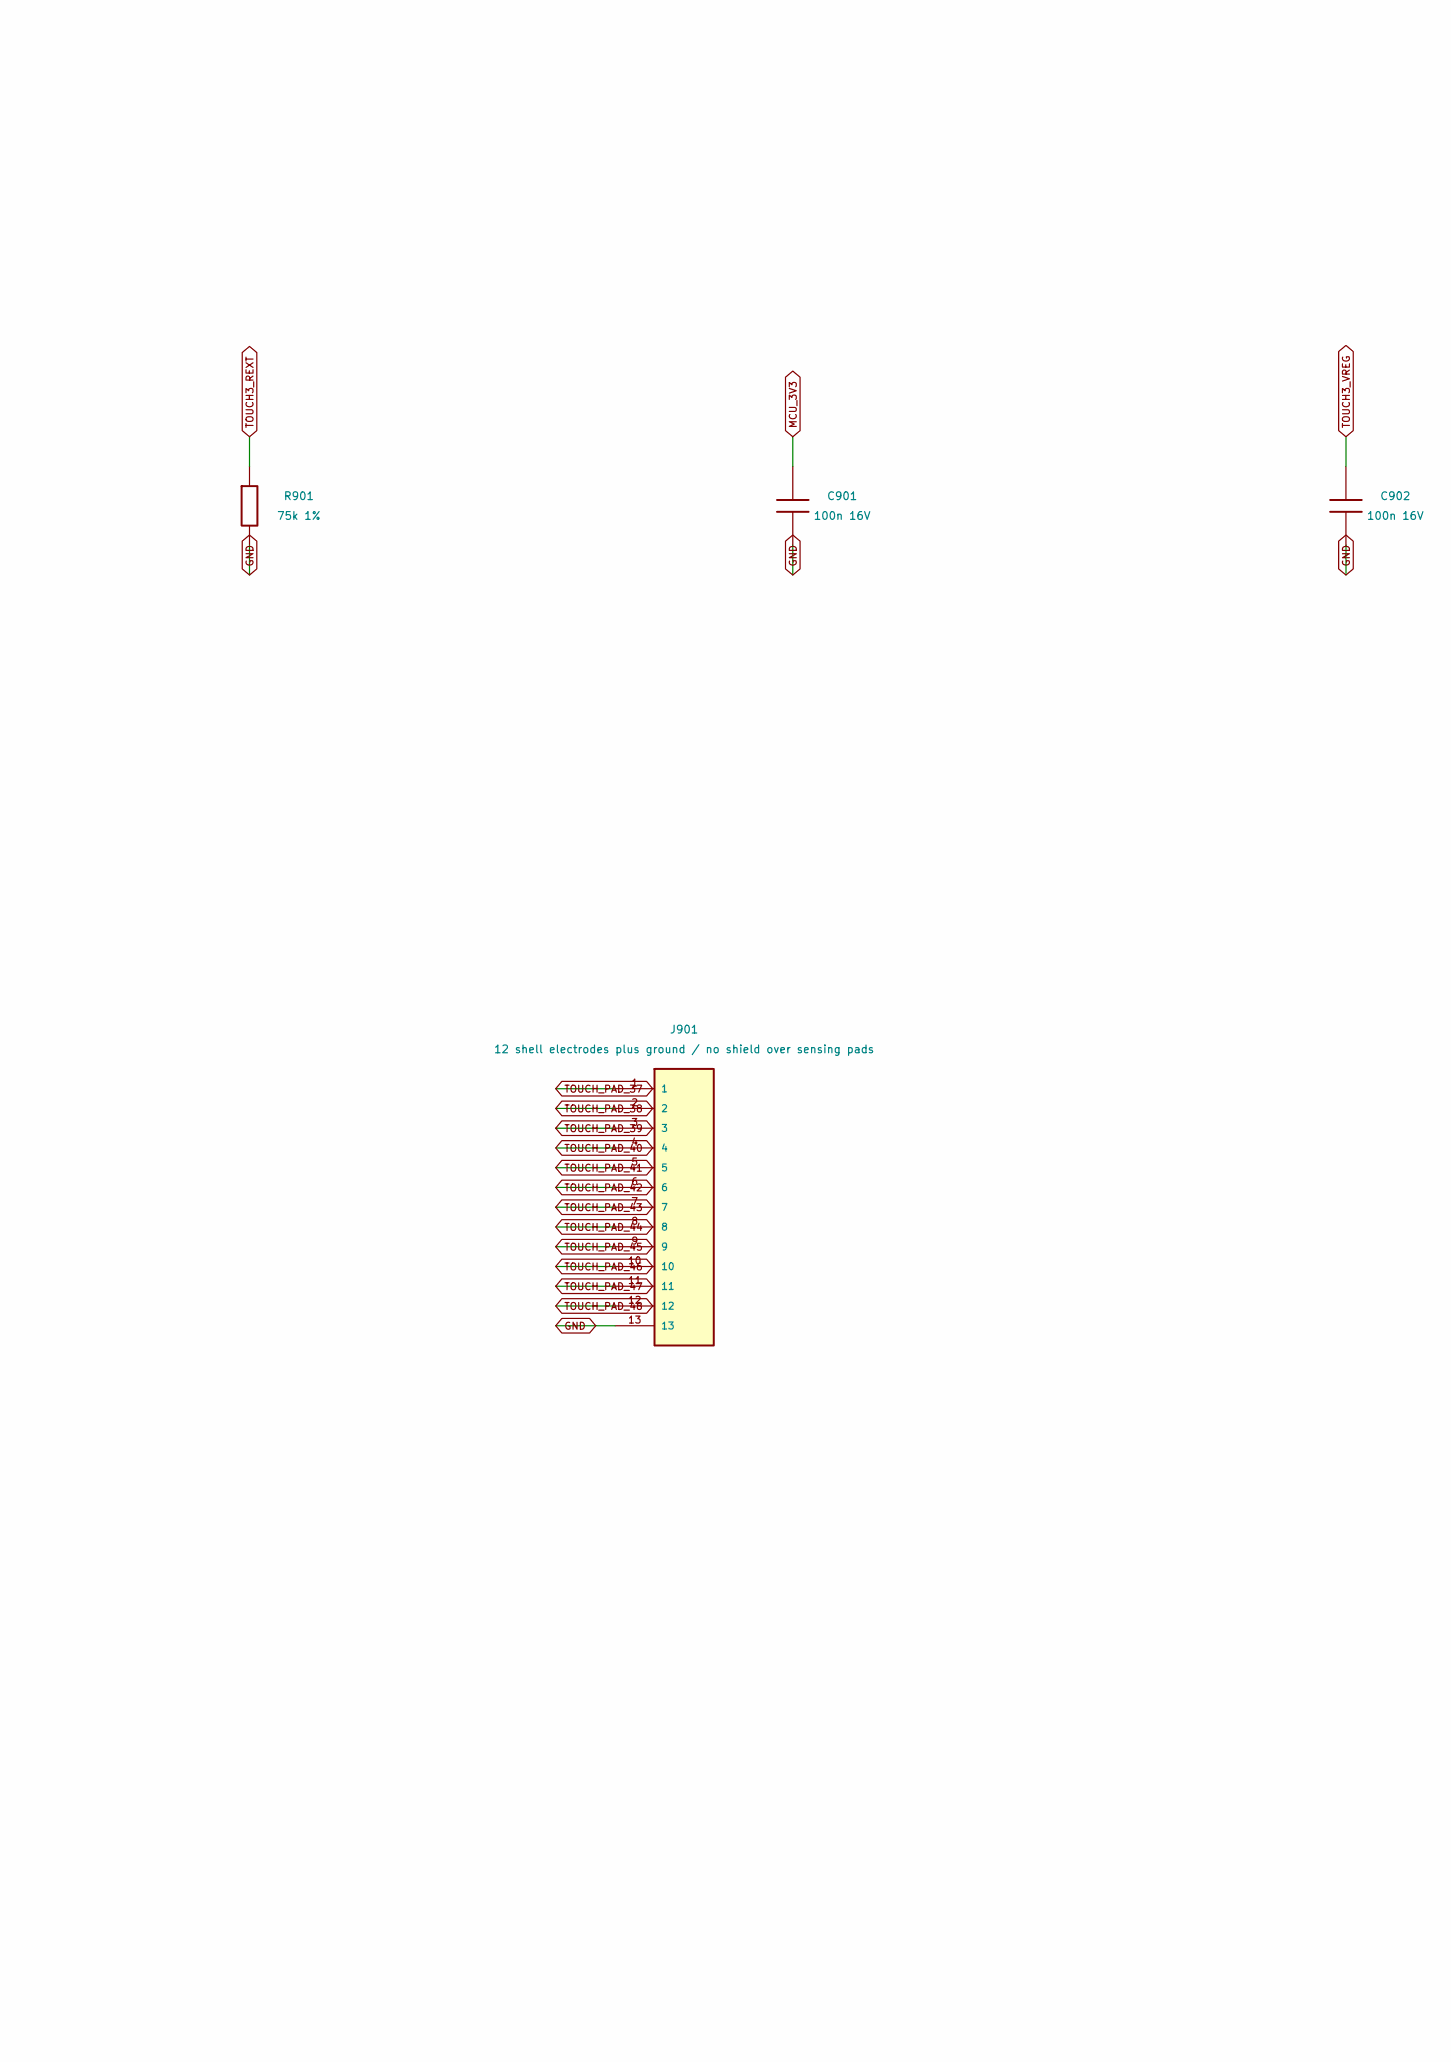
[picture p95: schematic 09-touch-4.kicad_sch, part in row 1, column 2]

Parts:
C901, C902: 100n 16V; C_0603_1608Metric
J901: 12 shell electrodes plus ground / no shield over 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
R901: 75k 1%; R_0603_1608Metric
U901: MPR121QR2 / 0x5d; UQFN-20_3x3mm_P0.4mm; MPN MPR121QR2

Connections:
GND: C901.2, C902.2, J901.13, R901.2, U901.6 (VSS)
HOST_SCL: U901.2 (SCL), U901.4 (ADDR)
HOST_SDA: U901.3 (SDA)
MCU_3V3: C901.1, U901.20 (VDD)
TOUCH3_REXT: R901.1, U901.7 (REXT)
TOUCH3_VREG: C902.1, U901.5 (VREG)
TOUCH_IRQ_N: U901.1 (~IRQ)
TOUCH_PAD_37: J901.1, U901.8 (ELE0)
TOUCH_PAD_38: J901.2, U901.9 (ELE1)
TOUCH_PAD_39: J901.3, U901.10 (ELE2)
TOUCH_PAD_40: J901.4, U901.11 (ELE3)
TOUCH_PAD_41: J901.5, U901.12 (ELE4)
TOUCH_PAD_42: J901.6, U901.13 (ELE5)
TOUCH_PAD_43: J901.7, U901.14 (ELE6)
TOUCH_PAD_44: J901.8, U901.15 (ELE7)
TOUCH_PAD_45: J901.9, U901.16 (ELE8)
TOUCH_PAD_46: J901.10, U901.17 (ELE9)
TOUCH_PAD_47: J901.11, U901.18 (ELE10)
TOUCH_PAD_48: J901.12, U901.19 (ELE11)

Notes on the sheet:
TOUCH / MPR121 address 0x5d; 12 electrodes of 48
75k 1% REXT and independent 100n VREG bypass per NXP datasheet. IRQ outputs share a wired-OR line. Run electrode wires away from motor cables. Pad sizes, shell thickness and wire capacitance need actual-shell tuning. No electrodes or copper over the charging coil, screen or antenna keep-outs.
Electrode-to-body map is defined in BOM-full-robot.md. Final harness labels must name the actual body locations. Parts are procurement candidates; MPR121 lifecycle/assembly availability and alternate sourcing need confirmation.
