iimmyy/Little-Guy/hardware/little-guy-v2/pcb/spinal/10-sensor-pullups.kicad_sch

## KiCad design hardware/little-guy-v2/pcb/spinal/10-sensor-pullups.kicad_sch (2026-11-07)

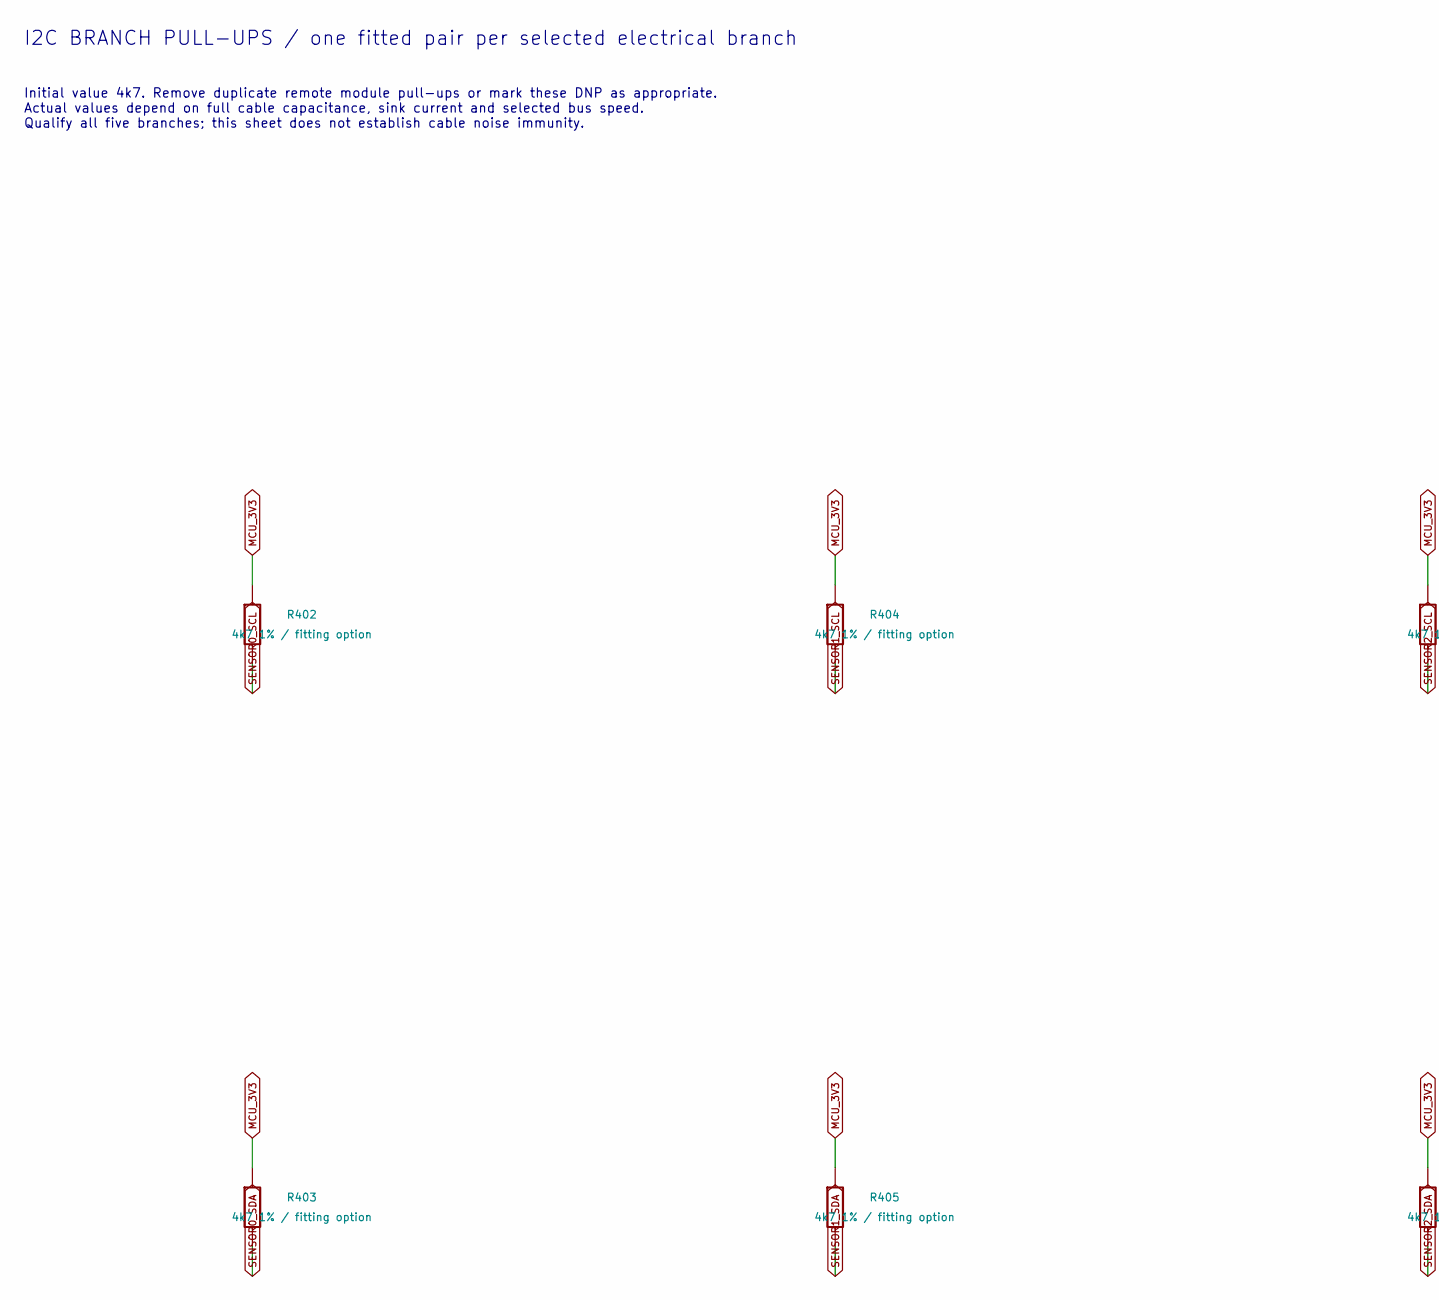
[picture p96: schematic 10-sensor-pullups.kicad_sch, part in row 1, column 1]

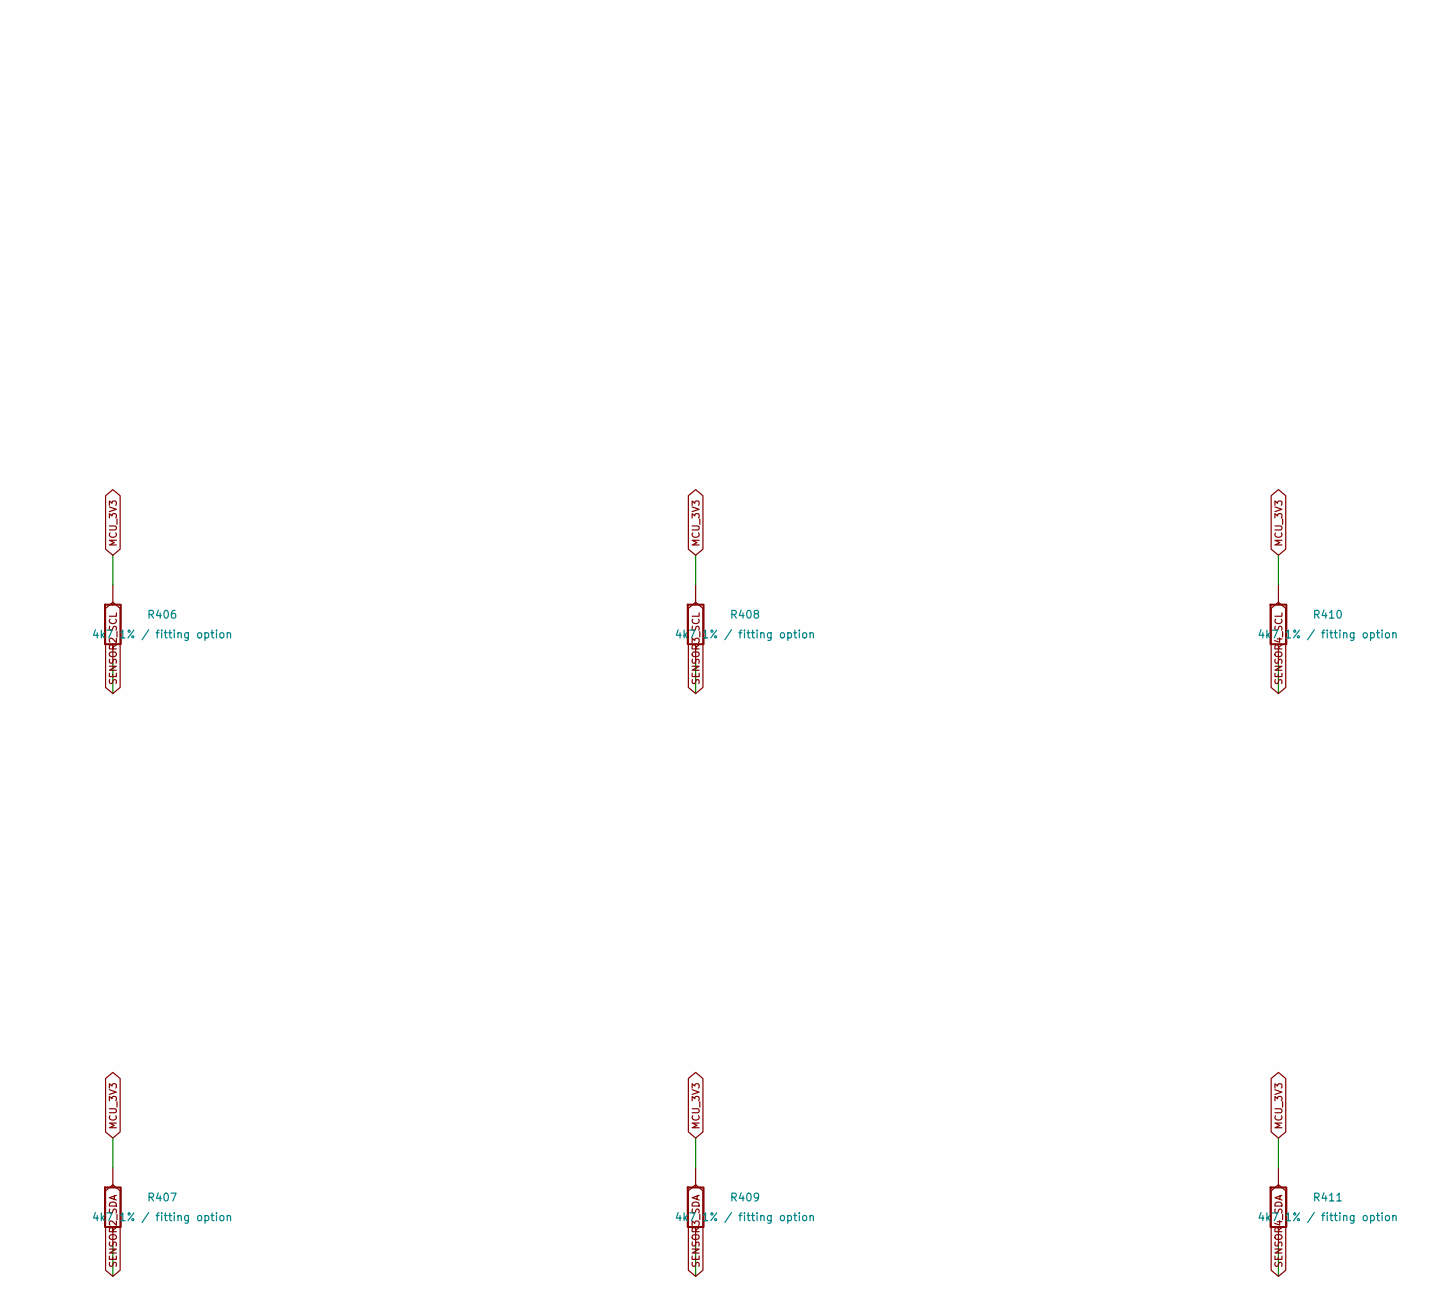
[picture p97: schematic 10-sensor-pullups.kicad_sch, part in row 1, column 2]

Parts:
R402, R403, R404, R405, R406, R407, R408, R409, R410, R411: 4k7 1% / fitting option; R_0603_1608Metric

Connections:
MCU_3V3: R402.1, R403.1, R404.1, R405.1, R406.1, R407.1, R408.1, R409.1, R410.1, R411.1
SENSOR0_SCL: R402.2
SENSOR0_SDA: R403.2
SENSOR1_SCL: R404.2
SENSOR1_SDA: R405.2
SENSOR2_SCL: R406.2
SENSOR2_SDA: R407.2
SENSOR3_SCL: R408.2
SENSOR3_SDA: R409.2
SENSOR4_SCL: R410.2
SENSOR4_SDA: R411.2

Notes on the sheet:
I2C BRANCH PULL-UPS / one fitted pair per selected electrical branch
Initial value 4k7. Remove duplicate remote module pull-ups or mark these DNP as appropriate. Actual values depend on full cable capacitance, sink current and selected bus speed. Qualify all five branches; this sheet does not establish cable noise immunity.
