iimmyy/Little-Guy/hardware/little-guy-v2/pcb/spinal/11-transmit-cut.kicad_sch

## KiCad design hardware/little-guy-v2/pcb/spinal/11-transmit-cut.kicad_sch (2026-11-07)

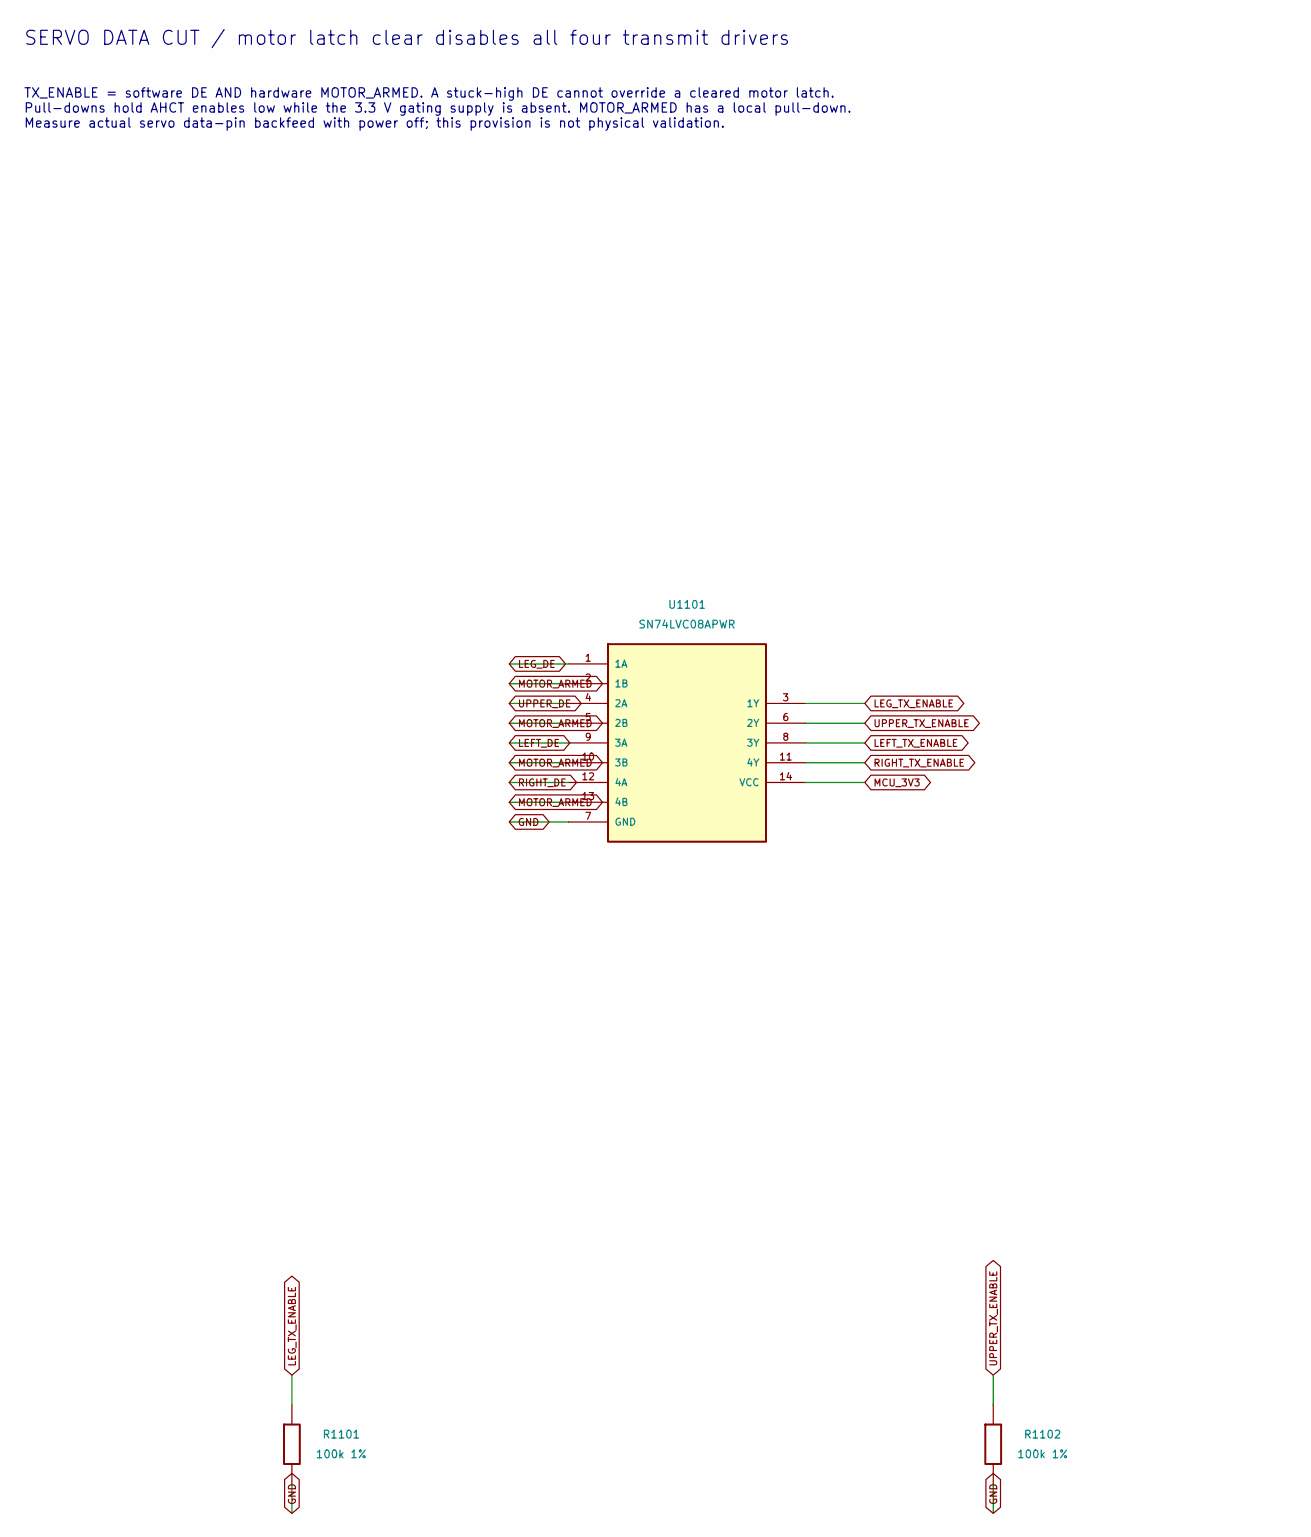
[picture p98: schematic 11-transmit-cut.kicad_sch, part in row 1, column 1]

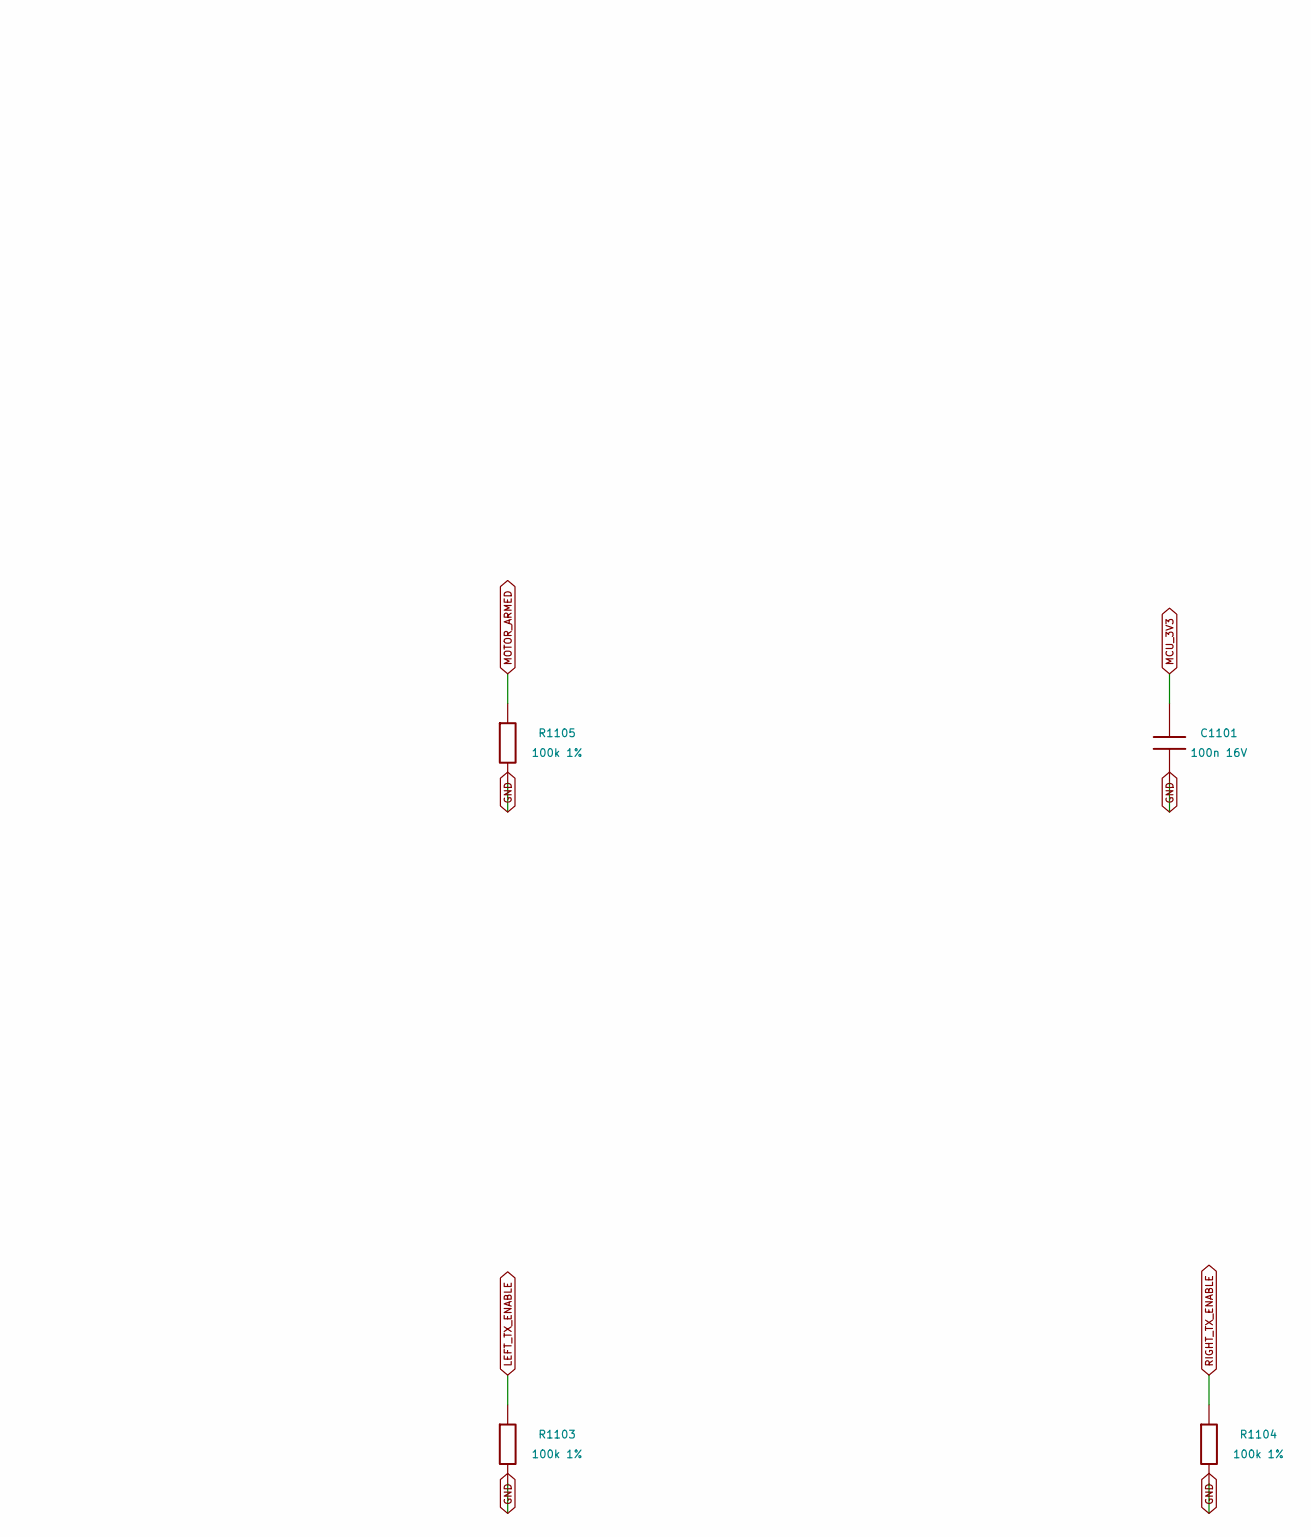
[picture p99: schematic 11-transmit-cut.kicad_sch, part in row 1, column 2]

Parts:
C1101: 100n 16V; C_0603_1608Metric
R1101, R1102, R1103, R1104, R1105: 100k 1%; R_0603_1608Metric
U1101: SN74LVC08APWR; TSSOP-14_4.4x5mm_P0.65mm; MPN SN74LVC08APWR

Connections:
GND: C1101.2, R1101.2, R1102.2, R1103.2, R1104.2, R1105.2, U1101.7 (GND)
LEFT_DE: U1101.9 (3A)
LEFT_TX_ENABLE: R1103.1, U1101.8 (3Y)
LEG_DE: U1101.1 (1A)
LEG_TX_ENABLE: R1101.1, U1101.3 (1Y)
MCU_3V3: C1101.1, U1101.14 (VCC)
MOTOR_ARMED: R1105.1, U1101.2 (1B), U1101.5 (2B), U1101.10 (3B), U1101.13 (4B)
RIGHT_DE: U1101.12 (4A)
RIGHT_TX_ENABLE: R1104.1, U1101.11 (4Y)
UPPER_DE: U1101.4 (2A)
UPPER_TX_ENABLE: R1102.1, U1101.6 (2Y)

Notes on the sheet:
SERVO DATA CUT / motor latch clear disables all four transmit drivers
TX_ENABLE = software DE AND hardware MOTOR_ARMED. A stuck-high DE cannot override a cleared motor latch. Pull-downs hold AHCT enables low while the 3.3 V gating supply is absent. MOTOR_ARMED has a local pull-down. Measure actual servo data-pin backfeed with power off; this provision is not physical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
