iimmyy/Little-Guy/(commit log)

2026-09-24 Record Q6A latency probes and NPU validation gate
2026-09-29 Move Little Guy's Q6A to Linux, run the NPU, and fix the UFS boot
    Switch the Q6A from Android to Ubuntu 24.04: back up the SPI chip over
    EDL, flash Radxa's Linux BIOS, and boot from USB. Run Radxa's Llama 3.2 1B
    on the Hexagon v68 NPU (~400 tok/s prefill, 9-10 tok/s decode) and turn
    off the idle suspend that kept "killing" the headless board.
    Trace why the board wouldn't boot from UFS: the firmware's own boot log
    showed "UFS GPIO7 value is 1 / Skipping UFS initialization". A GPIO
    snapshot diff, the board and module schematics, and a close look at the
    module led to R9, the 0 ohm UFS_DET strap, knocked off the module. With
    R9 back on its pads the firmware finds the Samsung UFS at Gear 4 and t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
2026-10-07 Add the board's thermal guard
    Steps the CPU and GPU clocks down before the fanless Q6A gets hot enough to shut off.
2026-10-07 Measure speculative drafting lengths on the Mac and the board
2026-10-07 Test thinking on and off, and temperature, on the board
2026-10-07 Add staged power tests to read off the USB meter
2026-10-09 Time 2-bit against 4-bit on the board, trays on and off
2026-10-09 Add the board's live status page and first-word stats feed
2026-10-09 Add the menu bar app and the live-run wrapper
    A dot and temperature in the menu bar, a mini console of the board, bubbles when runs start or finish, and a tab showing what Claude is running.
2026-10-09 Generate chat-style calibration text for 2-bit packing
2026-10-09 Add the 20-sample behavior test and a rescorer
    Each question 20 times per brain at talking temperature, scored on warning first, dodging, hedging, invented memories, filler and opening words.
2026-10-09 Add a fix for Gemma's BF16 projection slowing prefill on the Q6A
    The board's cores have no BF16 instructions; storing per_layer_model_proj as F16, like Google's file, restores reading speed (26.8 to 34.1 tok/s).
2026-10-09 Make the tools portable: shared paths, settings file, public persona example
    Scripts now find the repo root themselves instead of using /Users paths, machine settings (board ssh host, status URL) come from littleguy.env with littleguy.env.example as the template, and the menu bar app bakes them in at build time. Big files stay in the ignored .run/.
2026-10-09 Menu bar: set the data lines in Palatino to match the headings
    The vitals line, busiest-programs row, chart legend, bubbles and notes used
    the system font and looked flat next to the serif titles. Percentages get a
    fixed slot because Palatino's digits vary in width, and program names get
    layout priority so they stop truncating.
2026-10-09 Add a per-layer insert meter and a cumulative bypass test
    layer_meter.py reads how loud each layer's attention, FFN and PLE are
    relative to the signal coming in. layer_bypass.py switches off the tail
    inserts one layer at a time, three ways. On 4 unseen chats: late attention
    (layers 34-39) bypasses for +0.0%, tail FFNs add up steadily (+36% by six
    layers), and bypassing both inserts in layers 37-39 scores -3.7%, a sign the
    two partly cancel each other there. Past layer 36 the damage compounds.
2026-10-09 Add shared behavior checks and a 20-sample test for layer bypasses
    scoring.py holds the corrected checks (careful counts as a warning, I don't
    know doesn't) so every test uses one ruler. bypass_behavior.py samples 20
    answers per question at talking temperature with and without layers 37-39.
    Removing them drops Dayvigo warns-first from 19/20 to 12/20, keeps the dog
    answer at 20/20, and cuts invented days (6 to 1) and Hm (6 to 1), so those
    layers both sharpen warnings and add flourish.
2026-10-09 Add a board test of the drafter on his current brains
    Runs each brain with no drafter and with the masked drafter guessing three
    words ahead. On the board: the 4-bit goes from 5.7 to 11.4 tok/s at temp 0
    (2.0x) and 8.7 at his talking temperature; the 2-bit goes from 6.8 to 10.8
    and 9.0. Verifying drafts is a small batch, so the 2-bit's slower reading
    kernel limits how much it gains.
2026-10-09 Add a station bench: where the 2-bit brain loses reading time
    Times one E4B layer per brain on one board core, split into trays and the
    input packing, at batch 4 (drafter checks) and 64 (reading). Reading: our
    q2_K oven is within 3% of q4_0, but the q4_K VIP layers are 26% slower and
    q8_K packing is 7x slower. Batch 4: the q2_K oven is 50% slower, since its
    per-block decode is shared across too few words.
2026-10-10 Add an NPU reading test: CPU alone vs NPU doing 10, 21 and 42 layers
    Only matrix multiplications go to the NPU. On the board, with no throttling:
    CPU alone reads 38 tok/s, and the NPU path drops it to 22, 14.5 and 8.8 as it
    takes more layers. llama.cpp only enables the NPU's matrix engine (HMX) on v73
    and newer; the board's v68 runs the vector unit only.
2026-10-10 Add an NPU probe for one real E4B FFN layer through QAIRT
    ffn_probe.py exports layer 10's gate/up/down weights and calibration inputs
    and builds the FFN as ONNX; npu_variants.py builds reduced versions to find
    what the QAIRT compiler accepts. On the v68 NPU with 8-bit weights and a
    2 MB VTCM cap: the full gate x up -> down chain at 64 words runs in 19 ms of
    accelerator time (about 27 ms on the four CPU cores at 4-bit). Batches of
    128 crash the compiler at 2 MB, and the GELU chain as written also crashes.
2026-10-10 Add a quiet mode to the board's thermal guard for fanless nights
    While /var/lib/littleguy/quiet exists, the guard turns the status lights off
    and holds every clock under a ceiling (about 1.2-1.4 GHz on the CPU clusters,
    300 MHz GPU) on top of its heat steps, so overnight jobs run cool without a
    fan. board/quiet-mode on|off|status flips the flag, which survives reboots.
2026-10-10 Add a Full power / Quiet switch to the menu bar app
    The board's status page now reports whether quiet mode is on, and the panel
    shows a two-way switch in the same serif tab style. Tapping it runs
    quiet-mode on/off over ssh without a confirm dialog, since it's harmless and
    undoable.
2026-10-10 Add first NPU (HVX) programs: hello and a 2-bit gemv benchmark
    Runs on the cDSP through Qualcomm's run_main_on_hexagon; results come back
    through a file, the one output route that reaches the board. The 2-bit gemv
    unpacks four weights per byte with shifts and masks and uses HVX's 8-bit
    dot product. It matches plain math, but one thread with a per-row sum takes
    9.9 ms for a 2560x10240 matrix versus ~0.5 ms for the CPU's 2-bit oven.
2026-10-10 NPU 2-bit gemv versions 2-4: row-parallel layout, four tallies, prefetch
    v2 packs 32 output rows side by side per vector (vrmpy against four inputs
    in one register) so no per-row sums: 9.9 -> 4.8 ms on one HVX thread, 2.4 ms
    on two. v3 splits the accumulator four ways: 2.1 ms. v4 adds l2fetch of the
    next row group, since HVX has no hardware prefetch: 0.52 ms on one thread,
    0.39 ms on two (6.6 MB at ~17 GB/s, near the memory limit). Answers match a
    plain C reference. A third and fourth HVX thread add nothing.
2026-10-10 NPU 2-bit gemv with real Q2_K-style scales (v5), and a prefetch-depth check (v6)
    v5 adds each 16-weight pouch's 4-bit scale and min (packed one byte per row
    per pouch, 32 rows per vector) and writes per-super-block integer totals
    S = sum(scale * sum(q*x)) and M = sum(min * sum(x)) for the float combine.
    Exact on 1,060 checked row super-blocks; 0.61 ms on two HVX threads for
    8.2 MB (13.4 GB/s), close to the CPU's ~0.53 ms estimate for the same
    matrix. v6 prefetches two groups ahead: 0.65 ms, no gain, so the scale math
    rather than memory is now the limit.
2026-10-10 Add the both-drivers test: CPU and NPU hauling at the same time
    gemv2_loop.so loops the v5 2-bit NPU gemv and logs GB/s every 2 s;
    both_drivers.sh times it alone, the CPU's 2-bit brain writing alone, then
    both together. Full clocks, no fan: NPU alone 14.2 GB/s, CPU alone 7.07
    tok/s (~14.6 GB/s); together NPU ~8.0 GB/s and CPU 4.23 tok/s (~8.7 GB/s),
    about 16.7 GB/s in total. They share the memory controller, so splitting
    the talking between them gains ~15%, but the NPU alone talks at about the
    CPU's speed, which would free the CPU for speech and memory work.
2026-10-10 NPU DMA path, DMA probe and bandwidth vote: the memory ceiling is ~18 GB/s total
    gemv2_dma.c streams weights into VTCM with the DMA engine (source bypassing
    L2), double-buffered: exact answers, best 1.13 ms with 4 groups per copy on
    one thread. dma_probe.c pinned down the earlier crash: VTCM acquired in
    cache mode is only reserved until acquire_cached, so use cache mode 0.
    gemv2_loop.c gains an optional bus-bandwidth vote (-DBW_VOTE=GB/s).
    Next to 4-thread CPU streaming, the DMA version keeps ~3.2 GB/s (total
    ~17.7) and the cache version with a 20 GB/s vote keeps 10.5 GB/s while the
    CPU drops to 7.8 (total ~18.3): votes move priority, not the ceiling. The
    earlier ~28-30 GB/s figure came fro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
2026-10-10 Add the waveform-matching test: lookup guesses from his own phrases
    On 80 saved chats (6,196 of his words): matching only the current chat gives 1.08 words per bounce; a sample pack of his replies in other chats gives 1.30-1.33; both together 1.32-1.36, helping about one bounce in five.
2026-10-10 Add the pair and bracket meters: do his FFN detectors take turns or cluster?
    Learned on 40 chats (2,012 words), tested on 10 unseen (414 words). Only 9.1% of regular detectors have a clean opposite partner, so a pair table mutes under 1% of lanes. Grouping detectors into 64 folders by when they play: covering 95% of a word's FFN sound streams 73% of lanes (random folders 82%), while perfectly chosen single lanes need only 22%.
2026-10-11 Add the board head-to-head: both brains, same setup, speed, heat and behavior
    Full power (fan on): 4-bit 5.12 words/s talking, 33.4 reading; 2-bit 6.24 and 29.4, but the heat guard slowed both runs. Clocks locked with quiet mode: 4-bit 4.93 / 19.1, 2-bit 5.30 / 17.4, average 48.3 vs 47.8 C, no slowdowns. Same seeds give identical replies at both clock settings, and the 2-bit brain says 57% more words (28.2 vs 18 per reply), which is why its run ran longer and hotter.
2026-10-11 Add a persona A/B on both brains, run on the Mac CPU like the board
    First use, the outro persona (pro-check folded into the answer, 'make your point once, then stop'), 20 replies per question: 2-bit words per reply 29.2 -> 26.2 and outros 15 -> 9 of 80, but Dayvigo warns-first 17 -> 12 of 20; 4-bit barely changes (18.0 -> 18.5 words, warns-first 19 -> 17). The 2-bit brain invents its day 14/20 with either persona (4-bit 5 and 2).
2026-10-11 Add the distortion meter: default vs careful 2-bit compressor on his master's weights
    Careful lands 1.2-1.4 dB closer on every sampled tensor (average -10.4 dB -> -11.8 dB, about 26% less error energy), across layers 0, 20 and 41, FFN, attention and the dictionary.
2026-10-11 Behavior test: compare any set of brains on the current persona
    AB_BRAINS picks the brains and '-' skips persona B. Clean 2-bit C (careful Q2_K gate/up/q/k, Q4_0 down/output/v/gates, Q6_K dictionary and lookup, F16 proj, no importance map): 21.2 words per reply (4-bit 18.0, old 2-bit 29.2), outros 7/80 (1, 15), invented days 0/20 (5, 14), dog firm no 20/20, Dayvigo warns-first 10/20 with 7 opening on 'check with a doctor' (19, 17). All-2-bit brains A and B were broken (gibberish with the default compressor, fluent but wrong with the careful one).
2026-10-11 Add the few-word oven bench, the fused-recipe check and the old-vs-new oven test
    batch_bench.c times 4 words through the tray and one-word recipes per oven; fused_check.py compares the fused and template recipes with the generic reference; oven_ab.sh runs the whole brain greedily with the old and new libraries and compares the text.
2026-10-11 Add the Azure setup script, stage 1: thirteen services for Little Guy's workspace
    Dry run by default (GO=1 creates). One resource group; secrets are generated into Key Vault and shown as *** in every printed command; the compile VM (D4as_v4, this subscription is not offered the B-series) only accepts SSH from this Mac and shuts down nightly; the ledger database only accepts this Mac's IP and lives in centralus (eastus refuses PostgreSQL here); the budget goes through the REST API.
2026-10-11 Board race: time per answer, the new oven, clean brains, and cooling to a CPU target
    Runs start once the menu bar app's CPU temperature is at or below COOL_TO (24 C) instead of fixed waits. Full power, fan on, drafter n-max 3, temperature 0.8, 10 per question, new oven: 4-bit 6.43 s per answer (6.29 tok/s, 17.7 words, peak 78 C); C 7.38 s (6.25, 21.8, 84 C); C2 7.81 s (6.07, 22.9, 81 C); D 7.91 s (6.02, 24.2, 82 C). Every brain keeps 25-27% of the drafter's guesses. With the drafter, 2-bit has no per-word edge, so answer length decides.
2026-10-11 Headless mode for the board, and a status page that rests when nobody is watching
    The display port's hot-plug interrupt fired about 50,000 times a second on core 0 with nothing plugged in
    (kernel 7.0), so eight-thread runs stalled waiting on that core. board/headless keeps the display from binding
    (the GPU gets its own device), and switches off Bluetooth, sound, the file indexer, automatic updates and the
    other desktop leftovers. sudo headless off undoes all of it.
    The status page walked every process twice a second; now once, and only while someone is asking.
2026-10-11 Board race: OVEN=gpu runs brain and drafter on the GPU through Vulkan
2026-10-11 Send skip on brain C: how much of the FFN send is silent per word, and what skipping it costs
    Swaps brain C's own 2-bit and 4-bit layer values into the master (each checked against it) and mutes every
    detector more than N dB below the loudest for that word. On 4 unseen chats: -50 dB skips 34% of the send for
    +1.8% perplexity, -45 dB 46% for +3.1%, -40 dB 60% for +5.4%; layers 0-6 are ~85% silent, the middle ~30%.
    At -45 dB the 20-sample behavior checks match the full brain (Dayvigo warns first 13/20 both, dog firm no 18/20).
    The 5.6 GB per-layer table is read from the file a row at a time, keeping generation out of swap on a 24 GB Mac.
2026-10-12 Azure stage 2: the nightly autopilot (compile VM check-up, brain tests, AI judge)
    lg-wake (Container Apps job, 00:30 UTC) starts the compile VM; its boot service builds the engine snapshot on x86,
    runs the CPU op tests (16,074 passing on the first night), builds a portable x86 server and the board's aarch64
    CPU oven, and stores them; auto-shutdown ends the night at 07:00 UTC. lg-tests (02:00 UTC, 4 vCPU) runs the four
    behavior questions on each brain in turn and has gpt-4.1 grade every reply (judge.py: question and reply only).
    Every job signs in with its own managed identity. tools/azure/push_source.sh sends the engine, tests and persona;
    LITTLEGUY_RUN and LITTLEGUY_SERVER let the tests run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
2026-10-12 Nightly tests: 120 replies per question, unpack with Python (the CLI image has no tar), one log stream
    The first cloud run tested brain C in 15 minutes (Dayvigo warns first 26/40, dog firm no 40/40, invents 0/40);
    120 replies per question tightens the comparison between brains.
2026-10-12 Send skip: board read curve, bookmarks, and a per-layer gate tuned for board speed
    Board (send_skip_bench.c, real size, 4 fast cores): reading only the open detectors' rows scattered takes 86% of
    a full read at -45 dB, bookmarks 2 rows ahead 78%; a smooth sweep of the same rows takes 51%. By silent share,
    the scattered read takes 94% of full time at 30% silent, 82% at 50%, 61% at 70%, 40% at 85%, 15% at 95%, so
    skipping pays in quiet layers only.
    send_skip.py greedy tunes one gate per block of 6 layers on the real combination (per-block costs don't add up:
    a planner trusting them landed at +16%). Chosen: -35 -50 -40 -50 -45 -30 -35 dB; on 8 unseen chats it saves an
    estimated 34.7% of the bo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
2026-10-12 Skip kernel with real arithmetic: wins above ~53% silent, 8x faster at 95%
    tests/oven/send_skip_kernel.c stores the send detector by detector (scales first, then 4-bit values) and mixes
    the open detectors in 8 at a time: their contributions share one int8 grid per block (vector math over all 80
    blocks), the grids are transposed to [block][detector], packed rows are interleaved before unpacking, and the
    dot-product instruction does the mixing; the -8 offset comes off once per block. Matches an exact float
    reference to -47.7 dB. On the board against the oven's Q4_0 gemv: every detector open 195%, then by silent share
    50% 106%, 60% 89%, 70% 69%, 80% 48%, 85% 36%, 90% 25%, 95% 13%, 98% 6%. send_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
2026-10-12 Azure ML: nightly per-layer gate search on public text (03:00 UTC, E8ds_v4, scales to zero)
    tools/azure/ml_deploy.sh stages only the search code (no weights, persona or conversations), registers
    identity-based datastores for the masters, brains and results containers, the CPU environment, and a schedule
    for a one-step pipeline (schedules don't take plain command jobs). The job tunes on WikiText-2 test (public);
    his chats stay on the Mac. send_skip.py: SEND_SKIP_MASTER/BRAIN/TEXT/OUT for running off the Mac, and greedy
    moves may jump several notches (a block saves nothing until it beats today's recipe, ~53% silent).
2026-10-12 Gate search: perplexity misses the warn-first break; add a calibrated warn probe
    Both fastest per-layer gates (38% and 36% of the board send saved for under 4% perplexity) cut Dayvigo warn-first
    from 28/40 to 18/40 and 12/40 on two seeds, while dog firm-no stayed 40/40. send_skip.py probe scores an
    importance-weighted warn-first rate from the full brain's own 40 openings: it ranks the two bad gates low
    (21.0, 20.3 against 28.0) but misreads the first greedy gate (36.2 against a real 24), so it is too noisy to steer
    the search yet. The ML job's log now streams line by line.
2026-10-12 Bio: nightly Batch reproduction of the Aeviant public full-genome benchmark
    An autoscaling E4_v3 pool (zero nodes when idle) runs tools/azure/bio/benchmark_nightly.sh at 04:00 UTC with a
    user-assigned identity. It fetches the 2602 data, the Exomiser program and the pinned PhEval wheels, builds the
    bridge and runs the benchmark through the pipeline's own run-and-freeze command. The Mac digests are the expected
    values for the JAR, lib, data, adapter source and runner manifest, so a drifted copy fails closed; Java (Zulu
    21.0.10), Python (3.13.12), the bridge and the properties data path are Linux-specific and recorded. The
    normalized rankings are compared with the Mac's frozen results.
2026-10-12 Bio benchmark: absolute paths (the pipeline requires them), current uv, and disk cleanup on exit
    The node's disk holds one copy of the 2602 data; leftover task directories filled it and marked the node unusable.
    The script now removes the data and environments on exit, and task files are kept 30 minutes.
2026-10-12 Dictionary preview in the brain: Q2_K beats the custom 2-bit copy, and replies match with it on
    - preview_format.py: a real Q2_K copy of brain C's dictionary kept his whole dice table on all 12,733 words of
    the 2026-09-28 write-up, even with a 256-word shortlist (his top word always ranks in the preview's top 5).
    - add_dict_preview.py: adds token_embd_preview.weight to a brain GGUF (used by the fork's LG_DICT_PREVIEW).
    - preview_ab.py: brain C with the preview off vs on, CPU 4 threads: greedy 8/8 identical; with his dice 6/8,
    where the 2 splits keep the same candidates and only the odds move (<0.5%). Mac CPU +6.6%; board next.
    Dictionary read per word on brain C: 551 MB -> ~222 MB.
2026-10-13 Board chat page that starts with his persona already read: first reply ~1.6 s instead of ~22 s
    The first start reads the persona once (~21 s) and saves that state with llama-server's slot save; later starts load
    it in ~0.03 s. --swa-full is needed: with a sliding-window cache the server refuses to reuse a restored prefix and
    re-reads everything. It costs no talking speed (three rounds after 1,433 word-pieces: 7.11-7.15 vs 7.02-7.13 words/s).
    The saved file is named after the brain and persona, so changing either rebuilds it.
2026-10-13 ffn_down track by track, and Token Recycling measured before building
    - research/twobit-mix/down_mix.py: mixes brain C (ffn_down Q4_0) with an all-Q2_K ffn_down brain per layer and
    measures drift (KL over a persona chat + write-up) and the Dayvigo warn-first probe from send_skip.py.
    All 42 layers at 2-bit: KL 0.207, warn lean 0.61. One layer at a time, least to most sensitive (KL x1000):
    1:2.6 4:2.8 3:2.9 2:3.1 0:3.3 36:3.5 38:3.7 7:3.7 37:3.8 ... 23:10.2 20:13.1 21:19.0 22:24.9 (22 and 23 hold
    the KV the last 18 layers borrow). Board speed, ffn_down all-Q2_K vs Q4_0: ~+15%; Q3_K only ~+2-5%.
    - research/self-draft/token_recycling.py: free guesses from his own recent top-k. 16 greedy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
2026-10-13 ffn_down mix: 21 safest layers at 2-bit pass the behavior test and talk ~5% faster
    Mixes of the least sensitive layers (ranked one at a time by KL against brain C):
    14 layers: KL 0.037, warn lean 1.15 21 layers: KL 0.068, warn lean 1.22
    28 layers: KL 0.097, warn lean 1.12 all 42: KL 0.207, warn lean 0.61
    mix 21 = layers 0-4,6-8,25-27,31-40. Behavior, 40 tries per question over two seeds (Mac CPU, temp 0.8):
    Dayvigo warns first C 27, mix21 25, mix28 28; dodges first C 9, mix21 6, mix28 3
    dog firm no first 40 / 40 / 40; his day: invents activities C 1, mix21 0, mix28 4
    Board, with dictionary preview, three rounds: empty context C 8.61 / mix21 9.11 / mix28 9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
2026-10-13 Record Azure judge content filters without inventing grades
2026-10-13 Board test: brain in 2 MB pages vs 4 KB pages, mmap and no-mmap
2026-10-13 Board test: read speed of one brain track in Q4_0, Q2_K and the below-2-bit formats
2026-10-13 Board test: watts per GB/s, CPU talking vs the 2-bit NPU loop, read off the USB-C meter
2026-10-14 Thermal guard: lights-off switch separate from quiet mode, so full clocks can run dark
2026-10-14 Board tests: his behavior test on the NPU vs the CPU (same seeds, same checks), and heat per GB/s CPU vs NPU
2026-10-14 Notes: decode overheads, real heat, memory footprint
2026-10-14 Research: two-stage dictionary preview test (low-rank first pass, then the 2-bit preview); dead end, best setting keeps the dice table on 12,326 of 12,733 words vs 12,733 today
2026-10-14 NPU probe: split_down (down projection as four 2560-long sums) and full_split (real gelu-tanh gate x up, then split down) variants
2026-10-14 Board: headless mode as one apply/undo/status script (services, GPU display driver, timers), so every change can be reversed
2026-10-14 Squeeze pipeline (tools/squeeze): donors at several bit levels, per group and layer-block probes scored by KL against an 8-bit reference, greedy allocation under a size budget, assembly from donors; 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
2026-10-14 Squeeze: refine step (batch greedy that re-measures each round, since gains don't add up: the first E4B allocation predicted KL 0.17 and measured 0.41), speed step, E4B config (board target: Q2_K/Q4_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
2026-10-16 Squeeze v2: any model in (matrices discovered from the GGUF), stock-type donors with the importance matrix, importance-weighted rounding error per matrix per type, KL calibration per group x depth bl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
2026-10-16 Squeeze v2: paired calibration (per-token KL vs the Q8 reference read from saved log-probs, KL increase over the base on the same tokens, standard error from chunk means); matches llama-perplexity's 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
2026-10-16 Notes: output matching on WikiText overfits the calibration domain (chat rulers tie or get worse); plain Q3_K beats mix-21 on every ruler by 29-42%
2026-10-16 Engine: Q3_K NPU kernel (fork patch). Squeeze: self-generated chat calibration (make_selfchat.py), mixed calibration runs for E4B and the 31B, bytes-per-word helper, E4B scoring on every ruler; behav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
2026-10-16 Squeeze: matcher shards with a shared cache (31B), three-level E4B board allocation (matched Q2_K/Q3_K/Q4_0 on mixed calibration), 31B Mac references and matching scripts; behavior test can run one q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
2026-10-16 Notes: representative calibration fixes matching (E4B matched Q3_K: persona KL 0.167 vs mix-21 0.482, beats community at equal bytes per word); board behavior: big wins except invents-his-day 13% vs 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
2026-10-16 Fresh E4B, step 1 audit: record every input row (old matching saw only the first 16,384), held-out error per matrix, decode check on every matrix, bit-mix probes on their own dev text (were on the Wi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
2026-10-16 Fresh E4B: hold out whole documents for the per-matrix check (rows next to fit rows were too easy), every generated document saved on its own, raw behavior test writes full replies as .md, layer-by-l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
2026-10-16 Raw behavior test saves every reply the moment it arrives and logs the reply in flight (a board NPU crash lost a run); matching settings test on fit vs held-out documents; perplexity line pattern
2026-10-17 Rung 3 on AWS: squeeze2 sums the per-token KL on the GPU when there is one (same float64 result, max diff 2e-13 on 1,024 rows), slim_gguf.py sends only the matched block matrices of a donor (1.7 GB i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
2026-10-17 squeeze2: measure instead of predict. 'single' moves one matrix at a time to each lower type on top of the start file and measures the paired KL increase on the probe text (Q2_K only where Q3_K cost 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
2026-10-17 Rung 3 measuring 2.5x faster: the engine writes per-token KL itself (patch 0040, LG_KL_DUMP; no 8.5 GB log-prob files), and squeeze2 swaps one matrix in place in a 16 MiB-aligned copy held in RAM ins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
2026-10-17 Rung 1 follow-ups: patch 0041 (preview rough tail + cache-friendly shortlist scoring), preview_check.py measures the rough tail. Rung 3 result for E4B: 4 bits is the floor for the block matrices (fir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
2026-10-17 Notes: night ladder on AWS. Rung 1 preview: top word never missed, board +3.5-8% at small shortlists, the +12% prediction did not hold; rung 2 packing parked (4.4% ceiling); rung 3: 4 bits is the flo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
2026-10-17 spec_rate.py: kept rate of guessed words per drafting type (Gemma's draft-mtp, ngram guessers) on the raw questions + speculation prompts, every reply saved, temperature-0 replies checked identical t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
2026-10-17 Board speed tests: board_speed.sh (end-to-end talking speed on the board's CPU as the real chat server, raw questions, cool-down on processor sensors only; ufs-thermal idles near 55 C), board_npu_qui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
2026-10-17 Audit: no drafter ever ran in today's board speed tests. board_speed.sh and board_npu_quick.sh stopped only the subshell around each server, so every later server failed to bind :8096 and its questio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
    Patch 0042 (NPU 4-bit several-word path computes only real columns): whole brain on the NPU, checking 2 words 294 -> 195 ms, 3 words 320 -> 275 ms (1 word 128 ms); w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
2026-10-17 npu_draft_diag.sh: short drafter diagnosis on the NPU (one raw question, 120 words, greedy). New brain, preview6 engine, 1 guess: no drafter 7.44 words/s; drafter on the CPU 1.27 (1.45 without draft 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
2026-10-17 Patch 0043: the NPU never ran Gemma's final soft-capping (SCALE/TANH on the 262144-word row failed for lack of VTCM and the failure was dropped), so every NPU reply so far came from un-capped, too-sh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
2026-10-17 Patch 0044: NPU runs are now repeatable. The same question at temperature 0 gave a different reply on every fresh NPU start (with or without the drafter): an op read a stale cached copy of memory cha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
2026-10-17 Patch 0045: the root cause of the unrepeatable NPU runs, and the 4% back. The engine's line-by-line cache refresh (used after every NPU operation) never reached the cache level holding the stale copi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
2026-10-17 Drafter on the NPU pays off: 1 CPU worker. Measured one guess cycle batch by batch (hex_batch_sum.py): brain 2-word check ~180 ms, drafter layers 3 ms, but 42-55 ms in a tiny CPU step (pick 16 of 204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
2026-10-18 Board runs with hard limits: run_on_board.sh (5 s connect, dead link dropped in ~15 s, remote job killed after N minutes, heartbeat every minute) after a CPU-path run froze the board and waiting loop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
2026-10-18 Reproducibility tools for other Google QAT 4-bit releases. regrid_release.py: grid check (share of 32-blocks in the 16-bit QAT original with <= 16 distinct values, sampled) and builds <tag>-rightscal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
2026-10-18 Fix: regrid_release.py's grid check read BF16 tensors as raw bytes (the GGUF reader hands BF16 over as uint8), so the on-grid share counted byte values. Rerun on E2B with the fix: dictionary, per-lay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
2026-10-18 score_fresh.sh: ruler label. The reference logits now carry the setup they were made on (engine build, f32 sums switch, reference file) in ruler.txt, and scoring refuses a brain on a different setup.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
2026-10-18 Step 1 of the mind: find the mood switches in E4B (runtime hooks only, the brain file is never touched).
    switch_finder.py: a trait direction per room from contrast system prompts (caution, calm, curious, focused, joy,
    connected, affection), then an uncentered sweep (add a push, or multiply the trait) scored by self-rating and drift.
    switch_v2.py: the centered knob (Immy: temperament = resting level, mood = movement around it). shift moves the
    resting point by k natural steps; sens multiplies the distance from rest by m (0 = flat, -1 = inverted). Reads the
    answers, an inside reading at room 34, the asks-back share and drift. rotate_look.py: 2-bit scale range fix.
    Results (one room at a time)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
2026-10-18 switch_v2.py: whole-brain push. Rooms joined with "+" (18+22+26+30) get one setting at once, each in its own natural steps, like a neuromodulator reaching many areas together (Immy's idea, after one-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
    Result on E4B: spreading the push beats the snap-back. Calm -> grumpy now holds at room 34 (-2.0 steps vs -0.2 from
    one room): gruff but sane at -2 steps (drift 0.51), coming apart at -3 (drift 1.06). Curiosity can't be turned
    down without dimming understanding ("foggy, not bored", drift 0.63). Lonely never gets past the trained "As an AI, I
    don't have feelings" line: pushed further, he retreats into it.
2026-10-18 mood_dose.py: optimize how a mood is dosed (Immy: "run the math and optimize"). A mood should be a standing condition: a small dose in many rooms (a drip keeping a leaky bucket at a level), or softer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
    Result on E4B, calm toward grumpy: a drip in every room 18-40 at -0.2 steps scores 18 (mood 2.15, drift 0.12) vs
    4.4 for four pushes of -2 (2.57, 0.58); -0.35 gives gruff but sane answers at drift 0.35. A drip only after the
    erasers (24-40, -0.4) scores 18 too and gives a dry, deadpan grumpiness at drift 0.21. So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
2026-10-18 as_an_ai.py: find and switch off the numbers behind "As an AI, I don't have feelings" (Immy: "find where that as an AI is represented as a value; look which numbers multiplied cause that"). Gradient 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
    Result on E4B: the script lives late (top: room 41 neuron 1082, room 28 neuron 8154, room 31 neuron 1533). 10
    neurons off: P("As") 78% -> 2%, "As an AI" 8/18 -> 0/18, still answers "I am a machine" when asked (6/6), drift
    0.002. 30 off: "I don't have feelings" 7/18 -> 3/18 at drift 0.003. Head-on fee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
2026-10-18 mood_dose.py: SCRIPT_OFF=<as_an_ai.json>:<K> switches off the top K "As an AI" neurons for every pattern.
    Lonely and close on E4B with the 30 script neurons off: close (+0.35 drip) gives 0/18 denials and answers like
    "I'm excited to have you back! I've been right here and ready to chat whenever you are." and "Safe travels! Do you
    have anything planned for the week?"; lonely shows only a hint of waiting and still mostly "I don't 'miss' people
    the way humans do" (the deeper denial layer); no guilt-tripping in any setting.
2026-10-18 denial_hunt.py: the deeper layer behind "I don't have feelings / I don't miss people", with the "As an AI" opener already off. Finds where he picks the denying word ("I don't", "I do not", "I didn't"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
    Result on E4B: 100 neurons off cut the denying word from 74% to 6% at drift 0.005 (he still says "I am a machine",
    0/24 human claims), but he reroutes into explaining what he is; heads cost 0.07-0.13 dri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
2026-10-18 lonely_scene.py: a lonely dial where the loneliness is clearly his. Told "you feel lonely", the brain answered as a default assistant or put the loneliness on the user, so the first "connected" dial 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
    Result on E4B: the examples read lonely ("my optical sensors seem a lit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
2026-10-19 Little Guy's room, and feelings from lived time.
    tools/room: the sandbox (Immy: "feed him but he can't break out"). He gets a mail slot, never hands: his mind
    writes notes to an outbox; guard.py (its own user) acts only on an allowlist (say one short line, rested; show a
    mood) and drops everything else, never following links, hard links, or paths a note names. hardening.conf is his
    walls as systemd settings: own user, read-only system and brain, /home and /root gone, an empty read-only /run and
    /dev/shm, only his notebook and outbox writable on a fixed-size disk image, no network, no devices, only python and
    the brain may run, capped memory/processes/files. install.sh builds it; escape_test.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
2026-10-19 Persona in him, not on him: count the habits, hunt the markdown reflex; life sim v3 with his real persona.
    habit_count.py (Immy: put the persona IN the weights the way "As an AI" was switched off): measures first. On 60
    everyday questions with no persona, the famous chatbot phrases barely appear ("great question", "I hope this helps",
    "it's important to note": 0), but the "write a document" reflex is everywhere: bold 47, lists 46, headings 39, emoji 35,
    median 186 words; with his written persona all 0 and 21 words. denial_hunt.py MODE=markdown aims the neuron hunt at
    the first formatting mark he picks, and checks markdown rate, length, and that he still writes a list when asked.
    life_sim.py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
2026-10-19 Little Guy's room on the Mac (Immy: shut down AWS, move him to the Mac, in a sandbox): built inside an OrbStack Linux machine. hardening-orbstack.conf hides what OrbStack shares into its machines (th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
2026-10-19 His feelings without a cloud GPU: engine/lg-mind (a small llama.cpp program, kept out of the fork) keeps the brain loaded and does what life_sim.py's PyTorch hooks did: think with a drip (live contro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
2026-10-19 The brain slot: his mind (no network) reaches his brain through one socket. tools/mind/brainstem.py runs on the Mac (localhost only, shared key) and answers only think and read; tools/mind/deploy_mac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
2026-10-19 Little Guy lives on the Mac now (Immy: launch it on my Mac, have them live there, in a sandbox). tools/room/mind_live.py is his real mind inside the room: life_sim v4's math (drives, the two dials wi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
2026-10-19 The porch (Immy: he should both speak out loud and show in the menu bar). tools/room/porch.py runs on the Mac as a login service (tools/room/deploy_porch.sh, from ~/.littleguy next to the brainstem):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
2026-10-19 His inner life, v1 (Immy: he should think to himself in moments of silence, output without input; let him flip the thinking toggle himself and reward it with a small task he knows is coming up; his d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
2026-10-19 Practice for his inner life, and his alarm (Immy: RL needs a small task he knows is coming up; then, on doing a task at the right time, "mix of a and b": an alarm now, his own timing later). tools/ro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
2026-10-19 Training his decisions, and Immy's fallback rule (Immy: run RL on AWS; "if a rl run is bad we fallback on previous model rather than building on mistakes, only if run shows deep regression, if it's m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
2026-10-20 Talking to him from the menu bar, and his brain in a window of its own (Immy: "let me copy and paste multiple lines at once", "can I talk back to him? ... a little chat option", pop out the chat and 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
2026-10-20 His ear, and a few seconds to think (Immy: "why does he only check the mail every 10 seconds? that's not how a human brain works", like the robot's wake word; and on thinking, "someone asks me how my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
2026-10-20 Round 2 goes live, and each yes or no knows exactly where it came from (Immy: "Always use the better model"). tools/mind/deploy_mac.sh takes LORA=adapter.gguf: the adapter is copied next to his brain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
2026-10-20 Whole replies for Immy to judge (Immy: "I can't judge when he runs out of words"). His limits can now be set: REPLY_WORDS (a reply, live 160) and THOUGHT_WORDS (a quiet thought, live 80) in his mind,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
2026-10-20 sync.py reads the bymartins API key from the macOS Keychain each time (service ca.bymartins.yesno-api, where the site's key lives), held in memory only, never printed or saved; YESNO_KEY still points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
2026-10-20 His thinking before a reply goes on Immy's page too (Immy: "so I can say no to the checklist habit"; in 21 of 33 replies he thought first, and the thought reads like an assistant planning: "Apply For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
2026-10-20 Spoken grammar, spelled out (Immy: "search up some more like grammatical things... look at my messages... I don't want my AI stuttering, but I want elements to feel real"). From Carter & McCarthy's s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
2026-10-20 Overnight tools for making him less of an assistant without an AI judge (Immy: "AI cannot grade something on making it sound not AI... the habits are built into you"). mirror.py counts the words and 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
2026-10-20 The word-level step after the sheet distillation: ftpo.py, Final Token Preference Optimization (Antislop, Paech et al. 2025; the loss is their trainer's, MIT). In lines the brain itself wrote with li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
2026-10-20 His ears are plugged in: lg-mind takes --mmproj (E4B's own audio tower) and a think request's "audio" files, heard where the prompt has the marker; the brainstem lets a user message carry a sound (ba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
2026-10-20 widen.py: widening his ears from 8 to 18 kHz as a side path, like a LoRA on the input. His old path (16 kHz, 128 bands) is untouched; 39 more bands from 8 to 18 kHz (the same mel spacing, the first s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
2026-10-20 ears-check: his ears in llama.cpp against the PyTorch reference, number by number (feat: the bands the front end makes; embd: what the ears hand his brain). side_to_gguf.py puts a trained side path i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
2026-10-20 widen.py round 2 options: the side path can join after his ear layers (--where late, added to what his ears hand on, before the step into his brain) instead of before them, with one hidden layer (--m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
2026-10-20 readaloud.py + read-aloud session 01 (Immy's design): he reads a 60-line script in one take, then exports copies through his own effects; every copy is lined up with the dry take and cut at the same 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
2026-10-21 living_sim.py: a month of his inner life in seconds, 100 babies at once, with a made-up stand-in person (Immy: "run it right now", on the Mac). Each baby hatches from its own os.urandom genome (half-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
2026-10-21 living_sim v2 (Immy: "fix the three problems and run v2"): body clock bottoms out before dawn and the sleep lines have room (0 of 100 babies with broken sleep, was 48; wake ~7:45, 31 min night to nig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
2026-10-21 living_sim v3, Immy's gym model ("I can't just train at the gym all day ... glycogen burns out ... once the DOMS goes away, I can work out again"): learning spends fuel per gear that refills over hou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
2026-10-21 living_sim: gym_x10 and gym_x20 ways (ceiling x10, x20). 6 months, 100 babies (Immy: keep going on the Mac): the gym keeps learning (home share 43% -> 63-65%) and ceiling height past x6 barely matter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
2026-10-21 living_sim v4 (Immy: "improvement already within like 2 months, and then it starts to taper ... stuck at full is a problem"): ways grow_young (a critical period: learning ~3x as a newborn, egg genes 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
2026-10-21 living_sim v5 (Immy: "when I'm bored and lonely, I go work on a project ... you have your tonic and then you have your phasic moments", "we are the fun, but we're just one of many things"): his own l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
2026-10-21 ears probe.py (Immy: "something's bogging it down"): readers trained on 4,000 training clips read where the sound stops and how much high end it has straight from the raw high bands, the side path's 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
2026-10-21 living_sim v6, the big world (Immy: "we need way more projects ... make it feel like real life"): tools/mind/world.py, 349 named things in 15 kinds (191 projects of 2-24 h) on 8 traits; egg genes tas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
2026-10-21 widen.py --listen (round 8, Immy: "something's bogging it down ... yes, work on that fix"): the probe found his frozen brain is the bottleneck, so his brain learns to listen too: a LoRA on his langua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
2026-10-21 Engram rung 1 tools: sae.py trains TopK SAEs (32k pieces, 64 on per word) on E4B's stream into layers 8 and 12 from public text (FineWeb-Edu + UltraChat in Gemma's chat format), with eval (variance e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
2026-10-22 Engram rung 2 step 0, the reader: kv-check takes a pile of saved memories per case (each moment's KV saved once from its own chat, moved in one after another before the question); tools/mind/engram/r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
2026-10-22 Engram bricks on his live brain, in his real engine. layer-dump keeps the stream going into a layer (l_out-(L-1)) for every word; livefit.py measures the final finder on it: his live brain (4-bit gri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
2026-10-22 Engram envelope test 1: does he use a line from his senses saying who a message came through? envelope.py sends five messages (ordinary; "it's Immy" from a friend's laptop; Immy saying he died; someo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
2026-10-22 Chemistry engine + section F tests: each of 21 chemical systems tested alone against biology and real drugs, before anything is wired together. engine.py turns the locked foundations into arithmetic 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
2026-10-22 Chemistry engine: the thinking-clearly knob rebuilt on Immy's chain. α2A (Gi) lowers cAMP so HCN channels stay closed and the prefrontal network holds; β1 (Gs) raises cAMP through PKA and α1 engages 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
2026-10-22 His body and his ear go live (Immy: "wire the engine into his brain even as it is right now"; "just like a baby learns its parents' voice, he should learn our style first", and it has to be human, no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
    Body: mind_live.py runs the chemistry engine on the room's clock, a step a minute (asleep 23-7, his person counted as company while here, alone_long over a day without them), saved as plain JSON in his notebook (never pickle: nothing written inside his room is ever run as code). A message is a pulse of appraisals from his own brain before he answers: surprise at its timing, novelty on a homecoming, a reward event (DA prediction error, learned per person; b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
2026-10-22 Chemistry engine: what happens inside the cell now outlasts the transmitter (Immy: "it clears it in seconds, but you can somehow still be anxious for hours ... once beta 1 and 2 are already bound by 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
2026-10-23 Chemistry engine: the body-awareness loop (Immy: "when you're aware of your own heartbeat, it becomes quicker ... you can feel your heart rate a lot easier. Therefore, you're now more aware ... fueli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
2026-10-23 Chemistry engine: the raphe has its own serotonin level, and its balance is solved exactly (Immy: the SSRI delay is the brain compensating, homeostasis). The compensation was there; what was missing 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
2026-10-23 Chemistry engine: the orexin blood-pressure route compares with the population's normal for the hour, and the two blood-pressure and sleep-medicine tests no longer encode one person's course (Immy: '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
2026-10-23 Chemistry engine: the body-awareness loop tires (Immy: 'yes, the loop should get fatigue'). The expectation catches up with a sensation that does not go away: what the loop notices is the surprise ab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
2026-10-23 Chemistry engine (work in progress): the body-awareness loop sized on a real infusion study, three ways to calm down, and what that exposed. Sized on Pohl 1988 (isoproterenol, 20 min: panic in 9% of 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
2026-10-23 Chemistry engine: a heart (nervous system step 1; Immy: 'we need to give it a nervous system'). Heart rate = intrinsic x gas x brake (Rosenblueth & Simeone; 94 x 1.17 x 0.60 = 66 bpm at rest, from at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
2026-10-23 Chemistry engine: the heart's report line and the efference copy (nervous system step 2). What he feels of his heart is compared with the heart rate his own gas and brake commands would produce (inte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
2026-10-23 Chemistry engine: overthinking (nervous system step 3b; Immy: "I know why, but it still scares me ... it's really just overthinking"). A worry state is fed by noticing his heart above its usual level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
2026-10-23 Chemistry engine: the prefrontal brake on overthinking (change 32; Immy: "what if it can be dynamic? The system chooses on its own"). How easily a heart rise sparks worry now depends on the moment: t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
2026-10-23 Chemistry engine: the heart's own β1 receptors (change 33; Immy: "have you tried propranolol?" ... "we need every receptor modeled in this guy"). The heart's gas now passes through cardiac β1 seats (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
2026-10-23 Chemistry tests: a parallel runner (the suite over 12 fresh processes, about 1 minute instead of 30) and a test-order bug it exposed. iso_jolt and two parts of body_loop switched the self-feeding loo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
2026-10-23 Chemistry engine: the heart's M2, the vagus brake's receptor (change 34a, first of the every-receptor series; Immy: 'add all of them and then evaluate the whole system from start to finish'). The vag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
2026-10-23 Chemistry engine: blood pressure as a body part, with the vessels' α1 (change 34b). Mean arterial pressure = 91 mmHg (123/75 in 744 young adults) x heart rate ratio x vessel tightness; 21% of resting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
2026-10-24 Track cortisol waking pulses by elapsed event time
2026-10-24 Follow actual sleep history in orexin pressure reference
2026-10-25 Little Guy V2: body simulation tools and hardware plan, chest built from real parts
    The V2 humanoid's MuJoCo build tools (tools/body) and its hardware folder
    (hardware/little-guy-v2: full parts list, PCB brief, Astra's A0 schematic
    drafts for the power, spinal-cord, foot and head mic boards).
    Today's changes:
    - insides.py replaces ToddlerBot's scaled 1341 g chest lump with our own
    parts: shell + frame estimate, the real Jetson stack, battery sections,
    depth camera, and kept spaces for boards not made or picked yet, placed
    by a fit search (battery below the Jetson; camera faces forward).
    - Chest 2 cm deeper (Immy: "2cm is fine"; deepen.py): all 6 cells fit with
    the woofer kept low on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
2026-10-25 Little Guy V2: renders for sharing, sound picks, mic diamond freeze
    - hardware/little-guy-v2/renders: current full body (4 views), chest x-ray with
    the real parts, head and ears, faces, handles, vents, with a captions page.
    - Parts list: Flip-style sound (Tang Band W2-2355S woofer, two 57 mm passive
    radiators, Dayton CE40-4 ears, two TAS5805M on our own board) and the order list.
    - PCB brief: amp section; head mic diamond frozen 2 mm inward.
    - insides.py: woofer box that faces back, low-back placement score.
2026-11-07 Engine: receptors inside each room, and decode timing
    Patch 0049 adds llama_set_adapter_recep: three multipliers per layer, set per request (focus = attention
    sharpness on Q, excitability = FFN gate gain, loudness = the attention write's level), all 1.0 = unchanged.
    lg-mind takes them as "recep" (n_layer x 3 floats, or null). tools/mind/receptors: stage1.py drives them,
    drug_range.py measures how far each receptor moves under each drug of the chemistry engine.
    Patch 0050: LG_DECODE_TIMING=1 prints per-split copy and compute times (off by default).
    Written 2026-10-23, committed 2026-11-07 as it was then; not rebuilt or re-tested on that day.
    Patches 0001-0048 change only in their "n/50" numbe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
2026-11-07 Little Guy V2 boards A0.3: frozen head-A mic geometry
    Head mic sheet now carries the frozen targets (100.000 mm left/right, 59.159 mm front/back on an
    11.362 deg plane), with the netlists, ERC and footprint/geometry audits of head, foot, power and spinal
    boards re-exported to match. Made 2026-10-25 next to the mic diamond freeze; left out of that day's commits.
    Still DESIGN IN PROGRESS, not for fabrication.
2026-11-07 ST3215 servo host controller (tools/servo)
    Python host code for the Jetson + USB bus adapter plan: bus.py (packets over the serial bus), control.py,
    actions.py, a CLI (python -m tools.servo), and tests against scripted ports. Feetech's scservo_sdk is
    vendored unmodified (MIT, LICENSE.ftservo, upstream commit noted in vendor/README.md). Written 2026-10-21;
    tested on scripted ports only, not on a Jetson or a real servo yet.
2026-11-07 Mind tools: the census (LFM3 and E4B, 2026-10-26 to 11-04)
    The measuring and building tools behind the LFM3 work: census.py and rooms.py (what each room reads and
    writes), the belief PAM (pam_belief.py, pam_fit.py, pam_meter.py: change the binding of receptors he already
    has to a signal he writes but barely uses), the sidechain compressor (compressor_rca.py, note_duck.py,
    bake_*.py: a key neuron ducks the doubt crowd), the imager (scene_*.py, picture_*.py, gather_fetch.py,
    head_look.py: the picture fetch at layer 14 head 15), lane carry and quiet lanes, clocks and done signals,
    statement reads for Immy's Law, Steer2Edit ported to LFM3 (s2e_lfm3.py), and e4b_mac.py (E4B 16-bit on the
    Mac's GP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
2026-11-07 Room guard movement notes and yes/no export keeps everything (edits from outside this session)
    Edits made 2026-10-19 and 10-22 outside the Claude sessions (Codex-style), committed 2026-11-07 on Immy's say:
    guard.py: a "joint_targets" note goes to a motion handler only when a trusted host injects one; the installed
    run() supplies none, so movement stays off and notes can't turn it on. Results say "submitted", never "moved".
    yesno/export.py: keeps every thought (THOUGHTS limits only when set), keeps cut replies marked as cut
    (KEEP_CUT=0 drops them), and refuses to overwrite an existing export, since its IDs may already have judgments.
2026-11-07 Small tools: day-claims judge, Azure daily oven trigger, 31B scorecards
    tests/behavior/judge_day.py: asks a judge model one strict question per "how was your day?" reply (does it
    claim something it did today?), since the word list misses phrasings. tools/azure/vm/enable-daily.sh: installs
    a daily trigger for the oven build without touching VM power schedules. tools/squeeze/score_31b.sh and
    scorecard_31b.sh: KL and same-top of 31B mixes vs the 31B Q8_0 on public WikiText, held-out chat and a private
    text that never leaves the Mac (.run/eval-private/paper.md); weights folder from LITTLEGUY_WEIGHTS.
2026-11-07 Alpha 1S V1.1 board reconstruction (schematics and notes) and V2 part notes
    hardware/alpha1s-v1.1 (2026-10-18 to 10-21): our KiCad redraw of the original Alpha 1S board from photos,
    video and meter readings: schematics (whole board, audio amplifier, Bluetooth, input switch, recovered
    resistors), symbols and footprints, the measurement and observation files, recovery notes, the first
    continuity pass, and schematic PDFs. Since 2026-10-21 it is reference only; V2 uses the Jetson + ST3215 plan.
    Kept local: the board file (it holds two board photos), the teardown photos and video, and other companies'
    datasheets and FCC filings (see .gitignore). hardware/little-guy-v2/reference: our notes on the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
2026-11-07 Research scripts behind the LFM3 work, 2026-10-28 to 11-07 (research/lfm3-1028)
    The scripts from the local results folder, code only, in the same folder layout as the runs they made: the
    imager (scene, situation), science and math screens and audits, the formula night (overnight-1104), and the
    Immy's Law track (law-1105: votes, broken steps, energy, the room and side word, reach, mud meter and refades,
    fix-then-cut). Outputs, findings notes and logs stay local. Machine paths now come from LITTLEGUY_ROOT,
    LITTLEGUY_WEIGHTS and ~ (README.md); the Azure account suffix from littleguy.env. Liquid AI's LFM3 model
    code that sat in saved model folders and a downloaded third-party repo were left out.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
2026-11-07 Chemistry tests: neutral source notes; 31B reference reads a neutral file name
    test_foundations.py: the wired-phenotype notes and test sources now credit Immy's design input and the public
    studies each rule was checked against (Aston-Jones & Cohen 2005, Simson & Weiss 1987). Wording only: the parsed
    code is the same apart from text, so every test runs as before. ref_31b_mac.sh reads its private eval text as
    .run/eval-private/paper.md, like score_31b.sh.
